isystemsautomation/homemaster-dev/DIO-430-R1/README.md

# DIO-430-R1 — Module for Smart I/O Control

**HOMEMASTER – Modular control. Custom logic.**

MODULE photo

**Document map:** [§1 Overview](#1-overview) · [§3 Specifications](#3-specifications) · [§4 Hardware](#4-hardware--interface) · [§5 Getting Started](#5-getting-started) · [§6 WebConfig](#6-webconfig-reference) · [§7 Modbus map](#7-modbus-register-map) · [§8 ESPHome](#8-esphome--home-assistant-integration) · [§9 Programming](#9-programming--build) · [§11 Downloads](#11-downloads--resources)

---

## 1. Overview

The **DIO-430-R1** is a digital I/O module whose **standalone local logic** — wall switches, override buttons, gesture counters, and DI→relay mapping — keeps working even with no controller or network. It mounts on a **35 mm DIN rail** and connects to **MiniPLC/MicroPLC** (or any Modbus RTU master) over **RS-485**, with Home Assistant integration via ESPHome packages.

**Key capabilities at a glance:**

- **4 IEC 61131-2 compliant 24 V digital inputs (ISO1212 front-end)** — dry-contact (module-wetted); PTC fuse, TVS surge and reverse-polarity protection; per-input Maintained/Momentary logic
- **3 SPDT relays** — 3 A @ 250 VAC (resistive) dry contacts (NO/NC/COM); use interposing contactors for loads above 3 A
- **3 buttons (2 user-configurable).** Button 1 and Button 2 are configurable in WebConfig (short/long-press actions). The third button has no software function — it is used only as part of the on-board key combination for USB firmware-update (BOOTSEL) and reset.
- **3 configurable user LEDs** — Steady/Blink; multiple sources (Link, HA, relay, etc.)
- **Standalone local logic** — wall switches and front buttons work even when the network or controller is offline
- **Driverless WebConfig** — USB-C + any Chromium-based browser (Chrome, Edge, Opera, Brave, Vivaldi; Chrome/Edge 89+, Opera 76+). No app or login required.
- **Persistent settings** — configuration stored in LittleFS flash and restored on boot

### How local and remote control coexist

Relays can be switched from **any** source — wired inputs, front buttons, or Home Assistant — **simultaneously**; the last command wins. There is no "local vs remote" mode to flip: if the network or controller reboots, wall switches **still work**; when online, you also get full remote control.

## Key advantages

- **3 relays + 4 inputs + physical override buttons**, with gesture counters (single/double/triple/long) and interlock; standalone local logic works even with no controller or network.
- Native ESPHome API via the MiniPLC/MicroPLC controller — no MQTT broker, no manual Modbus register mapping for the package entities.
- Local-first / edge-resilient — onboard logic keeps working if the network or Home Assistant is down.
- Open hardware (**CERN-OHL-W v2**) and firmware (**MIT**) — repairable, reproducible, no vendor lock-in.
- Standard **RS-485 Modbus RTU** — works with any Modbus master or industrial HMI/SCADA system, not locked to HomeMaster.
- Driverless **USB-C WebConfig** (Chrome, Edge, Opera); configuration persists in on-device flash (**LittleFS**).

---

## 2. Features

| Area | Detail |
|---|---|
| **Isolation** | Digital-input front-end per IEC 61131-2 (ISO1212); surge/EMI protected; opto-isolated relay drivers |
| **Configurable I/O** | Per-input Enable/Invert/**Type** (Maintained or Momentary). **Maintained** → mode Toggle/Follow + target relay. **Momentary** → Short/Long actions {None, Toggle, On, Off} + target (R1–R3 / All / None). |
| **Buttons** | 3 buttons (2 user-configurable): Button 1 / Button 2 assignable to relay actions (none, toggle, on, off) |
| **LEDs** | Configurable Steady/Blink; 8 firmware sources (Off, HA, Link, Local, Child lock, Safe mode, Identify, Relay) |
| **WebConfig** | USB-C → Chromium-based browser (Chrome, Edge, Opera, Brave, Vivaldi); set comms and I/O mapping live; auto-save to flash |
| **Modbus RTU slave** | Poll-based RS-485; factory defaults in [§3 Specifications](#3-specifications) |
| **ESPHome / HA** | Ready-made YAML package; DI/relay/button/event entities |
| **Extras** | All Off, child-lock per input, auto-off (staircase timer), shutter/interlock mode, Identify |

### Applications

Typical uses for the DIO-430-R1:

- **Lighting** — wall switches or push-buttons drive the relays directly, with optional auto-off (staircase) timers. A controller can override or monitor the same outputs over Modbus.
- **Pumps, fans, motors** — switch circulation pumps, exhaust fans, or irrigation valves from inputs, buttons, or a PLC. Relay interlock prevents two outputs (e.g. motor up/down) from being on at the same time.
- **Standalone or controller-driven** — runs its configured logic with no controller attached, and integrates with Home Assistant / ESPHome or any Modbus RTU master when one is present.

---

## 3. Specifications

<!-- hm:specs:start -->
| Specification | Details |
|---|---|
| Microcontroller | RP2350A dual-core microcontroller |
| Storage | External QSPI Flash (W25Q32JV) |
| Power Input | 24 V DC nominal |
| File system | LittleFS persistent configuration storage |
| Document revision | DS-DIO-430-R1 Rev. B · 2026-09 · Hardware R1 (V1.0) |
| Digital Inputs | 4 × IEC 61131-2 compliant 24 V digital inputs (ISO1212 front-end) (DIx + GNDx), dry-contact (module-wetted); per-channel PTC fuse, TVS surge suppression, reverse-polarity protection, EMI filtering |
| Relay outputs | 3 × SPDT (NO / C / NC); 3 A @ 250 VAC per contact (module limit) |
| User Interface | 3 buttons (2 user-configurable), 13 LEDs (power, 3 user, RX, TX, 3× relay, 4× DI) |
| RS-485 | half-duplex Modbus RTU, not galvanically isolated |
| USB | USB-C (ESD protected, configuration and firmware upload) |
| Modbus defaults | Address 3, 19200 baud, 8N1 |
| Operating temperature | 0 °C to +40 °C |
| Storage temperature | −10 °C to +55 °C |
| Relative humidity | 0–90 % RH, non-condensing |
| Ingress protection | IP20 (inside cabinet only) |
| Installation | Indoor control cabinet only; not for outdoor or exposed installation |
| Maximum altitude | 2000 m |
| Pollution degree | 2 |
| Dimensions | 70 × 90.6 × 67.3 mm (L × W × H) |
| DIN width | 4 modules (≈ 70 mm) |
| Mounting | 35 mm DIN rail |
| Enclosure | PC/ABS industrial enclosure |
| Terminal type | Pluggable screw terminal blocks, 5.08 mm pitch |
| Wire cross-section | 0.2–2.5 mm² (AWG 24–12) |
| Tightening torque | 0.4–0.6 Nm |
| Net weight | 210 g |
| Gross weight | 320 g |
| Pack size | 140 × 125 × 94 mm (L × W × H) |
<!-- hm:specs:end -->

DIO-430-R1 Dimensions

*Mechanical drawing: front and side view, dimensions in mm*

### 3.4 Communication defaults

Factory settings applied to every new module:

| Parameter | Default |
|---|---|
| **Modbus Address** | `3` |
| **Baud Rate** | `19200` |
| **Parity** | `None` |
| **Stop Bits** | `1` |

Address **1–247**; baud 9600 / 19200 / 38400 / 57600 / 115200. **Set via [WebConfig](#6-webconfig-reference) over USB-C — recommended.** Address and baud can also be written over Modbus holding registers (see [§7 Modbus Register Map](#7-modbus-register-map)) for remote re-commissioning of already-installed modules — **note: the change applies immediately, so the current Modbus connection drops and you must reconnect at the new address/baud.**

The module communicates over **RS-485 Modbus RTU** (A/B differential + shared COM/GND). Configuration is stored persistently in **LittleFS** and can be changed live through **USB-C + WebConfig**.

### 3.5 Reliability & protection

- Reverse-path diode + high-side MOSFET on 24 V input.
- Local PTC + TVS protection on field interfaces.
- Relay drivers opto-isolated; RC/MOV suppression recommended.
- Relay contacts: 275 V rms metal-oxide varistor across each contact pair. Not suitable for the elevated open-contact voltage of directly connected capacitor motors — see §5.1.
- RS-485: see [RS-485 / Modbus RTU](#rs-485--modbus-rtu).
- USB-C ESD-protected; CC resistors per spec.
- Non-volatile flash with **auto-save** after configuration changes.

---

### RS-485 / Modbus RTU

<!-- hm:rs485-order:begin -->
> **Terminal order differs across the HomeMaster range.**
> Always read the silkscreen - do not wire by habit from another module.
> On this module the order is **B-A-COM**.
> Swapping A and B damages nothing but the node will not communicate.
> COM is required on every node.
<!-- hm:rs485-order:end -->
All HomeMaster controllers and modules share the same RS-485 front end.

| Item | Value |
|---|---|
| Transceiver | MAX485CSA+T, half-duplex |
| Galvanic isolation | **None** — the transceiver shares the device's logic ground |
| Common-mode range | −7 V … +12 V referred to the device's own ground (MAX485 limit) |
| Terminals | A / B / COM |
| Surge protection | 3 × SMAJ6.8CA TVS (A–COM, B–COM, A–B) |
| Overcurrent | 2 × resettable PTC, 1.5 A hold, in series with A and B |
| EMI filtering | Common-mode choke on the A/B pair; COM referenced through 1 MΩ ∥ 4.7 nF |
| Idle state | Fail-safe biasing on board — do not add external bias resistors |
| Termination | 120 Ω at the two physical ends of the bus only |

**Bus wiring rules — apply to every device on the bus:**

- One twisted pair for A/B, 120 Ω characteristic impedance.
- Run **COM** to every node. Required, not optional: the ports are not isolated, and COM is what bounds the common-mode voltage the transceivers see.
- Prefer one power supply for the whole bus, distributed in star topology. With separate supplies, additionally tie the 0 V references together at a single point.
- Bond the cable shield to cabinet PE at one end only. Never land a shield on A, B or COM.
- Where the bus crosses into a different electrical installation with its own earthing reference — a utility or billing meter, another building, another cabinet's PE system — fit an external galvanic RS-485 isolator at that boundary. The on-board components are transient protection, not isolation, and will not survive a sustained ground-potential difference.

## 4. Hardware & Interface

### 4.1 Diagrams & pinouts

<table>
  <tr>
    <th>Block Diagram</th><th>Control Board</th><th>Relay / Field Board</th><th>RP2350A Pinout</th>
  </tr>
  <tr>
    <td></td>
    <td></td>
    <td></td>
    <td></td>
  </tr>
</table>

> **RP2350A pinout** is dense — zoom the image or open [`DIO_MCU_Pinouts.png`](https://config.home-master.eu/DIO-430-R1/Images/DIO_MCU_Pinouts.png) full size if labels are hard to read at table width.

### 4.2 Connectors & terminal map

<!-- hm:terminal-map:begin -->

**Top row** (24Vdc | RELAY OUTPUT)

| Pos | Label | Group | Function |
|-----|---|---|---|
| 1 | 0V | POWER | 24 V DC return |
| 2 | V+ | POWER | 24 V DC input |
| 3 | NO | RELAY1 | Relay 1 normally open |
| 4 | C | RELAY1 | Relay 1 common |
| 5 | NC | RELAY1 | Relay 1 normally closed |
| 6 | NO | RELAY2 | Relay 2 normally open |
| 7 | C | RELAY2 | Relay 2 common |
| 8 | NC | RELAY2 | Relay 2 normally closed |
| 9 | NO | RELAY3 | Relay 3 normally open |
| 10 | C | RELAY3 | Relay 3 common |
| 11 | NC | RELAY3 | Relay 3 normally closed |

**Bottom row** (RS-485 | DI 24Vdc)

| Pos | Label | Group | Function |
|-----|---|---|---|
| 1 | B | RS485 | RS-485 data - |
| 2 | A | RS485 | RS-485 data + |
| 3 | COM | RS485 | RS-485 signal reference |
| 4 | GND | DI1 | DI1 return |
| 5 | I.1 | DI1 | DI1 input |
| 6 | GND | DI2 | DI2 return |
| 7 | I.2 | DI2 | DI2 input |
| 8 | GND | DI3 | DI3 return |
| 9 | I.3 | DI3 | DI3 input |
| 10 | GND | DI4 | DI4 return |
| 11 | I.4 | DI4 | DI4 input |

**Ports & service interfaces**

| Id | Type | Note |
|----|---|---|
| USB-C | D+, D−, VBUS, GND | Not for field powering |

**Housing notes**

- GND precedes the signal on every DI pair. DIM prints the opposite order - do not wire by habit.
- Power reads 0V then V+. Most other modules read V+ first.
- Relays are SPDT. System limit 3 A @ 250 VAC per contact (module limit).

<!-- hm:terminal-map:end -->

**Input power / wetting.** The digital inputs are built on an ISO1212 IEC 61131-2 digital-input front-end and are wetted from the module's own 24 V supply (internally fused) — no separate input supply is required. For a dry contact, wire it between **INx** and **GNDx**; the module sources the loop (wetting) current and the ISO1212 limits it per channel (IEC 61131-2 input behaviour), so no external series resistor is needed. The module does **not** provide a dedicated sensor-supply rail (no 12 V/5 V out), so power 3-wire sensors from your own source and bring their output to INx.

**Power domain & front-end.** The input field side runs on the module's own 24 V supply (internally fused) — there is no separate isolated input supply. The ISO1212 is a current/threshold-conditioning front-end, **not** a galvanic isolator; inputs are **not** galvanically isolated from the module's own 24 V rail. An external 24 V signal can be applied to INx (this is the normal "24 V signal" mode and does not disturb the internal wetting — SENSE and IN are separate pins, current-limited), and each channel is protected by a series fuse, common-mode choke, ~26 V TVS and an RC filter. **The signal return must share the module's SELV ground:** wire it to the paired **GNDx** (= the module's 24 V return). If the external 24 V comes from a separate supply, make sure both are SELV and share a common 0 V reference to avoid ground loops. Do not bond **GNDx** to logic GND.

### 4.3 Front panel — buttons & LEDs

Button Layout 1‑2‑3

| Control | Function |
|---|---|
| **Button 1 / 2** | Front-panel buttons with configurable short/long-press actions (toggle / on / off a target relay, or All-off); press events are also exposed over Modbus as Home Assistant triggers. See [§6 WebConfig](#6-webconfig-reference). |
| **Button 3** | No software function — part of on-board boot/reset key combo (with Buttons 1+2 → BOOT mode) |
| **Buttons 1+2+3** | Enter **BOOT** mode for UF2 flashing (see [§9 Programming](#9-programming--build)) |
| **Buttons 1+3** | Hardware **RESET** |
| **PWR LED** | Power present |
| **TX/RX LEDs** | Modbus traffic activity |
| **User LEDs 1–3** | Configurable status indicators |

---

## 5. Getting Started

### 5.1 Safety *(read before wiring)*

> ⚠️ **SELV/PELV domains only** — 24 V DC, RS-485, USB 5 V. **Do not** connect mains to any terminal. Use interposing contactors for mains loads. **Never bridge** logic GND with isolated field grounds (GND_ISO / FGND).

| Requirement | Detail |
|---|---|
| Qualified personnel | Installation by personnel familiar with 24 V control and RS-485 |
| Power isolation | Disconnect 24 V DC before wiring; lockout/tagout where applicable |
| Environmental limits | Clean, sealed enclosure; avoid condensation and conductive dust |
| Grounding | Bond panel to PE; share RS-485 COM/GND with controller (same SELV domain) |
| Relay loads | Follow contact ratings; add RC/MOV snubbers for inductive loads |
| RS-485 | Twisted pair, daisy-chain, **120 Ω** at both physical ends, consistent A/B polarity |
| USB-C | Setup/maintenance only; disconnect after commissioning |

> ⚠️ **Capacitor motors (roller shutters, blinds, awnings, gate and garage tubular
> motors) must NOT be connected directly to the relay outputs.** Each relay contact
> carries a 275 V arc-suppression varistor. While one direction runs, the motor's
> phase-shift capacitor raises the voltage across the open contact of the other
> direction above 330 V; the varistor conducts continuously and is destroyed within
> seconds, regardless of motor current. Drive such motors through an interposing
> relay or contactor with ≥ 400 V contacts and **no RC or varistor across the
> contacts**; the DIO-430-R1 relay switches the interposing relay coil only. Follow the
> motor manufacturer's rules: the same phase for UP and DOWN, never UP and DOWN
> simultaneously, direction change through OFF with a pause of at least 0.5 s.

**Pre-power checklist**

- [ ] Wiring torqued, labeled, strain-relieved
- [ ] No bridge between logic GND and isolated GND_ISO/FGND
- [ ] Panel PE bonded; SELV supply and COM/GND properly landed
- [ ] RS-485 A/B polarity and 120 Ω termination at bus ends
- [ ] Relay loads within rating; snubbers on inductive loads
- [ ] Inputs wired to dry contact/SELV only
- [ ] USB-C disconnected for normal operation

#### Installation practices

| Task | Guidance |
|---|---|
| ESD Protection | Handle by the enclosure/edge only. Use an antistatic wrist strap when the board is exposed. |
| DIN Rail Mounting | Mount securely on **35 mm DIN** rail inside an IP-rated cabinet. Leave cable slack for strain relief. |
| Wiring | Use correct wire gauge and torque terminal screws. Separate **power**, **DI**, **relay**, and **RS-485** harnesses. |
| Isolation Domains | Respect isolation: **do not bridge** logic **GND** to isolated field grounds (e.g., **GND_ISO/FGND**). Keep analog/sensor returns on the isolated side. |
| Commissioning | Before power-up, verify polarity, relay NO/NC routing, RS-485 **A/B** orientation and termination. |

#### I/O & interface warnings

**Power**

| Area | Warning |
|---|---|
| 24 V DC Input | Use a clean, fused SELV supply. Reverse-polarity protection exists but may disable the module when triggered. |
| Sensor Rail | Power sensors from a SELV rail. Observe polarity. Fuse external branches as required. |
| Surge/Noise | In noisy panels, add upstream surge/EMI suppression and keep high-current wiring away from control wiring. |

**Inputs (digital)**

| Area | Warning |
|---|---|
| Type | **Dry-contact (module-wetted)** — see [§4.2](#42-connectors--terminal-map). Do not inject mains or undefined levels. |
| Isolation | IEC 61131-2 digital-input front-end (ISO1212); not galvanically isolated. Keep sensor returns on **GNDx** (module 24 V return); do not bond to logic GND. |
| Debounce | Firmware provides debounce; route away from contactors/VFDs; use shielded/twisted pairs for long runs. |
| Polarity | Configure invert/action in WebConfig; verify state transitions after wiring. |

**Relays (outputs)**

| Area | Warning |
|---|---|
| Contact Type | **SPDT (NO/NC/COM)** dry contacts. Follow contact rating on the device label/datasheet. |
| Inductive Loads | Add **RC snubber or MOV** at the load. Consider interposing relays/contactors for higher power. |
| Separation | Keep relay load wiring physically separate from signal wiring. De-energize before servicing. |
| Verification | After wiring, verify NO/NC behavior and load polarity before enabling automation. |

**RS-485:** see [RS-485 / Modbus RTU](#rs-485--modbus-rtu).

### 5.2 What you need

| Category | Item / Notes |
|---|---|
| **Hardware** | DIO-430-R1 — 4× DI, 3× SPDT relays, 3 buttons (2 user-configurable), 3× LEDs, USB-C, RS-485 |
| **Controller** | HomeMaster MiniPLC/MicroPLC or any Modbus RTU master |
| **24 VDC PSU** | Regulated SELV; size for logic + relay coils + sensors; ≥ 30 % headroom |
| **RS-485 cable** | Twisted pair A/B + COM/GND; 120 Ω termination at both trunk ends |
| **USB-C cable** | WebConfig via Chromium-based browser (commissioning) |
| **Software** | Chromium-based browser with Web Serial (Chrome, Edge, Opera, Brave, Vivaldi); [WebConfig tool](https://config.home-master.eu/DIO-430-R1/Firmware/v0.2.0/ConfigToolPage.html) |

### 5.3 Power notes

The module uses **24 VDC** primary. Onboard regulation provides **5 V → 3.3 V** for logic; DI front-end uses ISO1212 IEC 61131-2 conditioning wetted from the module 24 V supply (not galvanically isolated).

- **24 VDC DIN-rail PSU** → **24Vdc(+) / 0V(–)** power terminals (top row: POWER).
- **Sensor side (DI)** — ISO1212 receivers wetted from the module's internal fused 24 V (see [§4.2](#42-connectors--terminal-map)); for 3-wire sensors, power from your own source and return the output to **INx/GNDx**. Do **not** back-power logic from sensor rails.
- Size PSU for base electronics + LEDs + **relay coils** (up to 3 simultaneously) + sensor rails; add **≥ 30 % headroom** (see [§3.2](#32-electrical-ratings)).
- Correct polarity; keep logic **GND** and DI field ground **separate**; upstream **fusing/breaker** required.

### 5.4 Step-by-step

**Phase 1 — Wire (field wiring)**

| 24 V DC Power | Digital Inputs | Relay Output | RS-485 (120 Ω) |
|:---:|:---:|:---:|:---:|
| 24 Vdc wiring | Digital inputs | Relay wiring | RS-485 connection |

- **24 VDC** → **V+ / 0V** (top POWER terminals). Regulated SELV; keep pairs twisted.
- **Digital inputs** → **INx / GNDx** (field side; do not bridge logic GND ↔ **GNDx**). See [§4.2](#42-connectors--terminal-map) for wetting and front-end details.
- **Relay outputs** → **COM / NO / NC**. Interposing contactors for motors/pumps; RC/MOV on inductive loads. Capacitor motors: see §5.1.
- **RS-485** → **A / B / COM (GND)**. Shielded twisted pair; daisy-chain; 120 Ω at both ends.

> **Digital inputs:** internal fused 24 V wets dry contacts; no auxiliary 12 V/5 V sensor rail — see **Input power / wetting** under [§4.2 Connectors](#42-connectors--terminal-map).

**Phase 2 — Configure (WebConfig)**

1. Connect **USB-C**; open [WebConfig](https://config.home-master.eu/DIO-430-R1/Firmware/v0.2.0/ConfigToolPage.html) in a Chromium-based browser → **Connect**.
2. Set **Modbus address** and **baud rate** (factory defaults in [§3.4](#34-communication-defaults)).
3. Map inputs, relays, buttons, LEDs per [§6 WebConfig Reference](#6-webconfig-reference). Changes auto-save to flash.
4. Disconnect USB-C; hand control to the RS-485 master.

**Phase 3 — Integrate (controller / Home Assistant)**

Add the ESPHome package on your MiniPLC/MicroPLC (or poll/write Modbus from your PLC/SCADA). Match **address** and **baud** to WebConfig settings.

```yaml
packages:
  dio1:
    url: https://github.com/isystemsautomation/homemaster-dev
    ref: main
    files:
      - path: DIO-430-R1/Firmware/v0.2.0/default_dio_430_r1_plc/default_dio_430_r1_plc.yaml
        vars:
          dio_prefix: "DIO#1"
          dio_id: dio_1
          dio_address: 4   # must match WebConfig Modbus address
```

Full UART/modbus setup and entity list: [§8 ESPHome Integration](#8-esphome--home-assistant-integration). Modbus register addresses: [§7 Modbus Register Map](#7-modbus-register-map).

### 5.5 Verify

| Area | What to check |
|---|---|
| LEDs | **PWR** = ON; **TX/RX** blink during RS-485 traffic |
| Inputs | Wall switch/sensor changes **INx** state in WebConfig / Modbus IREG 0 |
| Relays | Coil writes toggle **R1–R3**; loads switch correctly |
| Address/Baud | Controller reads module without errors |
| Isolation | No unintended bond between logic GND and DI field GNDx |

---

## 6. WebConfig Reference

Open **https://config.home-master.eu/DIO-430-R1/Firmware/v0.2.0/ConfigToolPage.html** in any Chromium-based browser (Chrome, Edge, Opera, Brave, Vivaldi; Chrome/Edge 89+, Opera 76+), connect via **USB-C**, and click **Connect**. Changes apply immediately and are saved to flash (no Save button).

> Firefox: experimental only (Nightly with the Web Serial flag enabled). Safari and stable Firefox are not supported.

### Status & Tools

DIO-430-R1 WebConfig — Module status (Model, FW, Modbus ID, Baud) and Tools — Identify / Factory reset / Reboot

Status pills (read-only, not settings): **Connection** (USB), **Bus** (RS-485), **Model**, **FW**. A banner warns if model/firmware mismatches this configurator.

| Button | What it does |
|---|---|
| Identify (~5 s) | Blinks user LEDs to locate the module. |
| Factory reset | Restores all settings to defaults. |
| Reboot | Restarts the module. |

### Device Setup

DIO-430-R1 WebConfig — Serial connection & Modbus addressing (address, baud) with serial log

| Field | Values | Meaning |
|---|---|---|
| Modbus Address | 1–247 (default 3) | Modbus RTU slave address; must be unique on the bus. |
| Baud Rate | 9600 / 19200 / 38400 / 57600 / 115200 (default 19200) | RS-485 speed **8N1**; must match the controller. |

### Digital Inputs

DIO-430-R1 WebConfig — Per-input setup: Enabled / Inverted / Child-lock, Type (Maintained/Momentary), Short-Long actions & target

| Field | Values | Meaning |
|---|---|---|
| Enabled | on / off | Whether this input is processed. |
| Inverted | on / off | Invert the read level (NC contacts). |
| Child lock | on / off | Suspend local switching; still reports to Home Assistant. |
| Type | Maintained / Momentary | Wall switch vs push-button. |
| Maintained mode | Toggle / Follow | **Toggle**: flip relay on each change. **Follow**: relay mirrors switch. |
| Target *(Maintained)* | All / R1 / R2 / R3 / None | Controlled relay(s). |
| Short → action *(Momentary)* | None / Toggle / On / Off | Short-press action. |
| Short → target | All / R1 / R2 / R3 / None | Short-press target relay(s). |
| Long → action *(Momentary)* | None / Toggle / On / Off | Long-press action. |
| Long → target | All / R1 / R2 / R3 / None | Long-press target relay(s). |

Defaults: IN1–IN3 = Maintained / Toggle → R1/R2/R3; IN4 = Momentary, Short = Off → All.

### Gesture event counters (Momentary)

In **Momentary** mode each digital input and each user button (Button 1–2) recognizes press gestures and maintains **four monotonic counters**: **single**, **double**, **triple**, and **long**.

| Topic | Detail |
|---|---|
| **Modbus / HA** | Counters are exposed as **Input Registers** (FC04, event block IR 6…29) and imported into Home Assistant via the ESPHome package. |
| **How HA uses them** | Automations should react to a **counter increase** (e.g. a double-click adds 1 to the `double` sensor). The gesture is not lost even if the RS-485 bus is polled slowly. |
| **Purpose** | Run Home Assistant scenes and automations on single, double, triple clicks and long holds without missing short pulses on a shared bus. |
| **Maintained inputs** | Counters apply **only** when **Type = Momentary**. Maintained inputs have no gesture counters. |
| **HA-only input** | To use an input **only** for HA scenes (no local relay action): **Type = Momentary**, **Short = None**, **Long = None**. Gestures are still counted; relays are not switched locally. |
| **Timing** | **Long-press ms** and **Multi-click gap ms** in the [Timing](#timing) section set long-hold threshold and the double/triple click window. |

To turn off all relays from Momentary logic, use action **Off** with target **All** (not a separate “All off” action in WebConfig).

### Relays & Interlock

DIO-430-R1 WebConfig — Relay enable / invert / power-on / auto-off, and relay interlock (Relay A/B, pause)

**Relays (Relay 1–3)**

| Field | Values | Meaning |
|---|---|---|
| Enabled | on / off | Relay output active. |
| Inverted | on / off | Invert drive polarity. |
| Power-on | OFF / ON / Restore last | State after power-up. |
| Auto-off, s | 0–65535 (0 = off) | Staircase timer; 0 disables. |

Defaults: enabled, not inverted, OFF at power-on, auto-off 0.

**Interlock**

| Field | Values | Meaning |
|---|---|---|
| Enabled | on / off | Pair two relays (motor up/down). |
| Relay A / B | R1 / R2 / R3 | Interlocked pair. |
| Pause, ms | integer (default 500) | Dead-time when reversing. |

### Timing

DIO-430-R1 WebConfig — Press timing, debounce and bus watchdog (long-press, multi-click gap, debounce, link timeout)

| Field | Values | Meaning |
|---|---|---|
| Long-press, ms | 50–5000 (default 700) | Long-press threshold. |
| Multi-click gap, ms | 50–2000 (default 300) | Double/triple click window. |
| Debounce, ms | 1–500 (default 30) | Input debounce. |
| Link timeout, ms | 500–60000 (default 5000) | RS-485 link-loss timeout. |

### Buttons & User LEDs

DIO-430-R1 WebConfig — Button short/long actions and user-LED source / mode

**Buttons (Button 1–2; GPIO2 / GPIO3)**

| Field | Values | Meaning |
|---|---|---|
| Short/Long → action | None / Toggle / On / Off | Press action. |
| Short/Long → target | All / R1 / R2 / R3 / None | Target relay(s). |

Defaults: Button 1 → Short = Toggle R1, Long = Off → All; Button 2 → Short = Toggle R2, Long = None. (Third button: no software function — boot/reset combo only.)

**User LEDs (LED 1–3)**

| Field | Values | Meaning |
|---|---|---|
| Source | Off / HA / Link / Local / Child lock / Safe mode / Identify / Relay | LED meaning (8 firmware sources). |
| Mode | Steady / Blink | Display mode. |
| Inverted | on / off | Invert LED level. |
| Arg | integer | Relay # or DI index for Child lock / Relay sources. |

Defaults: LED1 = Link; LED2 = Off; LED3 = HA.

### Action / Target reference

| Action | Meaning |
|---|---|
| None | Report only (no local relay action); gestures still counted in Momentary mode. |
| Toggle / On / Off | Flip, energize, or de-energize the target relay(s). Use **Off** + target **All** to de-energize every relay. |

| Target | Meaning |
|---|---|
| All / R1 / R2 / R3 / None | Relay scope. |

---

## 7. Modbus Register Map

**Role:** RTU **slave** (controller is master). **Defaults:** see [§3.4 Communication defaults](#34-communication-defaults).

> v0.2.0 map uses **zero-based offsets** matching `default_dio_430_r1_plc.yaml`. Poll **Input Registers (FC04)** for live state; use **Coils (FC05)** for commands.

### 7.1 Address map (overview)

| Type | Offsets | Purpose |
|---|---|---|
| **Input Registers** (FC04) | `0…29` | State masks (DI/relay/button/LED), status, event counters |
| **Coils** (FC01/05) | `0…14` | Relays, device commands, LED HA override, DI child-lock |
| **Holding Registers** (FC03) | `0…46` | Identity, comms, DI/relay/button/LED config, timing |

> **No discrete-input bank (FC02):** firmware does not call `addIsts()`. Read DI/relay/button/LED states from **Input Register** masks below.

### 7.2 Input Registers (FC04) — state & counters

| Reg | Name | Encoding | Description |
|----:|---|---|---|
| 0 | **DI_MASK** | bitmask | bit0..3 → IN1..IN4 (after invert) |
| 1 | **RLY_MASK** | bitmask | bit0..2 → R1..R3 |
| 2 | **BTN_MASK** | bitmask | bit0..1 → Button1..2 |
| 3 | **LED_MASK** | bitmask | bit0..2 → LED1..3 |
| 4 | **STATUS_FLAGS** | bitmask | bit1 = link OK, bit3 = config dirty |
| 5 | **LOCK_MASK** | bitmask | bit0..3 → child-lock DI1..4 |
| 6–29 | **Event counters** | u16 | Index = `source×4 + type` (base 6); sources: DI1..4 = 0..3, Btn1..2 = 4..5; types: 0=single, 1=double, 2=triple, 3=long |

### 7.3 Coils (FC01/05) — commands

| Coil | Name | Description |
|-----:|---|---|
| 0 | **R1** | Relay 1 ON/OFF (maintained) |
| 1 | **R2** | Relay 2 ON/OFF (maintained) |
| 2 | **R3** | Relay 3 ON/OFF (maintained) |
| 3 | **ALL_OFF** | Turn all relays off (pulse) |
| 4 | *(reserved)* | Local-logic flag (internal) |
| 5 | **IDENTIFY** | Front-panel identify blink (pulse) |
| 6 | **SAVE_CFG** | Persist settings to flash (pulse) |
| 7 | **REBOOT** | Soft reset (pulse) |
| 8 | **LED1 HA** | Home Assistant LED1 override |
| 9 | **LED2 HA** | Home Assistant LED2 override |
| 10 | **LED3 HA** | Home Assistant LED3 override |
| 11–14 | **DI1–4 lock** | Child-lock per digital input |

### 7.4 Holding Registers (FC03) — configuration

Configuration is normally done via **WebConfig** ([§6](#6-webconfig-reference)). Holding registers mirror persisted settings (offsets 0–46):

| Reg | Name | R/W | Encoding | Notes |
|----:|---|:---:|---|---|
| 0 | **MODEL_ID** | R | u16 | **5** (DIO-430-R1; not 0x0430) |
| 1 | **FW_VERSION** | R | u16 | Packed `(major<<8)\|minor` (not a build date) |
| 2 | **MAP_VERSION** | R | u16 | Modbus map version |
| 3 | **MB_ADDR** | R/W | u16 | Modbus address **1–247** (default 3) |
| 4 | **MB_BAUD** | R/W | enum | 0=9600, 1=19200, 2=38400, 3=57600, 4=115200 |
| 8 | **DI_EN_MASK** | R/W | bitmask | bit0..3 → DI1..DI4 enable |
| 9 | **DI_INV_MASK** | R/W | bitmask | bit0..3 → DI1..DI4 invert |
| 10 | **DI_TYPE_MASK** | R/W | bitmask | bit0..3 → 0=Maintained, 1=Momentary |
| 11 | **DI_LOCK_MASK** | R/W | bitmask | bit0..3 → child-lock per DI |
| 12–15 | **DI1–4 FOLLOW** | R/W | u16 | Follow target (Maintained/Follow mode) |
| 16–19 | **DI1–4 SHORT** | R/W | packed | Short-press action+target (Momentary) |
| 20–23 | **DI1–4 LONG** | R/W | packed | Long-press action+target (Momentary) |
| 24 | **RLY_EN_MASK** | R/W | bitmask | bit0..2 → R1..R3 enable |
| 25 | **RLY_INV_MASK** | R/W | bitmask | bit0..2 → R1..R3 invert |
| 26 | **RLY_POWERON** | R/W | packed | 2 bits per relay: 0=Off, 1=On, 2=Restore |
| 27–29 | **RLY1–3 AUTO-OFF** | R/W | u16 | Auto-off timer (s) per relay; 0=disabled |
| 30 / 31 | **BTN1 SHORT / LONG** | R/W | packed | Button 1 short/long action+target |
| 32 / 33 | **BTN2 SHORT / LONG** | R/W | packed | Button 2 short/long action+target |
| 34–36 | **LED1–3 config** | R/W | packed | source / mode / inverted / arg per LED |
| 40 | **INTERLOCK** | R/W | packed | Interlock enable + relay pair |
| 41 | **INTERLOCK_PAUSE** | R/W | u16 | Interlock dead-time (ms); default 500 |
| 42 | **DI_MAINT_MODE_MASK** | R/W | bitmask | Maintained mode per DI: 0=Toggle, 1=Follow |
| 43 | **LONGPRESS_MS** | R/W | u16 | Default 700 |
| 44 | **MULTICLICK_MS** | R/W | u16 | Default 300 |
| 45 | **DEBOUNCE_MS** | R/W | u16 | Default 30 |
| 46 | **LINKTIMEOUT_MS** | R/W | u16 | Default 5000 |

**Packed action+target byte:** upper 3 bits = action (0=None, 1=Toggle, 2=On, 3=Off, 4=All off); lower 3 bits = target (0=None, 1=R1, 2=R2, 3=R3, 4=All).

### 7.5 Register use examples

**A) Toggle Relay 2 from a PLC** — write `1` to **Coil 1** (ON), then `0` (OFF).

**B) Read DI3 state** — read **Input Register 0** (FC04), test bit 2 of **DI_MASK**.

**C) Map IN3 as Maintained Toggle → Relay 1** — set bit2 in **HREG 8**; clear bit2 in **HREG 10** and **HREG 42**; write follow target `1` to **HREG 14**; pulse **Coil 6 (SAVE_CFG)**.

**D) Map Button 1 short press → Toggle Relay 2** — write packed Toggle+R2 to **HREG 30**; pulse **Coil 6**.

**E) Change Modbus address / baud (remote re-commissioning)** — write **HREG 3 (MB_ADDR)** and **HREG 4 (MB_BAUD)**; settings apply **immediately** (current connection drops — reconnect at the new address/baud). Optional pulse **Coil 6 (SAVE_CFG)** and **Coil 7 (REBOOT)**. Prefer [WebConfig](#6-webconfig-reference) over USB-C for initial setup.

**F) Persist and reboot** — pulse **Coil 6 (SAVE_CFG)** then **Coil 7 (REBOOT)**.

### 7.6 Polling recommendations

- **Input registers 0–5:** 5–10 Hz (100–200 ms) for DI/relay/LED masks
- **Event counters 6–29:** 1–2 s (change slowly)
- **Coils:** write on change only; relays 0–2 are maintained
- **Holding:** configure at commissioning; avoid frequent writes
- **Edge logic:** use **Maintained/Toggle** for latching inputs; **Momentary/On/Off** when the PLC supervises timers

---

## 8. ESPHome / Home Assistant Integration

> **Module role:** Modbus RTU **slave** on RS-485. Comms defaults: [§3.4](#34-communication-defaults).

### 8.1 Minimal YAML (controller side)

Use this on the **MiniPLC/MicroPLC** (ESPHome). It enables the RS-485 bus and imports a ready-made DIO package.

```yaml
uart:
  id: uart_modbus
  tx_pin: 17
  rx_pin: 16
  baud_rate: 19200
  parity: NONE
  stop_bits: 1

modbus:
  id: modbus_bus
  uart_id: uart_modbus
  turnaround_time: 100ms
  send_wait_time: 250ms

packages:
  dio1:
    url: https://github.com/isystemsautomation/homemaster-dev
    ref: main
    files:
      - path: DIO-430-R1/Firmware/v0.2.0/default_dio_430_r1_plc/default_dio_430_r1_plc.yaml
        vars:
          dio_prefix: "DIO#1"
          dio_id: dio_1
          dio_address: 4       # Modbus address set in WebConfig
    refresh: 1d
```

> **ESPHome 2026.7.0 raised the Modbus client defaults** — `turnaround_time` from
> 100 ms to 600 ms and `send_wait_time` from 250 ms to 2000 ms (PR #11969).
>
> At the 600 ms default the bus carries only about 1.5 Modbus transactions per
> second, whatever the UART speed, because the controller stays silent for 600 ms
> after every response. Two modules on one RS-485 bus become slow to respond.
> With three or more, one module can stop being polled altogether — with no
> timeout and no CRC error in the log.
>
> On ESPHome 2026.7.0 and newer, set both values explicitly as shown above.
> On earlier releases these were the defaults and the two lines are not required.

> For **multiple** DIOs, duplicate the `dio1:` block (`dio2:`, `dio3:`…) with unique `dio_id`, `dio_prefix`, and `dio_address`.

### 8.2 Entities exposed (from the package)

- **Binary Sensors** (from **Input Registers**, FC04 bitmasks)
  - **DI1…DI4** (IREG 0)
  - **Btn1…Btn2** (IREG 2)
  - **LED1…LED3** (IREG 3)
  - **Link OK / Config dirty** (IREG 4)
  - **DI child-lock flags** (IREG 5)
- **Switches**
  - **Relay 1–3** (coils 0–2, maintained)
  - **LED1–3 HA override** (coils 8–10)
  - **DI1–4 child lock** (coils 11–14)
- **Sensors**
  - **Event counters** DI1..4 / Btn1..2 × single/double/triple/long (IREG 6–29)
- **Buttons (template)**
  - **All off**, **Identify** (pulse coils 3, 5)

> The package matches `default_dio_430_r1_plc.yaml`: **no discrete-input bank** — DI/relay states are read from **Input Register** masks.

### 8.3 Optional: direct (manual) entity mapping

```yaml
modbus_controller:
  - id: dio430_4
    address: 4
    modbus_id: modbus_bus
    update_interval: 200ms
    command_throttle: 100ms

binary_sensor:
  # DI1..DI4 from Input Register 0 (FC04 bitmasks)
  - platform: modbus_controller
    modbus_controller_id: dio430_4
    name: "DIO#1 DI1"
    register_type: read
    address: 0
    bitmask: 0x0001
  - platform: modbus_controller
    modbus_controller_id: dio430_4
    name: "DIO#1 DI2"
    register_type: read
    address: 0
    bitmask: 0x0002
  - platform: modbus_controller
    modbus_controller_id: dio430_4
    name: "DIO#1 DI3"
    register_type: read
    address: 0
    bitmask: 0x0004
  - platform: modbus_controller
    modbus_controller_id: dio430_4
    name: "DIO#1 DI4"
    register_type: read
    address: 0
    bitmask: 0x0008

switch:
  - platform: modbus_controller
    modbus_controller_id: dio430_4
    name: "DIO#1 Relay 1"
    register_type: coil
    address: 0
  - platform: modbus_controller
    modbus_controller_id: dio430_4
    name: "DIO#1 Relay 2"
    register_type: coil
    address: 1
  - platform: modbus_controller
    modbus_controller_id: dio430_4
    name: "DIO#1 Relay 3"
    register_type: coil
    address: 2

sensor:
  - platform: modbus_controller
    modbus_controller_id: dio430_4
    name: "DIO#1 LED Mask"
    register_type: read
    address: 3
    value_type: U_WORD
    accuracy_decimals: 0
  - platform: modbus_controller
    modbus_controller_id: dio430_4
    name: "DIO#1 Button Mask"
    register_type: read
    address: 2
    value_type: U_WORD
    accuracy_decimals: 0
```

### 8.4 Home Assistant tips

- **Dashboards:** lighting panel with Relay 1–3 + DI tiles; maintenance card with Identify / All off buttons.
- **Automations:** trigger relay switches from DI edges if logic runs in HA instead of module mapping.
- **Naming:** use `dio_prefix` for readable entities (`DIO#1 Relay 1`, `DIO#2 DI3`, etc.).

### 8.5 Troubleshooting (integration)

- **No response / timeouts:** A/B polarity, shared **COM/GND**, **120 Ω** termination at bus ends.
- **Wrong device:** `dio_address` must match WebConfig address.
- **Relays don't switch:** relay **Enabled** in [§6 WebConfig](#6-webconfig-reference).
- **DI not changing:** wiring to **INx/GNDx**; check Enable/Invert/Type and Short/Long actions.

### 8.6 Notes & versions

- Works with recent ESPHome releases (e.g., 2025.x).
- Keep `update_interval` modest (200–500 ms) unless faster DI polling is needed.
- For multiple devices, stagger `update_interval` / `command_throttle` to reduce collisions.

---

## 9. Programming & Build

### 9.1 Supported languages

- **Arduino**
- **C++** (PlatformIO)
- **MicroPython** (community builds for RP23xx-class MCUs)

### 9.2 Flashing (USB-C, hardware buttons)

> All reset/boot actions use the **front buttons**. UF2 image: [§11 Downloads](#11-downloads--resources).

**Combinations** (see [§4.3 Front panel](#43-front-panel--buttons--leds)):

- **Buttons 1 + 2 + 3** → **BOOT** mode (RPI-RP2 USB drive for UF2 drag-and-drop)
- **Buttons 1 + 3** → hardware **RESET**

**Steps**

1. Connect **USB-C** to a PC (disconnect RS-485 during flashing).
2. Enter **BOOT** mode. Board mounts as **RPI-RP2** (UF2) or serial port (IDE).
3. Flash UF2 from [§11](#11-downloads--resources) or upload via PlatformIO / Arduino IDE.
4. If needed, **Buttons 1 + 3** for hardware reset.

> No factory-reset function. Configuration remains intact across normal firmware updates.

### 9.3 Arduino / PlatformIO notes

**Board / toolchain**

- **Board:** Generic **RP2350** (or vendor core for **RP2350A**)
- **USB:** CDC enabled (serial logging)
- **FS:** LittleFS partition recommended (for settings)

**Required libraries (Library Manager names / versions)**

- `Arduino_JSON` (0.2.0)
- `Modbus-Arduino` (1.3.0) + `Modbus-Serial` (2.0.6) — `#include <ModbusSerial.h>` in sketch
- `Simple Web Serial` (1.0.0)
- **From core:** `LittleFS`, `Wire` (no separate install)

**Pin mapping:** see [§4.1 Diagrams & pinouts](#41-diagrams--pinouts) (`DIO_MCU_Pinouts.png`) and firmware `default_DIO_430_R1.ino`.

**Build tips**

- Use factory RS-485 defaults from [§3.4](#34-communication-defaults) during bring-up.
- After flashing, disconnect USB-C and return control to the RS-485 master.

### 9.4 Firmware updates

See [§9.2 Flashing](#92-flashing-usb-c-hardware-buttons) and [§11 Downloads](#11-downloads--resources). Configuration in flash/LittleFS is preserved across normal updates unless explicitly erased.

---

## 10. Maintenance & Troubleshooting

### 10.1 Status LEDs

- **PWR** — ON in normal operation
- **TX/RX** — blink on Modbus traffic
- **User LEDs (1–3)** — follow relay logic (Steady/Blink per [§6 WebConfig](#6-webconfig-reference))

### 10.2 Resets

- **Power cycle:** remove 24 V, wait 5 s, re-apply
- **Buttons 1 + 3** — hardware RESET

### 10.3 Common issues

| Symptom | Checks |
|---|---|
| No Modbus comms | A/B polarity, **COM/GND** reference, 120 Ω termination, address/baud match ([§3.4](#34-communication-defaults)), only two end terminators |
| Relays don't actuate | Relay **Enabled** in WebConfig; verify coil writes to 0–2; check invert setting |
| DI not changing | Wire to **INx/GNDx**; check Enable/Invert/Type and Short/Long actions in [§6](#6-webconfig-reference) |
| USB won't connect | Chromium-based browser with Web Serial (not Safari/stable Firefox); close other serial apps, check cable/port permissions |
| Config not saved | Allow idle for auto-save; verify LittleFS space |

---

## 11. Downloads & Resources

### Version history

| Version | Config path (`path:`) | Date | Status |
|---|---|---|---|
| **v0.2.0** | `DIO-430-R1/Firmware/v0.2.0/default_dio_430_r1_plc/default_dio_430_r1_plc.yaml` | 2026-06 | **Current — shipped on new modules** |
| v0.1.0 | `DIO-430-R1/Firmware/v0.1.0/default_dio_430_r1_plc/default_dio_430_r1_plc.yaml` | 2026-06 | Legacy (superseded by v0.2.0) |

> **Reproducible firmware build (v0.2.0):** [Build environment (reproducible)](../README.md#build-environment-reproducible) · [`sketch.yaml`](Firmware/v0.2.0/default_DIO_430_R1/sketch.yaml)

### Files

- **Firmware v0.2.0 (pre-built UF2 — drag-and-drop upgrade)**
  - [`DIO-430-R1.uf2`](https://config.home-master.eu/DIO-430-R1/Firmware/v0.2.0/DIO-430-R1.uf2)
- **Firmware publishing (maintainers)**
  - [`DIO-430-R1/Firmware/README.md`](https://github.com/isystemsautomation/homemaster-dev/blob/site/DIO-430-R1/Firmware/README.md)
- **Firmware source (Arduino, v0.2.0)**
  - [`DIO-430-R1/Firmware/v0.2.0/default_DIO_430_R1/`](https://github.com/isystemsautomation/homemaster-dev/tree/site/DIO-430-R1/Firmware/v0.2.0/default_DIO_430_R1)
- **YAML configs (ESPHome, v0.2.0)**
  - [`DIO-430-R1/Firmware/v0.2.0/default_dio_430_r1_plc/`](https://github.com/isystemsautomation/homemaster-dev/tree/site/DIO-430-R1/Firmware/v0.2.0/default_dio_430_r1_plc)
- **WebConfig tool (HTML/JS, v0.2.0)**
  - [`DIO-430-R1/Firmware/v0.2.0/ConfigToolPage.html`](https://config.home-master.eu/DIO-430-R1/Firmware/v0.2.0/ConfigToolPage.html)
- **Firmware source (Arduino, v0.1.0 — legacy)**
  - [`DIO-430-R1/Firmware/v0.1.0/default_DIO_430_R1/`](https://github.com/isystemsautomation/homemaster-dev/tree/site/DIO-430-R1/Firmware/v0.1.0/default_DIO_430_R1)
- **YAML configs (ESPHome, v0.1.0 — legacy)**
  - [`DIO-430-R1/Firmware/v0.1.0/default_dio_430_r1_plc/`](https://github.com/isystemsautomation/homemaster-dev/tree/site/DIO-430-R1/Firmware/v0.1.0/default_dio_430_r1_plc)
- **WebConfig tool (HTML/JS, v0.1.0 — legacy)**
  - [`DIO-430-R1/Firmware/v0.1.0/ConfigToolPage.html`](https://config.home-master.eu/DIO-430-R1/Firmware/v0.1.0/ConfigToolPage.html)
- **Schematics (PDF)**
  - Field Board: [`Schematics/DIO-430-R1-FieldBoard.pdf`](https://config.home-master.eu/DIO-430-R1/Schematics/DIO-430-R1-FieldBoard.pdf)
  - MCU Board: [`Schematics/DIO-430-R1-MCUBoard.pdf`](https://config.home-master.eu/DIO-430-R1/Schematics/DIO-430-R1-MCUBoard.pdf)
- **Images & diagrams**
  - [`DIO-430-R1/Images/`](https://github.com/isystemsautomation/homemaster-dev/tree/site/DIO-430-R1/Images)
- **Datasheets**
  - Refer to `Schematics/` BOM notes for part numbers (e.g., ISO1212, MAX485, HF115F).

---

## Open Source & Licensing

This project uses a hybrid licensing model.

**Hardware** — schematics, PCB layouts, BOMs: **CERN-OHL-W v2**

**Firmware & ESPHome integration** — firmware, ESPHome configs, software: **MIT License**

This ensures full compatibility with ESPHome and Home Assistant while protecting hardware designs. See LICENSE files in each directory for full terms.

---

## 12. Compliance & Certifications

The DIO-430-R1 module is CE marked. **ISYSTEMS AUTOMATION S.R.L.** (HomeMaster® brand) maintains the technical documentation and a signed EU Declaration of Conformity (DoC).

### Applicable EU directives

- **EMC Directive 2014/30/EU** — EN 55032:2015 + AC:2016-07 + A11:2020 + A1:2020 (Class B emissions), EN 55035:2017 + A11:2020 (immunity); tested by Idvorsky Laboratories Ltd., Belgrade, Serbia (Job #1648, 20 April 2026)
- **Low Voltage Directive 2014/35/EU** — EN 62368-1:2020 + A11:2020; in-house dielectric and isolation test by ISYSTEMS AUTOMATION S.R.L. internal compliance laboratory
- **RoHS Directive 2011/65/EU** — EN IEC 63000 technical documentation

| Standard / Directive | Description |
|---|---|
| Ingress Rating | IP20 (panel-mount only) |
| Altitude | ≤ 2000 m |
| Environmental | RoHS / REACH compliant components |

### Compliance documents

| Document | File |
|---|---|
| EU Declaration of Conformity (DoC) | [DoC_DIO-430-R1.pdf](https://config.home-master.eu/DIO-430-R1/Manuals/DoC_DIO-430-R1.pdf) |
| Datasheet | [DIO-430-R1_Datasheet.pdf](https://config.home-master.eu/DIO-430-R1/Manuals/DIO-430-R1_Datasheet.pdf) |

### Trademark

**HomeMaster®** is a registered European Union trademark of ISYSTEMS AUTOMATION S.R.L., EUTM No. 019082911, registered with EUIPO on 15 January 2025.

---

## 13. Support

- **Official Support Portal:** https://www.home-master.eu/support
- **WebConfig Tool:** https://config.home-master.eu/DIO-430-R1/Firmware/v0.2.0/ConfigToolPage.html
- **YouTube:** https://youtube.com/@HomeMaster
- **Hackster:** https://hackster.io/homemaster
- **Reddit:** https://reddit.com/r/HomeMaster
- **Instagram:** https://instagram.com/home_master.eu

**Manufacturer:** ISYSTEMS AUTOMATION S.R.L. (HomeMaster® brand)  
**Registered office:** Str. Domnisori, Nr. 81, Bl. 62, Scara A, Etaj 3, Ap. 12, 100284 Ploiesti, Jud. Prahova, Romania  
**Office / Contact:** Diligentei 18, Ploiesti, Romania  
**CUI / VAT:** RO 21537032 · **EUID:** ROONRC.J2007000919293  
**Telephone:** +40 747 757 798  
**Website:** [https://www.home-master.eu](https://www.home-master.eu)
