isystemsautomation/homemaster-dev/MiniPLC/README.md

# HomeMaster MiniPLC

<a href="https://devices.esphome.io/devices/homemaster-miniplc/">Made for ESPHome</a>

Device

**Part No.:** MiniPLC-R1 · **Hardware Version:** V1.0 · **Manufacturer:** ISYSTEMS AUTOMATION S.R.L.

## Description

The HomeMaster MiniPLC is the flagship ESP32 DIN-rail controller: rich onboard I/O (relays, DI, 0–10 V analog in/out, RTD, 1-Wire) plus an RS-485 Modbus RTU master (non-isolated) for HomeMaster expansion modules. ESPHome is pre-installed for local, offline Home Assistant integration — the controller runs the logic; HA provides dashboards and history.

This repository includes the full ESPHome configuration used on shipped devices (including vendor OTA update settings).

## Key advantages

- Flagship ESP32 DIN-rail controller with rich onboard I/O: **6 relays**, **4 DI**, **4× AI 0–10 V (16-bit)**, **1× AO 0–10 V**, **2× RTD (PT100/PT1000)**, **2× 1-Wire**, optional Ethernet, microSD, OLED, and RTC — RTD plus analog in/out on the controller is uncommon in this class.
- **ESPHome pre-installed**; native Home Assistant API — no MQTT broker, no Modbus register mapping for onboard entities.
- **Modbus RTU master** for the HomeMaster I/O module line over a deterministic RS-485 wired bus.
- *The controller does the thinking; the server only visualizes* — critical logic runs on the MiniPLC; Home Assistant is dashboards and history.
- **Improv** Wi-Fi onboarding (BLE/USB); runs local and offline without cloud dependency.
- Open hardware (**CERN-OHL-W v2**) and firmware (**MIT**) — repairable, reproducible, no vendor lock-in.

## Quick Start

1. Mount the device on 35 mm DIN rail inside a closed control cabinet.
2. Connect ONE power input (24 V DC at V+/0V, OR 85–265 V AC at L/N).
3. Wire your field signals: DI, AI, AO, RTD, 1-Wire, RS-485 — as needed.
4. Power on, open <https://improv-wifi.com>, and provision Wi-Fi via Bluetooth (BLE) or USB (Serial).
5. Within **15 minutes** of power-on, open ESPHome Device Builder → click **Take control** to import the configuration and establish the API encryption key. Then add the device in Home Assistant. See [Commissioning (firmware 1.1.0)](#commissioning-firmware-110).

| Resource | Link |
|---|---|
| 🛒 Product page | [home-master.eu](https://www.home-master.eu/shop/esp32-miniplc-55) |
| 📁 Repository | [GitHub](https://github.com/isystemsautomation/homemaster-dev/tree/site/MiniPLC) |
| 📄 Datasheet (PDF) | [MiniPLC_Datasheet.pdf](https://config.home-master.eu/MiniPLC/Manuals/MiniPLC_Datasheet.pdf) |
| 📘 User Manual (PDF) | [User Manual.pdf](https://config.home-master.eu/MiniPLC/Manuals/User%20Manual.pdf) |
| 📄 UK PSTI statement (PDF) | [PSTI_MiniPLC.pdf](https://config.home-master.eu/MiniPLC/Manuals/PSTI_MiniPLC.pdf) |
| ⚙️ Default Firmware (YAML) | [miniplc.yaml](https://github.com/isystemsautomation/homemaster-dev/blob/main/MiniPLC/Firmware/miniplc.yaml) |
| 📝 Changelog | [CHANGELOG.md](Firmware/CHANGELOG.md) |
| 🔧 Schematics | [Schematics/](https://github.com/isystemsautomation/homemaster-dev/tree/site/MiniPLC/Schematics) |
| 🏠 Maker | [home-master.eu](https://www.home-master.eu/) |

## Table of Contents

- [Description](#description)
- [Key advantages](#key-advantages)
- [Quick Start](#quick-start)
- [Features](#features)
- [Compatible Expansion Modules](#compatible-expansion-modules)
- [Electrical and Safety Notes](#electrical-and-safety-notes)
- [Mechanical and Environmental](#mechanical-and-environmental)
- [Installation](#installation)
- [Cable Recommendations & Shield Grounding](#cable-recommendations--shield-grounding)
- [Wiring](#wiring)
- [Pinout](#pinout)
- [Terminal Reference](#terminal-reference)
- [LED and Button Behaviour](#led-and-button-behaviour)
- [GPIO Map](#gpio-map)
- [Temperature Inputs](#temperature-inputs)
- [RTD Jumper Configuration](#rtd-jumper-configuration)
- [Enabling RTD Sensors in YAML](#enabling-rtd-sensors-in-yaml)
- [Enabling 1-Wire Sensors in YAML](#enabling-1-wire-sensors-in-yaml)
- [Real-Time Clock (RTC) Battery](#real-time-clock-rtc-battery)
- [Network Requirements](#network-requirements)
- [Commissioning (firmware 1.1.0)](#commissioning-firmware-110)
- [First Boot & Wi-Fi Setup](#first-boot--wi-fi-setup)
- [USB Serial Driver & Port Access](#usb-serial-driver--port-access)
- [Optional Ethernet (LAN8720)](#optional-ethernet-lan8720)
- [Home Assistant Integration](#home-assistant-integration)
- [Firmware Updates](#firmware-updates)
- [Device Behaviour Reference](#device-behaviour-reference)
- [Troubleshooting](#troubleshooting)
- [Entity Reference](#entity-reference)
- [Default Firmware Configuration](#default-firmware-configuration)
- [Support & Community](#support--community)
- [Compliance & Certifications](#compliance--certifications)
- [License](#license)

## Features

- ESP32-WROOM-32U-N16 (dual-core, 16 MB flash, Wi-Fi + Bluetooth, external antenna)
- 4 × IEC 61131-2 compliant 24 V digital inputs (ISO1212 front-end), dry-contact (module-wetted), with PTC fuse, TVS surge and reverse-polarity protection; per-channel EMI filtering
- 6 × SPDT mechanical relay outputs with NO / NC / COM terminals. System limit **3 A @ 250 VAC** (resistive) per channel — the board/system rating governs.
- Relay contacts: 275 V rms metal-oxide varistor across each contact pair. Not suitable for the elevated open-contact voltage of directly connected capacitor motors — see [Electrical and Safety Notes](#electrical-and-safety-notes).
- 4 × analog inputs 0–10 V (ADS1115, 16-bit) with op-amp buffer and scaling network
- 1 × analog output 0–10 V (MCP4725, 12-bit DAC) with op-amp output stage
- 2 × RTD inputs (PT100 / PT1000 via MAX31865) with on-board jumper configuration (J-RTD/1, J-RTD/2) for sensor type and 2/3/4-wire mode
- 2 × 1-Wire buses (DS18B20 compatible) with auxiliary +5 V supply
- RS-485 / Modbus RTU bus (MAX485; non-isolated — see [RS-485 / Modbus RTU](#rs-485--modbus-rtu))
- 128 × 64 OLED display (SH1106, I²C)
- 4 front-panel buttons + 16 LEDs (PWR ×1, user ×3 U.1–U.3; U.3 is the status LED by default, reassignable; RX/TX ×2, DI ×4, relay ×6) + buzzer
- PCF8563 real-time clock with on-board battery holder (battery sold separately)
- microSD card slot (SPI, power-switched 3.3 V rail)
- Power input options: 24 V DC or 85–265 V AC (single isolated input module)
- USB Type-C for programming and serial console (CP2102N, ESD-protected)
- Wi-Fi 2.4 GHz (pre-certified ESP32 radio module) and Bluetooth
- Optional Ethernet via on-board LAN8720 PHY (RMII, fixed pins)
- ESPHome pre-installed
- OTA updates (ESPHome + HTTP vendor-managed)
- Improv provisioning (BLE + USB Serial)
- DIN-rail mounting (9 DIN modules ≈ 158 mm)
- Modular architecture: MCU Board + Relay Board + USB Board

## Compatible Expansion Modules

The MiniPLC acts as a Modbus RTU master on its RS-485 bus. Add HomeMaster I/O modules using the standard `modbus_controller:` and pre-built `packages:` blocks from each module's repository folder.

| Module | Function | Repository |
|---|---|---|
| DIO-430-R1 | 4 × digital inputs + 3 × relays | [DIO-430-R1/](https://github.com/isystemsautomation/homemaster-dev/tree/site/DIO-430-R1) |
| DIM-420-R1 | 2-channel MOSFET AC dimmer | [DIM-420-R1/](https://github.com/isystemsautomation/homemaster-dev/tree/site/DIM-420-R1) |
| ENM-223-R1 | 3-phase energy & power-quality monitor | [ENM-223-R1/](https://github.com/isystemsautomation/homemaster-dev/tree/site/ENM-223-R1) |
| ALM-173-R1 | 17 digital inputs + 3 relays, alarm logic (not a certified alarm system) | [ALM-173-R1/](https://github.com/isystemsautomation/homemaster-dev/tree/site/ALM-173-R1) |
| AIO-422-R1 | 4 × analog inputs + 2 × analog outputs + 2 × RTD | [AIO-422-R1/](https://github.com/isystemsautomation/homemaster-dev/tree/site/AIO-422-R1) |
| RGB-621-R1 | RGB + CCT LED controller (5 PWM + 1 relay) | [RGB-621-R1/](https://github.com/isystemsautomation/homemaster-dev/tree/site/RGB-621-R1) |
| STR-3221-R1 | 32-channel staircase / architectural LED controller | [STR-3221-R1/](https://github.com/isystemsautomation/homemaster-dev/tree/site/STR-3221-R1) |
| WLD-521-R1 | Multi-zone leak detection, valve control, pulse metering | [WLD-521-R1/](https://github.com/isystemsautomation/homemaster-dev/tree/site/WLD-521-R1) |

Any standard Modbus RTU slave device can also be connected. Refer to each module's own `README.md` for register maps and the recommended YAML package import.

## Electrical and Safety Notes

> ⚠️ **Safety — read before installation:**
> - **L / N terminals carry hazardous mains voltage.** Installation by qualified personnel only.
> - **Use only ONE power input at a time** (24 V DC at V+/0V, OR 85–265 V AC at L/N). Never connect multiple power inputs simultaneously.
> - **Disconnect all power before wiring changes.**
> - Relay outputs are **not internally fused**. Protect every channel with an external fuse or breaker, not more than **3 A per channel**.
> - If several channels share one common breaker, its rating is **not** the sum of the channel currents. The common device must still protect each channel — so not more than **3 A**.
> - Loads above 3 A or inductive/high-inrush loads MUST be switched using an external contactor; the MiniPLC relay acts as a control signal.
>
> ⚠️ **Capacitor motors (roller shutters, blinds, awnings, gate and garage tubular
> motors) must NOT be connected directly to the relay outputs.** Each relay contact
> carries a 275 V arc-suppression varistor. While one direction runs, the motor's
> phase-shift capacitor raises the voltage across the open contact of the other
> direction above 330 V; the varistor conducts continuously and is destroyed within
> seconds, regardless of motor current. Drive such motors through an interposing
> relay or contactor with ≥ 400 V contacts and **no RC or varistor across the
> contacts**; the MiniPLC relay switches the interposing relay coil only. Follow the
> motor manufacturer's rules: the same phase for UP and DOWN, never UP and DOWN
> simultaneously, direction change through OFF with a pause of at least 0.5 s.
>
> - Install inside a closed control cabinet only. Protect all terminals from accidental contact.
> - **24 V DC input** is SELV (Safety Extra-Low Voltage).
> - Follow local electrical code.

## Mechanical and Environmental

<!-- hm:specs:start -->
| Specification | Details |
|---|---|
| Microcontroller | ESP32-WROOM-32U-N16 (dual-core) |
| Storage | MicroSD card (SPI interface, power-switched 3.3 V rail) |
| Power Input | 24 V DC nominal or 85–265 V AC, 47–63 Hz (L / N) |
| RTC | RTC (PCF8563); backup battery holder, battery not fitted |
| Document revision | DS-MiniPLC Rev. B · 2026-09 · Hardware V1.0 |
| Digital Inputs | 4 × isolated 24 V DC discrete inputs (DIx + GNDx), supporting dry-contact closure protected by per-channel PTC fuse, TVS surge suppression, and EMI filtering |
| Relay outputs | 6 × SPDT (NO / C / NC); 3 A @ 250 VAC per contact (module limit) |
| Analog Inputs | 4 × 0–10 V, 16-bit (ADS1115) |
| Analog Outputs | 1 × 0–10 V, 12-bit (MCP4725) |
| Temperature Inputs | 2 × RTD (PT100/PT1000 via MAX31865), 2 × 1-Wire (DS18B20 compatible) |
| Display | 128 × 64 OLED (SH1106) |
| User Interface | 4 buttons, 16 LEDs: PWR ×1, user ×3 (U.1–U.3; U.3 is the status LED by default, reassignable), RX/TX ×2, DI ×4, relay ×6 |
| RS-485 | non-isolated RS-485 (MAX485; transceiver shares logic ground); half-duplex Modbus RTU, not galvanically isolated |
| Wi-Fi | Wi-Fi (ESP32) |
| Ethernet | Optional Ethernet (LAN8720 PHY) |
| USB | USB-C (ESD protected, CC detection, data to ESP32) |
| Operating temperature | 0 °C to +40 °C |
| Storage temperature | −10 °C to +55 °C |
| Relative humidity | 0–90 % RH, non-condensing |
| Ingress protection | IP20 (inside cabinet only) |
| Installation | Indoor control cabinet only; not for outdoor or exposed installation |
| Maximum altitude | 2000 m |
| Pollution degree | 2 |
| Dimensions | 158 × 90.6 × 67.3 mm (L × W × H) |
| DIN width | 9 modules (≈ 158 mm) |
| Mounting | 35 mm DIN rail |
| Enclosure | PC/ABS industrial enclosure |
| Terminal type | Pluggable screw terminal blocks, 5.08 mm pitch |
| Wire cross-section | 0.2–2.5 mm² (AWG 24–12) |
| Tightening torque | 0.4–0.6 Nm |
| Net weight | 300 g |
| Gross weight | 450 g |
| Pack size | 230 × 140 × 87 mm (L × W × H) |
<!-- hm:specs:end -->

Mechanical Drawing

*Mechanical drawing: front and side view, dimensions in mm*

## Installation

### DIN Rail Mounting

- Mount on 35 mm DIN rail. The device occupies 9 DIN modules (≈ 158 mm width).
- Install only inside a ventilated control cabinet.
- The cabinet must include a protective front plate covering all terminals and a closing protective door.
- Not suitable for outdoor or exposed installation.

### Terminal Wiring

- Terminal type: pluggable screw terminal blocks, 5.08 mm pitch.
- Wire cross-section: 0.2–2.5 mm² (AWG 24–12), solid or stranded copper.
- Use ferrules for stranded wire. Tightening torque: 0.4 Nm maximum.
- All wiring terminals must be protected against accidental contact by an insulating front plate, wiring duct, or terminal cover. **Exposed live terminals are not permitted.**

## Cable Recommendations & Shield Grounding

This section applies to **Analog (0–10 V)**, **Temperature (RTD / 1-Wire)**, and **RS-485** wiring. Use shielded, twisted constructions and bond shields correctly to reduce EMI and ground-loop issues.

### General Routing Rules

- Route low-level signal cables (Analog / RTD / 1-Wire / RS-485) separately from mains, relay outputs, contactors, VFD motor cables, and power wiring.
- If crossing power cables is unavoidable, cross at **90°**.
- Keep cable runs as short as practical and avoid parallel runs with high-current conductors.

### Analog (0–10 V) Cable

- Construction: twisted pair (Signal + GND) per channel.
- Shielding: overall shield (standard) or individually shielded pairs (high-EMI).
- Examples: `J-Y(ST)Y` (overall shield) or `LI2YCY PiMF` (shielded twisted pairs).

### RTD (PT100 / PT1000) Cable

- Recommended: shielded multi-core for 2/3-wire; shielded pairs for best accuracy (4-wire).
- Examples: `J-Y(ST)Y` (overall shield) or `LI2YCY PiMF 2×2×0.50` for 4-wire.

### 1-Wire (DS18B20) Cable

- Recommended: shielded 3-core (+5 V / DATA / GND) for typical installations.
- High-EMI / long runs: shielded pairs + overall shield (e.g. `LI2YCY PiMF 2×2×0.50`).
- Topology: **daisy-chain (bus) only** — star wiring is not supported.
- Keep sensor stubs ≤ **0.5 m**.
- Maximum total bus length: **100 m** (DS18B20 with external power).
- Maximum recommended sensors per bus: **10**.

### RS-485 Cable

- Construction: twisted pair for A/B.
- Characteristic impedance: **120 Ω** recommended.
- Shielding: overall shield in cabinets; individually shielded pairs + overall shield in high-EMI.
- Examples: `J-Y(ST)Y 2×2×0.5 mm²` or `LI2YCY PiMF 2×2×0.50`.
- Run COM to every node. Required, not optional: the RS-485 port is not galvanically isolated.

### Shield Grounding

- Default: bond cable shields to cabinet **PE/EMC ground at the PLC end only** (single-end bonding).
- Do not connect shields to signal terminals (AI / AO / RTD / 1-Wire / RS-485 A/B/COM).
- If both ends are in equipotential-bonded cabinets, both-end bonding is permitted using proper 360° clamps.

## Wiring

### Power Input

> ⚠️ **Critical:** Exactly **ONE** power input may be used at a time. V+/0V and L/N must never be connected simultaneously.

| Input | Terminals | Range |
|---|---|---|
| 24 V DC | V+ / 0V | 24 V DC nominal |
| AC Mains | L / N | 85–265 V AC, 47–63 Hz |

| 24 V DC Input | 230 V AC Input |
|:---:|:---:|
| 24V DC wiring<br>*Connect + to V+, − to 0V.* | 230V AC wiring<br>*Connect Live to L, Neutral to N.* |

Typical operating current: 150 mA @ 24 V DC (≈ 3.6 W), measured.
Upstream protection: external T0.5 A fuse or 0.5 A breaker on V+.

- Internal service fuse: **1.0 A** (soldered).
- AC input passes through an isolated AC/DC power module that generates the internal 24 V rail.

### Digital Input Wiring

| Dry contact | Shared common |
|:---:|:---:|
| DI wiring 1<br>*Dry-contact wiring to DI inputs.* | DI wiring 2<br>*Shared common wiring approach.* |

### Relay Output Wiring

> ⚠️ **External protection required:** Every relay output MUST be protected by an external fuse or circuit breaker, not more than **3 A per channel**. Relay output circuits are not internally fused.
>
> ⚠️ **Common protection:** If a single common fuse or breaker protects several channels, do **not** size it by summing the channel currents. The common device must still protect each channel, so its rating is not more than **3 A**.

> ⚠️ **Loads above 3 A or inductive / high-inrush loads** MUST be switched using an external contactor. The MiniPLC relay then drives the contactor coil, not the load directly.
>
> Capacitor motors: see [Electrical and Safety Notes](#electrical-and-safety-notes).

Relay wiring

*Example wiring using NO and NC relay contacts. Each relay exposes COM / NO / NC.*

For inductive or DC loads, use appropriate suppression (RC snubbers, MOVs, or flyback diodes).

### Analog Input Wiring (0–10 V)

AI wiring

*Multiple 0–10 V sensors with shared 0 V/GND reference.*

- Reference: connect sensor 0 V to AI GND.
- Use a twisted pair (Signal + GND) for long runs.
- Keep AI wiring away from relay outputs, mains, and motor cables.

### Analog Output Wiring (0–10 V)

AO wiring

*0–10 V analog output to external device (VFD, valve actuator, controller).*

- Use a twisted pair (AO + AO GND) for long runs.
- Keep AO wiring away from power switching and motor cables.

### RTD Sensor Wiring (PT100 / PT1000)

| 2-wire | 3-wire | 4-wire |
|:---:|:---:|:---:|
| RTD 2-wire | RTD 3-wire | RTD 4-wire |

The sensor type (PT100 vs PT1000) and wiring mode (2/3/4-wire) are selected by on-board jumpers J-RTD/1 and J-RTD/2 — see [RTD Jumper Configuration](#rtd-jumper-configuration) below.

### 1-Wire Sensor Wiring

1-Wire wiring

*Daisy-chain DS18B20 sensors with +5 V / DATA / GND. Stubs ≤ 0.5 m.*

> ⚠️ **One sensor per bus by default.** The shipped configuration does not pin sensor addresses. With multiple sensors on the same 1-Wire bus, ESPHome reads the first sensor it discovers — assignment is non-deterministic across reboots. For multiple sensors per bus, set explicit `address:` values in YAML (visible in ESPHome logs at boot).

### RS-485 / Modbus RTU

<!-- hm:rs485-order:begin -->
> **Terminal order differs across the HomeMaster range.**
> Always read the silkscreen - do not wire by habit from another module.
> On this module the order is **COM-B-A**.
> Swapping A and B damages nothing but the node will not communicate.
> COM is required on every node.
<!-- hm:rs485-order:end -->
All HomeMaster controllers and modules share the same RS-485 front end.

| Item | Value |
|---|---|
| Transceiver | MAX485CSA+T, half-duplex |
| Galvanic isolation | **None** — the transceiver shares the device's logic ground |
| Common-mode range | −7 V … +12 V referred to the device's own ground (MAX485 limit) |
| Terminals | A / B / COM |
| Surge protection | 3 × SMAJ6.8CA TVS (A–COM, B–COM, A–B) |
| Overcurrent | 2 × resettable PTC, 1.5 A hold, in series with A and B |
| EMI filtering | Common-mode choke on the A/B pair; COM referenced through 1 MΩ ∥ 4.7 nF |
| Idle state | Fail-safe biasing on board — do not add external bias resistors |
| Termination | 120 Ω at the two physical ends of the bus only |

**Bus wiring rules — apply to every device on the bus:**

- One twisted pair for A/B, 120 Ω characteristic impedance.
- Run **COM** to every node. Required, not optional: the ports are not isolated, and COM is what bounds the common-mode voltage the transceivers see.
- Prefer one power supply for the whole bus, distributed in star topology. With separate supplies, additionally tie the 0 V references together at a single point.
- Bond the cable shield to cabinet PE at one end only. Never land a shield on A, B or COM.
- Where the bus crosses into a different electrical installation with its own earthing reference — a utility or billing meter, another building, another cabinet's PE system — fit an external galvanic RS-485 isolator at that boundary. The on-board components are transient protection, not isolation, and will not survive a sustained ground-potential difference.

| Two-wire bus | Termination |
|:---:|:---:|
| RS-485 wiring 1<br>*Connect A, B, and COM to the bus.* | RS-485 wiring 2<br>*120 Ω termination only at the two physical ends.* |

## Pinout

Pinout

MiniPLC system block diagram

*MiniPLC system block diagram — MCU, power, I/O and bus interfaces.*

## Terminal Reference

<!-- hm:terminal-map:begin -->

**Top row** (220Vac | 24Vdc | 1-WIRE/1 | 1-WIRE/2 | RELAY1-6)

| Pos | Label | Group | Function |
|-----|---|---|---|
| 1 | L | POWER_AC | AC line (MAINS) |
| 2 | N | POWER_AC | AC neutral (MAINS) |
| 3 | V+ | POWER_DC | 24 V DC input |
| 4 | 0V | POWER_DC | 24 V DC return |
| 5 | +5V | BUS1 | 1-Wire bus 1 supply |
| 6 | D | BUS1 | 1-Wire bus 1 data |
| 7 | Gnd | BUS1 | 1-Wire bus 1 ground |
| 8 | +5V | BUS2 | 1-Wire bus 2 supply |
| 9 | D | BUS2 | 1-Wire bus 2 data |
| 10 | Gnd | BUS2 | 1-Wire bus 2 ground |
| 11 | NO | RELAY1 | Relay 1 normally open |
| 12 | C | RELAY1 | Relay 1 common |
| 13 | NC | RELAY1 | Relay 1 normally closed |
| 14 | NO | RELAY2 | Relay 2 normally open |
| 15 | C | RELAY2 | Relay 2 common |
| 16 | NC | RELAY2 | Relay 2 normally closed |
| 17 | NO | RELAY3 | Relay 3 normally open |
| 18 | C | RELAY3 | Relay 3 common |
| 19 | NC | RELAY3 | Relay 3 normally closed |
| 20 | NO | RELAY4 | Relay 4 normally open |
| 21 | C | RELAY4 | Relay 4 common |
| 22 | NC | RELAY4 | Relay 4 normally closed |
| 23 | NO | RELAY5 | Relay 5 normally open |
| 24 | C | RELAY5 | Relay 5 common |
| 25 | NC | RELAY5 | Relay 5 normally closed |
| 26 | NO | RELAY6 | Relay 6 normally open |
| 27 | C | RELAY6 | Relay 6 common |
| 28 | NC | RELAY6 | Relay 6 normally closed |

**Bottom row** (AI 0-10V | AO 0-10V | RTD/1 | RTD/2 | DI 24Vdc | RS-485)

| Pos | Label | Group | Function |
|-----|---|---|---|
| 1 | GND | ANALOG_INPUT | Common return for AI1-AI4 |
| 2 | AI1 | ANALOG_INPUT | Analog input 1, 0-10 V |
| 3 | AI2 | ANALOG_INPUT | Analog input 2, 0-10 V |
| 4 | AI3 | ANALOG_INPUT | Analog input 3, 0-10 V |
| 5 | AI4 | ANALOG_INPUT | Analog input 4, 0-10 V |
| 6 | AO | ANALOG_OUTPUT | Analog output, 0-10 V |
| 7 | GND | ANALOG_OUTPUT | Analog output return |
| 8 | 1 | RTD1 | RTD 1 terminal 1 |
| 9 | 2 | RTD1 | RTD 1 terminal 2 |
| 10 | 3 | RTD1 | RTD 1 terminal 3 |
| 11 | 4 | RTD1 | RTD 1 terminal 4 |
| 12 | 1 | RTD2 | RTD 2 terminal 1 |
| 13 | 2 | RTD2 | RTD 2 terminal 2 |
| 14 | 3 | RTD2 | RTD 2 terminal 3 |
| 15 | 4 | RTD2 | RTD 2 terminal 4 |
| 16 | GND | DI1 | DI1 return |
| 17 | I.1 | DI1 | DI1 input |
| 18 | GND | DI2 | DI2 return |
| 19 | I.2 | DI2 | DI2 input |
| 20 | GND | DI3 | DI3 return |
| 21 | I.3 | DI3 | DI3 input |
| 22 | GND | DI4 | DI4 return |
| 23 | I.4 | DI4 | DI4 input |
| 24 | COM | RS485 | RS-485 signal reference |
| 25 | B | RS485 | RS-485 data - |
| 26 | A | RS485 | RS-485 data + |

**Ports & service interfaces**

| Id | Type | Note |
|----|---|---|
| ETHERNET | RJ45 |  |
| SD card |  |  |
| USB-C |  |  |
| ANTENNA | SMA |  |
| DISPLAY |  | on-board screen with four navigation buttons |

**Housing notes**

- Analog inputs share one GND, printed first.
- ONE analog output (AO + GND), not two.
- Two 1-Wire buses on separate blocks, 1-WIRE/1 and 1-WIRE/2.
- Dual supply, 230 V AC or 24 V DC.
- Only module in the range with Ethernet.

<!-- hm:terminal-map:end -->

## LED and Button Behaviour

### LEDs

The device has 16 LEDs total on the front panel: **PWR**, **U.1–U.3** (user; U.3 is the status LED by default, reassignable), **RX**, **TX**, **DI×4**, and **R×6**.

| LED | Behaviour | Meaning |
|---|---|---|
| PWR | Solid ON | Device is powered |
| RX / TX | Activity | RS-485 / Modbus traffic |
| DI 1–4 | Solid ON when input is active | Digital input state mirror |
| R 1–6 | Solid ON when relay energised | Relay output state mirror |
| U.1, U.2, U.3 | Firmware-controlled | User-assignable via ESPHome YAML. U.3 is the status LED by default, reassignable |
| U.3 (default) | Off | Normal operation — no warning or error |
| U.3 (default) | Slow blink (~1 Hz) | Warning active. Warnings include Wi-Fi disruption and the native API being present with **no client connected** |
| U.3 (default) | Fast blink | Error found during setup |
| U.3 (default) | Blink pattern | OTA update in progress |

> U.3 is a user LED. The default firmware uses it as the ESPHome `status_led` on
> PCF8574A pin **P7**; it can be reassigned. Default patterns follow the
> ESPHome `status_led` component (off = OK, slow blink = warning, fast blink =
> setup error).

### Buttons (GPIO via PCF8574A)

The 4 front-panel buttons are exposed as binary sensors in ESPHome (`button_1` through `button_4`). Default behaviour: read-only input — pressing each triggers the matching binary sensor.

You can add automations in ESPHome or Home Assistant to assign actions (e.g., toggle a relay, restart device, trigger a scene).

## GPIO Map

All hardware-assigned GPIOs are listed below. Do not reassign reserved GPIOs in custom ESPHome YAML.

| GPIO | Function | User-configurable |
|---|---|---|
| GPIO36 | Digital Input #1 (24 V DC, isolated) | No — reserved |
| GPIO39 | Digital Input #2 (24 V DC, isolated) | No — reserved |
| GPIO34 | Digital Input #3 (24 V DC, isolated) | No — reserved |
| GPIO35 | Digital Input #4 (24 V DC, isolated) | No — reserved |
| GPIO32 | I²C SDA — OLED, RTC, ADC, DAC, PCF8574 | No — reserved |
| GPIO33 | I²C SCL — OLED, RTC, ADC, DAC, PCF8574 | No — reserved |
| GPIO17 | RS-485 UART TX | No — reserved |
| GPIO16 | RS-485 UART RX | No — reserved |
| GPIO5 | 1-Wire Bus 1 (D1 terminal) — strapping pin, must be HIGH at boot | No — reserved |
| GPIO4 | 1-Wire Bus 2 (D2 terminal) | No — reserved |
| GPIO2 | Buzzer (PWM via LEDC) — strapping pin | No — reserved |
| GPIO12 | SPI MISO — microSD + MAX31865 RTD | No — reserved |
| GPIO13 | SPI MOSI — microSD + MAX31865 RTD | No — reserved |
| GPIO14 | SPI SCLK — microSD + MAX31865 RTD | No — reserved |
| GPIO15 | SPI CS — microSD | No — reserved |
| GPIO1 | SPI CS — MAX31865 RTD #2 | No — reserved |
| GPIO3 | SPI CS — MAX31865 RTD #1 | No — reserved |
| GPIO23 | RMII MDC (Ethernet) | No — reserved (Ethernet) |
| GPIO18 | RMII MDIO (Ethernet) | No — reserved (Ethernet) |
| GPIO19 | RMII TXD0 (Ethernet) | No — reserved (Ethernet) |
| GPIO22 | RMII TXD1 (Ethernet) | No — reserved (Ethernet) |
| GPIO21 | RMII TXEN (Ethernet) | No — reserved (Ethernet) |
| GPIO26 | RMII RXD0 (Ethernet) | No — reserved (Ethernet) |
| GPIO25 | RMII RXD1 (Ethernet) | No — reserved (Ethernet) |
| GPIO27 | RMII CRS_DV (Ethernet) | No — reserved (Ethernet) |
| GPIO0 | RMII 50 MHz REF (Ethernet) — strapping pin | No — reserved (Ethernet) |

### PCF8574 Mapping

**PCF8574A (I²C 0x38)** — buttons, user LEDs, and status LED

| Pin | Signal | Function |
|---|---|---|
| P0 | BTN1 | Button #1 |
| P1 | BTN2 | Button #2 |
| P2 | BTN3 | Button #3 |
| P3 | BTN4 | Button #4 |
| P4 | LED1 | User LED #1 (Relay #6 control in default firmware) |
| P5 | LED2 | User LED #2 (Relay #5 control in default firmware) |
| P6 | LED3 | User LED #3 (Relay #4 control in default firmware) |
| P7 | LED_STATUS | User LED U.3 (status by default, reassignable) |

**PCF8574B (I²C 0x39)** — relays #1–#3 and user LEDs

| Pin | Signal | Function |
|---|---|---|
| P0 | Relay #3 | SPDT relay output |
| P1 | Relay #2 | SPDT relay output |
| P2 | Relay #1 | SPDT relay output |
| P3 | LED #2 | User LED |
| P4 | LED #3 | User LED |

> ℹ️ Relays #4, #5, #6 share PCF8574A pins P6, P5, P4 with the user LEDs U.3 / U.2 / U.1 silkscreen labels — they are the same physical signal lines driving both the relay coil and the front-panel relay-status LED.

## Temperature Inputs

| Input | Sensor | Measuring range |
|---|---|---|
| RTD #1, RTD #2 | PT100 / PT1000 (MAX31865) | −200 … +850 °C (sensor range) |
| 1-Wire BUS #1, #2 | DS18B20 or compatible | −55 … +125 °C; ±0.5 °C in −10 … +85 °C (DS18B20 data) |

## RTD Jumper Configuration

> **Correction (2026-09-17).** Earlier README and example YAML had RTD chip-select pins swapped (**RTD1 = GPIO1**, **RTD2 = GPIO3**) and listed RTD2 as PT1000 from the factory. Correct: **RTD1 = GPIO3**, **RTD2 = GPIO1**, and both channels ship as **PT100, 2-wire**. Board and enclosure labels were always correct.

The MiniPLC includes **two MAX31865 RTD interface ICs** for direct connection of **PT100 and PT1000 sensors** in **2-, 3-, or 4-wire** configurations.

RTD configuration jumpers sit on the **field/RTD front-end** for each channel (**J - RTD/1**, **J - RTD/2**). Each block has eight positions **J1–J8**. Factory default is **PT100** and **2-wire** on both channels. Use the table below when changing sensor type or wiring topology.

RTD jumper blocks

*RTD jumper blocks.*

### Factory configuration (as shipped)

Both channels: **PT100, 2-wire**.

| Jumper | 1 | 2 | 3 | 4 | 5 | 6 | 7 | 8 |
|---|---|---|---|---|---|---|---|---|
| State | **ON** | **ON** | **OFF** | **OFF** | **ON** | **ON** | **OFF** | **ON** |

### Jumper logic (per channel, J-RTD/1 and J-RTD/2)

| Mode | J1 | J2 | J3 | J4 | J5 | J6 | J7 | J8 |
|---|---|---|---|---|---|---|---|---|
| **PT100** | — | ON | OFF | — | — | ON | OFF | — |
| **PT1000** | — | OFF | ON | — | — | OFF | ON | — |
| **2-wire** | ON | — | — | OFF | ON | — | — | ON |
| **3-wire** | OFF | — | — | ON | OFF | — | — | ON |
| **4-wire** | OFF | — | — | OFF | ON | — | — | OFF |

Jumpers **J1, J4–J5 and J8** select wiring mode. Jumpers **J2–J3 and J6–J7** select sensor type. The full pattern must be set consistently.

### Terminal mapping (per RTD block)

| Terminal | Signal |
|---|---|
| 1 | FORCE+ |
| 2 | RTDIN+ |
| 3 | RTDIN− |
| 4 | FORCE− |

### How to change sensor type or wiring

1. Power OFF the MiniPLC.
2. Set jumpers J1–J8 per the logic table above.
3. Update ESPHome YAML: change `rtd_nominal_resistance` (100 or 1000) and `wires` (2, 3, or 4).
4. Power ON and verify temperature readings.

**Fixed by hardware:** MAX31865 IC, SPI pins, CS pins (RTD1 = GPIO3, RTD2 = GPIO1), reference resistor network, terminal order.

**Configurable in YAML:** sensor type (`rtd_nominal_resistance: 100` or `1000`), wiring mode (`wires: 2/3/4`), update interval, filters, alarm thresholds.

## Enabling RTD Sensors in YAML

RTD inputs are **disabled in the factory firmware** because the MAX31865 chip-select lines are wired to **GPIO1** and **GPIO3**, which are the ESP32 UART0 TX/RX pins used by the USB serial logger and Improv Serial provisioning.

> ⚠️ **Trade-off:** Enabling RTD sensors disables the USB serial logger and Improv Serial. After this change, the device can be flashed only via OTA (Wi-Fi or Ethernet).
>
> Serial Improv is the **only** provisioning channel that remains open after the
> 15-minute provisioning window expires. With RTD enabled (Serial Improv removed),
> the only way to reopen provisioning is to **power-cycle** and use **BLE Improv**
> within the new 15-minute window.

To enable RTD sensors, after taking control of the device:

1. Disable the serial logger:

```yaml
   logger:
     baud_rate: 0
```

2. Remove the `improv_serial:` block.

3. Add the SPI bus and the MAX31865 sensors:

```yaml
   spi:
     miso_pin: GPIO12
     mosi_pin: GPIO13
     clk_pin: GPIO14

   sensor:
     - platform: max31865
       id: rtd_1
       name: "RTD Temperature 1"
       cs_pin: GPIO3
       reference_resistance: 400 Ω
       rtd_nominal_resistance: 100 Ω
       wires: 2
       update_interval: 60s
     - platform: max31865
       id: rtd_2
       name: "RTD Temperature 2"
       cs_pin: GPIO1
       reference_resistance: 400 Ω
       rtd_nominal_resistance: 100 Ω
       wires: 2
       update_interval: 60s
```

4. Adjust `rtd_nominal_resistance` (`100` for PT100, `1000` for PT1000) and `wires` (`2`, `3`, or `4`) to match the jumper settings — see [RTD Jumper Configuration](#rtd-jumper-configuration).

## Enabling 1-Wire Sensors in YAML

The two 1-Wire buses (GPIO5 and GPIO4) are pre-declared in the factory firmware, but no DS18B20 sensors are read until they are added to the YAML.

```yaml
sensor:
  - platform: dallas_temp
    id: ow_bus_1_temp
    one_wire_id: ow_bus_1
    name: "1-Wire Bus 1 Temperature"
    update_interval: 60s
  - platform: dallas_temp
    id: ow_bus_2_temp
    one_wire_id: ow_bus_2
    name: "1-Wire Bus 2 Temperature"
    update_interval: 60s
```

If you wire more than one sensor to the same bus, set an explicit `address:` for each entry — discovered addresses are printed in the ESPHome boot logs.

## Real-Time Clock (RTC) Battery

The MiniPLC includes a **PCF8563** real-time clock chip on the I²C bus (address `0x51`), with an on-board **coin-cell battery holder** for keeping time during power loss.

> ℹ️ **Battery is NOT installed by default.** The unit ships without a coin cell in the holder. The RTC and timekeeping work normally while the device is powered; install a battery only if you need the clock to keep running after a power outage.

To fit a backup battery (holder is on the board; cell not fitted):

1. Power OFF the MiniPLC and disconnect all inputs.
2. Open the enclosure (refer to the hardware schematics for the battery-holder location on the MCU Board).
3. Insert a fresh coin cell into the holder, observing the polarity marked on the PCB.
4. Re-assemble and power on.

The PCF8563 draws negligible current from the battery in standby — a typical CR-series coin cell will last for years.

In normal operation the MiniPLC synchronises time from Home Assistant on every Wi-Fi connect (see `time: platform: homeassistant` in the default firmware), so timekeeping works fully without a battery as long as the network is reachable. The battery only matters if you want correct timestamps on the OLED display and in local time-based automations during a power outage.

## Network Requirements

- Device and Home Assistant must be on the **same subnet**.
- **mDNS** must be functional on the network for auto-discovery. In VLAN setups, configure an mDNS repeater or use a static IP assigned via ESPHome YAML.
- ESPHome API uses **TCP port 6053**. Ensure this port is not blocked by firewall rules between the device and Home Assistant.
- Vendor-managed OTA updates require outbound **HTTPS (port 443)** access to GitHub Pages from the device.

## Commissioning (firmware 1.1.0)

From firmware **1.1.0** the factory image ships with an encrypted native API and a
timed provisioning window (EN 18031-1 / RED Art. 3(3)(d)). Commissioning has two
stages: put the device on the network, then adopt it so each unit gets its own API
encryption key. No key is baked into the published factory binary — that binary is
identical for every unit and downloadable by anyone, so a baked-in key would be
public.

### 1. Wi-Fi provisioning

Primary setup is **Improv** via [improv-wifi.com](https://improv-wifi.com) in Chrome or Edge, over BLE or USB Serial.

Details: [First Boot & Wi-Fi Setup](#first-boot--wi-fi-setup).

### 2. Provisioning window (15 minutes)

After power-on the device accepts initial configuration for **15 minutes**. When the
window closes:

- new native API clients are refused
- BLE Improv stops accepting credentials

**Power-cycle the device** to reopen the window for another 15 minutes. Serial
provisioning over USB continues to work regardless, because it requires physical
access (unless RTD sensors have claimed GPIO1/GPIO3 — see [Enabling RTD Sensors in YAML](#enabling-rtd-sensors-in-yaml)).

### 3. Take control / adoption

The device appears in ESPHome Device Builder as `homemaster-miniplc-<mac>` running
`homemaster.miniplc 1.1.0`. Press **Take control** to import the full configuration
into your dashboard. That step generates the **API encryption key** and **OTA
password** for this device.

### 4. Encryption key — save it

Each device gets its own key at commissioning. Save it — you need it when moving
the device to another Home Assistant instance or re-adding it after removal. You
can retrieve it later from **Device info → Show encryption key**.

## First Boot & Wi-Fi Setup

The MiniPLC supports **Improv Wi-Fi provisioning** (BLE or USB Serial) via
[improv-wifi.com](https://improv-wifi.com) in Chrome or Edge. If Wi-Fi credentials
change later, power-cycle the device to reopen the 15-minute provisioning window,
then provision again with Improv over BLE or USB.

### Improv Wi-Fi Setup

You can provision Wi-Fi via either **Bluetooth (BLE)** or **USB-C (Serial)** — pick whichever is convenient.

1. Power on the device.
2. Open <https://improv-wifi.com> in Chrome or Edge (desktop or mobile).
3. Click **Connect device** and choose:
   - **Bluetooth LE** — pair with the device wirelessly (recommended for devices already mounted in a cabinet).
   - **USB Serial** — connect a USB-C cable from the MiniPLC to your computer.
4. Enter your Wi-Fi SSID and password, press **Connect**.
5. Wait a few seconds — the device joins your Wi-Fi.

ℹ️ BLE Improv provisioning is open (`authorizer: none`) until the device successfully connects to Wi-Fi for the first time. Provision in a private location and avoid leaving an un-provisioned device powered on within BLE range of untrusted devices.

After Wi-Fi connects, complete adoption as described in
[Commissioning (firmware 1.1.0)](#commissioning-firmware-110) (**Take control**,
encryption key).

### USB Serial Driver & Port Access

The USB Type-C port uses a **Silicon Labs CP2102N** USB-to-UART bridge for serial console, Improv Wi-Fi provisioning over USB Serial, and ESPHome USB flashing.

- **Windows** — The CP210x driver installs automatically via **Windows Update** on first connect. The port appears as `COMx` in Device Manager.
- **macOS** — Install the **Silicon Labs CP210x VCP driver**, then **enable its system extension**: on **macOS 15 / 26**, open **System Settings → General → Login Items & Extensions → Extensions**; on older macOS, use **System Settings → Privacy & Security** and allow the Silicon Labs extension. Log out and back in, or reboot, if prompted.
- **Linux** — Support is **in-kernel** (`cp210x`). Add your user to the **`dialout`** group (`sudo usermod -aG dialout $USER`), then log out and back in. The port appears as `/dev/ttyUSB0` or similar.

**Bluetooth (BLE Improv):** no driver is needed. **Web Bluetooth** works in Chrome/Edge on most platforms; on **desktop Linux** it is **off by default** (use USB Serial or enable the browser flag); **Firefox** and **iOS** do not support Web Bluetooth — use USB Serial or Chrome/Edge on Android for BLE provisioning.

## Optional Ethernet (LAN8720)

The MiniPLC has an on-board LAN8720 PHY (RMII, fixed pins) but Ethernet is **not enabled in the factory firmware** — Wi-Fi is used by default.

ESPHome does not allow `wifi:` and `ethernet:` to be enabled at the same time, so switching to Ethernet means **replacing** the Wi-Fi setup, not adding to it.

To enable Ethernet, after taking control of the device:

1. Add the `ethernet:` block:

```yaml
   ethernet:
     type: LAN8720
     id: eth_phy
     mdc_pin: GPIO23
     mdio_pin: GPIO18
     clk_mode: GPIO0_OUT
     phy_addr: 1
```

2. Remove (or comment out) all Wi-Fi-related blocks:
   - `wifi:`
   - `improv_serial:`
   - `esp32_improv:`
   - `wifi_signal` sensor under `sensor:`
   - `wifi_info` text sensor under `text_sensor:`

The `api:`, `ota:`, `update:`, `dashboard_import:` and all other non-Wi-Fi
components continue to work over Ethernet without changes. (Factory firmware
**1.1.0** no longer includes `web_server:` — see changelog.)

> **Ethernet and provisioning (1.1.0):** a working Ethernet link satisfies the
> network side of provisioning. There is no BLE / Serial Improv step on the
> Ethernet factory variant (`config-eth.yaml`). The device is considered
> provisioned once it has network connectivity and the API encryption key is
> established (Take control / adoption). The **15-minute** window and
> **power-cycle to reopen** behaviour are the same as on Wi-Fi.

> ⚠️ After switching to Ethernet you lose Wi-Fi provisioning via Improv. To go back, restore the Wi-Fi blocks and remove the `ethernet:` block.

## Home Assistant Integration

After Wi-Fi provisioning, the device appears automatically in:

- **ESPHome Dashboard** — for configuration and logs.
- **Home Assistant** — under Settings → Devices & Services → ESPHome.

Click **Take control** in ESPHome Device Builder to import the full configuration,
establish the per-device API encryption key, and manage firmware yourself. See
[Commissioning (firmware 1.1.0)](#commissioning-firmware-110).

### ⚠️ Note on Taking Control

After taking control, vendor-managed OTA updates stop working unless you keep the `http_request`, `ota: platform: http_request`, and `update` blocks from the original configuration in your YAML.

If you remove these blocks, update via ESPHome OTA or USB instead.

⚠️ `import_full_config: true` in the `dashboard_import:` block will overwrite any local edits to your YAML on every dashboard import. After your first successful import, set it to `false` (or remove the `dashboard_import:` block entirely) if you want to keep custom changes.

### ESPHome Compatibility

- Minimum ESPHome version for firmware **1.1.0**: **2026.7.0** (`esphome.min_version`)

## Firmware Updates

The device supports two firmware update methods:

### ESPHome Updates (User-controlled)

After taking control in ESPHome Dashboard, firmware can be updated manually:

- Build new firmware from ESPHome.
- Upload via OTA or USB.
- Full control over configuration.

### Managed Updates (HTTP)

The device also supports vendor-provided firmware updates. A `Firmware Update` entity is exposed in Home Assistant, allowing the device to check for new firmware versions and install updates directly.

This mechanism uses the `update.http_request` component with a hosted firmware manifest, downloading updates over HTTPS directly to the device.

The device polls the firmware manifest every 6 hours (`update_interval: 6h`). To disable vendor-managed OTA, remove the `update:`, `http_request:`, and `ota: platform: http_request` blocks from your YAML. Updates will then only be possible via ESPHome OTA or USB.

> ℹ️ **OTA security:** OTA updates are downloaded over HTTPS from GitHub Pages. Trust depends on the security of the HomeMaster GitHub account; firmware files are not separately signed. If you need a stricter trust model, take control in ESPHome Dashboard and manage updates yourself.

> ⚠️ **OTA safety:** Do not interrupt a firmware update once started. If an OTA update is interrupted mid-flash, the device may fail to boot. If this occurs, reflash via USB-C using ESPHome or the ESP flashing tool. ESPHome safe mode is active for the first 10 boot attempts after a failed OTA — connect via USB and reflash to recover.

## Device Behaviour Reference

| Condition | Relays | DIs / AIs / RTD / 1-Wire | Modbus / RS-485 |
|---|---|---|---|
| Normal operation | Controlled by HA | Reported to HA | Master polls slaves |
| Wi-Fi lost | Hold last state | Continue local reading | Continue polling |
| HA disconnected | Hold last state | Continue local reading | Continue polling |
| ESP reboot | Restore OFF (relays open) | — | Restarts polling |
| Modbus slave offline | Unaffected | Unaffected | Logs timeout |

> ⚠️ After reboot all relays restore to OFF (open). Verify this is safe for your installation before deploying.

## Troubleshooting

| Symptom | Checks | Action |
|---|---|---|
| Device not in HA or ESPHome Dashboard | PWR LED solid ON? U.3 slow-blinking (warning)? Same subnet as HA? Within 15 min of power-on? | Check Wi-Fi / Ethernet. Slow-blink U.3 is a `status_led` warning (includes no API client). Finish [commissioning](#commissioning-firmware-110). Power-cycle to reopen the 15-minute window; use USB Serial Improv if BLE window closed. |
| Digital input not responding | DI LED on front panel ON when input active? Wiring uses potential-free contact to GND (not 0V power return)? | Wire the contact between the DI terminal and its GND return; do not apply external voltage. Verify the input is not inverted in YAML and debounce is not too high. |
| Relay does not switch | `RELAY #n` switch entity present in HA? | Toggle from HA. Check external fuse / breaker on the load circuit. Note: load needs its own power supply — relays are dry contact. |
| Analog input reads 0 V | Sensor 0 V tied to AI GND? Sensor powered? | Tie sensor reference to AI GND. Check that sensor output is actually in 0–10 V range (some sensors output 4–20 mA — those need a separate 250 Ω resistor or a 4–20 mA-capable module). |
| RTD reads `NaN` or constant -242 °C | Jumpers J-RTD/1 and J-RTD/2 set correctly for sensor type and wiring mode? YAML `rtd_nominal_resistance` and `wires` match? | Cross-check the jumper table above against the sensor wiring. PT100 vs PT1000 mismatch is the most common cause. |
| 1-Wire sensor shows unknown / no value | Sensor wired correctly (+5 V / DATA / Gnd)? Stubs ≤ 0.5 m? Daisy-chain topology? | If multiple sensors on one bus, assign explicit addresses in YAML. |
| OLED display blank | I²C bus working? | Look at ESPHome logs for I²C scan output at boot. Verify 0x3C appears. |
| Modbus slave not responding | Address correct on slave WebConfig? Same baud / parity? A/B not swapped? | Check ESPHome logs for `[modbus]` timeouts. Confirm A→A and B→B (not crossed). Confirm COM is tied between all nodes. |
| Firmware update fails | Device has internet access? | Check manifest URL reachable: `https://isystemsautomation.github.io/homemaster-dev/MiniPLC/Firmware/manifest.json`. If `http_request` / `update` blocks removed from YAML, use ESPHome OTA instead. |
| Wi-Fi credentials changed, device unreachable | — | Re-provision Wi-Fi via USB-C Serial Improv at <https://improv-wifi.com>. The serial path always works regardless of Wi-Fi state. |
| Device completely unreachable | Boot loop? OTA interrupted? | Reflash via USB. CP2102N bridge — Linux auto (add user to dialout), Windows auto via Windows Update, macOS needs the CP210x VCP driver with its extension enabled (see the USB Serial Driver & Port Access section). Use <https://web.esphome.io> (Chrome/Edge) or ESPHome Dashboard → Install → Plug into computer. |

## Entity Reference

<details>
<summary>Click to expand full entity reference table</summary>

| Entity | Type | Default | Description |
|---|---|---|---|
| ESP Status | Binary Sensor | Enabled | Wi-Fi / API connection status |
| DI #1 – DI #4 | Binary Sensor | Enabled | 24 V DC digital inputs (GPIO36/39/34/35) |
| Button #1 – Button #4 | Binary Sensor | Enabled | Front-panel buttons (PCF8574A pins 0–3) |
| RELAY #1 – RELAY #6 | Switch | Enabled | SPDT relay outputs (PCF8574 pins) |
| LED #2, LED #3 | Switch | Enabled | User LEDs |
| Buzzer | Switch | Enabled | Front-panel piezo buzzer (PWM, GPIO2) |
| AI 1 – AI 4 | Sensor | Enabled | 0–10 V analog inputs (ADS1115 channels A3 / A2 / A1 / A0) |
| DAC 0-10V | Fan / Output | Enabled | 0–10 V analog output (MCP4725) |
| 1-Wire Bus 1 Temperature | Sensor | Disabled by default | DS18B20 on GPIO5 — uncomment in YAML, set explicit address |
| 1-Wire Bus 2 Temperature | Sensor | Disabled by default | DS18B20 on GPIO4 — uncomment in YAML, set explicit address |
| RTD Temperature 1 | Sensor | Disabled by default | MAX31865 PT100/PT1000 — enable in YAML, set jumpers J-RTD/1 |
| RTD Temperature 2 | Sensor | Disabled by default | MAX31865 PT100/PT1000 — enable in YAML, set jumpers J-RTD/2 |
| Uptime | Sensor | Enabled (diagnostic) | Device uptime in seconds |
| WiFi Signal | Sensor | Enabled (diagnostic) | RSSI in dBm |
| ESP32 Temperature | Sensor | Enabled (diagnostic) | Internal chip temperature |
| Current Time | Text Sensor | Enabled (diagnostic) | Formatted RTC time |
| ESPHome Version | Text Sensor | Enabled (diagnostic) | Running ESPHome version |
| IP Address | Text Sensor | Enabled (diagnostic) | Device IP address |
| Firmware Update | Update | Enabled | Vendor OTA update entity (HTTP) |

</details>

## Default Firmware Configuration

The full shipped configuration is available in the repository:
[miniplc.yaml](https://github.com/isystemsautomation/homemaster-dev/blob/main/MiniPLC/Firmware/miniplc.yaml)

The file includes:

- ESP32 board / framework
- Wi-Fi with Improv (BLE + Serial)
- ESPHome API + vendor HTTP OTA (`update.http_request`) + ESPHome OTA
- `dashboard_import` for one-click Take Control
- `api.encryption` without a baked-in key + `provisioning:` (15 min window)
- I²C bus with all on-board peripherals (PCF8574 ×2, ADS1115, MCP4725, PCF8563, SH1106)
- RS-485 UART (GPIO17 / GPIO16, 19200 baud) ready for Modbus
- All digital inputs, buttons, relays, user LEDs (U.3 is the status LED by default, reassignable), buzzer, analog inputs, analog output (DAC) with explicit `id` on every entity (Made for ESPHome compliant)

Optional features (1-Wire DS18B20 sensors, MAX31865 RTD sensors, microSD, Ethernet) are present in commented-out blocks — uncomment and adjust to enable. See also [Enabling RTD Sensors in YAML](#enabling-rtd-sensors-in-yaml), [Enabling 1-Wire Sensors in YAML](#enabling-1-wire-sensors-in-yaml), and [Optional Ethernet (LAN8720)](#optional-ethernet-lan8720).

## Support & Community

| Channel | Link |
|---|---|
| 🛠️ Official Support | [home-master.eu/support](https://www.home-master.eu/support) |
| 📺 YouTube | [youtube.com/@HomeMaster](https://youtube.com/@HomeMaster) |
| 🛡️ Reddit | [reddit.com/r/HomeMaster](https://reddit.com/r/HomeMaster) |
| 📷 Instagram | [instagram.com/home_master.eu](https://instagram.com/home_master.eu) |
| 🔬 Hackster | [hackster.io/homemaster](https://hackster.io/homemaster) |
| 🐙 GitHub | [isystemsautomation/homemaster-dev](https://github.com/isystemsautomation/homemaster-dev) |

## Compliance & Certifications

The MiniPLC module is CE marked. **ISYSTEMS AUTOMATION S.R.L.** (HomeMaster® brand) maintains the technical documentation, a signed EU Declaration of Conformity (DoC), and a signed UK PSTI statement of compliance for Great Britain.

### Applicable EU directives

- **EMC Directive 2014/30/EU** — EN 55032:2015 + AC:2016-07 + A11:2020 + A1:2020 (Class B emissions), EN 55035:2017 + A11:2020 (immunity); tested by Idvorsky Laboratories Ltd., Belgrade, Serbia.
- **Low Voltage Directive 2014/35/EU** — EN 62368-1:2020 + A11:2020; in-house dielectric and isolation test by ISYSTEMS AUTOMATION S.R.L. internal compliance laboratory.
- **RED Directive 2014/53/EU** — radio module pre-certification (ESP32 module) plus product-level EMC and EN 300 328 verification.
- **RoHS Directive 2011/65/EU** — EN IEC 63000 technical documentation.

### Compliance documents

| Document | File |
|---|---|
| EU Declaration of Conformity (DoC) | [DoC_MiniPLC.pdf](https://config.home-master.eu/MiniPLC/Manuals/DoC_MiniPLC.pdf) |
| UK PSTI Statement of Compliance | [PSTI_MiniPLC.pdf](https://config.home-master.eu/MiniPLC/Manuals/PSTI_MiniPLC.pdf) |
| Datasheet | [MiniPLC_Datasheet.pdf](https://config.home-master.eu/MiniPLC/Manuals/MiniPLC_Datasheet.pdf) |
| User Manual | [User Manual.pdf](https://config.home-master.eu/MiniPLC/Manuals/User%20Manual.pdf) |

### Trademark

**HomeMaster®** is a registered European Union trademark of ISYSTEMS AUTOMATION S.R.L., EUTM No. 019082911, registered with EUIPO on 15 January 2025.

## License

This project uses a hybrid licensing model.

### Hardware

Hardware designs (schematics, PCB layouts, BOMs) are licensed under **CERN-OHL-W v2**.

### Firmware & ESPHome Integration

All firmware, ESPHome configurations, and software components are licensed under the **MIT License**.

This ensures full compatibility with ESPHome and Home Assistant while protecting hardware designs. See LICENSE files in each directory for full terms.

Firmware release history: [Firmware/CHANGELOG.md](Firmware/CHANGELOG.md)

---

**Manufacturer:** ISYSTEMS AUTOMATION S.R.L. (HomeMaster® brand)
**Registered office (registered office):** Str. Domnisori, Nr. 81, Bl. 62, Scara A, Etaj 3, Ap. 12, 100284 Ploiesti, Jud. Prahova, Romania
**Office / Contact address:** Diligentei 18, Ploiesti, Romania
**CUI / VAT:** RO 21537032
**EUID:** ROONRC.J2007000919293
**Telephone:** +40 747 757 798
**Website:** [https://www.home-master.eu](https://www.home-master.eu)
