isystemsautomation/homemaster-dev/RGB-621-R1/README.md

# RGB-621-R1 — Module for RGB+CCT LED Control

**HOMEMASTER – Modular control. Custom logic.**

The **RGB-621-R1** is an **RGB + tunable-white (CCT) LED controller** with **5 PWM channels**, **2 digital inputs**, **1 relay**, **Modbus RTU / Home Assistant** integration, and **USB-C WebConfig** setup.

RGB-621-R1 photo




## Contents

- [Quick Start](#quick-start)
- [Version History](#version-history)
- [Hardware notes (current revision)](#hardware-notes-current-revision)
- [1. Introduction](#1-introduction)
- [2. Technical Specification](#2-rgb-621-r1--technical-specification)
- [3. Use Cases](#3-use-cases)
- [4. Safety Information](#4-safety-information)
- [5. Installation & Quick Start](#5-installation--quick-start)
- [6. Modbus RTU Communication](#6-modbus-rtu-communication)
- [7. ESPHome Integration Guide](#7-esphome-integration-guide)
- [8. Firmware & Programming](#8-firmware--programming)
- [9. Maintenance & Troubleshooting](#9-maintenance--troubleshooting)
- [10. Open Source & Licensing](#10-open-source--licensing)
- [11. Downloads](#11-downloads)
- [12. Support](#12-support)
- [Compliance & Certifications](#compliance--certifications)

> **v0.1.0 and v0.2.0 are deprecated — use v0.3.0.** Both remain available for existing installs but are no longer maintained.

## Quick Start

New modules ship firmware **v0.3.0**. Add the ESPHome package to your **MicroPLC** / **MiniPLC** — see [§7 ESPHome Integration](#7-esphome-integration-guide) for the ready-to-copy YAML. Give each module a **unique Modbus address** (default **3**).

## Version History

| Version | Config path (`path:`) | Date | Changes |
|---|---|---|---|
| **v0.3.0** | `RGB-621-R1/Firmware/v0.3.0/default_rgb_621_r1_plc/default_rgb_621_r1_plc.yaml` | 2026-09 | **Current.** Fixes HA state feedback: STATE@26–28 now reports target levels instead of mid-fade values, adds flags bit4 FADING, corrects light-state reconstruction in the ESPHome package, rounds the 8-bit↔12-bit conversion. |
| **v0.2.0** | `RGB-621-R1/Firmware/v0.2.0/default_rgb_621_r1_plc/default_rgb_621_r1_plc.yaml` | 2026-07 | Legacy. Local input engine (momentary/maintained, multi-click, hold-to-dim), 12-bit PWM + gamma + slew, scenes, relay FOLLOW, HA STATE readback; Modbus engine-config removed (config is USB WebConfig only). |
| **v0.1.0** | `RGB-621-R1/Firmware/v0.1.0/default_rgb_621_r1_plc/default_rgb_621_r1_plc.yaml` | 2026-01 | Deprecated (legacy) — superseded by v0.2.0. Kept for existing installs; no longer maintained. |

> **Reproducible firmware build (v0.3.0):** [Build environment (reproducible)](../README.md#build-environment-reproducible) · [`sketch.yaml`](Firmware/v0.3.0/default_rgb_621_r1/sketch.yaml)

> **Documentation note (current board revision):** earlier documentation quoted
> 5 A total and ≤ 1000 mA per channel. Both figures belong to a superseded
> board revision and no longer apply. The current limit is 10 A, shared.

> **Hardware note (R1):** the LED PS input has no reverse-polarity protection.
> The ideal-diode stage shown in earlier documentation is not fitted. The 24 V
> logic input is unaffected and retains its own reverse-polarity protection.

# Hardware notes (current revision)

1. **I.1/I.2 panel indicators swapped** — silkscreen only (I.1 shows DI2's state, I.2 shows DI1's); logical inputs, Modbus registers, and WebConfig are unaffected.
2. **Only SW2 is a usable logic input** (Button 1 in WebConfig); the second front button is not a user input — it enters BOOT mode only (see [§8.1](#81-updating-firmware-regular-users)).

# 1. Introduction

## 1.1 Overview of the RGB-621-R1

The **RGB-621-R1** is an **RGB + tunable-white (CCT)** LED controller with **5 PWM channels**, **12-bit + gamma-corrected dimming**, a relay, and **2 digital inputs**, plus an on-module scene/gesture engine that keeps working offline. An **RP2350** drives **RS-485 Modbus RTU** and **USB-C WebConfig**; use it with MiniPLC/MicroPLC packages or as a Modbus slave on any master.

---

## Key advantages

- **RGB + tunable white (CCT)** on **5 PWM channels** with **12-bit + gamma-corrected dimming**, plus a relay and **2 inputs**, with an on-module scene/gesture engine.
- Native ESPHome API via the MiniPLC/MicroPLC controller — no MQTT broker, no manual Modbus register mapping for the package entities.
- Local-first / edge-resilient — onboard logic keeps working if the network or Home Assistant is down.
- Open hardware (**CERN-OHL-W v2**) and firmware (**MIT**) — repairable, reproducible, no vendor lock-in.
- Standard **RS-485 Modbus RTU** — works with any Modbus master or industrial HMI/SCADA system, not locked to HomeMaster.
- Driverless **USB-C WebConfig** (Chrome, Edge, Opera); configuration persists in on-device flash (**LittleFS**).

## 1.2 Features & Architecture

| Subsystem | Qty | Description |
|---|-----|---|
| **Digital Inputs** | 2 | IEC 61131-2 compliant 24 V digital inputs (ISO1212 front-end), **dry-contact (module-wetted)**, with PTC fuse, TVS surge and reverse-polarity protection |
| **PWM Outputs** | 5 | N-channel MOSFET drivers (AP9990GH-HF), 12 V / 24 V LED channels for R / G / B / CW / WW |
| **Relay Output** | 1 | SPST-NO relay (HF115F/005-1ZS3), 5 V coil; 3 A @ 250 VAC / 30 VDC (module/PCB limit) |
| **Buttons** | 2 | Local control or configuration triggers (SW1 / SW2) |
| **LED Indicators** | 8 | PWR, TX, RX, I.1, I.2, O.1, and two user LEDs (LED1/LED2) |
| **Modbus RTU** | Yes | RS-485 via MAX485CSA+T (non-isolated; see [RS-485 / Modbus RTU](#rs-485--modbus-rtu)) |
| **USB-C** | Yes | WebConfig & firmware flashing with PRTR5V0U2X ESD protection |
| **Power Input** | 24 V DC ±10 % (SELV/PELV) | Protected by resettable fuses (1206L series), TVS (SMBJ33A), and reverse-blocking (STPS340U) |
| **Logic Supply** | — | AP64501SP-13 buck (5 V) + AMS1117-3.3 LDO chain |
| **MCU** | RP2350A | Dual-core Arm Cortex-M33 @ 133 MHz with 32 Mbit QSPI Flash (W25Q32JVUUIQ) |
| **Protection** | — | Digital-input front-end per IEC 61131-2 (ISO1212); surge/EMI protected; TVS diodes, PTC fuses, transient suppression on field I/O |

**Architecture summary:**  
- **MCU Board:** manages logic, USB, Modbus, and power regulation  
- **Field Board:** contains LED drivers, relay circuit, and digital input section  
This modular, two-board design ensures clean signal separation between logic and 24 V field wiring, improving reliability in mixed-voltage installations.

---

## 1.3 System Role & Communication

The **RGB-621-R1** operates as a **Modbus RTU slave** on an **RS-485 differential bus**, typically polled by a **HomeMaster controller** (MicroPLC / MiniPLC) or other Modbus master.  
Each module on the bus must have a **unique** Modbus address (default **3**); change it in WebConfig to avoid collisions. Up to 32 devices per bus are supported.

**Default communication parameters:**  
- **Address:** 3  
- **Baud rate:** 19200 bps  
- **Format:** 8 data bits, no parity, 1 stop bit (8N1)  
- **Bus termination:** external 120 Ω at both physical bus ends (not on the module)  
- **Fail-safe:** retains last valid PWM and relay state if communication is lost  

The controller periodically polls holding registers to:  
- Write PWM duty values for R, G, B, CW, WW channels  
- Control the relay output  
- Read digital input and status bits  

WebConfig enables users to modify address, baud rate, test I/O, calibrate channels, and perform real-time diagnostics — simplifying setup and commissioning.

---

# 2. RGB-621-R1 — Technical Specification

## 2.1 Diagrams & Pinouts

| System Block | RP2350A Pinout | Field Board | MCU Board |
|:---:|:---:|:---:|:---:|
|  |  |  |  |

---

## 2.2 Overview

See [§1.2 Features & Architecture](#12-features--architecture) for the subsystem overview.

---

## 2.3 I/O Summary

I/O counts only — full descriptions in [§1.2](#12-features--architecture).

| Interface | Qty |
|---|-----|
| **Digital Inputs** | 2 |
| **Relay** | 1 |
| **PWM Outputs** | 5 |
| **RS-485 (Modbus)** | 1 |
| **USB-C** | 1 |
| **MCU** | 1 |
| **Buttons** | 2 |
| **LED Indicators** | 8 |

---

## 2.4 Terminals & Pinout

<!-- hm:terminal-map:begin -->

**Top row** (LED PS | 24Vdc | RELAY | DI 24Vdc)

| Pos | Label | Group | Function |
|-----|---|---|---|
| 1 | + | LED_PS | LED PSU positive (12 or 24 V) |
| 2 | - | LED_PS | LED PSU negative |
| 3 | V+ | POWER | 24 V DC input |
| 4 | 0V | POWER | 24 V DC return |
| 5 | NO | RELAY | Relay normally open |
| 6 | C | RELAY | Relay common |
| 7 | I1 | DI | Input 1 |
| 8 | GND | DI | Input return |
| 9 | I2 | DI | Input 2 |

**Bottom row** (LED | RS-485)

| Pos | Label | Group | Function |
|-----|---|---|---|
| 1 | + | LED_OUT | Common anode for all channels |
| 2 | R | LED_OUT | Red channel |
| 3 | G | LED_OUT | Green channel |
| 4 | B | LED_OUT | Blue channel |
| 5 | CW | LED_OUT | Cool white channel |
| 6 | WW | LED_OUT | Warm white channel |
| 7 | COM | RS485 | RS-485 signal reference |
| 8 | A | RS485 | RS-485 data + |
| 9 | B | RS485 | RS-485 data - |

**Ports & service interfaces**

| Id | Type | Note |
|----|---|---|
| USB-C |  | USB-C is for WebConfig setup and firmware update. It may be connected at any time, including while the module is powered from its 24 V supply. Not a field power or data bus. |

**Housing notes**

- Relay is SPST-NO. There is no NC terminal - this is not an SPDT equivalent.
- LED channels are labelled R G B CW WW, not CH1..CH5.
- Common anode: one + terminal shared by all five channels.
- The LED strip needs its own PSU on LED PS. The module supply cannot power it.

<!-- hm:terminal-map:end -->
Front Terminals

**Top:** V+/0 V (24 V DC input), Relay C / NO, Inputs I1/I2 (+ GND)  
**Bottom:** PWM R/G/B/CW/WW, **COM (LED+)**, RS-485 A/B/COM

---

## 2.5 Electrical & Environmental

<!-- hm:specs:start -->
| Specification | Details |
|---|---|
| Microcontroller | RP2350A dual-core microcontroller |
| Storage | External QSPI Flash (32 Mbit) |
| Power Input | 24 V DC nominal |
| Input Protection (24 V logic) | 1 A fuse, reverse polarity diode (STPS340U), TVS surge suppression, EMI filtering |
| LED PS input protection | 10 A fuse; TVS surge suppression. **No reverse-polarity protection on this input** — see the warning in §5. |
| Main Logic Supply | Buck regulator 24 V → 5 V, 3.3 V LDO regulator |
| Document revision | DS-RGB-621-R1 Rev. B · 2026-09 · Hardware R1 (V1.0) |
| LED Outputs | 5 × low-side MOSFET outputs (AP9990GH-HF: R, G, B, CW, WW) |
| LED Output Voltage | External 12–24 V DC supply |
| Maximum Total LED Current | 10 A, shared across all channels in use (10 A fuse on LED PS input) |
| Any single PWM channel | 10 A — same shared budget as the module; no per-channel ceiling below 10 A |
| Relay outputs | 1 × relay, NO and C only (SPST-NO); 3 A @ 250 VAC (module limit) |
| Digital Inputs | 2 × IEC 61131-2 compliant 24 V digital inputs (ISO1212 input receiver, module-wetted; not isolated); per-channel PTC fuse, TVS, reverse-polarity protection |
| User Interface | 2 buttons, 8 LEDs (power, 2 user, RX, TX, 1× relay, 2× DI) |
| RS-485 | half-duplex Modbus RTU, not galvanically isolated |
| USB | USB-C, 5 V logic, ESD protected |
| Typical Power Consumption | 1.85 W typical / 3.0 W maximum (no LED load) |
| Modbus defaults | Address 3, 19200 baud, 8N1 |
| Operating temperature | 0 °C to +40 °C |
| Storage temperature | −10 °C to +55 °C |
| Relative humidity | 0–90 % RH, non-condensing |
| Ingress protection | IP20 (inside cabinet only) |
| Installation | Indoor control cabinet only; not for outdoor or exposed installation |
| Maximum altitude | 2000 m |
| Pollution degree | 2 |
| Dimensions | 52.5 × 90.6 × 67.3 mm (L × W × H) |
| DIN width | 3 modules (≈ 52.5 mm) |
| Mounting | 35 mm DIN rail |
| Enclosure | PC/ABS industrial enclosure |
| Terminal type | Pluggable screw terminal blocks DB129V-5.08 / DB129R-5.08, 5.08 mm pitch |
| Wire cross-section | 0.2–2.5 mm² (AWG 24–12) |
| Tightening torque | 0.4–0.6 Nm |
| Net weight | 150 g |
| Gross weight | 240 g |
| Pack size | 140 × 125 × 94 mm (L × W × H) |
<!-- hm:specs:end -->

## 2.6 MCU, Protections & Build

- **MCU:** Raspberry Pi RP2350A dual-core M33  
- **Storage:** W25Q32 32 Mbit Flash  
- **Protections:** PTC fuses, TVS diodes, reverse polarity & ESD networks  
- **Relay contacts:** 275 V rms metal-oxide varistor across each contact pair. Not suitable for the elevated open-contact voltage of directly connected capacitor motors — see §4.3.  
- **Mounting:** DIN-rail EN 50022 (35 mm), IP20 enclosure  
- **Dimensions:** 52.5 × 90.6 × 67.3 mm · Net weight 150 g
- **DIN width:** 3 modules (≈ 52.5 mm)

Dimensions

*Mechanical drawing: front and side view, dimensions in mm*

---

## 2.7 Absolute Ratings

| Parameter | Min | Typ | Max | Notes |
|---|-----|-----|-----|---|
| Supply Voltage | 21.6 V | 24 V | 26.4 V | 24 V DC ±10 % (SELV/PELV); input protected |
| Power Use | — | 1.85 W | 3.0 W | No LED load |
| Relay Contacts | — | — | 3 A @ 250 VAC / 30 VDC | Module/PCB limit (resistive) |
| LED PS input (module total) | — | — | 10 A | Separate 12/24 V LED supply, fused at 10 A. Strip load depends on length and W/m (not fixed by the module). |
| Any single PWM channel | — | — | 10 A | Same limit as the module: no channel-specific ceiling below the shared 10 A budget. |
| RS-485 Rate | — | — | 115.2 kbps | Half-duplex |
| USB Voltage | 4.75 V | 5 V | 5.25 V | Logic only |
| Operating Temp | 0 °C | — | 40 °C | 0–90 % RH |

> **Installer Tip:** Use upstream fusing and snubbers for inductive loads.

---

## 2.8 Firmware & Operation

Modbus RTU slave; configured via USB-C WebConfig. Registers/coils control PWM and relay and read inputs — see [§6 Modbus](#6-modbus-rtu-communication). Front-panel LEDs — see [§9.1](#91-status-leds-front-panel).

---

# 3. Use Cases

The RGB-621-R1 is a 5-channel RGB + tunable-white (CCT) LED controller with two wall-switch inputs,
one relay, and an on-module control engine — it runs standalone or as a Modbus RTU / Home Assistant
node. I/O: 5 PWM channels (R, G, B, WW, CW), 2 digital inputs, 1 SPST-NO relay.

### Use Case 1 — Standalone wall-switch dimming, color and scenes (no controller)
Drive an RGB or RGB+CCT strip directly from one or two momentary wall buttons, all logic on the
module: short-press toggles a group, press-and-hold ramps brightness smoothly (hold-to-dim over a
configurable time), double-press jumps to full or recalls one of four on-module scenes. DI1 handles
the RGB group, DI2 the warm/cool (CCT) group by default — fully configurable in WebConfig. Works
with the bus and Home Assistant offline.

### Use Case 2 — Relay as automatic LED-PSU power-cut (energy saving)
Set the onboard relay to **FOLLOW** mode and wire **Relay C / NO** **externally in series** with the LED driver supply (+): the relay closes while any watched channel is on and opens after an off-delay once everything is dark — no standby draw or driver heating. The module does **not** switch the **COM (LED+)** rail internally; FOLLOW only drives the separate dry-contact output. Or use the relay in **Manual** mode as a free switched output driven by a gesture, Modbus, or Home Assistant.
Module output is 3 A @ 250 VAC (PCB limit); use an interposing contactor for larger loads.

### Use Case 3 — Full Home Assistant integration with live state
Add the ESPHome package (see [§7](#7-esphome-integration-guide)) to a MicroPLC/MiniPLC and the strip appears in Home
Assistant as an RGB+CCT light with the relay as a switch. Control color, brightness and CCT from HA
with 12-bit gamma-corrected, step-free dimming, while wall switches keep working locally; the module
reports its actual state back so HA stays in sync — and everything keeps working if the controller
or network goes down.

---

# 4. Safety Information

## 4.1 General Requirements

| Requirement | Detail |
|---|---|
| **Qualified Personnel** | Installation, wiring, and servicing must be performed by trained technicians familiar with 24 V DC SELV/PELV control systems and, where applicable, mains switching on relay contacts per local regulations. |
| **Power Isolation** | Always disconnect the **24 V DC module supply**, **LED PSU**, and RS-485 network before wiring or servicing. |
| **Rated Voltages** | **Mains (230 VAC)** may be switched **only** on **Relay C / NO** (≤ **3 A**), by qualified personnel per local regulations — enclosure, SELV/mains separation, load fuse/breaker, strain relief. **All other terminals** (V+/0V, I1/I2, RS-485 A/B/**RS-485 COM**, **LED PS**, USB-C) are SELV/PELV — **never** apply mains to them. Module and LED supply: see [⚠️ IMPORTANT — POWER](#important-power) in [§5](#5-installation--quick-start). |
| **Power** | See [⚠️ IMPORTANT — POWER](#important-power) in [§5](#5-installation--quick-start). |
| **Grounding** | Ensure proper protective-earth (PE) connection of the control cabinet and shielded bus cable. |
| **Enclosure** | Mount the device on a DIN rail inside a dry, clean enclosure. Avoid condensation, dust, or corrosive atmosphere. |

---

## 4.2 Installation Practices

Safety practices for qualified installers. Field wiring map: [§5.4](#54-installation--wiring). Power layout: [⚠️ IMPORTANT — POWER](#important-power) in [§5](#5-installation--quick-start).

- Mount on a **35 mm DIN rail (EN 60715)** inside a dry, clean enclosure ([§4.1](#41-general-requirements)).
- Provide at least **10 mm** clearance above/below for airflow and terminal access.
- **Disconnect** the **24 V DC module supply**, **LED PSU**, and RS-485 network before wiring or servicing.
- Route **LED-power wiring separately** from RS-485 and signal lines.
- **Do not** externally bridge `GND_FUSED` (field) and `GND` (logic/USB) — domains are separated on the PCB.
- Relay coil drive is isolated from contacts via **SFH6156 optocoupler** (**basic insulation**); the **ISO1212** digital-input receiver is module-wetted from the 24 V rail and is **not galvanically isolated**.
- For inductive relay loads, add an **external flyback diode or RC snubber**; keep relay conductors away from signal wiring.
- Follow local electrical codes for fusing, grounding, and enclosure class.

---

## 4.3 Interface Warnings

### Power Supply (24 V DC)

| Parameter | Specification |
|---|---|
| Nominal Voltage | 24 V DC ±10 % (SELV/PELV) |
| Input Protection | PTC fuses (F1–F4), reverse-polarity diode (STPS340U), surge TVS (SMBJ33A) |
| Ground Reference | Field return `GND_FUSED` |
| Front-end | IEC 61131-2 digital-input front-end (ISO1212); surge/EMI protected |
| Notes | Use a regulated SELV 24 V DC supply rated ≥ 1 A per module. |

---

### Digital Inputs

| Parameter | Specification |
|---|---|
| Type | IEC 61131-2 compliant, **dry-contact (module-wetted)** 24 V DC input |
| Circuit | ISO1212 receiver with TVS (SMBJ26CA) + PTC protection |
| Input voltage | 24 V DC ±10 % (SELV/PELV) — supplied by module wetting; do not apply external voltage to I1/I2 |
| Protection | PTC fuse, TVS surge and reverse-polarity protection |
| Notes | Connect **potential-free (dry) contacts** — wall switches, push buttons, or relay / open-collector / transistor outputs that simply close I1/I2 to **GND**. The module supplies the input current (wetting) from its own 24 V rail; do **not** feed external voltage into I1/I2. Three-wire sensors must be powered from your own supply, with their switching output wired to the input (the module provides no sensor-supply rail). Debounce handled in firmware. |

---

### Relay Output

| Parameter | Specification |
|---|---|
| Type | SPST-NO mechanical relay (HF115F/005-1ZS3) |
| Coil Voltage | 5 V DC (via SFH6156 optocoupler + S8050 driver) |
| Contact Rating | 3 A @ 250 VAC / 30 VDC (module/PCB limit, resistive) |
| Insulation | Basic insulation between SELV coil drive and contacts; external contactor for reinforced isolation or heavy/inductive loads |
| Contact limit | **3 A @ 250 VAC** module limit. Use an external contactor for higher or inductive loads |
| Protection | External RC snubber / flyback diode recommended |
| Notes | Independent SPST-NO dry contact (**Relay C** / **NO**); not in the LED anode rail. For FOLLOW-mode LED-PSU cut, wire **Relay C / NO** externally in series with the LED driver supply. Keep field wiring separate from logic. |

> ⚠️ **Capacitor motors (roller shutters, blinds, awnings, gate and garage tubular
> motors) must NOT be connected directly to the relay outputs.** Each relay contact
> carries a 275 V arc-suppression varistor. While one direction runs, the motor's
> phase-shift capacitor raises the voltage across the open contact of the other
> direction above 330 V; the varistor conducts continuously and is destroyed within
> seconds, regardless of motor current. Drive such motors through an interposing
> relay or contactor with ≥ 400 V contacts and **no RC or varistor across the
> contacts**; the RGB-621-R1 relay switches the interposing relay coil only. Follow the
> motor manufacturer's rules: the same phase for UP and DOWN, never UP and DOWN
> simultaneously, direction change through OFF with a pause of at least 0.5 s.

---

### RS-485 / Modbus RTU

<!-- hm:rs485-order:begin -->
> **Terminal order differs across the HomeMaster range.**
> Always read the silkscreen - do not wire by habit from another module.
> On this module the order is **COM-A-B**.
> Swapping A and B damages nothing but the node will not communicate.
> COM is required on every node.
<!-- hm:rs485-order:end -->
All HomeMaster controllers and modules share the same RS-485 front end.

| Item | Value |
|---|---|
| Transceiver | MAX485CSA+T, half-duplex |
| Galvanic isolation | **None** — the transceiver shares the device's logic ground |
| Common-mode range | −7 V … +12 V referred to the device's own ground (MAX485 limit) |
| Terminals | A / B / COM |
| Surge protection | 3 × SMAJ6.8CA TVS (A–COM, B–COM, A–B) |
| Overcurrent | 2 × resettable PTC, 1.5 A hold, in series with A and B |
| EMI filtering | Common-mode choke on the A/B pair; COM referenced through 1 MΩ ∥ 4.7 nF |
| Idle state | Fail-safe biasing on board — do not add external bias resistors |
| Termination | 120 Ω at the two physical ends of the bus only |

**Bus wiring rules — apply to every device on the bus:**

- One twisted pair for A/B, 120 Ω characteristic impedance.
- Run **COM** to every node. Required, not optional: the ports are not isolated, and COM is what bounds the common-mode voltage the transceivers see.
- Prefer one power supply for the whole bus, distributed in star topology. With separate supplies, additionally tie the 0 V references together at a single point.
- Bond the cable shield to cabinet PE at one end only. Never land a shield on A, B or COM.
- Where the bus crosses into a different electrical installation with its own earthing reference — a utility or billing meter, another building, another cabinet's PE system — fit an external galvanic RS-485 isolator at that boundary. The on-board components are transient protection, not isolation, and will not survive a sustained ground-potential difference.

---

### USB-C Interface

| Parameter | Specification |
|---|---|
| Function | WebConfig setup & firmware update only |
| Protection | PRTR5V0U2X ESD + CG0603MLC-05E current limiters |
| Supply | 5 V DC from host computer (logic domain) |
| Isolation | Shares logic ground (`GND`); not isolated from RS-485 logic |
| Notes | USB-C is for WebConfig setup and firmware update. It may be connected at any time, including while the module is powered from its 24 V supply. Not a field power or data bus. |

---

> Power layout and two-supply rules: see [⚠️ IMPORTANT — POWER](#important-power) in [§5](#5-installation--quick-start). Mains switching rules: [§4.1](#41-general-requirements). Follow local electrical codes for fusing and grounding.

---

# 5. Installation & Quick Start

> ⚠️ **IMPORTANT — POWER**  
> Module logic/RS-485/inputs: regulated **24 V DC ±10 % SELV/PELV** on V+/0V (or shared 24 V bus, fused per branch). LED strip: a **separate 12 V or 24 V DC LED PSU** on **LED PS** (+/−), **10 A** per module. Size for strip length and W/m — the module does not imply a fixed strip wattage. **LED PS** = module terminal; **LED PSU** = external supply. Keep GND_FUSED (field) and GND (logic/USB) unbridged.
> **LED PS polarity is not protected.** Unlike the 24 V logic input, the LED PS input has no reverse-polarity protection. Reversing **+** and **−** on LED PS can destroy the channel outputs. Verify polarity before applying power.

## 5.1 What You Need

| Item | Description |
|---|---|
| **Module** | RGB-621-R1 LED control module |
| **Controller** | HomeMaster **MicroPLC** / **MiniPLC** or any **Modbus RTU master** |
| **Module PSU** | Regulated **24 V DC SELV/PELV** — see [⚠️ IMPORTANT — POWER](#important-power) |
| **LED PSU (separate)** | Regulated **12 V or 24 V DC** — see [⚠️ IMPORTANT — POWER](#important-power) |
| **Cables** | 1× **USB-C** cable (for setup), 1× **twisted-pair RS-485** cable |
| **Software** | Any browser that supports the **Web Serial API** (for WebConfig) |
| **Optional** | Shielded wiring for long RS-485 runs, DIN-rail enclosure, terminal labels |

---

## 5.2 Power

Power: see the [⚠️ IMPORTANT — POWER](#important-power) block in [§5](#5-installation--quick-start).

- **LED path (LED PS → COM (LED+)):** the positive rail from the external LED PSU enters through:
  - **10 A fuse** on the LED PS path — this is the module's design limit  
  - **No reverse-polarity protection.** The LED PS input is unprotected against reversed polarity; connecting the LED PSU backwards can destroy the channel outputs. Check polarity before powering up.  
  - **TVS surge suppression**  
  - Then feeds **COM (LED+)** directly — **not** through the onboard relay.

- **PWM outputs (R / G / B / CW / WW):** **low-side PWM sinks** (AP9990GH-HF, rated 75 A by package); strip must be **12/24 V common-anode**. No channel has a current ceiling of its own — the limits are the terminal blocks (DB129V-5.08 / DB129R-5.08, 5.08 mm pitch) and board heat dissipation, and the **10 A** LED PS fuse sits below both. Size strips by length and W/m.

- **Relay (Relay C / NO):** independent **SPST-NO dry-contact** rated **3 A @ 250 VAC / 30 VDC** (module/PCB limit); suitable for **230 VAC** loads when installed per [§4.1](#41-general-requirements). **Basic insulation** between SELV coil and contacts; external contactor for reinforced isolation or heavy/inductive loads. For **FOLLOW-mode** LED-PSU cut, wire **Relay C / NO** **externally in series** with the LED PSU (+) feed ([Use Case 2](#-use-case-2--relay-as-automatic-led-psu-power-cut-energy-saving)).

- **Current consumption (typical):**
  - Logic + RS-485: ≈ 100 mA  
  - Relay coil: ≈ 30 mA (active)  
  - LED load: dependent on connected strips (size LED PSU for strip length and W/m; LED PS ceiling **10 A**/module, shared across all channels in use)

- **Module input protection (V+ / 0V):** PTC fuses (F1–F4), reverse-polarity diode (STPS340U), surge TVS (SMBJ33A).

---

## 5.3 Communication

Bus hardware and wiring rules: [RS-485 / Modbus RTU](#rs-485--modbus-rtu).

**RS-485 Pinout (bottom connector):**

| Terminal | Signal | Description |
|---|---|---|
| **A** | RS-485 A (+) | Non-inverting line |
| **B** | RS-485 B (–) | Inverting line |
| **RS-485 COM** | Common reference | Required on every node (logic/field reference) |

**Default Modbus settings:**

- **Address:** 3 (each module on the bus must be unique — change in WebConfig to avoid collisions)
- **Baud rate:** 19200 bps
- **Data format:** 8 data bits, no parity, 1 stop bit (**8N1**)

**Configuration:** Connect via **USB-C** and open **WebConfig** in any browser that supports the **Web Serial API**. Set module address, baud rate, and optional relay/input parameters — changes apply immediately and are saved to flash automatically.

---

> ⚙️ **Quick Summary**
> 1. Mount the module on a DIN rail.  
> 2. Wire power per [⚠️ IMPORTANT — POWER](#important-power).  
> 3. Connect LED strips (common-anode to **COM (LED+)**, cathodes to R/G/B/CW/WW).  
> 4. Wire RS-485 A/B to the controller.  
> 5. Plug in USB-C, open WebConfig, assign address, set baudrate, test outputs.  
> 6. Verify Modbus communication over RS-485.

---

## 5.4 Installation & Wiring

Diagram-first wiring map. Power details: [§5.2](#52-power). RS-485: [§5.3](#53-communication). Power layout: [⚠️ IMPORTANT — POWER](#important-power).

### Power

Power supply wiring — module V+/0V and LED PS
*Wire **V+** / **0V** and **LED PS** (+/−) per [⚠️ IMPORTANT — POWER](#important-power); protection detail in [§5.2](#52-power).*

### LED outputs (5× PWM)

| RGB (3 colour) | RGB + CW |
|:---:|:---:|
| RGB LED strip wiring | RGB + Cool White wiring |
| *Strip **+** on **COM (LED+)**; cathodes on **R** / **G** / **B**.* | *Adds **CW** for RGB + cool-white mixes.* |

| Tunable white (CWWW) | Full RGBCCT (RGB + CCT) |
|:---:|:---:|
| CCT / tunable white wiring | Full RGBCCT wiring |
| ***CW** and **WW** only.* | *All five channels — native operating mode.* |

### Digital inputs

Digital inputs — dry-contact wiring to I1 and I2
*Potential-free (dry) contacts between **I1** / **I2** and **GND** — module supplies wetting current from its 24 V rail; do **not** apply external voltage to I1/I2. Three-wire sensors: power from your own supply, switching output to the input only. Shielded cable for runs > 10 m ([§5.2](#52-power) protection: PTC F5/F6, TVS, reverse diodes).*

### Relay

Relay output — NO and C to external load
*External load on **Relay C** / **NO** — independent of **COM (LED+)**; FOLLOW PSU cut: external series wiring ([Use Case 2](#-use-case-2--relay-as-automatic-led-psu-power-cut-energy-saving), [§5.2](#52-power)). Capacitor motors: see §4.3.*

### RS-485 (Modbus RTU)

RS-485 A/B/COM Modbus RTU wiring
***A** / **B** / **RS-485 COM** — daisy-chain to controller; COM required on every node — see [RS-485 / Modbus RTU](#rs-485--modbus-rtu).*

### USB-C

*WebConfig and firmware only — may be connected at any time; not a field power or data bus.*

## 5.5 Software & UI Configuration

Configure over USB-C in a browser with **Web Serial API** support: open [https://config.home-master.eu/RGB-621-R1/Firmware/v0.3.0/ConfigToolPage.html](https://config.home-master.eu/RGB-621-R1/Firmware/v0.3.0/ConfigToolPage.html), click **Connect**, pick the module's port. Changes apply live and save to flash.

### 1) Connection, light levels & presets



| Setting | What it does | Set to |
|---|---|---|
| Modbus Address | RS-485 bus ID; unique per module | 1–247 (default 3); values outside 1–247 are silently clamped |
| Baud Rate | Must match controller/bus | 9600/19200/38400/57600/115200 (default 19200) |
| Serial Log | USB diagnostics stream | — |
| Light Levels (R/G/B/WW/CW) | Live 0–255 sliders; test strip without a controller | any level for commissioning |
| Quick presets | OFF / WHITE / RGB / FULL test patterns | verify wiring |

### 2) Wall-switch inputs & onboard button



| Setting | What it does | Set to |
|---|---|---|
| Enabled (per DI) | turns the input on/off | on to use |
| Inverted (per DI) | flips contact sense | as wired |
| Child lock (per DI) | blocks local control (auto-unlocks when Modbus link is offline) | off normally |
| Mode | Momentary (gestures) or Maintained (closed=ON/open=OFF) | per switch |
| Output target | what the input drives | Group RGB / Group CCT / RGB+CCT / Relay1 / All |
| Single / Double / Hold actions | action per gesture | None, Toggle, On, Off, Dim up, Dim down, Dim toggle dir, Relay pulse, Scene 1–4, Identify |
| Onboard button SW2 (Enabled + Single/Double) | usable front button actions | e.g. Double = Identify |
| Engine timings | press detection | Debounce 25 · Double-click 350 · Hold start 650 · Hold repeat 60 ms |
| Allow wall switches when offline | keep local control if the bus drops | on (recommended) |

### 3) PWM channels — Red/Green/Blue/Warm White/Cool White



| Setting | What it does | Set to |
|---|---|---|
| Min trim | per-channel floor (fix low-end flicker) | 0–255 (default 1) |
| Max trim | per-channel ceiling (cap brightness) | 0–255 (default 255) |
| Transition, ms | fade smoothing on level change | default 400 |
| Power-on | channel state at power-up | OFF at power-on / ON at power-on / Restore last |

### 4) Dimming & scenes



| Setting | What it does | Set to |
|---|---|---|
| Dimming time (ms, full range) | hold ramp 0→100 % | default 3000 |
| Scenes 1–4 (per-channel R/G/B/WW/CW) | stored presets | set levels; **Capture current** saves live values |

### 5) Relay, user LEDs & output quality



| Setting | What it does | Set to |
|---|---|---|
| Relay Power-on state | relay position at power-up | OFF at power-on / ON at power-on / Restore last |
| Relay mode | Manual (free output) or Follow (LED-PSU cut) | per use |
| Follow channels | groups watched in Follow mode | RGB only / CCT only / both |
| Off delay (seconds) | delay before cutting after all dark | default 45 |
| User LED1 / LED2 — Mode | how each LED behaves | per preference |
| User LED1 / LED2 — Source | what each LED reflects | per preference |
| Gamma correction (enable) | perceptual dimming curve on/off | on (recommended) |
| Gamma (×10) | curve value | 22 (= 2.2) |

## 5.6 Getting Started

Follow these steps for a first-time install (field wiring detail: [§5.4](#54-installation--wiring); Home Assistant integration: [§7](#7-esphome-integration-guide)).

1. Mount on a **35 mm DIN rail**; wire power per [⚠️ IMPORTANT — POWER](#important-power); connect a **common-anode** strip (strip **+** to **COM (LED+)**, cathodes to **R** / **G** / **B** / **CW** / **WW**).
2. Connect **RS-485** **A** / **B** / **RS-485 COM** to the controller (**MicroPLC** / **MiniPLC**).
3. Plug **USB-C** into a PC; open the **WebConfig** tool in a browser with **Web Serial API** support and click **Connect**.
4. In WebConfig, give the module a **unique Modbus address** — every module on the same RS-485 bus must have a different one (factory default is **3**). Check the **baud rate** matches your controller (default **19200**). Changes apply immediately and are saved to flash automatically.
5. Optionally assign **DI1** / **DI2** wall-switch actions; test the light from WebConfig.
6. Add the [§7 ESPHome](#7-esphome-integration-guide) package to the controller with the matching `rgb_address`.
7. The light and relay appear in **Home Assistant**.

---

# 6. Modbus RTU Communication

The RGB‑621‑R1 communicates as a **Modbus RTU slave** over **RS‑485**. Register map matches `default_rgb_621_r1_plc.yaml` (v0.3.0) and firmware v0.3.0.

**Defaults:** Address **3**, **19200 8N1** (change in WebConfig).

---

## 6.0 Register Map (complete)

> **Addressing convention:** all addresses in this document are zero-based Modbus PDU offsets. Do not add 1, and do not use 0xxxx/1xxxx/3xxxx/4xxxx notation.
>
> Example: PWM Red = holding register offset **400** → FC06 request address `0x0190`. In tools that use one-based register numbering, enter **401**.

Master reference for firmware **v0.3.0** (`MAP_VERSION` **3**). Per-function-code detail in [§6.1](#61-input-registers-fc04--map_version-3)–[§6.3](#63-holding-registers-fc0306). Gesture/scene/trim/relay-mode/gamma configuration is **USB WebConfig only** — not on Modbus.

> **PWM dual bank:** HR **400–404** (8-bit) and HR **410–414** (12-bit) address the same PWM targets. The last successful write wins. HR 400–404 scales as `hi = (value × 4095 + 127) / 255` (rounded); the 8-bit read-back is `api = (hi × 255 + 2047) / 4095`. HR 410–414 sets the 12-bit target directly. Values above the register maximum are clamped (writing 300 to HR 400 yields 255; writing 5000 to HR 410 yields 4095). The module does not return exception code 03.

| Register / Address | Name | FC / Access | Type | Units / Range | Default | Effect | Firmware |
|---|---|---|---|---|---|---|---|
| **1** | **DI1** | FC02 R | discrete input | 0 / 1 | 0 | Wall-switch logical state (after enable + invert) | v0.3.0 |
| **2** | **DI2** | FC02 R | discrete input | 0 / 1 | 0 | Wall-switch logical state (after enable + invert) | v0.3.0 |
| **60** | **Relay1** | FC02 R | discrete input | 0 / 1 | 0 | Relay logical state | v0.3.0 |
| **90** | **LED1** | FC02 R | discrete input | 0 / 1 | 0 | User LED1 logical state | v0.3.0 |
| **91** | **LED2** | FC02 R | discrete input | 0 / 1 | 0 | User LED2 logical state | v0.3.0 |
| **0** | **DI_STATE_MASK** | FC04 R | input register | bit0..1 | — | DI1..DI2 bitmask | v0.3.0 |
| **1** | **RLY_STATE_MASK** | FC04 R | input register | bit0 | — | Relay1 logical state | v0.3.0 |
| **2** | **BTN_STATE_MASK** | FC04 R | input register | bit0 | — | SW2 onboard button | v0.3.0 |
| **3** | **LED_STATE_MASK** | FC04 R | input register | bit0..1 | — | LED1..LED2 bitmask | v0.3.0 |
| **4** | **STATUS_FLAGS** | FC04 R | input register | bitfield | — | Link / config status — see [STATUS_FLAGS](#status_flags-ireg-4) | v0.3.0 |
| **6–20** | **EVT_COUNTERS** | FC04 R | input register | uint16 | 0 | Press counters — see [event counters](#event-counters-ireg-620) | v0.3.0 |
| **21** | **PWM_RAW R** | FC04 R | input register | 0–4095 | 0 | Applied 12-bit PWM duty after trim, gamma and slew (not measured LED current) | v0.3.0 |
| **22** | **PWM_RAW G** | FC04 R | input register | 0–4095 | 0 | Applied 12-bit PWM duty after trim, gamma and slew (not measured LED current) | v0.3.0 |
| **23** | **PWM_RAW B** | FC04 R | input register | 0–4095 | 0 | Applied 12-bit PWM duty after trim, gamma and slew (not measured LED current) | v0.3.0 |
| **24** | **PWM_RAW WW** | FC04 R | input register | 0–4095 | 0 | Applied 12-bit PWM duty after trim, gamma and slew (not measured LED current) | v0.3.0 |
| **25** | **PWM_RAW CW** | FC04 R | input register | 0–4095 | 0 | Applied 12-bit PWM duty after trim, gamma and slew (not measured LED current) | v0.3.0 |
| **26** | **STATE RG** | FC04 R | input register | packed | — | Target R (high byte) + G (low byte), API 0–255 | v0.3.0 |
| **27** | **STATE BWW** | FC04 R | input register | packed | — | Target B (high byte) + WW (low byte), API 0–255 | v0.3.0 |
| **28** | **STATE CW+flags** | FC04 R | input register | packed | — | Target CW (high byte); flags: anyOn, rgbGroupOn, cctGroupOn, relay1, fading | v0.3.0 |
| **0** | **Relay1** | FC01 R / FC05 W | coil | 0 / 1 | 0 | Relay1 — level-controlled coil: write `1` = energize, write `0` = de-energize | v0.3.0 |
| **5** | **IDENTIFY** | FC05 W | coil (pulse) | write 1 | 0 | LED identify blink | v0.3.0 |
| **6** | **SAVE_CFG** | FC05 W | coil (pulse) | write 1 | 0 | Save config to flash | v0.3.0 |
| **7** | **REBOOT** | FC05 W | coil (pulse) | write 1 | 0 | Reboot module | v0.3.0 |
| **200** | **Relay1 ON** | FC05 W | coil (pulse) | write 1 | 0 | Legacy pulse — energize relay | v0.3.0 |
| **210** | **Relay1 OFF** | FC05 W | coil (pulse) | write 1 | 0 | Legacy pulse — de-energize relay | v0.3.0 |
| **300** | **DI1 Enable** | FC05 W | coil (pulse) | write 1 | 0 | Enable DI1 | v0.3.0 |
| **301** | **DI2 Enable** | FC05 W | coil (pulse) | write 1 | 0 | Enable DI2 | v0.3.0 |
| **320** | **DI1 Disable** | FC05 W | coil (pulse) | write 1 | 0 | Disable DI1 | v0.3.0 |
| **321** | **DI2 Disable** | FC05 W | coil (pulse) | write 1 | 0 | Disable DI2 | v0.3.0 |
| **400** | **R** | FC03 R / FC06 W | holding | 0–255 | 0 | Red PWM setpoint (8-bit API; slew-smoothed) | v0.3.0 |
| **401** | **G** | FC03 R / FC06 W | holding | 0–255 | 0 | Green PWM setpoint | v0.3.0 |
| **402** | **B** | FC03 R / FC06 W | holding | 0–255 | 0 | Blue PWM setpoint | v0.3.0 |
| **403** | **WW** | FC03 R / FC06 W | holding | 0–255 | 0 | Warm-white PWM setpoint | v0.3.0 |
| **404** | **CW** | FC03 R / FC06 W | holding | 0–255 | 0 | Cool-white PWM setpoint | v0.3.0 |
| **410** | **R (12-bit)** | FC03 R / FC06 W | holding | 0–4095 | 0 | Red fine PWM setpoint | v0.3.0 |
| **411** | **G (12-bit)** | FC03 R / FC06 W | holding | 0–4095 | 0 | Green fine PWM setpoint | v0.3.0 |
| **412** | **B (12-bit)** | FC03 R / FC06 W | holding | 0–4095 | 0 | Blue fine PWM setpoint | v0.3.0 |
| **413** | **WW (12-bit)** | FC03 R / FC06 W | holding | 0–4095 | 0 | Warm-white fine PWM setpoint | v0.3.0 |
| **414** | **CW (12-bit)** | FC03 R / FC06 W | holding | 0–4095 | 0 | Cool-white fine PWM setpoint | v0.3.0 |
| **480** | **MB_ADDR** | FC03 R / FC06 W | holding | 1–247 | **3** | Modbus slave address | v0.3.0 |
| **481** | **MB_BAUD** | FC03 R / FC06 W | holding | 9600 / 19200 / 38400 / 57600 / 115200 | **19200** | Modbus baud rate (bps) | v0.3.0 |

---

## 6.1 Input Registers (FC04) — MAP_VERSION 3

> Summary: see [§6.0](#60-register-map-complete). Detail below.

| Address | Name | Bits | Description |
|---|---|---|---|
| **0** | **DI_STATE_MASK** | bit0..1 | DI1..DI2 |
| **1** | **RLY_STATE_MASK** | bit0 | Relay1 logical state |
| **2** | **BTN_STATE_MASK** | bit0 | SW2 onboard button (GPIO1) |
| **3** | **LED_STATE_MASK** | bit0..1 | LED1..LED2 |
| **4** | **STATUS_FLAGS** | bitfield | Link / config status — see below |
| **6–20** | **EVT_COUNTERS** | uint16 | Press counters — see below |
| **21–25** | **PWM_RAW** | 0–4095 | Applied 12-bit PWM duty after trim, gamma and slew. This is not a measured LED current. |
| **26–28** | **STATE** | packed | Target PWM levels (API 0–255, not mid-fade) + status flags |

#### STATUS_FLAGS (IREG 4) {#status_flags-ireg-4}

| Bit | Name | Meaning |
|-----|---|---|
| 0 | Reserved | Always 0 |
| 1 | linkOk | Modbus link considered alive (see below) |
| 2 | Reserved | Always 0 |
| 3 | cfgDirty | Unsaved configuration changes in RAM |
| 4–15 | Reserved | Always 0; masters must ignore |

**linkOk** is set while less than **5000 ms** have elapsed since the last observed RS-485 activity. Activity means either bytes received on the RS-485 port, or a change to any of the watched coils (0, 5, 6, 7, 200, 210, 300, 301, 320, 321). It is not a carrier detect and does not require a valid, correctly addressed request.

#### Event counters (IREG 6–20) {#event-counters-ireg-620}

| Address | Counter |
|---|---|
| **6** | DI1 Single |
| **7** | DI1 Double |
| **8** | DI1 Triple |
| **9** | DI1 Long |
| **10** | DI1 Hold |
| **11** | DI2 Single |
| **12** | DI2 Double |
| **13** | DI2 Triple |
| **14** | DI2 Long |
| **15** | DI2 Hold |
| **16** | SW2 Single |
| **17** | SW2 Double |
| **18** | SW2 Triple |
| **19** | SW2 Long |
| **20** | SW2 Hold |

Counters saturate at **65535** and do not wrap (`if (count < 0xFFFF) count++`). They are held in RAM, start at **0** after every power-up or reboot, and cannot be cleared over Modbus. Long-press was removed in v0.2.0, so the **Long** counters (**9**, **14**, **19**) always read **0**.

**STATE block (IREG 26–28)** — one FC04 read for HA feedback:

| Address | Format | Description |
|---|---|---|
| **26** | `(R<<8)\|G` | Target red (high byte) and green (low byte), API 0–255 |
| **27** | `(B<<8)\|WW` | Target blue and warm white |
| **28** | `(CW<<8)\|flags` | Target cold white (high byte); flags low byte: bit0 **anyOn**, bit1 **rgbGroupOn**, bit2 **cctGroupOn**, bit3 **relay1**, bit4 **fading** (any channel still slewing) |

Sources: **0** = DI1, **1** = DI2, **2** = SW2. Layout: `EVT_BASE + source×5 + gesture` (`EVT_BASE` = **6**).

> ESPHome package reads **FC04 @0 count=5** (DI/LED/status) and **FC04 @26 count=3** (target light + relay/fading flags) every 5 s. Event counters **6–20** are optional for masters that need register-based press accounting. IREG **21–25** remain the mid-fade 12-bit diagnostic.

---

## 6.2 Coils (FC01/05)

> Summary: see [§6.0](#60-register-map-complete). Detail below.

| Address | Name | Description |
|---|---|---|
| **0** | **Relay1** | Level-controlled coil: write `1` = energize, write `0` = de-energize. If the relay is disabled in WebConfig, the module forces it off and resets this coil to **0**; writes are ignored. |
| **5** | **IDENTIFY** | Pulse — LED identify blink |
| **6** | **SAVE_CFG** | Pulse — save config to flash |
| **7** | **REBOOT** | Pulse — reboot module |
| **200** | **Relay1 ON** | Legacy pulse coil — write `1` to energize |
| **210** | **Relay1 OFF** | Legacy pulse coil — write `1` to de-energize |
| **300–301** | **DI1–DI2 Enable** | Pulse per input |
| **320–321** | **DI1–DI2 Disable** | Pulse per input |

Pulse coils are write-one commands. Writing `1` executes the command once; writing `0` has no effect. They are not latched and always read back as `0`.

> Relay coil **0** is the primary control path (ESPHome template switch). Pulse coils **200/210** remain for legacy tools. Service coils: write-only from ESPHome (`assumed_state`).

---

## 6.2.1 Discrete Inputs (FC02)

> Summary: see [§6.0](#60-register-map-complete). Detail below.

| Address | Name | Description |
|---|---|---|
| **1–2** | **DI1–DI2** | Wall-switch logical state (after enable + invert) |
| **60** | **Relay1** | Relay logical state |
| **90–91** | **LED1–LED2** | User LED logical state |

---

## 6.3 Holding Registers (FC03/06)

> Summary: see [§6.0](#60-register-map-complete). Detail below.

| Address | Name | Range | Description |
|---|---|---|---|
| 400–404 | **R, G, B, WW, CW** | 0–255 | PWM setpoints (8-bit API; scaled to 12-bit internally; slew-smoothed) |
| 410–414 | **R, G, B, WW, CW (12-bit)** | 0–4095 | Fine-grained PWM setpoints (same targets as HR 400–404) |
| 480 | **MB_ADDR** | 1–247 | Modbus address; values outside 1–247 are silently clamped |
| 481 | **MB_BAUD** | bps | 9600 / 19200 / 38400 / 57600 / 115200 |

HR **400–404** (8-bit) and HR **410–414** (12-bit) address the same PWM targets. The last successful write wins. HR 400–404 scales as `hi = value × 4095 / 255` (integer division); HR 410–414 sets the 12-bit target directly. Values above the register maximum are clamped (writing 300 to HR 400 yields 255; writing 5000 to HR 410 yields 4095). The module does not return exception code 03.

> Module configuration (inputs, gestures, dimming, scenes, trim, relay mode, gamma, etc.) is performed via **USB WebConfig only**; it is **not exposed on Modbus**.

---

## 6.4 Output quality (12-bit + gamma + slew)

- **PWM frequency:** **≈1 kHz** (1000 Hz nominal) on all five channels — fixed, not runtime-configurable. Inherited from the arduino-pico core default; at 150 MHz `clk_sys` with a 12-bit range the core sets clkdiv ≈ 36.625 and wrap 4094, giving 1000.1 Hz.
- **Internal resolution:** 12-bit (0–4095) on all five PWM channels (`analogWriteResolution(12)`).
- **API:** Modbus HR **400–404** and WebConfig accept **0–255**; HR **410–414** accept **0–4095** for finer control. Both banks address the same targets; the last successful write wins. HR 400–404 scales as `hi = value × 4095 / 255` (integer division).
- **Gamma:** configurable (default γ 2.2) via WebConfig; 4096-entry LUT applied at the final `analogWrite` stage only.
- **Trim:** per-channel min/max applied in perceived space before gamma (WebConfig).
- **Slew:** each channel has `current` and `target`; Modbus, gestures, and scenes update **target** and ramp over per-channel `fadeMs` (default **400 ms**, WebConfig). **Hold-to-dim** uses a separate `dimFullRangeMs` traverse (default **3000 ms**) — continuous, not stepped. `fadeMs = 0` = instant.
- **Diagnostics:** FC04 IREG **21–25** expose applied 12-bit PWM duty after trim, gamma and slew. This is not a measured LED current.

---

## 6.5 Local input logic (v0.2.0)

Wall switches (DI1/DI2) run the full gesture engine (momentary/maintained, hold-to-dim). Onboard **SW2** is a fixed tactile button: momentary **single** and **double** only.

| Input | Default single | Default double | Default hold |
|---|---|---|---|
| **DI1** | Toggle Group RGB | — | Dim up → Group RGB |
| **DI2** | Toggle Group CCT | — | Dim down → Group CCT |
| **SW2** | Toggle All | Identify | *(not used)* |

**Maintained mode:** contact closed = ON, open = OFF on **`maintTarget`** (independent of momentary gesture targets). Defaults: DI1 → Group RGB, DI2 → Group CCT.

**Hold-to-dim:** after `holdDelayMs` (default **650 ms**), brightness ramps **continuously** toward min (0) or max trim over `dimFullRangeMs` (default **3000 ms**). Direction and target come from each input's **Hold** gesture (Dim up / Dim down / Dim toggle dir + target). Release freezes at the current level (saved for RESTORE_LAST). Group dimming preserves channel ratios within RGB / CCT / RGB+CCT.

**Gesture targets** (WebConfig / `action<<8|target`): **7** = Group RGB (R,G,B), **8** = Group CCT (WW,CW), **10** = RGB+CCT (both groups in lockstep), **1** = Relay1, **9** = All. Per-channel PWM targets remain internal-only.

**Gesture actions:** None, Toggle, On, Off, Dim up, Dim down, **Dim toggle dir** (action **7**), Relay pulse, **Scene 1–4** (actions **10, 12, 13, 14** — target hidden/unused), Identify (**11**, onboard SW2 only). Legacy **Set 100%** (action **8**) maps to None. Legacy action **4** (All off) maps to Off+All. **Relay pulse** is offered only when target is Relay1.

**Scenes:** four presets configured in WebConfig; recalled by the Scene 1–4 gesture actions.

**Relay1 FOLLOW:** when mode=FOLLOW, **Relay C / NO** energizes while any watched group is on; after all outputs reach zero, the contact opens after `offDelayMs` (default 45 s). Wire **Relay C / NO** **externally in series** with the LED PSU (+) for power-cut — the module does not switch **COM (LED+)** internally.

**Child lock:** ignores local gestures; Modbus/HA control still works.

**Press counters:** IREG **6–20** — see [event-counter table](#event-counters-ireg-620).

---

## 6.6 Register Use Examples

| Operation | Write / Read |
|---|---|
| Set red to 128 | Holding **400** ← 128 |
| Set relay on/off | Coil **0** ← `1`/`0` (level-controlled; or ESPHome switch) |
| Read DI2 | FC04 IR **0**, bitmask `0x0002` |
| Read button state | FC04 IR **2**, bitmask `0x0001` |
| Read relay state | FC04 STATE **28**, flags bit3 *(or legacy IR **1**)* |
| Read target light levels | FC04 STATE **26–28** (one contiguous read; skip while flags bit4 **fading**) |
| Enable DI1 | Coil **300** ← 1 (pulse) |

| Read press counters (DI1 singles) | FC04 IR **6** |

---

## 6.7 Polling Recommendations

- **DI / LED / status:** one FC04 read **0..4** every 5 s (ESPHome package default)  
- **Target PWM + relay/fading flags:** one FC04 read **26..28** every 5 s (STATE block; drives HA light/relay feedback)  
- **PWM holding 400–404:** write via Light only; do not poll HR from ESPHome  
- **Relay/service coils:** write only on demand  
- **HA light transitions:** ESPHome package sets `default_transition_length: 0s` so HA sends one final value per channel; smooth crossfade is done on-module via per-channel **fadeMs** (WebConfig, default 400 ms). HA’s transition slider does not apply to this entity.  
- **HA light readback:** STATE@26–28 reports **target** levels. While flags bit4 **fading** is set, the package skips entity updates. An echo of HA’s own command is not reconstructed (five bytes cannot be decomposed back into brightness × colour unambiguously). A local button or scene that differs from the last HA command does update the light via `remote_values` — never re-writes HR 400–404.

---

# 7. ESPHome Integration Guide

Add this package to your **MicroPLC** or **MiniPLC** ESPHome configuration. Set `rgb_address` to the Modbus ID configured in WebConfig (default **3**; each module on the bus must be unique).

```yaml
packages:
  rgb1:
    url: https://github.com/isystemsautomation/homemaster-dev
    ref: main
    files:
      - path: RGB-621-R1/Firmware/v0.3.0/default_rgb_621_r1_plc/default_rgb_621_r1_plc.yaml
        vars:
          rgb_prefix: "RGB#1"
          rgb_id: rgb_1
          rgb_address: 3
```

The package exposes an **RGB+CCT light**, **relay switch**, **digital inputs**, and **button** entities in Home Assistant. UART and Modbus are configured on the controller; poll intervals and STATE readback match firmware v0.3.0 (see [§6](#6-modbus-rtu-communication)).

---

# 8. Firmware & Programming

## 8.1 Updating firmware (regular users)

No IDE or build tools required — RP2350 uses **UF2 drag-and-drop**.

1. Download the latest RGB-621-R1 firmware `.uf2` — module card on [config.home-master.eu](https://config.home-master.eu) (Firmware → UF2) or the repository.
2. **Enter BOOT mode:** hold **both** front buttons (Button 1 + Button 2) and, keeping them held, power-cycle the module (or use **Reset** in WebConfig). Release after power returns. The module mounts as a USB drive named **RPI-RP2**.
3. Drag-and-drop the `.uf2` onto the **RPI-RP2** drive. The module flashes and reboots automatically.
4. Settings (Modbus address/baud, trims, scenes, input mappings, relay mode, gamma) are stored in flash and preserved across updates.
5. **Recovery:** if it doesn't enumerate, power-cycle and retry BOOT.

Button 1 and Button 2 positions

## 8.2 Building & flashing from source (advanced / developers)

For modifying or rebuilding the firmware.

- **Languages:** Arduino (RP2350 core), C/C++ (Pico SDK / PlatformIO), MicroPython.
- **Toolchain:** PlatformIO or Arduino IDE.
  - Board/MCU: Raspberry Pi RP2350 / Generic RP235x
  - USB upload: Serial (CDC)
  - Flash layout (Arduino): e.g. 2 MB (Sketch 1 MB / FS 1 MB)
  - Libraries (Arduino examples): ModbusSerial, Arduino_JSON, LittleFS, SimpleWebSerial.
- Build the sketch (see the [reproducible build environment](../README.md#build-environment-reproducible) and [`sketch.yaml`](Firmware/v0.3.0/default_rgb_621_r1/sketch.yaml)), enter BOOT mode ([§8.1](#81-updating-firmware-regular-users) step 2), then upload the new build over USB, **or** export a `.uf2` and drag-drop it onto **RPI-RP2**.
- **Reset:** power-cycle the module (remove and re-apply **24 V DC**) or use **Reset** in WebConfig — there is no reset button combo.

---

# 9. Maintenance & Troubleshooting

## 9.1 Status LEDs (front panel)

| Indicator | Driven by | Meaning | Modbus |
|---|---|---|---|
| PWR | supply rail | Module 24 V DC supply present | — |
| TX | MAX485 | RS-485 transmit activity | — |
| RX | MAX485 | RS-485 receive activity | — |
| I.1 | input circuit | Digital input 1 state | discrete **1** / IREG DI mask bit 0 |
| I.2 | input circuit | Digital input 2 state | discrete **2** / IREG DI mask bit 1 |
| O.1 | relay circuit | Relay output 1 state | discrete **60** |
| LED1 | MCU (GPIO2) | User/status LED; Mode + Source set in WebConfig | discrete **90** / IREG LED mask bit 0 |
| LED2 | MCU (GPIO3) | User/status LED; Mode + Source set in WebConfig | discrete **91** / IREG LED mask bit 1 |

> ⚠️ On this hardware revision the **I.1** and **I.2** indicators are swapped (**I.1** shows DI2's state and vice versa). Logical inputs, Modbus registers and WebConfig are unaffected — see [Hardware notes](#hardware-notes-current-revision).

> There is no **RUN** or **ERR** indicator on this module.

## 9.2 Resets & Modes

- **BOOT mode** and **reset:** see [§8.1](#81-updating-firmware-regular-users).

## 9.3 Common Issues

- **No communication (TX/RX dark):**  
  Check A/B polarity, external 120 Ω termination at both bus ends (not on module), baud/ID match, and shared **RS-485 COM** reference if separate PSUs.
- **Relay won’t trigger:**  
  Confirm Modbus control vs. local override mode, verify coil/state in WebConfig, and ensure external wiring is on **Relay C / NO** (dry contact). Add snubber for inductive loads.
- **LED channels do not light:**  
  Verify **COM (LED+)** to strip, channel cathodes on **R/G/B/CW/WW**, correct polarity, and adequate **12/24 V** LED PSU sizing (**10 A** at LED PS, shared across channels; strip length and W/m decide the load).
- **LED strip dark, dim, or flickering while the module reports correct levels.**
  Check LED PS polarity and voltage **at the module's LED PS terminals under load**, not at the PSU.
  WebConfig shows the commanded level per channel; if those are correct and the strip does not follow, the fault is in the LED supply or wiring, not in the module logic.
- **Inputs not detected:**  
  Wire the contact between **I1/I2** and the **GND** terminal of the **DI 24Vdc** block (not **0V** of the power input, not the LED **COM**, not the **RS-485 COM**). Use a potential-free contact — do not apply external voltage. In WebConfig check the input is **Enabled**, **Inverted** is off, and **Debounce** (default 25 ms) is not set too high.
- **USB not detected:**  
  Use a data-capable USB-C cable; close any app holding the port; re-enter [BOOT mode](#81-updating-firmware-regular-users).

---

# 10. Open Source & Licensing

Licensing

This project uses a hybrid licensing model.

Hardware

Hardware designs (schematics, PCB layouts, BOMs) are licensed under:
CERN-OHL-W v2

Firmware & ESPHome Integration

All firmware, ESPHome configurations, and software components are licensed under:
MIT License

This ensures full compatibility with ESPHome and Home Assistant while protecting hardware designs.

See LICENSE files in each directory for full terms.

---

# 11. Downloads

- **Repository (module path):**  
  [`RGB-621-R1` on GitHub](https://github.com/isystemsautomation/homemaster-dev/tree/site/RGB-621-R1)
- **Firmware & examples:** `RGB-621-R1/Firmware/`
- **WebConfig (HTML page):** `RGB-621-R1/Firmware/v0.3.0/ConfigToolPage.html`
- **Schematics (PDF):** `RGB-621-R1/Schematics/`
- **Datasheet & docs:** `RGB-621-R1/Manuals/`
- **Images & diagrams:** `RGB-621-R1/Images/`

---

# 12. Support

- **Official Support:** https://www.home-master.eu/support  
- **WebConfig Tool (RGB-621-R1):** https://config.home-master.eu/RGB-621-R1/Firmware/v0.3.0/ConfigToolPage.html  
- **YouTube:** https://youtube.com/@HomeMaster  
- **Hackster:** https://hackster.io/homemaster  
- **Reddit:** https://reddit.com/r/HomeMaster  
- **Instagram:** https://instagram.com/home_master.eu

## Compliance & Certifications

The RGB-621-R1 module is CE marked. **ISYSTEMS AUTOMATION S.R.L.** (HomeMaster® brand)
maintains the technical documentation and a signed EU Declaration of Conformity (DoC).

### Applicable EU directives

- **EMC Directive 2014/30/EU** — EN 55032:2015 + AC:2016-07 + A11:2020 + A1:2020 (Class B emissions),
  EN 55035:2017 + A11:2020 (immunity); tested by Idvorsky Laboratories Ltd., Belgrade, Serbia
  (Job #1648, 20 April 2026)
- **Low Voltage Directive 2014/35/EU** — EN 62368-1:2020 + A11:2020; in-house dielectric and isolation
  test by ISYSTEMS AUTOMATION S.R.L. internal compliance laboratory
- **RoHS Directive 2011/65/EU** — EN IEC 63000 technical documentation

### Compliance documents

| Document | File |
|---|---|
| EU Declaration of Conformity (DoC) | [DoC_RGB-621-R1.pdf](https://config.home-master.eu/RGB-621-R1/Manuals/DoC_RGB-621-R1.pdf) |
| Datasheet | [RGB-621-R1_Datasheet.pdf](https://config.home-master.eu/RGB-621-R1/Manuals/RGB-621-R1_Datasheet.pdf) |

### Trademark

**HomeMaster®** is a registered European Union trademark of ISYSTEMS AUTOMATION S.R.L.,
EUTM No. 019082911, registered with EUIPO on 15 January 2025.

---

**Manufacturer:** ISYSTEMS AUTOMATION S.R.L. (HomeMaster® brand)
**Registered office (registered office):** Str. Domnisori, Nr. 81, Bl. 62, Scara A, Etaj 3, Ap. 12, 100284 Ploiesti, Jud. Prahova, Romania
**Office / Contact address:** Diligentei 18, Ploiesti, Romania
**CUI / VAT:** RO 21537032
**EUID:** ROONRC.J2007000919293
**Telephone:** +40 747 757 798
**Website:** [https://www.home-master.eu](https://www.home-master.eu)
