isystemsautomation/homemaster-dev/WLD-521-R1/README.md

## Quick Start (current version)

**Firmware shipped on new modules: `v0.1.0`**

```yaml
packages:
  wld1:
    url: https://github.com/isystemsautomation/homemaster-dev
    ref: main
    files:
      - path: WLD-521-R1/Firmware/v0.1.0/default_wld_521_r1_plc/default_wld_521_r1_plc.yaml
        vars:
          wld_prefix: "WLD#1"
          wld_id: wld_1
          wld_address: 4
```

## Version History

| Version | Config path (`path:`) | Date | Changes |
|---|---|---|---|
| **v0.1.0** | `WLD-521-R1/Firmware/v0.1.0/default_wld_521_r1_plc/default_wld_521_r1_plc.yaml` | 2026-06 | First versioned release |

> **Reproducible firmware build (v0.2.0):** [Build environment (reproducible)](../README.md#build-environment-reproducible) · [`sketch.yaml`](Firmware/v0.2.0/default_wld-521-r1/sketch.yaml)

# WLD-521-R1 — Water Meter & Leak Detection Module

**HOMEMASTER – Modular control. Custom logic.**

WLD-521-R1 module photo

### Module Description

The **WLD-521-R1** is a configurable smart I/O module designed for **leak detection**, **water flow metering**, **heat energy monitoring**, and **local irrigation control**.  
It includes **5 opto-isolated digital inputs**, **2 SPDT relays**, and optional **4 buttons and 4 LEDs** for manual control and local status indication. Configuration is performed via the **WebConfig interface** over **USB-C (Web Serial)**.  
The module connects over **RS-485 (Modbus RTU)** to a **MicroPLC or MiniPLC**, enabling deployment in **water management**, **hydronic heating**, **garden irrigation**, and **safety automation systems**.

## Table of Contents

* [1. Introduction](#1-introduction)
* [2. Use Cases](#2-use-cases)
* [3. Safety Information](#3-safety-information)
* [4. Installation & Quick Start](#4-installation-quick-start)
* [5. MODULE-CODE — Technical Specification](#5-module-code--technical-specification)
* [6. Modbus RTU Communication](#6-modbus-rtu-communication)
* [7. ESPHome Integration Guide (if applicable)](#7-esphome-integration-guide)
* [8. Programming & Customization](#8-programming--customization)
* [9. Maintenance & Troubleshooting](#9-maintenance--troubleshooting)
* [10. Open Source & Licensing](#10-open-source--licensing)
* [11. Downloads](#11-downloads)
* [12. Support](#12-support)

<br clear="left"/>

---

# 1. Introduction

## 1.1 Overview of the WLD-521-R1

The **WLD-521-R1** is autonomous water-safety I/O: **multi-zone leak detection**, **local auto valve shut-off**, **pulse water metering**, and **indicative loop heat-energy metering** (flow × ΔT from supply/return 1-Wire → power in W and accumulated energy in kWh) — safety logic runs on the module even if the network is down. **5 opto-isolated DIs**, **2 SPDT relays**, buttons/LEDs, USB-C WebConfig, and RS-485 Modbus to MiniPLC/MicroPLC or any Modbus master.

## Key advantages

- Multi-zone leak detection (**5 inputs**) + **2 relays** with local auto valve shut-off + pulse water metering; safety logic runs autonomously on the module.
- **Indicative loop heat-energy metering** — instantaneous power (W) and accumulated energy (kWh) from flow × ΔT (supply/return 1-Wire) — for heating/underfloor energy monitoring and optimization.
- Native ESPHome API via the MiniPLC/MicroPLC controller — no MQTT broker, no manual Modbus register mapping for the package entities.
- Local-first / edge-resilient — onboard logic keeps working if the network or Home Assistant is down.
- Open hardware (**CERN-OHL-W v2**) and firmware (**MIT**) — repairable, reproducible, no vendor lock-in.
- Standard **RS-485 Modbus RTU** — works with any Modbus master or industrial HMI/SCADA system, not locked to HomeMaster.
- Driverless **USB-C WebConfig** (Chrome, Edge, Opera); configuration persists in on-device flash (**LittleFS**).

> **Note:** Heat metering is **indicative** (for monitoring/optimization), **not a MID-certified heat meter for billing**; accuracy depends on the flow and temperature sensors used.

---

## 1.2 Features & Architecture

| Subsystem | Qty | Description |
|---|---|---|
| **Digital Inputs** | 5 | Opto‑isolated inputs with MOSFET front‑ends, debouncing, and isolated return (**GND_ISO**); suitable for dry contacts or pulse flowmeters. |
| **Analog Outputs** | 0 | — |
| **Relays** | 2 | SPDT dry contacts (~3 A @ 250 VAC); driven via opto‑isolated stages and RC/snubber-protected. Terminals NO/COM/NC exposed. |
| **1‑Wire Bus** | 1 | Protected 3‑pin header (+5 V / DATA / GND) with level shifting and ESD protection; supports DS18B20 sensors. |
| **LEDs** | 4 user + status | 4 user LEDs controlled via transistor drivers; additional LEDs for power and RS‑485 TX/RX activity. |
| **Buttons** | 4 | Front-panel tactile buttons connected to MCU GPIOs for relay override, irrigation control, and test functions. |
| **Modbus RTU** | Yes | RS‑485 transceiver with surge/bias/ESD protection and DE/RE control. Typical config: 19200 baud, 8N1. |
| **USB‑C** | Yes | Type-C port with ESD protection and Web Serial interface; used for configuration via WebConfig. |
| **Power** | 24 VDC | Fused, reverse-protected input. Internal buck regulator provides +5 V and +3.3 V. Isolated +5 V and +12 V rails available for sensor power. |
| **MCU** | RP2350A | Dual-core MCU with QSPI flash and 12 MHz crystal; SWD debug header available. |
| **Protection** | TVS, PTC, ESD | Multi-stage protection on RS‑485 and USB lines; isolated sensor rails; opto-isolated inputs; snubbers on relays. |

> Optional: **1‑Wire bus** for DS18B20 sensors (e.g. supply/return temperatures for heat energy monitoring).

---

## 1.3 System Role & Communication

The **WLD-521-R1** is a smart Modbus RTU slave. It can operate autonomously for leak/flow/irrigation safety logic, while exposing its I/O and sensors to a PLC, ESPHome controller, or SCADA system.

| Role | Description |
|---|---|
| **System Position** | Expansion module on RS-485 trunk |
| **Master Controller** | MiniPLC / MicroPLC or any third-party Modbus RTU master |
| **Address / Baud**  | Configurable via WebConfig (1–247, 9600–115200 baud) |
| **Bus Type** | RS‑485 multi-drop (A/B/COM terminals) |
| **USB‑C Port** | For configuration/diagnostics using Web Serial (Chromium-based: Chrome, Edge, Opera, Brave, Vivaldi; Chrome/Edge 89+, Opera 76+) |
| **Default Modbus ID** | `3` (user-changeable per module) |
| **Daisy-Chaining**  | Multiple modules supported; assign unique IDs to each device |

> ⚠️ **Note:** If multiple WLD modules are connected to the same RS‑485 segment, make sure to assign **unique Modbus addresses** using WebConfig.

---

# 2. Use Cases

The **WLD-521-R1** supports a range of real-world applications in leak detection, flow metering, hydronic energy monitoring, and irrigation control. Below are practical scenarios with step-by-step configuration.

---

### 1) Basement Leak Alarm + Auto Shut-off

**Goal:** Detect water leaks and immediately shut off the water supply using a relay-controlled valve.

**Steps:**
- Set **DI1** as **Water sensor**
- Enable DI1 and set **Action = Toggle**
- Set **Control target = Relay 1**
- Wire a **motorized shut-off valve** (normally open) to **R1**
- (Optional) Assign **LED1** to blink on **DI1** or **R1**

---

### 2) Garden Irrigation with Flow Supervision

**Goal:** Automate watering safely with flow monitoring and environmental interlocks.

**Steps:**
- Go to **Irrigation → Zone 1**
- Set **Valve relay = Relay 2**, **Flow DI = DI2**
- Enable **Use flow supervision**
- Configure:
  - **Min rate = 0.2 L/min**
  - **Grace = 8 s**
  - **Timeout = 1200 s**
  - **Target liters = 50**
- Add interlocks:
  - **DI_moist = DI3** (dry = run)
  - **DI_rain = DI4** (rain = block)
  - **R_pump = Relay 1** (pump ON when watering)
- Enable **Window: 06:00–08:00** with **Auto-start**

---

### 3) Water Consumption Metering (Billing)

**Goal:** Track water usage in liters using pulse flow meters.

**Steps:**
- Set **DI2** to **Water counter**
- Enter **Pulses per liter = 450** (typical)
- Adjust **Rate × / Total ×** as needed for calibration
- Use **Reset total** to baseline reading
- Use **Calc from external** after external validation
- View **Live rate (L/min)** and **Total (L)** in WebConfig

---

### 4) Heat Energy Monitoring (Hydronic ΔT Loops)

**Goal:** Measure heat power and energy from flow and temperature sensors.

**Steps:**
- Set **DI3 = Water counter**
- Enable **Heat** on DI3
- Assign **Sensor A = #1 (supply)**, **Sensor B = #2 (return)**
- Set thermal constants:
  - **cp = 4186 J/kg·°C**
  - **ρ = 1.0 kg/L**
- Adjust **Calibration ×** if needed
- View **TA**, **TB**, **ΔT**, **Power (W)**, **Energy (J/kWh)**
- Use **Reset energy** to zero counters

---

# 3. Safety Information

These safety instructions apply to the **WLD‑521‑R1** module. Improper handling or wiring can cause **equipment damage**, **system failure**, or **personal injury**.

⚠️ **SELV only** — This device operates on **Safety Extra Low Voltage (24 VDC only)**. Never apply AC mains or high-voltage sources.

---

## 3.1 General Requirements

| Requirement | Detail |
|---|---|
| **Qualified Personnel** | Only trained installers or technicians may handle wiring and system integration. |
| **Power Isolation** | Disconnect **24 VDC** power before modifying terminals or servicing the device. |
| **Environmental Limits**| Install inside a **dry, clean DIN enclosure**. Avoid condensation, dust, or vibration. |
| **Grounding** | Connect **0 V**, **RS-485 COM**, and **GND_ISO** appropriately. Maintain logic and sensor isolation. |
| **Voltage Compliance**  | Observe electrical ratings: **24 VDC supply**, **5/12 V sensor outputs**, **max 3 A relay load**. |

---

## 3.2 Installation Practices

| Task | Guidance |
|---|---|
| **DIN Mounting** | Secure module on **35 mm DIN rail**. Apply strain relief to all wiring. |
| **ESD Precaution** | Use anti-static strap and handle boards by casing only. |
| **Power Wiring** | Connect regulated **24 VDC** to `V+ / 0V` terminals. Fuse upstream. |
| **Relay Wiring** | Use `NO / COM / NC` terminals for each relay. Relays are **dry contact SPDT** only. External loads must have their own power. |
| **Digital Inputs** | Connect each dry-contact or open-collector sensor between the corresponding **Ix** terminal (**I1**–**I5**, positions 3–7) and **GND_ISO** (position 8, top-row **GND**). **Do not** return inputs to logic **0V**. Power isolated field sensors from **+5V_ISO** (position 21) or **+12V_ISO** (position 22), not from terminal 9. |
| **Sensor Power** | Use **+5 V** or **+12 V** outputs (right-side terminals) for low-power field sensors only. |
| **GND Domains** | Keep **GND_ISO** (inputs) and **0 V / GND (logic)** isolated unless explicitly bridged. |
| **RS-485 Wiring** | Wire `A/B/COM` to RS‑485 master. Maintain A↔A, B↔B polarity. COM = signal reference. Terminate both ends with ~120 Ω. |
| **Commissioning** | Before applying power: verify polarity, relay contact wiring, RS‑485 line, and ensure sensor loads are within spec. |

---

## 3.3 I/O & Interface Warnings

### Power

| Interface | Warning |
|---|---|
| **V+ / 0V (Top-left)** | Connect only regulated **24 VDC**. Reverse protected. Never exceed 30 V. |
| **+5 V / +12 V (Bottom-right)** | Isolated sensor supply. Use for dry-contact sensors only. Protected by DC-DC and fuses. Not for powering relays or actuators. |

---

### Inputs & Relays

| Interface | Warning |
|---|---|
| **Inputs I1–I5 (Top row)** | Opto-isolated channels (**SFH6156**, 100 kΩ pulldown). Wire the **switching contact** between **Ix** (pos. 3–7) and **GND_ISO** (pos. 8). **Do not** bridge **GND_ISO** to logic **0V**. |
| **+5V (Top row, pos. 9)** | **Non-isolated 1-Wire logic supply** only — **not** for powering input-side field sensors. Using terminal 9 for leak/moisture probes **defeats input isolation**; use **+5V_ISO** (pos. 21) instead. |
| **Relays (Bottom row)** | `NC / COM / NO` per relay. Dry contact only. Max: **3 A @ 250 VAC / 30 VDC**. Use snubbers for inductive loads (e.g. pumps, valves). |
| **Relay Power** | Relay contacts are **not powered**. External load must have its own power source. |

> ⚠️ **Capacitor motors (roller shutters, blinds, awnings, gate and garage tubular
> motors) must NOT be connected directly to the relay outputs.** Each relay contact
> carries a 275 V arc-suppression varistor. While one direction runs, the motor's
> phase-shift capacitor raises the voltage across the open contact of the other
> direction above 330 V; the varistor conducts continuously and is destroyed within
> seconds, regardless of motor current. Drive such motors through an interposing
> relay or contactor with ≥ 400 V contacts and **no RC or varistor across the
> contacts**; the WLD-521-R1 relay switches the interposing relay coil only. Follow the
> motor manufacturer's rules: the same phase for UP and DOWN, never UP and DOWN
> simultaneously, direction change through OFF with a pause of at least 0.5 s.

---

### Communication & USB

| Interface | Warning |
|---|---|
| **RS‑485 A/B/COM (Bottom left)** | Use twisted pair for A/B. COM is signal ground. Protect against surges. Not suitable for long unshielded runs or outdoor wiring. |
| **USB‑C (Front panel)** | For **setup only** using Web Serial in a Chromium-based browser (Chrome, Edge, Opera, Brave, Vivaldi; Chrome/Edge 89+, Opera 76+). ESD protected. Not for field use or runtime connection. Disconnect after configuration. |

---

### User Interface

| Element | Notes |
|---|---|
| **Buttons (U1–U4)** | Configurable: relay override, irrigation start/stop. Button press may override Modbus or automation logic. |
| **LEDs (U1–U4)** | Configurable for DI, Relay, or Irrigation indication. Driven from MCU via transistors. |

---

### Shielding & EMC

| Area | Recommendation |
|---|---|
| **Cable Shielding**| Use shielded cable for RS‑485 and sensor lines. Terminate shield at controller end only. Avoid routing near motors/VFDs. |
| **Inductive Loads**| Use RC snubbers or TVS across relay contacts for solenoids, pumps, or coils. |

---

# 4. Installation & Quick Start

## 4.1 What You Need

| Category | Item | Details |
|---|---|---|
| **Hardware** | **WLD‑521‑R1** | DIN‑rail module with **5 opto DIs**, **2 SPDT relays**, **4 buttons**, **4 LEDs**, **RS‑485**, **USB‑C**, **1‑Wire**, and **isolated +5 V / +12 V sensor rails**. |
| | Controller (master) | HomeMaster MiniPLC/MicroPLC or any Modbus RTU master device. |
| | 24 VDC PSU (SELV) | Regulated **24 VDC** supply to **V+ / 0V**; size to include module + sensors. |
| | RS‑485 cable | Shielded twisted pair for **A/B + COM (GND)**; use **120 Ω termination** at both bus ends. |
| | USB‑C cable | Used for setup/config via **WebConfig** in Chromium browser. |
| | DIN enclosure | Dry, clean cabinet with **DIN rail**; provide strain relief and shield grounding. |
| **Software** | WebConfig (browser) | Configure **Address / Baud**, assign **Inputs / Relays / Buttons / LEDs**, irrigation zones, sensors, etc. |
| | ESPHome (optional) | On controller: polls Modbus, exposes WLD sensors and relays to Home Assistant. |
| **Field I/O**| Dry contacts | Inputs DI1…DI5 return to **GND_ISO**; supports leak probes, flow meters, or buttons. |
| | Relay loads | RLY1/RLY2: **COM/NO/NC** dry contacts; up to **3 A @ 250 VAC**. Use RC/TVS snubbers for inductive loads. |
| | Sensor power (isolated) | Bottom-right **+12 V / +5 V ISO** terminals for **low-power sensors only**. Not for actuators. |
| **Tools** | Screwdrivers, ferrules, meter | Verify terminal torque, polarity, and RS‑485 A/B wiring. Use **120 Ω resistors** and surge protectors if needed. |

> **Status LEDs:**  
> • **PWR** – steady ON when powered  
> • **TX/RX** – blink on RS‑485 activity  
> • **USB** – active when connected for WebConfig

---

## 4.2 Power

The WLD‑521‑R1 operates from a **regulated 24 VDC supply** connected to the top terminals labeled `V+` and `0V`. The power supply should be SELV-rated and appropriately sized.

### Power Supply Notes

- Input: **24 VDC**, reverse-protected and fused onboard
- Internal regulation:  
  - **5 V logic** (buck regulated via AP64501)  
  - **3.3 V logic** (via AMS1117-3.3)
  - **+12 V ISO** (for field sensors via B2412S‑2WR3)  
  - **+5 V ISO** (via B2405S‑2WR3)

### Power Budget (Estimates)

| Load | Typical Current |
|---|---|
| Base logic + LEDs | ~50 mA |
| Each relay (coil) | ~40–60 mA |
| Sensor rails (total) | ≤150 mA (shared between +5 V ISO / +12 V ISO) |

**Recommended PSU:** ≥300 mA per module (with 30% headroom).

> ⚠️ Only use the **sensor rails** for **low-power sensors** like leak probes and flow meters.  
> Never power relays, valves, or actuators from the module’s +5 V / +12 V outputs.

---

## 4.3 Communication

The WLD‑521‑R1 uses **Modbus RTU** over RS‑485 for all runtime communication, and **USB‑C** for setup via browser.

### RS-485 / Modbus RTU

<!-- hm:rs485-order:begin -->
> **Terminal order differs across the HomeMaster range.**
> Always read the silkscreen - do not wire by habit from another module.
> On this module the order is **B-A-COM**.
> Swapping A and B damages nothing but the node will not communicate.
> COM is required on every node.
<!-- hm:rs485-order:end -->
All HomeMaster controllers and modules share the same RS-485 front end.

| Item | Value |
|---|---|
| Transceiver | MAX485CSA+T, half-duplex |
| Galvanic isolation | **None** — the transceiver shares the device's logic ground |
| Common-mode range | −7 V … +12 V referred to the device's own ground (MAX485 limit) |
| Terminals | A / B / COM |
| Surge protection | 3 × SMAJ6.8CA TVS (A–COM, B–COM, A–B) |
| Overcurrent | 2 × resettable PTC, 1.5 A hold, in series with A and B |
| EMI filtering | Common-mode choke on the A/B pair; COM referenced through 1 MΩ ∥ 4.7 nF |
| Idle state | Fail-safe biasing on board — do not add external bias resistors |
| Termination | 120 Ω at the two physical ends of the bus only |

**Bus wiring rules — apply to every device on the bus:**

- One twisted pair for A/B, 120 Ω characteristic impedance.
- Run **COM** to every node. Required, not optional: the ports are not isolated, and COM is what bounds the common-mode voltage the transceivers see.
- Prefer one power supply for the whole bus, distributed in star topology. With separate supplies, additionally tie the 0 V references together at a single point.
- Bond the cable shield to cabinet PE at one end only. Never land a shield on A, B or COM.
- Where the bus crosses into a different electrical installation with its own earthing reference — a utility or billing meter, another building, another cabinet's PE system — fit an external galvanic RS-485 isolator at that boundary. The on-board components are transient protection, not isolation, and will not survive a sustained ground-potential difference.

### RS‑485 Pinout (Bottom Left Terminals)

| Terminal | Function |
|---|---|
| **A** | RS‑485 A (Data +) |
| **B** | RS‑485 B (Data –) |
| **COM**  | RS‑485 reference ground (required on every node) |

### Modbus Settings

| Parameter | Default | Range |
|---|---|---|
| **Address** | 3 | 1–247 (set via WebConfig) |
| **Baudrate**  | 19200 | 9600–115200 (WebConfig) |
| **Format** | 8N1 | 8 data bits, no parity, 1 stop bit |

> WebConfig allows you to set the **Modbus address** and **baudrate** via USB‑C before connecting to a PLC or ESPHome controller.
# WLD-521-R1 Modbus Register Table

#### Function Codes
- **FC02** - Read Input Status (Discrete Inputs)
- **FC03** - Read Holding Registers
- **FC05** - Write Single Coil
- **FC01** - Read Coils

---

#### Input Status (FC02) - Read Only

| Address | Name | Type | Description |
|---|---|---|---|
| 1-5 | DI1-DI5 | Boolean | Digital Input states (0=OFF, 1=ON) |
| 60-61 | RLY1-RLY2 | Boolean | Relay output states (0=OFF, 1=ON) |
| 90-93 | LED1-LED4 | Boolean | User LED states (0=OFF, 1=ON) |
| 100-103 | BTN1-BTN4 | Boolean | Button pressed states (0=Released, 1=Pressed) |

---

#### Coils (FC01/FC05) - Read/Write

##### Maintained Coils (Switched - ESPHome can set ON/OFF directly)

| Address | Name | Type | Description |
|---|---|---|---|
| 200 | Relay 1 State | Boolean | Relay 1 ON/OFF state (maintained) |
| 201 | Relay 2 State | Boolean | Relay 2 ON/OFF state (maintained) |
| 220-224 | DI1-DI5 Enable | Boolean | Digital Input enable state (maintained) |

##### Pulse Coils (Cleared after use)

| Address | Name | Type | Description |
|---|---|---|---|
| 340-344 | DI1-DI5 Counter Reset | Boolean | Reset counter for DI (pulse, auto-cleared) |

---

#### Holding Registers (FC03) - Read Only

All data accessible via FC03 Read Holding Registers.

##### Status Registers (UINT16: 0 or 1)

| Address | Name | Type | Description |
|---|---|---|---|
| 1-5 | DI1-DI5 State | UINT16 | Digital Input states (mirror of ISTS) |
| 60-61 | RLY1-RLY2 State | UINT16 | Relay output states (mirror of ISTS) |
| 90-93 | LED1-LED4 State | UINT16 | User LED states (mirror of ISTS) |
| 100-103 | BTN1-BTN4 State | UINT16 | Button pressed states (mirror of ISTS) |

##### Flow Meter Data (UINT32 - 2 registers each, Little Endian)

| Address | Name | Type | Unit | Description |
|---|---|---|---|---|
| 104-105 | DI1 Flow Rate | UINT32 | L/min × 1000 | Flow rate for DI1 |
| 106-107 | DI2 Flow Rate | UINT32 | L/min × 1000 | Flow rate for DI2 |
| 108-109 | DI3 Flow Rate | UINT32 | L/min × 1000 | Flow rate for DI3 |
| 110-111 | DI4 Flow Rate | UINT32 | L/min × 1000 | Flow rate for DI4 |
| 112-113 | DI5 Flow Rate | UINT32 | L/min × 1000 | Flow rate for DI5 |
| 114-115 | DI1 Flow Accumulated | UINT32 | L × 1000 | Total flow for DI1 |
| 116-117 | DI2 Flow Accumulated | UINT32 | L × 1000 | Total flow for DI2 |
| 118-119 | DI3 Flow Accumulated | UINT32 | L × 1000 | Total flow for DI3 |
| 120-121 | DI4 Flow Accumulated | UINT32 | L × 1000 | Total flow for DI4 |
| 122-123 | DI5 Flow Accumulated | UINT32 | L × 1000 | Total flow for DI5 |

##### Heat Energy Data (S32/U32 - 2 registers each, Little Endian)

| Address | Name | Type | Unit | Description |
|---|---|---|---|---|
| 124-125 | DI1 Heat Power | SINT32 | W | Heat power for DI1 |
| 126-127 | DI2 Heat Power | SINT32 | W | Heat power for DI2 |
| 128-129 | DI3 Heat Power | SINT32 | W | Heat power for DI3 |
| 130-131 | DI4 Heat Power | SINT32 | W | Heat power for DI4 |
| 132-133 | DI5 Heat Power | SINT32 | W | Heat power for DI5 |
| 134-135 | DI1 Heat Energy | UINT32 | Wh × 1000 | Total heat energy for DI1 |
| 136-137 | DI2 Heat Energy | UINT32 | Wh × 1000 | Total heat energy for DI2 |
| 138-139 | DI3 Heat Energy | UINT32 | Wh × 1000 | Total heat energy for DI3 |
| 140-141 | DI4 Heat Energy | UINT32 | Wh × 1000 | Total heat energy for DI4 |
| 142-143 | DI5 Heat Energy | UINT32 | Wh × 1000 | Total heat energy for DI5 |
| 144-145 | DI1 Heat ΔT | SINT32 | °C × 1000 | Temperature difference for DI1 |
| 146-147 | DI2 Heat ΔT | SINT32 | °C × 1000 | Temperature difference for DI2 |
| 148-149 | DI3 Heat ΔT | SINT32 | °C × 1000 | Temperature difference for DI3 |
| 150-151 | DI4 Heat ΔT | SINT32 | °C × 1000 | Temperature difference for DI4 |
| 152-153 | DI5 Heat ΔT | SINT32 | °C × 1000 | Temperature difference for DI5 |

##### 1-Wire Temperature Data (SINT32 - 2 registers each, Little Endian)

| Address | Name | Type | Unit | Description |
|---|---|---|---|---|
| 154-155 | OW Sensor 1 Temp | SINT32 | °C × 1000 | 1-Wire sensor #1 temperature |
| 156-157 | OW Sensor 2 Temp | SINT32 | °C × 1000 | 1-Wire sensor #2 temperature |
| 158-159 | OW Sensor 3 Temp | SINT32 | °C × 1000 | 1-Wire sensor #3 temperature |
| 160-161 | OW Sensor 4 Temp | SINT32 | °C × 1000 | 1-Wire sensor #4 temperature |
| 162-163 | OW Sensor 5 Temp | SINT32 | °C × 1000 | 1-Wire sensor #5 temperature |
| 164-165 | OW Sensor 6 Temp | SINT32 | °C × 1000 | 1-Wire sensor #6 temperature |
| 166-167 | OW Sensor 7 Temp | SINT32 | °C × 1000 | 1-Wire sensor #7 temperature |
| 168-169 | OW Sensor 8 Temp | SINT32 | °C × 1000 | 1-Wire sensor #8 temperature |
| 170-171 | OW Sensor 9 Temp | SINT32 | °C × 1000 | 1-Wire sensor #9 temperature |
| 172-173 | OW Sensor 10 Temp | SINT32 | °C × 1000 | 1-Wire sensor #10 temperature |

---

#### Notes

1. **Maintained Coils (200-224)**: These coils maintain their state. ESPHome can read/write them directly as switches.
2. **Pulse Coils (340-344)**: These coils are automatically cleared after being read. Write `1` to reset the corresponding counter.
3. **Holding Registers**: All 32-bit values (UINT32/SINT32) are stored as two consecutive 16-bit registers in Little Endian format (low word first).
4. **Scaling**: 
   - Flow Rate: Multiply by 0.001 to get L/min
   - Flow Accumulated: Multiply by 0.001 to get L
   - Heat Energy: Multiply by 0.001 to get Wh
   - Temperatures: Multiply by 0.001 to get °C
5. **Total Register Range**: 1-173 (continuous address space for FC03)

---

## Example Usage

### Read Digital Input 1 State
- **FC03**, Address: **1** → Returns: `0` (OFF) or `1` (ON)

### Control Relay 1 ON
- **FC05**, Address: **200**, Value: `1` (ON) or `0` (OFF)

### Read Flow Rate for DI1
- **FC03**, Addresses: **104-105** → Read as UINT32, divide by 1000 → Result in L/min

### Reset Counter for DI1
- **FC05**, Address: **340**, Value: `1` (will be auto-cleared by firmware)

---

## 4.4 Installation & Wiring

Mount the module on a **35 mm DIN rail** inside a dry enclosure; disconnect **24 V DC** and RS-485 before wiring. Opto-isolated inputs return to **GND_ISO** — do not tie **GND_ISO** to logic **0V** unless your system design explicitly requires it.

### Power (24 V DC)

Connect a regulated **24 V DC SELV** supply to **V+** and **0V** for MCU, RS-485, relay coils, and isolated sensor rails (reverse-polarity protected; size for ≥300 mA with headroom).

24 V DC power wiring to V+ and 0V

*Regulated **24 V DC** to **V+** / **0V** — fuse the feed per local rules.*

### Leak / flood sensors

Five opto-isolated digital inputs (**DI1…DI5**, terminals **I1**–**I5**, positions 3–7) accept leak probes, soil-moisture sensors, or dry contacts. Wire each sensor so the **active contact** is between the **Ix** terminal and **GND_ISO** (position 8, top-row **GND**). When the contact is open, the input is held low by an internal **100 kΩ** pulldown; closing the contact energises the opto front-end (**SFH6156** on FieldBoard schematic).

**Example (leak probe on DI1):** probe wire **A** → **I1** (terminal 3); probe wire **B** → **GND** (terminal 8, **GND_ISO**). Power any three-wire sensor from **+5V_ISO** (terminal 21) and **GND_ISO** (terminal 8) — **not** from **+5V** at terminal 9 (1-Wire logic domain).

> **Hazard:** Terminal **9** (+5V, top row) is the **non-isolated 1-Wire supply** shared with the MCU logic ground. **Do not** power input-side field sensors from terminal 9 if galvanic isolation is required; use **+5V_ISO** (terminal **21**) and **GND_ISO** (terminal **8**).

Configure each channel as water sensor, soil moisture, or counter in WebConfig.

Leak and flood sensor wiring to digital inputs

*Field leak/moisture sensors and contacts on **DI** terminals with **GND_ISO** return.*

### Flow meter (pulse counter)

Configure a DI as **water counter** to count pulses from a flow meter — set **pulses per litre** in WebConfig to match the meter datasheet.

Pulse flow meter connection to digital input

*Pulse output flow meter wired to a counter-mode **DI** channel.*

### 1-Wire temperature sensors

The protected **1-Wire** header at terminals **+5V** (9), **DATA** (10), **GND** (11) supports **DS18B20** sensors for supply/return temperature and ΔT heat-energy monitoring. This **+5V** rail is in the **logic domain** (not isolated) — do **not** use it to power devices on the isolated DI sensor side.

1-Wire DS18B20 temperature sensor wiring

*DS18B20 sensors on the **+5 V** / **DATA** / **GND** 1-Wire bus — keep leads short.*

### Relays (2× SPDT)

Two **SPDT** dry-contact relays (**NO** / **COM** / **NC**) switch valves, pumps, or alarms at up to **3 A @ 250 VAC** (module limit); external fuse/breaker and RC snubber are mandatory per load. Capacitor motors: see §3.3.

Relay NO/COM/NC wiring for two relays

*Dry contacts only — external load supply and overcurrent protection are mandatory.*

### RS-485 (Modbus RTU)

Bus hardware and wiring rules: [RS-485 / Modbus RTU](#rs-485--modbus-rtu).

### USB-C

The **USB-C** port is for **WebConfig** setup and firmware update only; it is **not** a field power or runtime data bus — disconnect USB before energising the installation and before handing control to RS-485.

## 4.5 Software & UI Configuration

The WLD‑521‑R1 is configured using **WebConfig** — a driverless USB‑C interface that runs in any Chromium-based browser (Chrome, Edge, Opera, Brave, Vivaldi; Chrome/Edge 89+, Opera 76+) via Web Serial. All settings apply immediately and are saved to the module's flash.

> Firefox: experimental only (Nightly with the Web Serial flag enabled). Safari and stable Firefox are not supported.

---

### WebConfig Setup

1. Connect the module to your PC using a **USB-C** cable.
2. Open **[ConfigToolPage.html](https://config.home-master.eu/WLD-521-R1/Firmware/v0.1.0/ConfigToolPage.html)** in a Chromium-based browser.
3. Click **“Connect”** and select the serial device.
4. The header will show the **Active Modbus Configuration** (Address, Baudrate).

> You can safely reset or update Modbus settings at any time.

---

### Modbus Address & Baudrate

In the **Modbus** panel:

- **Set Address (1–247)**: each module must have a unique address.
- **Set Baudrate**: choose between **9600–115200** (default: 19200).
- Confirm the updated settings in the banner and **Serial Log**.

WebConfig – Modbus

---

### Input Configuration (DI1–DI5)

Each DI has:

- **Enable / Invert**
- **Type**:
  - `Water sensor`
  - `Soil moisture`
  - `Water counter` (flow meter input)

#### For `Water sensor` / `Soil moisture`:

- **Action**:
  - `None`, `Toggle`, or `Pulse`
- **Control Target**:
  - `All`, `Relay 1`, `Relay 2`, `None`

#### For `Water counter`:

- **Pulses per Liter (PPL)**: e.g., 450
- **Rate × / Total ×**: calibration scalars
- **Live Flow**:
  - **Rate (L/min)**
  - **Total (L)**
- **Reset Total / Reset Pulses**
- **Calc from External**: align module total with external meter

WebConfig – Inputs

---

### Heat Energy Calculation (Optional on Counter DIs)

Enable **Heat** on a DI to calculate:

- **ΔT** from 1-Wire `Sensor A` – `Sensor B`
- **Power (W)** and **Energy (J / kWh)** using:
  - **cp** (J/kg·°C), **ρ** (kg/L), **Calibration ×**

→ Formula:  
`Power = cp × ρ × ΔT × FlowRate`  
`Energy = ∑ Power × Δt`

You can:
- View **TA**, **TB**, **ΔT**
- Reset energy counters

WebConfig – Heat Panel

---

### Relay Logic Configuration (Relay 1 & 2)

- **Enable / Invert**
- **Control Source**:
  - `Modbus`, `Local Logic`, or `None`
- **Manual Override**
  - ON/OFF switch
  - **Latch** override to persist across Modbus commands

> Relays are dry contact. Wire loads to `NO / NC / COM`.

WebConfig – Relays

---

### LED Mapping (LED1–LED4)

Each LED can be:

- **Mode**: `Solid` or `Blink`
- **Source**:
  - `DI1–DI5`, `Relay 1/2`, `Irrig 1/2`, `Override R1/R2`

> The **State Dot** shows live ON/OFF.

WebConfig – LEDs

---

### Button Configuration (BTN1–BTN4)

Each button triggers an **Action**:

- **Relays**:
  - `Toggle R1/R2`, `Pulse R1/R2`
- **Irrigation**:
  - `Start/Stop Zone 1/2`
- **Manual Override**:
  - `R1/R2 Override Toggle`

#### Button Press Behavior

- **Short press** = toggle state  
- **Long press (3s)** = enter/exit override mode  
- **In override**, relay ignores Modbus/logic control

WebConfig – Buttons

---

### Testing & Diagnostics

Use:

- **Serial Log** to watch changes live
- **Status pills** on every component card to view DI/relay/button states
- **Reset Device** to safely reboot the module

---

✅ WebConfig saves all changes immediately to flash. You can disconnect USB-C after setup — the device runs autonomously and responds to Modbus polling.

## 4.6 Getting Started

Summarize steps in 3 phases:
1. Wiring
2. Configuration
3. Integration

---

# 5. WLD‑521‑R1 — Technical Specification

> This section consolidates diagrams, I/O, electrical limits, firmware behavior, connector map, mechanics, and compliance for quick reference.

---

## 5.1 Diagrams & Pinouts

<div align="center">
  <table>
    <tr>
      <td align="center">
        <strong>System Block Diagram</strong><br>
        System Diagram
      </td>
      <td align="center">
        <strong>Terminal Map</strong><br>
        Module Photo and Terminal Map
      </td>
    </tr>
    <tr>
      <td align="center">
        <strong>Field Board Layout</strong><br>
        Field Board
      </td>
      <td align="center">
        <strong>MCU Board Layout</strong><br>
        MCU Board
      </td>
    </tr>
  </table>
</div>

---

---

## 5.2 I/O Summary

| Interface | Qty | Description |
|---|-----|---|
| **Digital Inputs**  | 5 | Opto‑isolated DI (dry contact / open‑collector / pulse for flow meters); isolated return (GND_ISO). |
| **Relay Outputs** | 2 | SPDT dry contact (NO/C/NC); snubbered; local/Modbus/logic control. |
| **User LEDs** | 4 | Configurable (Solid/Blink) for DI/Relay/Irrigation/Override feedback. |
| **User Buttons** | 4 | Assignable actions (Relay toggle/pulse, Override, Irrigation start/stop). |
| **RS‑485 (Modbus)** | 1 | Half‑duplex multi‑drop; A/B/COM terminals; fail‑safe & surge‑protected. |
| **USB‑C** | 1 | Service/setup via WebConfig (Web Serial). |
| **1‑Wire Bus** | 1 | +5 V / DATA / GND (logic domain) for DS18B20 sensors. |
| **Sensor Power** | 2 | Isolated +12 V / +5 V rails for **low‑power sensors only** (fused, filtered). |

---

## 5.3 Electrical Specifications

<!-- hm:specs:start -->
| Specification | Details |
|---|---|
| Microcontroller | RP2350A dual-core microcontroller |
| Storage | External QSPI Flash (W25Q32JV, 32 Mbit) |
| Power Input | 24 V DC nominal |
| Input Protection | 1 A fuse, reverse polarity diode, TVS surge suppression, EMI filtering |
| Main Logic Supply | Buck regulator 24 V → 5 V, 3.3 V LDO regulator |
| File system | LittleFS persistent configuration storage |
| Document revision | DS-WLD-521-R1 Rev. B · 2026-09 · Hardware R1 (V1.0) |
| Digital Inputs | 5 × isolated 5 V DC discrete inputs |
| Max Input Voltage | 5 V DC continuous |
| Relay outputs | 2 × SPDT (NO / C / NC); 3 A @ 250 VAC per contact (module limit) |
| Isolated +12 V Output | 12 V isolated rail, 2 W; max 167 mA theoretical (≤150 mA recommended) |
| Isolated +5 V Output | 5 V isolated rail, 1 W; max 200 mA theoretical (≤150 mA recommended) |
| 1-Wire | 1 × protected 1-Wire interface (+5 V, DATA, GND) |
| User Interface | 4 buttons; 9 LEDs (Power, 4 user, RX, TX, Relay1, Relay2) |
| RS-485 | half-duplex Modbus RTU, not galvanically isolated |
| USB | USB-C, 5 V logic, ESD protected |
| Typical Power Consumption | 3 W typical / 5 W maximum (both relays energised, isolated sensor supplies fully loaded) |
| Modbus defaults | Address 3, 19200 baud, 8N1 |
| Operating temperature | 0 °C to +40 °C |
| Storage temperature | −10 °C to +55 °C |
| Relative humidity | 0–90 % RH, non-condensing |
| Ingress protection | IP20 (inside cabinet only) |
| Installation | Indoor control cabinet only; not for outdoor or exposed installation |
| Maximum altitude | 2000 m |
| Pollution degree | 2 |
| Dimensions | 70 × 90.6 × 67.3 mm (L × W × H) |
| DIN width | 4 modules (≈ 70 mm) |
| Mounting | 35 mm DIN rail |
| Enclosure | PC/ABS industrial enclosure |
| Terminal type | Pluggable screw terminal blocks, 5.08 mm pitch |
| Wire cross-section | 0.2–2.5 mm² (AWG 24–12) |
| Tightening torque | 0.4–0.6 Nm |
| Net weight | 200 g |
| Gross weight | 320 g |
| Pack size | 140 × 125 × 94 mm (L × W × H) |
<!-- hm:specs:end -->

## 5.4 Firmware Behavior

### Input → Action & Alarm Logic
- **DI Types:** *Water sensor*, *Soil moisture*, *Water counter* (flow).  
- **Enable / Invert** per channel; debounce configurable.  
- **Non‑counter actions:** `None`, `Toggle`, `Pulse` with **Control Target** (`Relay 1`, `Relay 2`, `All`, `None`).  
- **Counter channels:** set **Pulses per Liter (PPL)**, **Rate× / Total×** calibration; expose **Rate (L/min)** & **Total (L)**.  
- **Heat energy (optional):** enable on a counter; assign 1‑Wire **Sensor A/B**; set **cp** (J/kg·°C), **ρ** (kg/L), and **Calibration×**.  
  - `Power (W) = cp × ρ × ΔT × FlowRate`  
  - `Energy = ∑ Power × Δt`  
  - Live values: **TA**, **TB**, **ΔT**, **Power**, **Energy**; **Reset** available.

### Relay Ownership & Overrides
- **Control Source** per relay: `Modbus` (default), `Local Logic` (e.g., irrigation), or `None`.  
- **Override:** immediate ON/OFF with **Latch** option; **override state supersedes** Modbus and local logic until cleared.  
- **Safety:** relays are dry contact; external loads must be powered from a separate supply.

### LEDs & Buttons
- **LEDs (4):** map to DI, Relays, Irrigation Zones, or Override; **Solid** or **Blink** modes.  
- **Buttons (4):** assign `Toggle/Pulse R1/R2`, `Override Toggle R1/R2`, `Irrigation Zone 1/2 Start/Stop`.  
  - **Short press:** action (toggle/pulse).  
  - **Long press (~3 s):** enter/exit override mode for the mapped relay.

### Modbus Defaults & Persistence
- **Defaults:** Address `3`, Baud `19200`, **8N1**.  
- **WebConfig:** all changes apply live and are **persisted to flash**.  
- **Daily sync:** optional midnight sync (**coil 360**) for counters/windows when used with Home Assistant.

---

## 5.5 Absolute Electrical Specifications

| Parameter | Min | Typ | Max | Notes |
|---|-----|-----|-----|---|
| **Supply voltage (V+)** | 20 V | 24 V | 30 V | SELV; reverse/surge protected input. |
| **Power consumption** | — | **3 W** | **5 W** | 24 V DC nominal; per product label (logic + RS‑485 + USB‑C typ.; max with both relays on, ISO rails loaded, all DIs active, RS‑485 traffic). |
| **Logic rails** | — | 5 V / 3.3 V | — | Buck + LDO derived. |
| **Isolated sensor rails** | — | +12 V ISO / +5 V ISO | — | Fused & LC‑filtered; specify budget per install. |
| **Digital inputs** | — | — | — | Opto‑isolated; per‑channel surge protection. |
| **Relay contacts (R1–R2)** | — | — | **3 A @ 250 VAC** (resistive) / **3 A @ 30 VDC** | Module limit. Relay component rated higher — does **not** apply to the module. Use external snubbers; derate for inductive loads. |
| **RS‑485 interface** | — | 115200 bps | — | Half‑duplex; fail‑safe; short‑circuit limited; surge‑protected. |
| **USB‑C** | 5 V | — | — | USB 2.0 device; ESD‑protected; setup only. |
| **Operating temperature** | 0 °C | — | 40 °C | ≤95 % RH, non‑condensing. |

> **Installer note:** Fuse the 24 VDC feed upstream and add **RC/TVS snubbers** for inductive loads (pumps, valves).

---

## 5.6 Connector / Terminal Map (Field Side)

External terminals are 5.08 mm pitch pluggable blocks (300 V / 20 A, 26–12 AWG, torque 0.5–0.6 Nm).

<!-- hm:terminal-map:begin -->

**Top row** (24Vdc | INPUTS | 1-WIRE)

| Pos | Label | Group | Function |
|-----|---|---|---|
| 1 | V+ | POWER | 24 V DC input |
| 2 | 0V | POWER | 24 V DC return |
| 3 | I.1 | INPUTS | Input 1 |
| 4 | I.2 | INPUTS | Input 2 |
| 5 | I.3 | INPUTS | Input 3 |
| 6 | I.4 | INPUTS | Input 4 |
| 7 | I.5 | INPUTS | Input 5 |
| 8 | Gnd | INPUTS | Isolated input return (GND_ISO) |
| 9 | +5V | BUS | 1-Wire supply (logic domain, not isolated) |
| 10 | D | BUS | 1-Wire data |
| 11 | Gnd | BUS | 1-Wire ground (logic) |

**Bottom row** (RS-485 | RELAY OUTPUT | PS 5/12 Vdc)

| Pos | Label | Group | Function |
|-----|---|---|---|
| 1 | B | RS485 | RS-485 data - |
| 2 | A | RS485 | RS-485 data + |
| 3 | COM | RS485 | RS-485 signal reference |
| 4 | NO | RELAY1 | Relay 1 normally open |
| 5 | C | RELAY1 | Relay 1 common |
| 6 | NC | RELAY1 | Relay 1 normally closed |
| 7 | NO | RELAY2 | Relay 2 normally open |
| 8 | C | RELAY2 | Relay 2 common |
| 9 | NC | RELAY2 | Relay 2 normally closed |
| 10 | 5Vdc | PS | Isolated sensor rail +5 V |
| 11 | 12Vdc | PS | Isolated sensor rail +12 V |

**Ports & service interfaces**

| Id | Type | Note |
|----|---|---|
| USB-C | Web-Serial config | ESD-protected; not a field power source. |

**Housing notes**

- One shared Gnd (GND_ISO) for all five inputs, not one per channel.
- The Gnd on the top-row BUS block is the logic domain. Do not power field sensors from it - use the isolated PS rails.
- Isolated sensor rails 5 Vdc and 12 Vdc, 150 mA total.

<!-- hm:terminal-map:end -->

---

## 5.7 Mechanical Details

- **DIN width:** 4 modules (≈ 70 mm)
- **Dimensions:** 70 × 90.6 × 67.3 mm (L × W × H)
- **Mounting:** DIN rail EN 50022, 35 mm  
- **Enclosure:** PC/ABS, V‑0, light gray/black, matte  
- **Terminals:** 5.08 mm pitch; 26–12 AWG (to 2.5 mm²); **0.5–0.6 Nm** torque

WLD-521-R1 mechanical drawing

*Mechanical drawing: front and side view, dimensions in mm*

---

## 5.8 Environmental & Compliance

- **Operating temperature:** 0…40 °C; **Humidity:** ≤95 % RH (non‑condensing)  
- **Ingress / Safety class:** **IP20**; **Operation Type 1**  
- **Impulse / Altitude / Pollution:** 2.5 kV rated impulse (digital output), max altitude 2000 m, Pollution degree 2  
- **Installation:** SELV only; by qualified personnel per local codes

---

# 6. Modbus RTU Communication

The WLD‑521‑R1 communicates as a **Modbus RTU slave** over **RS‑485**, exposing its digital inputs, counters, flow data, heat metrics, relays, LEDs, irrigation state, and 1‑Wire temperatures.

---

## 6.1 Modbus Basics

| Parameter | Value |
|---|---|
| **Interface** | RS‑485 (half-duplex) |
| **Baudrate**  | 9600–115200 (default: **19200**) |
| **Address** | 1–247 (default: **3**) |
| **Parity** | 8N1 |
| **Role** | Slave (responds to master requests) |
| **Supported FCs** | `0x01` Read Coils, `0x02` Read Discrete Inputs, `0x03` Read Holding, `0x04` Read Input, `0x05/0x0F` Write Coils, `0x06/0x10` Write Holding |

> 🧩 Address and baudrate are configured via USB-C using WebConfig.

---

## 6.2 Address Map Overview

| Function | Range | Description |
|---|---|---|
| **Discrete Inputs** (FC02) | 1–5, 60–61, 90–93, 100–103 | DI, relay, LED, button state mirrors |
| **Coils** (FC01/05) | 200–201, 220–224, 340–344 | Relay control, DI enable, counter reset |
| **Holding Registers** (FC03) | 1–173 | Status mirrors, flow/heat/1-Wire telemetry |

> The detailed register table in [§4.3 — WLD-521-R1 Modbus Register Table](#wld-521-r1-modbus-register-table) matches `default_wld_521_r1_plc_full.yaml` (v0.2.0).

---

## 6.3 Coils (FC01/05)

### Maintained coils (read/write as switches)

| Address | Description |
|---|---|
| 200–201 | Relay 1–2 ON/OFF state (maintained) |
| 220–224 | DI1–DI5 enable state (maintained) |

### Pulse coils (auto-cleared)

| Address | Description |
|---|---|
| 340–344 | Reset pulse counter for DI1–DI5 (write `1`) |

---

## 6.4 Discrete Inputs (FC02)

| Address | Description |
|---|---|
| 1–5 | DI1–DI5 debounced state |
| 60–61 | Relay 1–2 state |
| 90–93 | LED1–LED4 state |
| 100–103 | BTN1–BTN4 pressed |

---

## 6.5 Holding Registers (FC03)

All telemetry below is read via **FC03** (also mirrored as UINT16 status at addresses 1–103).

### Status mirrors (UINT16: 0 or 1)

| Address | Description |
|---|---|
| 1–5 | DI1–DI5 state |
| 60–61 | Relay 1–2 state |
| 90–93 | LED1–LED4 state |
| 100–103 | BTN1–BTN4 state |

### Flow meter data (UINT32, 2 registers, little-endian)

| Address | Description | Unit |
|---|---|---|
| 104–105 | DI1 flow rate | L/min ×1000 |
| 106–107 | DI2 flow rate | L/min ×1000 |
| 108–109 | DI3 flow rate | L/min ×1000 |
| 110–111 | DI4 flow rate | L/min ×1000 |
| 112–113 | DI5 flow rate | L/min ×1000 |
| 114–115 | DI1 flow accumulated | L ×1000 |
| 116–117 | DI2 flow accumulated | L ×1000 |
| 118–119 | DI3 flow accumulated | L ×1000 |
| 120–121 | DI4 flow accumulated | L ×1000 |
| 122–123 | DI5 flow accumulated | L ×1000 |

### Heat energy (S32/U32, 2 registers each)

| Address | Description | Unit |
|---|---|---|
| 124–125 | DI1 heat power | W |
| 126–127 | DI2 heat power | W |
| 128–129 | DI3 heat power | W |
| 130–131 | DI4 heat power | W |
| 132–133 | DI5 heat power | W |
| 134–135 | DI1 heat energy | Wh ×1000 |
| 136–137 | DI2 heat energy | Wh ×1000 |
| 138–139 | DI3 heat energy | Wh ×1000 |
| 140–141 | DI4 heat energy | Wh ×1000 |
| 142–143 | DI5 heat energy | Wh ×1000 |
| 144–145 | DI1 heat ΔT | °C ×1000 |
| 146–147 | DI2 heat ΔT | °C ×1000 |
| 148–149 | DI3 heat ΔT | °C ×1000 |
| 150–151 | DI4 heat ΔT | °C ×1000 |
| 152–153 | DI5 heat ΔT | °C ×1000 |

### 1-Wire temperatures (SINT32, 2 registers each)

| Address | Description | Unit |
|---|---|---|
| 154–155 | OW sensor 1 temp | °C ×1000 |
| 156–157 | OW sensor 2 temp | °C ×1000 |
| 158–159 | OW sensor 3 temp | °C ×1000 |
| 160–161 | OW sensor 4 temp | °C ×1000 |
| 162–163 | OW sensor 5 temp | °C ×1000 |
| 164–165 | OW sensor 6 temp | °C ×1000 |
| 166–167 | OW sensor 7 temp | °C ×1000 |
| 168–169 | OW sensor 8 temp | °C ×1000 |
| 170–171 | OW sensor 9 temp | °C ×1000 |
| 172–173 | OW sensor 10 temp | °C ×1000 |

---

## 6.6 Register Use Examples

### Read DI1 flow total
- **FC03**, addresses **114–115** → UINT32, divide by **1000** → liters

### Control Relay 1 ON
- **FC05**, coil **200**, value `1` (ON) or `0` (OFF)

### Reset counter for DI1
- **FC05**, coil **340**, value `1` (auto-cleared by firmware)

---

## 6.7 Polling Recommendations

| Data Type | Suggested Rate | Notes |
|---|---|---|
| DI / Relay / LED / Button | 1 s | FC02 or holding mirrors 1–103 |
| Flow / counters | 2–5 s | Holding 104–123 |
| 1-Wire temps | 10–20 s | Holding 154–173 |
| Heat power/energy | 5–10 s | Holding 124–153 |

---

## 6.8 Full Register Summary

See the [WLD-521-R1 Modbus Register Table](#wld-521-r1-modbus-register-table) above (§4.3) for the complete FC02/FC03/FC05 map used by ESPHome YAML v0.2.0.

# 7. ESPHome Integration Guide

The WLD‑521‑R1 works seamlessly with **ESPHome** through the HomeMaster MiniPLC/MicroPLC, acting as a Modbus master. The module exposes all I/O and telemetry via **Modbus RTU**, which ESPHome maps into **entities** for Home Assistant.

---

## 7.1 ESPHome YAML Setup

Here is a typical ESPHome configuration that connects the controller to the WLD‑521‑R1 via RS‑485:

```yaml
uart:
  id: uart_modbus
  tx_pin: 17
  rx_pin: 16
  baud_rate: 19200
  parity: NONE
  stop_bits: 1

modbus:
  id: modbus_bus
  uart_id: uart_modbus
  turnaround_time: 100ms
  send_wait_time: 250ms

packages:
  wld1:
    url: https://github.com/isystemsautomation/homemaster-dev
    ref: main
    files:
      - path: WLD-521-R1/Firmware/v0.1.0/default_wld_521_r1_plc/default_wld_521_r1_plc.yaml
        vars:
          wld_prefix: "WLD#1"
          wld_id: wld_1
          wld_address: 4     # Match this with WebConfig address
    refresh: 1d
```

> **ESPHome 2026.7.0 raised the Modbus client defaults** — `turnaround_time` from
> 100 ms to 600 ms and `send_wait_time` from 250 ms to 2000 ms (PR #11969).
>
> At the 600 ms default the bus carries only about 1.5 Modbus transactions per
> second, whatever the UART speed, because the controller stays silent for 600 ms
> after every response. Two modules on one RS-485 bus become slow to respond.
> With three or more, one module can stop being polled altogether — with no
> timeout and no CRC error in the log.
>
> On ESPHome 2026.7.0 and newer, set both values explicitly as shown above.
> On earlier releases these were the defaults and the two lines are not required.

> Replace `wld_address` with your module's actual Modbus ID (default is `3`).  
> You can add more modules by duplicating the package block with unique `wld_id`, `wld_address`, and `wld_prefix`.

---

## 7.2 Exposed Entities (via ESPHome)

### Binary Sensors
- `DI1` to `DI5` — leak detection, float switch, or pulse edges
- Relay mirror (read-only)
- Buttons (`BTN1`–`BTN4`) — short press detection
- Irrigation: Zone state, sensor OK flags, window status

### Sensors
- Flow rate (L/min) and total (liters) per DI
- 1-Wire temperature probes (°C)
- ΔT, Power (W), Energy (Wh/kWh) for heat metering
- Irrigation: elapsed time, total liters, real-time flow

### Switches
- Relay 1 and Relay 2
- Optional: expose override toggles as separate switches
- Irrigation zone start/stop (via internal helpers or scripts)

---

## 7.3 Home Assistant Tips

- Use **ESPHome + Home Assistant integration** to auto-discover the controller and all WLD entities.
- In **ESPHome > Services**, call `esphome.device_name_switch.turn_on` for internal switches (like `Midnight pulse`).
- Create **automations**:
  - At `00:00`, pulse **coil 360** to reset daily irrigation state.
  - On leak detection (`DI1`=ON), turn on relay/siren and notify.
  - If `FlowX Rate` drops to 0 during irrigation, stop zone and alert.

### Suggested Cards
- **Entities card**: DI inputs, relays, override status
- **Gauge/Stat card**: Flow totals, ΔT, or Energy
- **History graph**: Flow rate, Irrigation status
- **Button card**: Zone Start/Stop via internal switch helpers

---

## 7.4 Troubleshooting

| Problem | Fix |
|---|-----|
| No entities show | Check RS‑485 wiring, A/B polarity, and COM ground |
| Coil writes fail | Make sure relay isn’t in override or owned by irrigation logic |
| Midnight reset missing | Add automation to pulse coil `360` nightly |
| Wrong DI naming | Use `wld_prefix` in `packages:` to namespace entities uniquely |
| Flow stuck at 0 | Confirm flow DI is in `Water counter` mode and receiving pulses |

---

## 7.5 Compatibility

| Platform | Status |
|---|---|
| **ESPHome 2025.8+** | ✅ Supported |
| **Home Assistant** | ✅ via ESPHome integration |
| **Multiple WLDs** | ✅ supported via multiple `packages:` |

> Always ensure the controller’s YAML uses the correct `uart`, `modbus`, and `wld_address`. One misalignment can break polling.

# 8. Programming & Customization

## 8.1 Supported Languages

- Arduino / C++
- MicroPython

## 8.2 Flashing via USB‑C

1. **Connect USB‑C** from PC to the module.
2. Enter **boot/flash mode** if required (see combinations below).
3. Upload the firmware (WebConfig uploader, PlatformIO, or Arduino IDE).

**Boot/Reset combinations (hardware):**
- **Buttons 1 + 2** → **BOOT** mode.
- **Buttons 3 + 4** → hardware **RESET**.

**Button numbering reference:**  
Front panel with button numbering U1..U4

## 8.3 Arduino / PlatformIO Notes

- **Board profile:** `Generic RP2350` (RP2 family, dual‑core)
- **Flash layout:** 2 MB total (**Sketch: 1 MB**, **FS: 1 MB**) — LittleFS for persistent config
- **Toolchains:** Arduino IDE 2.x or PlatformIO

**Required libraries (typical project):**
- `Arduino.h`
- `ModbusSerial.h`
- `SimpleWebSerial.h`
- `Arduino_JSON.h`
- `LittleFS.h`
- `OneWire.h`
- `hardware/watchdog.h`

Pin mapping follows the RP2350 schematic / GPIO layout.

## 8.4 Firmware Updates

1. Connect **USB‑C**.
2. Hold **Buttons 1 + 2** for **BOOT** mode if needed; **Buttons 3 + 4** for a hard reset.
3. Upload the binary from the module firmware folder (`Firmware/vX.Y.Z/`).
4. Configuration in LittleFS is retained across firmware upgrades when the layout is compatible. If a flash fails, enter BOOT mode and retry. WebConfig can restore defaults if settings are corrupted.

---

# 9. Maintenance & Troubleshooting

## 9.1 Status LED Meanings

| LED | Meaning |
|---|---|
| **PWR**  | Steady ON = power OK |
| **TX/RX**| Blink on RS‑485 activity |
| **USB**  | Lit when WebConfig is connected |
| **LED1–4** | Mapped per UI config (DI/Relay/Irrigation/Override) |

## 9.2 Reset Methods

- **Soft reset:** WebConfig → *Reset Device*
- **Hard reset:** hold **Buttons 3 + 4** for ~3 s
- **Bootloader:** hold **Buttons 1 + 2** while powering the device

## 9.3 Common Issues

| Symptom | Likely Cause → Fix |
|---|---|
| No Modbus comms | A/B swapped, missing **COM** reference, wrong baud/address |
| Relay won’t trigger | Relay in **override**, or **Owner** set to *None/Logic* |
| Flow stays 0 | DI not set to *Water counter*, wrong PPL, no pulses |
| 1‑Wire not found | Wiring to +5V/D/GND, long bus, or pull‑up issue |
| WebConfig not connecting | Use a Chromium-based browser (not Safari/stable Firefox); close other serial apps; try new cable/port |

---

# 10. Open Source & Licensing

Licensing

This project uses a hybrid licensing model.

Hardware

Hardware designs (schematics, PCB layouts, BOMs) are licensed under:
CERN-OHL-W v2

Firmware & ESPHome Integration

All firmware, ESPHome configurations, and software components are licensed under:
MIT License

This ensures full compatibility with ESPHome and Home Assistant while protecting hardware designs.

See LICENSE files in each directory for full terms.

---

# 11. Downloads

- **Firmware binaries** — `Firmware/v0.1.0/default_wld-521-r1/`
- **ESPHome YAML configs** — `Firmware/v0.1.0/default_wld_521_r1_plc/`
- **WebConfig Tool** — `Firmware/v0.1.0/ConfigToolPage.html`
- **Schematics** — `Schematics/WLD-521-R1-FieldBoard.pdf`, `Schematics/WLD-521-R1-MCUBoard.pdf`
- **Images & diagrams** — `Images/`
- **Datasheet** — `Manuals/WLD-521-R1 Datasheet.pdf`

---

# 12. Support

- **Support Portal:** https://www.home-master.eu/support
- **WebConfig:** https://config.home-master.eu/WLD-521-R1/Firmware/v0.1.0/ConfigToolPage.html
- **YouTube:** https://youtube.com/@HomeMaster
- **Hackster:** https://hackster.io/homemaster
- **Reddit:** https://reddit.com/r/HomeMaster
- **Instagram:** https://instagram.com/home_master.eu

## Compliance & Certifications

The WLD-521-R1 module is CE marked. **ISYSTEMS AUTOMATION S.R.L.** (HomeMaster® brand)
maintains the technical documentation and a signed EU Declaration of Conformity (DoC).

### Applicable EU directives

- **EMC Directive 2014/30/EU** — EN 55032:2015 + AC:2016-07 + A11:2020 + A1:2020 (Class B emissions),
  EN 55035:2017 + A11:2020 (immunity); tested by Idvorsky Laboratories Ltd., Belgrade, Serbia
  (Job #1648, 20 April 2026)
- **Low Voltage Directive 2014/35/EU** — EN 62368-1:2020 + A11:2020; in-house dielectric and isolation
  test by ISYSTEMS AUTOMATION S.R.L. internal compliance laboratory
- **RoHS Directive 2011/65/EU** — EN IEC 63000 technical documentation

### Compliance documents

| Document | File |
|---|---|
| EU Declaration of Conformity (DoC) | [DoC_WLD-521-R1.pdf](https://config.home-master.eu/WLD-521-R1/Manuals/DoC_WLD-521-R1.pdf) |
| Datasheet | [WLD-521-R1_Datasheet.pdf](https://config.home-master.eu/WLD-521-R1/Manuals/WLD-521-R1_Datasheet.pdf) |

### Trademark

**HomeMaster®** is a registered European Union trademark of ISYSTEMS AUTOMATION S.R.L.,
EUTM No. 019082911, registered with EUIPO on 15 January 2025.

---

**Manufacturer:** ISYSTEMS AUTOMATION S.R.L. (HomeMaster® brand)
**Registered office (registered office):** Str. Domnisori, Nr. 81, Bl. 62, Scara A, Etaj 3, Ap. 12, 100284 Ploiesti, Jud. Prahova, Romania
**Office / Contact address:** Diligentei 18, Ploiesti, Romania
**CUI / VAT:** RO 21537032
**EUID:** ROONRC.J2007000919293
**Telephone:** +40 747 757 798
**Website:** [https://www.home-master.eu](https://www.home-master.eu)
