isystemsautomation/homemaster-dev/OpenthermThermostat/Schematics/README.md

# Schematics

Filenames referenced elsewhere in the repository. Use exactly these names.

| File | Referenced by |
|---|---|
| `MCUBoard.pdf` | `site/thermostat_card.html` |
| `LCDBoard.pdf` | `site/thermostat_card.html` |

Export from KiCad as PDF, one file per board.

The product README and the ESPHome device page link to this folder rather than
to individual files, so adding or renaming a board export does not break them.
