isystemsautomation/homemaster-dev/OpenthermThermostat/Images/README.md

# Images

Filenames referenced elsewhere in the repository. Use exactly these names.

| File | What it shows |
|---|---|
| `thermostat-front.jpg` | Front, screen on. Hero image in the README, the device page and the site card |
| `thermostat-front-off.jpg` | Front, screen off |
| `thermostat-angle.jpg` | Three-quarter view, screen on |
| `thermostat-angle-2.jpg` | Three-quarter view, screen off |
| `thermostat-angle-3.jpg` | Three-quarter view from below, screen off |
| `thermostat-side.jpg` | Side profile |
| `thermostat-back.jpg` | Wall plate |

Full-size photographs. Do not recompress them.
