isystemsautomation/homemaster-dev/AIO-422-R1/Firmware/v0.2.0/default_aio_422_r1/README.md

# Firmware `default_aio_422_r1`

Arduino sketch for the **AIO-422-R1** module (RP2350).

**Full guide** (Arduino IDE, RP2350 board package, libraries, build, upload, WebConfig):

→ **[../../README.md](../../README.md)**
