isystemsautomation/homemaster-dev/partner-kit/README.md

# HomeMaster partner kit

Public marketing and compliance assets for authorised resellers of HomeMaster® DIN-rail modules. No prices or stock status are included.

Version **2026.09** — see [CHANGELOG.md](./CHANGELOG.md). Full download: [homemaster-partner-kit-2026.09.zip](./homemaster-partner-kit-2026.09.zip).

## Audience

Shop operators and integrators who resell genuine HomeMaster hardware and need ready-made listing text, images and compliance PDFs.

## Contents

- `index.csv` — product codes, GTIN, MPN and canonical shop URLs
- `<MODULE>/description-short.md` — card listing text (40–60 words)
- `<MODULE>/description-long.md` — extended product description (250–350 words)
- `<MODULE>/specs.csv` — flat specification table for shop import
- `<MODULE>/images/` — WebP product photography and diagrams
- `<MODULE>/doc/` — EU Declaration of Conformity, datasheet and user manual (where available)
- `claims-notice.md` — binding limits on public statements

### Listing images

Slots `02-listing-1`, `03-listing-2` and `04-listing-3` for modules that use `mplisting*.png` are **shared line marketing images**, not photographs of the specific module in that folder. RGB-621-R1 and DIM-420-R1 use alternate sources for slots 02 and 03; slot 04 is omitted where no suitable file exists.

## Usage rules

- Materials may be used to market and resell genuine HomeMaster® modules.
- **HomeMaster®** is a registered EU trade mark (EUTM 019082911). Use it only to identify the product — not in your store name, domain or logo.
- Do not recolour product images, alter branding or imply UL, CSA or FCC certification.
- Do not use the phrase “Works with Home Assistant”. Integration may be described as “works with Home Assistant via ESPHome” where applicable.
- **Made for ESPHome** may be stated only for MiniPLC and OpenTherm Gateway.
- Rewriting descriptions in your own words is recommended so your listing does not compete directly with home-master.eu in search results.
- CE marking statements refer to the EU Declaration of Conformity supplied in `doc/`.

## Image map

### MiniPLC
- `Images/miniplc_1600x1600.png` → `images/01-main.webp`
- `Images/mplisting1.png` → `images/02-listing-1.webp`
- `Images/mplisting2.png` → `images/03-listing-2.webp`
- `Images/mplisting3.png` → `images/04-listing-3.webp`
- `Images/dimension.png` → `images/06-dimensions.webp`
- `system_block_diagram.png` → `images/07-block-diagram.webp`

### MicroPLC
- `Images/microplc_1600x1600.png` → `images/01-main.webp`
- `Images/mplisting1_1.png` → `images/02-listing-1.webp`
- `Images/mplisting2_1.png` → `images/03-listing-2.webp`
- `Images/mplisting3_1.png` → `images/04-listing-3.webp`
- `Images/dimensions.png` → `images/06-dimensions.webp`
- `Images/diagram.png` → `images/07-block-diagram.webp`

### OpenthermGateway
- `Images/opentherm_render.png` → `images/01-main.webp`
- `Images/mplisting1.png` → `images/02-listing-1.webp`
- `Images/mplisting2.png` → `images/03-listing-2.webp`
- `Images/mplisting3.png` → `images/04-listing-3.webp`
- `Images/OTGWDimensions.png` → `images/06-dimensions.webp`
- `Images/OpenTherm_SystemBlock.png` → `images/07-block-diagram.webp`
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
