isystemsautomation/homemaster-dev/_shared/brand/homemaster-mark.png

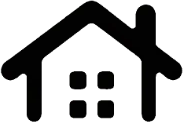
_shared/brand/homemaster-mark.png
