isystemsautomation/homemaster-dev/AIO-422-R1/Images/AIO_1600x1600.png

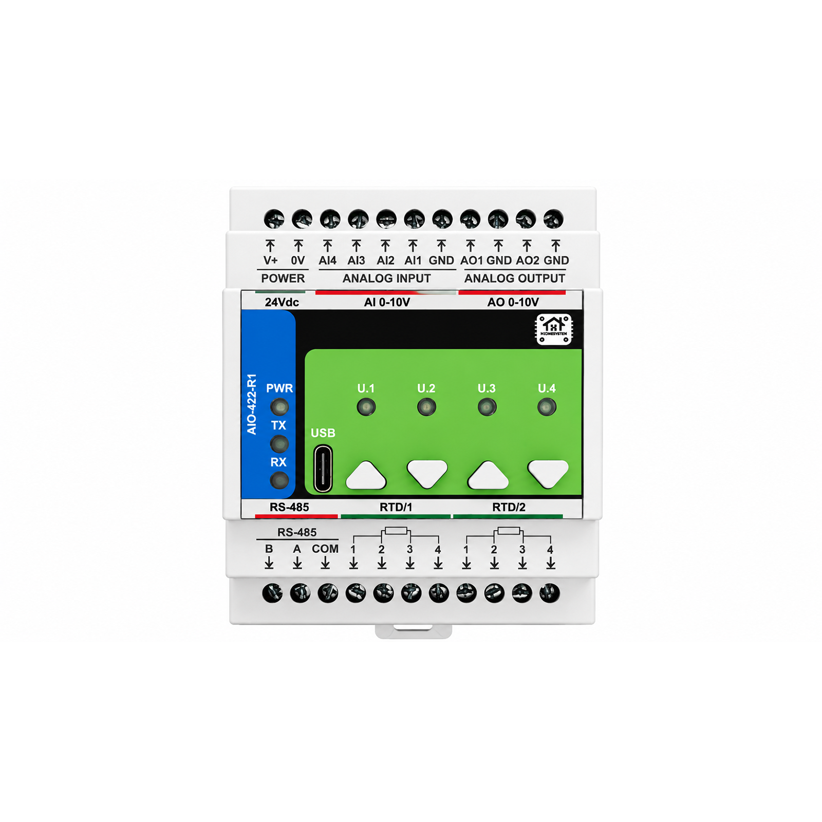
AIO-422-R1/Images/AIO_1600x1600.png
