isystemsautomation/homemaster-dev/AIO-422-R1/Images/AIO_site.png

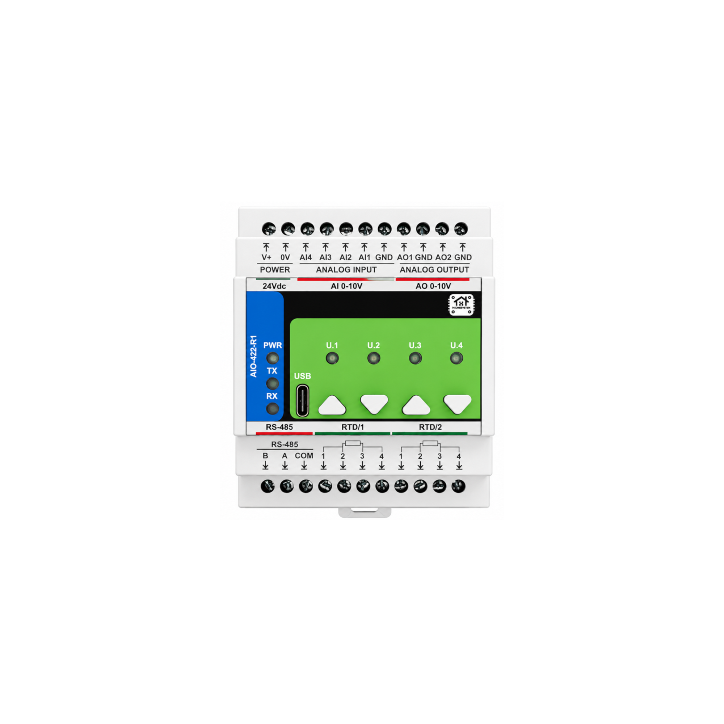
AIO-422-R1/Images/AIO_site.png
