isystemsautomation/homemaster-dev/AIO-422-R1/Images/Dimensions.png

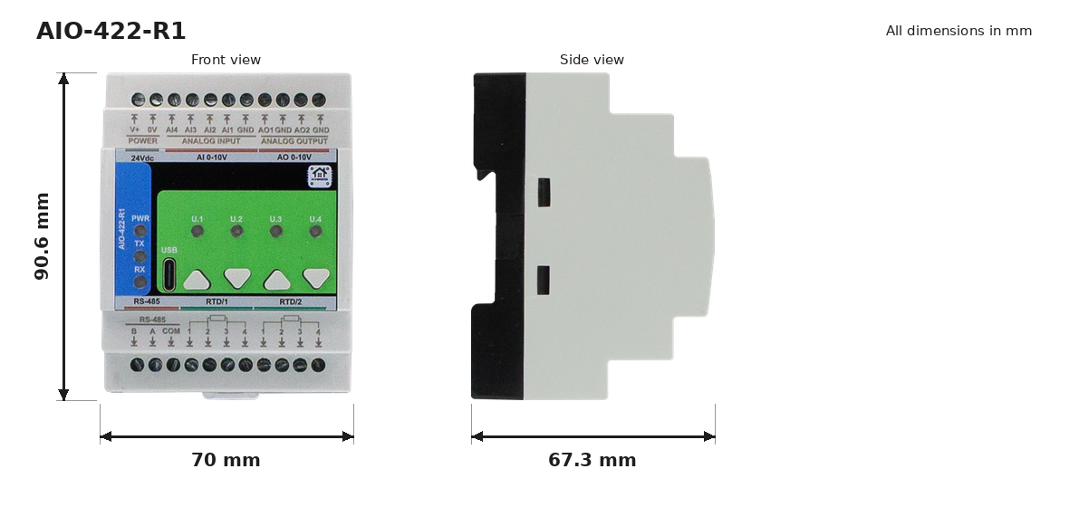
AIO-422-R1/Images/Dimensions.png
