isystemsautomation/homemaster-dev/AIO-422-R1/Images/mplisting1.png

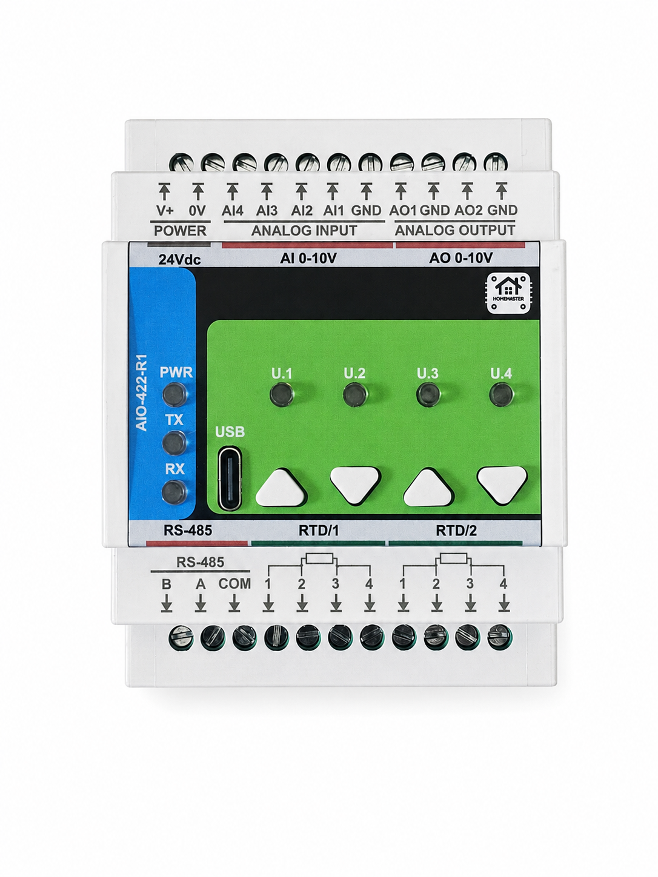
AIO-422-R1/Images/mplisting1.png
