isystemsautomation/homemaster-dev/AIO-422-R1/Images/mplisting2.png

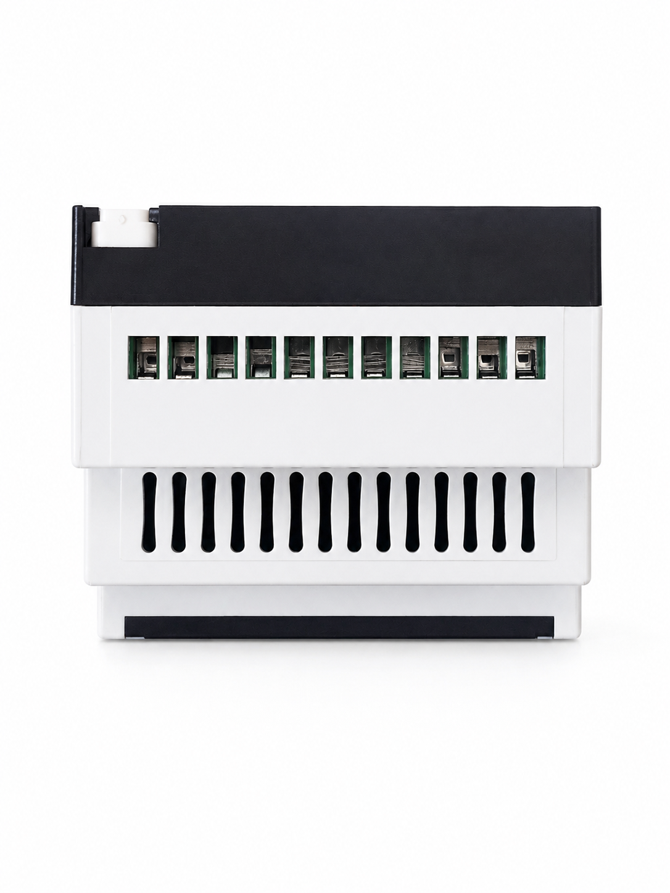
AIO-422-R1/Images/mplisting2.png
