isystemsautomation/homemaster-dev/AIO-422-R1/Images/package1.png

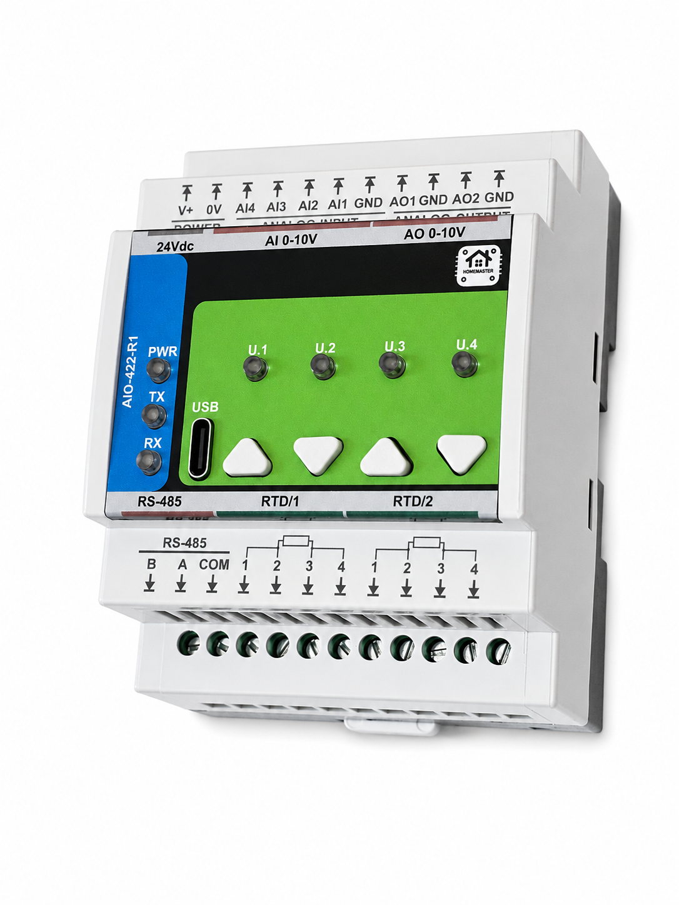
AIO-422-R1/Images/package1.png
