isystemsautomation/homemaster-dev/AIO-422-R1/Images/photo1_512kb.png

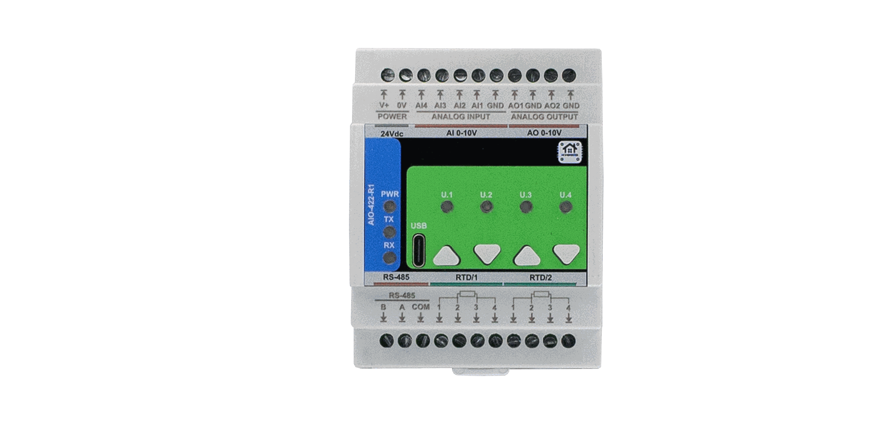
AIO-422-R1/Images/photo1_512kb.png
