isystemsautomation/homemaster-dev/AIO-422-R1/Images/webconfig1.png

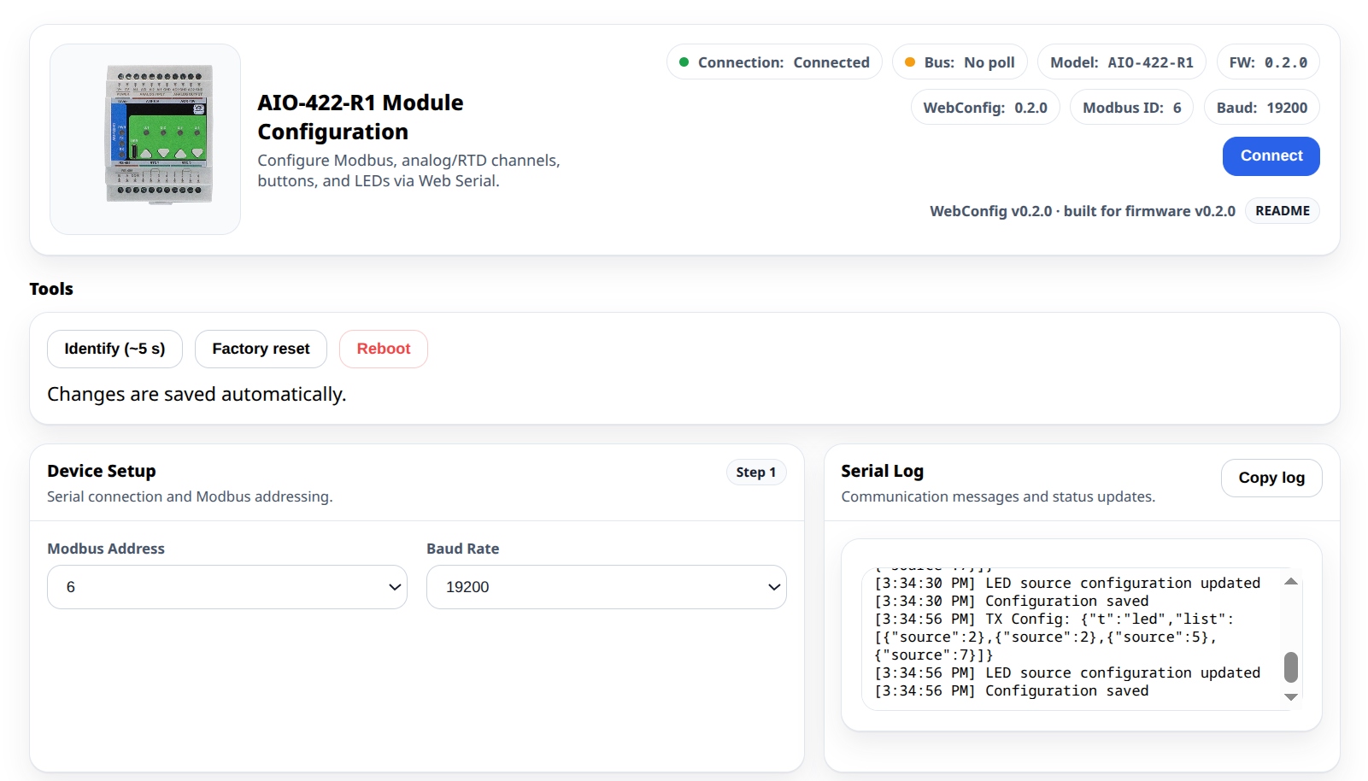
AIO-422-R1/Images/webconfig1.png
