isystemsautomation/homemaster-dev/AIO-422-R1/Images/webconfig2.png

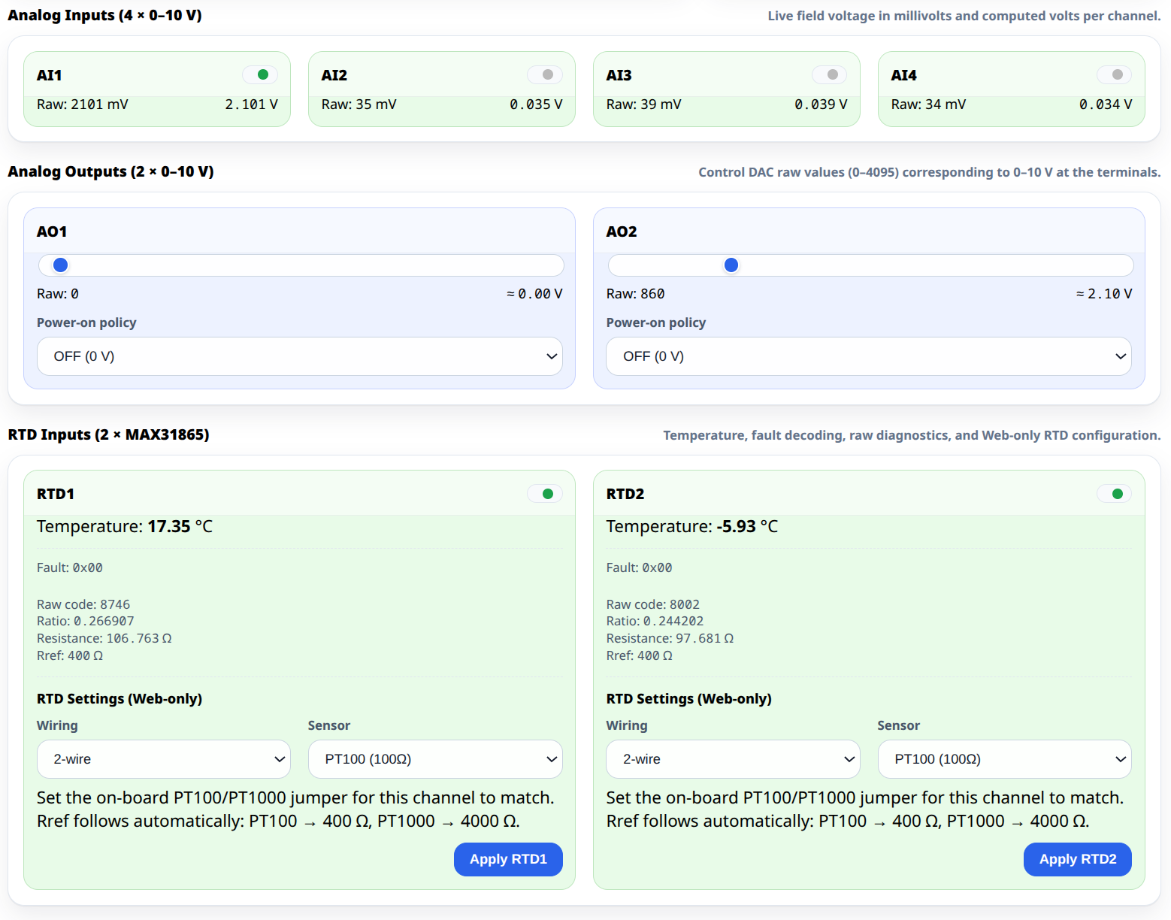
AIO-422-R1/Images/webconfig2.png
