isystemsautomation/homemaster-dev/AIO-422-R1/Images/webconfig3.png

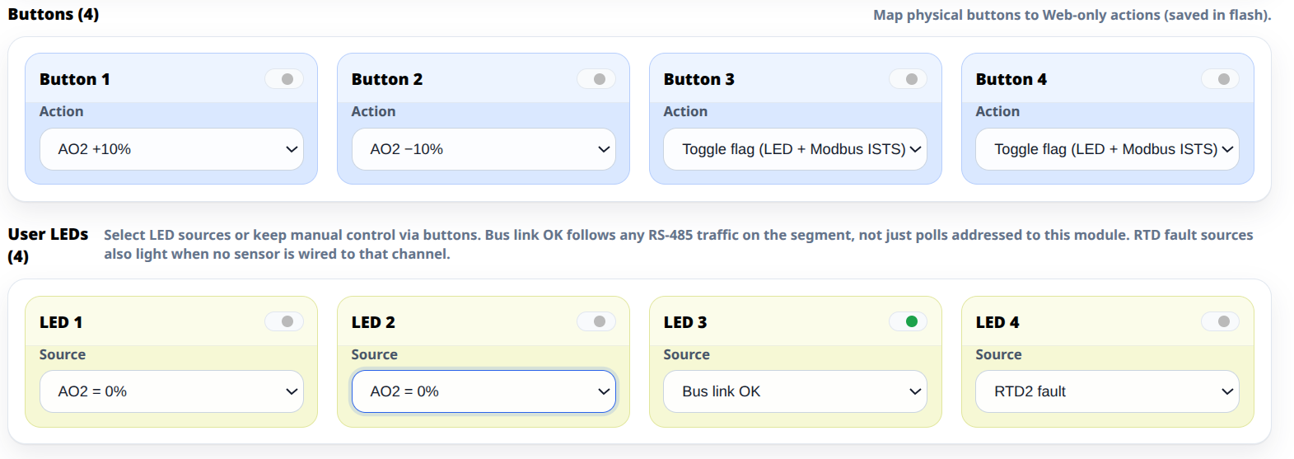
AIO-422-R1/Images/webconfig3.png
