isystemsautomation/homemaster-dev/ALM-173-R1/Images/ALM_2000x2000.png

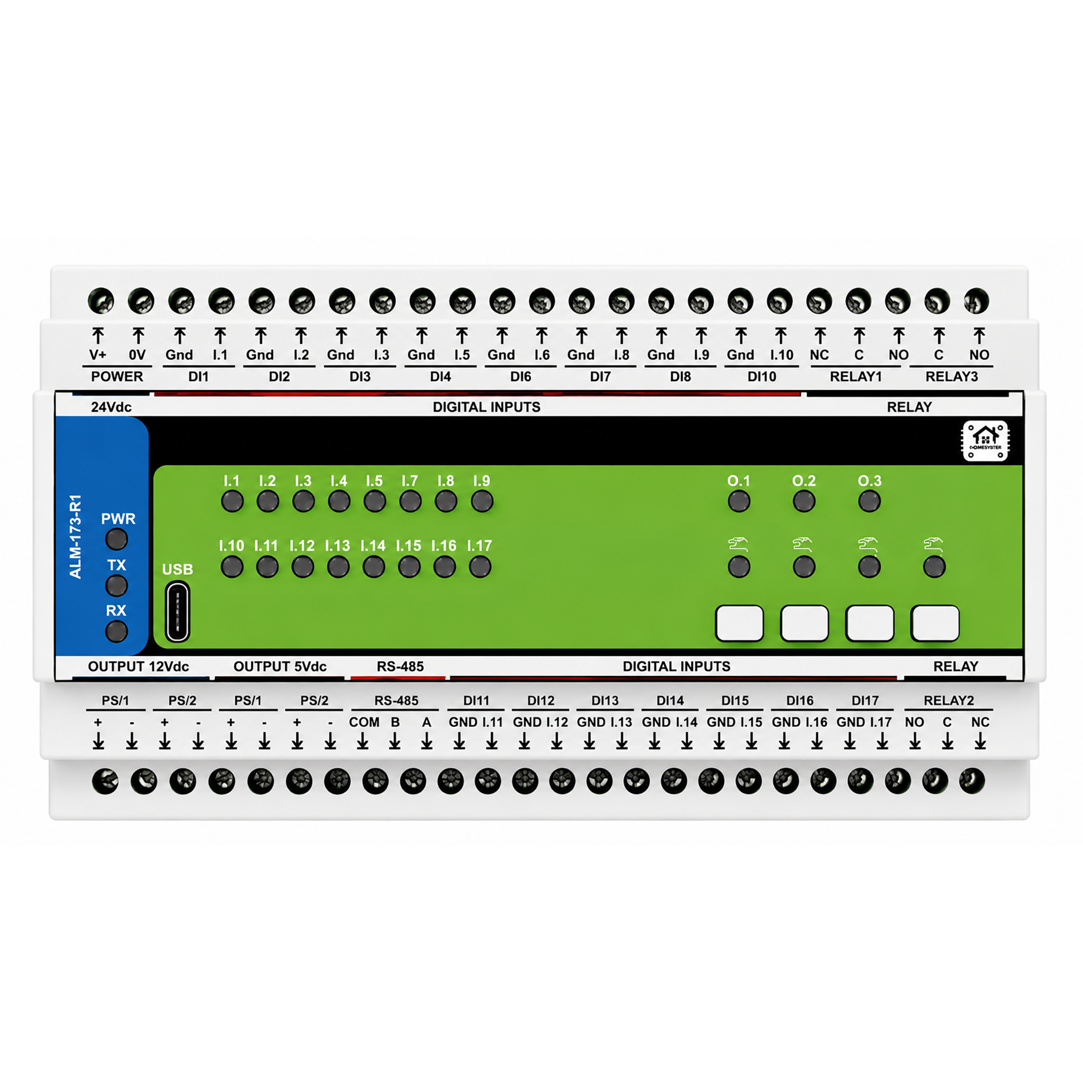
ALM-173-R1/Images/ALM_2000x2000.png
