isystemsautomation/homemaster-dev/ALM-173-R1/Images/ALM_site.png

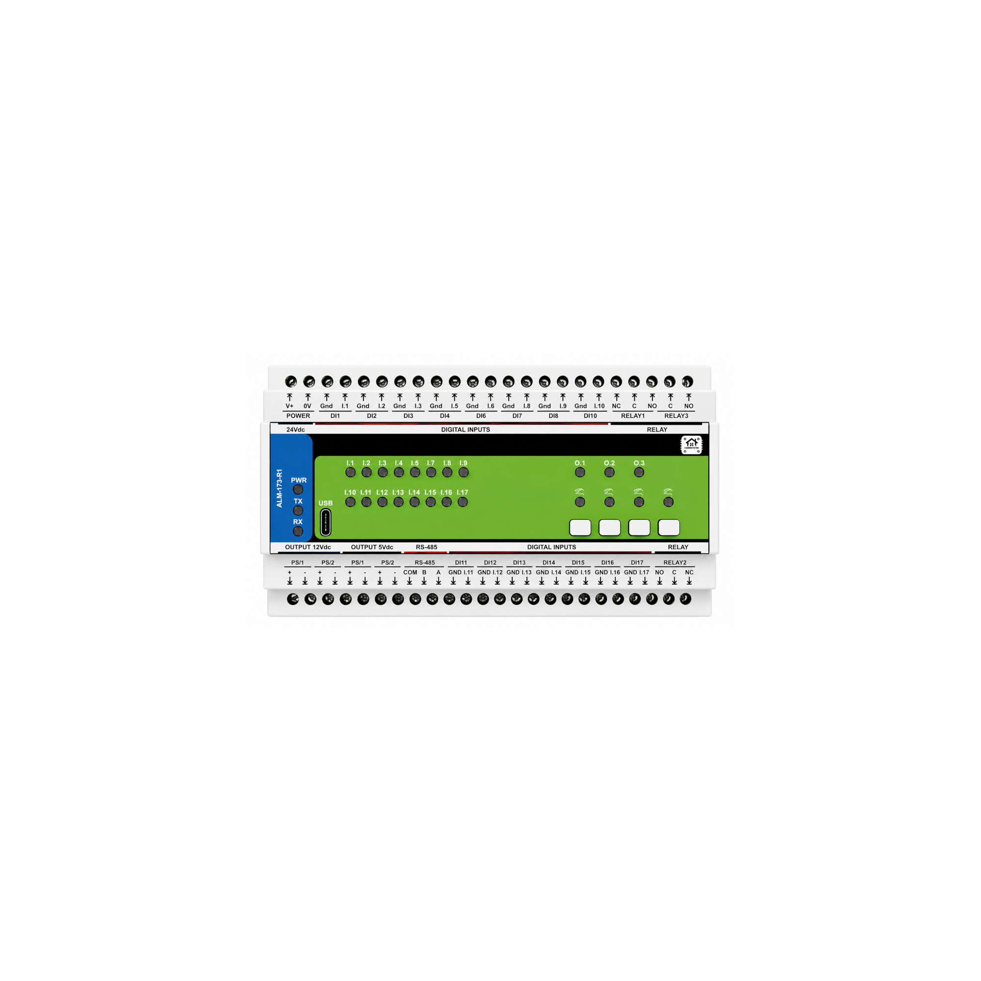
ALM-173-R1/Images/ALM_site.png
