isystemsautomation/homemaster-dev/ALM-173-R1/Images/ALMMDimensions.png

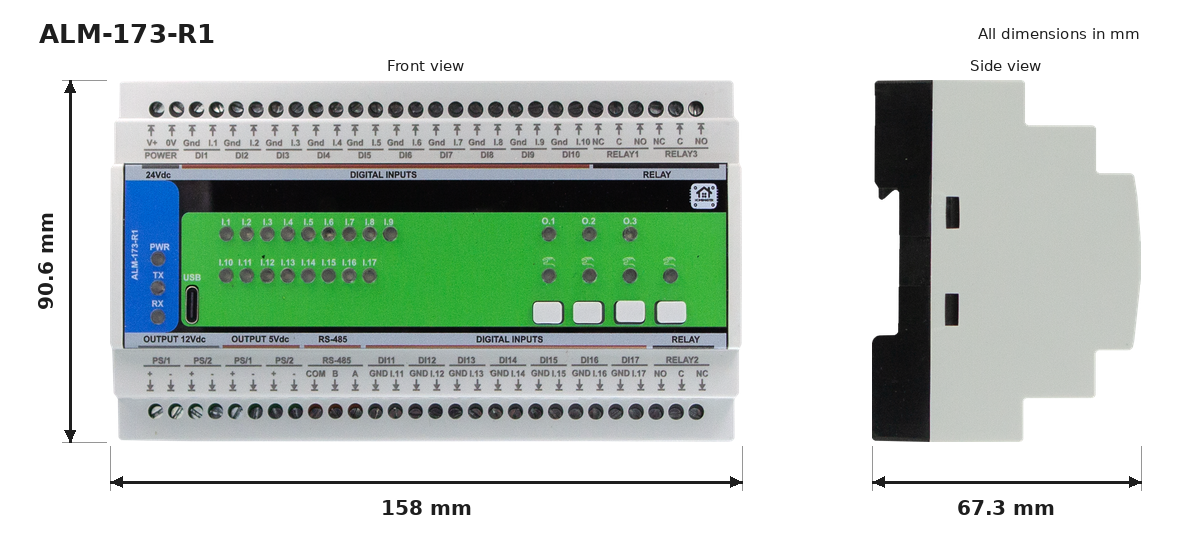
ALM-173-R1/Images/ALMMDimensions.png
