isystemsautomation/homemaster-dev/ALM-173-R1/Images/mplisting1.png

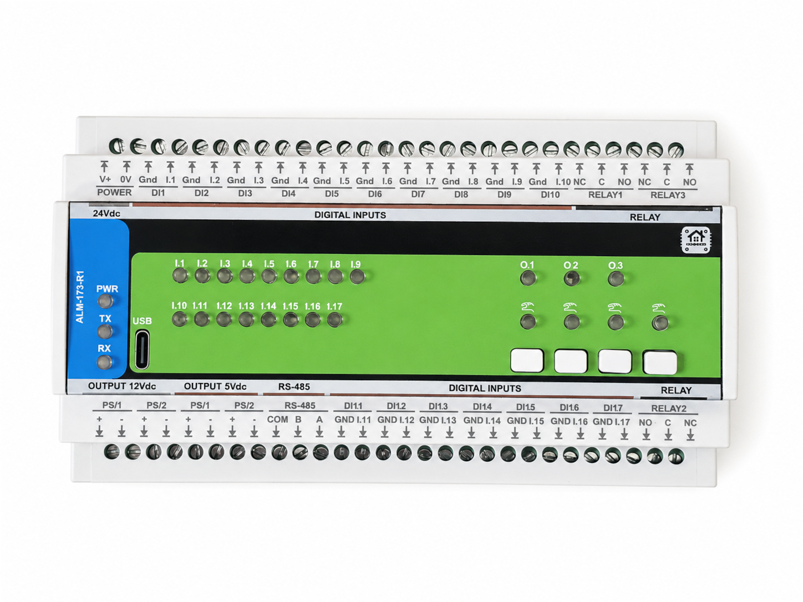
ALM-173-R1/Images/mplisting1.png
