isystemsautomation/homemaster-dev/ALM-173-R1/Images/mplisting2.png

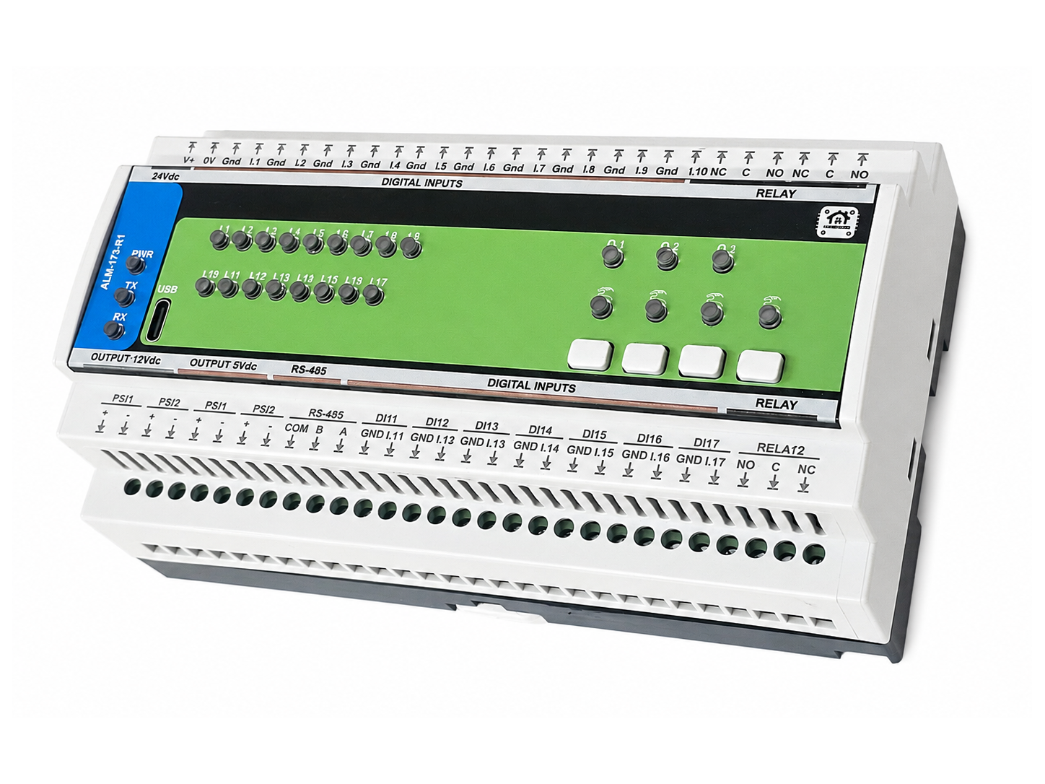
ALM-173-R1/Images/mplisting2.png
