isystemsautomation/homemaster-dev/ALM-173-R1/Images/mplisting3.png

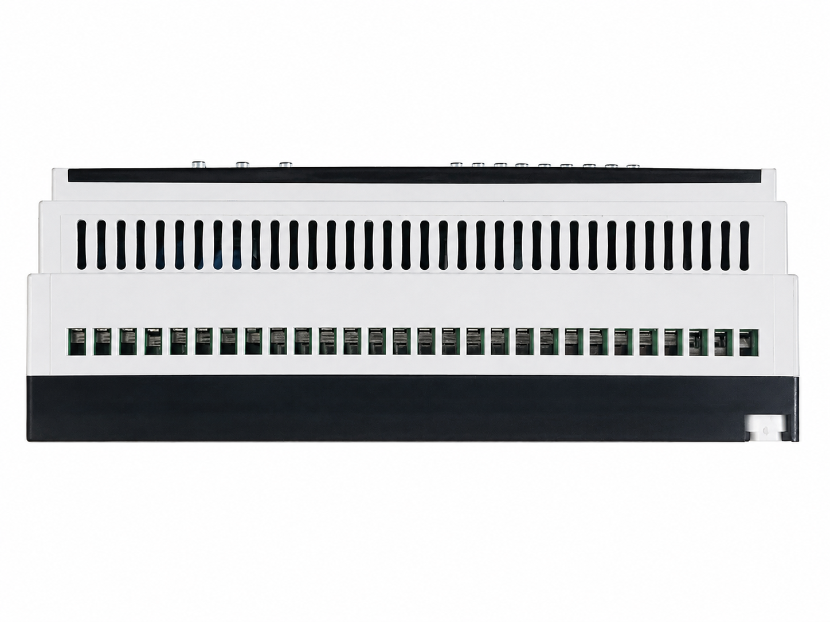
ALM-173-R1/Images/mplisting3.png
