isystemsautomation/homemaster-dev/ALM-173-R1/Images/photo1_512kb.png

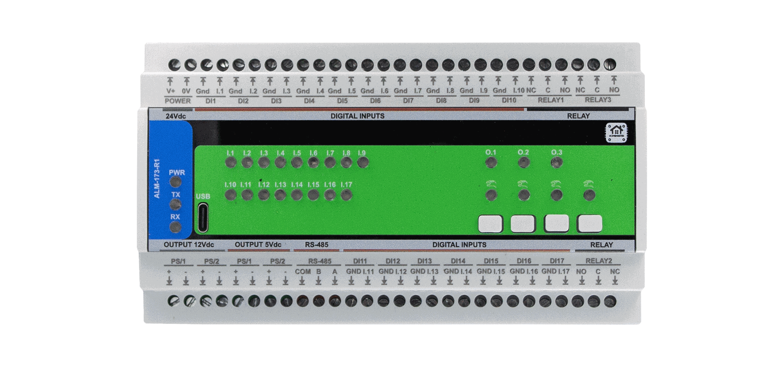
ALM-173-R1/Images/photo1_512kb.png
