isystemsautomation/homemaster-dev/ALM-173-R1/Images/webconfig1.png

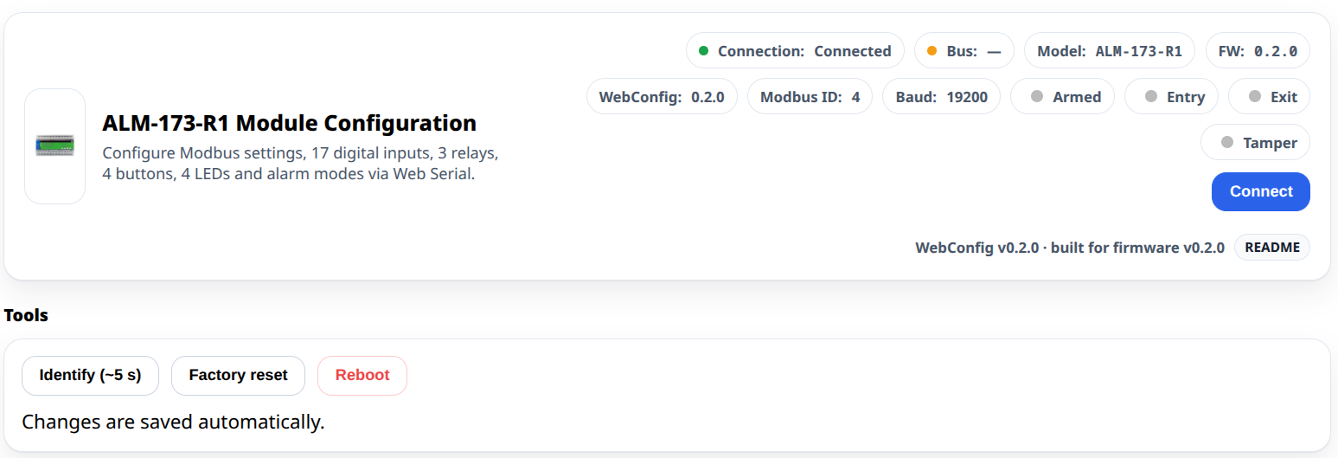
ALM-173-R1/Images/webconfig1.png
