isystemsautomation/homemaster-dev/ALM-173-R1/Images/webconfig2.png

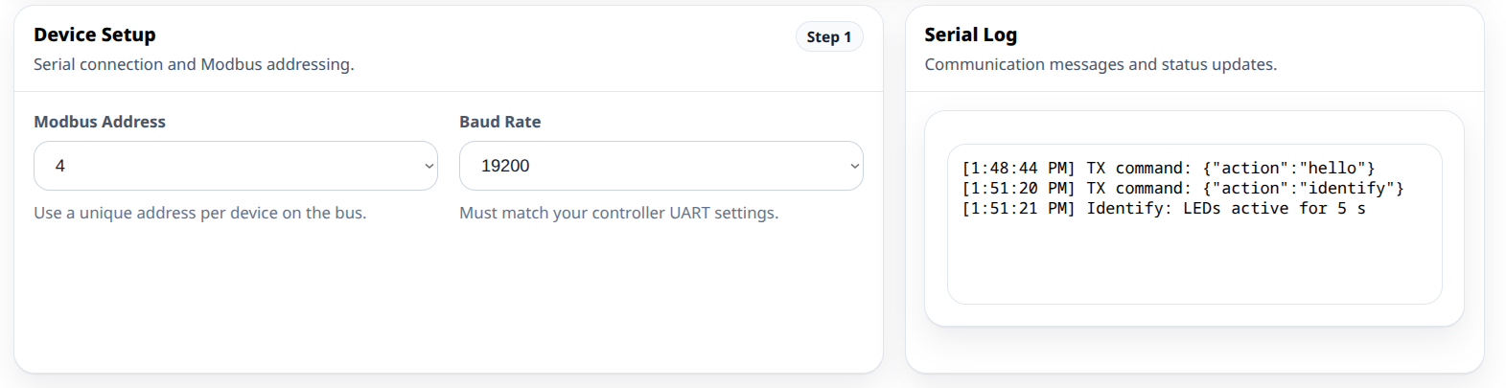
ALM-173-R1/Images/webconfig2.png
