isystemsautomation/homemaster-dev/ALM-173-R1/Images/webconfig3.png

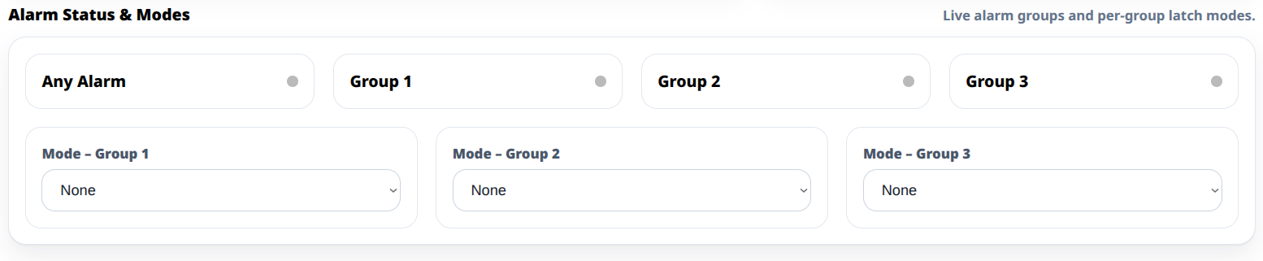
ALM-173-R1/Images/webconfig3.png
