isystemsautomation/homemaster-dev/ALM-173-R1/Images/webconfig4.png

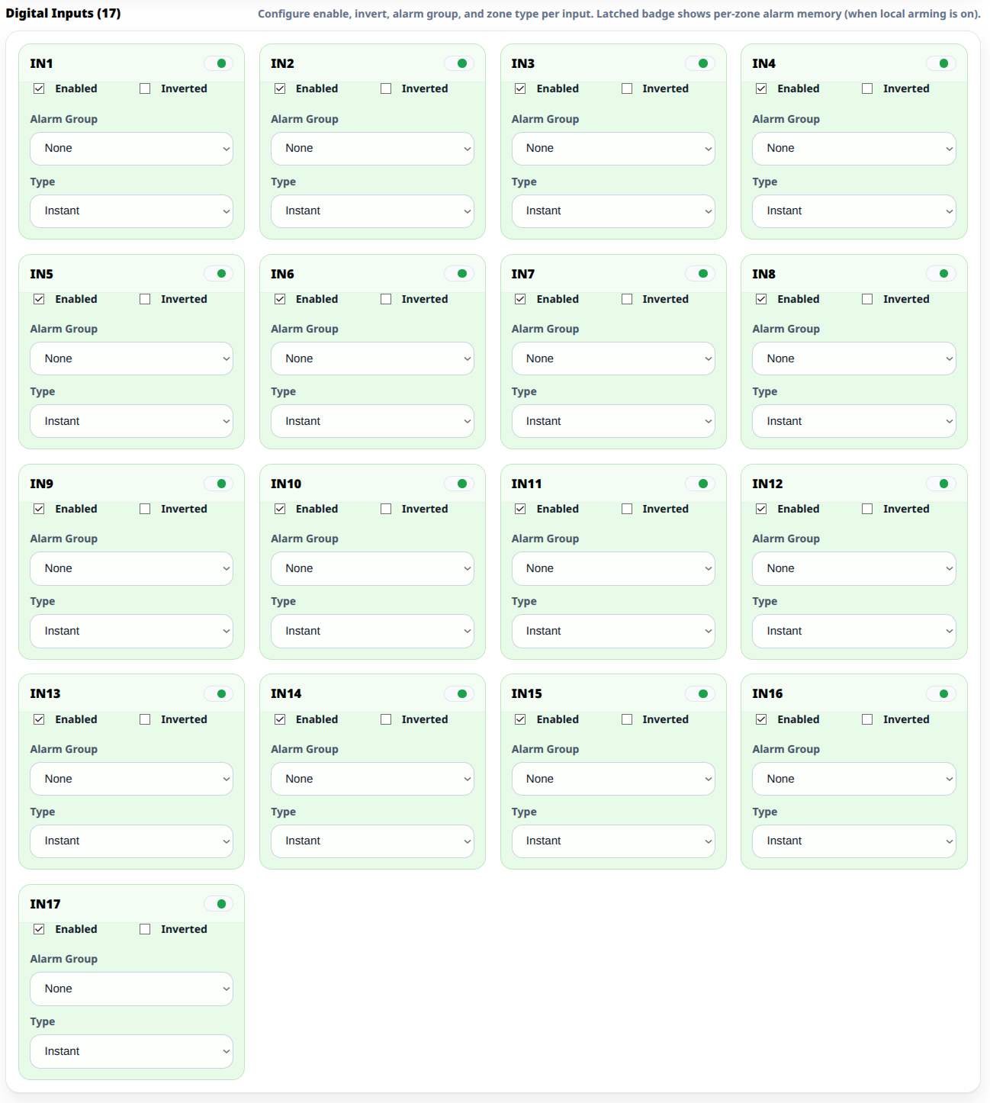
ALM-173-R1/Images/webconfig4.png
