isystemsautomation/homemaster-dev/ALM-173-R1/Images/webconfig5.png

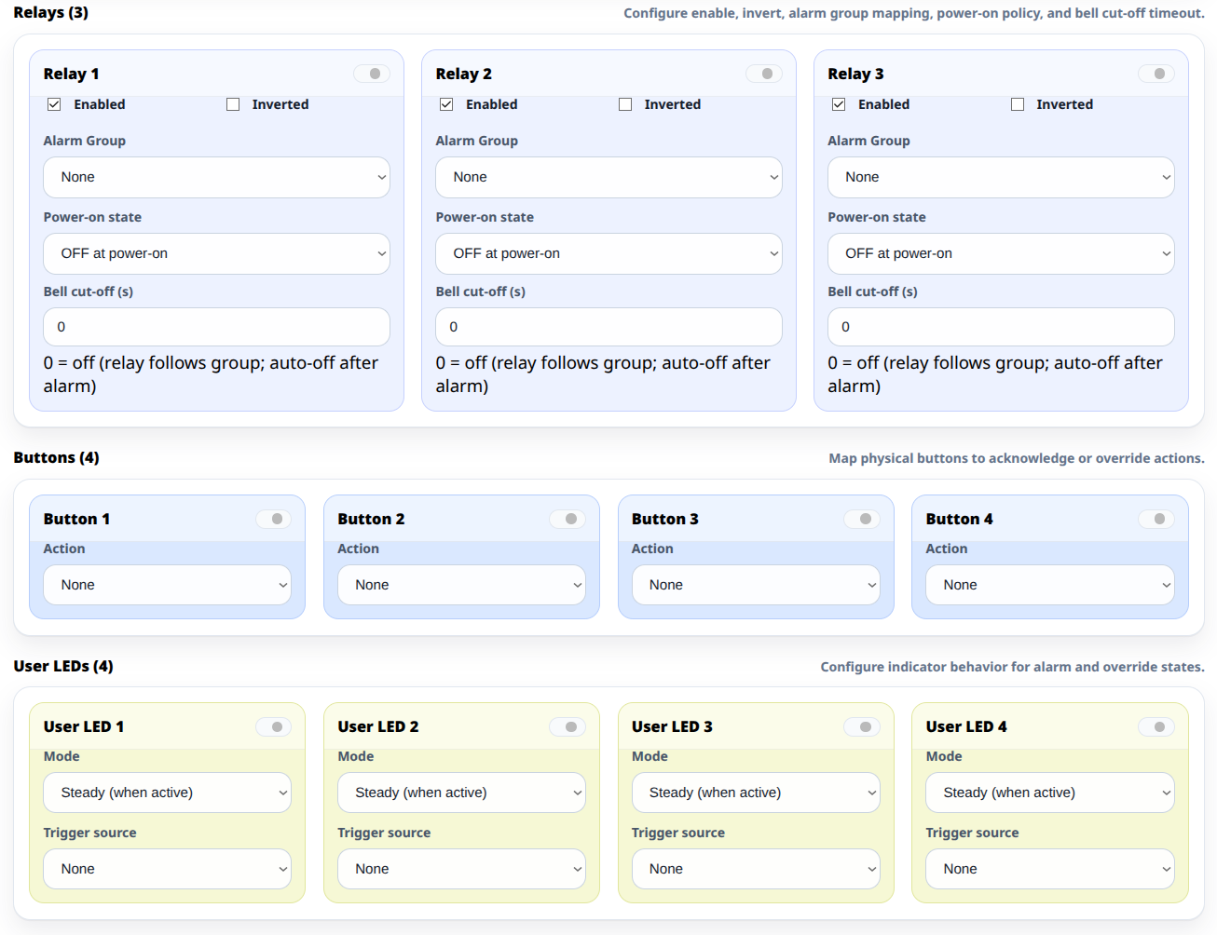
ALM-173-R1/Images/webconfig5.png
