isystemsautomation/homemaster-dev/articles/emc_lvd_red_compliance/photo1.png

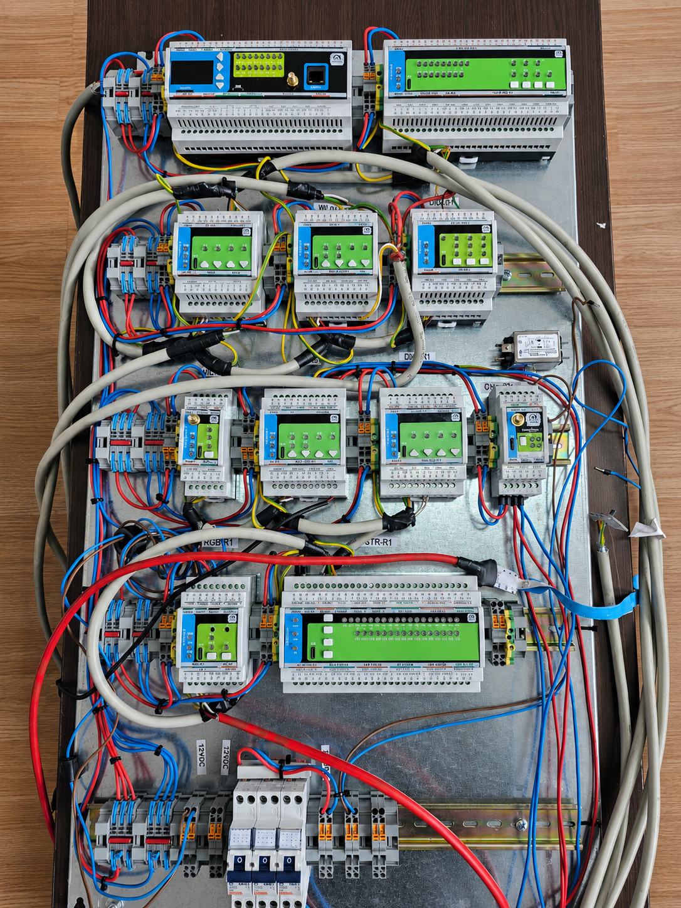
articles/emc_lvd_red_compliance/photo1.png
