isystemsautomation/homemaster-dev/articles/emc_lvd_red_compliance/photo2.png

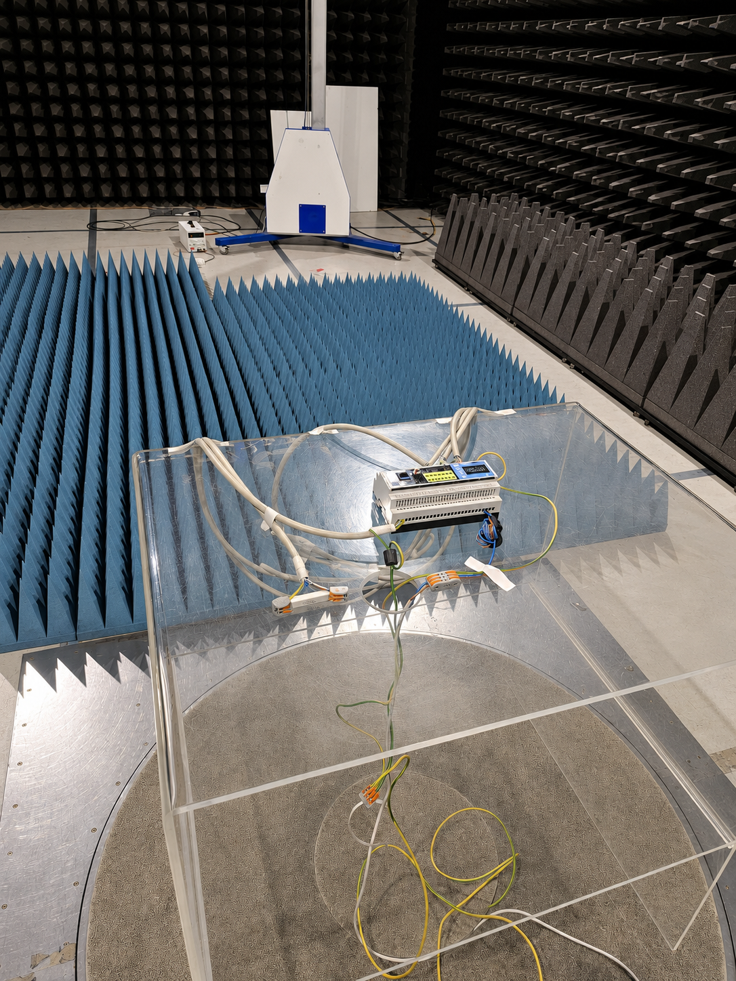
articles/emc_lvd_red_compliance/photo2.png
