isystemsautomation/homemaster-dev/articles/emc_lvd_red_compliance/photo3.png

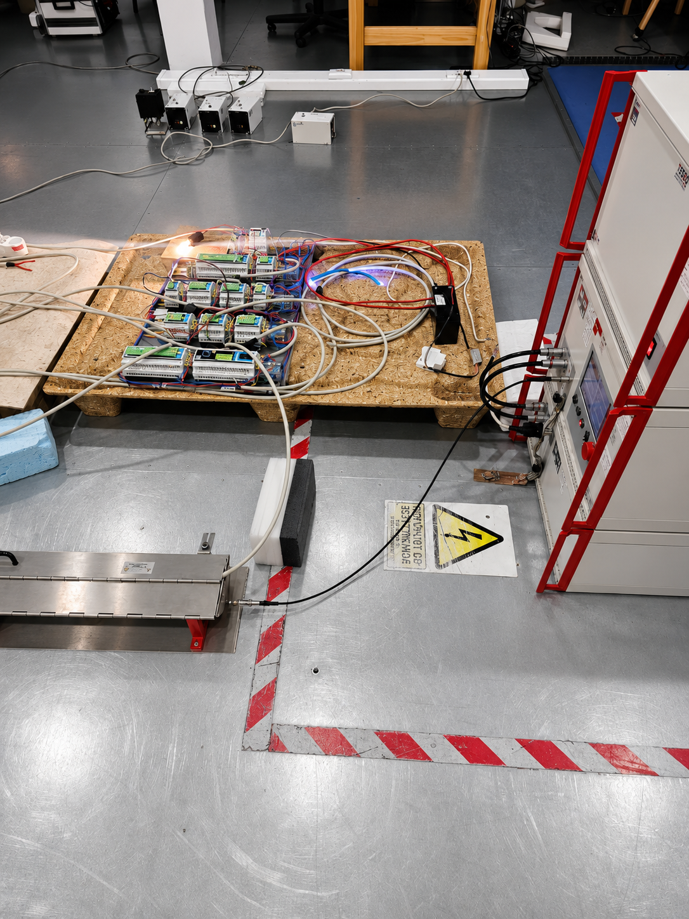
articles/emc_lvd_red_compliance/photo3.png
