isystemsautomation/homemaster-dev/articles/esphome-opentherm-home-assistant/fig-1.png

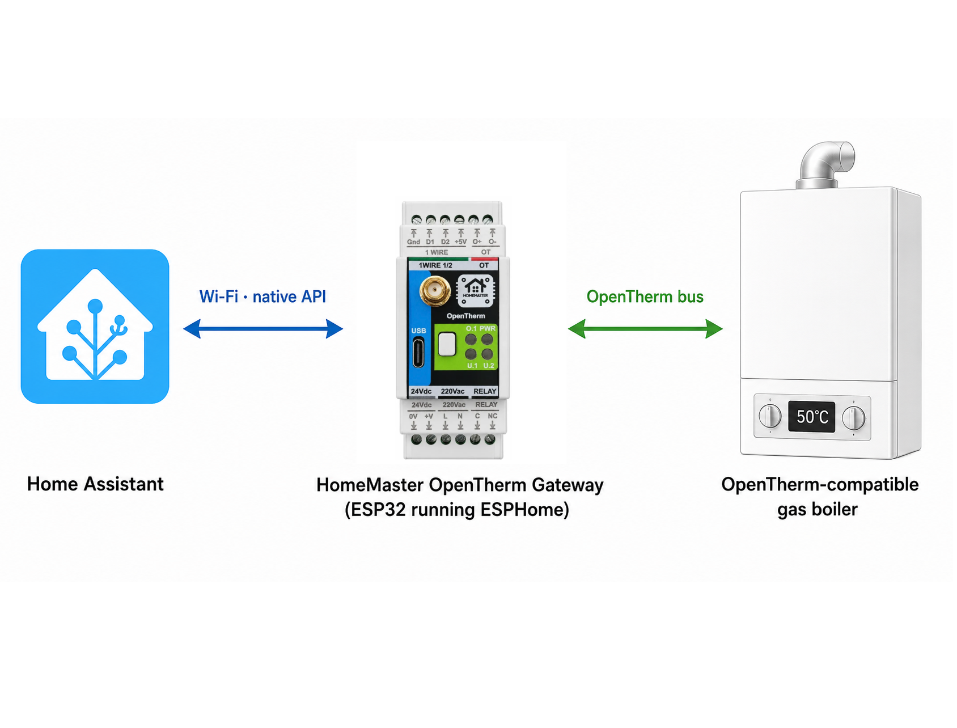
articles/esphome-opentherm-home-assistant/fig-1.png
