isystemsautomation/homemaster-dev/articles/multi-circuit-din-rail-energy-meter-home-assistant/fig-1.png

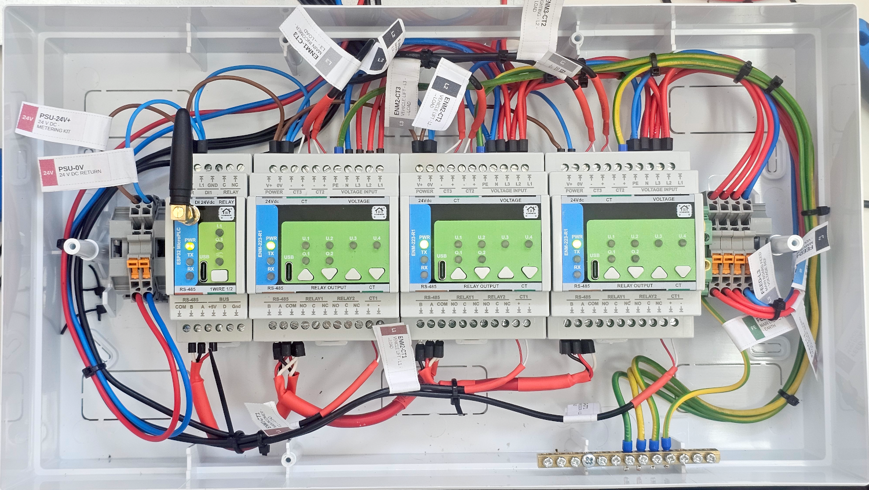
articles/multi-circuit-din-rail-energy-meter-home-assistant/fig-1.png
