isystemsautomation/homemaster-dev/articles/opentherm-short-cycling-boiler-minimum-output/fig-1.png

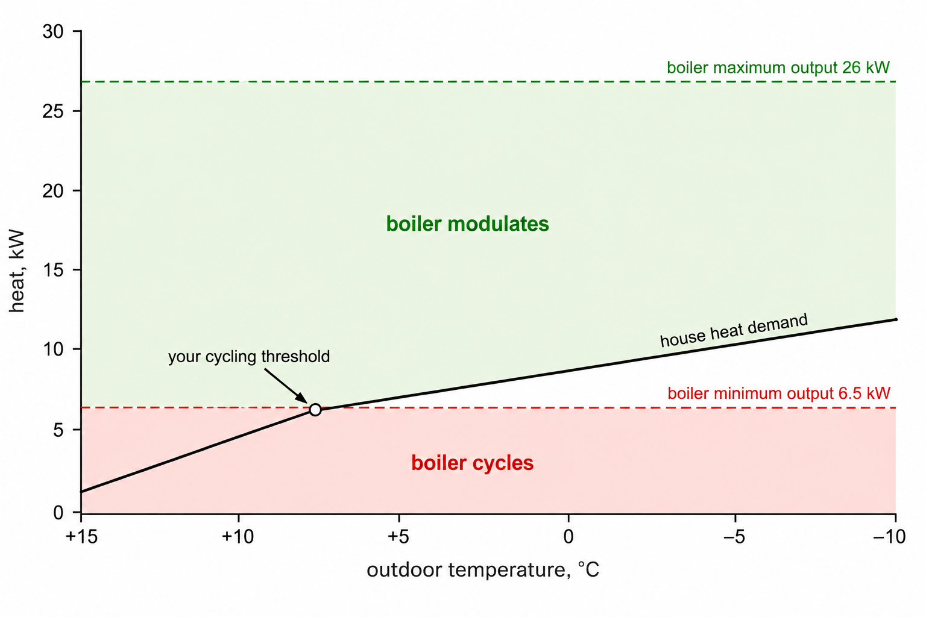
articles/opentherm-short-cycling-boiler-minimum-output/fig-1.png
