isystemsautomation/homemaster-dev/articles/opentherm_weather/ha_opentherm1.png

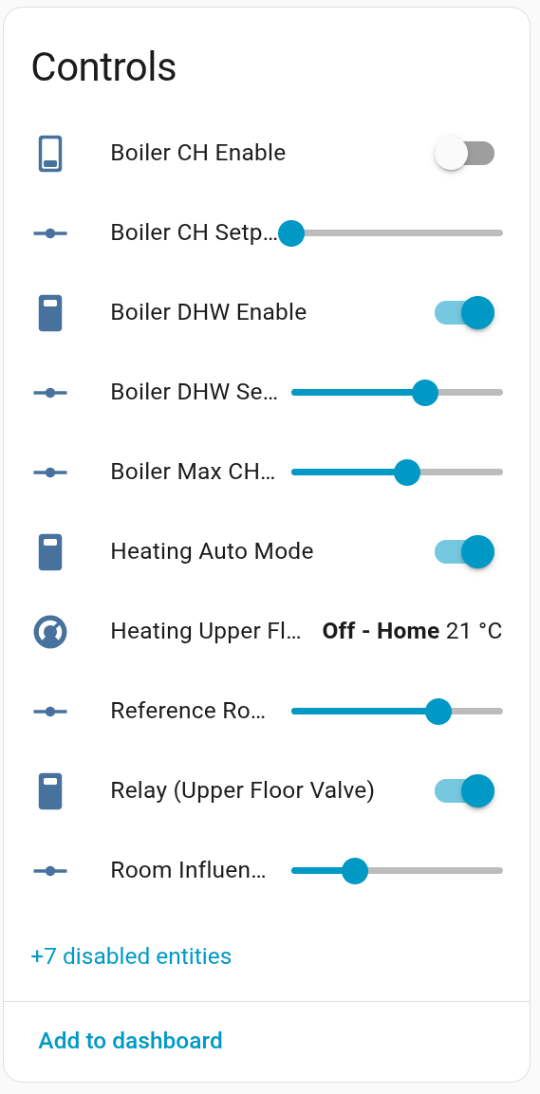
articles/opentherm_weather/ha_opentherm1.png
