isystemsautomation/homemaster-dev/articles/opentherm_weather/ha_opentherm2.png

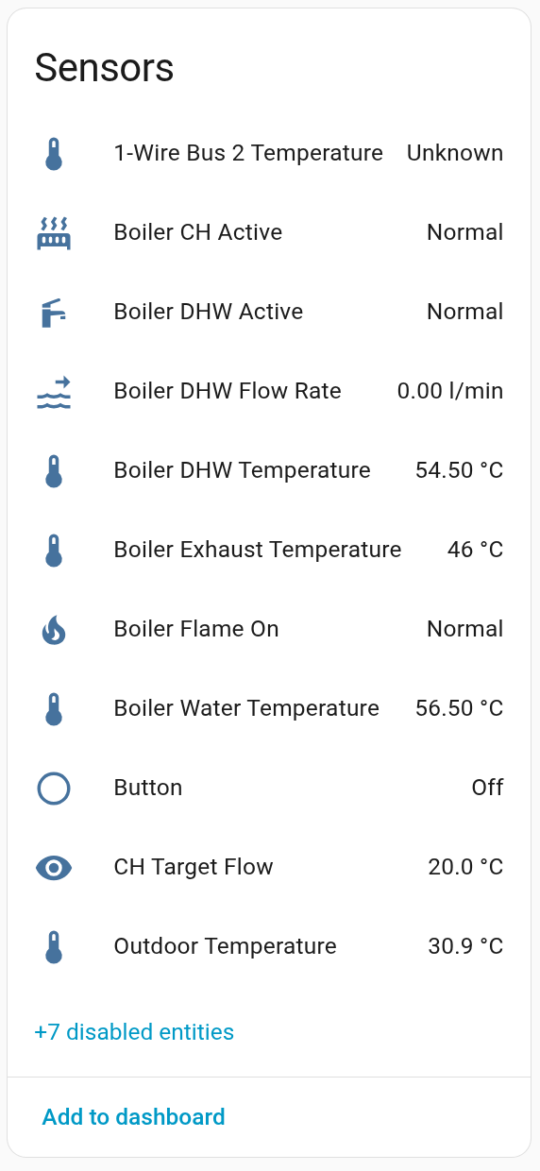
articles/opentherm_weather/ha_opentherm2.png
