isystemsautomation/homemaster-dev/articles/opentherm_weather/ha_opentherm3.png

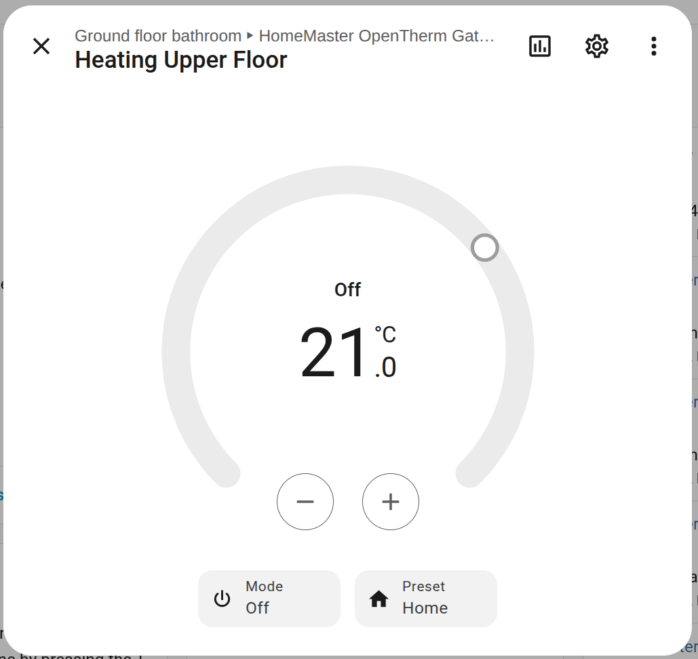
articles/opentherm_weather/ha_opentherm3.png
