isystemsautomation/homemaster-dev/articles/reading-4-20-ma-and-pt100-sensors.png

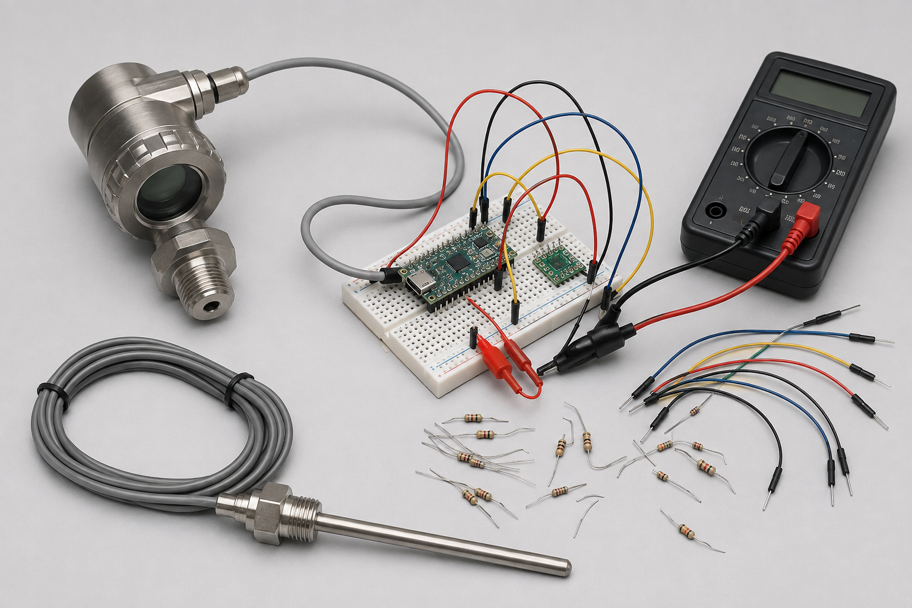
articles/reading-4-20-ma-and-pt100-sensors.png
