isystemsautomation/homemaster-dev/articles/smart-chimney-microplc/main.png

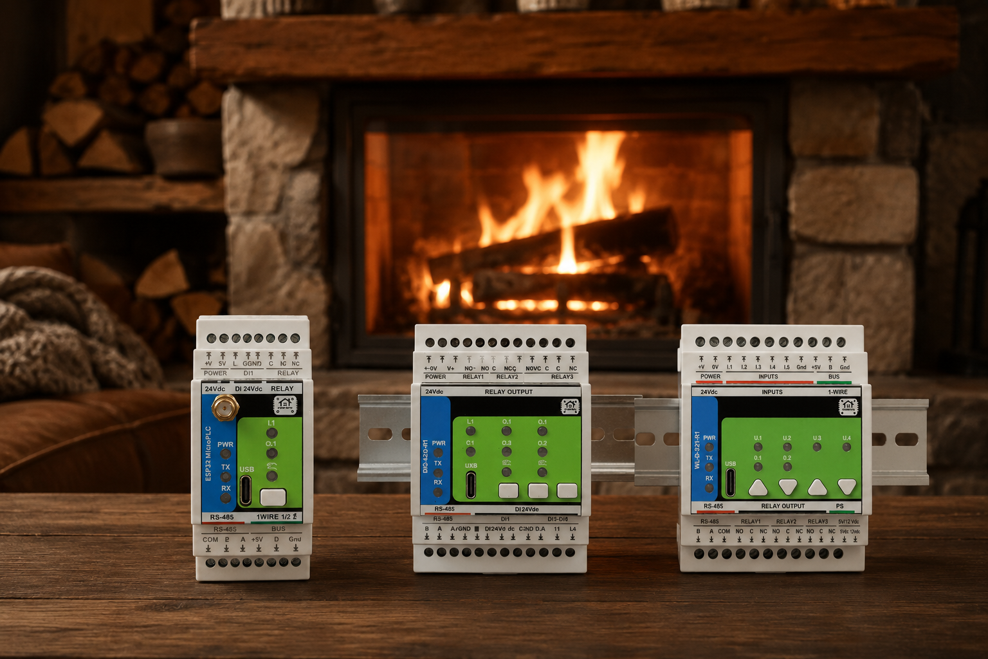
articles/smart-chimney-microplc/main.png
