isystemsautomation/homemaster-dev/articles/smart-chimney-microplc/schema.png

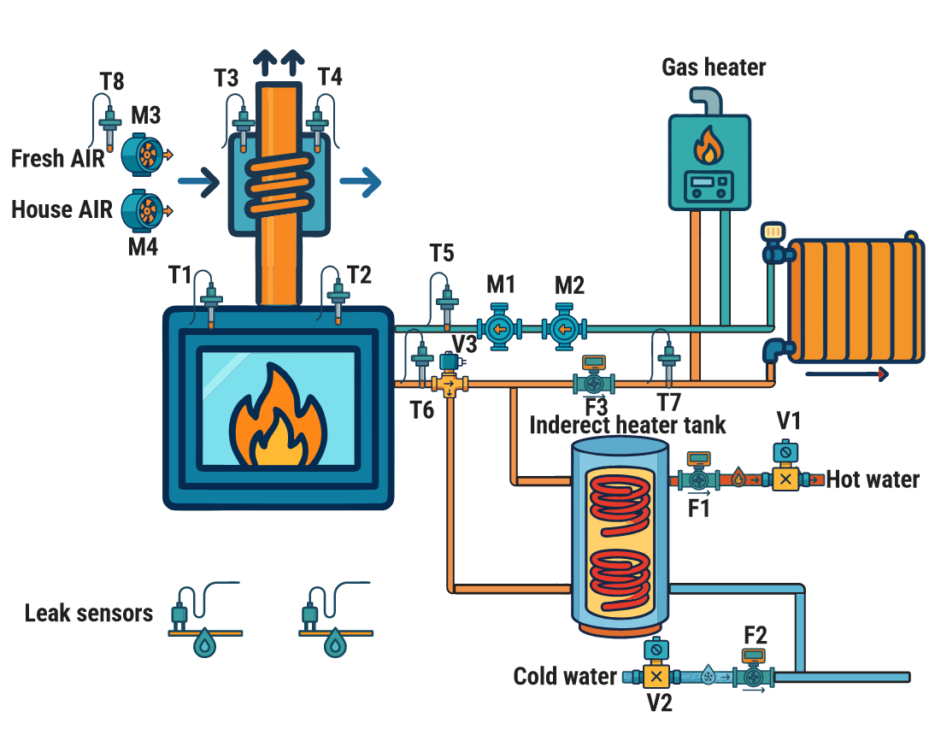
articles/smart-chimney-microplc/schema.png
