isystemsautomation/homemaster-dev/articles/smart-chimney-microplc/smartheating1.png

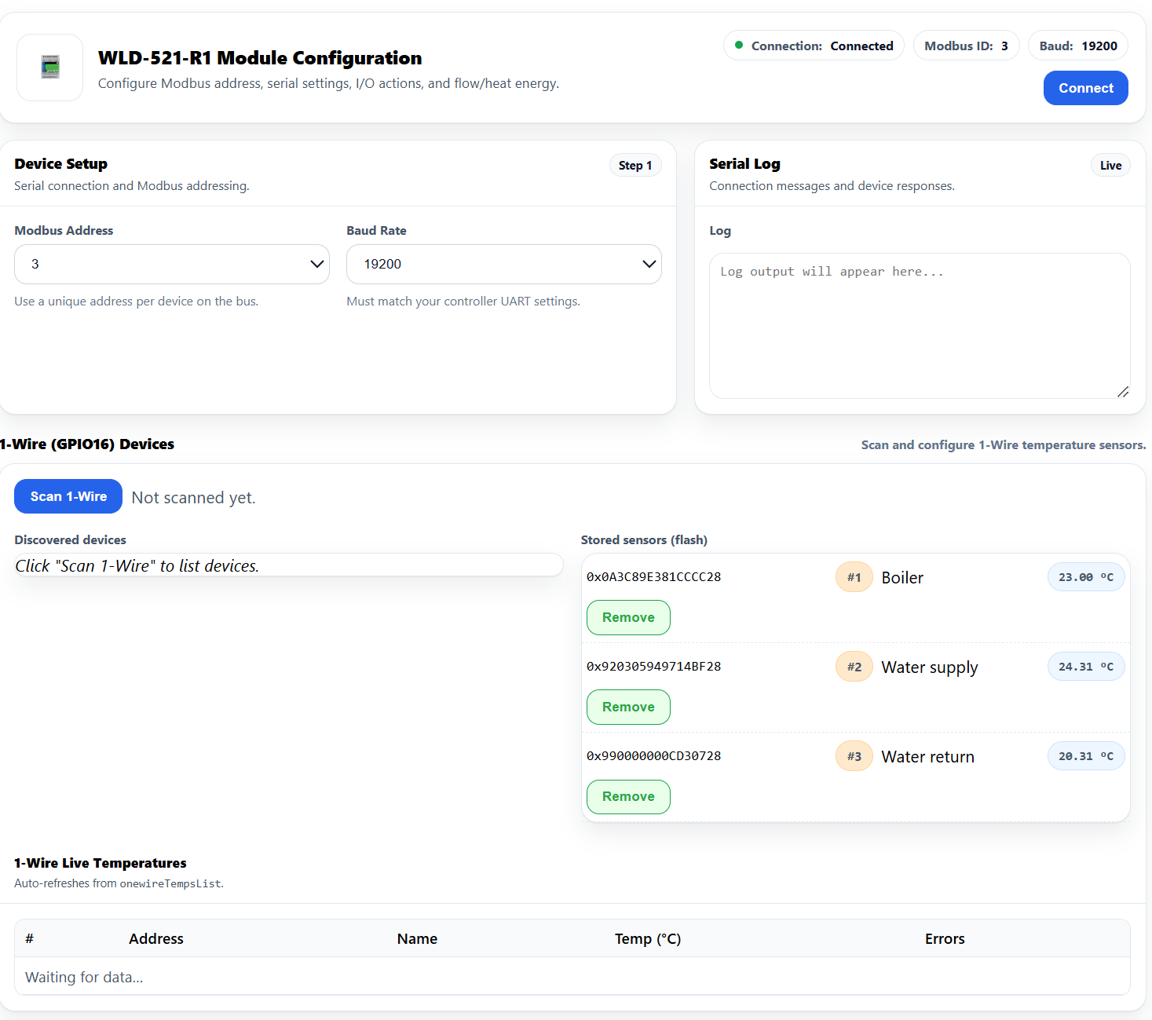
articles/smart-chimney-microplc/smartheating1.png
