isystemsautomation/homemaster-dev/articles/smart-chimney-microplc/smartheating2.png

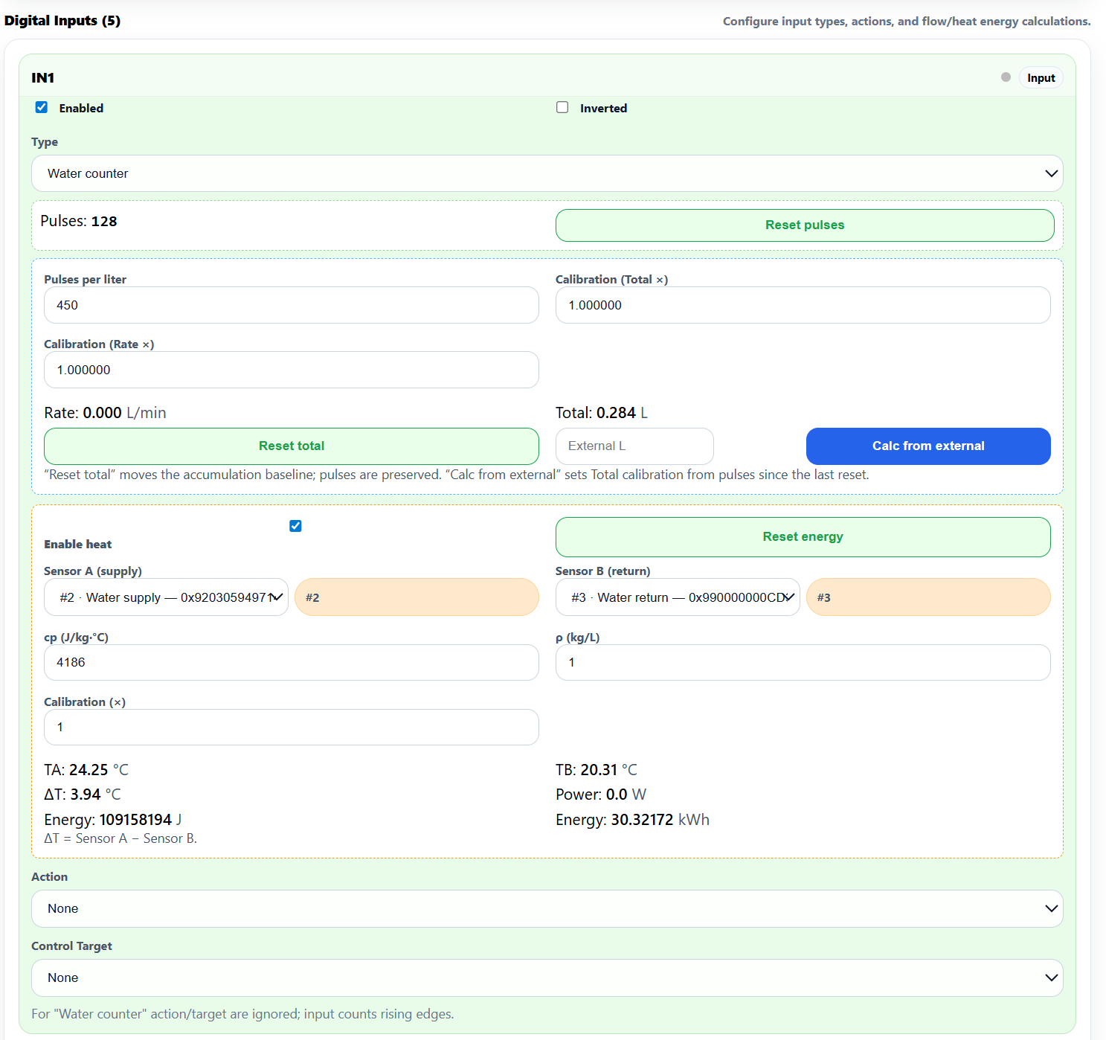
articles/smart-chimney-microplc/smartheating2.png
