isystemsautomation/homemaster-dev/articles/smart-chimney-microplc/smartheating3.png

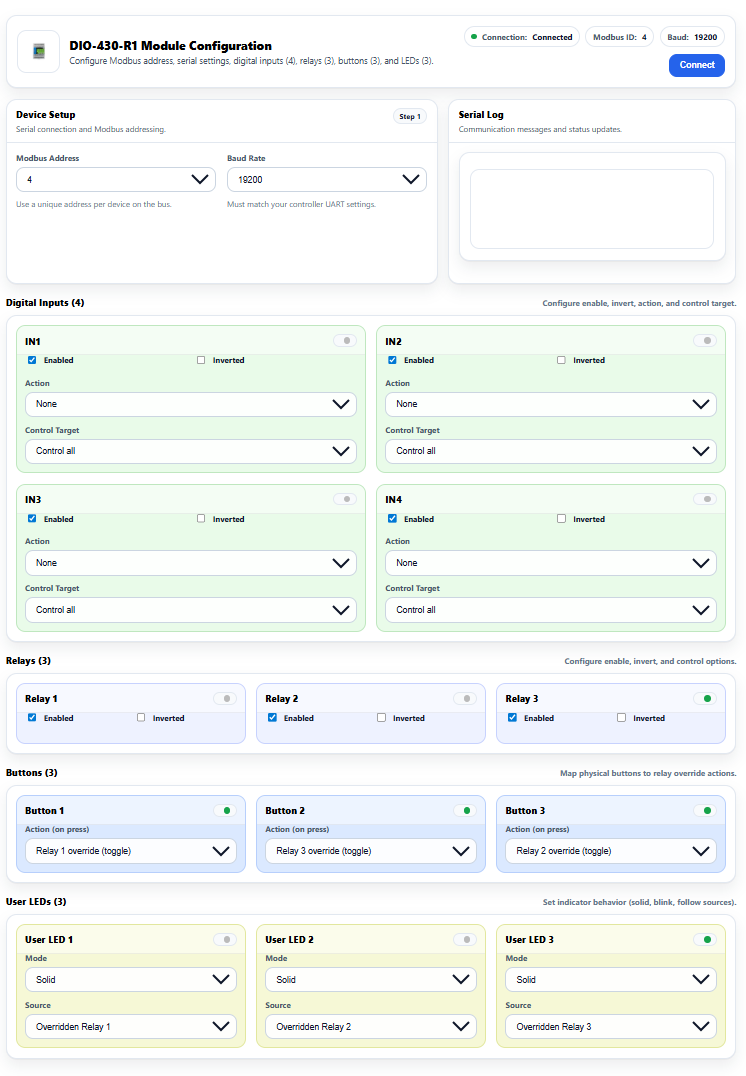
articles/smart-chimney-microplc/smartheating3.png
