isystemsautomation/homemaster-dev/articles/what-still-works-when-home-assistant-is-down.jpeg

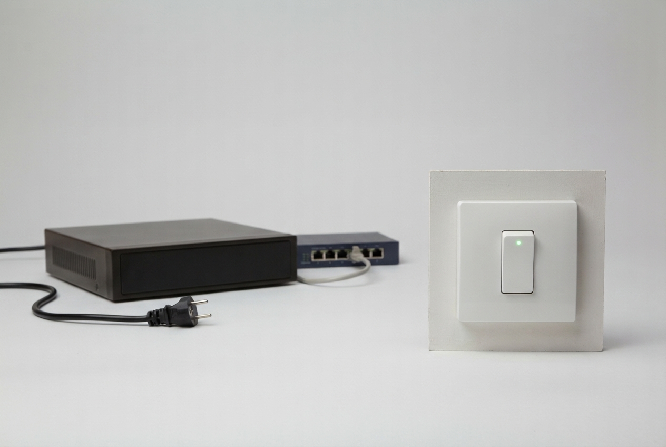
articles/what-still-works-when-home-assistant-is-down.jpeg
