isystemsautomation/homemaster-dev/articles/wind-speed-direction-4-20ma-esphome/main.webp

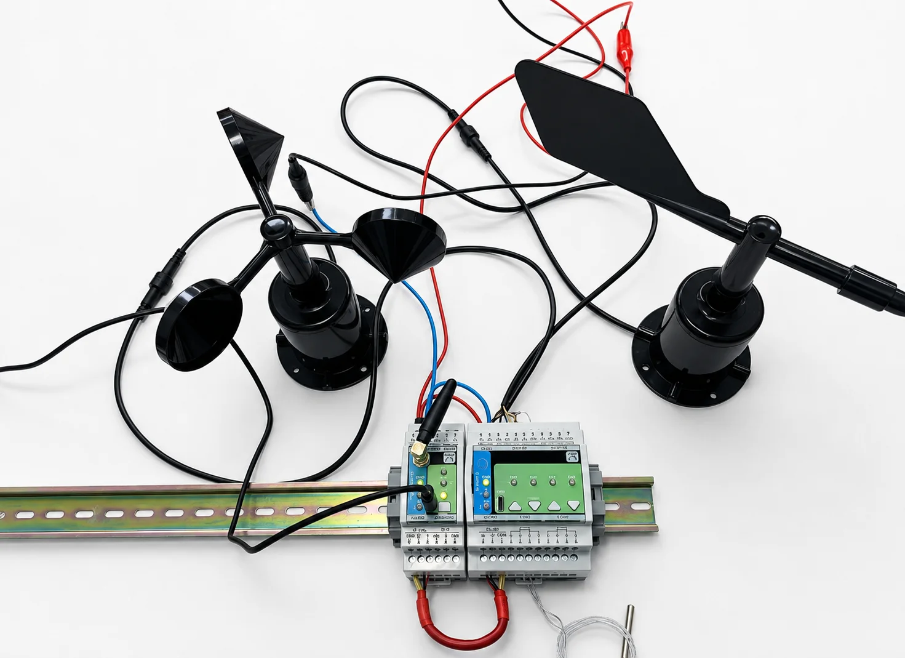
articles/wind-speed-direction-4-20ma-esphome/main.webp
