isystemsautomation/homemaster-dev/articles/wired-sensors-boards-vs-din-rail.jpeg

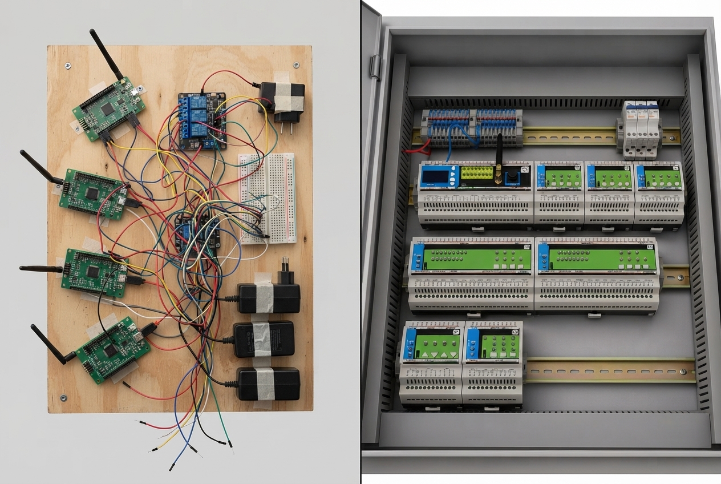
articles/wired-sensors-boards-vs-din-rail.jpeg
