isystemsautomation/homemaster-dev/DIM-420-R1/Images/DIM_2000x2000.png

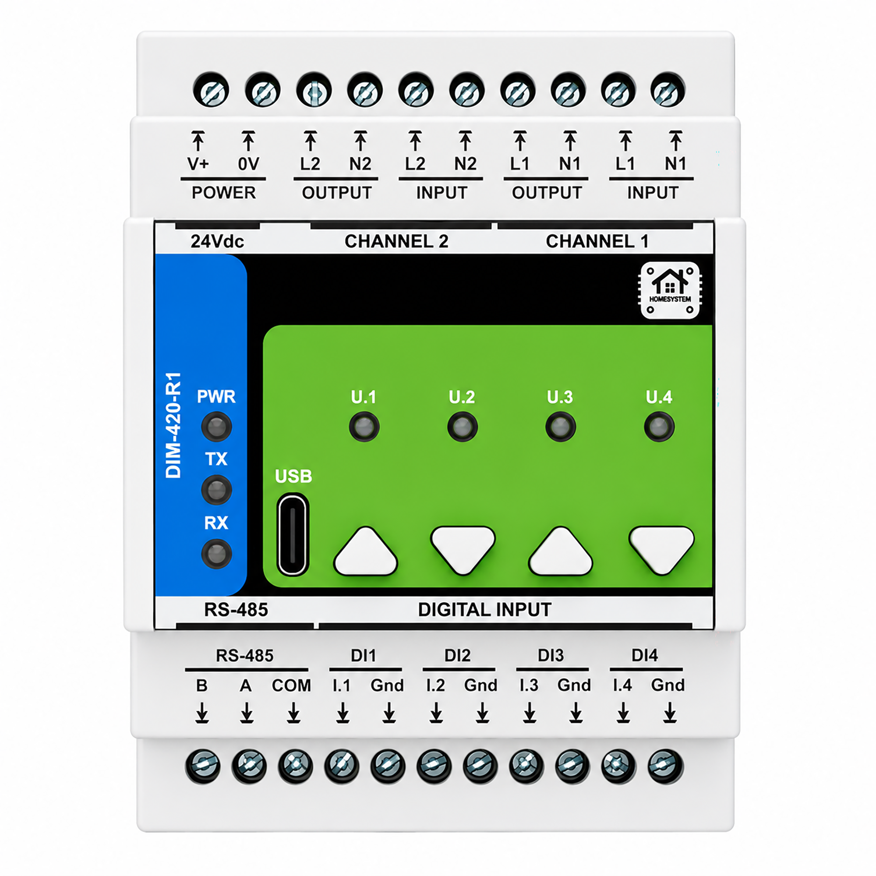
DIM-420-R1/Images/DIM_2000x2000.png
