isystemsautomation/homemaster-dev/DIM-420-R1/Images/DIM_site.png

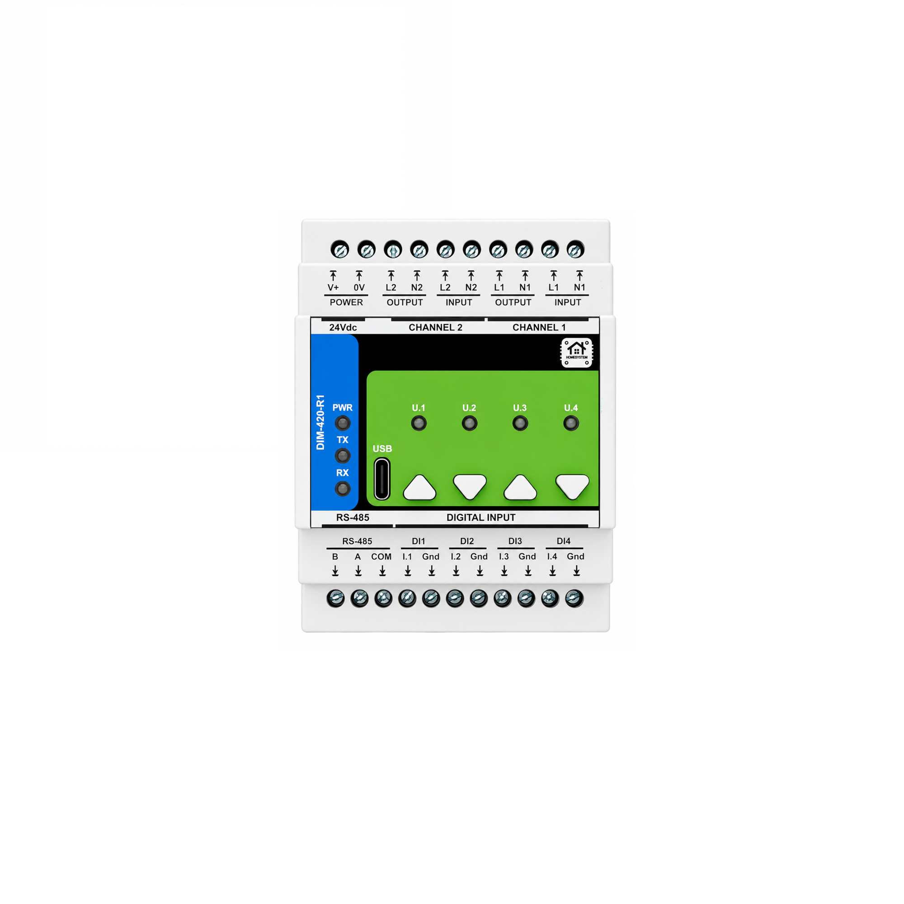
DIM-420-R1/Images/DIM_site.png
