isystemsautomation/homemaster-dev/DIM-420-R1/Images/photo1_512kb.png

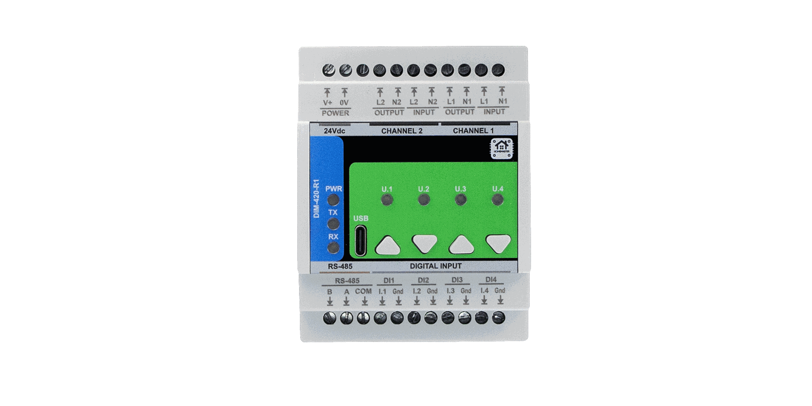
DIM-420-R1/Images/photo1_512kb.png
