isystemsautomation/homemaster-dev/DIO-430-R1/Images/DIO_2000x2000.png

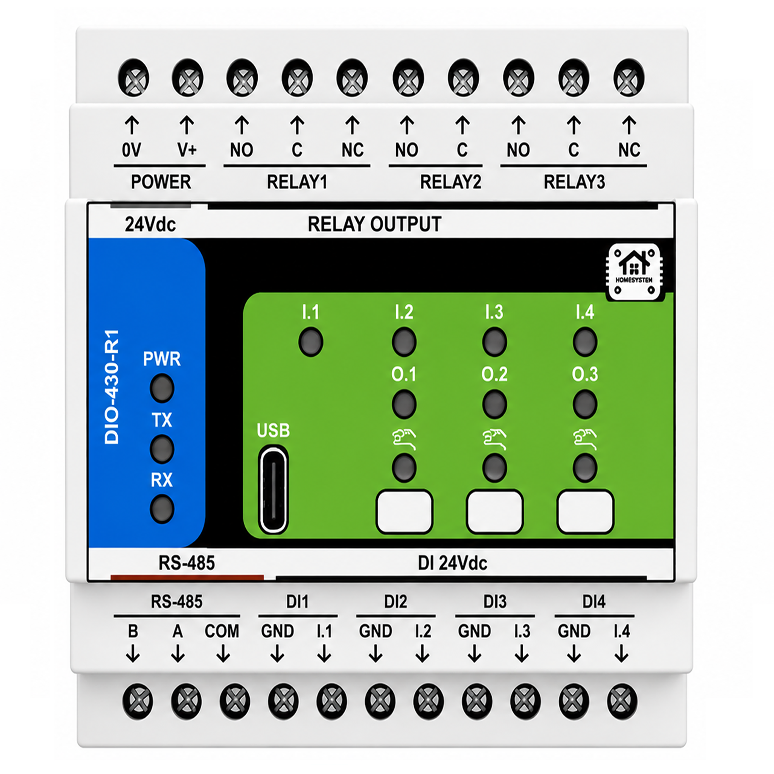
DIO-430-R1/Images/DIO_2000x2000.png
