isystemsautomation/homemaster-dev/DIO-430-R1/Images/DIO_SystemBlockDiagram.png

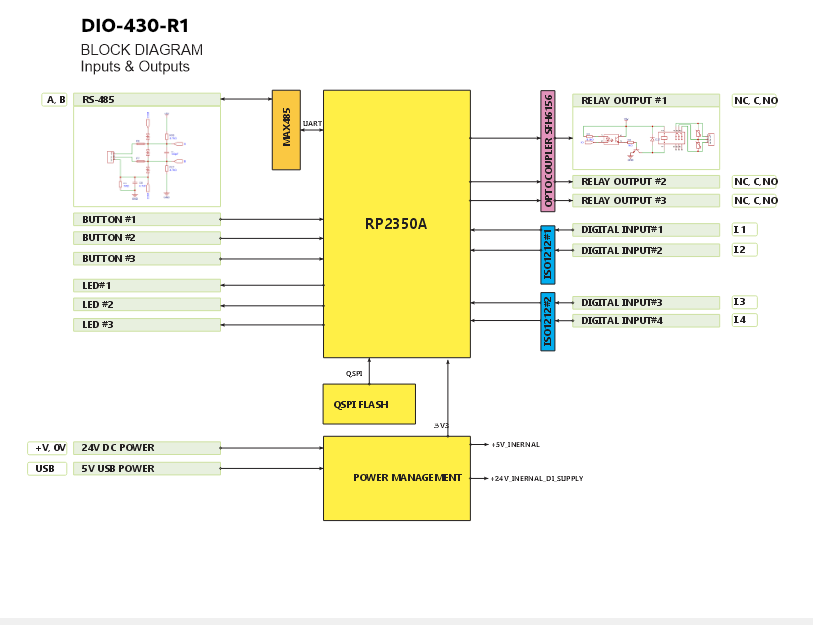
DIO-430-R1/Images/DIO_SystemBlockDiagram.png
