isystemsautomation/homemaster-dev/DIO-430-R1/Images/mplisting1.png

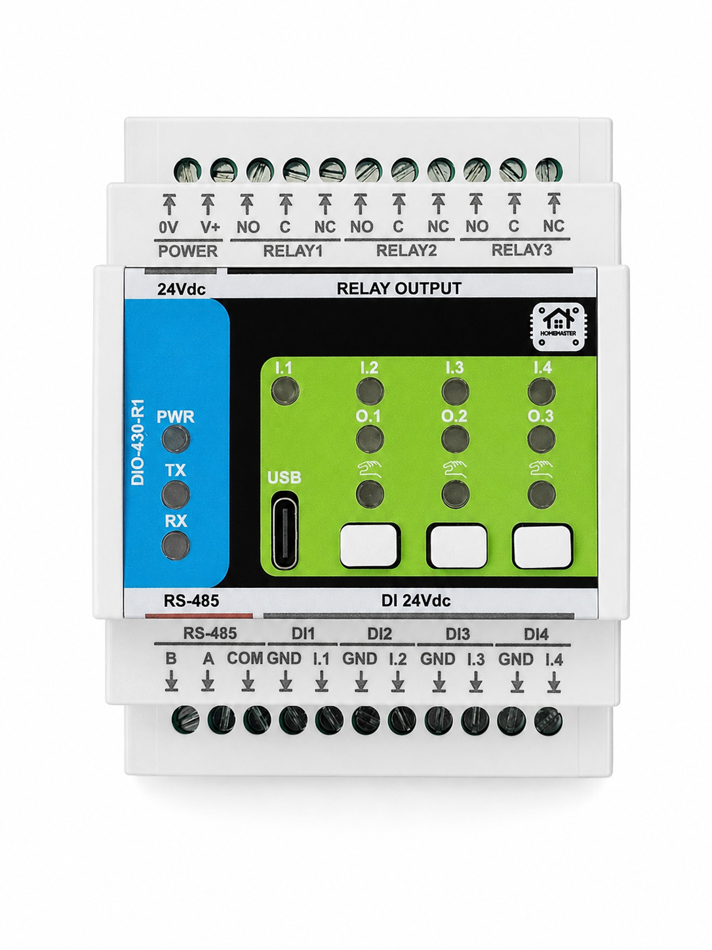
DIO-430-R1/Images/mplisting1.png
