isystemsautomation/homemaster-dev/DIO-430-R1/Images/package1.png

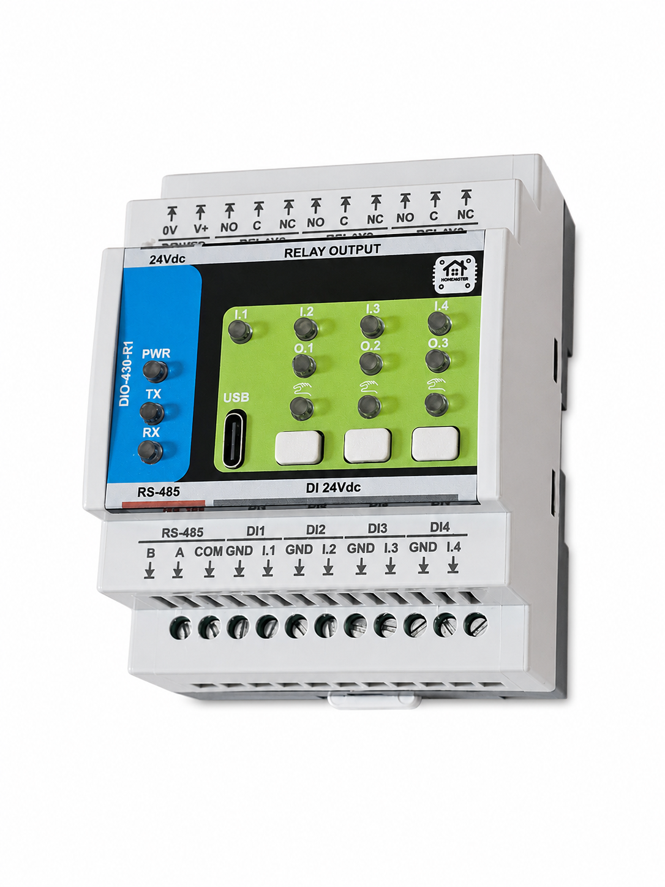
DIO-430-R1/Images/package1.png
