isystemsautomation/homemaster-dev/DIO-430-R1/Images/webconfig1.png

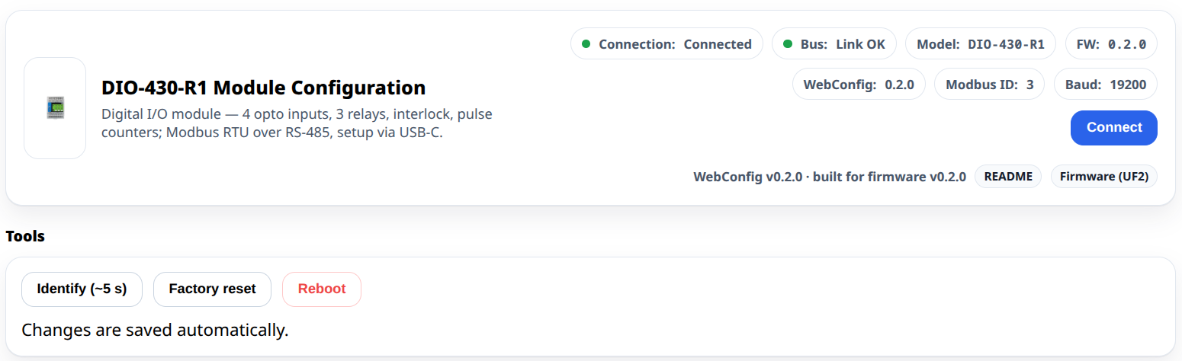
DIO-430-R1/Images/webconfig1.png
