isystemsautomation/homemaster-dev/DIO-430-R1/Images/webconfig2.png

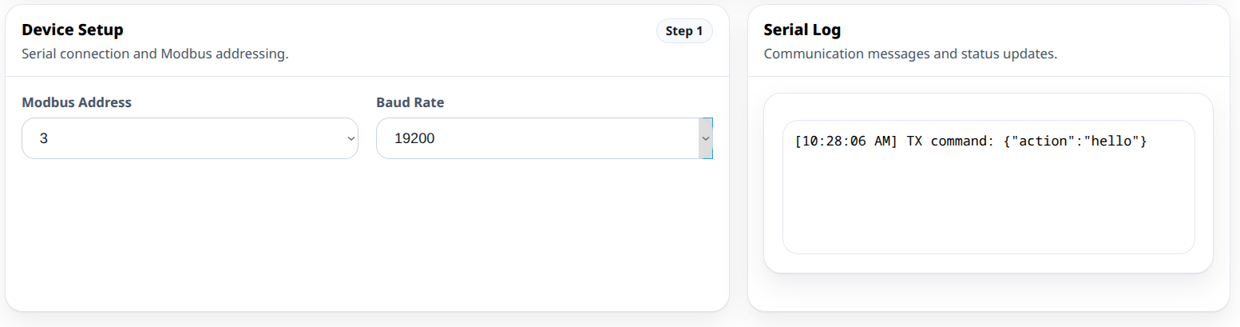
DIO-430-R1/Images/webconfig2.png
