isystemsautomation/homemaster-dev/DIO-430-R1/Images/webconfig3.png

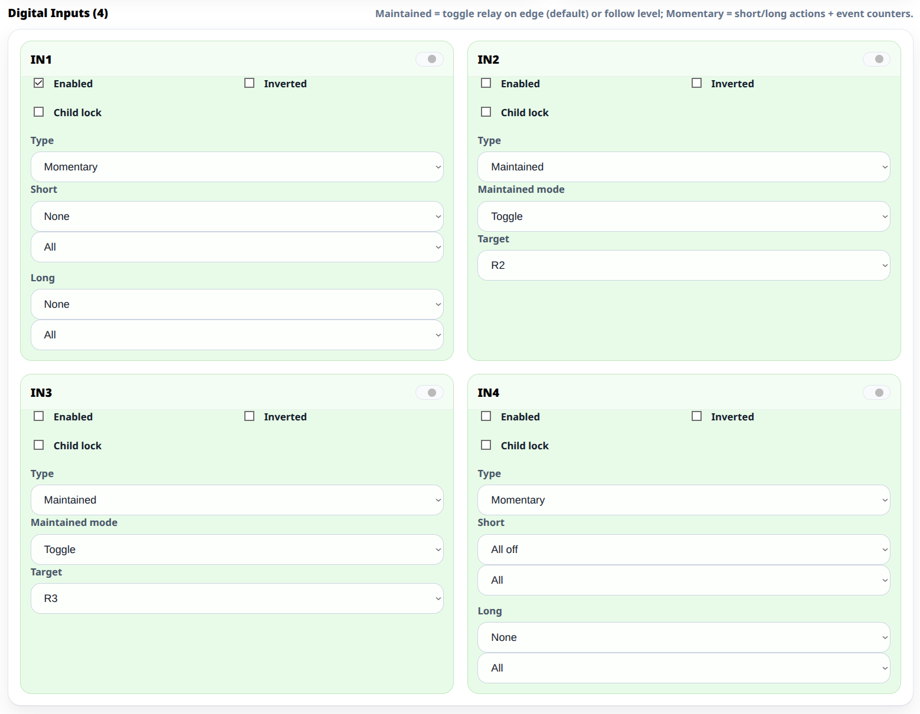
DIO-430-R1/Images/webconfig3.png
