isystemsautomation/homemaster-dev/DIO-430-R1/Images/webconfig4.png

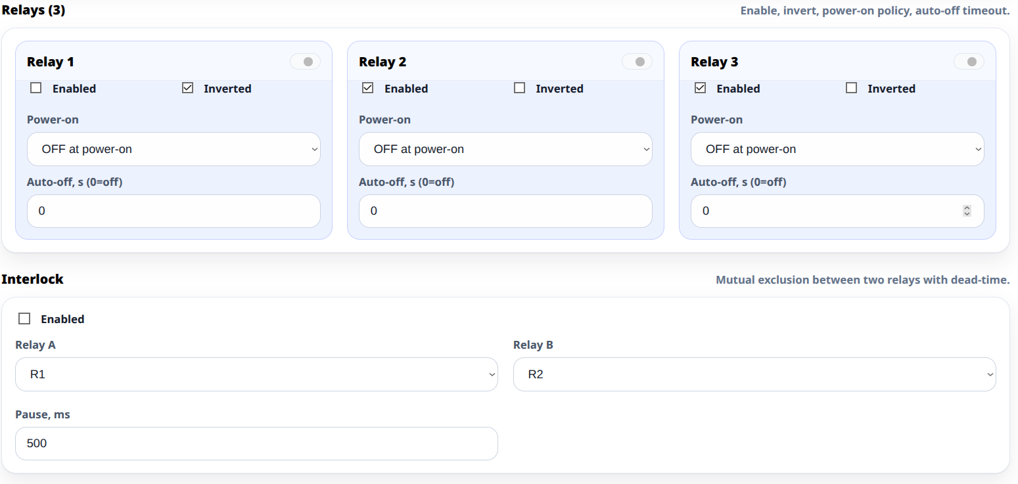
DIO-430-R1/Images/webconfig4.png
