isystemsautomation/homemaster-dev/DIO-430-R1/Images/webconfig5.png

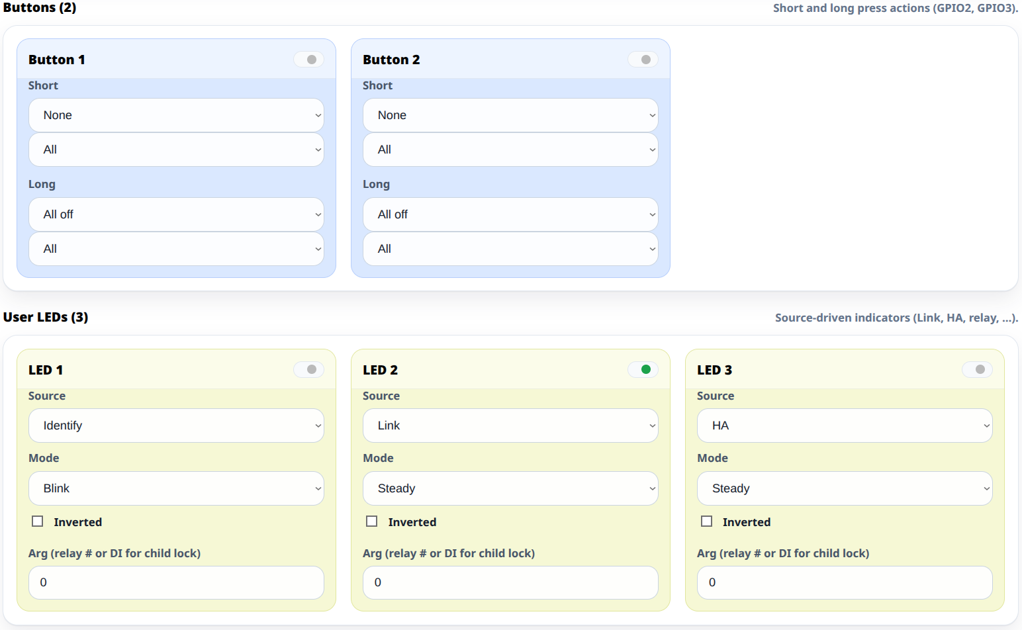
DIO-430-R1/Images/webconfig5.png
