isystemsautomation/homemaster-dev/DIO-430-R1/Images/webconfig6.png

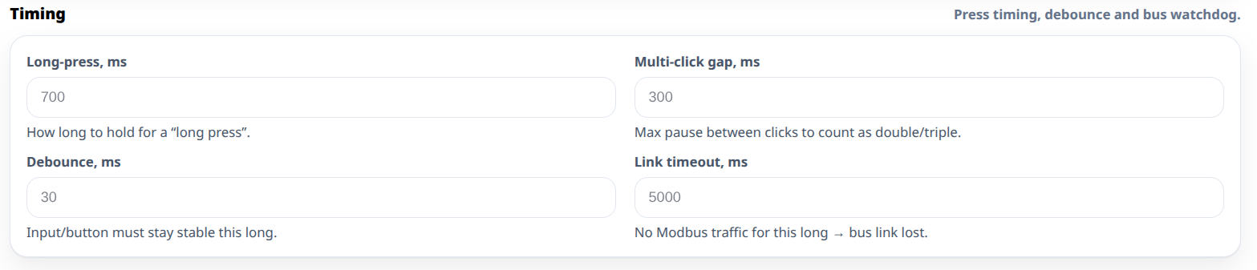
DIO-430-R1/Images/webconfig6.png
