isystemsautomation/homemaster-dev/ENM-223-R1/Images/ENM_2000x2000.png

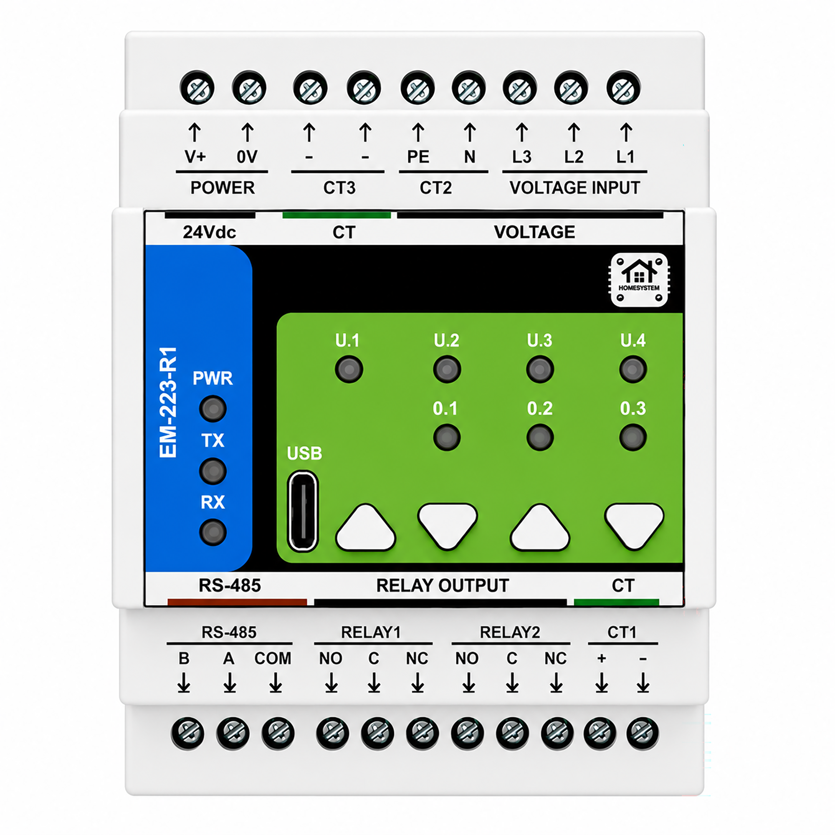
ENM-223-R1/Images/ENM_2000x2000.png
