isystemsautomation/homemaster-dev/ENM-223-R1/Images/mplisting1.png

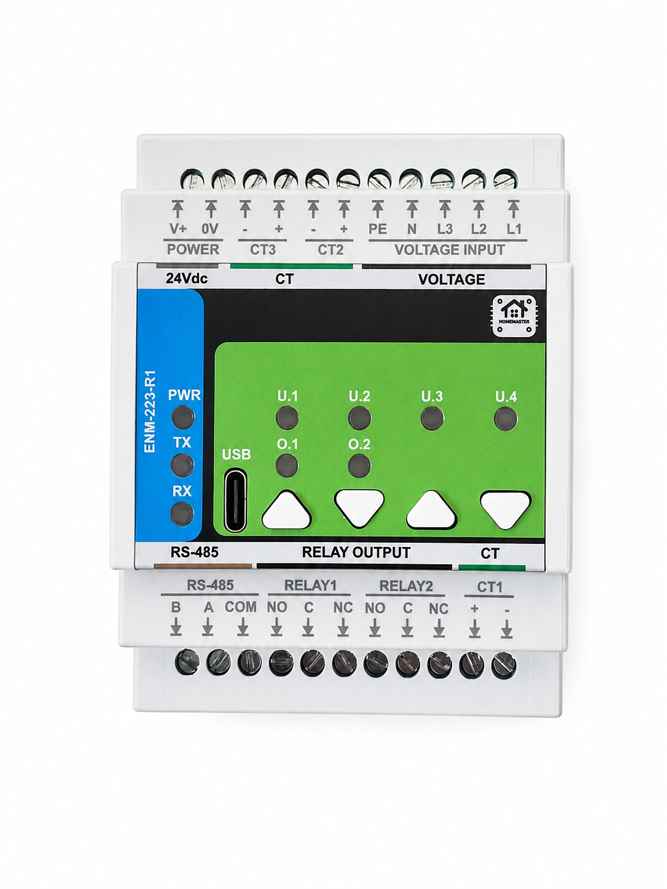
ENM-223-R1/Images/mplisting1.png
