isystemsautomation/homemaster-dev/ENM-223-R1/Images/package1.png

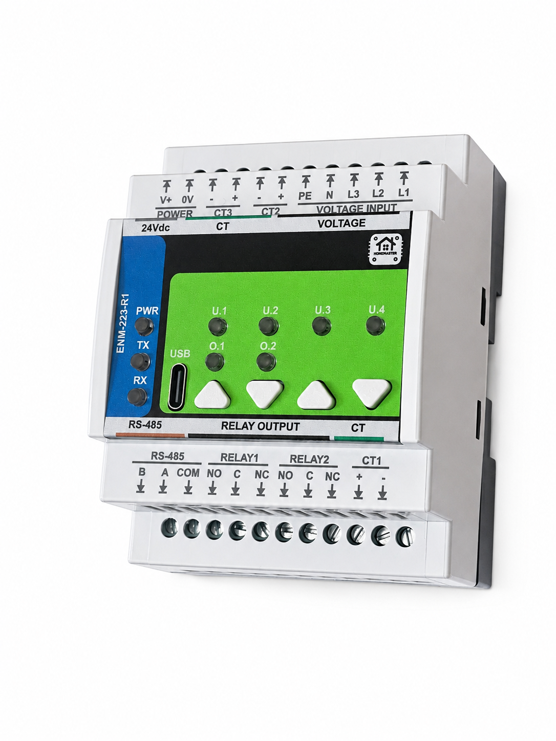
ENM-223-R1/Images/package1.png
