isystemsautomation/homemaster-dev/ENM-223-R1/Images/webconfig1.png

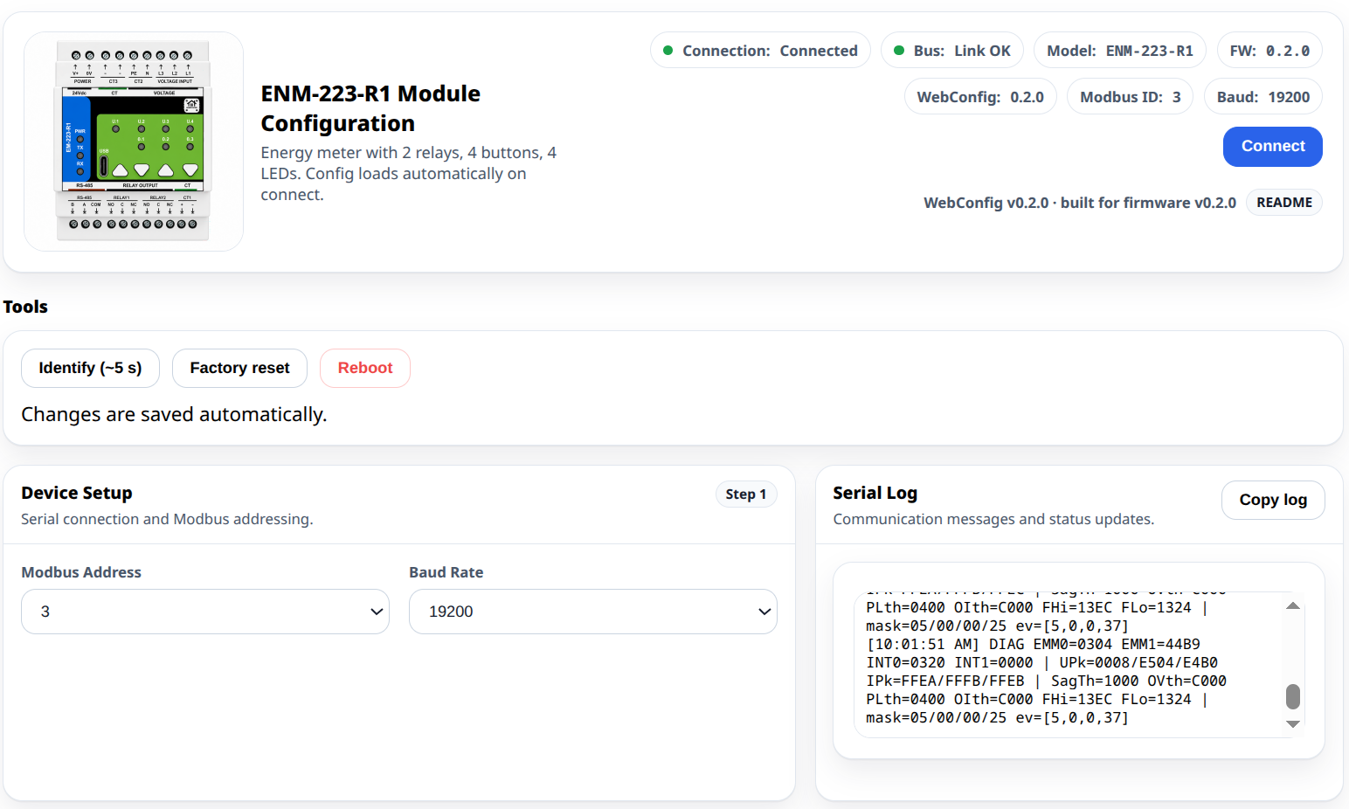
ENM-223-R1/Images/webconfig1.png
