isystemsautomation/homemaster-dev/ENM-223-R1/Images/webconfig2.png

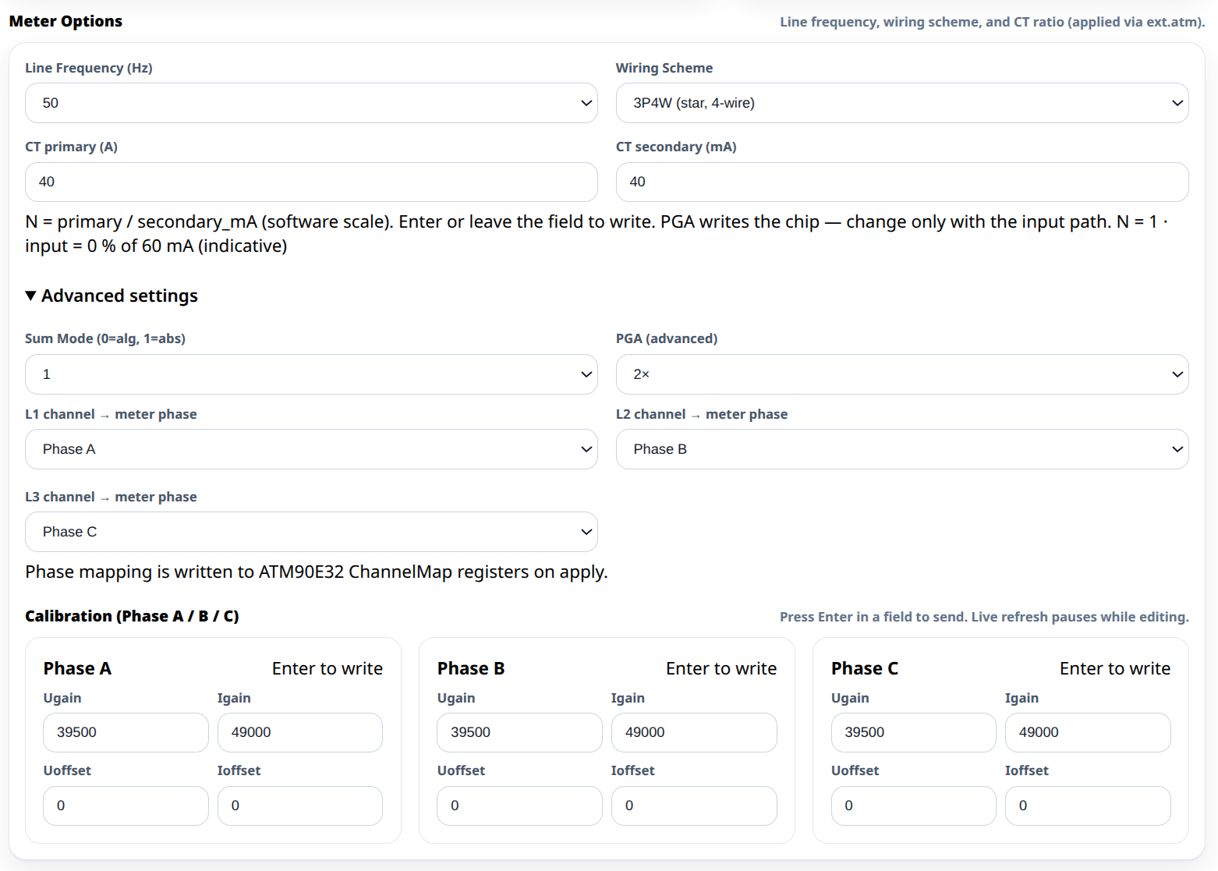
ENM-223-R1/Images/webconfig2.png
