isystemsautomation/homemaster-dev/ENM-223-R1/Images/webconfig3.png

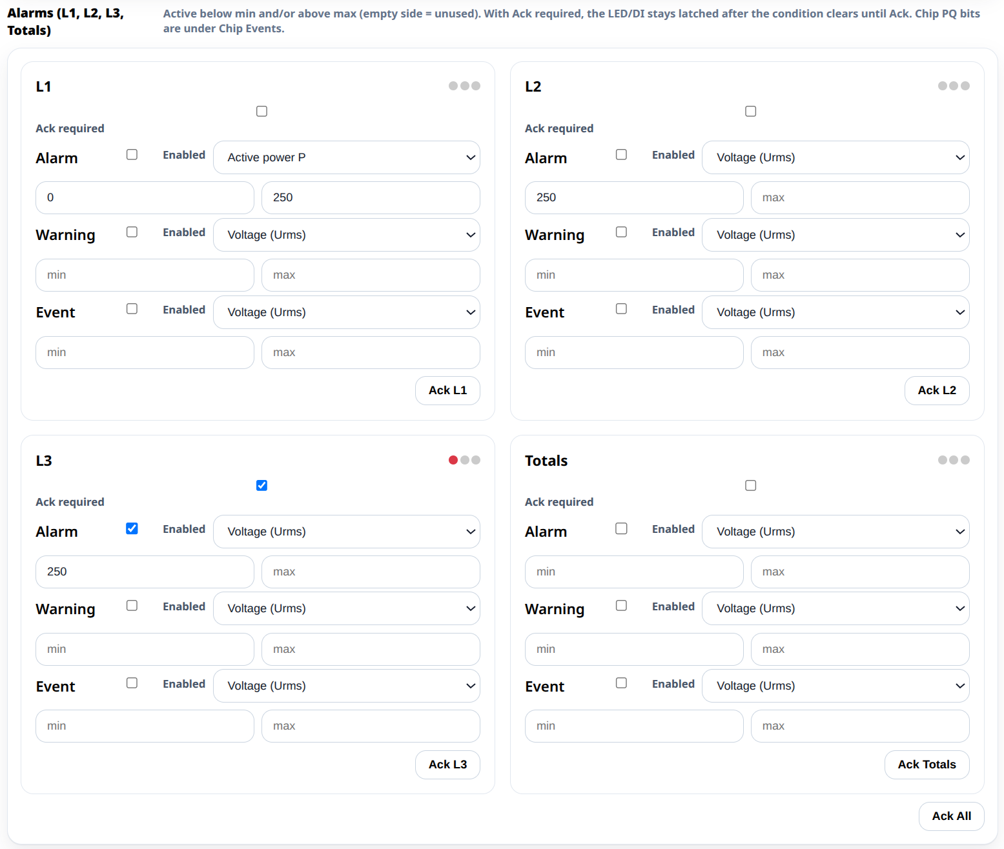
ENM-223-R1/Images/webconfig3.png
