isystemsautomation/homemaster-dev/ENM-223-R1/Images/webconfig4.png

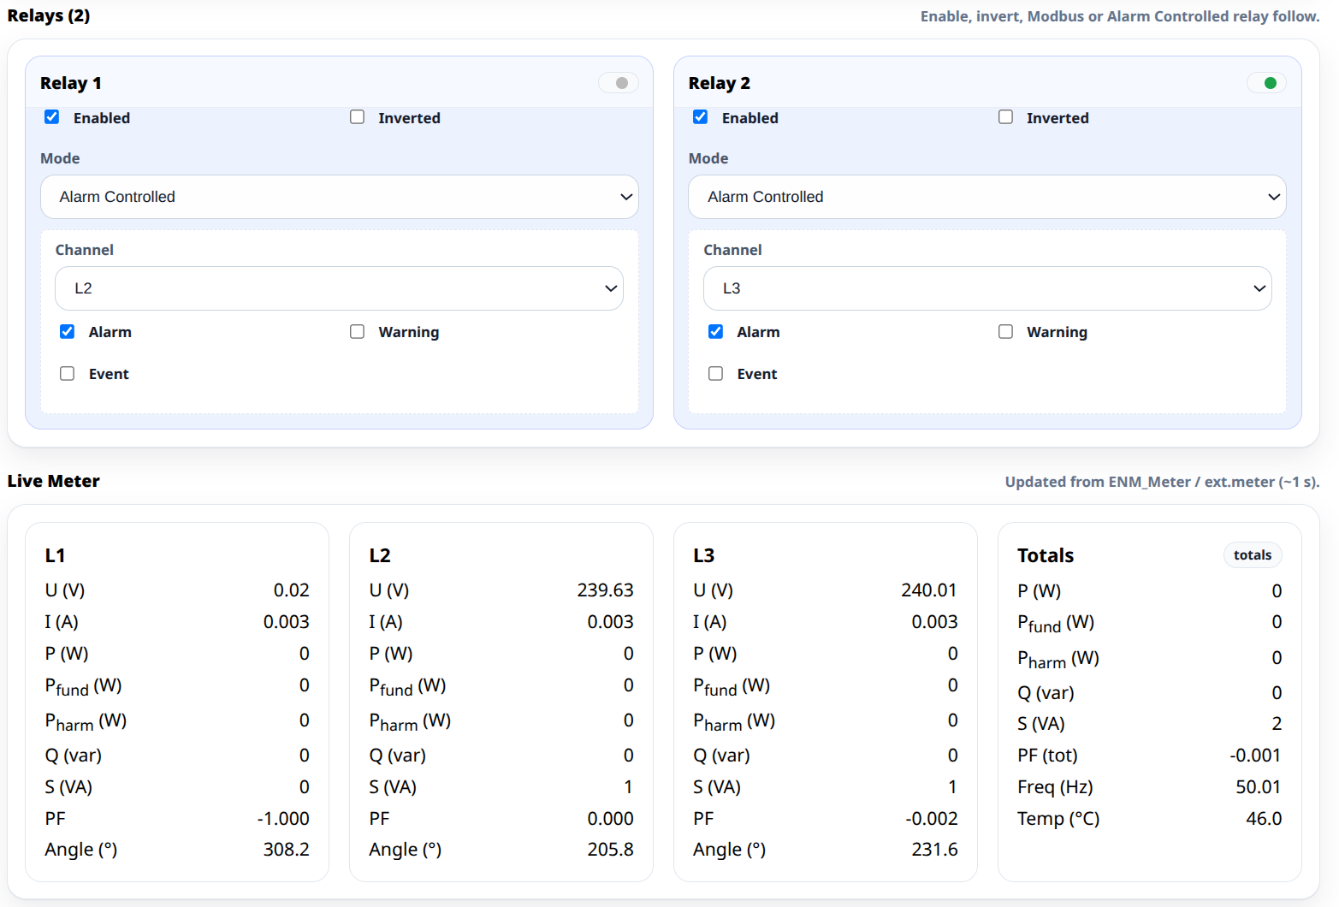
ENM-223-R1/Images/webconfig4.png
