isystemsautomation/homemaster-dev/ENM-223-R1/Images/webconfig5.png

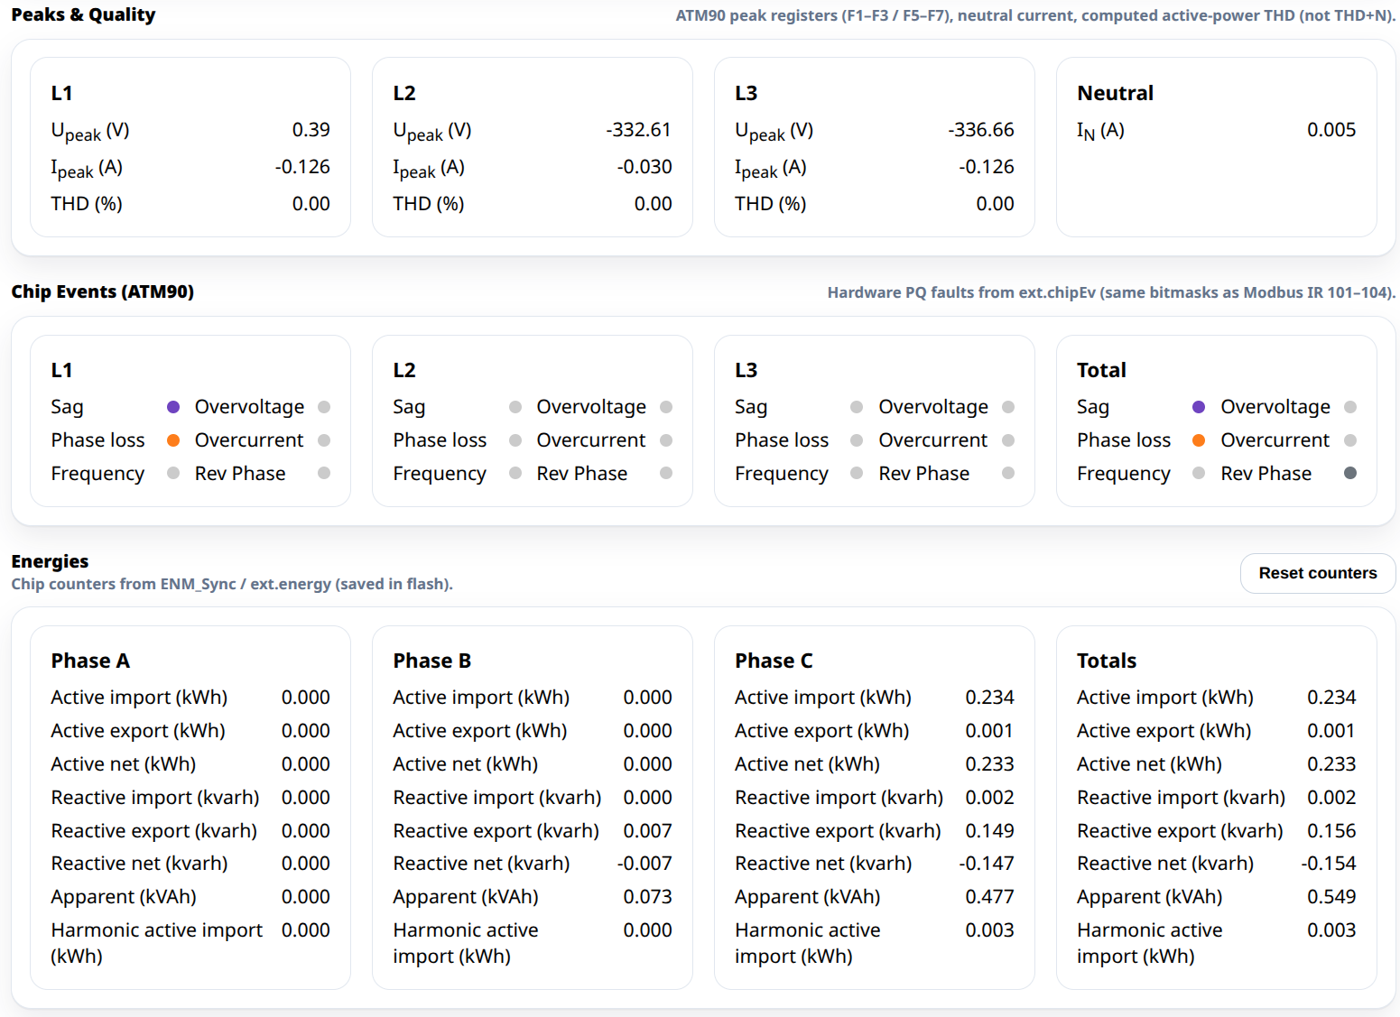
ENM-223-R1/Images/webconfig5.png
