isystemsautomation/homemaster-dev/ENM-223-R1/Images/webconfig6.png

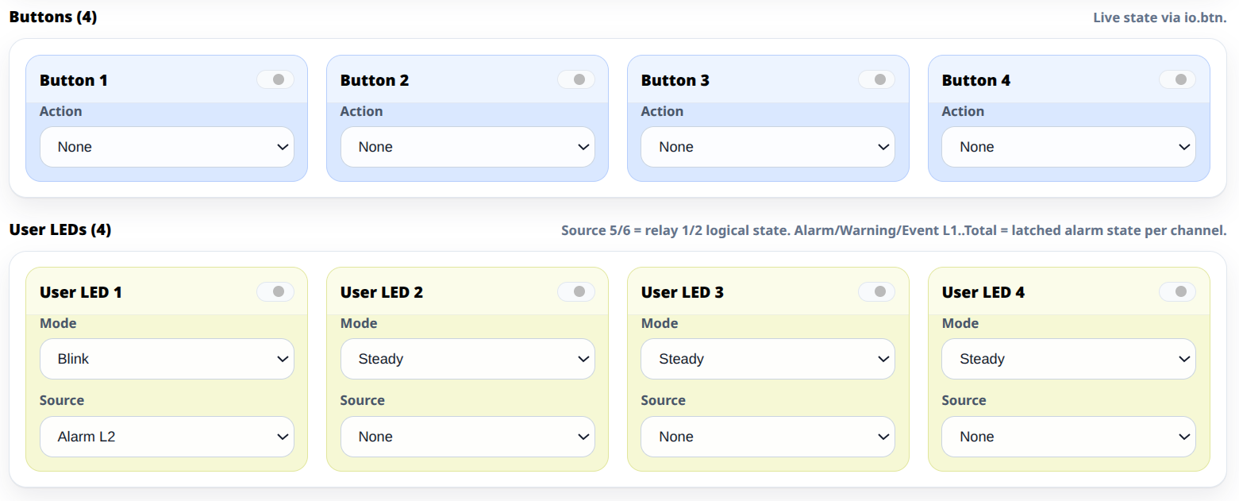
ENM-223-R1/Images/webconfig6.png
