isystemsautomation/homemaster-dev/estimator/assets/examples/apartment.jpg

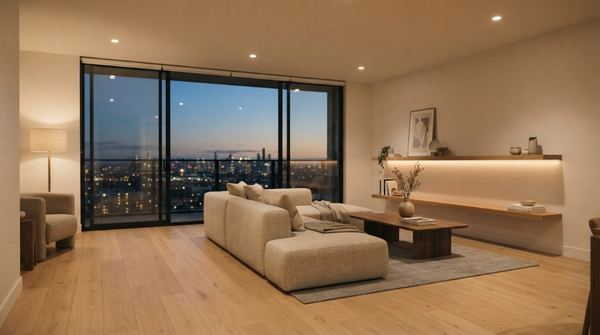
estimator/assets/examples/apartment.jpg
