isystemsautomation/homemaster-dev/estimator/assets/examples/house.jpg

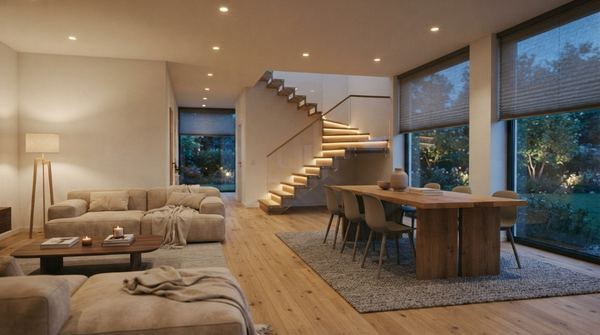
estimator/assets/examples/house.jpg
