isystemsautomation/homemaster-dev/estimator/assets/examples/villa.jpg

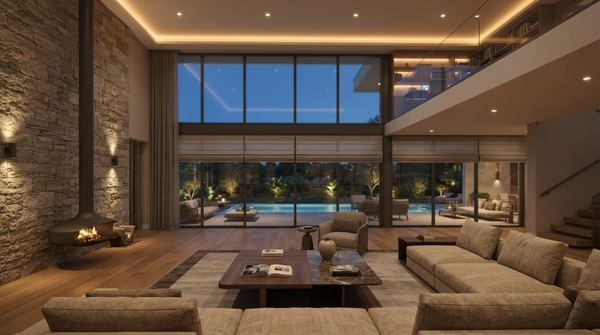
estimator/assets/examples/villa.jpg
