isystemsautomation/homemaster-dev/estimator/assets/panel/companions/contactor_modular.png

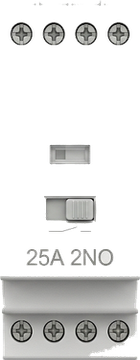
estimator/assets/panel/companions/contactor_modular.png
