isystemsautomation/homemaster-dev/estimator/assets/panel/companions/eth_switch_din.png

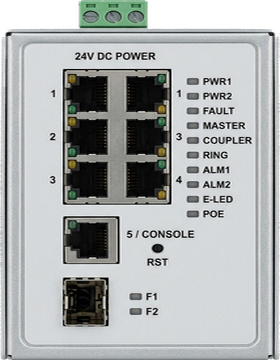
estimator/assets/panel/companions/eth_switch_din.png
