isystemsautomation/homemaster-dev/estimator/assets/panel/companions/ha_server_din.png

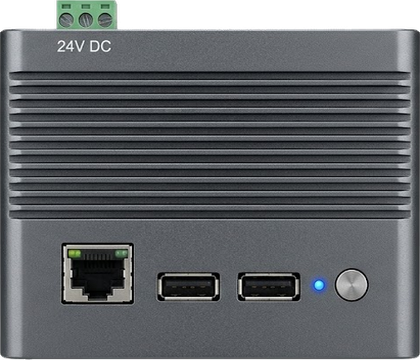
estimator/assets/panel/companions/ha_server_din.png
