isystemsautomation/homemaster-dev/estimator/assets/panel/companions/mcb_1p_n.png

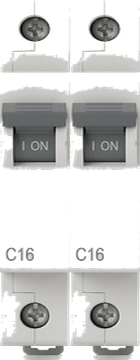
estimator/assets/panel/companions/mcb_1p_n.png
