isystemsautomation/homemaster-dev/estimator/assets/panel/companions/mcb_3p.png

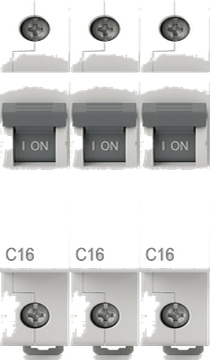
estimator/assets/panel/companions/mcb_3p.png
