isystemsautomation/homemaster-dev/estimator/assets/panel/companions/psu_din_60w.png

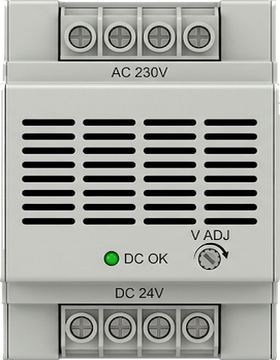
estimator/assets/panel/companions/psu_din_60w.png
