isystemsautomation/homemaster-dev/estimator/assets/panel/companions/rcbo_1p_n.png

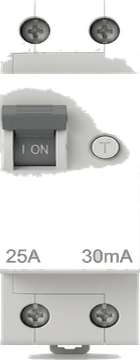
estimator/assets/panel/companions/rcbo_1p_n.png
