isystemsautomation/homemaster-dev/estimator/assets/panel/companions/rcd_4p.png

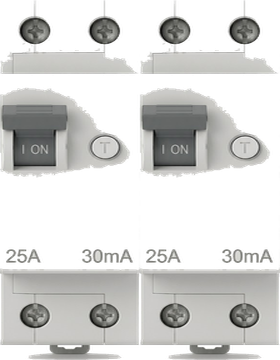
estimator/assets/panel/companions/rcd_4p.png
