isystemsautomation/homemaster-dev/estimator/assets/panel/modules/HM-AIO-422-R1.png

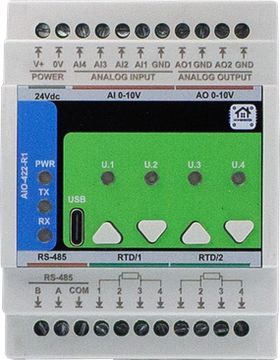
estimator/assets/panel/modules/HM-AIO-422-R1.png
