isystemsautomation/homemaster-dev/estimator/assets/panel/modules/HM-ALM-173-R1.png

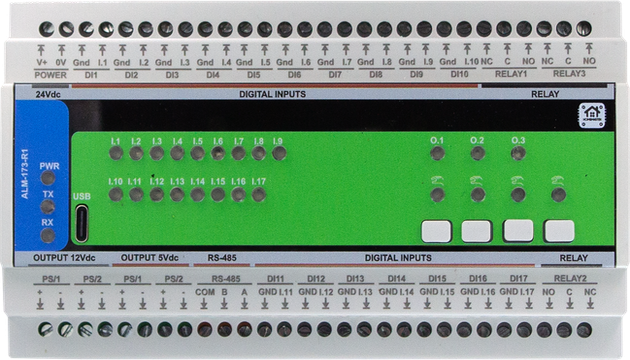
estimator/assets/panel/modules/HM-ALM-173-R1.png
