isystemsautomation/homemaster-dev/estimator/assets/panel/modules/HM-DIM-420-R1.png

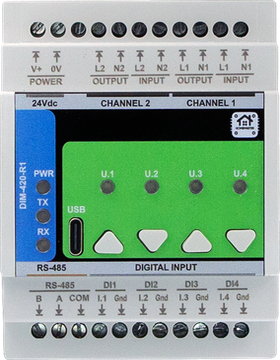
estimator/assets/panel/modules/HM-DIM-420-R1.png
