isystemsautomation/homemaster-dev/estimator/assets/panel/modules/HM-DIO-430-R1.png

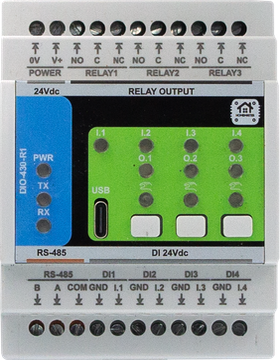
estimator/assets/panel/modules/HM-DIO-430-R1.png
