isystemsautomation/homemaster-dev/estimator/assets/panel/modules/HM-ENM-223-R1.png

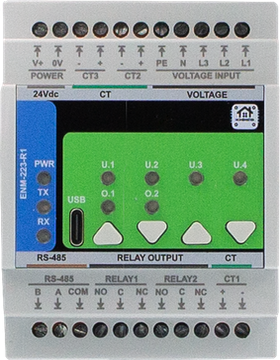
estimator/assets/panel/modules/HM-ENM-223-R1.png
