isystemsautomation/homemaster-dev/estimator/assets/panel/modules/HM-MICROPLC.png

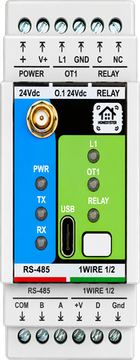
estimator/assets/panel/modules/HM-MICROPLC.png
