isystemsautomation/homemaster-dev/estimator/assets/panel/modules/HM-MINIPLC.png

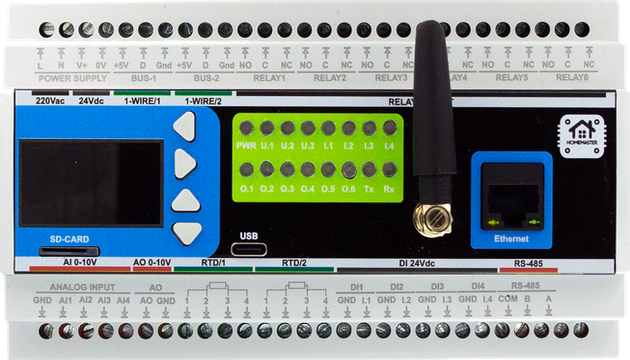
estimator/assets/panel/modules/HM-MINIPLC.png
