isystemsautomation/homemaster-dev/estimator/assets/panel/modules/HM-OTG-001.png

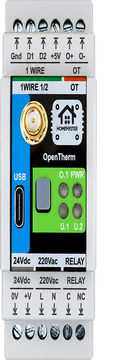
estimator/assets/panel/modules/HM-OTG-001.png
