isystemsautomation/homemaster-dev/estimator/assets/panel/modules/HM-RGB-621-R1.png

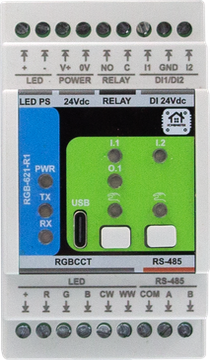
estimator/assets/panel/modules/HM-RGB-621-R1.png
