isystemsautomation/homemaster-dev/estimator/assets/panel/modules/HM-STR-3221-R1.png

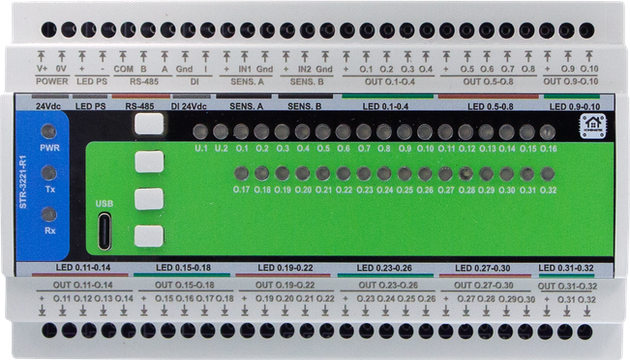
estimator/assets/panel/modules/HM-STR-3221-R1.png
