isystemsautomation/homemaster-dev/estimator/assets/panel/modules/HM-WLD-521-R1.png

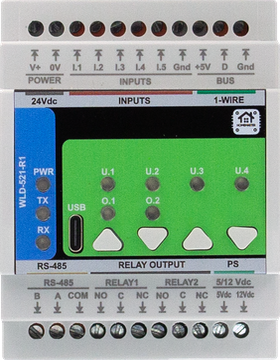
estimator/assets/panel/modules/HM-WLD-521-R1.png
