isystemsautomation/homemaster-dev/MicroPLC/Images/description_512kb.png

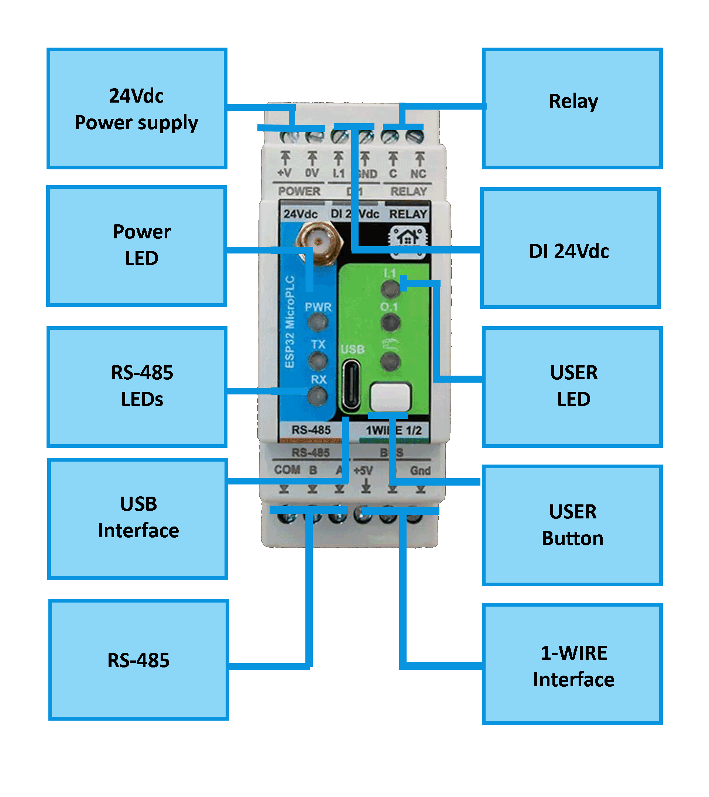
MicroPLC/Images/description_512kb.png
