isystemsautomation/homemaster-dev/MicroPLC/Images/dimensions.png

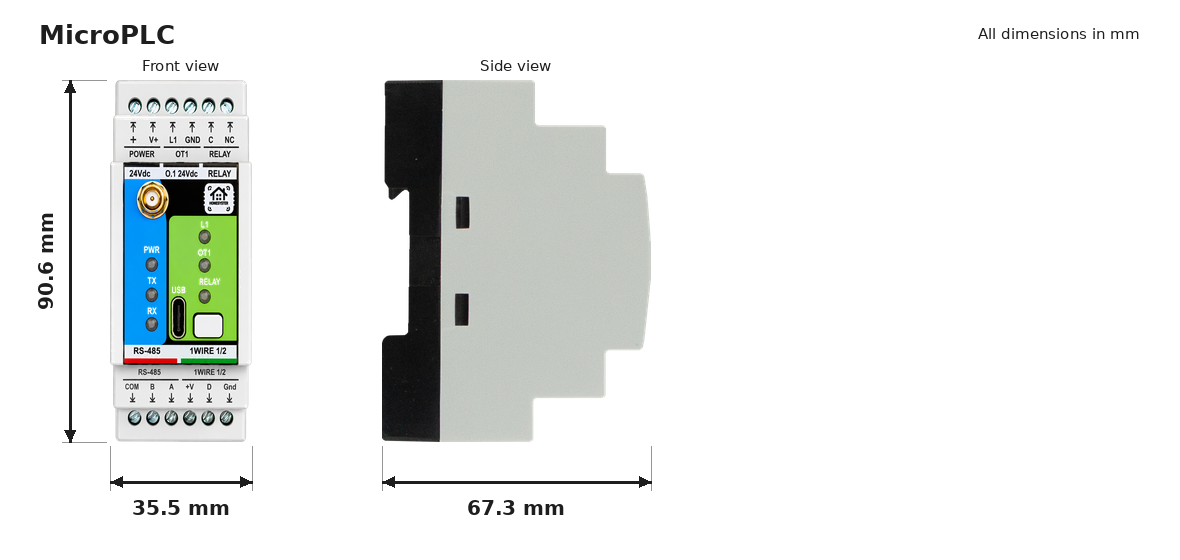
MicroPLC/Images/dimensions.png
