isystemsautomation/homemaster-dev/MicroPLC/Images/microplc_1600x1600.png

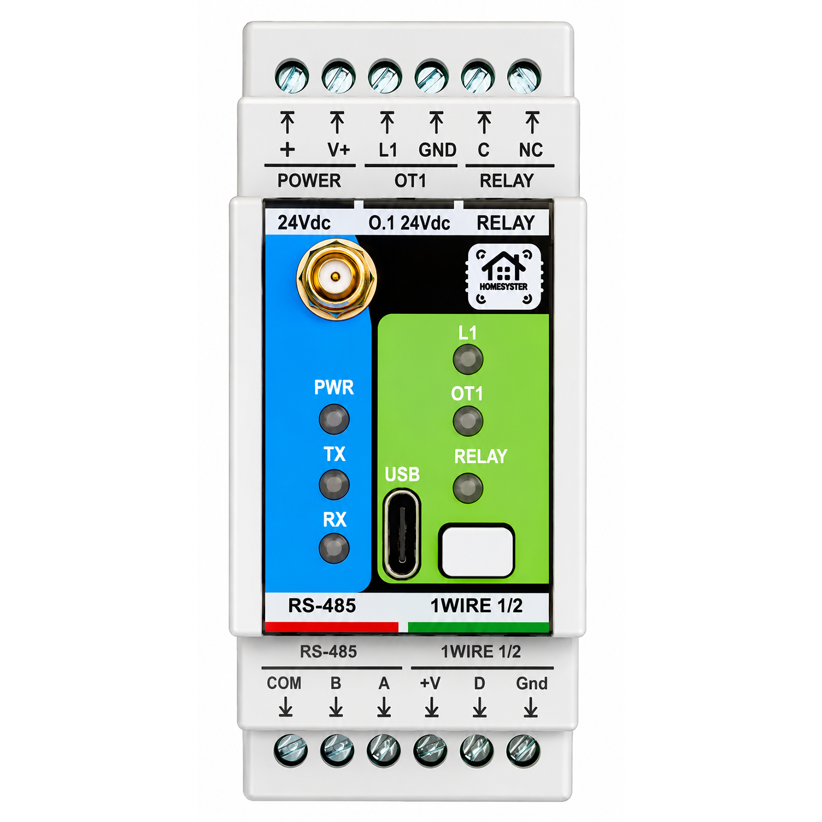
MicroPLC/Images/microplc_1600x1600.png
