isystemsautomation/homemaster-dev/MicroPLC/Images/microplc_site.png

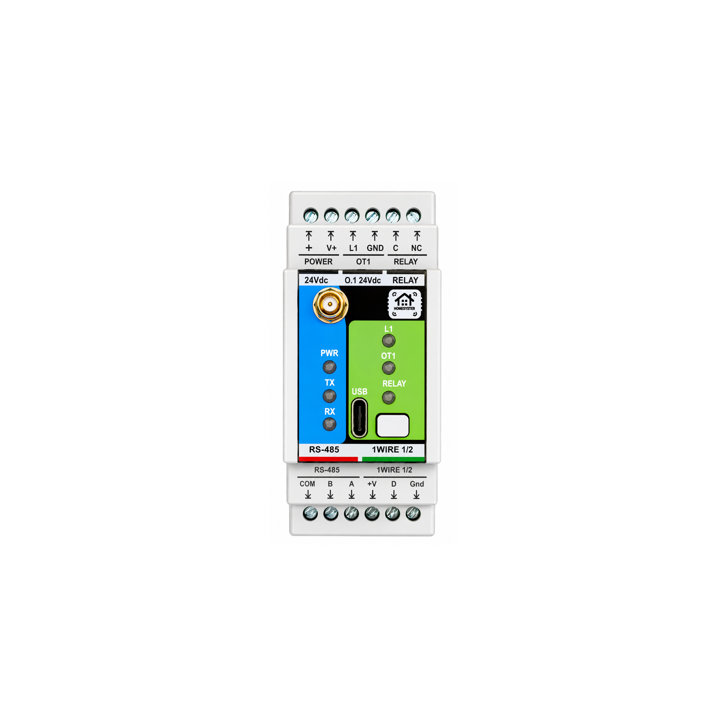
MicroPLC/Images/microplc_site.png
