isystemsautomation/homemaster-dev/MicroPLC/Images/mplisting1_1.png

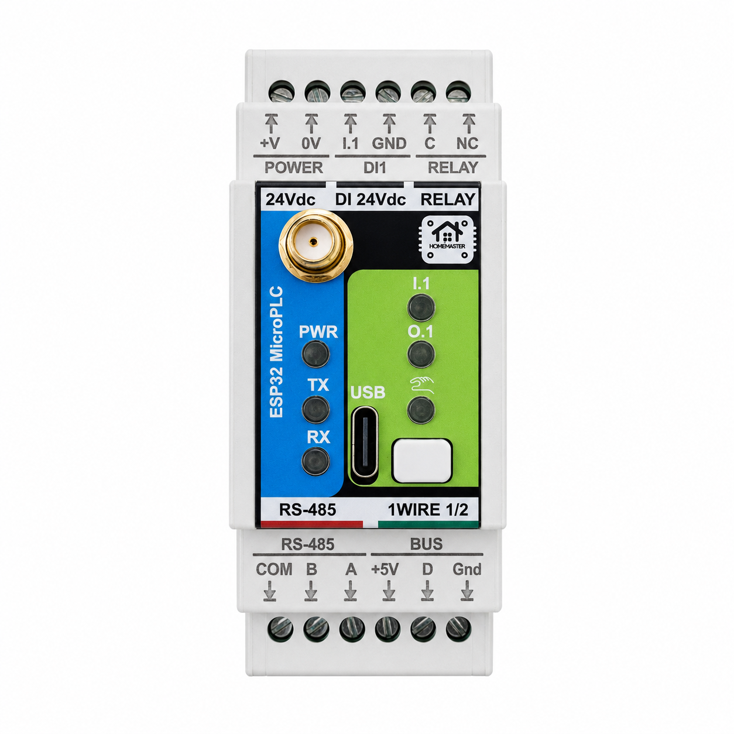
MicroPLC/Images/mplisting1_1.png
