isystemsautomation/homemaster-dev/MicroPLC/Images/mplisting2.png

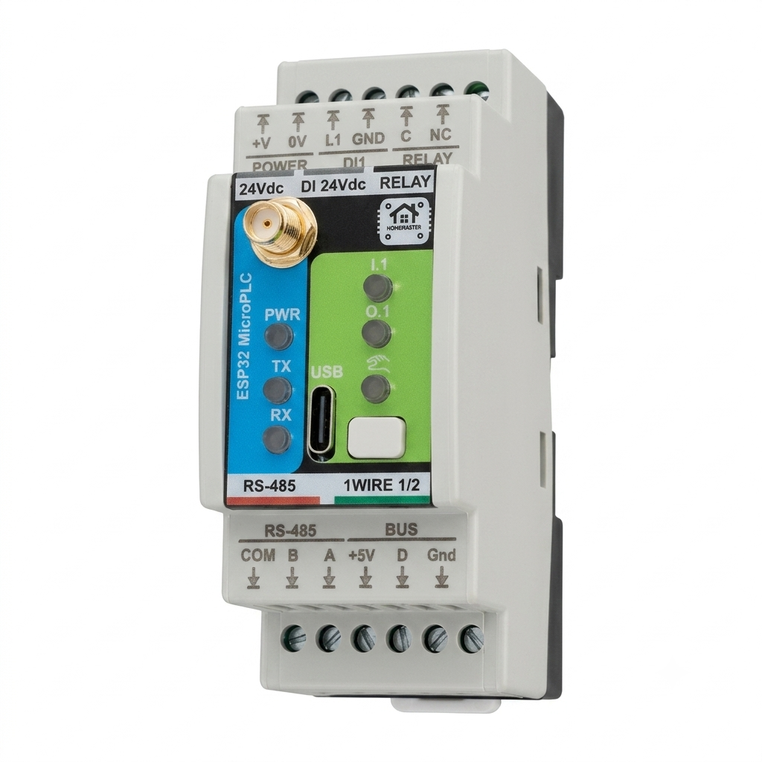
MicroPLC/Images/mplisting2.png
