isystemsautomation/homemaster-dev/MicroPLC/Images/mplisting3.png

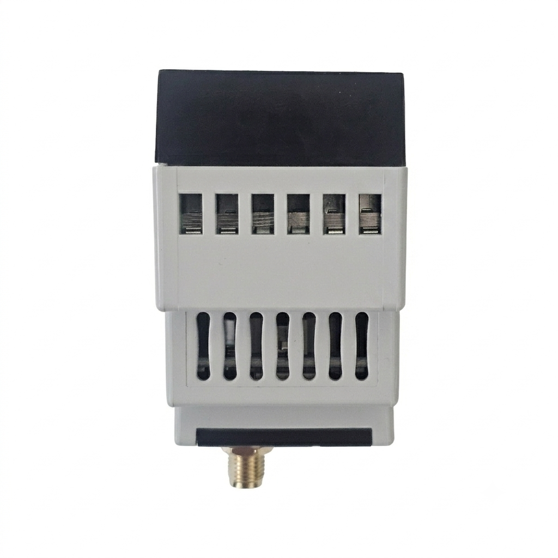
MicroPLC/Images/mplisting3.png
