isystemsautomation/homemaster-dev/MicroPLC/Images/mplisting3_1.png

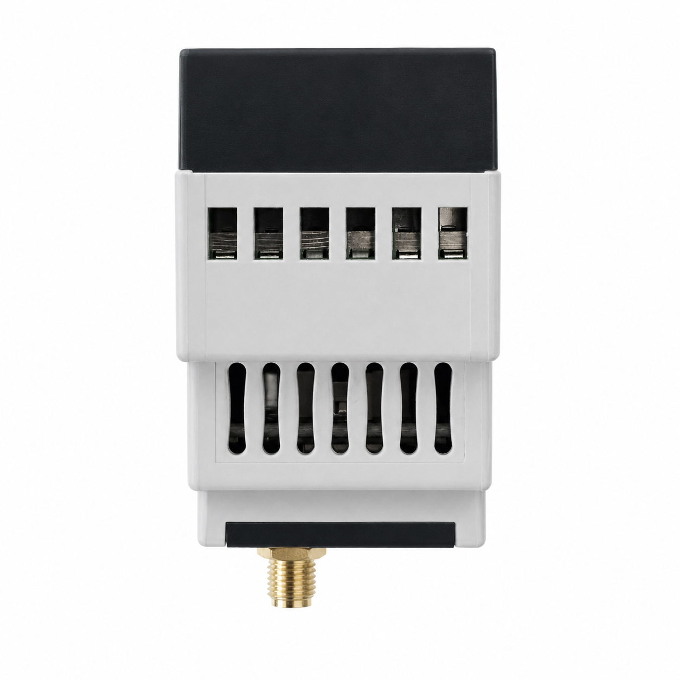
MicroPLC/Images/mplisting3_1.png
