isystemsautomation/homemaster-dev/MicroPLC/Images/mplisting4_1.png

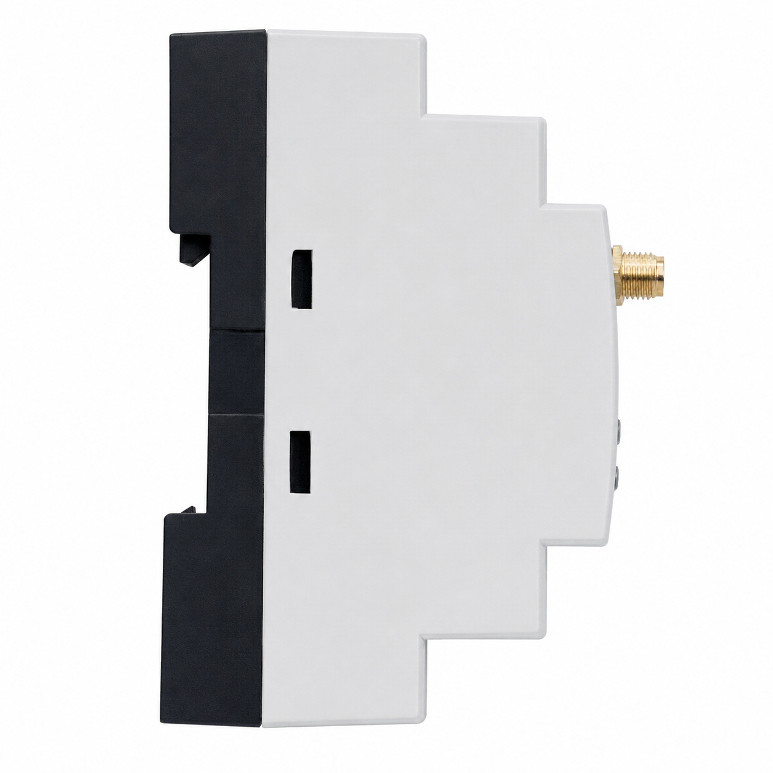
MicroPLC/Images/mplisting4_1.png
