isystemsautomation/homemaster-dev/MicroPLC/Images/scene-hydronic-heating.webp

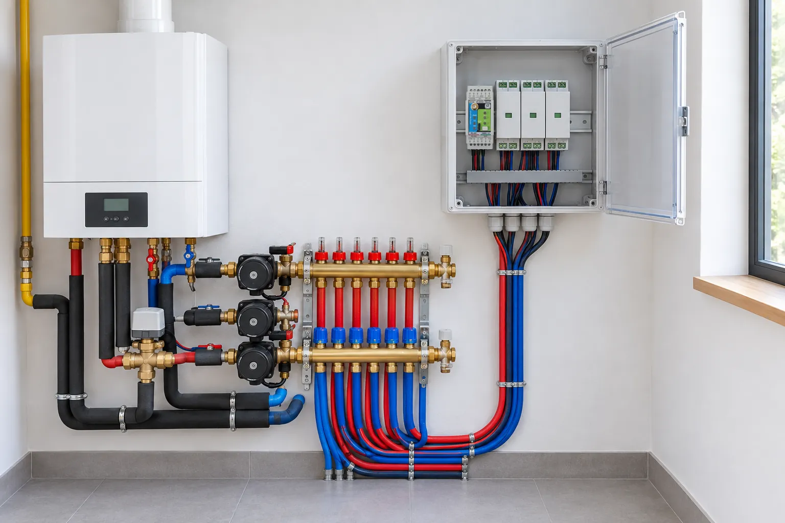
MicroPLC/Images/scene-hydronic-heating.webp
