isystemsautomation/homemaster-dev/MicroPLC/Images/scene-water-jacket.webp

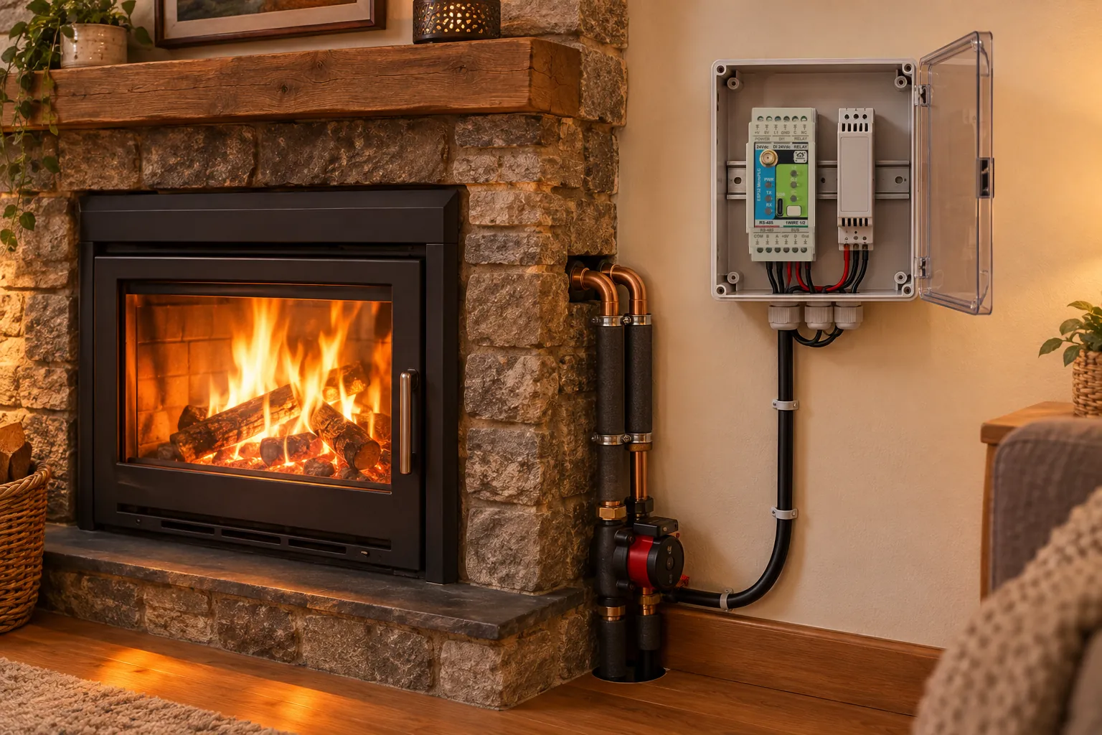
MicroPLC/Images/scene-water-jacket.webp
