isystemsautomation/homemaster-dev/MiniPLC/Images/dimension.png

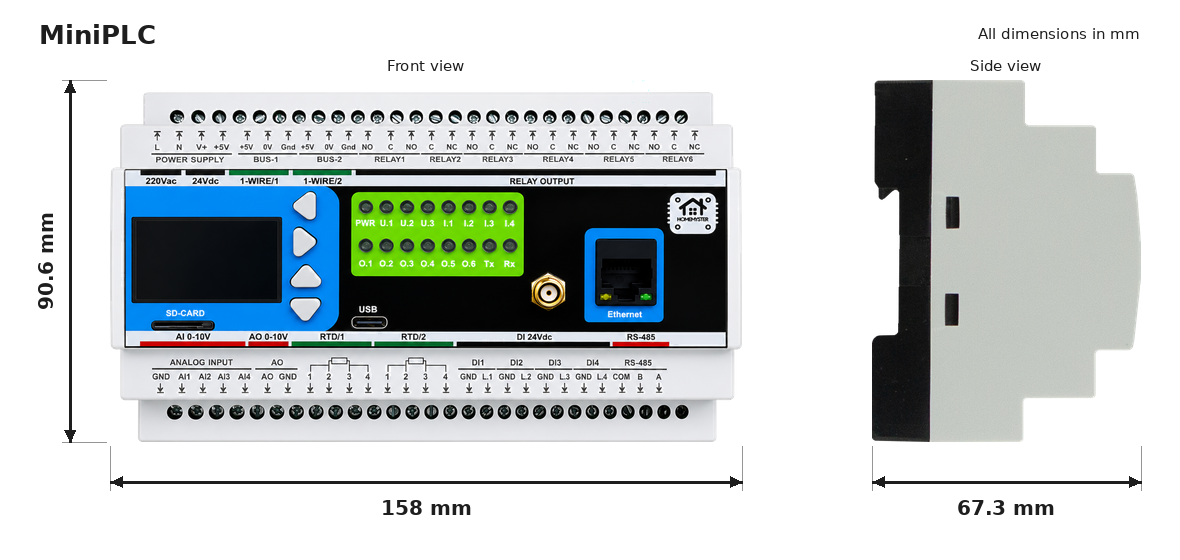
MiniPLC/Images/dimension.png
