isystemsautomation/homemaster-dev/MiniPLC/Images/miniplc_1600x1600.png

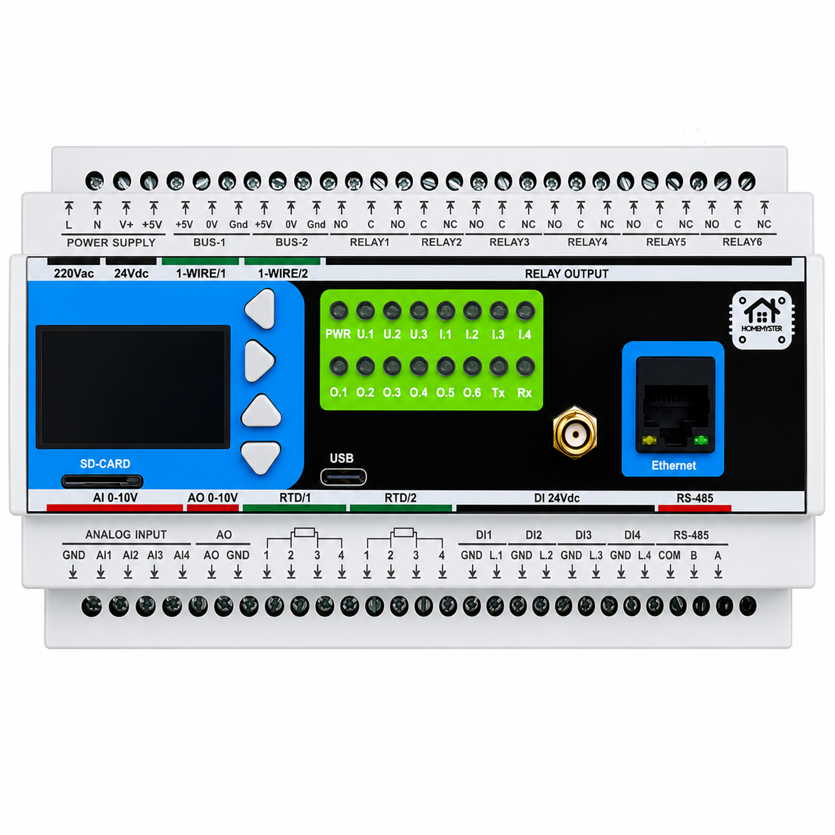
MiniPLC/Images/miniplc_1600x1600.png
