isystemsautomation/homemaster-dev/MiniPLC/Images/miniplc_site.png

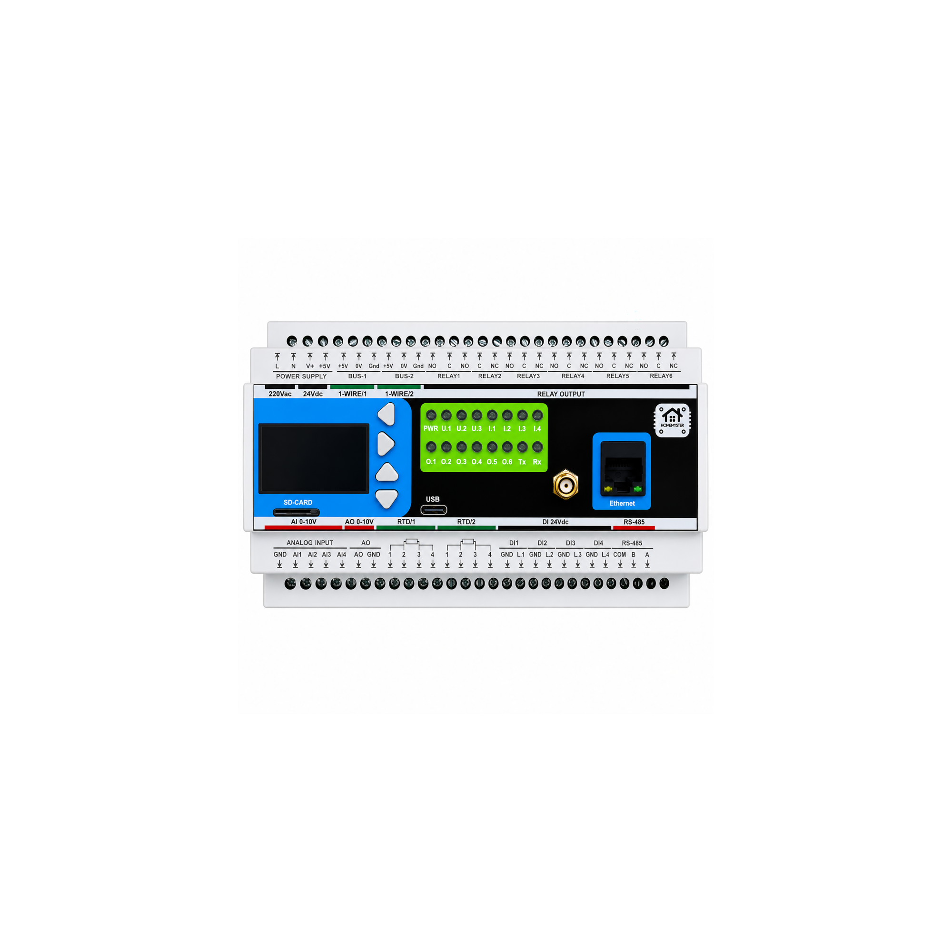
MiniPLC/Images/miniplc_site.png
