isystemsautomation/homemaster-dev/MiniPLC/Images/mplisting1.png

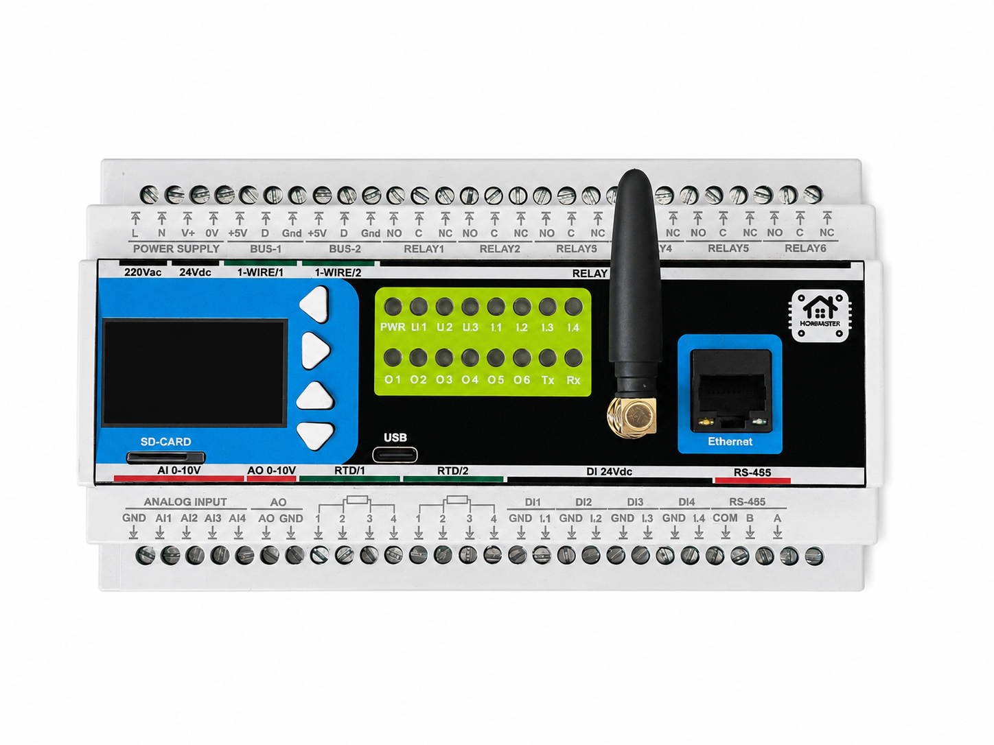
MiniPLC/Images/mplisting1.png
