isystemsautomation/homemaster-dev/MiniPLC/Images/mplisting2.png

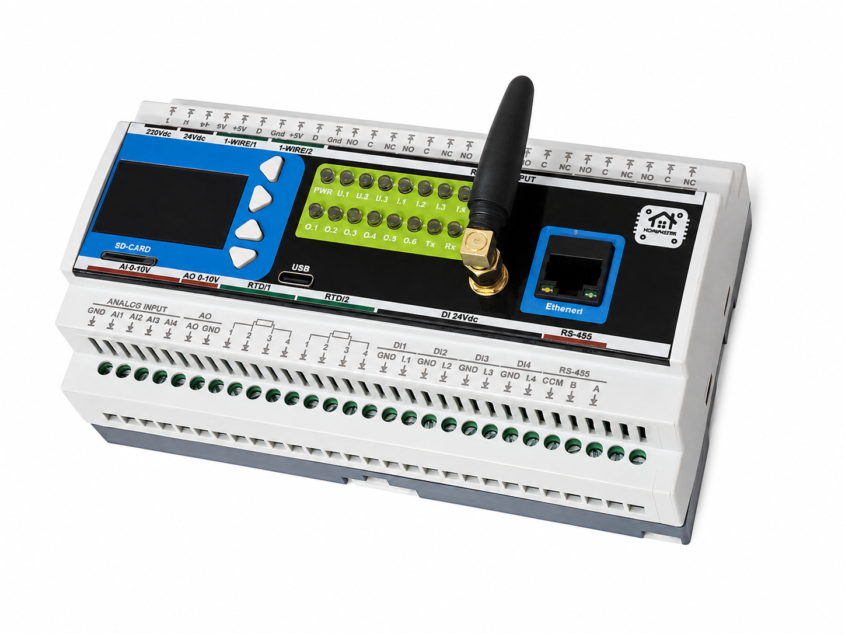
MiniPLC/Images/mplisting2.png
