isystemsautomation/homemaster-dev/MiniPLC/Images/mplisting3.png

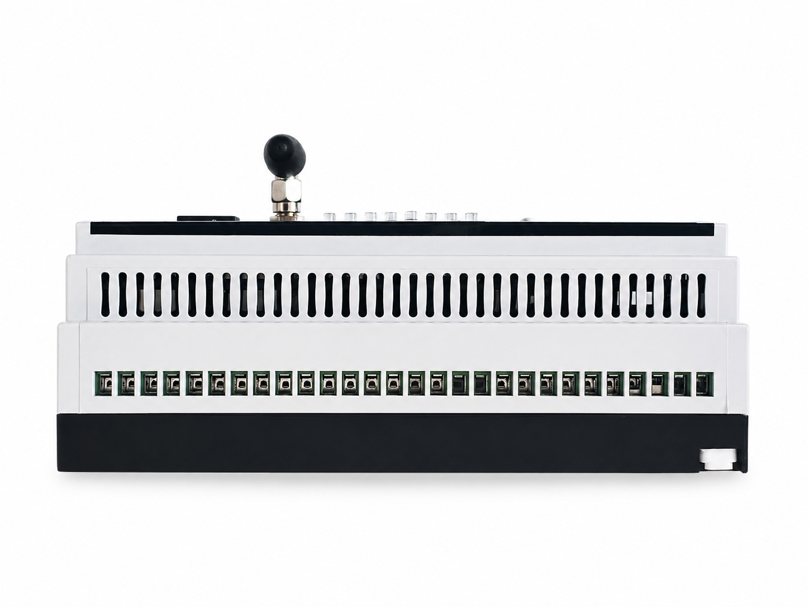
MiniPLC/Images/mplisting3.png
