isystemsautomation/homemaster-dev/MiniPLC/Images/Photo1_512kb.png

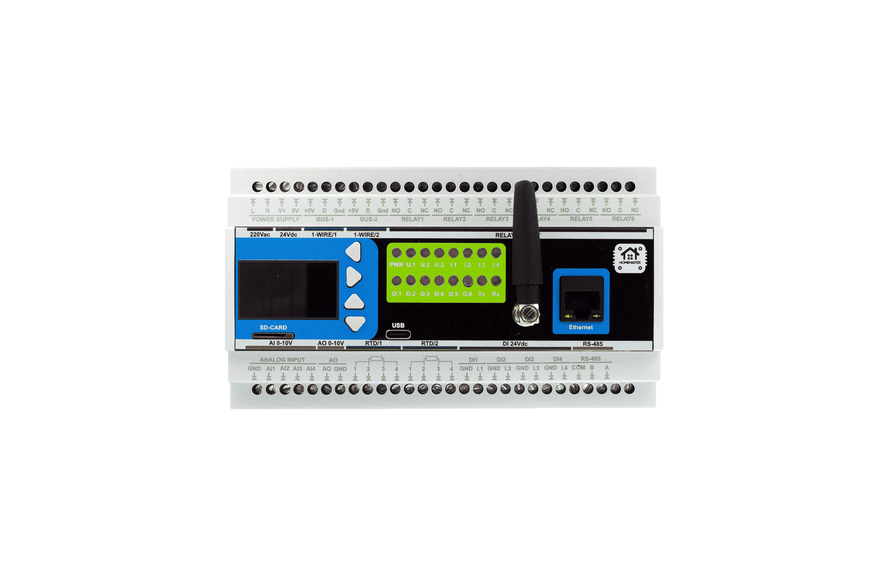
MiniPLC/Images/Photo1_512kb.png
