isystemsautomation/homemaster-dev/MiniPLC/Images/scene-boiler-room.webp

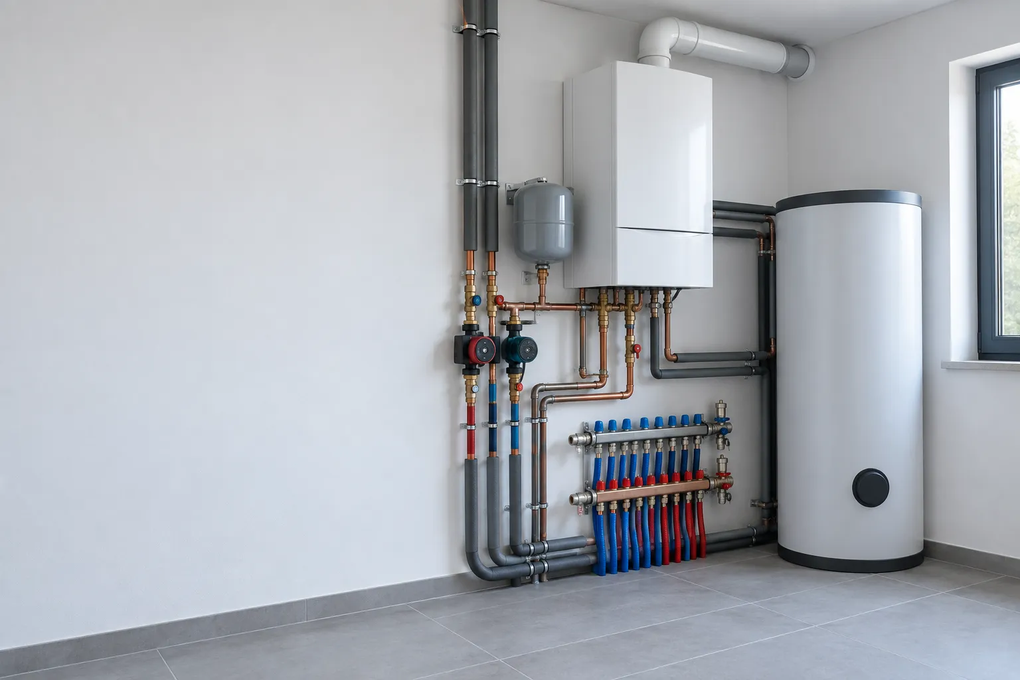
MiniPLC/Images/scene-boiler-room.webp
