isystemsautomation/homemaster-dev/MiniPLC/Images/scene-greenhouse.webp

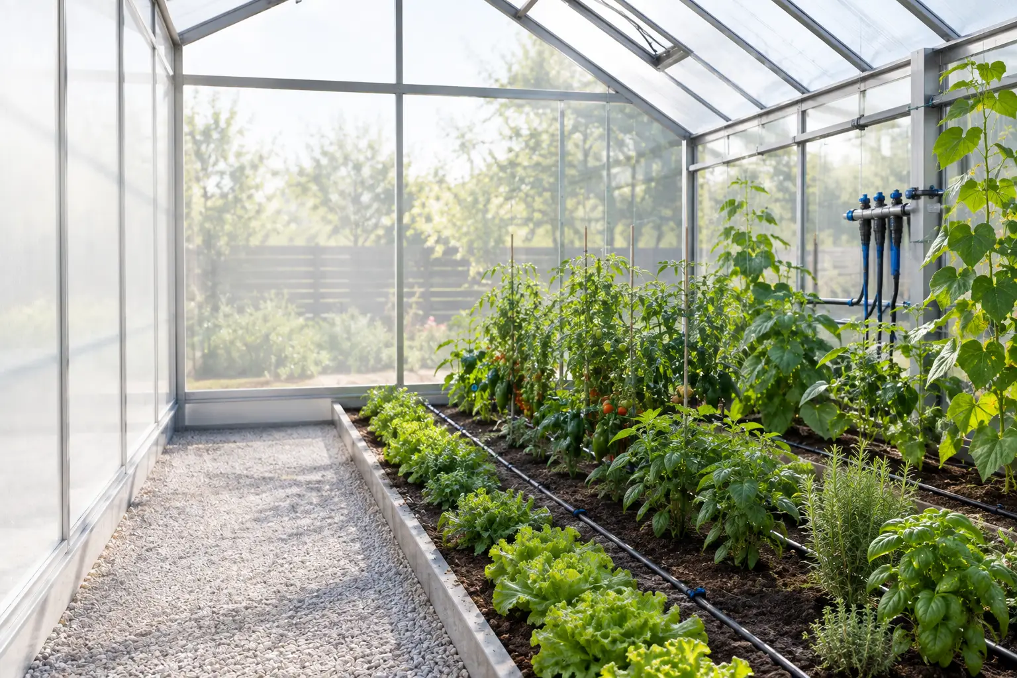
MiniPLC/Images/scene-greenhouse.webp
