isystemsautomation/homemaster-dev/MiniPLC/Images/scene-living-room-evening.webp

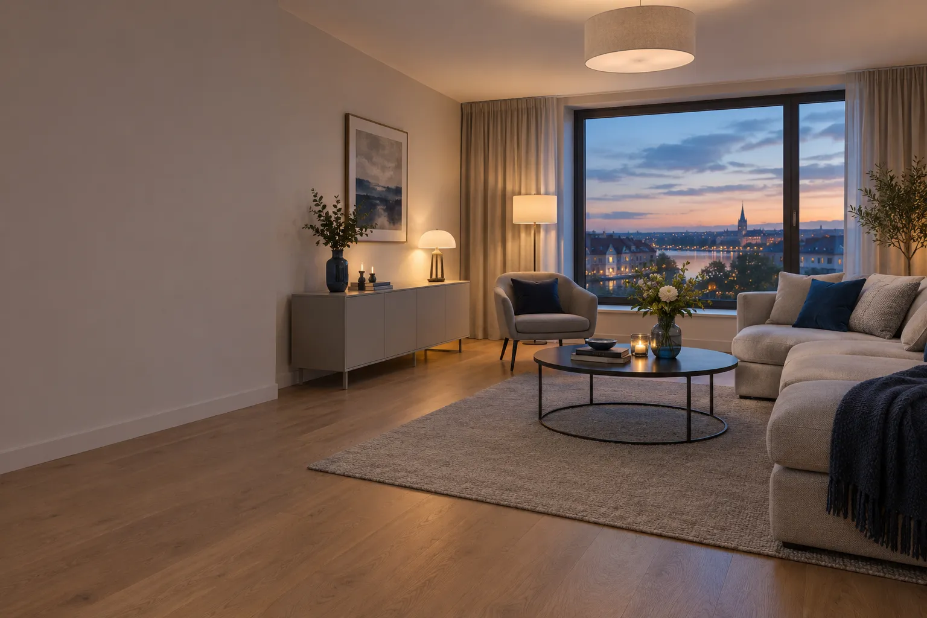
MiniPLC/Images/scene-living-room-evening.webp
