isystemsautomation/homemaster-dev/MiniPLC/Images/scene-ventilation-attic.webp

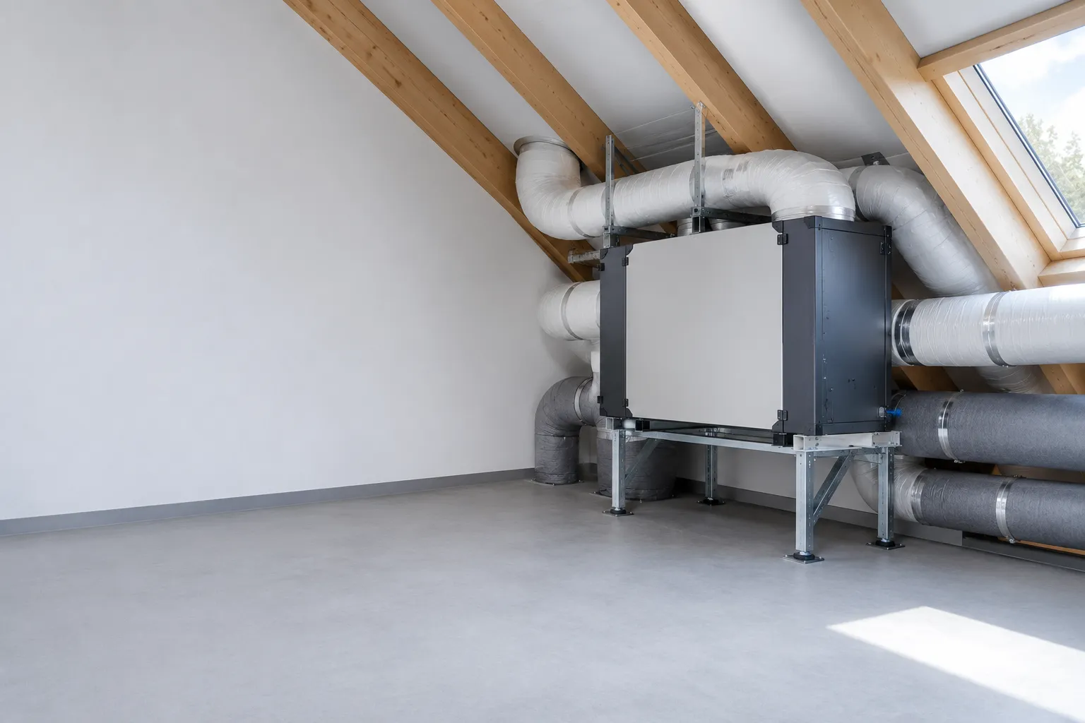
MiniPLC/Images/scene-ventilation-attic.webp
