isystemsautomation/homemaster-dev/news/firmware-update-en-18031-provisioning/miniplc-microplc-opentherm-din-rail.png

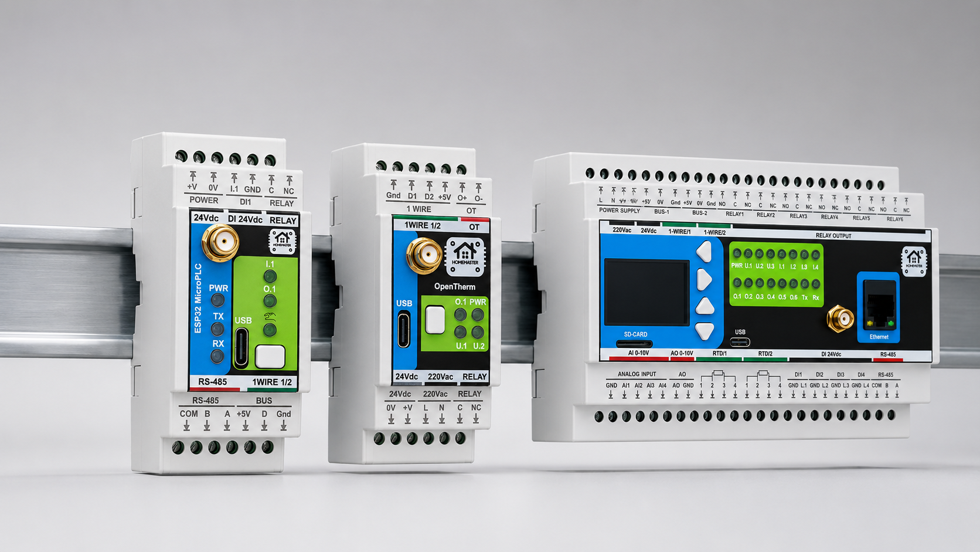
news/firmware-update-en-18031-provisioning/miniplc-microplc-opentherm-din-rail.png
