isystemsautomation/homemaster-dev/OpenthermGateway/Images/device-info-firmware-1.1.0.png

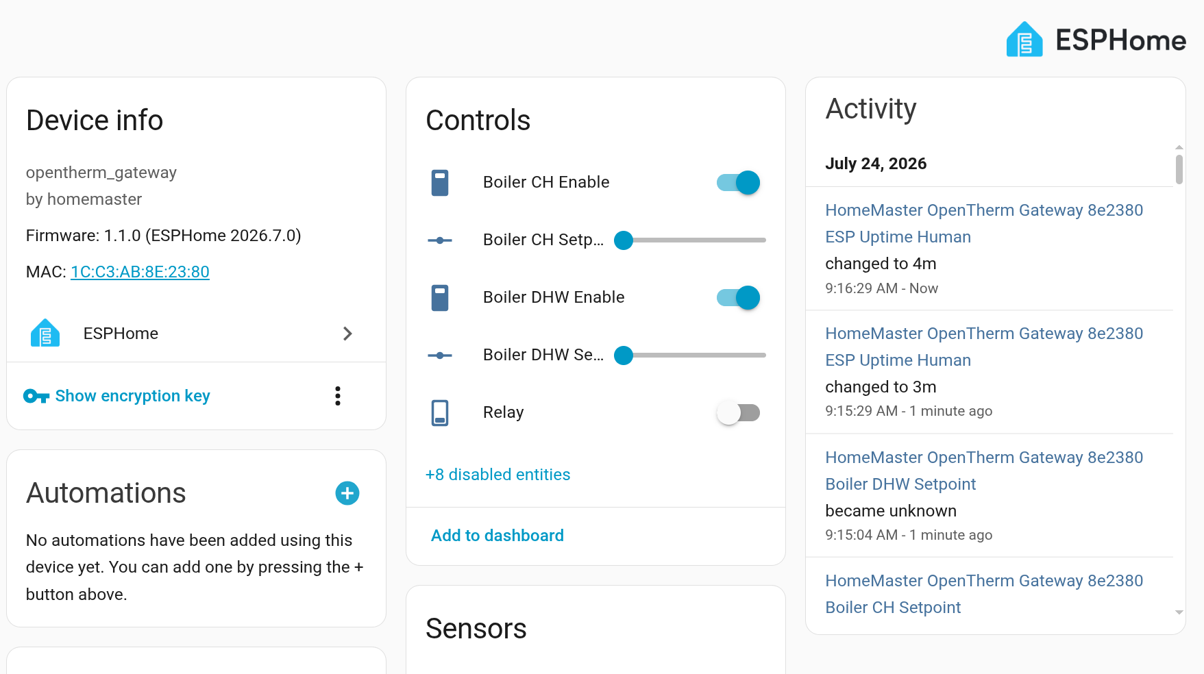
OpenthermGateway/Images/device-info-firmware-1.1.0.png
