isystemsautomation/homemaster-dev/OpenthermGateway/Images/encryption-key-dialog.png

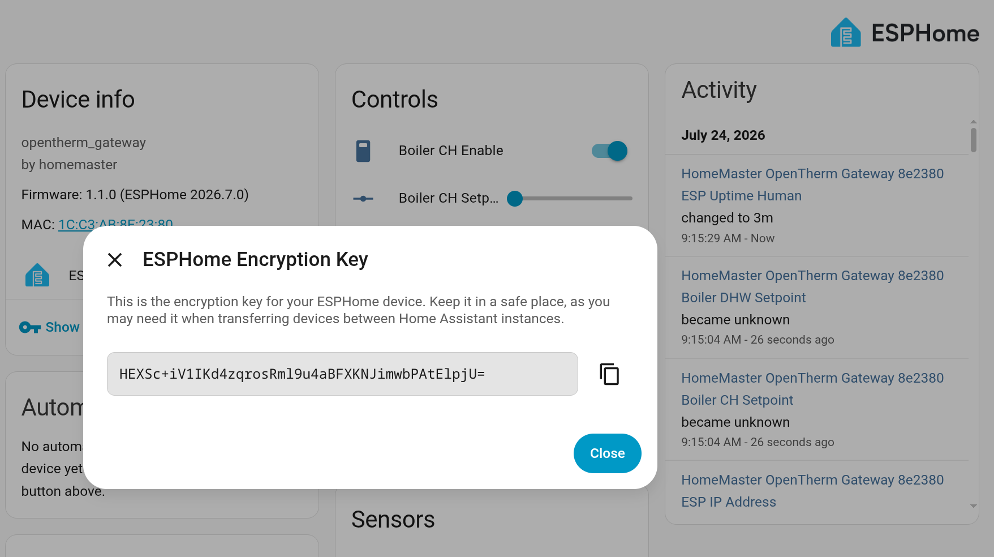
OpenthermGateway/Images/encryption-key-dialog.png
