isystemsautomation/homemaster-dev/OpenthermGateway/Images/firmware_update.png

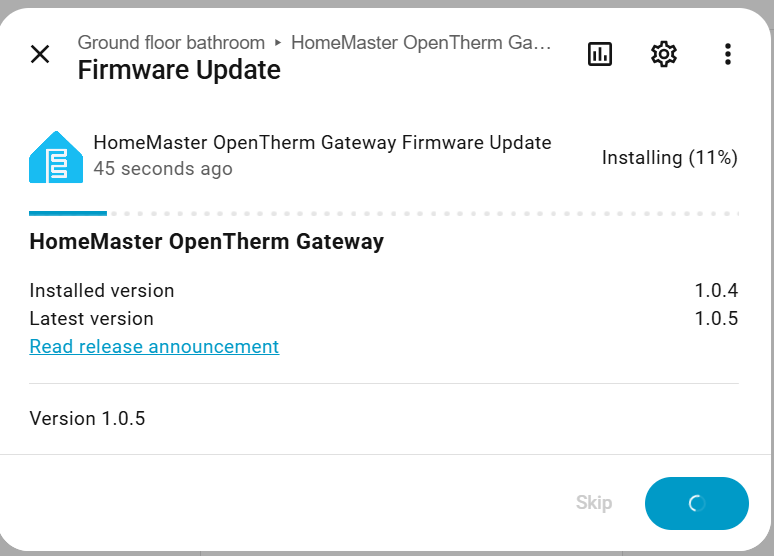
OpenthermGateway/Images/firmware_update.png
