isystemsautomation/homemaster-dev/OpenthermGateway/Images/mplisting2.png

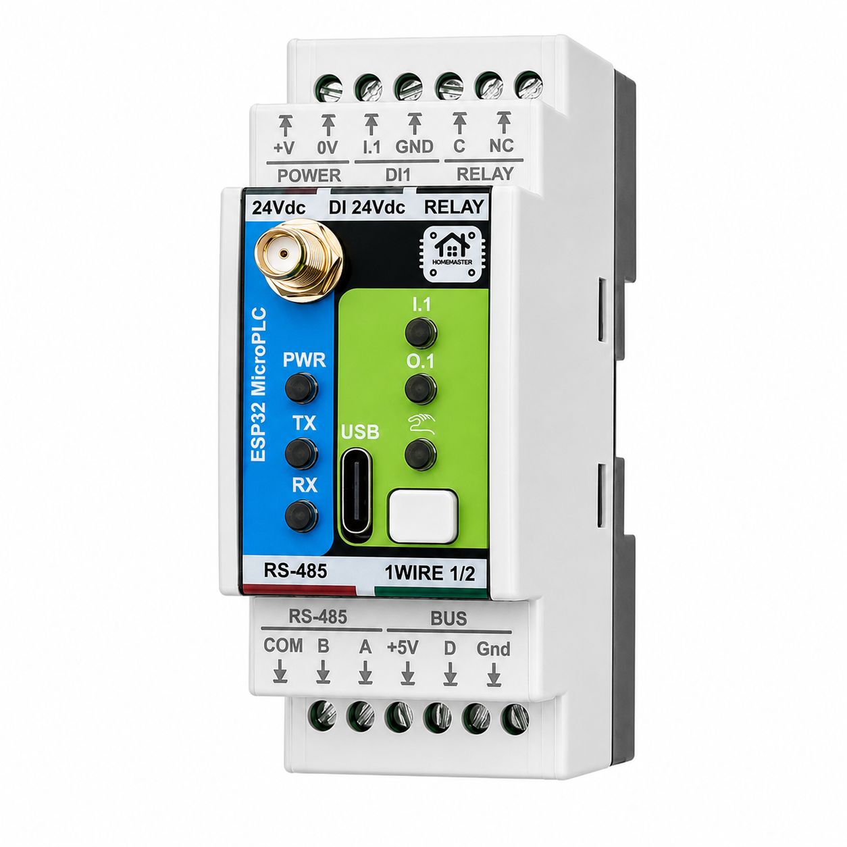
OpenthermGateway/Images/mplisting2.png
