isystemsautomation/homemaster-dev/OpenthermGateway/Images/mplisting3.png

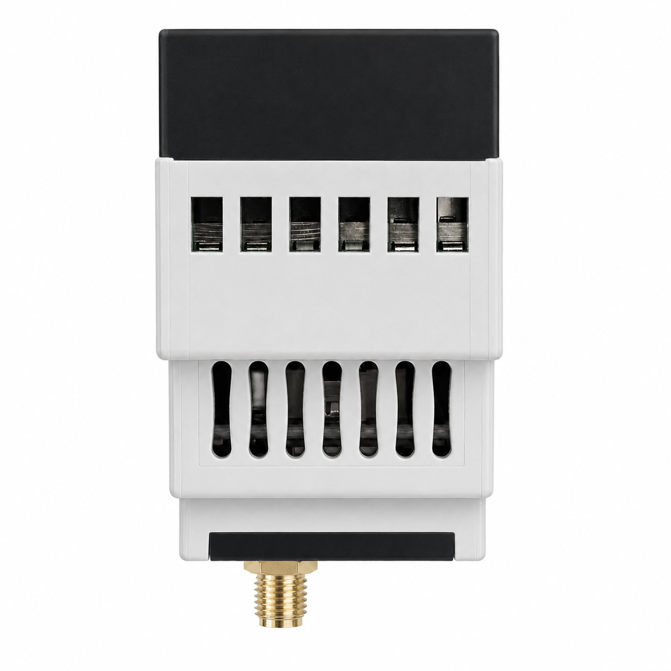
OpenthermGateway/Images/mplisting3.png
