isystemsautomation/homemaster-dev/OpenthermGateway/Images/mplisting4.png

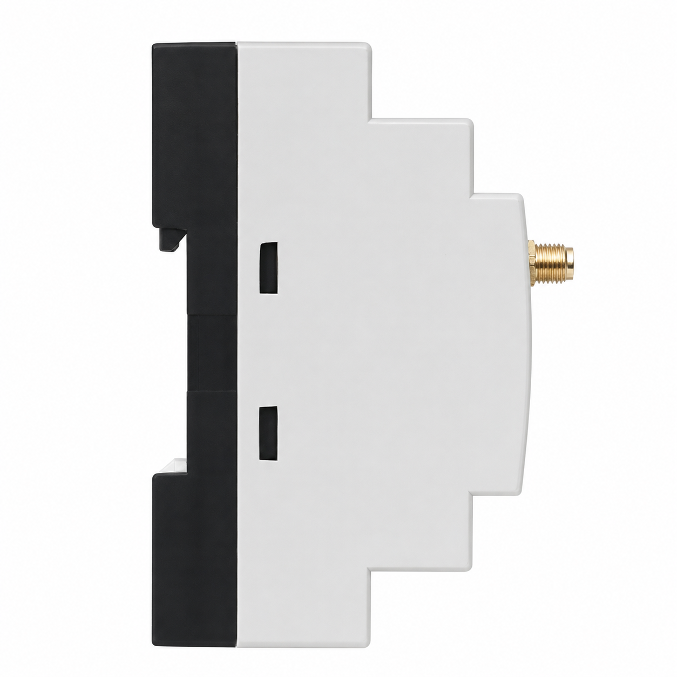
OpenthermGateway/Images/mplisting4.png
