isystemsautomation/homemaster-dev/OpenthermGateway/Images/OpenTherm_RelayConnection.png

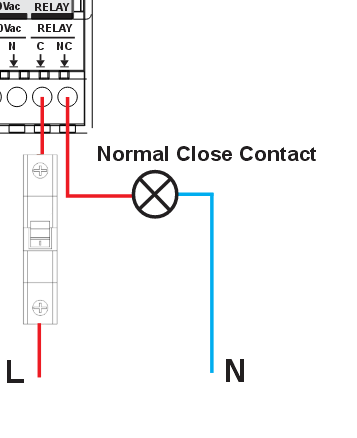
OpenthermGateway/Images/OpenTherm_RelayConnection.png
