isystemsautomation/homemaster-dev/OpenthermGateway/Images/opentherm_render.png

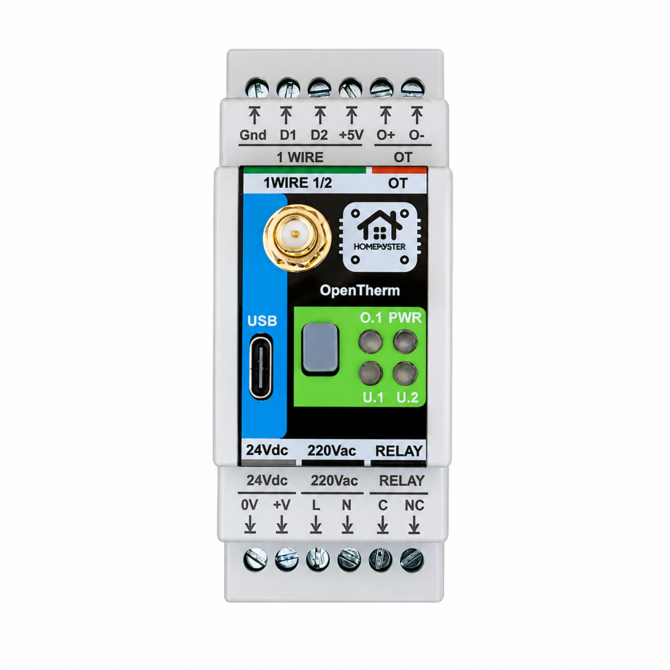
OpenthermGateway/Images/opentherm_render.png
