isystemsautomation/homemaster-dev/OpenthermGateway/Images/take-control-discovery.png

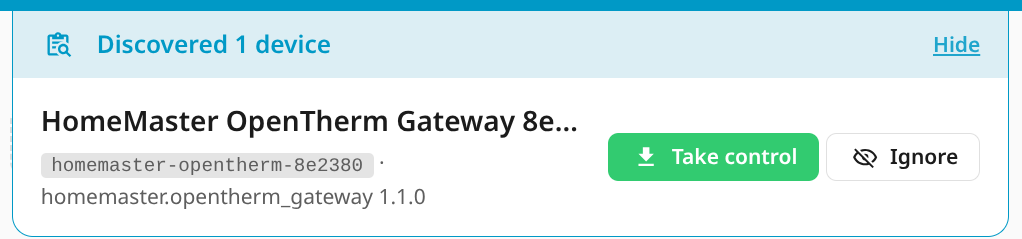
OpenthermGateway/Images/take-control-discovery.png
