isystemsautomation/homemaster-dev/OpenthermThermostat/Images/20261108_193600.jpg

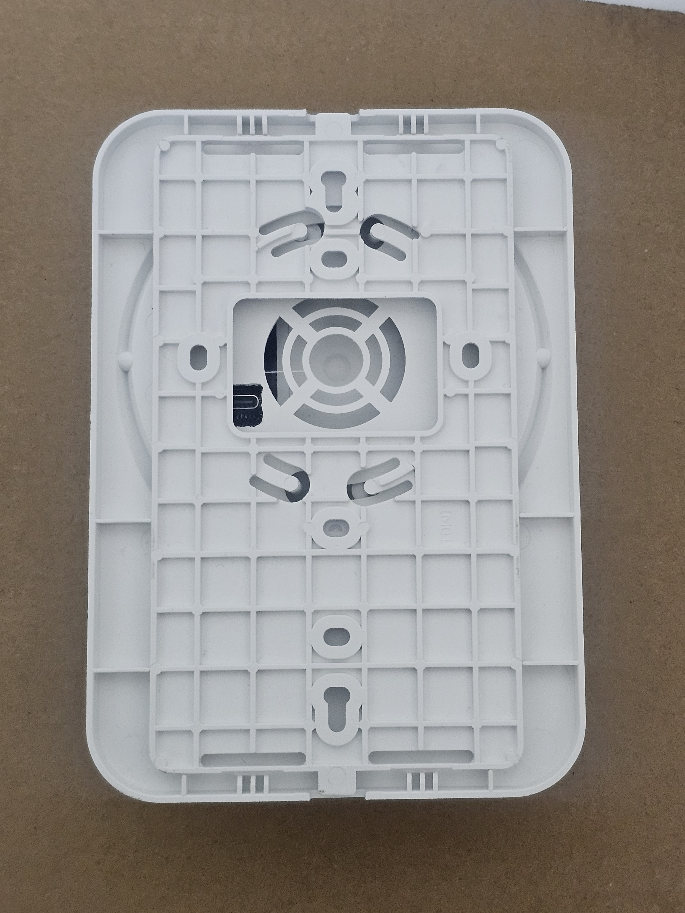
OpenthermThermostat/Images/20261108_193600.jpg
