isystemsautomation/homemaster-dev/OpenthermThermostat/Images/20261108_193616.jpg

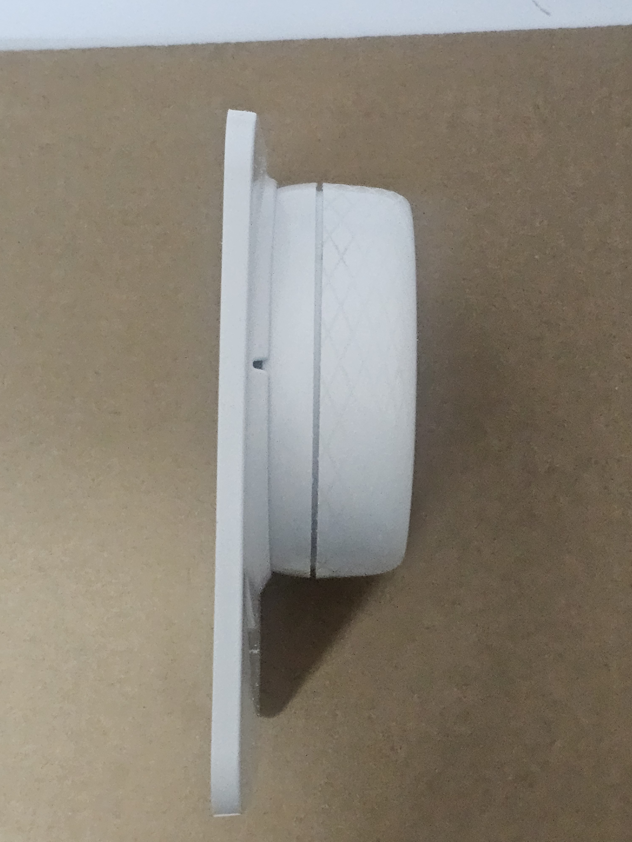
OpenthermThermostat/Images/20261108_193616.jpg
