isystemsautomation/homemaster-dev/OpenthermThermostat/Images/20261108_193641.jpg

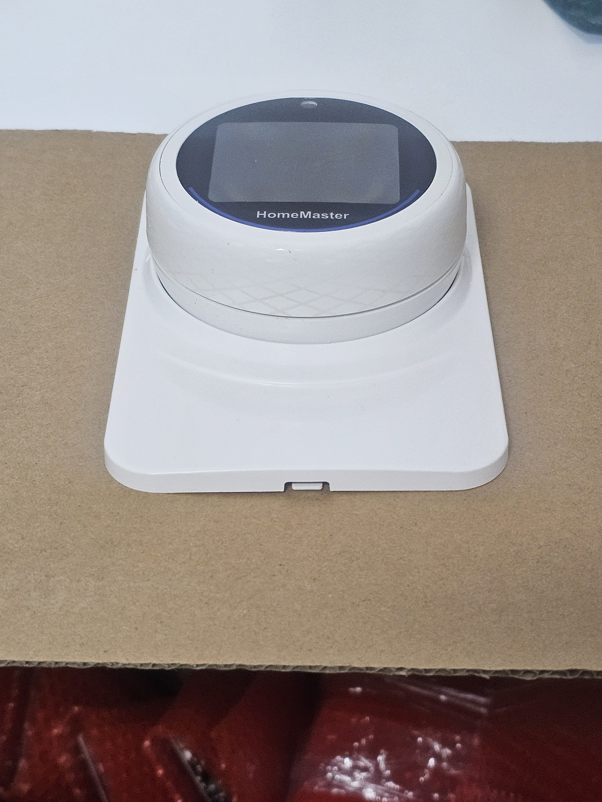
OpenthermThermostat/Images/20261108_193641.jpg
