isystemsautomation/homemaster-dev/OpenthermThermostat/Images/20261108_194113.jpg

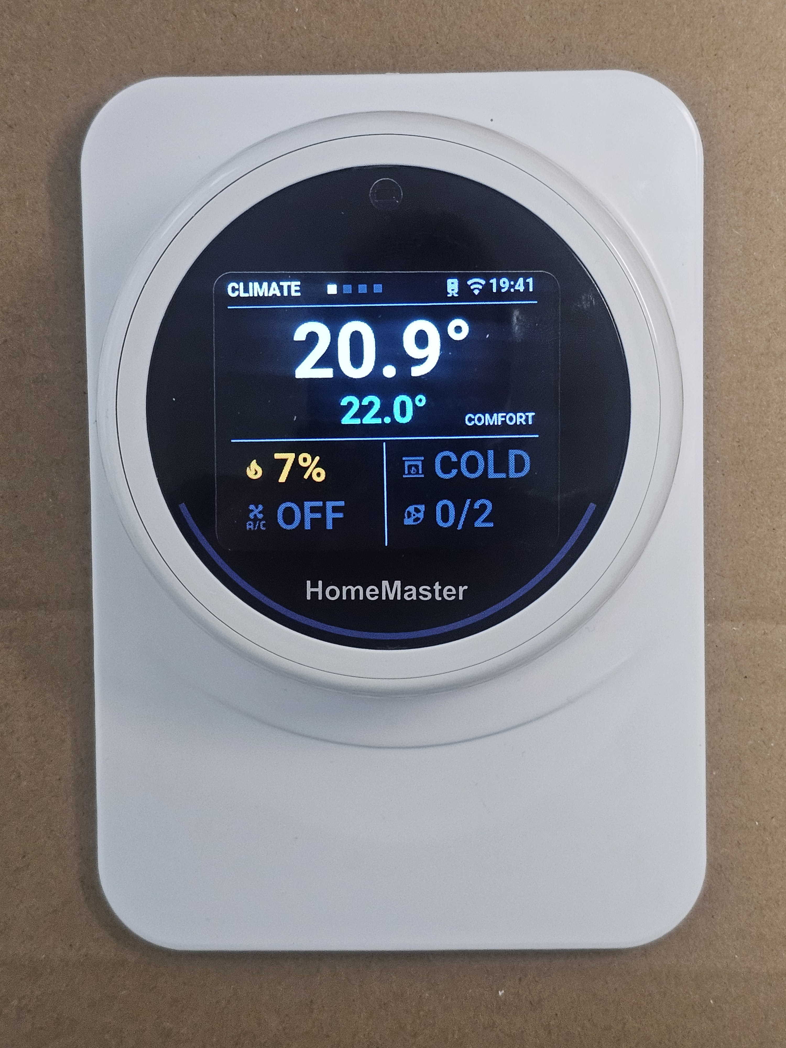
OpenthermThermostat/Images/20261108_194113.jpg
