isystemsautomation/homemaster-dev/OpenthermThermostat/Images/20261108_194122.jpg

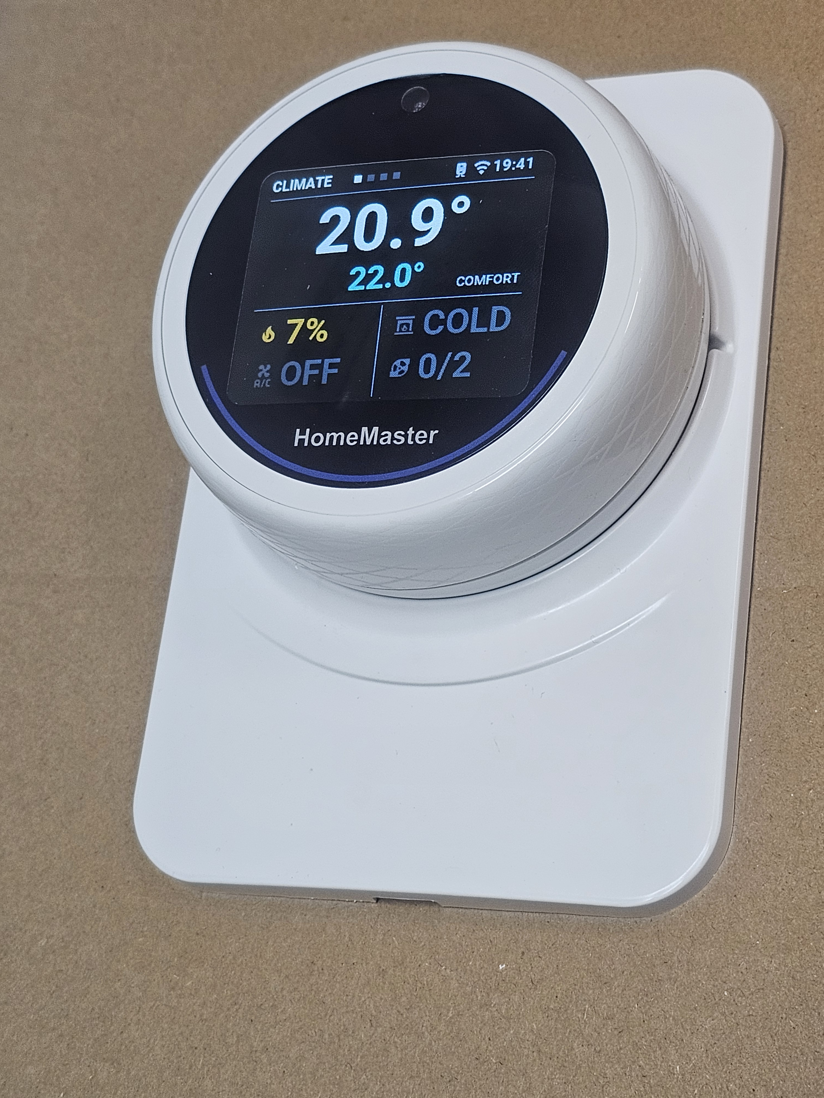
OpenthermThermostat/Images/20261108_194122.jpg
