isystemsautomation/homemaster-dev/OpenthermThermostat/Images/ha/ha-configuration.png

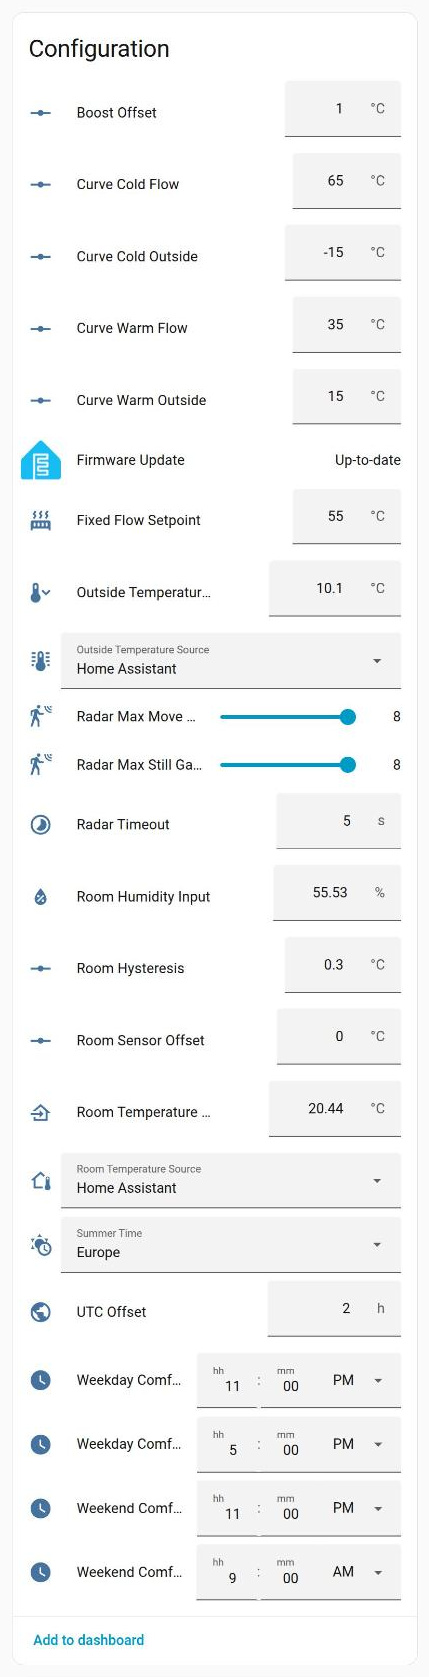
OpenthermThermostat/Images/ha/ha-configuration.png
