isystemsautomation/homemaster-dev/OpenthermThermostat/Images/ha/ha-controls.png

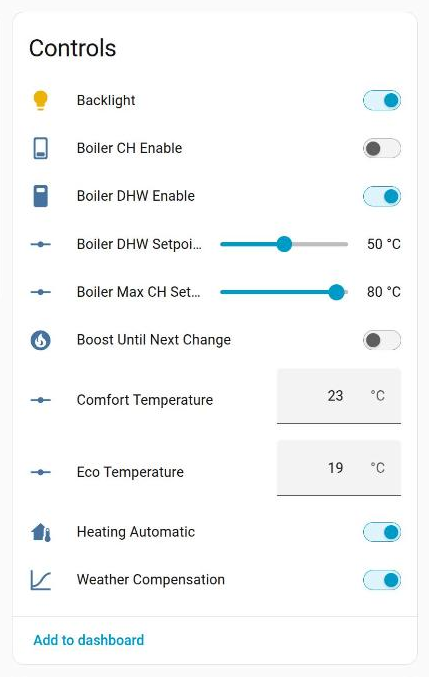
OpenthermThermostat/Images/ha/ha-controls.png
