isystemsautomation/homemaster-dev/OpenthermThermostat/Images/ha/ha-device-page.png

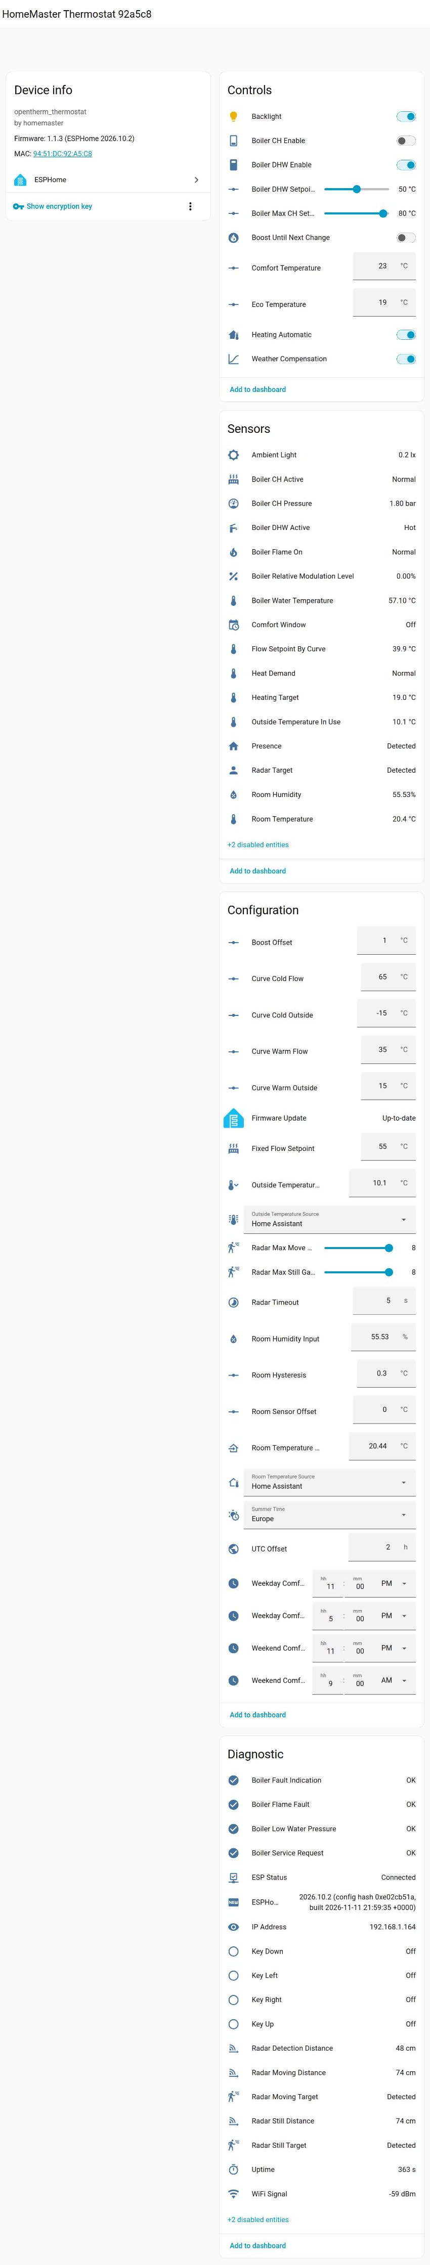
OpenthermThermostat/Images/ha/ha-device-page.png
