isystemsautomation/homemaster-dev/OpenthermThermostat/Images/ha/ha-diagnostic.png

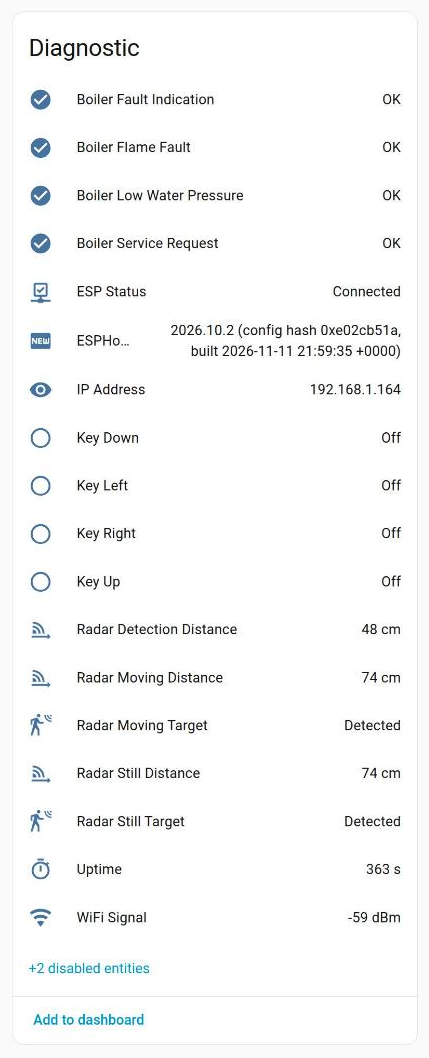
OpenthermThermostat/Images/ha/ha-diagnostic.png
