isystemsautomation/homemaster-dev/OpenthermThermostat/Images/ha/ha-inputs.png

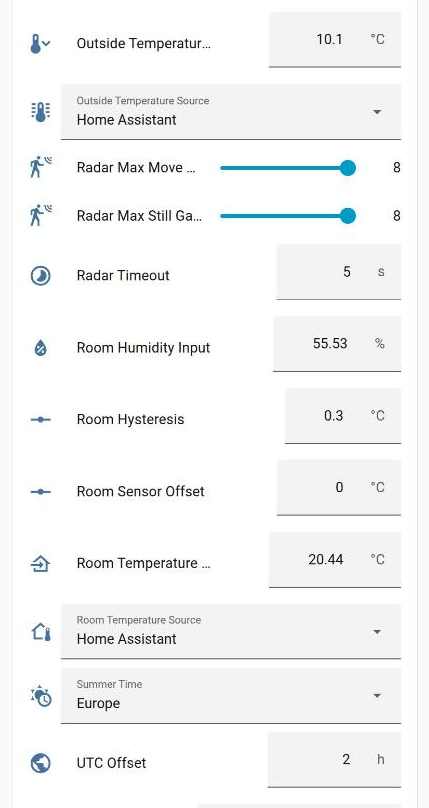
OpenthermThermostat/Images/ha/ha-inputs.png
