isystemsautomation/homemaster-dev/OpenthermThermostat/Images/ha/ha-sensors.png

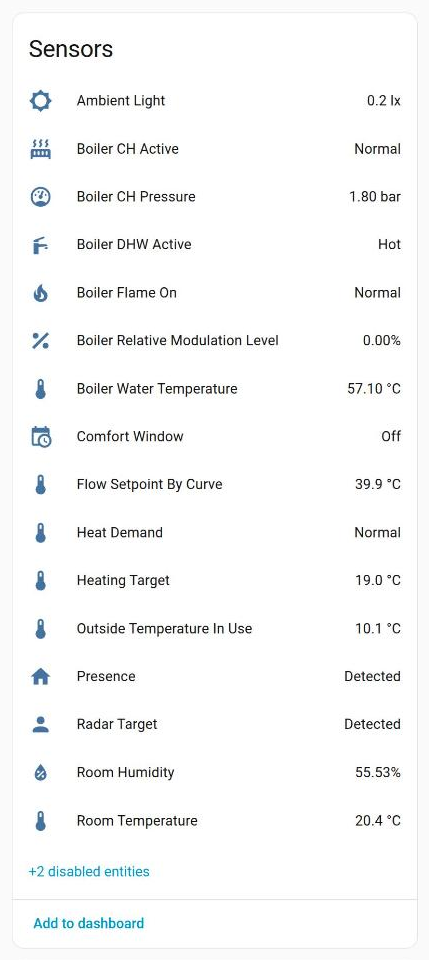
OpenthermThermostat/Images/ha/ha-sensors.png
