isystemsautomation/homemaster-dev/OpenthermThermostat/Images/page/ott-boiler.webp

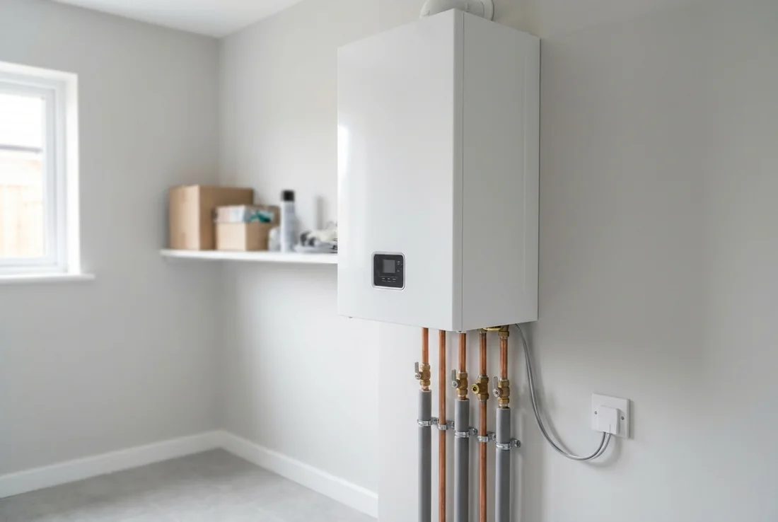
OpenthermThermostat/Images/page/ott-boiler.webp
