isystemsautomation/homemaster-dev/OpenthermThermostat/Images/page/ott-door.webp

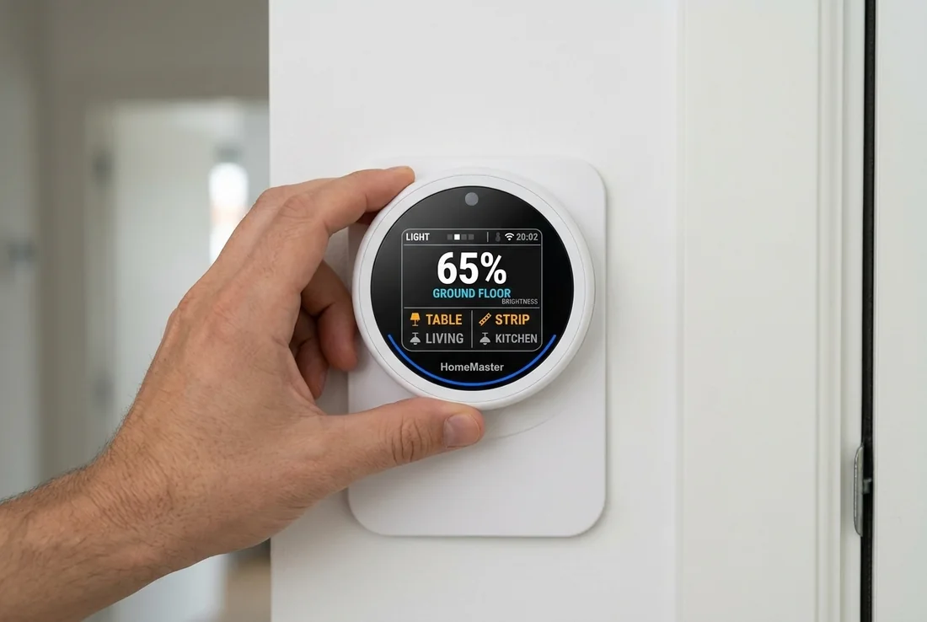
OpenthermThermostat/Images/page/ott-door.webp
