isystemsautomation/homemaster-dev/OpenthermThermostat/Images/page/ott-hero.webp

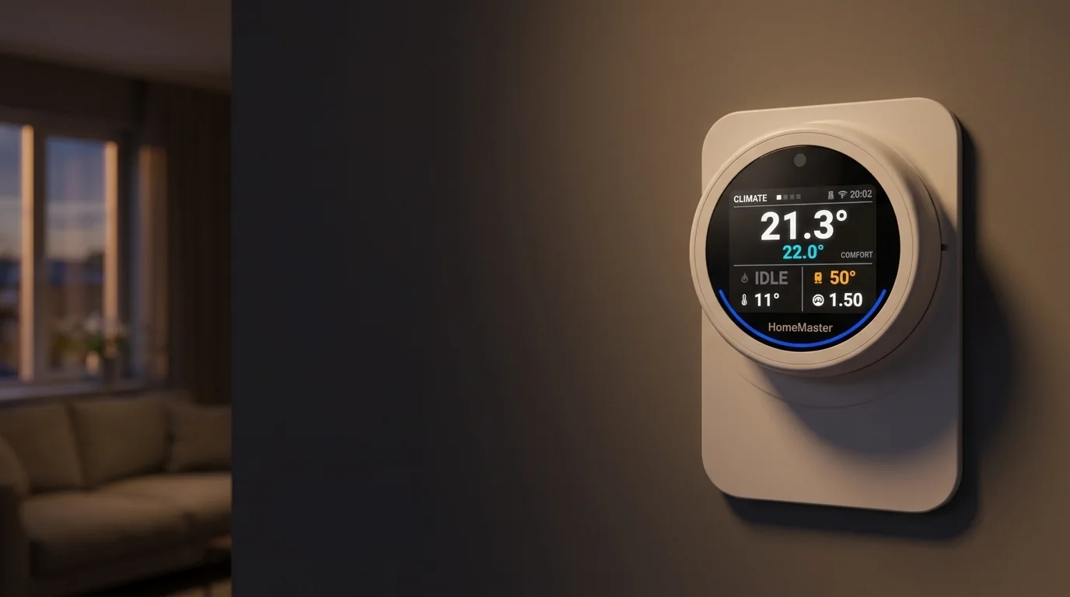
OpenthermThermostat/Images/page/ott-hero.webp
