isystemsautomation/homemaster-dev/OpenthermThermostat/Images/page/ott-presence.webp

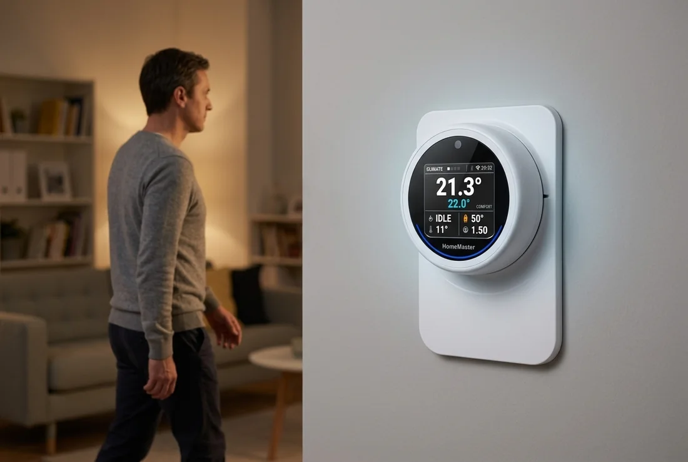
OpenthermThermostat/Images/page/ott-presence.webp
