isystemsautomation/homemaster-dev/OpenthermThermostat/Images/page/screen-light.webp

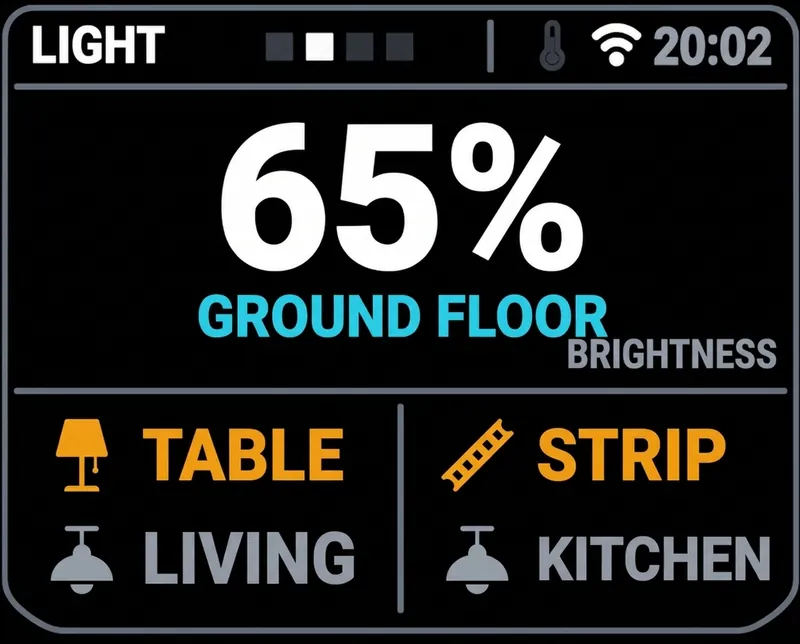
OpenthermThermostat/Images/page/screen-light.webp
