isystemsautomation/homemaster-dev/OpenthermThermostat/Images/page/screen-solar.webp

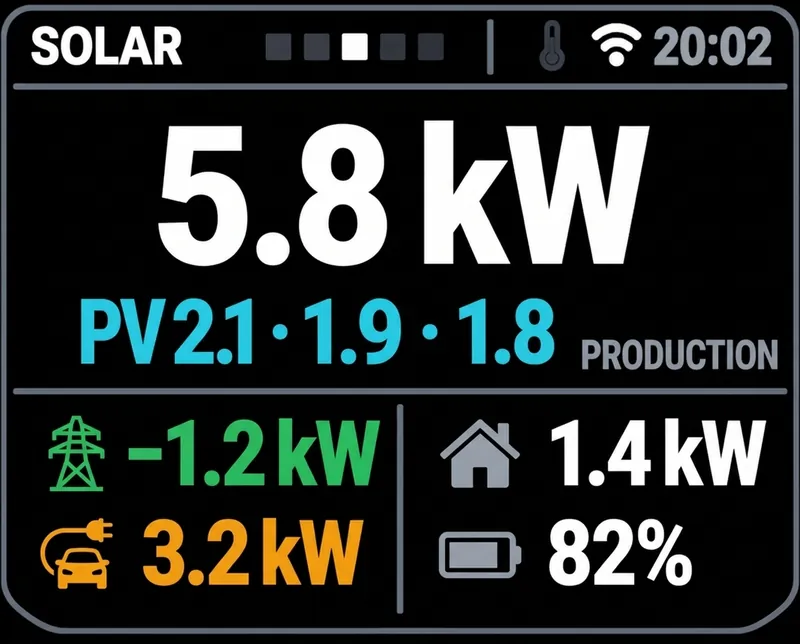
OpenthermThermostat/Images/page/screen-solar.webp
