isystemsautomation/homemaster-dev/OpenthermThermostat/Images/screen-boiler.png

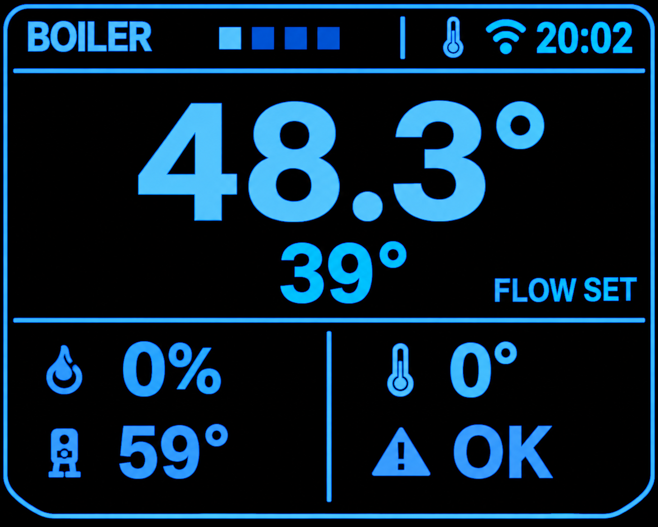
OpenthermThermostat/Images/screen-boiler.png
