isystemsautomation/homemaster-dev/OpenthermThermostat/Images/screen-schedule.png

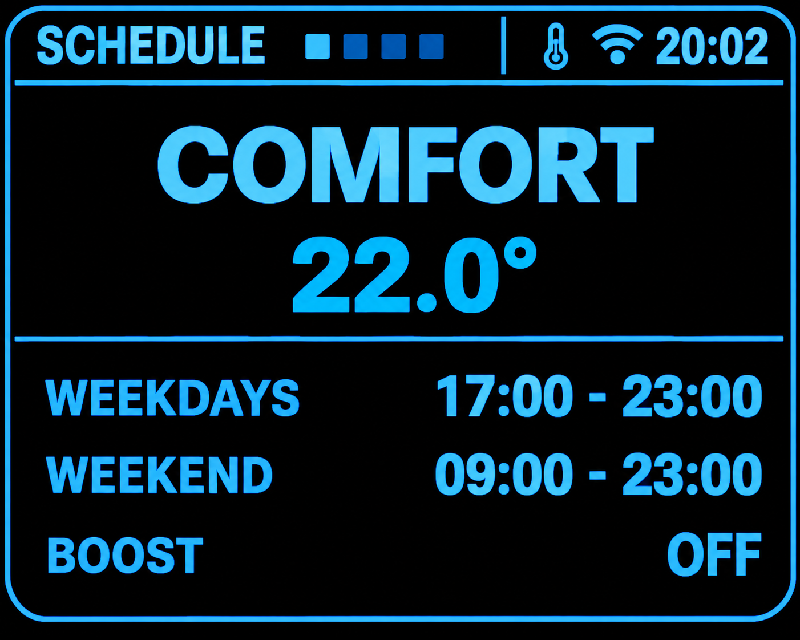
OpenthermThermostat/Images/screen-schedule.png
