isystemsautomation/homemaster-dev/OpenthermThermostat/Images/screen-system.png

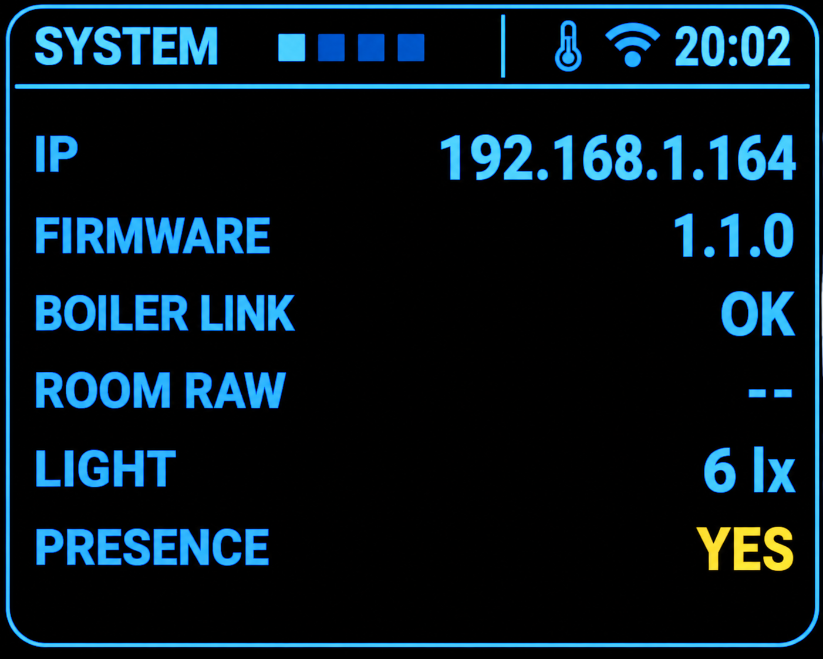
OpenthermThermostat/Images/screen-system.png
