isystemsautomation/homemaster-dev/OpenthermThermostat/Images/screens/screen-boiler.png

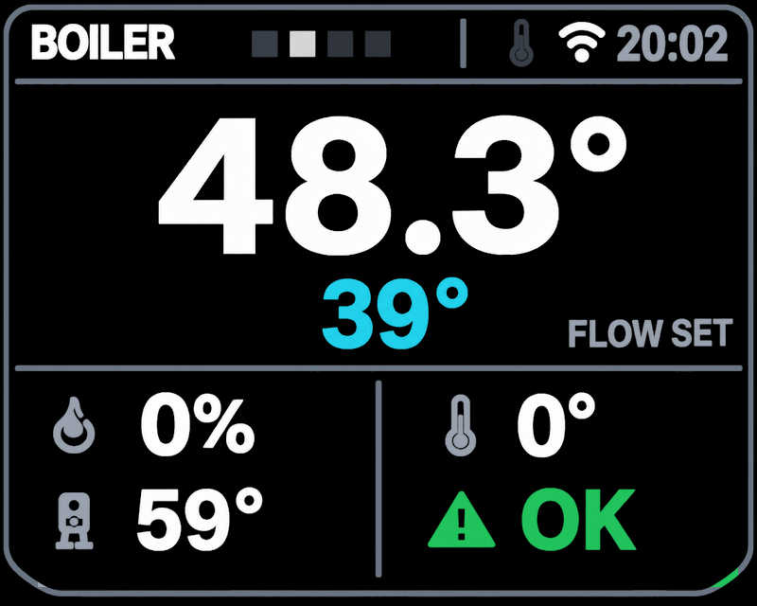
OpenthermThermostat/Images/screens/screen-boiler.png
