isystemsautomation/homemaster-dev/OpenthermThermostat/Images/screens/screen-schedule.png

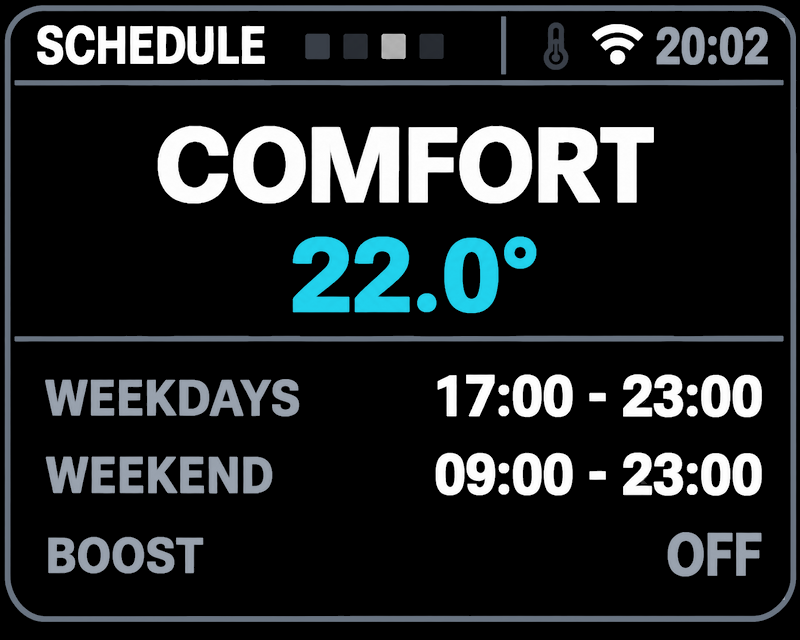
OpenthermThermostat/Images/screens/screen-schedule.png
