isystemsautomation/homemaster-dev/OpenthermThermostat/Images/screens/screen-system.png

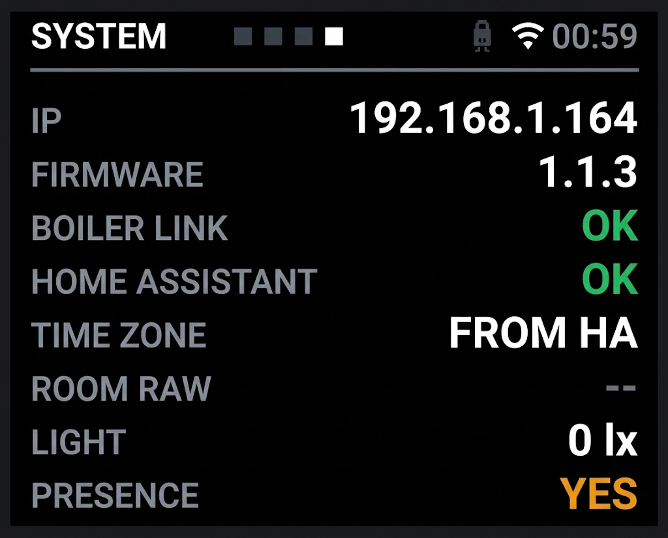
OpenthermThermostat/Images/screens/screen-system.png
