isystemsautomation/homemaster-dev/OpenthermThermostat/Images/thermostat-angle-2.jpg

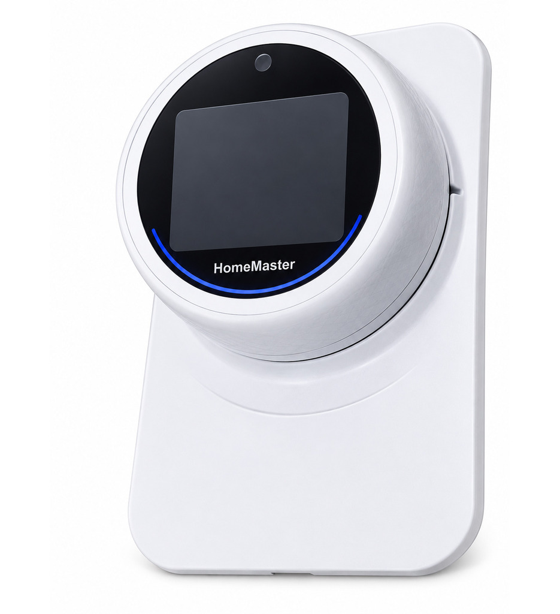
OpenthermThermostat/Images/thermostat-angle-2.jpg
