isystemsautomation/homemaster-dev/OpenthermThermostat/Images/thermostat-angle-3.jpg

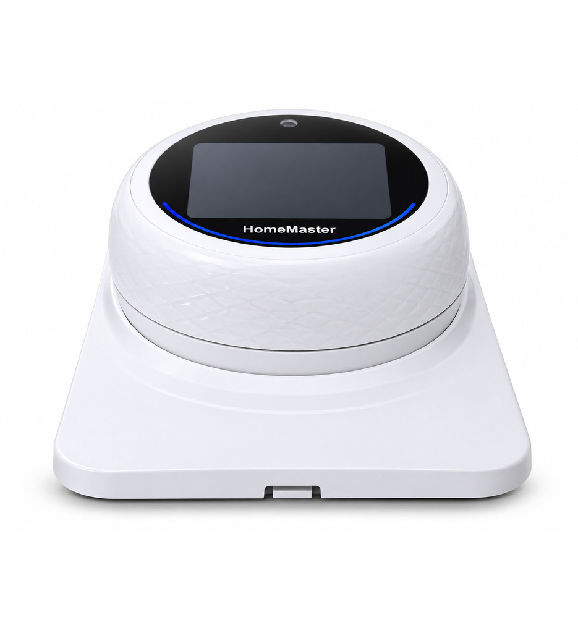
OpenthermThermostat/Images/thermostat-angle-3.jpg
