isystemsautomation/homemaster-dev/OpenthermThermostat/Images/thermostat-back.jpg

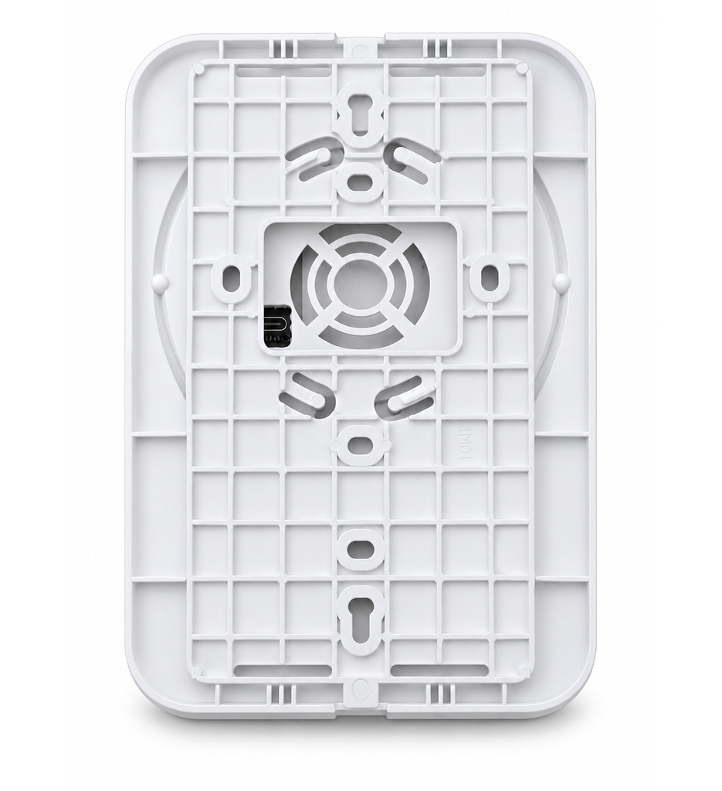
OpenthermThermostat/Images/thermostat-back.jpg
