isystemsautomation/homemaster-dev/OpenthermThermostat/Images/thermostat-front-off.jpg

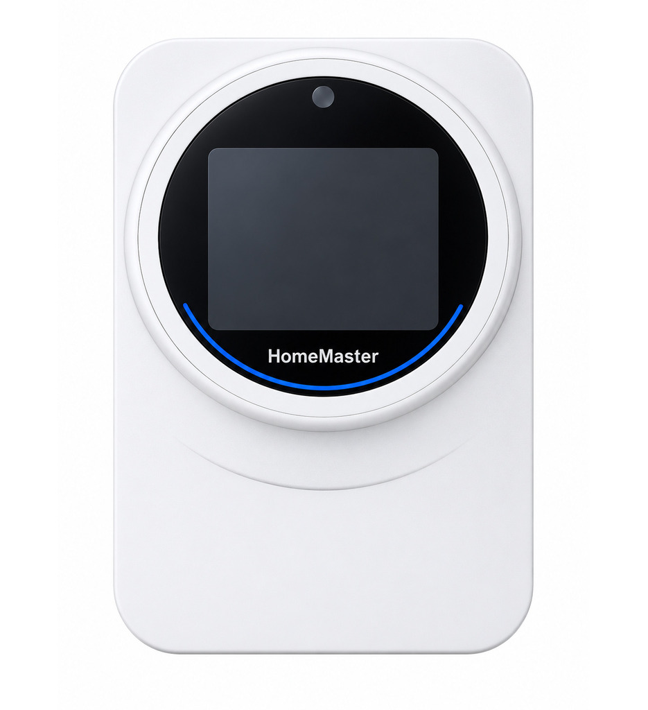
OpenthermThermostat/Images/thermostat-front-off.jpg
