isystemsautomation/homemaster-dev/RGB-621-R1/Images/mplisting1.png

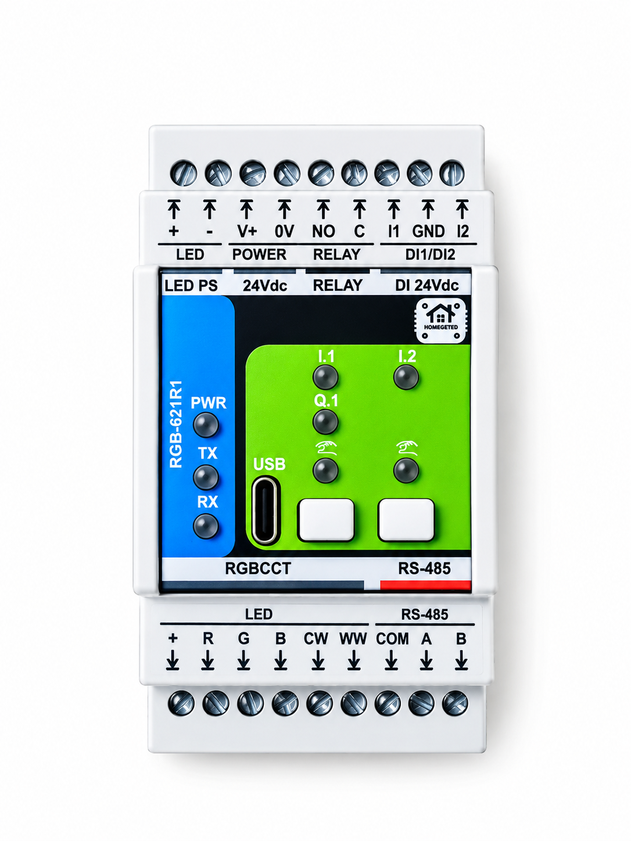
RGB-621-R1/Images/mplisting1.png
