isystemsautomation/homemaster-dev/RGB-621-R1/Images/mplisting2.png

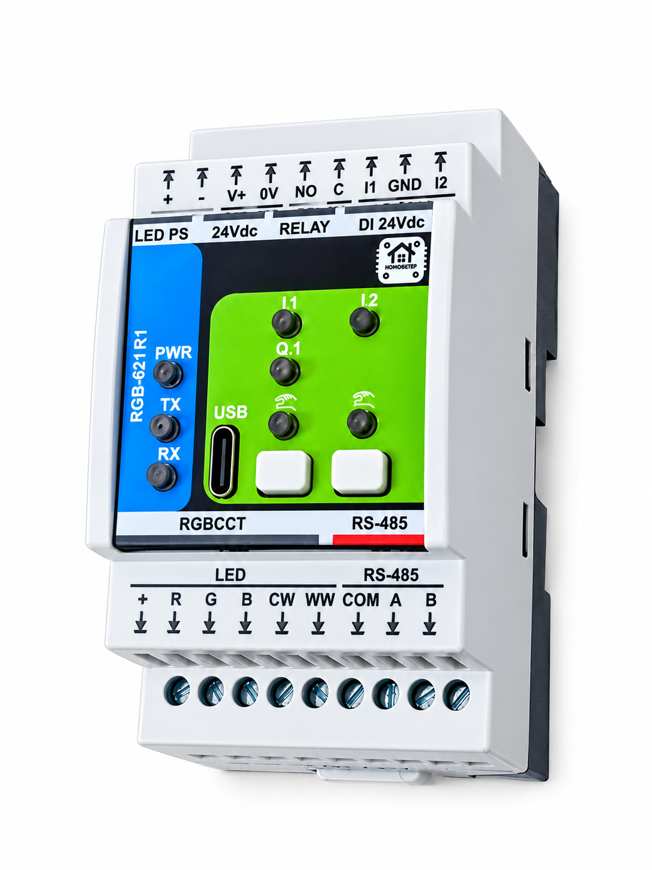
RGB-621-R1/Images/mplisting2.png
