isystemsautomation/homemaster-dev/RGB-621-R1/Images/mplisting4.png

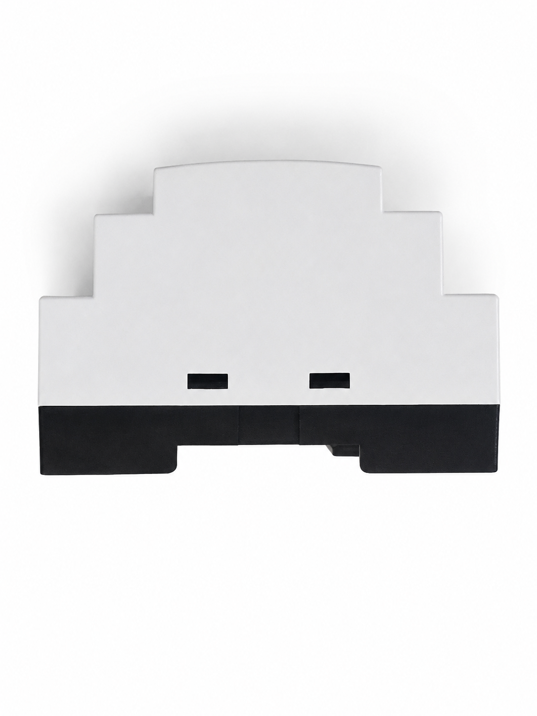
RGB-621-R1/Images/mplisting4.png
