isystemsautomation/homemaster-dev/RGB-621-R1/Images/rgb_2000x2000.png

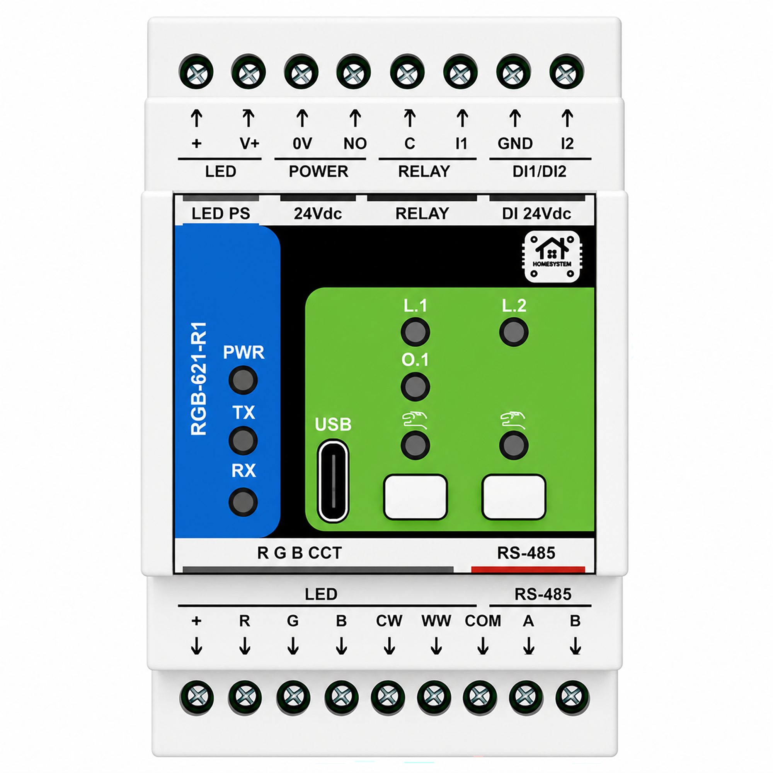
RGB-621-R1/Images/rgb_2000x2000.png
