isystemsautomation/homemaster-dev/RGB-621-R1/Images/webconfig1.png

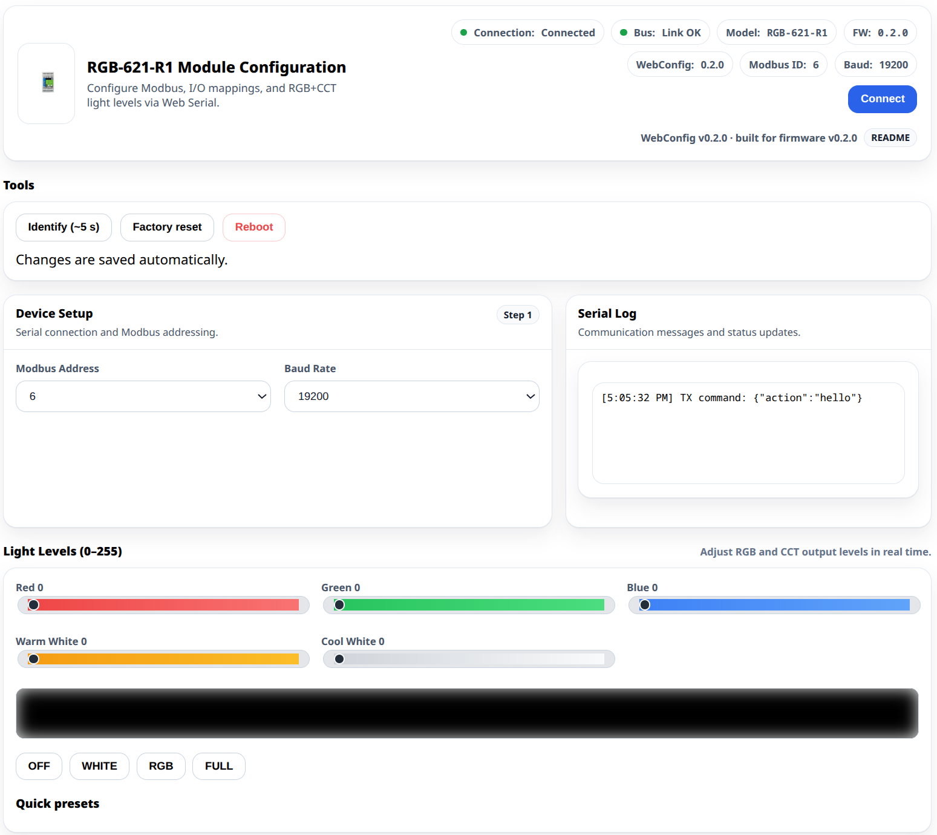
RGB-621-R1/Images/webconfig1.png
