isystemsautomation/homemaster-dev/RGB-621-R1/Images/webconfig2.png

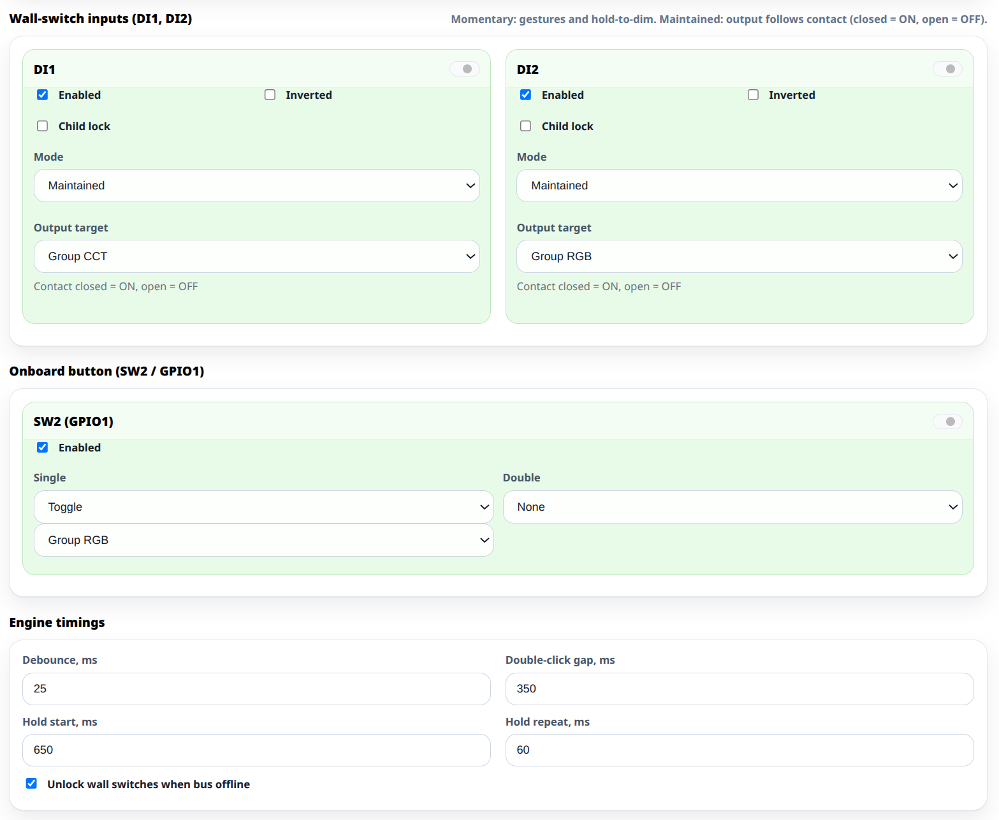
RGB-621-R1/Images/webconfig2.png
