isystemsautomation/homemaster-dev/RGB-621-R1/Images/webconfig3.png

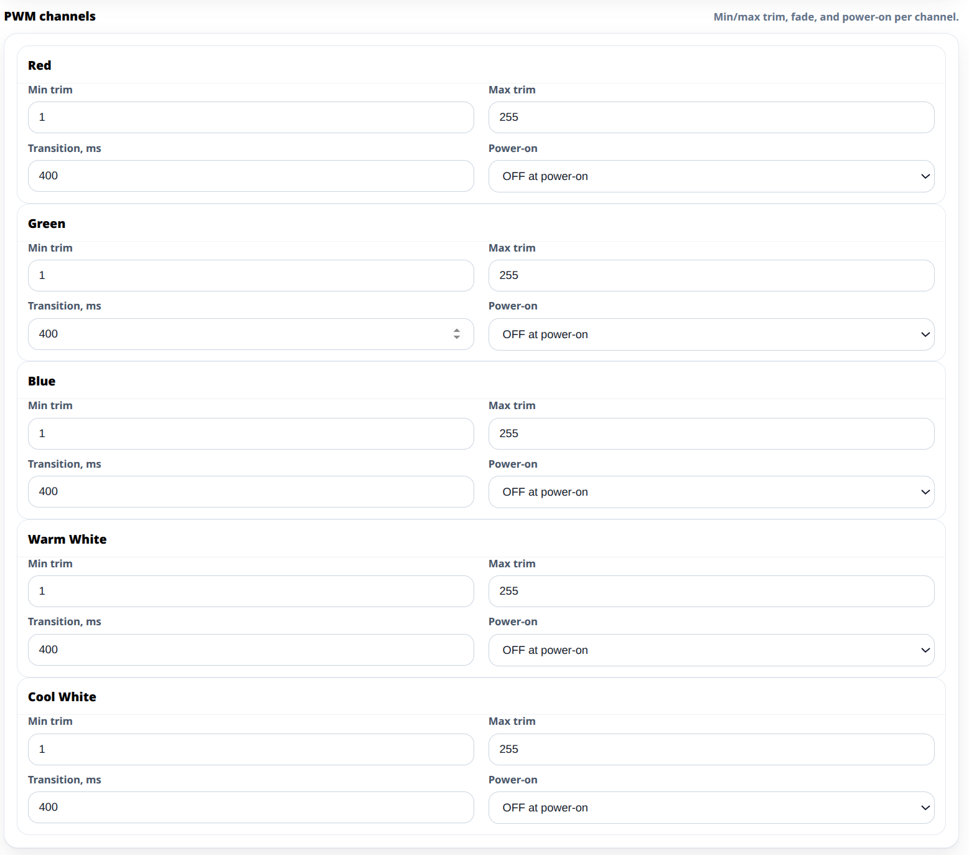
RGB-621-R1/Images/webconfig3.png
