isystemsautomation/homemaster-dev/RGB-621-R1/Images/webconfig4.png

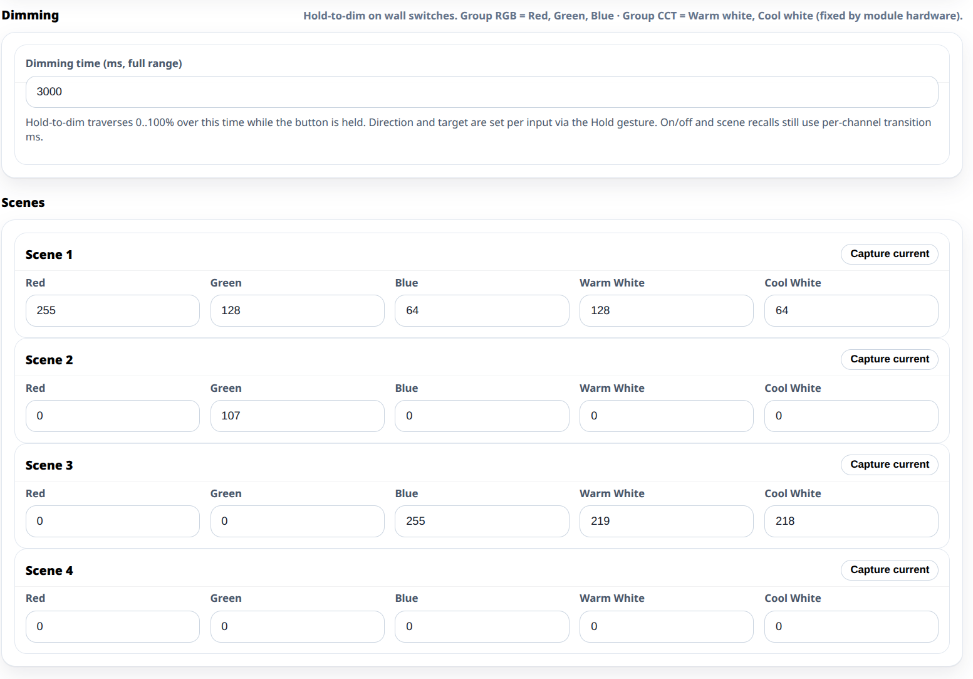
RGB-621-R1/Images/webconfig4.png
