isystemsautomation/homemaster-dev/RGB-621-R1/Images/webconfig5.png

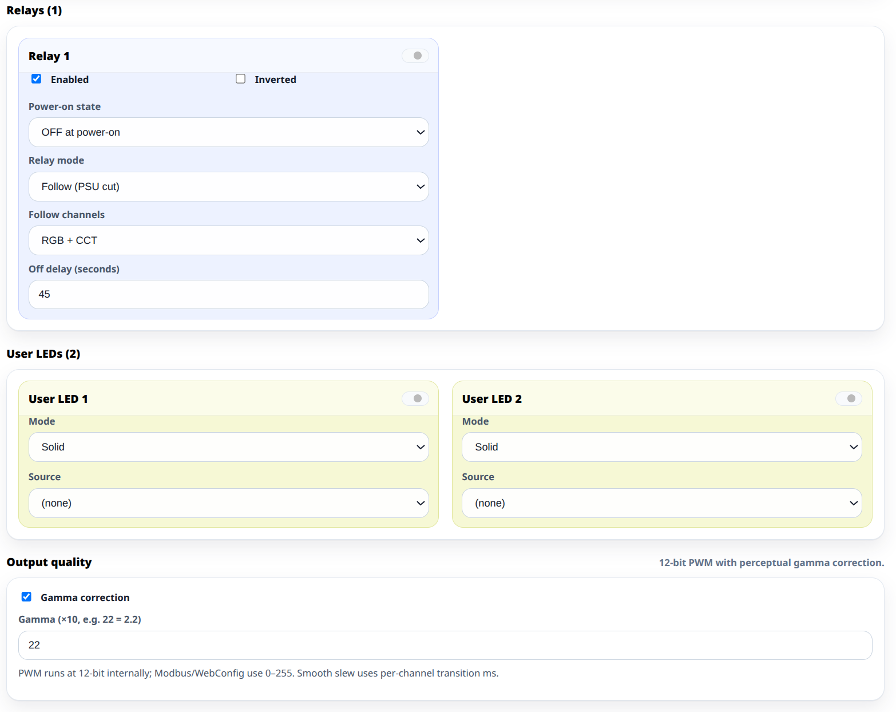
RGB-621-R1/Images/webconfig5.png
