isystemsautomation/homemaster-dev/shared/home/cards/p55.webp

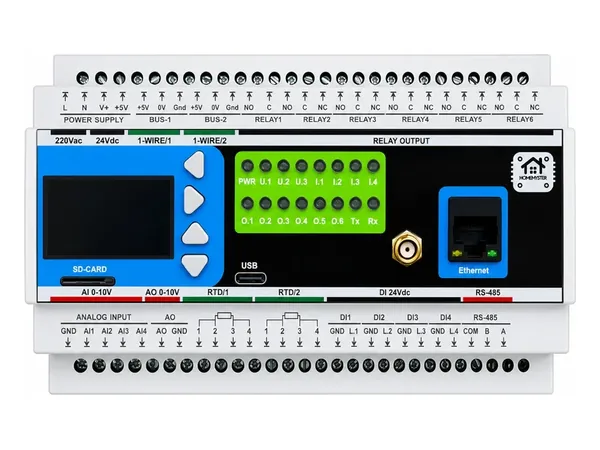
shared/home/cards/p55.webp
