isystemsautomation/homemaster-dev/shared/home/cards/p57.webp

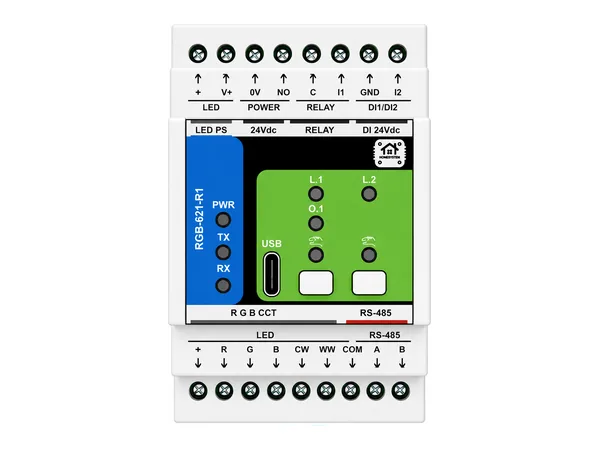
shared/home/cards/p57.webp
