isystemsautomation/homemaster-dev/shared/home/cards/p58.webp

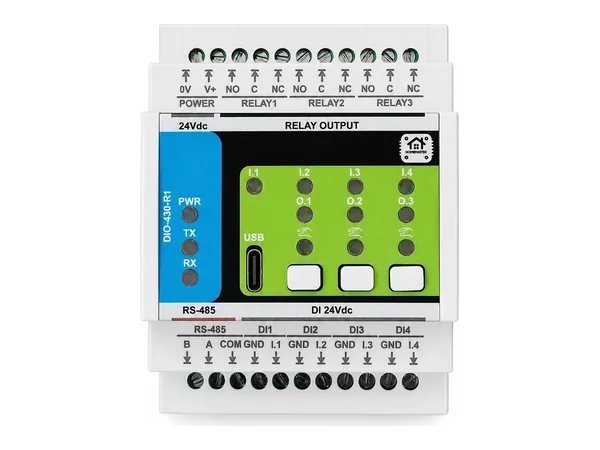
shared/home/cards/p58.webp
