isystemsautomation/homemaster-dev/shared/home/cards/p59.webp

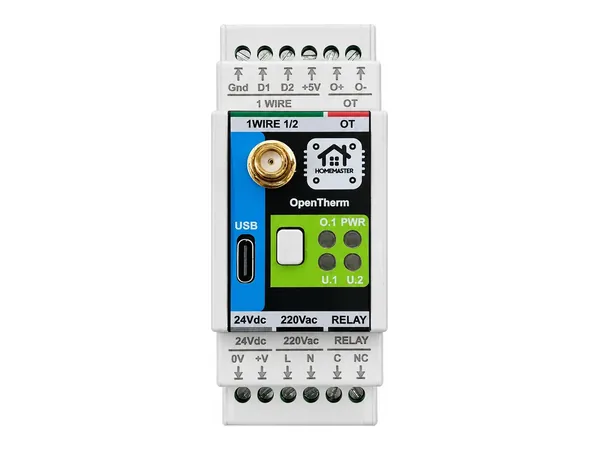
shared/home/cards/p59.webp
