isystemsautomation/homemaster-dev/shared/home/cards/p66.webp

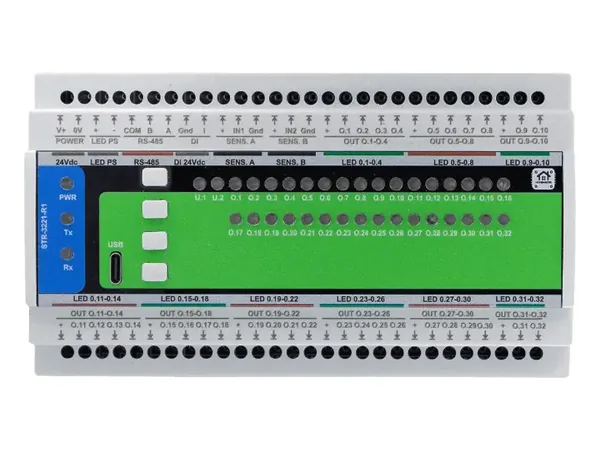
shared/home/cards/p66.webp
