isystemsautomation/homemaster-dev/shared/home/cards/p733.webp

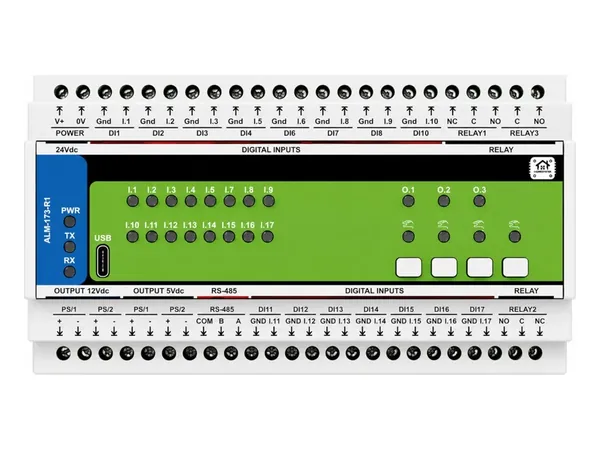
shared/home/cards/p733.webp
