isystemsautomation/homemaster-dev/shared/home/cards/p735.webp

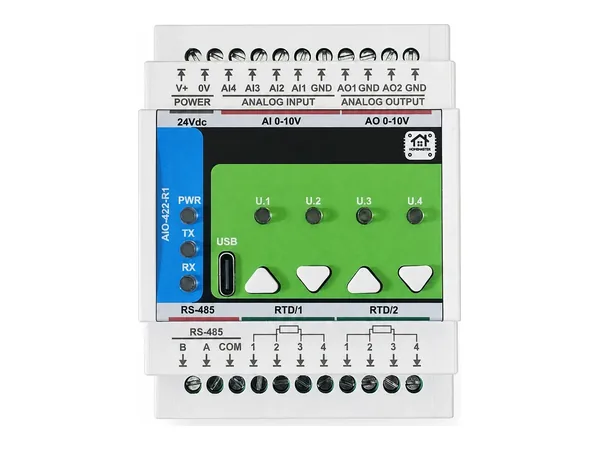
shared/home/cards/p735.webp
