isystemsautomation/homemaster-dev/shared/home/cards/p736.webp

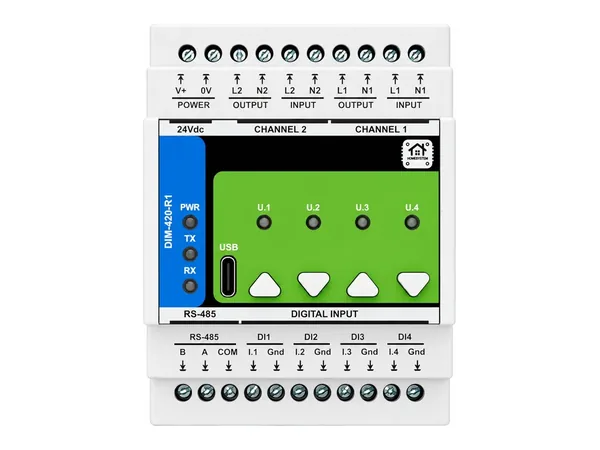
shared/home/cards/p736.webp
