isystemsautomation/homemaster-dev/shared/home/cards/p737.webp

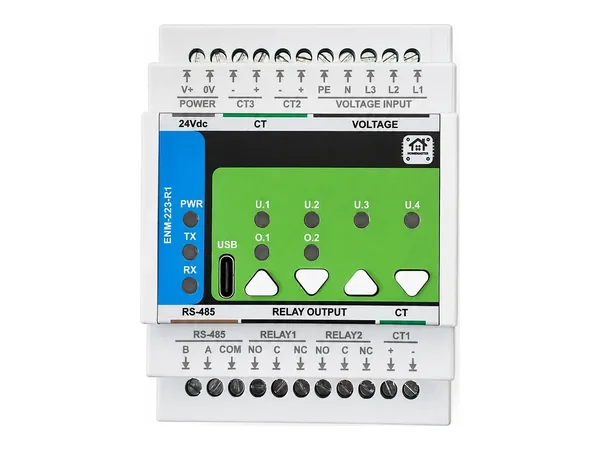
shared/home/cards/p737.webp
