isystemsautomation/homemaster-dev/shared/home/cards/p1514.webp

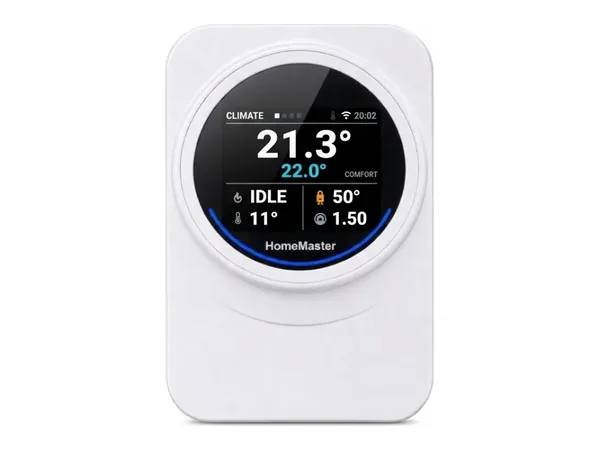
shared/home/cards/p1514.webp
