isystemsautomation/homemaster-dev/shared/home/company-control-room.webp

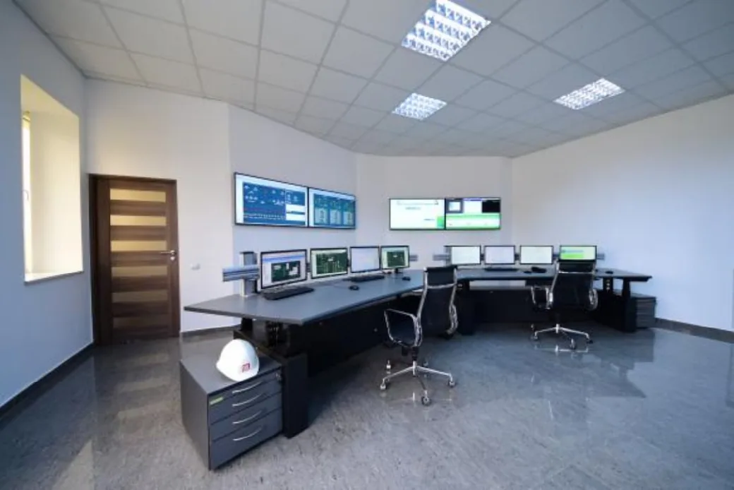
shared/home/company-control-room.webp
