isystemsautomation/homemaster-dev/shared/home/hero-miniplc.webp

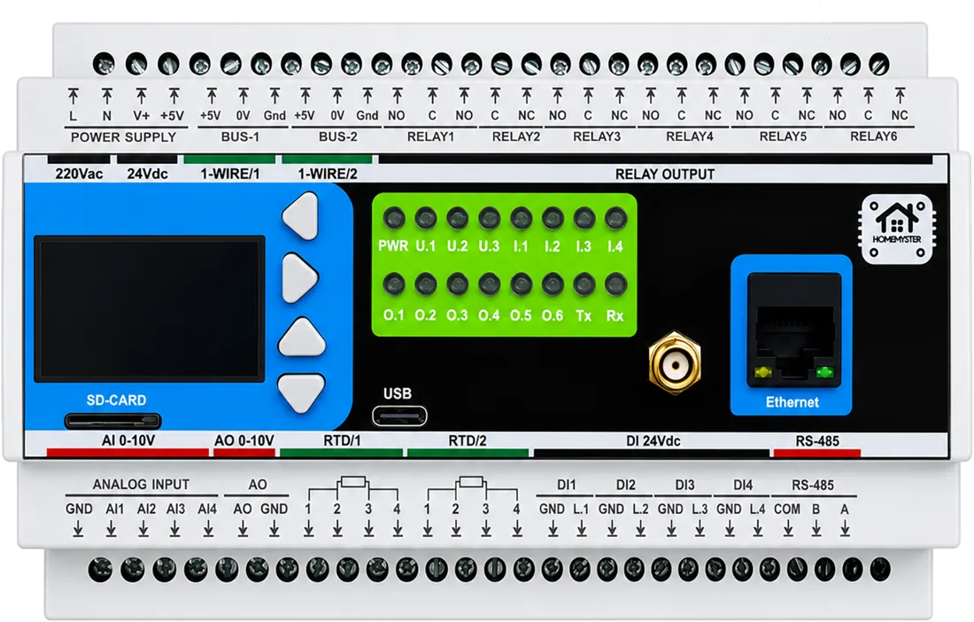
shared/home/hero-miniplc.webp
