isystemsautomation/homemaster-dev/shared/home/hero-studio2-d.webp

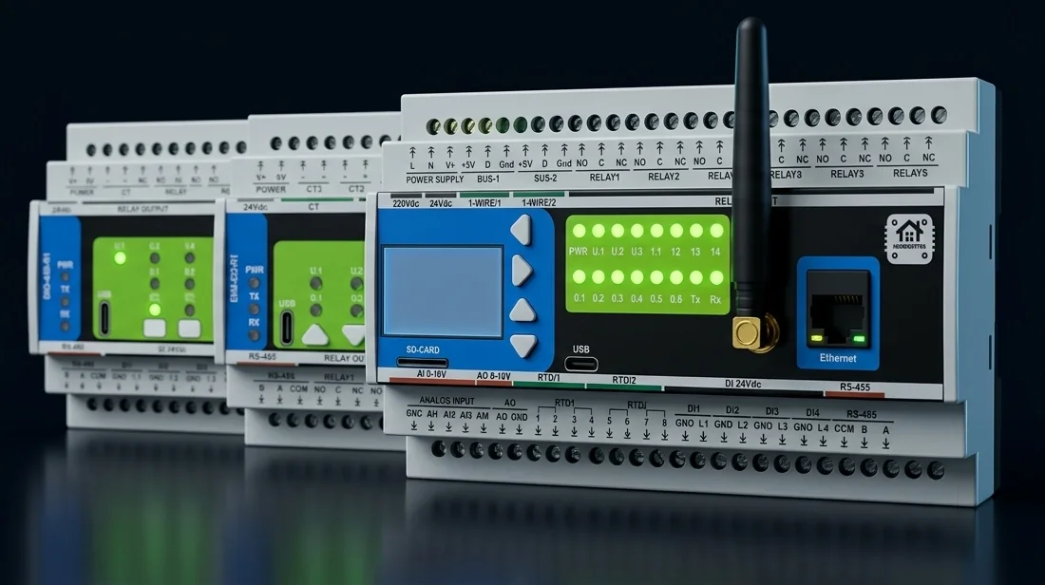
shared/home/hero-studio2-d.webp
