isystemsautomation/homemaster-dev/shared/home/hero-studio2-m.webp

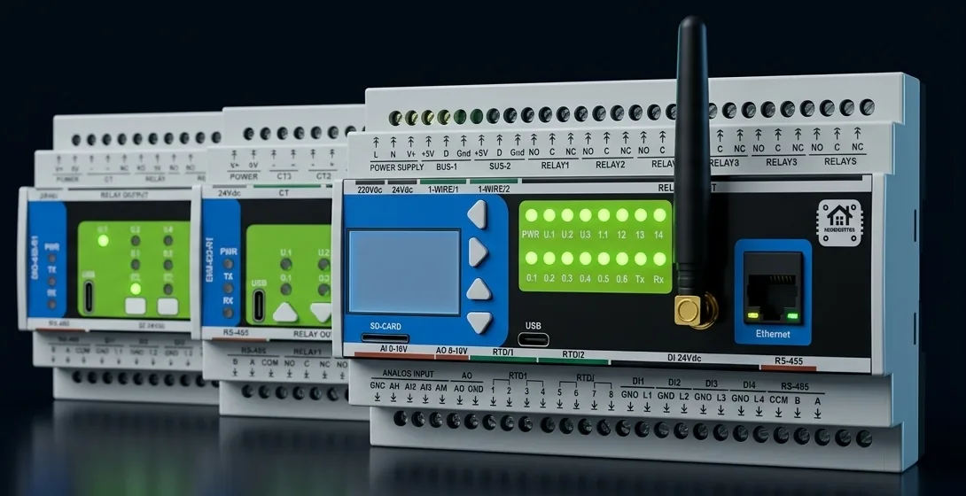
shared/home/hero-studio2-m.webp
