isystemsautomation/homemaster-dev/shared/home/hero-studio-d.webp

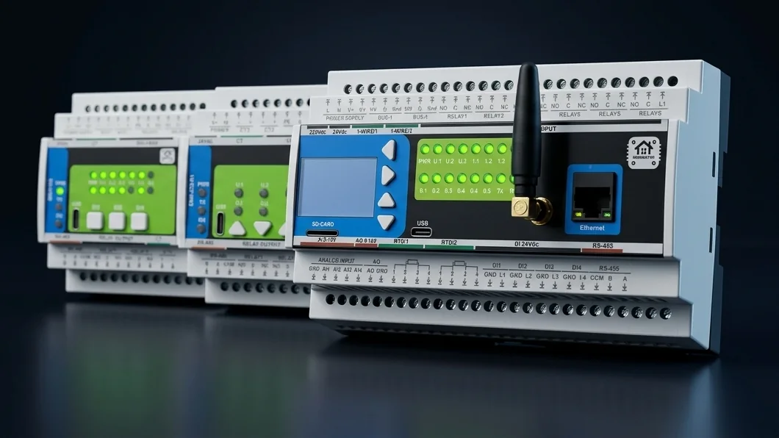
shared/home/hero-studio-d.webp
