isystemsautomation/homemaster-dev/shared/home/hero-studio-m.webp

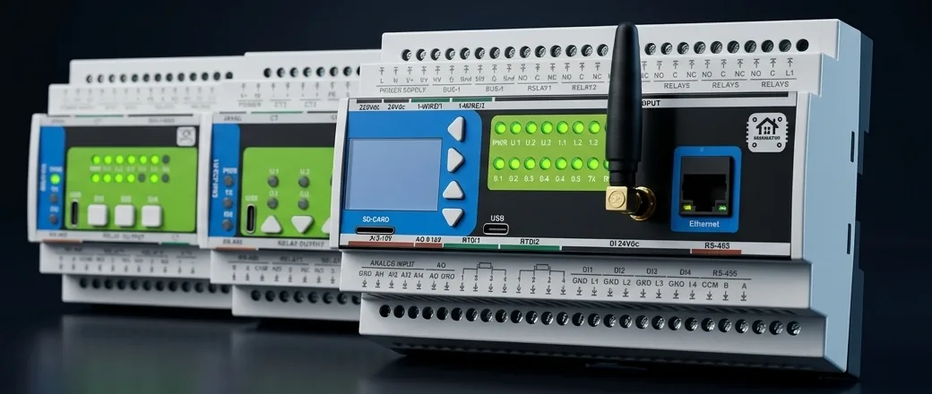
shared/home/hero-studio-m.webp
