isystemsautomation/homemaster-dev/shared/home/hero-studio.webp

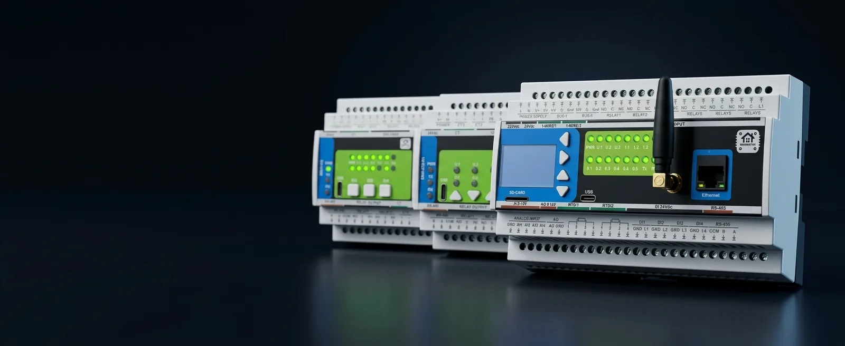
shared/home/hero-studio.webp
