isystemsautomation/homemaster-dev/STR-3221-R1/Images/mplisting1.png

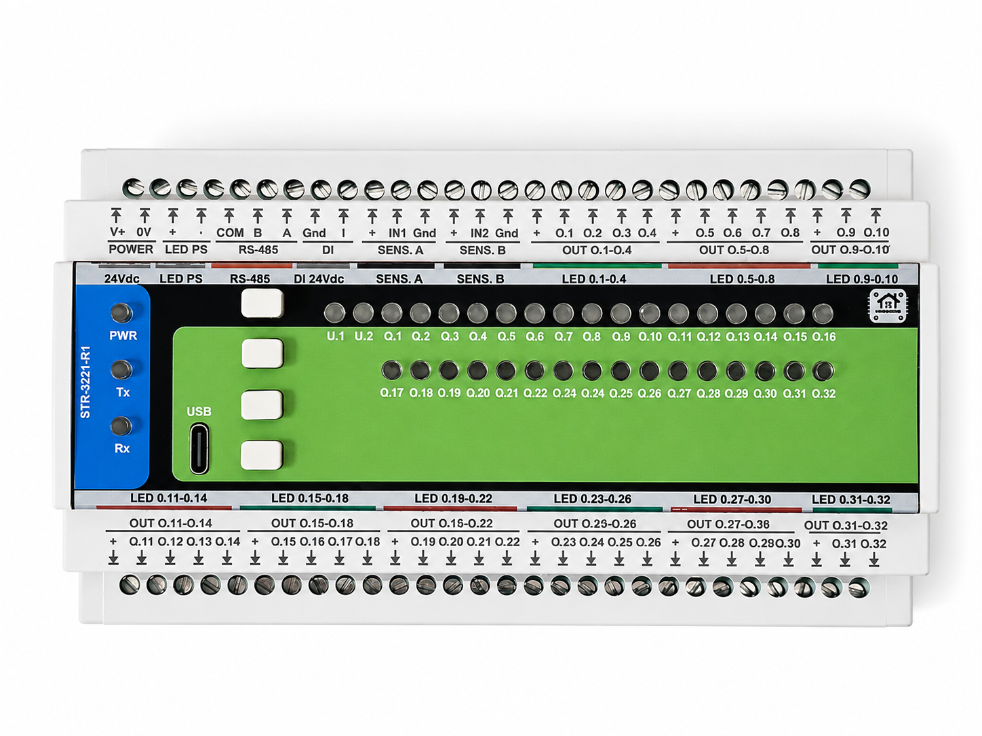
STR-3221-R1/Images/mplisting1.png
