isystemsautomation/homemaster-dev/STR-3221-R1/Images/mplisting2.png

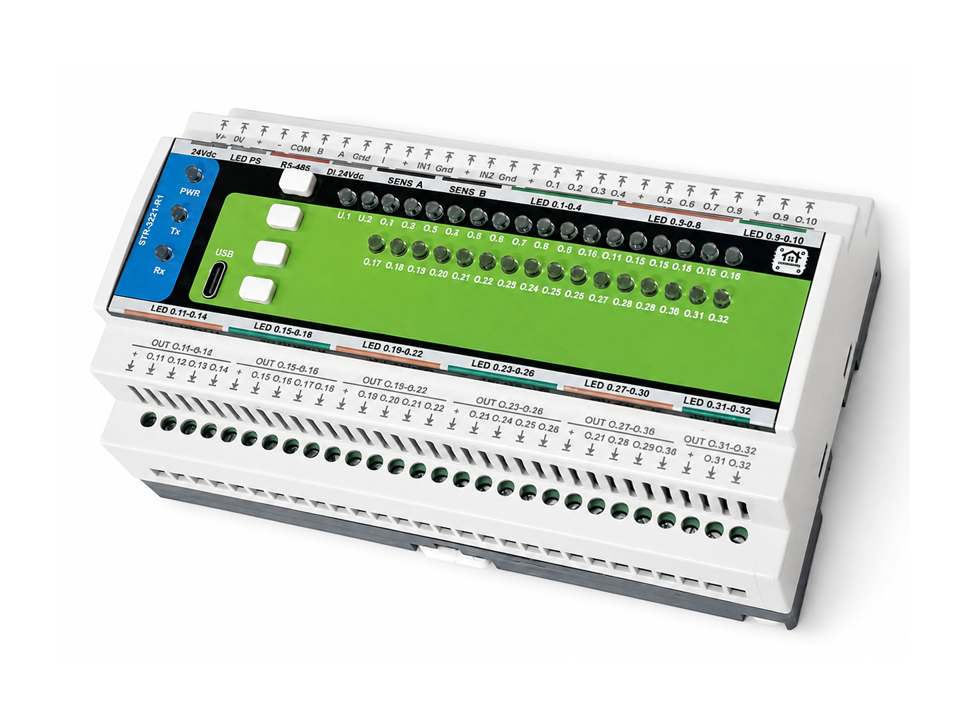
STR-3221-R1/Images/mplisting2.png
