isystemsautomation/homemaster-dev/STR-3221-R1/Images/photo1_512kb.png

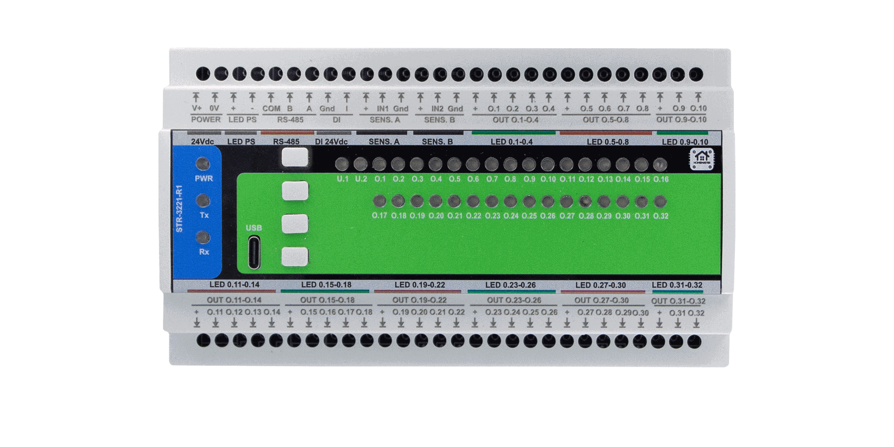
STR-3221-R1/Images/photo1_512kb.png
