isystemsautomation/homemaster-dev/WLD-521-R1/Images/mplisting1.png

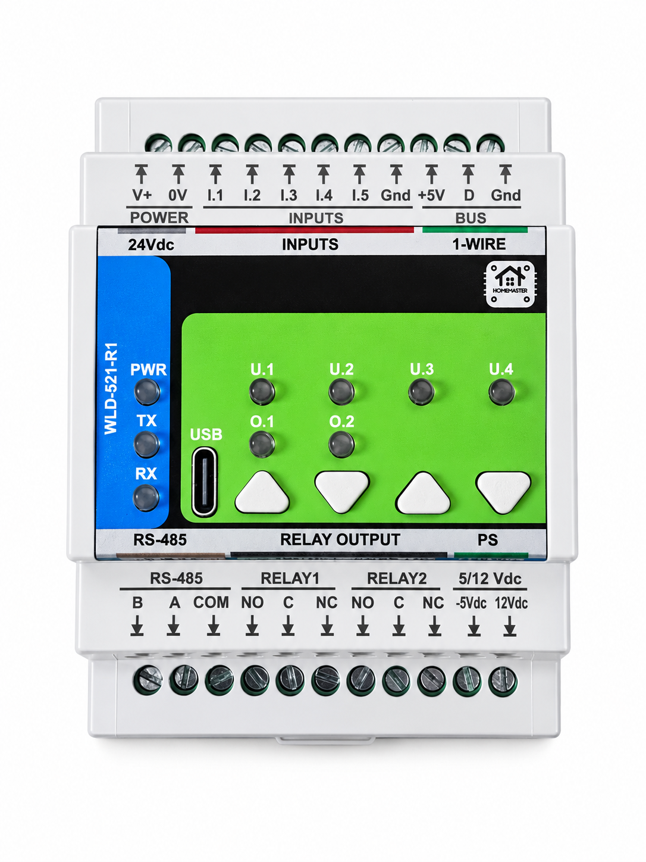
WLD-521-R1/Images/mplisting1.png
