isystemsautomation/homemaster-dev/WLD-521-R1/Images/package1.png

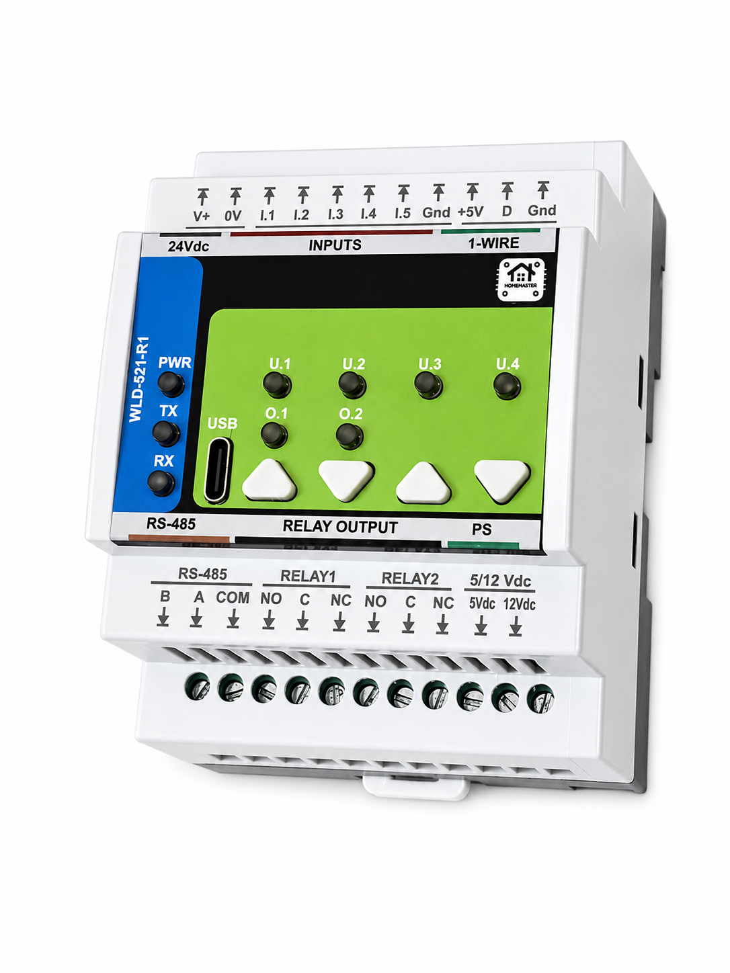
WLD-521-R1/Images/package1.png
