isystemsautomation/homemaster-dev/WLD-521-R1/Images/WLDDimensions.png

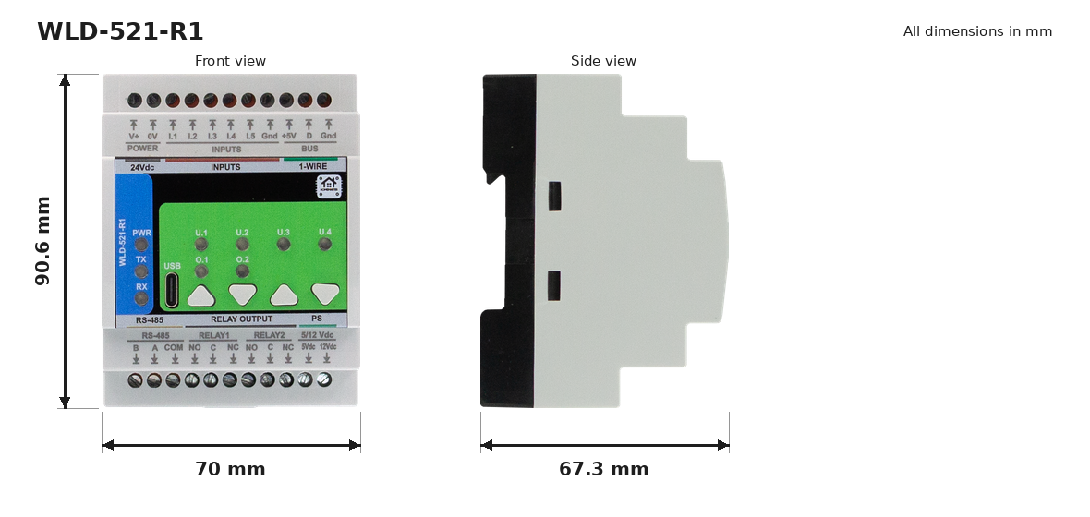
WLD-521-R1/Images/WLDDimensions.png
