isystemsautomation/homemaster-dev/OpenthermThermostat/Manuals/README.md

# Manuals

Filenames referenced elsewhere in the repository. Use exactly these names.

| File | Referenced by |
|---|---|
| `OpenThermThermostat_Datasheet.pdf` | `site/thermostat_card.html` |
| `OpenThermThermostat_UserManual.pdf` | `site/thermostat_card.html` |
| `DoC_OTT-R1.pdf` | `site/thermostat_card.html` |
