isystemsautomation/homemaster-dev/MiniPLC/Schematics/MCU_Board.pdf

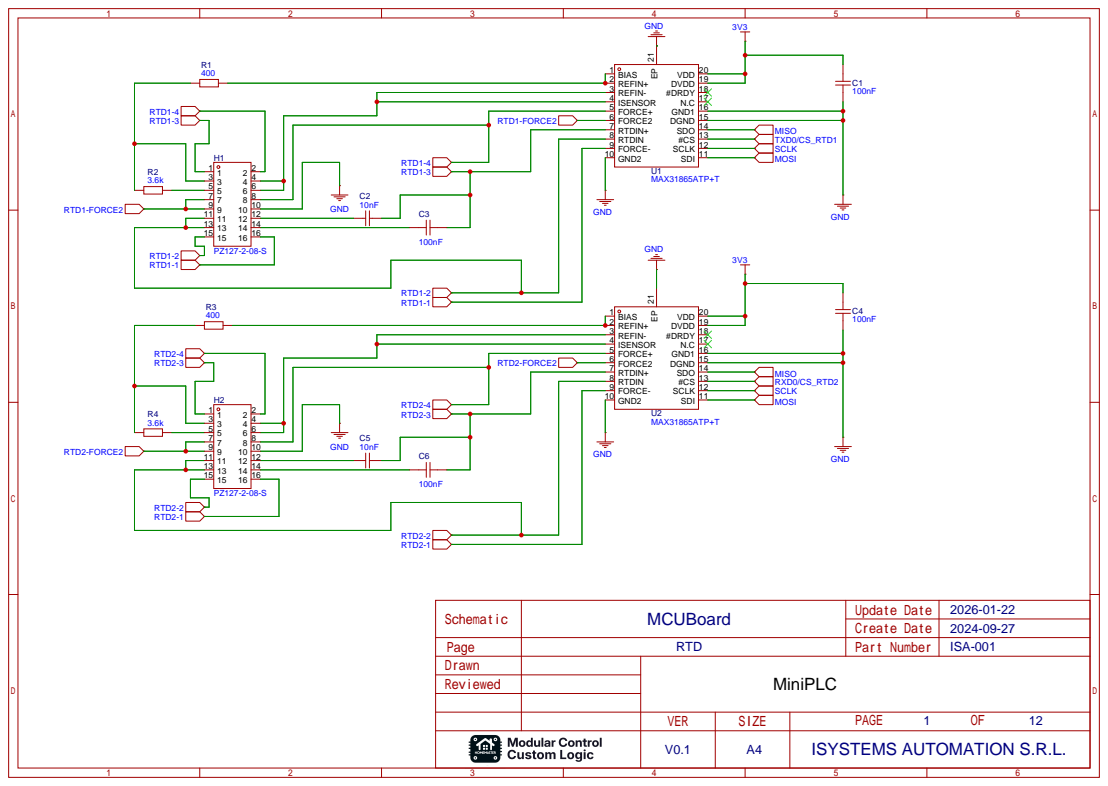
[picture p228: page 1]

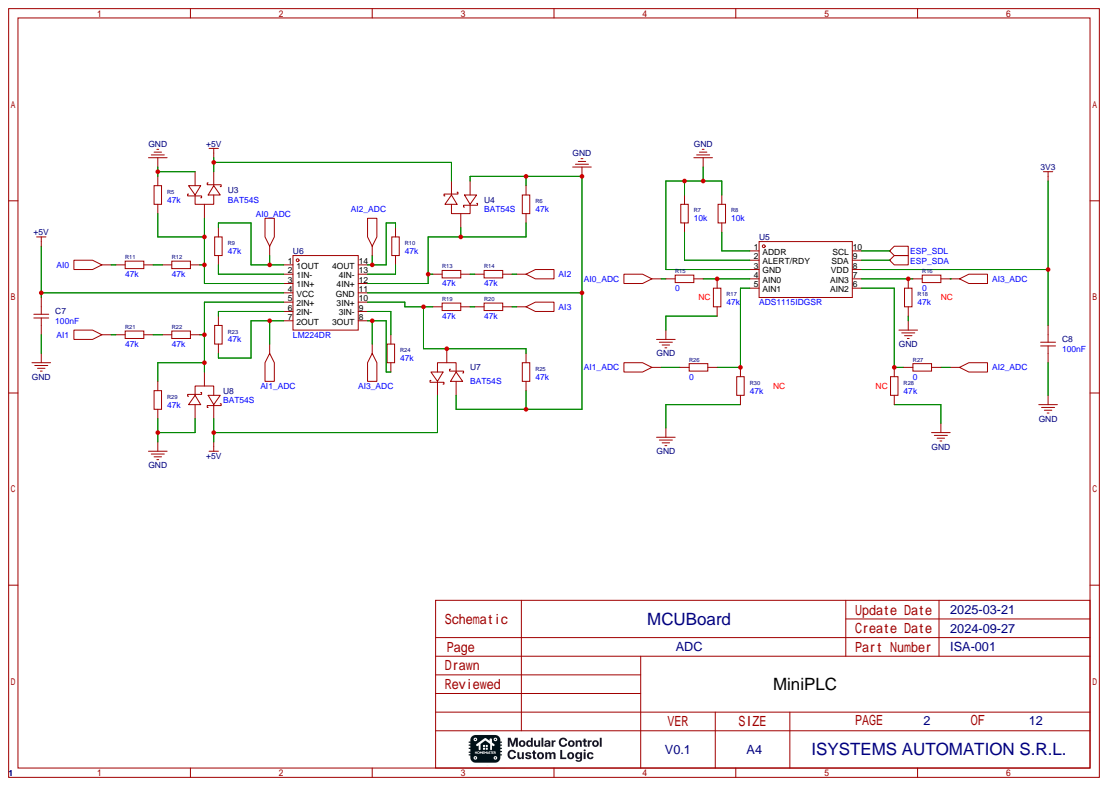
[picture p229: page 2]

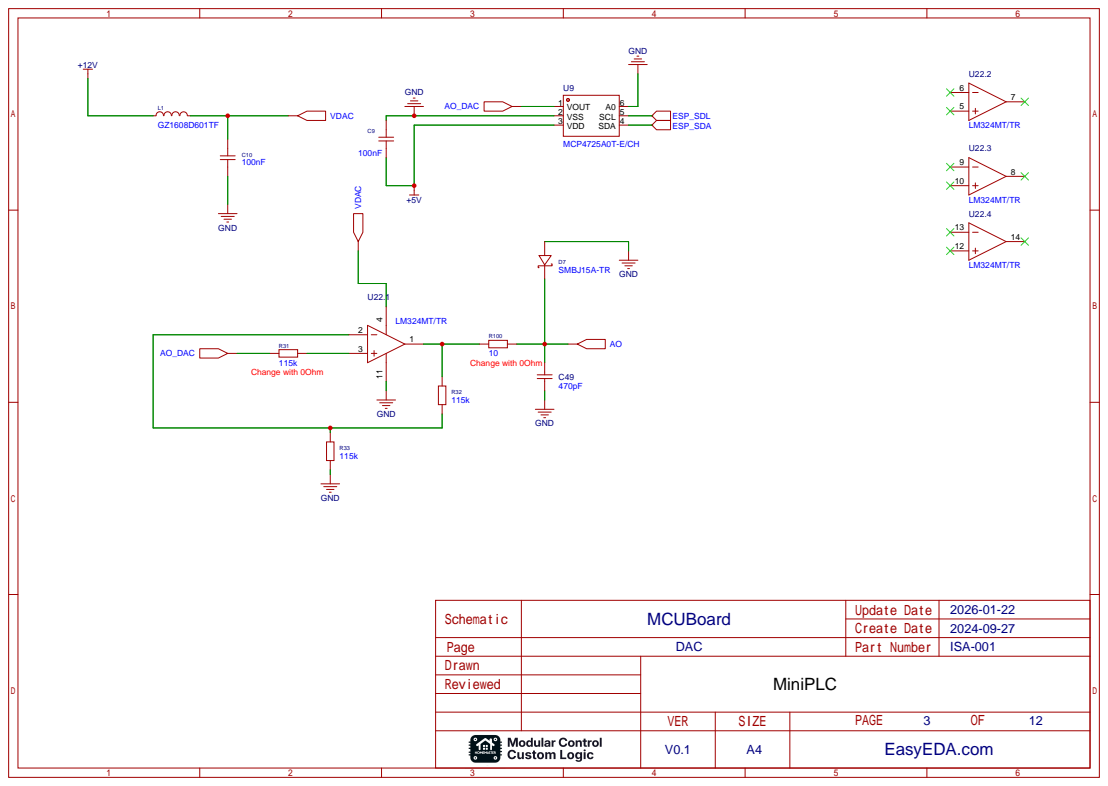
[picture p230: page 3]

3V3
3V3

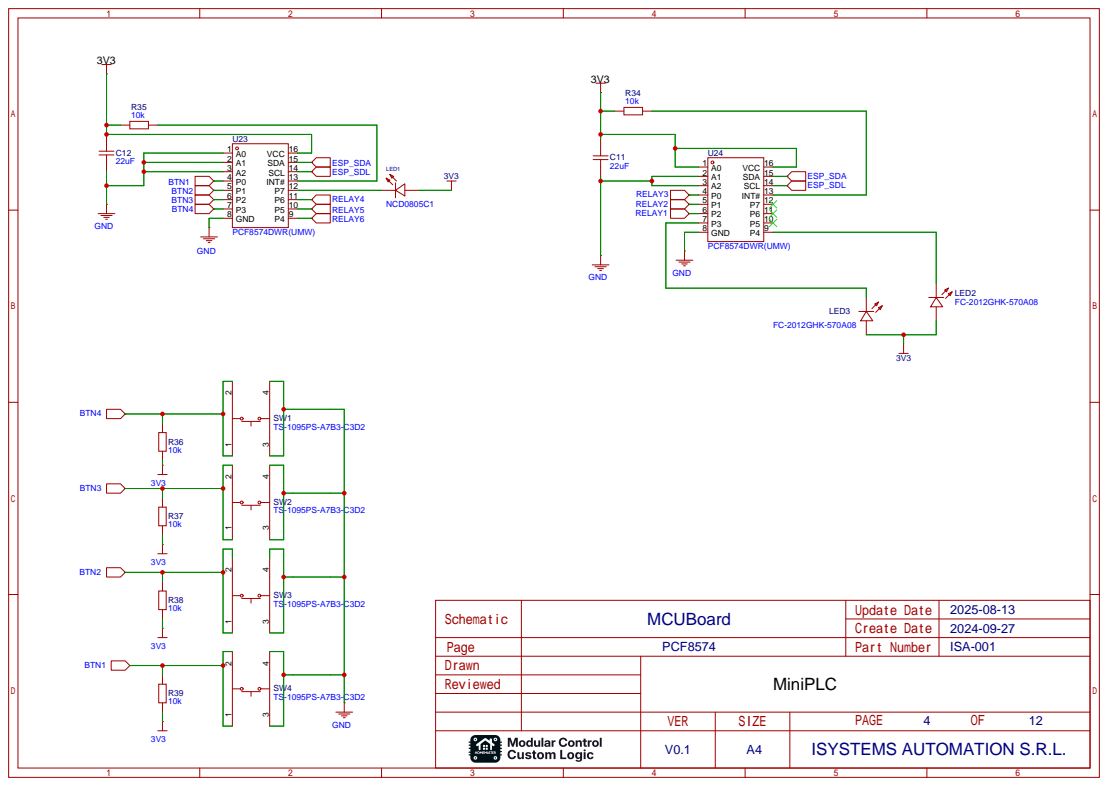
[picture p231: page 4]

P5 10 P6 11 P7 12 INT# 13 SCL 14 SDA 15 VCC 16

# EN/IO0 ESP32

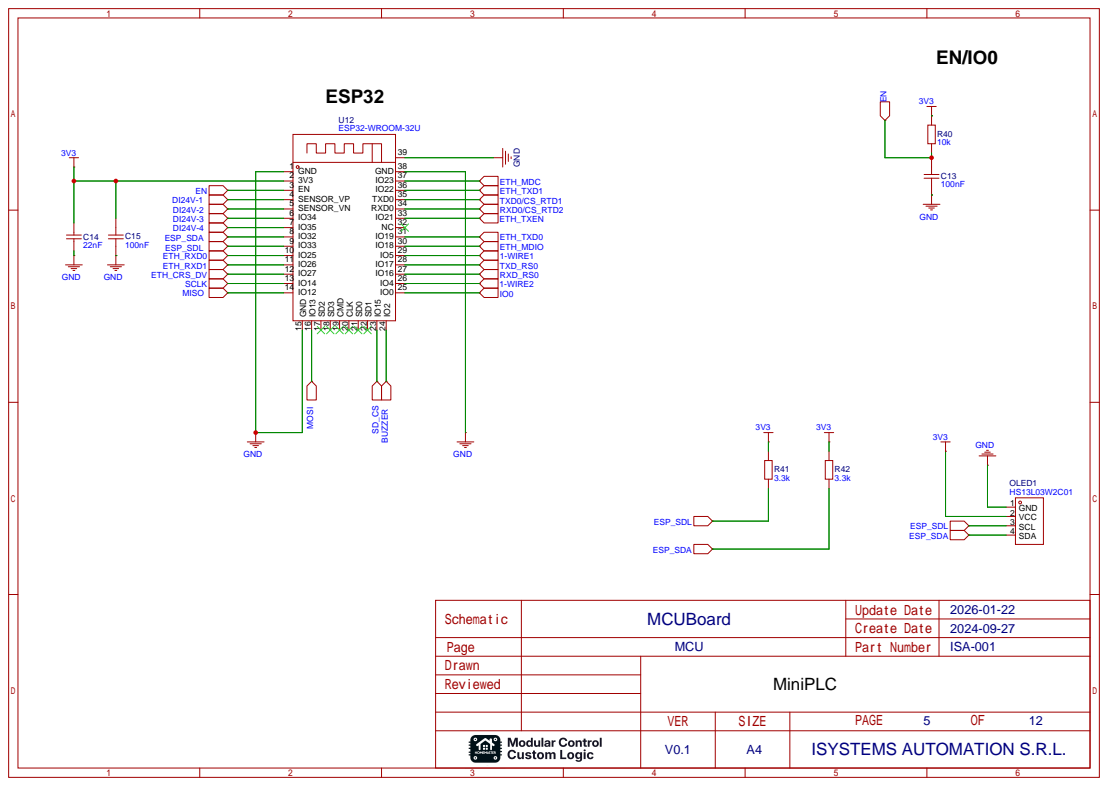
[picture p232: page 5]

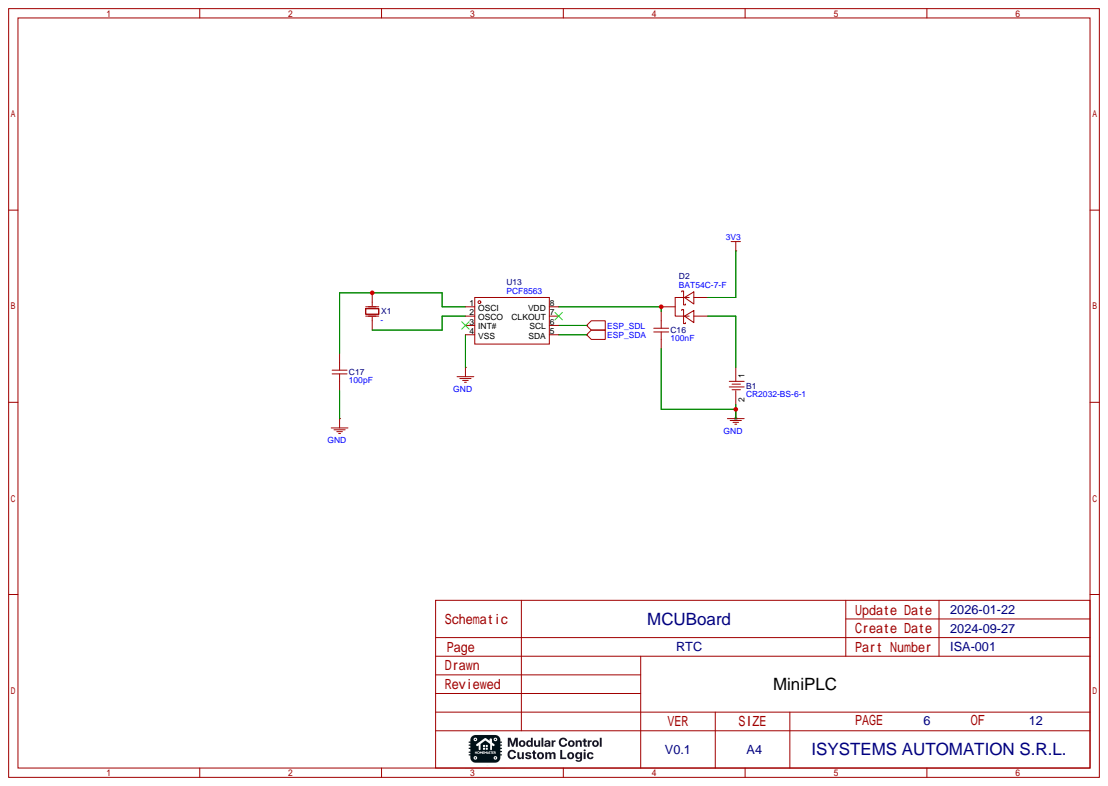
[picture p233: page 6]

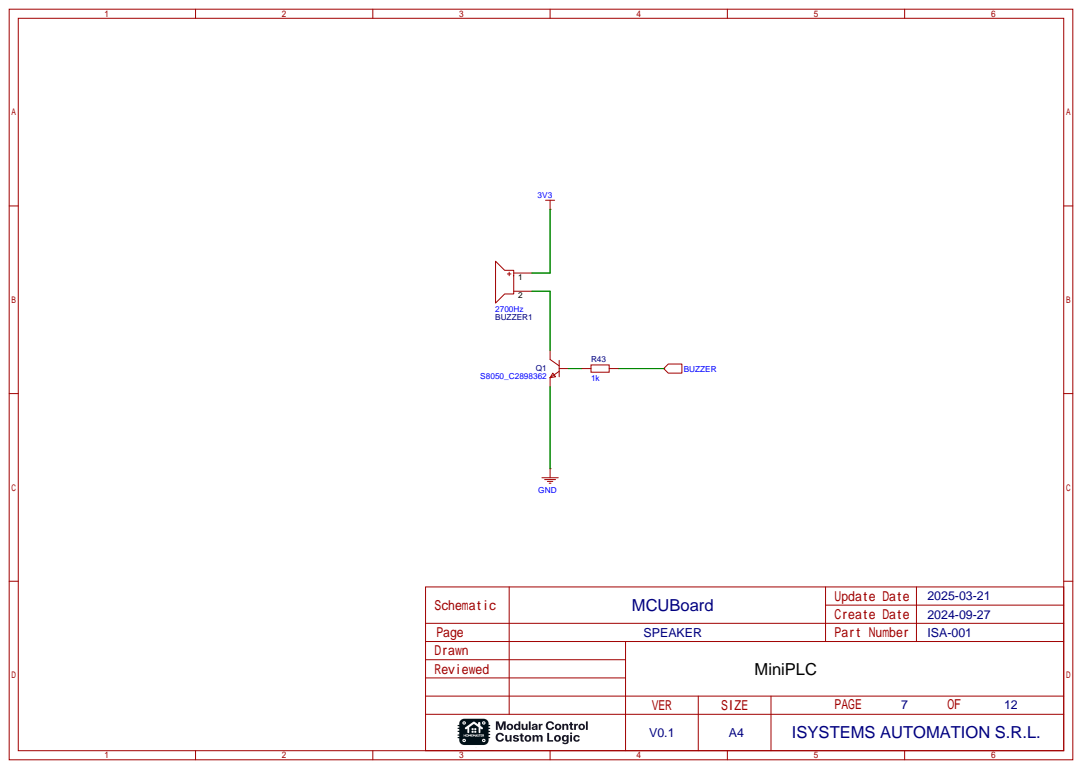
[picture p234: page 7]

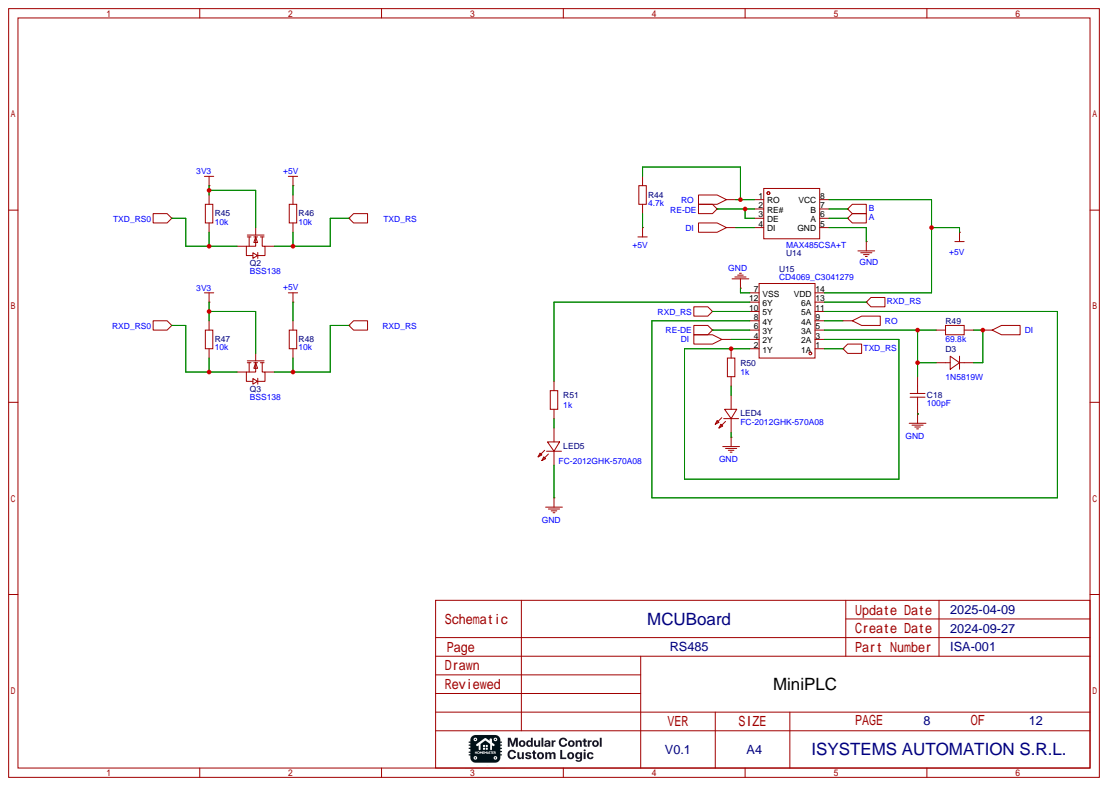
[picture p235: page 8]

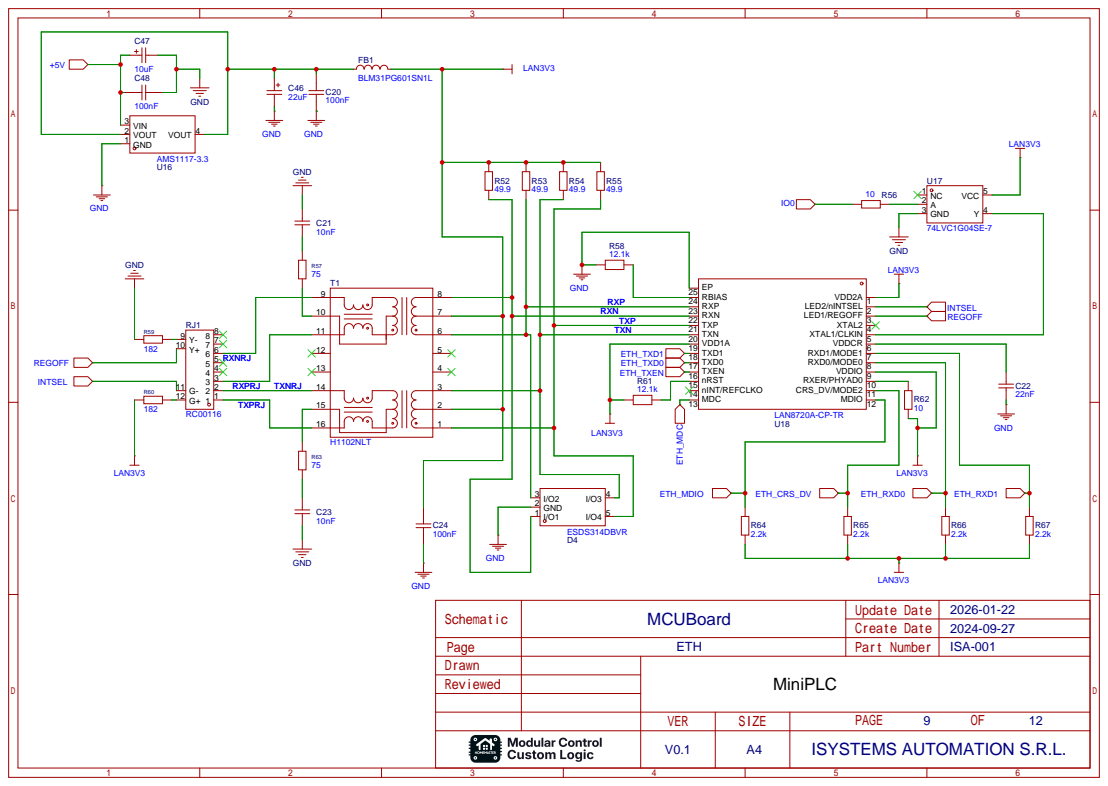
[picture p236: page 9]

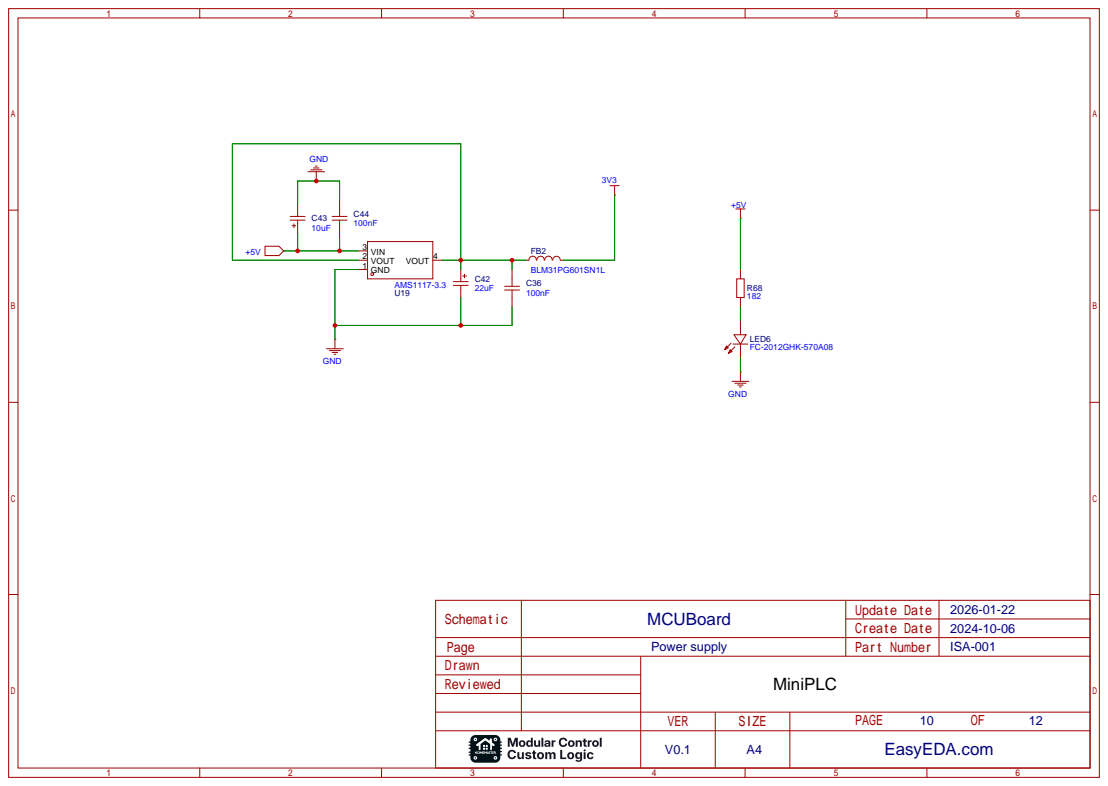
[picture p237: page 10]

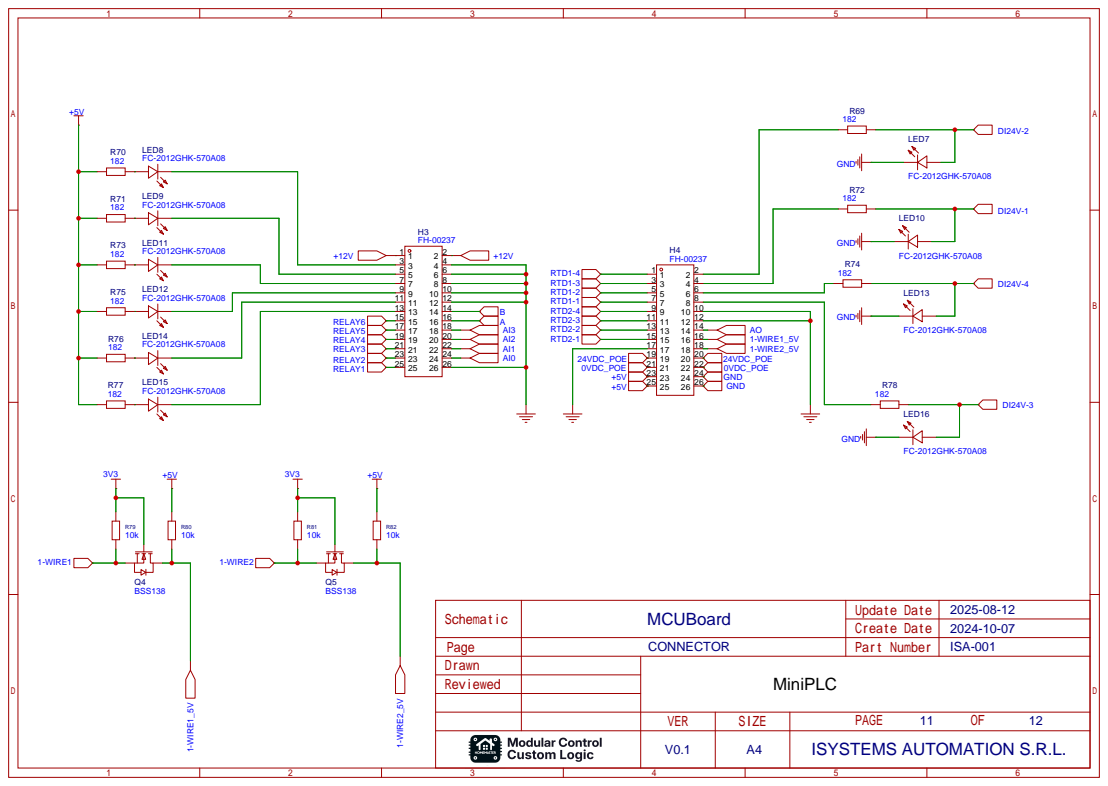
[picture p238: page 11]

# PRTR5V0U2X,215 VBUS

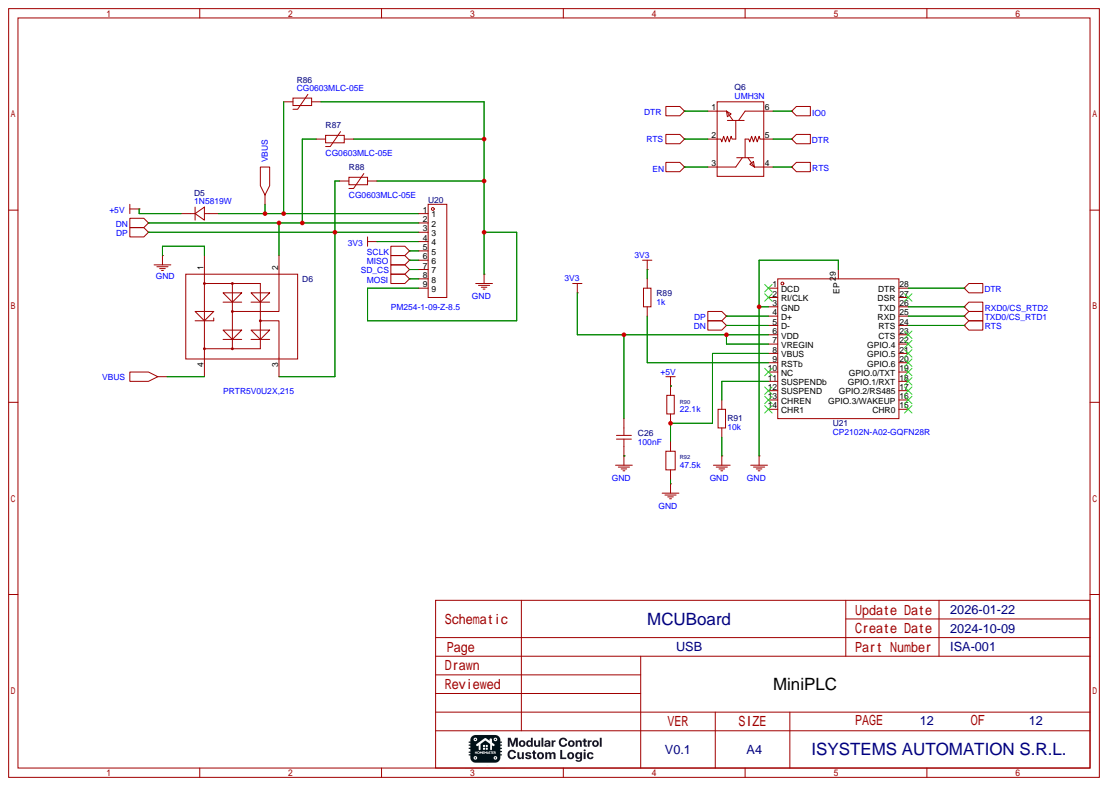
[picture p239: page 12]
