isystemsautomation/homemaster-dev/STR-3221-R1/Schematics/STR-3221-R1-FieldBoard.pdf

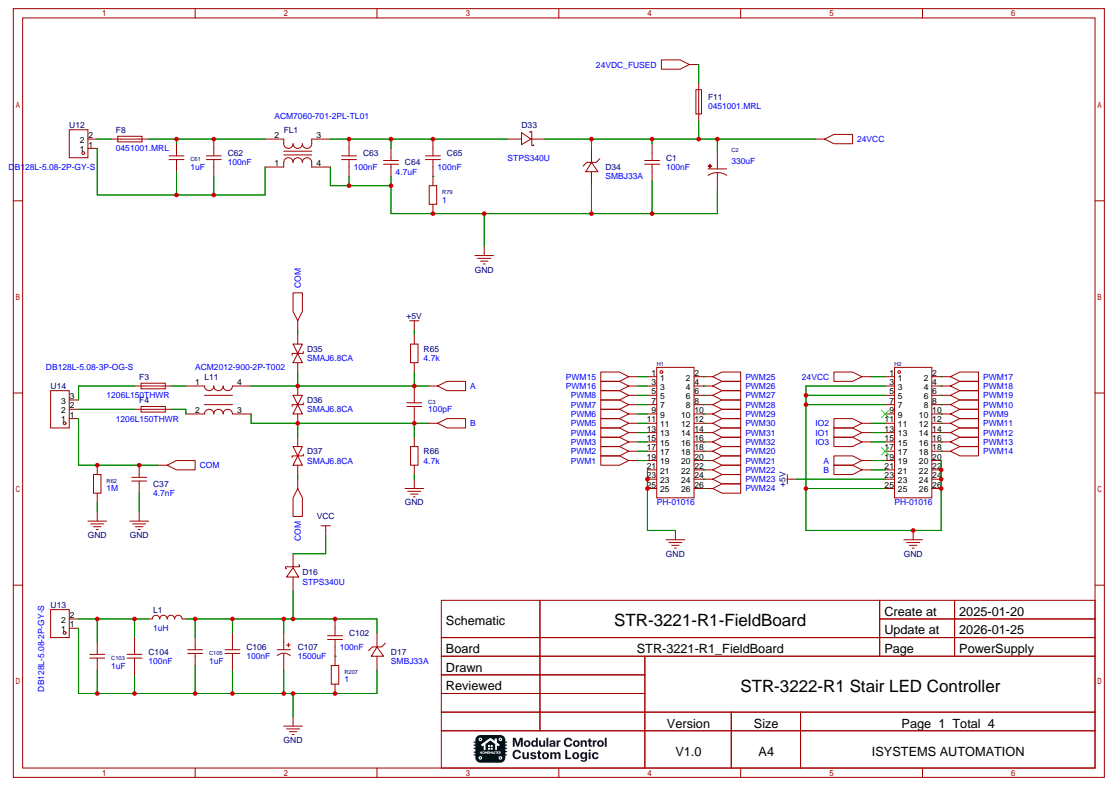
[picture p244: page 1]

Schematic | STR-3221-R1-FieldBoard | Create at | 2025-01-20

Update at | 2026-01-25

Board | STR-3221-R1_FieldBoard | Page | PowerSupply
Drawn | | STR-3222-R1 Stair LED Controller
Reviewed

Version | Size | Page 1 Total 4
V1.0 | A4 | ISYSTEMS AUTOMATION

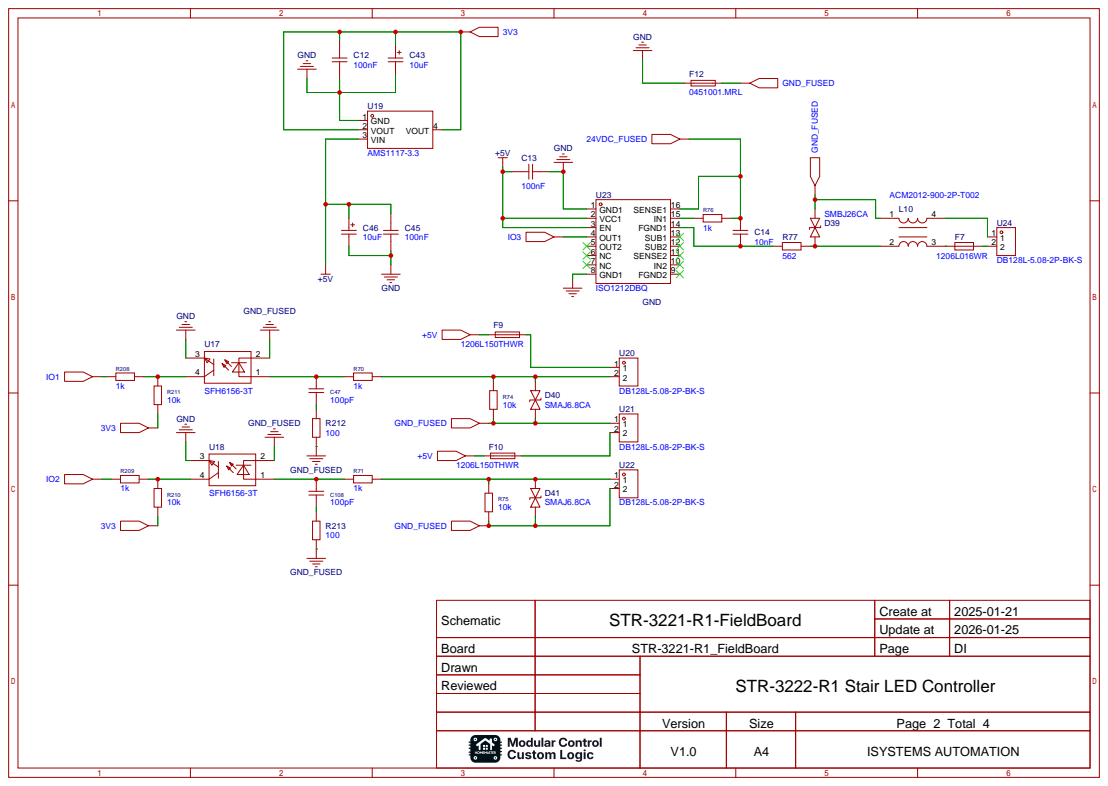
[picture p245: page 2]

Schematic | STR-3221-R1-FieldBoard | Create at | 2025-01-21

Update at | 2026-01-25

Board | STR-3221-R1_FieldBoard | Page | DI
Drawn | | STR-3222-R1 Stair LED Controller
Reviewed

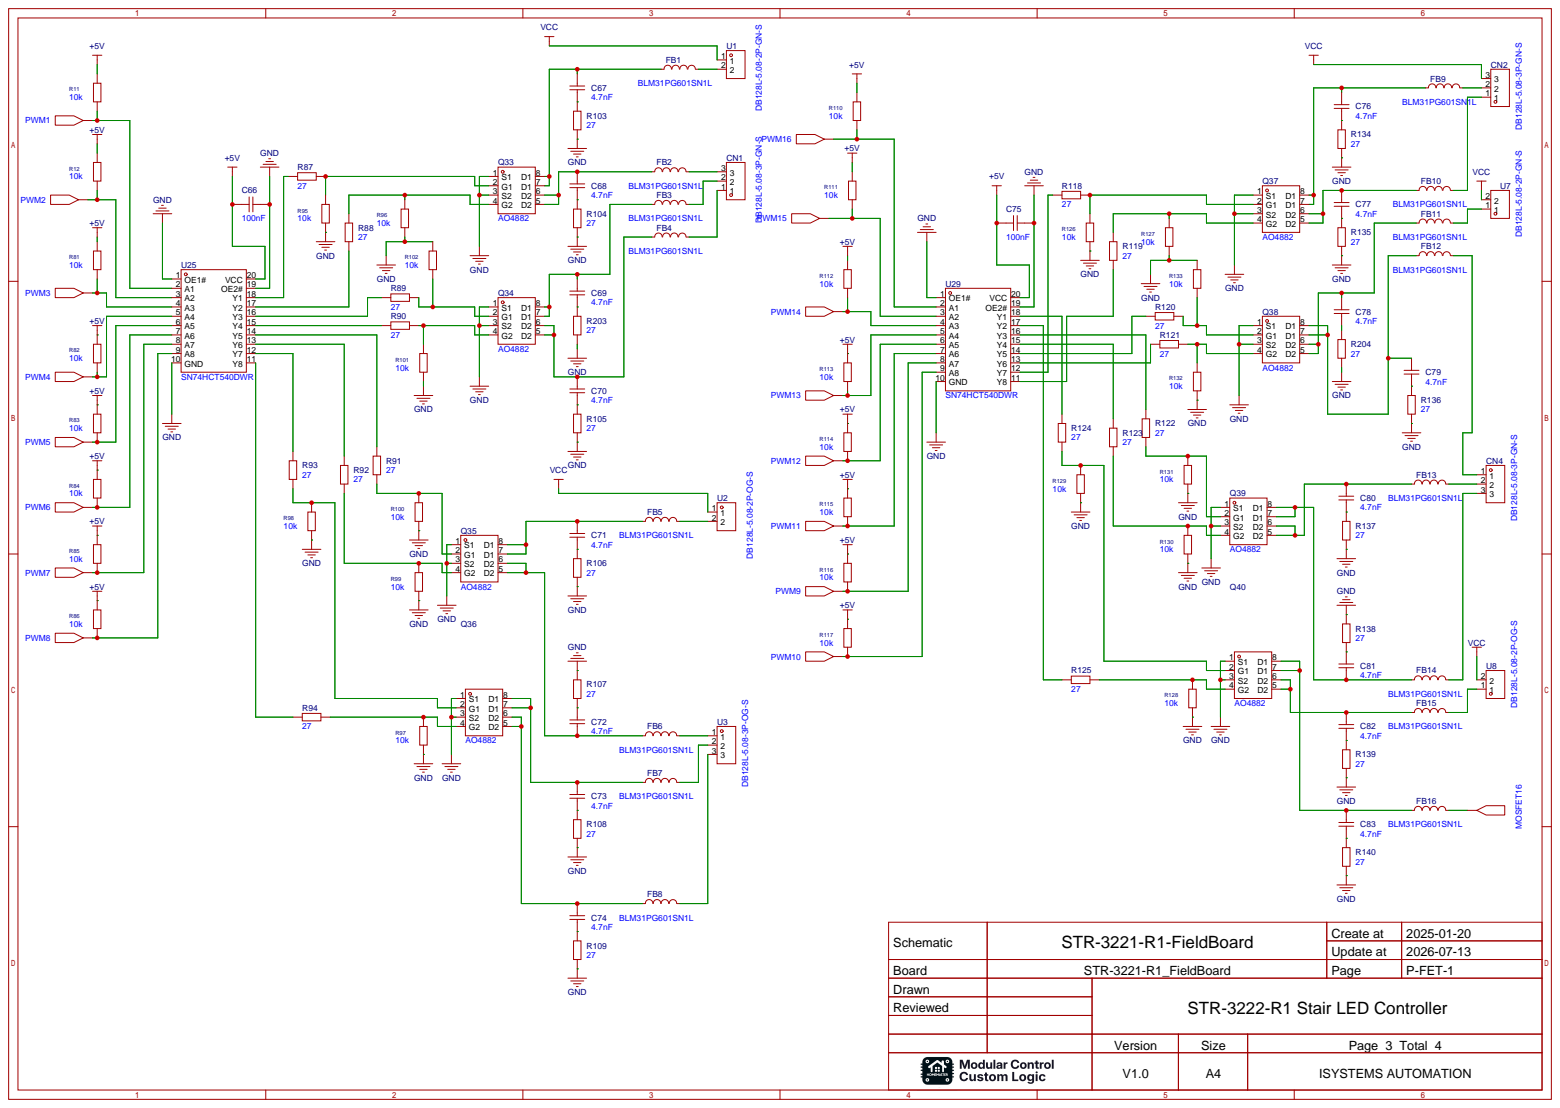
[picture p246: page 3]

Schematic | STR-3221-R1-FieldBoard | Create at | 2025-01-20

Update at | 2026-07-13

Board | STR-3221-R1_FieldBoard | Page | P-FET-1
Drawn | | STR-3222-R1 Stair LED Controller
Reviewed

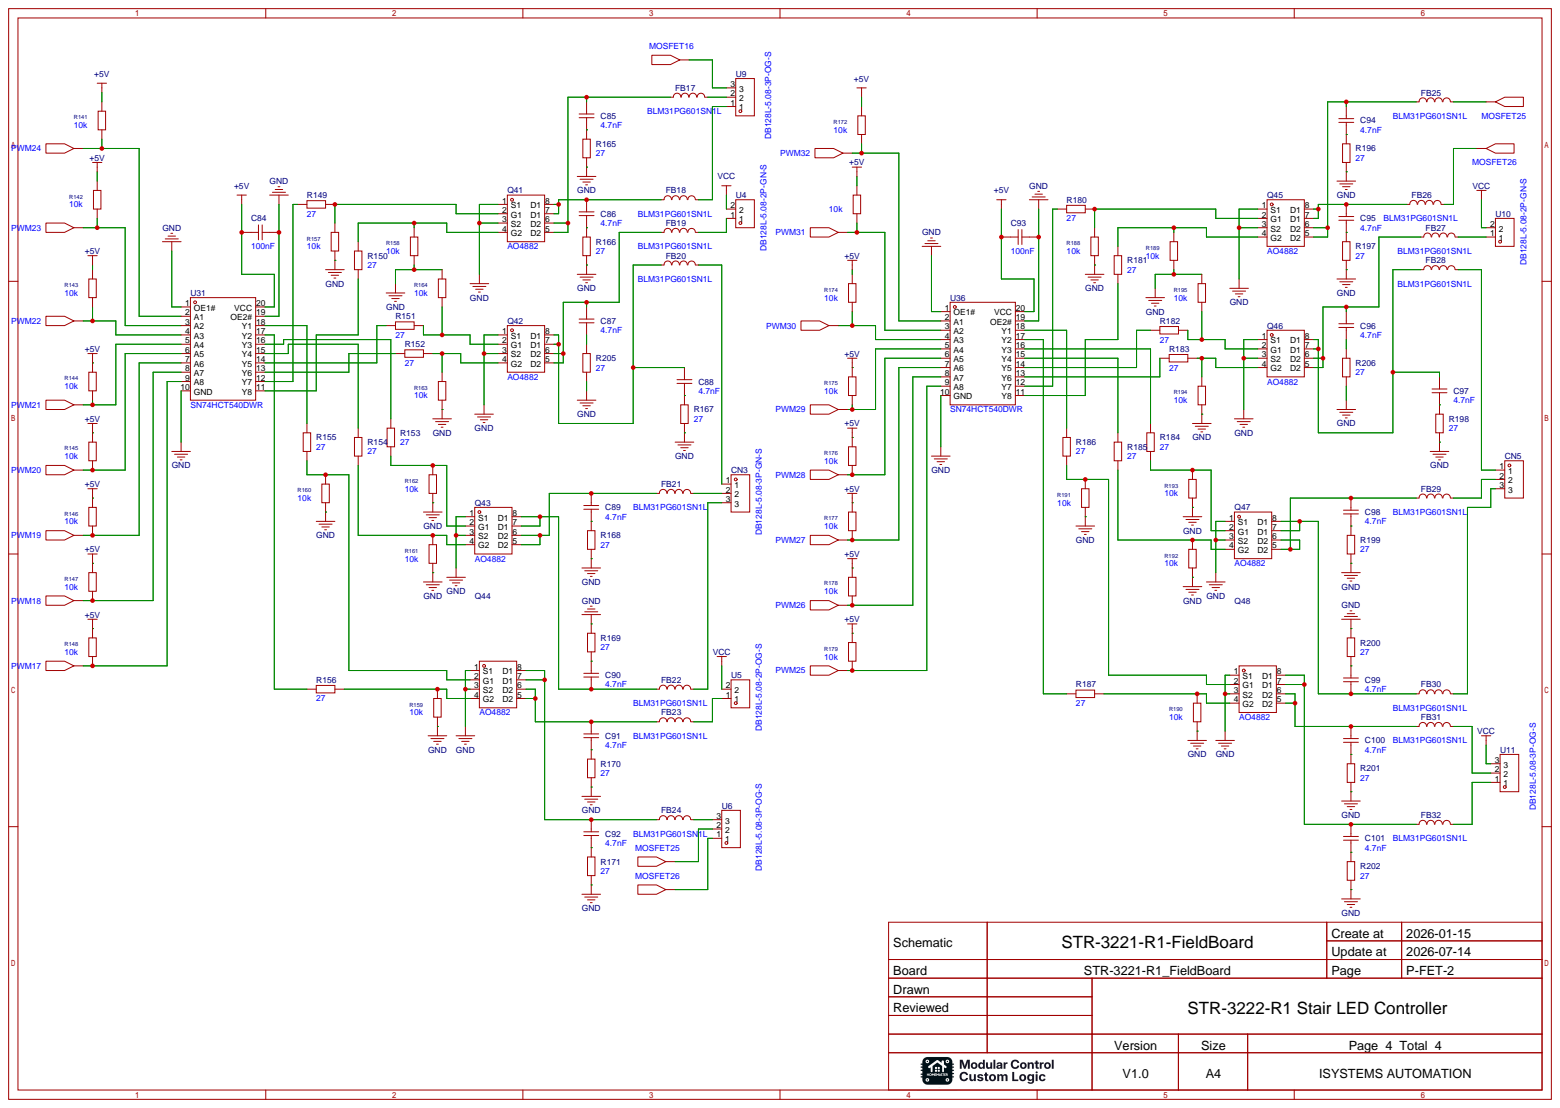
[picture p247: page 4]

Schematic | STR-3221-R1-FieldBoard | Create at | 2026-01-15

Update at | 2026-07-14

Board | STR-3221-R1_FieldBoard | Page | P-FET-2
Drawn | | STR-3222-R1 Stair LED Controller
Reviewed
