isystemsautomation/homemaster-dev/OpenthermThermostat/Schematics/LCDBoard.pdf

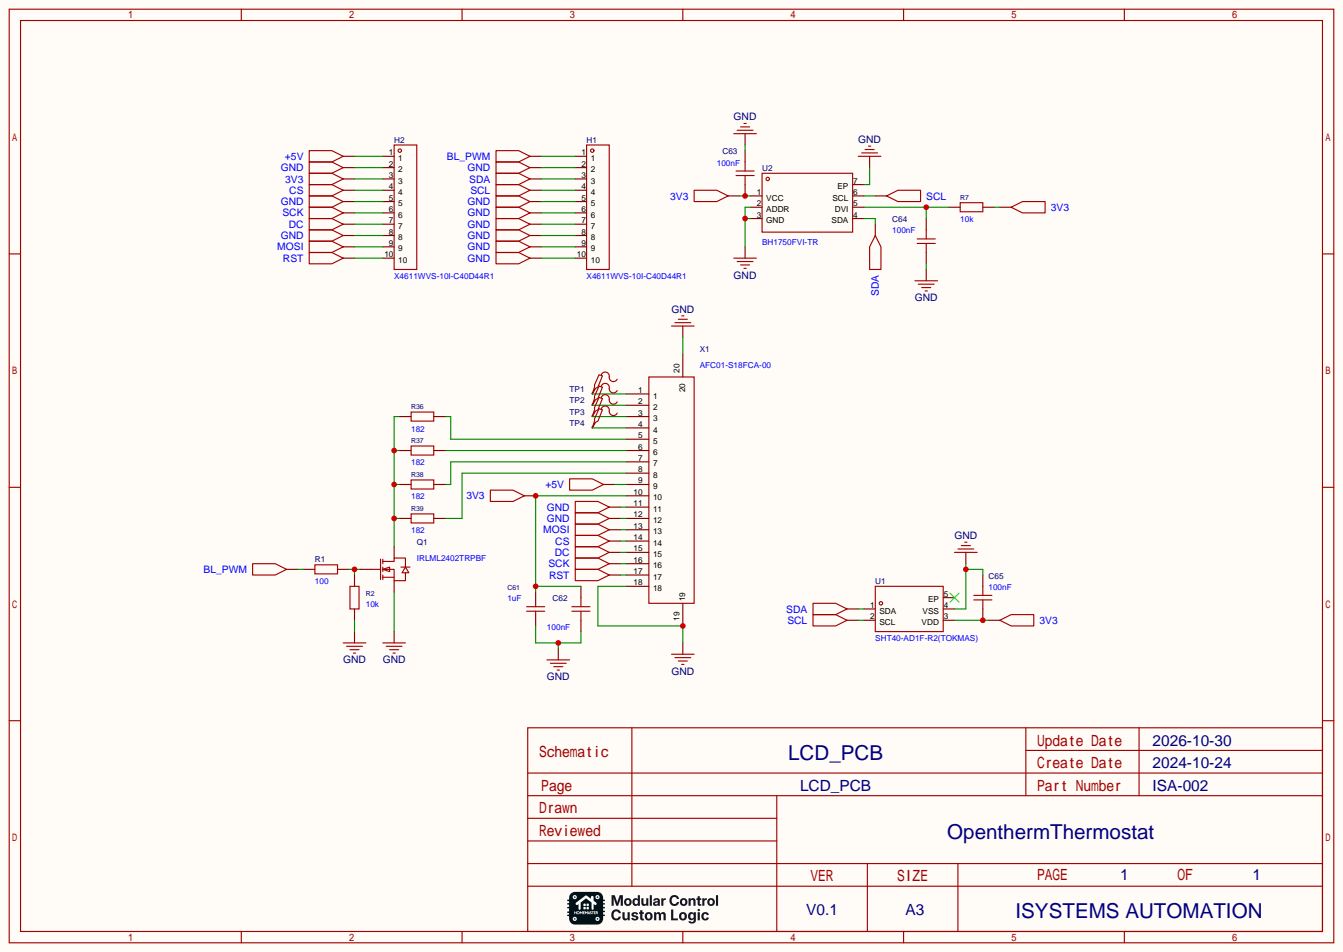
[picture p248: page 1]
