isystemsautomation/homemaster-dev/MicroPLC/Schematics/MCUBoard.pdf

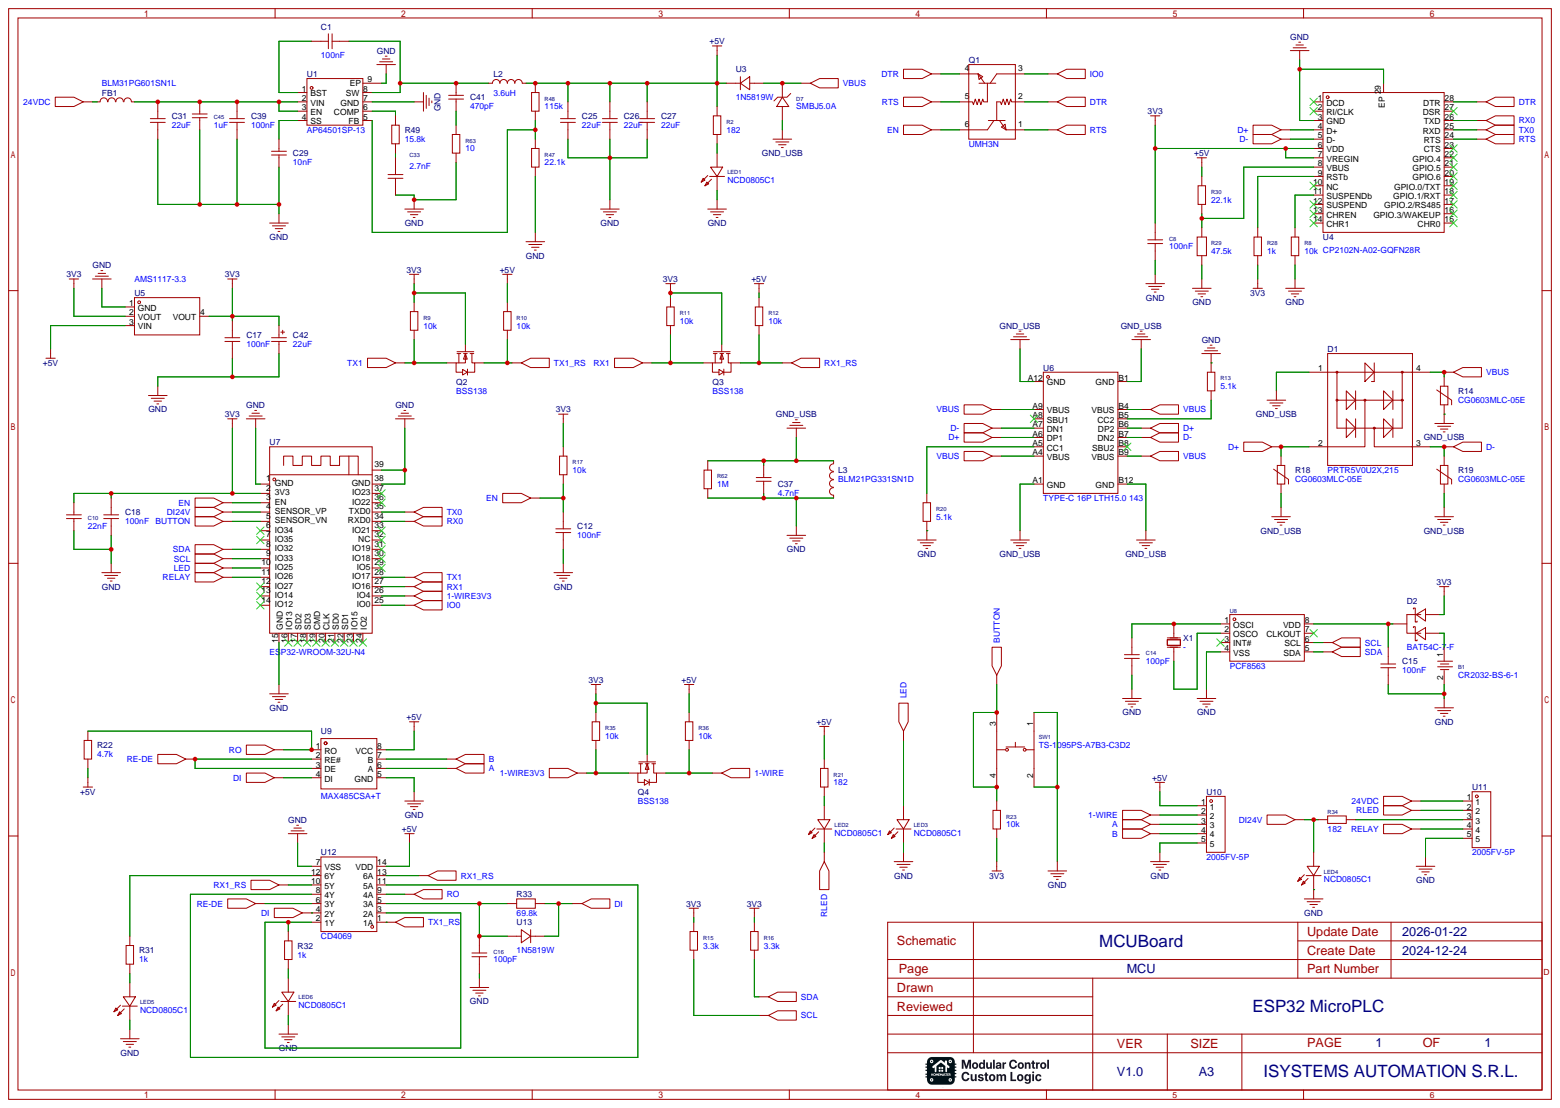
[picture p249: page 1]
