isystemsautomation/homemaster-dev/MicroPLC/Schematics/RelayBoard.pdf

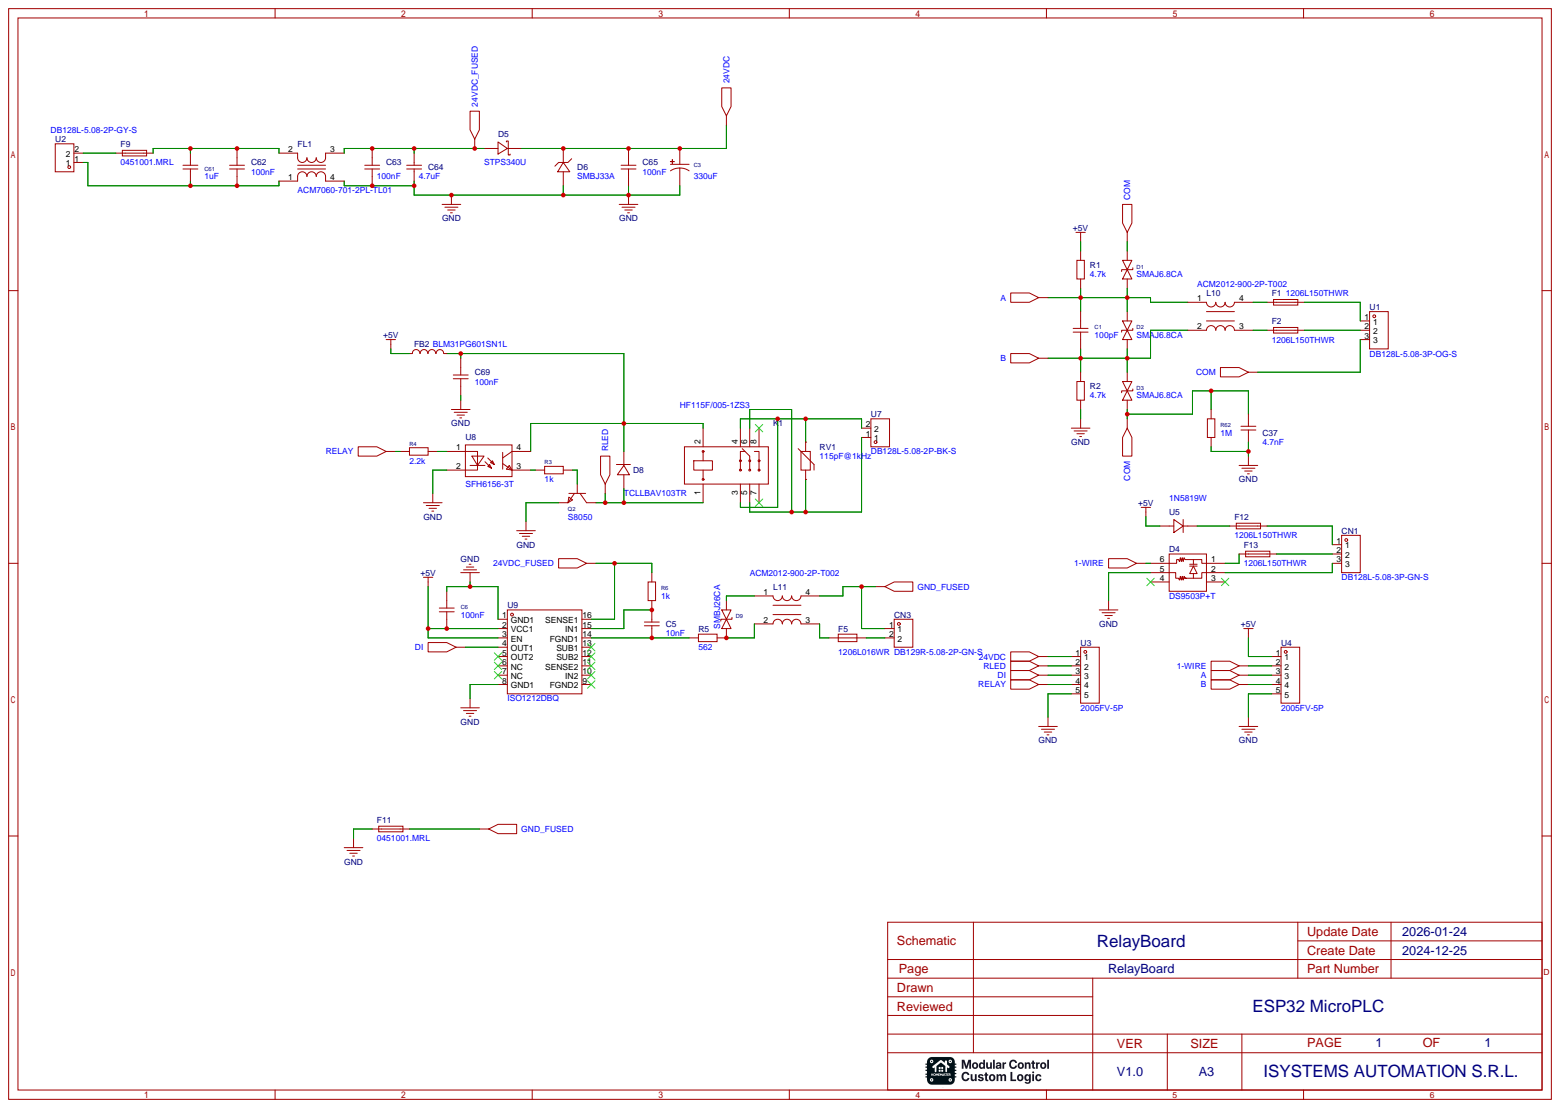
[picture p250: page 1]
