isystemsautomation/homemaster-dev/MiniPLC/Schematics/Relay_Board.pdf

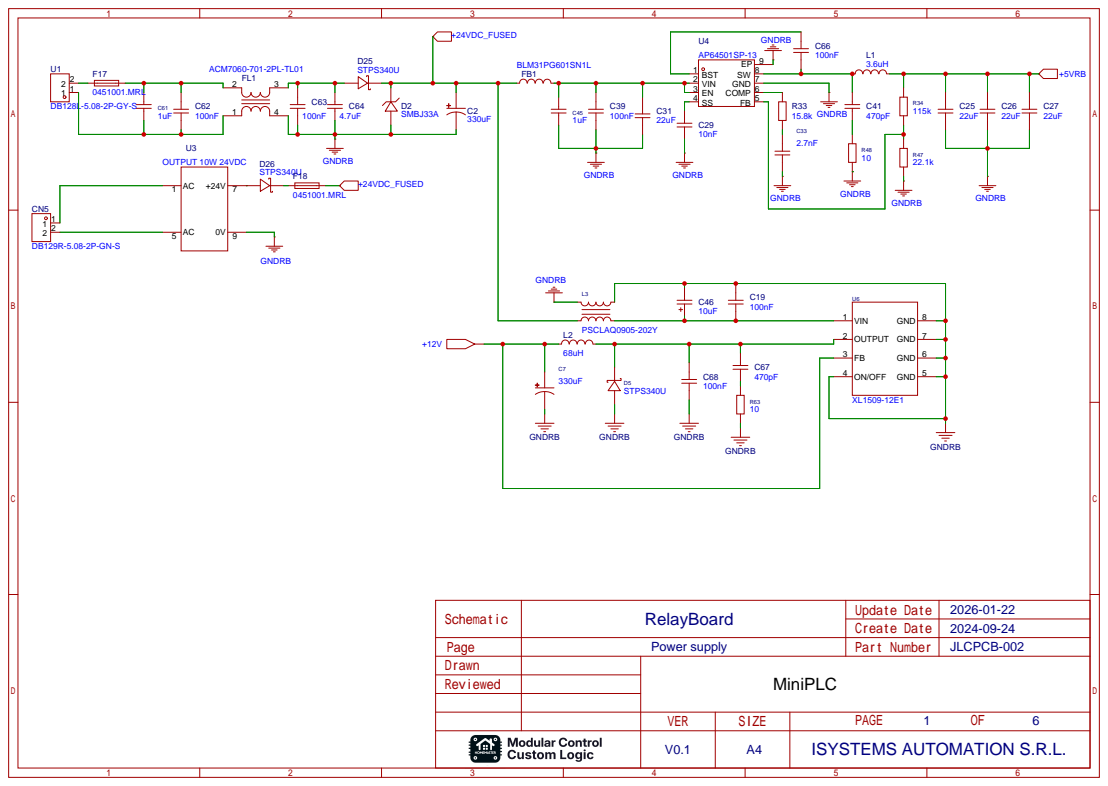
[picture p251: page 1]

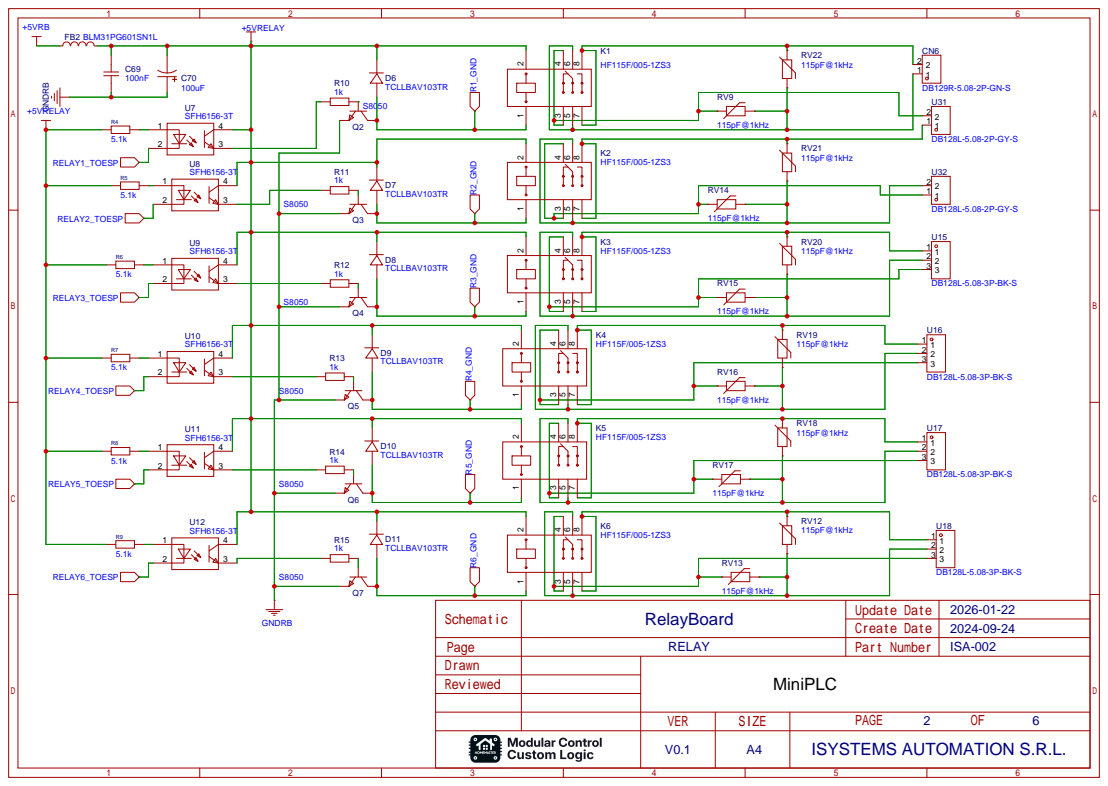
[picture p252: page 2]

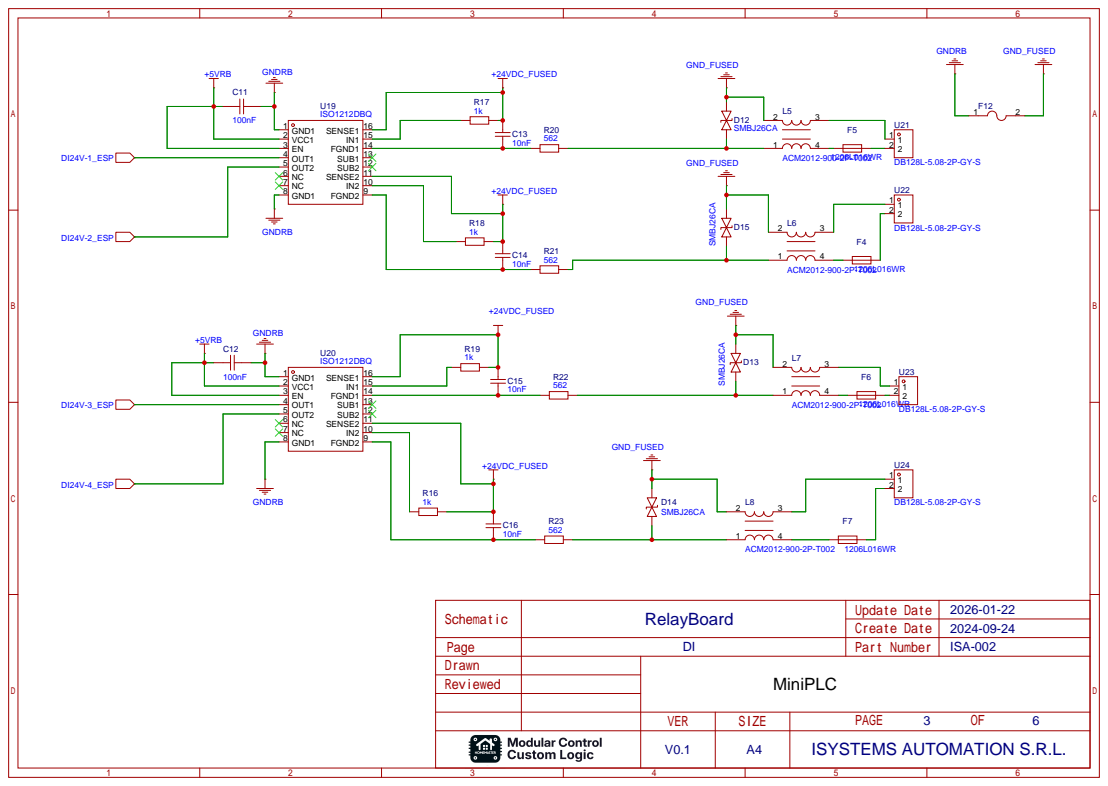
[picture p253: page 3]

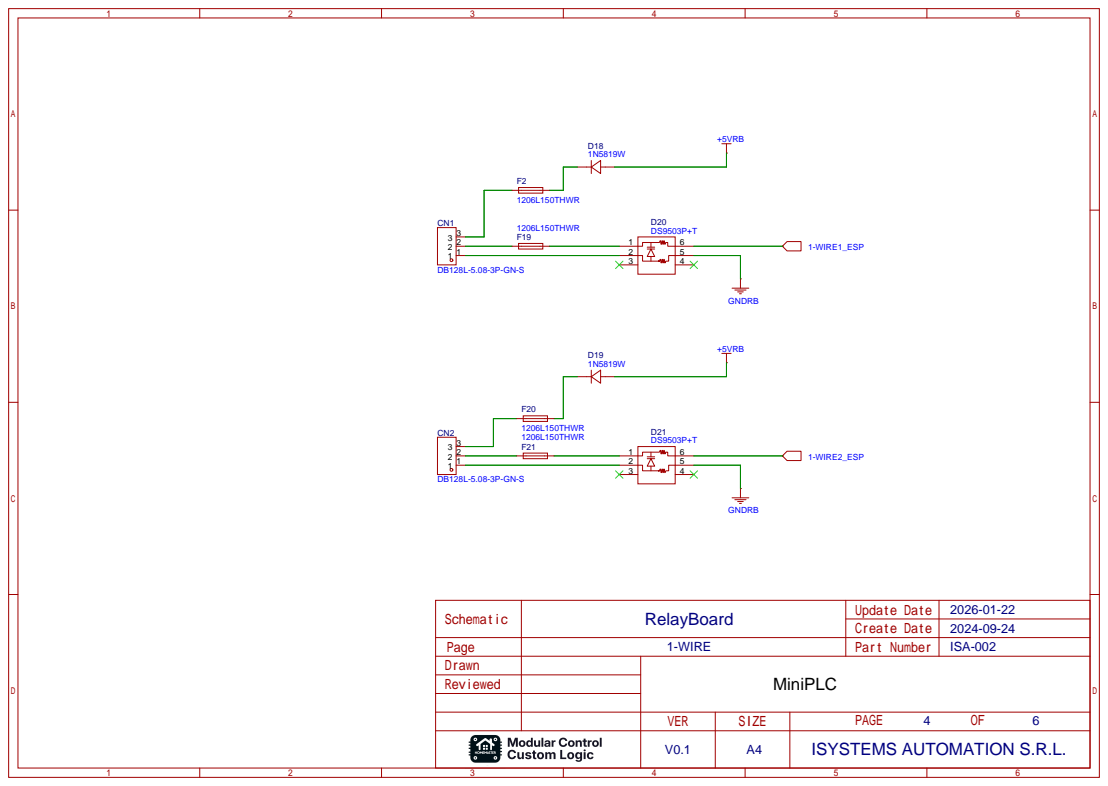
[picture p254: page 4]

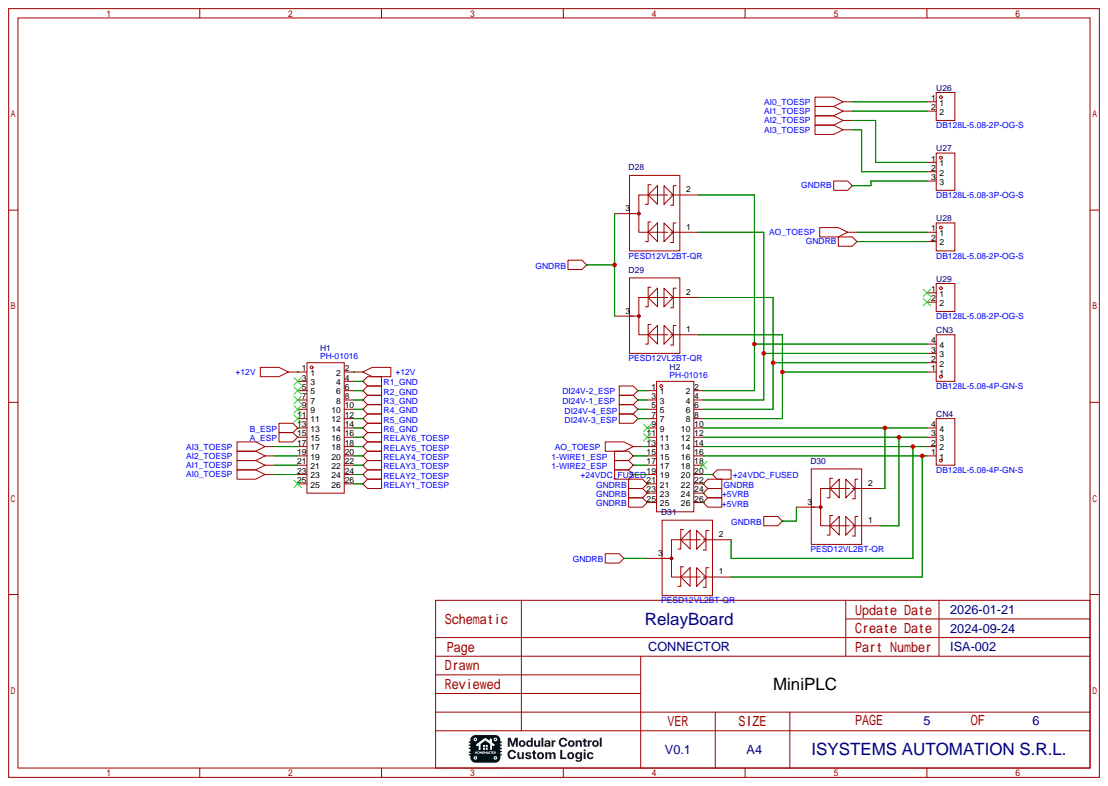
[picture p255: page 5]

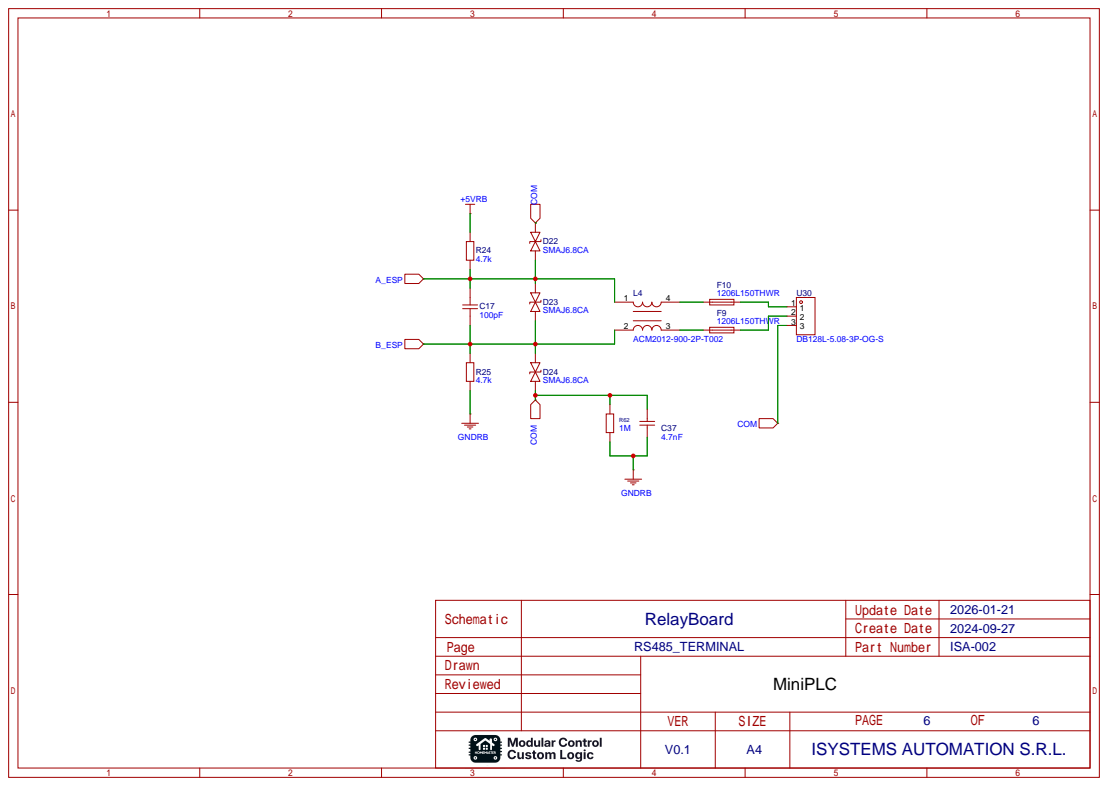
[picture p256: page 6]
