isystemsautomation/homemaster-dev/MiniPLC/Schematics/USB_Board.pdf

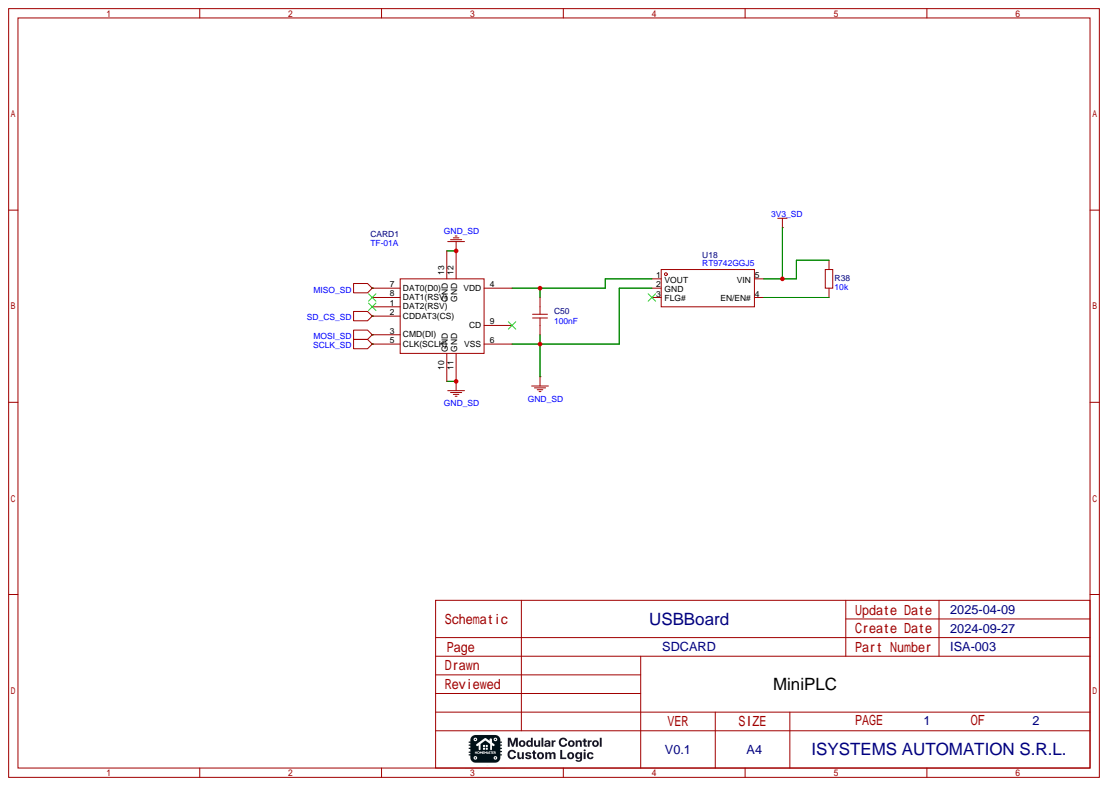
[picture p257: page 1]

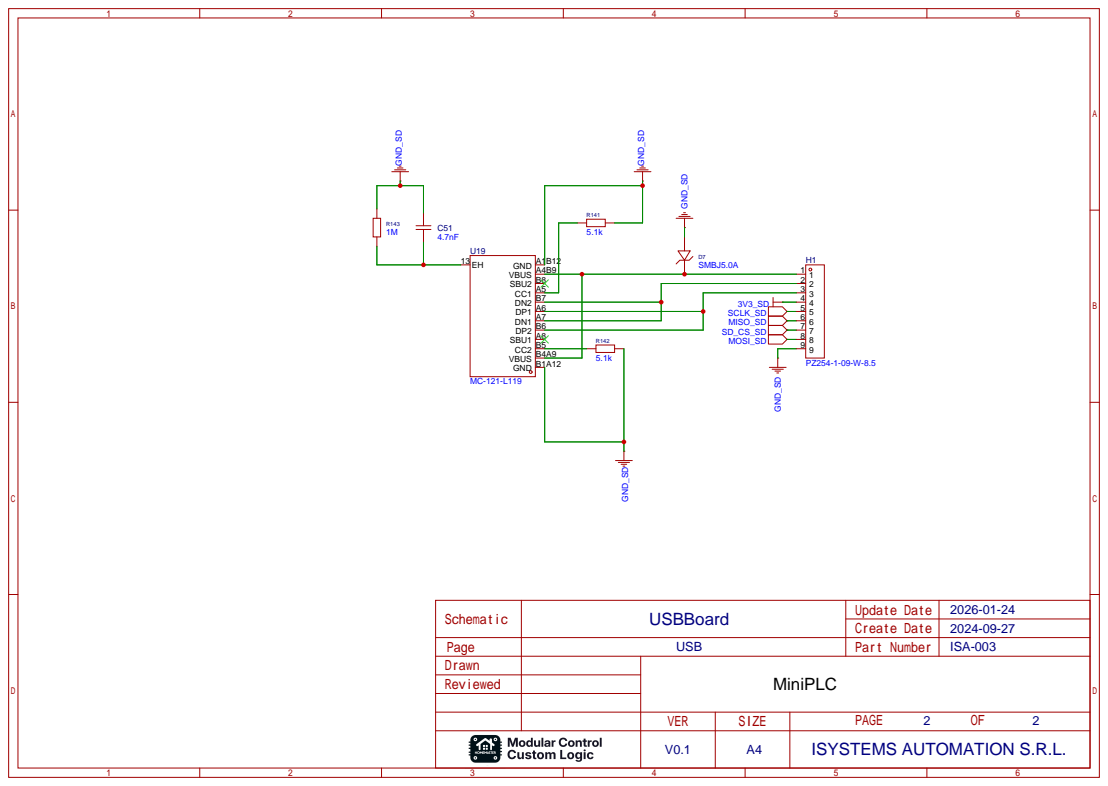
[picture p258: page 2]
