isystemsautomation/homemaster-dev/OpenthermGateway/Schematics/RelayBorard.pdf

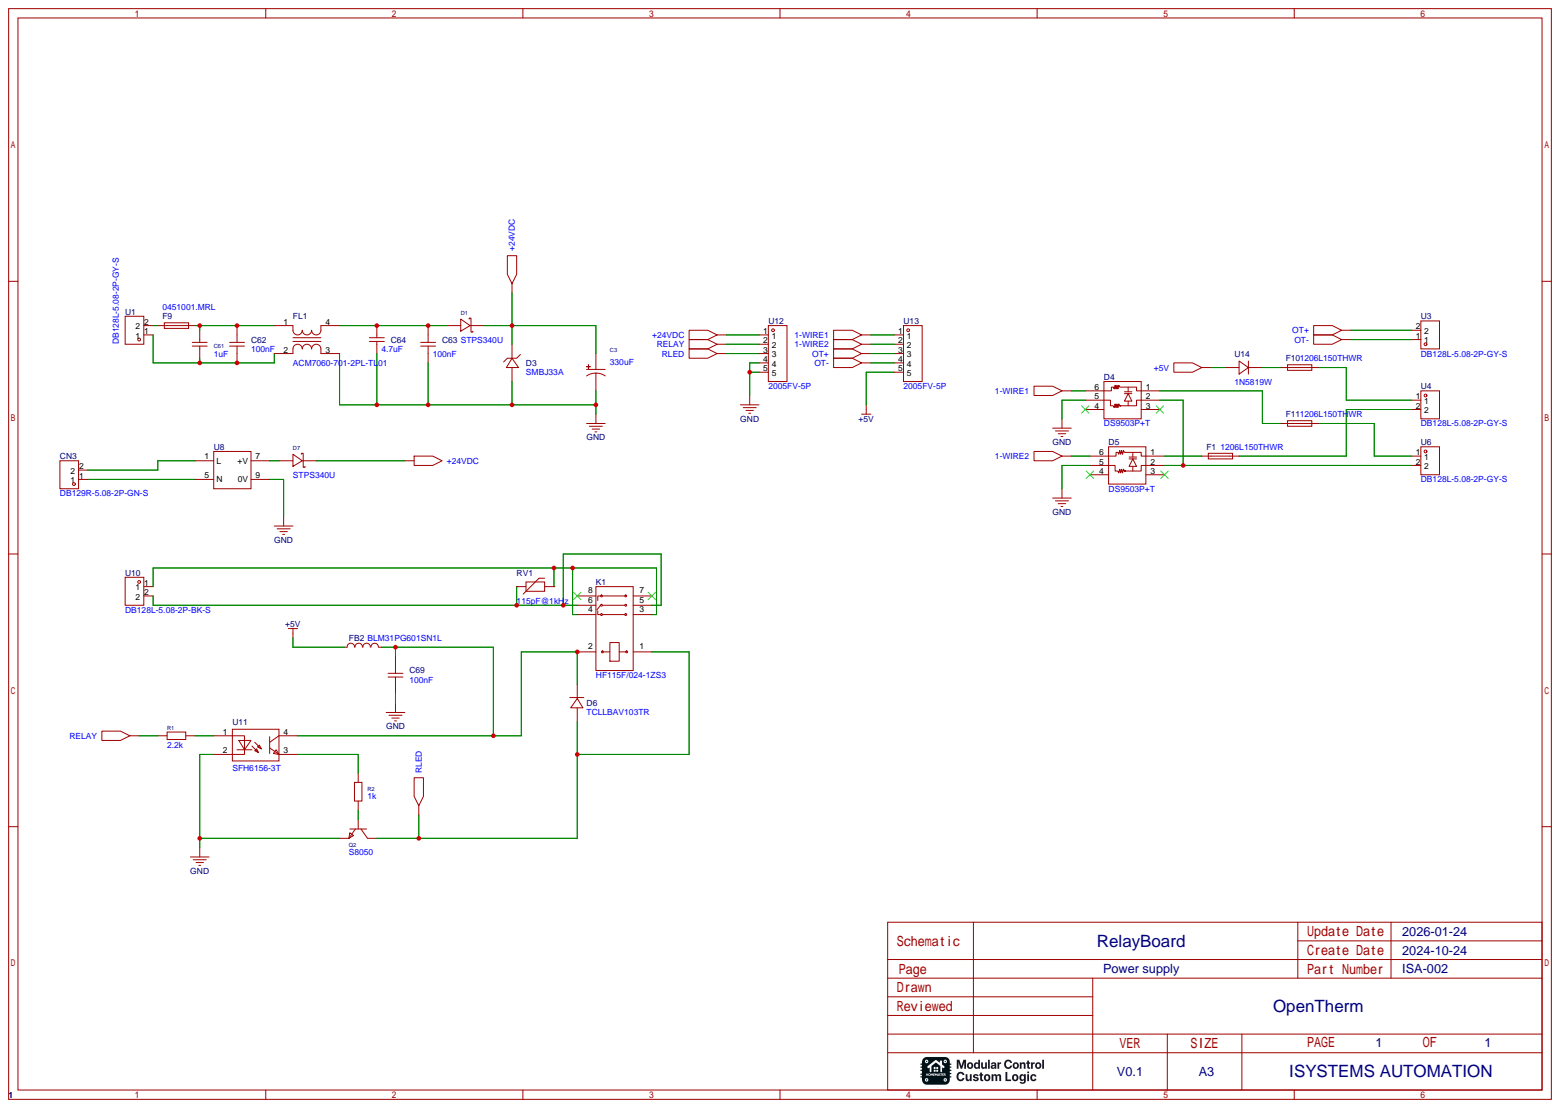
[picture p259: page 1]
