isystemsautomation/homemaster-dev/ENM-223-R1/Firmware/v0.2.0/default_enm_223_r1_plc/default_enm_223_r1_plc.yaml

##
## ENM-223-R1 — ESPHome Modbus package (v0.2.0 beta)
##
## Contiguous Input Registers FC04 @0..85 (no Discrete Inputs / FC02):
##   A  0 IO_MASK (LED0-3, BTN4-7, RLY8-9)
##      1 STATUS_FLAGS (b1 linkOk, b3 cfgDirty)
##      2 ALARM_FLAGS (bit=3*ch+kind)
##      3..6 CHIP_EV L1/L2/L3/Total (sag1/ov2/loss4/oci8/freq16/rev32)
##   B  7..9 Urms · 10 Freq · 11 Temp · 12..15 PF · 16..18 Angle · 19..21 THD
##   C  22..29 Currents S32 ×0.001 A (Irms L1-3, IrmsN)
##   D  30..53 Powers S32 (P/Q/S × L1-3-T)
##   E  54..85 Energy U32 (AP/AN/RP/RN × L1-3-T)
## Peaks / Pfund / Pharm / VAh / harmonic energy: WebSerial only (not on Modbus).
##
## Poll split (force_new_range @54 + skip_updates: 29 on every energy sensor):
##   FC04 @0  count=54  every cycle (1 s)     — A..D live measurements
##   FC04 @54 count=32  every 30th cycle      — E energy counters
## Split pays when the slow block is polled ≥ (100 + w) / w times less often than
## the fast one (w = wire time of the slow response). For 32 regs at 19200,
## w ≈ 40 ms → threshold 3.5×. skip_updates: 2 was only 3× (net loss vs merge);
## skip_updates: 29 is 30× — well above threshold, so the split beats an 86-reg
## every-cycle read (~4.7 ms/s energy cost vs ~40 ms/s if merged).
##
## Coils (DIO-style): write-only — no FC01 read-back.
##   Relay cmds 0-1 · Identify 5 · ACK 16-19. Save/Reboot/Reset-energy NOT on Modbus.
##   Public relays = template (state from IO_MASK FC04).
## Parent must supply enm_id / enm_address / enm_prefix (and global modbus_bus).
##

substitutions:
  enm_update_interval: 1s      # HomeMaster default — STD-009
  enm_command_throttle: 0ms    # HomeMaster default — STD-009

modbus_controller:
  - id: ${enm_id}
    address: ${enm_address}
    modbus_id: modbus_bus
    update_interval: ${enm_update_interval}
    command_throttle: ${enm_command_throttle}
    allow_duplicate_commands: false

binary_sensor:
  - platform: modbus_controller
    modbus_controller_id: ${enm_id}
    name: "${enm_prefix} Link OK"
    register_type: read
    address: 1
    bitmask: 0x0002
  - platform: modbus_controller
    modbus_controller_id: ${enm_id}
    name: "${enm_prefix} Config dirty"
    register_type: read
    address: 1
    bitmask: 0x0008
  - platform: modbus_controller
    modbus_controller_id: ${enm_id}
    name: "${enm_prefix} LED1"
    register_type: read
    address: 0
    bitmask: 0x0001
  - platform: modbus_controller
    modbus_controller_id: ${enm_id}
    name: "${enm_prefix} LED2"
    register_type: read
    address: 0
    bitmask: 0x0002
  - platform: modbus_controller
    modbus_controller_id: ${enm_id}
    name: "${enm_prefix} LED3"
    register_type: read
    address: 0
    bitmask: 0x0004
  - platform: modbus_controller
    modbus_controller_id: ${enm_id}
    name: "${enm_prefix} LED4"
    register_type: read
    address: 0
    bitmask: 0x0008
  - platform: modbus_controller
    modbus_controller_id: ${enm_id}
    name: "${enm_prefix} BTN1"
    register_type: read
    address: 0
    bitmask: 0x0010
  - platform: modbus_controller
    modbus_controller_id: ${enm_id}
    name: "${enm_prefix} BTN2"
    register_type: read
    address: 0
    bitmask: 0x0020
  - platform: modbus_controller
    modbus_controller_id: ${enm_id}
    name: "${enm_prefix} BTN3"
    register_type: read
    address: 0
    bitmask: 0x0040
  - platform: modbus_controller
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
    id: ${enm_id}_ack_l3_coil
    register_type: coil
    address: 18
    internal: true
    assumed_state: true
  - platform: modbus_controller
    modbus_controller_id: ${enm_id}
    id: ${enm_id}_ack_total_coil
    register_type: coil
    address: 19
    internal: true
    assumed_state: true

  # Public relays: state from IO_MASK (FC04), command via write-only coils
  - platform: template
    name: "${enm_prefix} Relay 1"
    id: ${enm_id}_relay1
    lambda: |-
      return id(${enm_id}_relay1_state).state;
    turn_on_action:
      - switch.turn_on: ${enm_id}_relay1_coil
    turn_off_action:
      - switch.turn_off: ${enm_id}_relay1_coil
  - platform: template
    name: "${enm_prefix} Relay 2"
    id: ${enm_id}_relay2
    lambda: |-
      return id(${enm_id}_relay2_state).state;
    turn_on_action:
      - switch.turn_on: ${enm_id}_relay2_coil
    turn_off_action:
      - switch.turn_off: ${enm_id}_relay2_coil

button:
  - platform: template
    name: "${enm_prefix} Identify"
    on_press:
      - switch.turn_on: ${enm_id}_cmd_identify
  - platform: template
    name: "${enm_prefix} ACK L1"
    on_press:
      - switch.turn_on: ${enm_id}_ack_l1_coil
  - platform: template
    name: "${enm_prefix} ACK L2"
    on_press:
      - switch.turn_on: ${enm_id}_ack_l2_coil
  - platform: template
    name: "${enm_prefix} ACK L3"
    on_press:
      - switch.turn_on: ${enm_id}_ack_l3_coil
  - platform: template
    name: "${enm_prefix} ACK Total"
    on_press:
      - switch.turn_on: ${enm_id}_ack_total_coil

sensor:
  - platform: modbus_controller
    modbus_controller_id: ${enm_id}
    name: "${enm_prefix} Urms L1"
    address: 7
    register_type: read
    value_type: U_WORD
    unit_of_measurement: "V"
    accuracy_decimals: 2
    filters:
      - multiply: 0.01
      - lambda: "return round(x * 100.0f) / 100.0f;"
  - platform: modbus_controller
    modbus_controller_id: ${enm_id}
    name: "${enm_prefix} Urms L2"
    address: 8
    register_type: read
    value_type: U_WORD
    unit_of_measurement: "V"
    accuracy_decimals: 2
    filters:
      - multiply: 0.01
      - lambda: "return round(x * 100.0f) / 100.0f;"
  - platform: modbus_controller
    modbus_controller_id: ${enm_id}
    name: "${enm_prefix} Urms L3"
    address: 9
    register_type: read
    value_type: U_WORD
    unit_of_measurement: "V"
    accuracy_decimals: 2
    filters:
      - multiply: 0.01
      - lambda: "return round(x * 100.0f) / 100.0f;"
  - platform: modbus_controller
    modbus_controller_id: ${enm_id}
    name: "${enm_prefix} Line Frequency"
    address: 10
    register_type: read
    value_type: U_WORD
    unit_of_measurement: "Hz"
    accuracy_decimals: 2
    filters:
      - multiply: 0.01
      - lambda: "return round(x * 100.0f) / 100.0f;"
  - platform: modbus_controller
    modbus_controller_id: ${enm_id}
    name: "${enm_prefix} Temperature"
    address: 11
    register_type: read
    value_type: S_WORD
    unit_of_measurement: "°C"
    accuracy_decimals: 0
  - platform: modbus_controller
    modbus_controller_id: ${enm_id}
    name: "${enm_prefix} PF L1"
    address: 12
    register_type: read
    value_type: S_WORD
    accuracy_decimals: 3
    filters:
      - multiply: 0.001
      - lambda: "return round(x * 1000.0f) / 1000.0f;"
  - platform: modbus_controller
    modbus_controller_id: ${enm_id}
    name: "${enm_prefix} PF L2"
    address: 13
    register_type: read
    value_type: S_WORD
    accuracy_decimals: 3
    filters:
      - multiply: 0.001
      - lambda: "return round(x * 1000.0f) / 1000.0f;"
  - platform: modbus_controller
    modbus_controller_id: ${enm_id}
    name: "${enm_prefix} PF L3"
    address: 14
    register_type: read
    value_type: S_WORD
    accuracy_decimals: 3
    filters:
      - multiply: 0.001
      - lambda: "return round(x * 1000.0f) / 1000.0f;"
  - platform: modbus_controller
    modbus_controller_id: ${enm_id}
    name: "${enm_prefix} PF Total"
    address: 15
    register_type: read
    value_type: S_WORD
    accuracy_decimals: 3
    filters:
      - multiply: 0.001
      - lambda: "return round(x * 1000.0f) / 1000.0f;"
  - platform: modbus_controller
    modbus_controller_id: ${enm_id}
    name: "${enm_prefix} Angle L1"
    address: 16
    register_type: read
    value_type: S_WORD
    unit_of_measurement: "°"
    accuracy_decimals: 1
    filters:
      - multiply: 0.1
      - lambda: "return round(x * 10.0f) / 10.0f;"
  - platform: modbus_controller
    modbus_controller_id: ${enm_id}
    name: "${enm_prefix} Angle L2"
    address: 17
    register_type: read
    value_type: S_WORD
    unit_of_measurement: "°"
    accuracy_decimals: 1
    filters:
      - multiply: 0.1
      - lambda: "return round(x * 10.0f) / 10.0f;"
  - platform: modbus_controller
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
    unit_of_measurement: "varh"
    state_class: total_increasing
    accuracy_decimals: 0
    skip_updates: 29
  - platform: modbus_controller
    modbus_controller_id: ${enm_id}
    name: "${enm_prefix} Reactive Energy Export L3"
    address: 82
    register_type: read
    value_type: U_DWORD
    unit_of_measurement: "varh"
    state_class: total_increasing
    accuracy_decimals: 0
    skip_updates: 29
  - platform: modbus_controller
    modbus_controller_id: ${enm_id}
    id: ${enm_id}_e_rn_total
    name: "${enm_prefix} Reactive Energy Export Total"
    address: 84
    register_type: read
    value_type: U_DWORD
    unit_of_measurement: "varh"
    state_class: total_increasing
    accuracy_decimals: 0
    skip_updates: 29
  - platform: template
    name: "${enm_prefix} Active Energy Net Total"
    unit_of_measurement: "Wh"
    device_class: energy
    state_class: total_increasing
    accuracy_decimals: 0
    lambda: |-
      if (!id(${enm_id}_e_ap_total).has_state() || !id(${enm_id}_e_an_total).has_state()) return {};
      return id(${enm_id}_e_ap_total).state - id(${enm_id}_e_an_total).state;
  - platform: template
    name: "${enm_prefix} Reactive Energy Net Total"
    unit_of_measurement: "varh"
    state_class: total_increasing
    accuracy_decimals: 0
    lambda: |-
      if (!id(${enm_id}_e_rp_total).has_state() || !id(${enm_id}_e_rn_total).has_state()) return {};
      return id(${enm_id}_e_rp_total).state - id(${enm_id}_e_rn_total).state;
