isystemsautomation/homemaster-dev/ENM-223-R1/Firmware/v0.2.0/default_enm_223_r1/default_enm_223_r1.ino

#include <Arduino.h>
#include <ModbusSerial.h>
#include "hm_common.h"
#define HM_MODEL_ID   2
#define HM_FW_MAJOR   0
#define HM_FW_MINOR   2
#define HM_FW_PATCH   0
#define HM_FW         "0.2.0"
// Rule 13: the module has ONE version; the Modbus map is not versioned separately.
// MAP_VERSION echoes the firmware version so there is a single consistent number.
#define HM_MAP_VERSION ((HM_FW_MAJOR << 8) | (HM_FW_MINOR << 4) | HM_FW_PATCH)  // 0x0020 = v0.2.0
// Ack/config frames are small; raise before include so large cfg/ext JSON is safer.
#ifndef BufferSize
#define BufferSize 1024
#endif
#include <SimpleWebSerial.h>
#include <Arduino_JSON.h>
#include <LittleFS.h>
#include <cstring>
#include <math.h>

#include "atm90e32.h"

// LittleFS blobs — must be before any function using them (Arduino inserts prototypes at top).
struct EnmSettingsCfgV20 {
  uint32_t magic;
  uint16_t version;
  uint16_t size;
  uint8_t  mb_address;
  uint32_t mb_baud;
  uint16_t lineHz;
  uint8_t  sumAbs;
  struct { bool enabled; bool inverted; } rlyCfg[2];
  struct { uint8_t mode; uint8_t source; } ledCfg[4];
  struct { uint8_t action; } btnCfg[4];
  uint32_t crc32;
} __attribute__((packed));

struct AlarmRuleCfg {
  uint8_t enabled;
  uint8_t metric;
  int32_t minVal;
  int32_t maxVal;
} __attribute__((packed));

struct AlarmChCfg {
  uint8_t ackRequired;
  uint8_t pad;
  AlarmRuleCfg rules[3];
} __attribute__((packed));

struct EnmSettingsCfgV21 {
  uint32_t magic;
  uint16_t version;
  uint16_t size;
  uint8_t  mb_address;
  uint32_t mb_baud;
  uint16_t lineHz;
  uint8_t  sumAbs;
  struct {
    bool    enabled;
    bool    inverted;
    uint8_t mode;
    uint8_t alarmCh;
    uint8_t alarmMask;
    uint8_t pad;
  } rlyCfg[2];
  struct { uint8_t mode; uint8_t source; } ledCfg[4];
  struct { uint8_t action; } btnCfg[4];
  AlarmChCfg alarm[4];
  uint32_t crc32;
} __attribute__((packed));

// Frozen 0x0024 layout (alarm sentinels). Migrated to EnmSettingsCfg on load.
struct EnmSettingsCfgV24 {
  uint32_t magic;
  uint16_t version;
  uint16_t size;
  uint8_t  mb_address;
  uint32_t mb_baud;
  uint16_t lineHz;
  uint8_t  sumAbs;
  uint8_t  wireMode;     // 0=3P4W, 1=3P3W
  uint8_t  phaseMap[3];  // logical L1..L3 -> physical phase 0..2 (A/B/C)
  struct {
    bool    enabled;
    bool    inverted;
    uint8_t mode;
    uint8_t alarmCh;
    uint8_t alarmMask;
    uint8_t pad;
  } rlyCfg[2];
  struct { uint8_t mode; uint8_t source; } ledCfg[4];
  struct { uint8_t action; } btnCfg[4];
  AlarmChCfg alarm[4];
  uint32_t crc32;
} __attribute__((packed));

struct EnmSettingsCfg {
  uint32_t magic;
  uint16_t version;
  uint16_t size;
  uint8_t  mb_address;
  uint32_t mb_baud;
  uint16_t lineHz;
  uint8_t  sumAbs;
  uint8_t  wireMode;     // 0=3P4W, 1=3P3W
  uint8_t  phaseMap[3];  // logical L1..L3 -> physical phase 0..2 (A/B/C)
  struct {
    bool    enabled;
    bool    inverted;
    uint8_t mode;
    uint8_t alarmCh;
    uint8_t alarmMask;
    uint8_t pad;
  } rlyCfg[2];
  struct { uint8_t mode; uint8_t source; } ledCfg[4];
  struct { uint8_t action; } btnCfg[4];
  AlarmChCfg alarm[4];
  uint16_t ctPrimaryA;       // CT primary rating (A), 1..10000
  uint16_t ctSecondary_mA;   // CT secondary rating (mA), 1..60
  uint8_t  pgaGain;          // ATM current PGA: 1, 2, or 4
  uint8_t  pad_ct;
  uint32_t crc32;
} __attribute__((packed));

// v3: energy stored as primary-domain Wh (double). CT/N must not rescale history.
struct EnmMeterCfg {
  uint32_t magic;
  uint16_t version;
  uint16_t size;
  uint16_t ucal;
  uint16_t Ugain[3];
  uint16_t Igain[3];
  int16_t  Uoffset[3];
  int16_t  Ioffset[3];
  uint8_t  _align[6];  // doubles at offset 40 (8-byte aligned)
  double   ap_Wh[4];
  double   an_Wh[4];
  double   rp_varh[4];
  double   rn_varh[4];
  double   s_VAh[4];
  double   aph_Wh[4];
  uint32_t crc32;
} __attribute__((packed));

// v2: secondary-domain 0.01CF tick counters (migrated once → primary Wh).
struct EnmMeterCfgV2 {
  uint32_t magic;
  uint16_t version;
  uint16_t size;
  uint16_t ucal;
  uint16_t Ugain[3];
  uint16_t Igain[3];
  int16_t  Uoffset[3];
  int16_t  Ioffset[3];
  uint64_t ap_cnt[4];
  uint64_t an_cnt[4];
  uint64_t rp_cnt[4];
  uint64_t rn_cnt[4];
  uint64_t s_cnt[4];
  uint64_t aph_cnt[4];
  uint32_t crc32;
} __attribute__((packed));

struct EnmMeterCfgV1 {
  uint32_t magic;
  uint16_t version;
  uint16_t size;
  uint16_t ucal;
  uint16_t Ugain[3];
  uint16_t Igain[3];
  int16_t  Uoffset[3];
  int16_t  Ioffset[3];
  uint64_t ap_cnt[4];
  uint64_t an_cnt[4];
  uint64_t rp_cnt[4];
  uint64_t rn_cnt[4];
  uint64_t s_cnt[4];
  uint32_t crc32;
} __attribute__((packed));

// Legacy monolithic blob (v0.2.0 beta / v0.1.0) — migrated on first boot.
struct EnmPersistCfgLegacy {
  uint32_t magic;
  uint16_t version;
  uint16_t size;
  uint8_t  mb_address;
  uint32_t mb_baud;
  uint16_t lineHz;
  uint8_t  sumAbs;
  uint16_t ucal;
  uint16_t Ugain[3];
  uint16_t Igain[3];
  int16_t  Uoffset[3];
  int16_t  Ioffset[3];
  uint64_t ap_cnt[4];
  uint64_t an_cnt[4];
  uint64_t rp_cnt[4];
  uint64_t rn_cnt[4];
  uint64_t s_cnt[4];
  uint32_t crc32;
} __attribute__((packed));

static const uint32_t CFG_MAGIC       = 0x334D4E45UL;  // 'ENM3'
static const uint16_t CFG_VERSION_V20 = 0x0020;
static const uint16_t CFG_VERSION_V21 = 0x0021;
static const uint16_t CFG_VERSION_V22 = 0x0022;
static const uint16_t CFG_VERSION_V23 = 0x0023;
static const uint16_t CFG_VERSION_V24 = 0x0024;  // alarm min/max: 0 is a real limit; unset = sentinels
static const uint16_t CFG_VERSION     = 0x0025;  // CT ratio + configurable PGA
static const char*    CFG_PATH        = "/enm_cfg.bin";
static const uint32_t METER_MAGIC     = 0x4D4D4E45UL;  // 'ENMM'
static const uint16_t METER_VERSION   = 0x0003;        // primary-Wh double accumulators
static const char*    METER_PATH      = "/enm_meter.bin";
static const uint16_t LEGACY_CFG_VER  = 0x0001;
static volatile bool  cfgDirty        = false;
static volatile bool  meterDirty      = false;
static unsigned long  lastCfgTouchMs  = 0;
static unsigned long  lastMeterTouchMs = 0;
static const uint32_t CFG_AUTOSAVE_MS = 1500;
// Persist energy/cal to LittleFS at most every 5 min (poll stays at energySampleMs).
static const uint32_t METER_SAVE_INTERVAL_MS = 300000;
static uint32_t       meterSavedEnergyCrc = 0;
static uint32_t       meterEnergyCrc();  // defined with sampleEnergyCounters

// Types/globals used in function signatures — must be before any function (Arduino auto-prototypes).
struct DebounceState {
  bool     raw = false;
  bool     stable = false;
  bool     prevStable = false;
  uint32_t lastChangeMs = 0;
};

enum : uint8_t {
  ALARM_KIND_ALARM   = 0,
  ALARM_KIND_WARNING = 1,
  ALARM_KIND_EVENT   = 2,
  ALARM_MET_URMS     = 0,
  ALARM_MET_IRMS     = 1,
  ALARM_MET_P        = 2,
  ALARM_MET_Q        = 3,
  ALARM_MET_S        = 4,
  ALARM_MET_FREQ     = 5,
  RLY_MODE_NONE      = 0,
  RLY_MODE_MODBUS    = 1,
  RLY_MODE_ALARM     = 2,
  CHIP_EV_SAG        = 1,
  CHIP_EV_OV         = 2,
  CHIP_EV_PHASE_LOSS = 4,
  CHIP_EV_OVER_I     = 8,
  CHIP_EV_FREQ       = 16,
  CHIP_EV_REV_PHASE  = 32
};

struct AlarmRuleRun {
  bool active;
  bool prevActive;  // rising-edge detect for latch
  bool hiSide;
  bool latched;     // stays set after trip until Ack (when ackRequired)
  bool heldOff;     // Ack while still active — stay off until condition clears
};

struct AlarmChRun {
  AlarmRuleRun rules[3];
  bool chipActive;
};

static bool meter_job = false;

// SimpleWebSerial: MaximumNumberOfEvents = 8 (library default). Never register more than 8 handlers.
static SimpleWebSerial WebSerial;
static inline void wsLog(const char* msg) { WebSerial.send("log", msg); }
static inline void wsLog(const String& msg) { WebSerial.send("log", msg); }

// ================== Modbus linkOk detector (DIO-compatible) ==================
static uint32_t g_lastLinkSeenMs = 0;
static const uint16_t g_linkTimeoutMs = 5000;
// Arduino_JSON: (int)obj["key"] returns ASCII of first key char, not the numeric value.
static inline String jsonBlob(const JSONVar& v) {
  return JSON.stringify((JSONVar&)v);
}
static int parseKeyFromBlob(const String& blob, const char* key, int fallback) {
  if (blob.length() == 0 || blob == "null" || blob == "undefined") return fallback;
  String pat = String("\"") + key + "\":";
  int pos = blob.indexOf(pat);
  if (pos < 0) {
    pat = String(key) + ":";
    pos = blob.indexOf(pat);
    if (pos < 0) return fallback;
    pos += pat.length();
  } else {
    pos += pat.length();
  }
  while (pos < (int)blob.length() && (blob[pos] == ' ' || blob[pos] == '\t')) pos++;
  if (pos >= (int)blob.length()) return fallback;
  // JSON booleans: String.toInt("true") is 0 — treat explicitly.
  if (blob[pos] == 't' || blob[pos] == 'T') return 1;
  if (blob[pos] == 'f' || blob[pos] == 'F') return 0;
  int end = pos;
  if (blob[end] == '"') {
    end++;
    while (end < (int)blob.length() && blob[end] != '"') end++;
  } else {
    while (end < (int)blob.length() && blob[end] != ',' && blob[end] != '}' && blob[end] != ']') end++;
  }
  return blob.substring(pos, end).toInt();
}

// hasOwnProperty is unreliable on some JSONVar copies from WebSerial — also
// probe the stringified blob (same path jvGetInt already uses for values).
static bool jvHasKey(const JSONVar& obj, const char* key) {
  if (obj.hasOwnProperty(key)) return true;
  if (JSON.typeof(obj[key]) != "undefined") return true;
  const String blob = jsonBlob(obj);
  if (blob.length() == 0 || blob == "null" || blob == "undefined") return false;
  return blob.indexOf(String("\"") + key + "\":") >= 0;
}

static int jvGetInt(const JSONVar& obj, const char* key, int fallback) {
  if (!jvHasKey(obj, key)) return fallback;
  return parseKeyFromBlob(jsonBlob(obj), key, fallback);
}

static double parseKeyDoubleFromBlob(const String& blob, const char* key, double fallback) {
  if (blob.length() == 0 || blob == "null" || blob == "undefined") return fallback;
  String pat = String("\"") + key + "\":";
  int pos = blob.indexOf(pat);
  if (pos < 0) return fallback;
  pos += pat.length();
  while (pos < (int)blob.length() && (blob[pos] == ' ' || blob[pos] == '\t')) pos++;
  if (pos >= (int)blob.length()) return fallback;
  if (blob[pos] == 'n' || blob[pos] == 'N') return fallback;  // null
  int end = pos;
  if (blob[end] == '"') {
    end++;
    pos++;
    while (end < (int)blob.length() && blob[end] != '"') end++;
    return blob.substring(pos, end).toDouble();
  }
  while (end < (int)blob.length() && blob[end] != ',' && blob[end] != '}' && blob[end] != ']') end++;
  const String s = blob.substring(pos, end);
  if (s.length() == 0 || s == "null" || s == "undefined") return fallback;
  return s.toDouble();
}

static double jvGetDouble(const JSONVar& obj, const char* key, double fallback) {
  if (!jvHasKey(obj, key)) return fallback;
  // Prefer blob parse — nested JSONVar doubles often stringify as null (Arduino_JSON).
  const String blob = jsonBlob(obj);
  const String pat = String("\"") + key + "\":";
  const int pos = blob.indexOf(pat);
  if (pos >= 0) {
    int p = pos + pat.length();
    while (p < (int)blob.length() && (blob[p] == ' ' || blob[p] == '\t')) p++;
    if (p < (int)blob.length() && blob[p] != 'n' && blob[p] != 'N')
      return parseKeyDoubleFromBlob(blob, key, fallback);
  }
  const String s = JSON.stringify(obj[key]);
  if (s.length() == 0 || s == "null" || s == "undefined" || s == "\"\"") return fallback;
  if (s.charAt(0) == '"') return s.substring(1, (int)s.length() - 1).toDouble();
  return s.toDouble();
}

// JSON.stringify(value) for scalars only; avoids (int)obj["key"] bug
static int jsonVarToInt(const JSONVar& v, int fallback) {
  if (JSON.typeof(v) == "undefined") return fallback;
  const String s = JSON.stringify(v);
  if (s.length() == 0 || s == "null" || s == "undefined") return fallback;
  return s.toInt();
}

#define TX2 4
#define RX2 5
static const int TxenPin = -1;
static int SlaveId = 3;
static ModbusSerial mb(Serial2, SlaveId, TxenPin);

static inline void setSlaveIdIfAvailable(ModbusSerial& m, uint8_t id) {
  m.setSlaveId(id);
}

static const uint8_t RELAY_PINS[2] = {0, 1};
static const uint8_t LED_PINS[4]   = {18, 19, 20, 21};
static const uint8_t BTN_PINS[4]   = {22, 23, 24, 25};

static const uint8_t NUM_RLY = 2;
static const uint8_t NUM_LED = 4;
static const uint8_t NUM_BTN = 4;

struct RlyCfg {
  bool    enabled;
  bool    inverted;
  uint8_t mode;
  uint8_t alarmCh;
  uint8_t alarmMask;
};
struct LedCfg { uint8_t mode; uint8_t source; };
struct BtnCfg { uint8_t action; };

// LED source: 0=None, 5/6=Override R1/R2, 10..21=Alarm/Warning/Event × L1..Total
static inline uint8_t sanitizeLedSource(int s) {
  if (s == 0 || s == 5 || s == 6) return (uint8_t)s;
  if (s >= 10 && s <= 21) return (uint8_t)s;
  return 0;
}

// Button action: 0=None, 5/6=Toggle R1/R2, 7=Ack All, 8..11=Ack L1..Total
static inline uint8_t sanitizeBtnAction(int v) {
  if (v == 0 || v == 5 || v == 6) return (uint8_t)v;
  if (v >= 7 && v <= 11) return (uint8_t)v;
  return 0;
}

static RlyCfg rlyCfg[NUM_RLY];
static LedCfg ledCfg[NUM_LED];
static BtnCfg btnCfg[NUM_BTN];

static bool buttonState[NUM_BTN]  = {false,false,false,false};

static DebounceState btnDeb[NUM_BTN];
static const uint32_t g_debounceMs = 25;

static bool desiredRelay[NUM_RLY] = {false,false};

static unsigned long lastWebFrameMs = 0;
static const unsigned long webFrameIntervalMs = 200;
static uint8_t webFramePhase = 0;
static unsigned long lastMeterWebMs = 0;
static const unsigned long meterWebIntervalMs = 1000;
static unsigned long lastBootstrap = 0;
static const unsigned long bootstrapInterval = 10000;
static bool webHostConnected = false;

static void sendWebCfgCore();
static void sendWebExt();
static void resetEnergyCounters();
static void sendWebIo(const bool* relayLogical, const bool* buttonState, const bool* ledPhysState);
static void serviceWebTelemetry(unsigned long now, const bool* relayLogical, const bool* buttonState, const bool* ledPhysState);
static void serviceMeterWeb(unsigned long now);

// Web Serial does not assert USB-CDC DTR. Do not gate sends on (bool)Serial or
// availableForWrite thresholds — v0.1.0 sends unconditionally; blocking here
// prevented all telemetry with passive WebConfig hosts.
void sendWebBootstrap();
static void markWebHostRx() {
  const bool fresh = !webHostConnected;
  webHostConnected = true;
  if (fresh) sendWebBootstrap();
}

static unsigned long lastBlinkToggle = 0;
static const unsigned long blinkPeriodMs = 400;
static bool blinkPhase = false;
static uint32_t g_identifyUntilMs = 0;
static const uint32_t IDENTIFY_MS = 5000;

static uint8_t  g_mb_address = 3;
static uint32_t g_mb_baud    = 19200;
static bool     g_mbSerialReady = false;

// CT ratio: primary = (chip secondary reading in mA-units) × N.
// N = ctPrimaryA / ctSecondary_mA. Factory Igain/PGA calibrate 0…60 mA secondary;
// they are NOT derived from the CT. Defaults: 100 A : 50 mA → N = 2.
static uint16_t g_ctPrimaryA     = 100;
static uint16_t g_ctSecondary_mA = 50;
static uint8_t  g_pgaGain        = 2;
static double   g_ctRatioN       = 2.0;

static void clampCtPgaSettings() {
  // 0 means "unset" (fresh/migrated flash), not 1 mA — clamping 0→1 made N=100
  // and turned one 0xFFFF SPI frame into 20.480 kWh on every channel.
  if (g_ctPrimaryA < 1) g_ctPrimaryA = 100;
  if (g_ctPrimaryA > 10000) g_ctPrimaryA = 10000;
  if (g_ctSecondary_mA < 1) g_ctSecondary_mA = 50;
  if (g_ctSecondary_mA > 60) g_ctSecondary_mA = 60;
  if (g_pgaGain != 1 && g_pgaGain != 2 && g_pgaGain != 4) g_pgaGain = 2;
}

static void recomputeCtRatio();
static void setCtDefaults() {
  g_ctPrimaryA = 100;
  g_ctSecondary_mA = 50;
  g_pgaGain = 2;
  recomputeCtRatio();
}

static bool isAllowedBaud(uint32_t b) {
  return b == 9600 || b == 19200 || b == 38400 || b == 57600 || b == 115200;
}

static const uint8_t ATM_SCK  = 10;
static const uint8_t ATM_MOSI = 11;
static const uint8_t ATM_MISO = 12;
static const uint8_t ATM_CS   = 13;
static const uint8_t ATM_PM1  = 2;
static const uint8_t ATM_PM0  = 3;

static ATM90E32 g_atm(SPI1, ATM_CS, ATM_PM0, ATM_PM1, 200000, SPI_MODE0, false);

struct AtmCfg {
  uint16_t lineHz;
  uint8_t  sumAbs;
  uint8_t  wireMode;
  uint8_t  phaseMap[3];
  uint16_t ucal;
  M90PhaseCal cal[3];
};
static AtmCfg g_atm_cfg;

static bool validatePhaseMap(const uint8_t map[3]) {
  bool used[3] = {false, false, false};
  for (int i = 0; i < 3; i++) {
    if (map[i] > 2) return false;
    if (used[map[i]]) return false;
    used[map[i]] = true;
  }
  return true;
}

static void normalizePhaseMap(uint8_t map[3]) {
  if (!validatePhaseMap(map)) {
    map[0] = 0;
    map[1] = 1;
    map[2] = 2;
  }
}

static volatile bool atmApplyPending = false;
static volatile bool atmCalOnlyPending = false;
static unsigned long atmLastApplyMs = 0;
static const unsigned long atmApplyMinIntervalMs = 300;
static bool atmBusy = false;


// Contiguous Input Register map (FC04) — beta; no Discrete Inputs.
// Order: status → scalars → currents S32 → powers S32 → energy U32 (0..85).
// Trimmed: peaks / Pfund / Pharm / VAh / harmonic energy stay on WebSerial only.
// Matches default_enm_223_r1_plc.yaml. Coils/Holding unchanged.
enum : uint16_t {
  COIL_RELAY1 = 0,
  COIL_RELAY2 = 1,
  // Service coils (DIO-style)
  COIL_IDENTIFY     = 5,
  COIL_SAVE_CFG     = 6,
  COIL_REBOOT       = 7,
  COIL_RESET_ENERGY = 8,
  COIL_ACK_BASE = 16,

  // --- A. Status / flags (U16 bitmaps) ---
  IR_IO_MASK      = 0,
  IR_STATUS_FLAGS = 1,
  IR_ALARM_FLAGS  = 2,
  IR_CHIP_EV_L1   = 3,
  IR_CHIP_EV_L2   = 4,
  IR_CHIP_EV_L3   = 5,
  IR_CHIP_EV_TOT  = 6,
  // --- B. Instantaneous scalars (U16/S16) ---
  IR_URMS_BASE  = 7,     // U16 ×0.01 V, L1..L3
  IR_FREQ       = 10,    // U16 ×0.01 Hz
  IR_TEMP       = 11,    // S16 °C
  IR_PF_BASE    = 12,    // S16 ×0.001, L1..L3..Total
  IR_ANG_BASE   = 16,    // S16 ×0.1°, L1..L3
  IR_THD_BASE   = 19,    // U16 ×0.01 %, L1..L3
  // --- C. Currents S32 ×0.001 A primary (hi-word first) ---
  IR_IRMS_BASE  = 22,    // L1,L2,L3 — 2 regs each (22,24,26)
  IR_IRMSN      = 28,    // Neutral (28,29)
  // --- D. Powers S32 (hi-word first) ---
  IR_P_BASE     = 30,    // W,   L1..L3..Total (30,32,34,36)
  IR_Q_BASE     = 38,    // var  (38,40,42,44)
  IR_S_BASE     = 46,    // VA   (46,48,50,52)
  // --- E. Energy U32 (slow; hi-word first) ---
  IR_E_AP_BASE  = 54,    // AP import  Wh,   L1..Total (54,56,58,60)
  IR_E_AN_BASE  = 62,    // AP export  Wh    (62,64,66,68)
  IR_E_RP_BASE  = 70,    // RP import  varh  (70,72,74,76)
  IR_E_RN_BASE  = 78,    // RN export  varh  (78,80,82,84)
  IR_COUNT      = 86,    // contiguous 0..85

  HR_MB_ADDR    = 0,
  HR_MB_BAUD_L  = 1,
  HR_LINE_HZ    = 4,
  HR_SUM_ABS    = 5,
  HR_RLY_EN_BASE = 7,
  // HR 2,3,6 reserved — read-only, not applied from Modbus
};

// Published integers (Modbus / WebSerial) — rounded from primary accumulators.
static uint32_t g_e_ap_Wh[4] = {0}, g_e_an_Wh[4] = {0}, g_e_rp_varh[4] = {0};
static uint32_t g_e_rn_varh[4] = {0}, g_e_s_VAh[4] = {0};
static uint32_t g_e_aph_Wh[4] = {0};
// Primary-domain energy (Wh / varh / VAh). N scales only future deltas.
static double g_acc_ap_Wh[4] = {0}, g_acc_an_Wh[4] = {0}, g_acc_rp_varh[4] = {0};
static double g_acc_rn_varh[4] = {0}, g_acc_s_VAh[4] = {0}, g_acc_aph_Wh[4] = {0};
static uint32_t g_MC_imp_per_kWh = 3200;

static bool mbMapBuilt = false;

static void mbBuildRegisterMap() {
  if (mbMapBuilt) return;
  mbMapBuilt = true;
  // Coils actually used: relays 0-1, identify 5, ACK 16-19. (save/reboot/reset dropped — A1)
  static const uint16_t kCoils[] = {0, 1, 5, 16, 17, 18, 19};
  for (uint16_t i = 0; i < (uint16_t)(sizeof(kCoils) / sizeof(kCoils[0])); ++i) {
    mb.addCoil(kCoils[i]);
    mb.Coil(kCoils[i], false);
  }
  // No Discrete Inputs — digital state is bit-packed into IR_IO_MASK / IR_ALARM_FLAGS.
  for (uint16_t r = 0; r < IR_COUNT; ++r) mb.addIreg(r);
  // Holding regs used by applyHoldingFromModbus/mbSyncHolding:
  //   addr(0), baud(1-2), lineHz(4), sumAbs(5), relay-en(7-8). Register 0..8.
  for (uint16_t r = 0; r <= 8; ++r) mb.addHreg(r);
}

static inline void mbPutU32Ir(uint16_t reg, uint32_t v) {
  mb.Ireg(reg + 0, (uint16_t)((v >> 16) & 0xFFFF));
  mb.Ireg(reg + 1, (uint16_t)(v & 0xFFFF));
}
static inline void mbPutS32Ir(uint16_t reg, int32_t v) {
  mbPutU32Ir(reg, (uint32_t)v);
}
static inline void mbPutU32Hr(uint16_t reg, uint32_t v) {
  mb.Hreg(reg + 0, (uint16_t)((v >> 16) & 0xFFFF));
  mb.Hreg(reg + 1, (uint16_t)(v & 0xFFFF));
}

static void mbSyncHolding() {
  mb.Hreg(HR_MB_ADDR, g_mb_address);
  mbPutU32Hr(HR_MB_BAUD_L, g_mb_baud);
  mb.Hreg(HR_LINE_HZ, g_atm_cfg.lineHz);
  mb.Hreg(HR_SUM_ABS, g_atm_cfg.sumAbs);
  mb.Hreg(HR_RLY_EN_BASE + 0, rlyCfg[0].enabled ? 1 : 0);
  mb.Hreg(HR_RLY_EN_BASE + 1, rlyCfg[1].enabled ? 1 : 0);
}

static void serviceDebounce(DebounceState& st, bool raw, uint32_t now) {
  if (raw != st.raw) {
    st.raw = raw;
    st.lastChangeMs = now;
  }
  if ((uint32_t)(now - st.lastChangeMs) >= g_debounceMs) {
    st.prevStable = st.stable;
    st.stable = st.raw;
  }
}

static void serviceModbusRelays() {
  // Command intake only: a master-written coil sets desired, and only in Modbus mode
  // (Alarm/None relays are owned by internal logic). The coil image itself is refreshed
  // to the real relay state by the honest-mirror write in the IO service loop.
  for (int i = 0; i < NUM_RLY; i++) {
    if (rlyCfg[i].mode != RLY_MODE_MODBUS) continue;
    const bool c = mb.Coil((uint16_t)i);
    if (c != desiredRelay[i]) desiredRelay[i] = c;
  }
}

static void serviceModbusServiceCoils(uint32_t now) {
  if (mb.Coil(COIL_IDENTIFY)) {
    mb.Coil(COIL_IDENTIFY, false);
    g_identifyUntilMs = now + IDENTIFY_MS;
    wsLog("Identify: LEDs active for 5 s");
  }
  // Save/Reboot/Reset-energy are NOT exposed over Modbus (shared-bus safety).
  // Config autosaves; reboot / energy-reset / factory remain via WebConfig commands.
}

static void updateLinkOkDetector(uint32_t now) {
  // Peek BEFORE mb.task() drains RX. Only frames addressed to us (or broadcast)
  // count as link — shared RS-485 traffic to other slaves must not set linkOk.
  if (Serial2.available() < 1) return;
  const int addr = Serial2.peek();
  if (addr < 0) return;
  if (addr == 0 || addr == (int)g_mb_address) g_lastLinkSeenMs = now;
}

static inline bool linkOkNow(uint32_t now) {
  return ((uint32_t)(now - g_lastLinkSeenMs) < (uint32_t)g_linkTimeoutMs);
}

static void mbUpdateStatusFlags(uint32_t now) {
  uint16_t status = 0;
  if (linkOkNow(now)) status |= (1 << 1);
  if (cfgDirty)       status |= (1 << 3);
  mb.Ireg(IR_STATUS_FLAGS, status);
}

static inline uint16_t clamp_u16(int v) {
  if (v < 0) v = 0;
  if (v > 65535) v = 65535;
  return (uint16_t)v;
}
static inline int16_t clamp_i16(int v) {
  if (v < -32768) v = -32768;
  if (v >  32767) v =  32767;
  return (int16_t)v;
}

static void setAtmDefaults() {
  g_atm_cfg.lineHz = 50;
  g_atm_cfg.sumAbs = 1;
  g_atm_cfg.wireMode = 0;
  g_atm_cfg.phaseMap[0] = 0;
  g_atm_cfg.phaseMap[1] = 1;
  g_atm_cfg.phaseMap[2] = 2;
  g_atm_cfg.ucal   = 36000;  // ucal: reserved calibration reference; sag/OV thresholds currently scale off Ugain
  for (int i = 0; i < 3; i++) {
    g_atm_cfg.cal[i].Ugain   = 39500;  // divider 6×220k+1k, calibrated @ 230V
    g_atm_cfg.cal[i].Igain   = 49000;  // factory: ~1 mA secondary → 1.000 on Irms (PGA=2×, 0…60 mA FS)
    g_atm_cfg.cal[i].Uoffset = 0;
    g_atm_cfg.cal[i].Ioffset = 0;
  }
}

static void publishEnergyFromAcc();

static void clearEnergyCounters() {
  for (int i = 0; i < 4; i++) {
    g_acc_ap_Wh[i] = g_acc_an_Wh[i] = g_acc_rp_varh[i] = 0.0;
    g_acc_rn_varh[i] = g_acc_s_VAh[i] = g_acc_aph_Wh[i] = 0.0;
    g_e_ap_Wh[i] = g_e_an_Wh[i] = g_e_rp_varh[i] = g_e_rn_varh[i] = g_e_s_VAh[i] = 0;
    g_e_aph_Wh[i] = 0;
  }
}

static void drainChipEnergyRegs() {
  (void)g_atm.rdAP_A(); (void)g_atm.rdAP_B(); (void)g_atm.rdAP_C(); (void)g_atm.rdAP_T();
  (void)g_atm.rdAN_A(); (void)g_atm.rdAN_B(); (void)g_atm.rdAN_C(); (void)g_atm.rdAN_T();
  (void)g_atm.rdRP_A(); (void)g_atm.rdRP_B(); (void)g_atm.rdRP_C(); (void)g_atm.rdRP_T();
  (void)g_atm.rdRN_A(); (void)g_atm.rdRN_B(); (void)g_atm.rdRN_C(); (void)g_atm.rdRN_T();
  (void)g_atm.rdSA_A(); (void)g_atm.rdSA_B(); (void)g_atm.rdSA_C(); (void)g_atm.rdSA_T();
  (void)g_atm.rdAPH_A(); (void)g_atm.rdAPH_B(); (void)g_atm.rdAPH_C(); (void)g_atm.rdAPH_T();
}

static void setMeterDefaults() {
  g_atm_cfg.ucal = 36000;
  for (int i = 0; i < 3; i++) {
    g_atm_cfg.cal[i].Ugain   = 39500;
    g_atm_cfg.cal[i].Igain   = 49000;
    g_atm_cfg.cal[i].Uoffset = 0;
    g_atm_cfg.cal[i].Ioffset = 0;
  }
  clearEnergyCounters();
}

// ---- Meter cache + chunked SPI sampling (one step per loop) ----
static double   g_urms[3] = {0, 0, 0};
static double   g_irms[3] = {0, 0, 0};
static int32_t  g_p_W[4]  = {0, 0, 0, 0};
static int32_t  g_pfund_W[4] = {0, 0, 0, 0};
static int32_t  g_pharm_W[4] = {0, 0, 0, 0};
static int32_t  g_q_var[4]= {0, 0, 0, 0};
static int32_t  g_s_VA[4] = {0, 0, 0, 0};
static int16_t  g_pf_raw[4] = {0, 0, 0, 0};
static int16_t  g_ang_raw[3]= {0, 0, 0};
static uint16_t g_f_x100 = 0;
static int16_t  g_tempC = 0;
static double   g_upeak[3] = {0, 0, 0};
static double   g_ipeak[3] = {0, 0, 0};
static double   g_irmsN = 0.0;
static uint16_t g_thd_x100[3] = {0, 0, 0};
static bool     g_haveMeter = false;

static AlarmChCfg  alarmCfg[4];
static AlarmChRun  alarmRun[4];
static M90ChipEv   g_chipEv = {};
static uint8_t     g_chipEvMask[4] = {0, 0, 0, 0};
static uint8_t     g_chipEvMaskLatched[4] = {0, 0, 0, 0};
static uint32_t    g_chipEvLastMs[4] = {0, 0, 0, 0};
static unsigned long lastDiagSample = 0;
static const unsigned long diagSampleMs = 500;
static unsigned long lastWsDiagPrint = 0;
static const unsigned long wsDiagPrintMs = 2000;
static unsigned long lastPeakResetMs = 0;
static const unsigned long peakResetMs = 10000;
static unsigned long lastAlarmEval = 0;
static const unsigned long alarmEvalMs = 200;

static inline double ticksToPrimaryWh(uint64_t ticks);


static uint32_t crc32_update(uint32_t crc, const uint8_t* data, size_t len) {
  crc = ~crc;
  while (len--) {
    crc ^= *data++;
    for (uint8_t k = 0; k < 8; k++)
      crc = (crc >> 1) ^ (0xEDB88320UL & (-(int32_t)(crc & 1)));
  }
  return ~crc;
}

static void markCfgDirty() {
  cfgDirty = true;
  lastCfgTouchMs = millis();
}

static unsigned long lastMeterSaveMs = 0;
static const uint32_t METER_SAVE_MIN_MS = 2000;  // floor between cal/explicit saves

static void markMeterDirty() {
  meterDirty = true;
  // Do not bump lastMeterSaveMs — that was delaying the next flash write by a full
  // METER_SAVE_INTERVAL_MS window after every cal touch.
}

// Unset limits (legacy used raw 0). Real engineering 0 must be storable.
static const int32_t ALARM_LIM_NONE_MIN = (int32_t)0x80000000L;  // INT32_MIN
static const int32_t ALARM_LIM_NONE_MAX = (int32_t)0x7FFFFFFFL;  // INT32_MAX
static inline bool alarmHasMin(const AlarmRuleCfg& cfg) { return cfg.minVal != ALARM_LIM_NONE_MIN; }
static inline bool alarmHasMax(const AlarmRuleCfg& cfg) { return cfg.maxVal != ALARM_LIM_NONE_MAX; }

static void alarmMigrateUnsetLimits(AlarmRuleCfg& cfg) {
  if (cfg.minVal == 0) cfg.minVal = ALARM_LIM_NONE_MIN;
  if (cfg.maxVal == 0) cfg.maxVal = ALARM_LIM_NONE_MAX;
}

static void alarmMigrateAllUnsetLimits() {
  for (uint8_t ch = 0; ch < 4; ch++)
    for (uint8_t k = 0; k < 3; k++)
      alarmMigrateUnsetLimits(alarmCfg[ch].rules[k]);
}

static void setAlarmDefaults() {
  memset(alarmCfg, 0, sizeof(alarmCfg));
  memset(alarmRun, 0, sizeof(alarmRun));
  memset(g_chipEvMask, 0, sizeof(g_chipEvMask));
  memset(&g_chipEv, 0, sizeof(g_chipEv));
  for (uint8_t ch = 0; ch < 4; ch++) {
    for (uint8_t k = 0; k < 3; k++) {
      alarmCfg[ch].rules[k].minVal = ALARM_LIM_NONE_MIN;
      alarmCfg[ch].rules[k].maxVal = ALARM_LIM_NONE_MAX;
    }
  }
}

static double alarmMetricScale(uint8_t metric) {
  switch (metric) {
    case ALARM_MET_URMS: return 100.0;
    case ALARM_MET_IRMS: return 1000.0;
    case ALARM_MET_FREQ: return 100.0;
    default: return 1.0;
  }
}

static double alarmRuleToDouble(int32_t raw, uint8_t metric) {
  return (double)raw / alarmMetricScale(metric);
}

static int32_t alarmDoubleToRule(double v, uint8_t metric) {
  const double scaled = v * alarmMetricScale(metric);
  if (scaled > 2147483647.0) return 2147483647;
  if (scaled < -2147483648.0) return -2147483648;
  return (int32_t)lround(scaled);
}

static double alarmMetricValue(uint8_t ch, uint8_t metric) {
  if (ch < 3) {
    switch (metric) {
      case ALARM_MET_URMS: return g_urms[ch];
      case ALARM_MET_IRMS: return g_irms[ch];
      case ALARM_MET_P:    return (double)g_p_W[ch];
      case ALARM_MET_Q:    return (double)g_q_var[ch];
      case ALARM_MET_S:    return (double)g_s_VA[ch];
      case ALARM_MET_FREQ: return ((double)g_f_x100) / 100.0;
      default: return 0.0;
    }
  }
  switch (metric) {
    case ALARM_MET_URMS:
      return fmax(fmax(g_urms[0], g_urms[1]), g_urms[2]);
    case ALARM_MET_IRMS:
      return g_irms[0] + g_irms[1] + g_irms[2];
    case ALARM_MET_P:    return (double)g_p_W[3];
    case ALARM_MET_Q:    return (double)g_q_var[3];
    case ALARM_MET_S:    return (double)g_s_VA[3];
    case ALARM_MET_FREQ: return ((double)g_f_x100) / 100.0;
    default: return 0.0;
  }
}

static double alarmHystBand(const AlarmRuleCfg& rule) {
  const bool hasMin = alarmHasMin(rule);
  const bool hasMax = alarmHasMax(rule);
  const double mn = hasMin ? alarmRuleToDouble(rule.minVal, rule.metric) : 0.0;
  const double mx = hasMax ? alarmRuleToDouble(rule.maxVal, rule.metric) : 0.0;
  double span = 0.0;
  if (hasMin && hasMax) span = mx - mn;
  else if (hasMin) span = fabs(mn);
  else if (hasMax) span = fabs(mx);
  if (span <= 0.0) span = 1.0;
  double h = span * 0.02;
  if (rule.metric == ALARM_MET_FREQ) h = fmax(h, 0.10);
  if (rule.metric == ALARM_MET_URMS) h = fmax(h, 2.0);
  if (rule.metric == ALARM_MET_IRMS) h = fmax(h, 0.05);
  return h;
}

static void alarmEvalRule(const AlarmRuleCfg& cfg, AlarmRuleRun& run, double value) {
  if (!cfg.enabled) {
    run.active = false;
    run.hiSide = false;
    // Keep latched until Ack when channel uses ackRequired (handled in publish).
    run.prevActive = false;
    return;
  }
  const bool hasMin = alarmHasMin(cfg);
  const bool hasMax = alarmHasMax(cfg);
  const double mn = hasMin ? alarmRuleToDouble(cfg.minVal, cfg.metric) : 0.0;
  const double mx = hasMax ? alarmRuleToDouble(cfg.maxVal, cfg.metric) : 0.0;
  const double h = alarmHystBand(cfg);

  if (!run.active) {
    if (hasMin && value < mn) {
      run.active = true;
      run.hiSide = false;
    } else if (hasMax && value > mx) {
      run.active = true;
      run.hiSide = true;
    }
  } else {
    bool clear = false;
    if (!run.hiSide) {
      clear = !hasMin || value >= (mn + h);
    } else {
      clear = !hasMax || value <= (mx - h);
    }
    if (clear) {
      run.active = false;
      run.hiSide = false;
    }
  }
}

static void alarmUpdateChipMasks() {
  for (int i = 0; i < 4; i++) g_chipEvMask[i] = 0;
  for (int ph = 0; ph < 3; ph++) {
    uint8_t m = 0;
    if (g_chipEv.sag[ph])        m |= CHIP_EV_SAG;
    if (g_chipEv.ov[ph])         m |= CHIP_EV_OV;
    if (g_chipEv.phaseLoss[ph])  m |= CHIP_EV_PHASE_LOSS;
    if (g_chipEv.overI[ph])      m |= CHIP_EV_OVER_I;
    g_chipEvMask[ph] = m;
    g_chipEvMask[3] |= m;
  }
  if (g_chipEv.freqHi || g_chipEv.freqLo) g_chipEvMask[3] |= CHIP_EV_FREQ;
  if (g_chipEv.revPhase) g_chipEvMask[3] |= CHIP_EV_REV_PHASE;
}

static void chipEvPublishModbus() {
  mb.Ireg(IR_CHIP_EV_L1,  g_chipEvMask[0]);
  mb.Ireg(IR_CHIP_EV_L2,  g_chipEvMask[1]);
  mb.Ireg(IR_CHIP_EV_L3,  g_chipEvMask[2]);
  mb.Ireg(IR_CHIP_EV_TOT, g_chipEvMask[3]);
}

static void chipEvLatchFromMask(uint32_t now) {
  for (int ch = 0; ch < 4; ch++) {
    if (g_chipEvMask[ch]) {
      g_chipEvMaskLatched[ch] |= g_chipEvMask[ch];
      g_chipEvLastMs[ch] = now;
    }
    // Keep events visible for a short window even if chip clears state quickly.
    if (g_chipEvMaskLatched[ch] && (uint32_t)(now - g_chipEvLastMs[ch]) > 5000u) {
      g_chipEvMaskLatched[ch] = 0;
    }
  }
  // Use latched masks for publication.
  for (int ch = 0; ch < 4; ch++) g_chipEvMask[ch] = g_chipEvMaskLatched[ch];
}

static JSONVar chipEvMasksToJson() {
  JSONVar a;
  for (int i = 0; i < 4; i++) a[i] = (int)g_chipEvMask[i];
  return a;
}

static void alarmSampleChipDiag(uint32_t now) {
  if (atmBusy || meter_job) return;
  const M90DiagRegs d = g_atm.readDiag();
  decodeM90ChipEv(d, g_chipEv);
  alarmUpdateChipMasks();
  chipEvLatchFromMask(now);
  g_atm.clearDiagInterrupts();
  chipEvPublishModbus();
  for (int ch = 0; ch < 4; ch++)
    alarmRun[ch].chipActive = g_chipEvMask[ch] != 0;
}

static bool alarmRulePublished(uint8_t ch, uint8_t kind) {
  if (ch > 3 || kind > 2) return false;
  // Threshold rules only — chip power-quality bits stay on Chip Events / Modbus IR.
  if (!alarmCfg[ch].ackRequired)
    return alarmRun[ch].rules[kind].active;  // live follow
  const AlarmRuleRun& run = alarmRun[ch].rules[kind];
  if (run.heldOff) return false;
  return run.latched;
}

static bool alarmChannelActive(uint8_t ch, uint8_t mask) {
  if (ch > 3) return false;
  for (uint8_t k = 0; k < 3; k++) {
    if ((mask & (1u << k)) && alarmRulePublished(ch, k)) return true;
  }
  return false;
}

static bool relayAlarmDemand(uint8_t rly) {
  if (rly >= NUM_RLY || rlyCfg[rly].mode != RLY_MODE_ALARM) return false;
  const uint8_t ch = (uint8_t)constrain((int)rlyCfg[rly].alarmCh, 0, 3);
  const uint8_t mask = rlyCfg[rly].alarmMask ? rlyCfg[rly].alarmMask : 1;
  return alarmChannelActive(ch, mask);
}

static void alarmEvalThresholds() {
  if (!g_haveMeter) return;
  for (uint8_t ch = 0; ch < 4; ch++) {
    for (uint8_t kind = 0; kind < 3; kind++) {
      AlarmRuleRun& run = alarmRun[ch].rules[kind];
      const AlarmRuleCfg& cfg = alarmCfg[ch].rules[kind];
      if (!cfg.enabled) {
        run.active = false;
        run.hiSide = false;
        run.prevActive = false;
        run.latched = false;   // disabling the rule always drops latch/DI
        run.heldOff = false;
        continue;
      }
      const double v = alarmMetricValue(ch, cfg.metric);
      alarmEvalRule(cfg, run, v);
      if (alarmCfg[ch].ackRequired) {
        // Rising edge → latch. Ack can clear; re-trip needs a new rising edge.
        if (run.active && !run.prevActive) {
          run.latched = true;
          run.heldOff = false;
        }
        if (!run.active) run.heldOff = false;  // re-arm after condition clears
      } else {
        run.latched = false;
        run.heldOff = false;
      }
      run.prevActive = run.active;
    }
  }
}

static void alarmPublishModbus() {
  uint16_t m = 0;
  for (uint8_t ch = 0; ch < 4; ch++) {
    for (uint8_t kind = 0; kind < 3; kind++) {
      if (alarmRulePublished(ch, kind))
        m |= (uint16_t)(1u << (3u * ch + kind));
    }
  }
  mb.Ireg(IR_ALARM_FLAGS, m);
}

static void mbPublishIoMask(const bool* ledPhys, const bool* btn, const bool* relayLogical) {
  uint16_t m = 0;
  for (int i = 0; i < NUM_LED; i++) {
    if (ledPhys[i]) m |= (uint16_t)(1u << i);
  }
  for (int i = 0; i < NUM_BTN; i++) {
    if (btn[i]) m |= (uint16_t)(1u << (4 + i));
  }
  for (int i = 0; i < NUM_RLY; i++) {
    if (relayLogical[i]) m |= (uint16_t)(1u << (8 + i));
  }
  mb.Ireg(IR_IO_MASK, m);
}

static void alarmAckChannel(uint8_t ch) {
  if (ch > 3) return;
  for (uint8_t kind = 0; kind < 3; kind++) {
    AlarmRuleRun& run = alarmRun[ch].rules[kind];
    run.latched = false;
    run.prevActive = run.active;
    // If still in alarm, keep LED/DI off until value returns to normal, then allow re-trip.
    run.heldOff = run.active;
  }
}

static void alarmAckFromJson(const JSONVar& obj) {
  // Prefer flat { ch: N }. "list" of 0/1 also accepted (Ack All).
  if (jvHasKey(obj, "ch")) {
    const int ch = jvGetInt(obj, "ch", -1);
    if (ch >= 0 && ch < 4) alarmAckChannel((uint8_t)ch);
    else alarmAckAll();
  } else if (jvHasKey(obj, "list")) {
    int32_t flags[4];
    const int n = parseJsonIntArray(jsonBlob(obj), "list", flags, 4);
    if (n >= 4) {
      for (uint8_t ch = 0; ch < 4; ch++)
        if (flags[ch]) alarmAckChannel(ch);
    } else {
      alarmAckAll();
    }
  } else {
    alarmAckAll();
  }
}

static void alarmAckAll() {
  for (uint8_t ch = 0; ch < 4; ch++) alarmAckChannel(ch);
}

static void alarmServiceTick(unsigned long now) {
  if (!atmBusy && !meter_job && (now - lastDiagSample >= diagSampleMs)) {
    lastDiagSample = now;
    alarmSampleChipDiag((uint32_t)now);
  }
  if (now - lastAlarmEval >= alarmEvalMs) {
    lastAlarmEval = now;
    alarmEvalThresholds();
    alarmPublishModbus();
  }
}

static void serviceModbusAck() {
  for (uint8_t ch = 0; ch < 4; ch++) {
    if (mb.Coil(COIL_ACK_BASE + ch)) {
      alarmAckChannel(ch);
      mb.Coil(COIL_ACK_BASE + ch, false);
    }
  }
}

static JSONVar alarmsStateToJson() {
  JSONVar st;
  for (uint8_t ch = 0; ch < 4; ch++) {
    JSONVar kinds;
    for (uint8_t kind = 0; kind < 3; kind++) {
      JSONVar e;
      e["active"] = alarmRulePublished(ch, kind) ? 1 : 0;
      kinds[kind] = e;
    }
    st[ch] = kinds;
  }
  return st;
}

// Flat int arrays — same proven shape as energy counters. Nested alarm objects
// (and packets with numeric keys "0"/"1"/"2") break on Arduino_JSON / WebSerial:
// list becomes an array of rules, apply no-ops, cfg.alarm echoes as null.
static void alarmCfgEmitFlat(JSONVar& cfg) {
  JSONVar ack, en, met, lo, hi;
  for (uint8_t ch = 0; ch < 4; ch++) {
    ack[ch] = alarmCfg[ch].ackRequired ? 1 : 0;
    for (uint8_t kind = 0; kind < 3; kind++) {
      const int i = (int)ch * 3 + (int)kind;
      const AlarmRuleCfg& r = alarmCfg[ch].rules[kind];
      en[i]  = r.enabled ? 1 : 0;
      met[i] = (int)r.metric;
      lo[i]  = (long)r.minVal;
      hi[i]  = (long)r.maxVal;
    }
  }
  cfg["alarmAck"] = ack;
  cfg["alarmEn"]  = en;
  cfg["alarmMet"] = met;
  cfg["alarmLo"]  = lo;
  cfg["alarmHi"]  = hi;
}

// Flat per-channel Config list: { ch, ack, e0,m0,lo0,hi0, e1,... } — no nesting.
static void alarmApplyFlatChannel(uint8_t ch, const JSONVar& list) {
  if (ch > 3) return;
  if (jvHasKey(list, "ack")) {
    const uint8_t newAck = jvGetInt(list, "ack", 0) ? 1 : 0;
    if (!newAck && alarmCfg[ch].ackRequired) {
      for (uint8_t kind = 0; kind < 3; kind++) {
        alarmRun[ch].rules[kind].latched = false;
        alarmRun[ch].rules[kind].prevActive = false;
      }
    }
    alarmCfg[ch].ackRequired = newAck;
  }
  for (uint8_t kind = 0; kind < 3; kind++) {
    char ek[4], mk[4], lk[5], hk[5];
    snprintf(ek, sizeof(ek), "e%u", (unsigned)kind);
    snprintf(mk, sizeof(mk), "m%u", (unsigned)kind);
    snprintf(lk, sizeof(lk), "lo%u", (unsigned)kind);
    snprintf(hk, sizeof(hk), "hi%u", (unsigned)kind);
    AlarmRuleCfg& cfg = alarmCfg[ch].rules[kind];
    if (jvHasKey(list, ek)) cfg.enabled = jvGetInt(list, ek, 0) ? 1 : 0;
    if (jvHasKey(list, mk))
      cfg.metric = (uint8_t)constrain(jvGetInt(list, mk, (int)cfg.metric), 0, 5);
    if (jvHasKey(list, lk)) cfg.minVal = (int32_t)jvGetInt(list, lk, (int)cfg.minVal);
    if (jvHasKey(list, hk)) cfg.maxVal = (int32_t)jvGetInt(list, hk, (int)cfg.maxVal);
  }
}

// Parse JSON array of ints from blob: "[1,0,0,1,...]" → out[i]
static int parseJsonIntArray(const String& blob, const char* key, int32_t* out, int maxn) {
  String pat = String("\"") + key + "\":";
  int pos = blob.indexOf(pat);
  if (pos < 0) return 0;
  pos += pat.length();
  while (pos < (int)blob.length() && (blob[pos] == ' ' || blob[pos] == '\t')) pos++;
  if (pos >= (int)blob.length() || blob[pos] != '[') return 0;
  pos++;
  int n = 0;
  while (n < maxn && pos < (int)blob.length()) {
    while (pos < (int)blob.length() && (blob[pos] == ' ' || blob[pos] == '\t' || blob[pos] == ',')) pos++;
    if (pos >= (int)blob.length() || blob[pos] == ']') break;
    int end = pos;
    if (blob[end] == '-' || blob[end] == '+') end++;
    while (end < (int)blob.length() && blob[end] >= '0' && blob[end] <= '9') end++;
    if (end == pos || (end == pos + 1 && (blob[pos] == '-' || blob[pos] == '+'))) break;
    out[n++] = (int32_t)blob.substring(pos, end).toInt();
    pos = end;
  }
  return n;
}

static void alarmApplyFlatSnapshotFromBlob(const JSONVar& list) {
  const String blob = jsonBlob(list);
  int32_t ack[4], en[12], met[12], lo[12], hi[12];
  const int na = parseJsonIntArray(blob, "alarmAck", ack, 4);
  const int ne = parseJsonIntArray(blob, "alarmEn", en, 12);
  const int nm = parseJsonIntArray(blob, "alarmMet", met, 12);
  const int nl = parseJsonIntArray(blob, "alarmLo", lo, 12);
  const int nh = parseJsonIntArray(blob, "alarmHi", hi, 12);
  if (ne < 12 && nl < 12) return;
  for (uint8_t ch = 0; ch < 4; ch++) {
    if (na == 4) {
      const uint8_t newAck = ack[ch] ? 1 : 0;
      if (!newAck && alarmCfg[ch].ackRequired) {
        for (uint8_t kind = 0; kind < 3; kind++) {
          alarmRun[ch].rules[kind].latched = false;
          alarmRun[ch].rules[kind].prevActive = false;
          alarmRun[ch].rules[kind].heldOff = false;
        }
      }
      alarmCfg[ch].ackRequired = newAck;
    }
    for (uint8_t kind = 0; kind < 3; kind++) {
      const int i = (int)ch * 3 + (int)kind;
      AlarmRuleCfg& cfg = alarmCfg[ch].rules[kind];
      if (ne == 12) {
        const uint8_t newEn = en[i] ? 1 : 0;
        if (!newEn && cfg.enabled) {
          alarmRun[ch].rules[kind].latched = false;
          alarmRun[ch].rules[kind].prevActive = false;
          alarmRun[ch].rules[kind].heldOff = false;
        }
        cfg.enabled = newEn;
      }
      if (nm == 12) cfg.metric = (uint8_t)constrain((int)met[i], 0, 5);
      if (nl == 12) cfg.minVal = lo[i];
      if (nh == 12) cfg.maxVal = hi[i];
    }
  }
}

static void alarmApplyFromJson(const JSONVar& list) {
  // 1) Preferred flat per-channel write from WebConfig.
  if (jvHasKey(list, "e0") || jvHasKey(list, "lo0")) {
    const int ch = jvGetInt(list, "ch", -1);
    if (ch >= 0 && ch < 4) {
      alarmApplyFlatChannel((uint8_t)ch, list);
      return;
    }
  }
  // 2) Full flat snapshot (cfg echo / bootstrap).
  if (jvHasKey(list, "alarmEn") || jvHasKey(list, "alarmLo")) {
    alarmApplyFlatSnapshotFromBlob(list);
    return;
  }
  // Legacy nested paths intentionally omitted: numeric keys "0"/"1"/"2" made
  // Arduino_JSON treat the packet as an array of rules and silently no-op.
  (void)list;
}

static void handleAlarmsCfg(JSONVar obj) {
  markWebHostRx();
  alarmApplyFromJson(obj);
  markCfgDirty();
  sendWebCfg();
  sendWebExt();
  const int ch = jvGetInt(obj, "ch", 0);
  const uint8_t c = (uint8_t)constrain(ch, 0, 3);
  char buf[112];
  snprintf(buf, sizeof(buf), "OK: alarm ch%u e0=%u lo0=%ld hi0=%ld",
           (unsigned)c,
           (unsigned)alarmCfg[c].rules[0].enabled,
           (long)alarmCfg[c].rules[0].minVal,
           (long)alarmCfg[c].rules[0].maxVal);
  wsLog(buf);
}

static void handleAlarmsAck(JSONVar obj) {
  markWebHostRx();
  alarmAckFromJson(obj);
  alarmPublishModbus();
  sendWebExt();
  {
    const int ch = jvGetInt(obj, "ch", -1);
    char buf[64];
    if (ch >= 0 && ch < 4)
      snprintf(buf, sizeof(buf), "OK: ack ch%u (latched cleared)", (unsigned)ch);
    else
      snprintf(buf, sizeof(buf), "OK: ack all (latched cleared)");
    wsLog(buf);
  }
}

static void captureSettings(EnmSettingsCfg& pc) {
  memset(&pc, 0, sizeof(pc));
  pc.magic      = CFG_MAGIC;
  pc.version    = CFG_VERSION;
  pc.size       = sizeof(EnmSettingsCfg);
  pc.mb_address = g_mb_address;
  pc.mb_baud    = g_mb_baud;
  pc.lineHz     = g_atm_cfg.lineHz;
  pc.sumAbs     = g_atm_cfg.sumAbs;
  pc.wireMode   = g_atm_cfg.wireMode;
  for (int i = 0; i < 3; i++) pc.phaseMap[i] = g_atm_cfg.phaseMap[i];
  for (int i = 0; i < NUM_RLY; i++) {
    pc.rlyCfg[i].enabled   = rlyCfg[i].enabled;
    pc.rlyCfg[i].inverted  = rlyCfg[i].inverted;
    pc.rlyCfg[i].mode      = rlyCfg[i].mode;
    pc.rlyCfg[i].alarmCh   = rlyCfg[i].alarmCh;
    pc.rlyCfg[i].alarmMask = rlyCfg[i].alarmMask;
    pc.rlyCfg[i].pad       = 0;
  }
  for (int i = 0; i < NUM_LED; i++) {
    pc.ledCfg[i].mode   = ledCfg[i].mode;
    pc.ledCfg[i].source = ledCfg[i].source;
  }
  for (int i = 0; i < NUM_BTN; i++) {
    pc.btnCfg[i].action = btnCfg[i].action;
  }
  for (int i = 0; i < 4; i++) {
    pc.alarm[i] = alarmCfg[i];
  }
  clampCtPgaSettings();
  pc.ctPrimaryA     = g_ctPrimaryA;
  pc.ctSecondary_mA = g_ctSecondary_mA;
  pc.pgaGain        = g_pgaGain;
  pc.pad_ct         = 0;
  pc.crc32 = 0;
  pc.crc32 = crc32_update(0, reinterpret_cast<const uint8_t*>(&pc), sizeof(EnmSettingsCfg));
}

static bool applySettings(const EnmSettingsCfg& pc) {
  if (pc.magic != CFG_MAGIC || pc.size != sizeof(EnmSettingsCfg))
    return false;
  if (pc.version != CFG_VERSION)
    return false;
  EnmSettingsCfg tmp = pc;
  const uint32_t crc = tmp.crc32;
  tmp.crc32 = 0;
  if (crc32_update(0, reinterpret_cast<const uint8_t*>(&tmp), sizeof(EnmSettingsCfg)) != crc)
    return false;

  g_mb_address = pc.mb_address;
  if (g_mb_address < 1 || g_mb_address > 247) g_mb_address = 3;
  g_mb_baud = pc.mb_baud;
  if (!isAllowedBaud(g_mb_baud)) g_mb_baud = 19200;
  SlaveId = (int)g_mb_address;

  g_atm_cfg.lineHz = (pc.lineHz == 60) ? 60 : 50;
  g_atm_cfg.sumAbs = pc.sumAbs ? 1 : 0;
  g_atm_cfg.wireMode = pc.wireMode ? 1 : 0;
  for (int i = 0; i < 3; i++) g_atm_cfg.phaseMap[i] = pc.phaseMap[i];
  normalizePhaseMap(g_atm_cfg.phaseMap);

  for (int i = 0; i < NUM_RLY; i++) {
    rlyCfg[i].enabled   = pc.rlyCfg[i].enabled;
    rlyCfg[i].inverted  = pc.rlyCfg[i].inverted;
    rlyCfg[i].mode      = pc.rlyCfg[i].mode;
    rlyCfg[i].alarmCh   = (uint8_t)constrain((int)pc.rlyCfg[i].alarmCh, 0, 3);
    rlyCfg[i].alarmMask = pc.rlyCfg[i].alarmMask ? pc.rlyCfg[i].alarmMask : 1;
  }
  for (int i = 0; i < NUM_LED; i++) {
    ledCfg[i].mode   = pc.ledCfg[i].mode;
    ledCfg[i].source = pc.ledCfg[i].source;
  }
  for (int i = 0; i < NUM_BTN; i++) {
    btnCfg[i].action = pc.btnCfg[i].action;
  }
  for (int i = 0; i < 4; i++) {
    alarmCfg[i] = pc.alarm[i];
  }
  g_ctPrimaryA     = pc.ctPrimaryA;
  g_ctSecondary_mA = pc.ctSecondary_mA;
  g_pgaGain        = pc.pgaGain;
  // Uninitialized 0x0025 flash left secondary=0 → clamp to 1 → N=100 and a single
  // 0xFFFF SPI frame became exactly 20.480 kWh on every energy channel.
  if (g_ctPrimaryA < 1 || g_ctSecondary_mA < 1) setCtDefaults();
  else clampCtPgaSettings();
  recomputeCtRatio();
  return true;
}

static bool applySettingsV24(const EnmSettingsCfgV24& pc) {
  if (pc.magic != CFG_MAGIC || pc.size != sizeof(EnmSettingsCfgV24))
    return false;
  if (pc.version != CFG_VERSION_V24 && pc.version != CFG_VERSION_V23 && pc.version != CFG_VERSION_V22)
    return false;
  EnmSettingsCfgV24 tmp = pc;
  const uint32_t crc = tmp.crc32;
  tmp.crc32 = 0;
  if (crc32_update(0, reinterpret_cast<const uint8_t*>(&tmp), sizeof(EnmSettingsCfgV24)) != crc)
    return false;

  g_mb_address = pc.mb_address;
  if (g_mb_address < 1 || g_mb_address > 247) g_mb_address = 3;
  g_mb_baud = pc.mb_baud;
  if (!isAllowedBaud(g_mb_baud)) g_mb_baud = 19200;
  SlaveId = (int)g_mb_address;

  g_atm_cfg.lineHz = (pc.lineHz == 60) ? 60 : 50;
  g_atm_cfg.sumAbs = pc.sumAbs ? 1 : 0;
  g_atm_cfg.wireMode = pc.wireMode ? 1 : 0;
  for (int i = 0; i < 3; i++) g_atm_cfg.phaseMap[i] = pc.phaseMap[i];
  normalizePhaseMap(g_atm_cfg.phaseMap);

  for (int i = 0; i < NUM_RLY; i++) {
    rlyCfg[i].enabled   = pc.rlyCfg[i].enabled;
    rlyCfg[i].inverted  = pc.rlyCfg[i].inverted;
    rlyCfg[i].mode      = pc.rlyCfg[i].mode;
    rlyCfg[i].alarmCh   = (uint8_t)constrain((int)pc.rlyCfg[i].alarmCh, 0, 3);
    rlyCfg[i].alarmMask = pc.rlyCfg[i].alarmMask ? pc.rlyCfg[i].alarmMask : 1;
  }
  for (int i = 0; i < NUM_LED; i++) {
    ledCfg[i].mode   = pc.ledCfg[i].mode;
    ledCfg[i].source = pc.ledCfg[i].source;
  }
  for (int i = 0; i < NUM_BTN; i++) {
    btnCfg[i].action = pc.btnCfg[i].action;
  }
  for (int i = 0; i < 4; i++) {
    alarmCfg[i] = pc.alarm[i];
  }
  setCtDefaults();
  return true;
}

static bool applySettingsV21(const EnmSettingsCfgV21& pc) {
  if (pc.magic != CFG_MAGIC || pc.version != CFG_VERSION_V21 || pc.size != sizeof(EnmSettingsCfgV21))
    return false;
  EnmSettingsCfgV21 tmp = pc;
  const uint32_t crc = tmp.crc32;
  tmp.crc32 = 0;
  if (crc32_update(0, reinterpret_cast<const uint8_t*>(&tmp), sizeof(EnmSettingsCfgV21)) != crc)
    return false;

  g_mb_address = pc.mb_address;
  if (g_mb_address < 1 || g_mb_address > 247) g_mb_address = 3;
  g_mb_baud = pc.mb_baud;
  if (!isAllowedBaud(g_mb_baud)) g_mb_baud = 19200;
  SlaveId = (int)g_mb_address;

  g_atm_cfg.lineHz = (pc.lineHz == 60) ? 60 : 50;
  g_atm_cfg.sumAbs = pc.sumAbs ? 1 : 0;
  g_atm_cfg.wireMode = 0;
  g_atm_cfg.phaseMap[0] = 0;
  g_atm_cfg.phaseMap[1] = 1;
  g_atm_cfg.phaseMap[2] = 2;

  for (int i = 0; i < NUM_RLY; i++) {
    rlyCfg[i].enabled   = pc.rlyCfg[i].enabled;
    rlyCfg[i].inverted  = pc.rlyCfg[i].inverted;
    rlyCfg[i].mode      = pc.rlyCfg[i].mode;
    rlyCfg[i].alarmCh   = (uint8_t)constrain((int)pc.rlyCfg[i].alarmCh, 0, 3);
    rlyCfg[i].alarmMask = pc.rlyCfg[i].alarmMask ? pc.rlyCfg[i].alarmMask : 1;
  }
  for (int i = 0; i < NUM_LED; i++) {
    ledCfg[i].mode   = pc.ledCfg[i].mode;
    ledCfg[i].source = pc.ledCfg[i].source;
  }
  for (int i = 0; i < NUM_BTN; i++) {
    btnCfg[i].action = pc.btnCfg[i].action;
  }
  for (int i = 0; i < 4; i++) {
    alarmCfg[i] = pc.alarm[i];
  }
  setCtDefaults();
  return true;
}

static bool applySettingsV20(const EnmSettingsCfgV20& pc) {
  if (pc.magic != CFG_MAGIC || pc.version != CFG_VERSION_V20 || pc.size != sizeof(EnmSettingsCfgV20))
    return false;
  EnmSettingsCfgV20 tmp = pc;
  const uint32_t crc = tmp.crc32;
  tmp.crc32 = 0;
  if (crc32_update(0, reinterpret_cast<const uint8_t*>(&tmp), sizeof(EnmSettingsCfgV20)) != crc)
    return false;

  g_mb_address = pc.mb_address;
  if (g_mb_address < 1 || g_mb_address > 247) g_mb_address = 3;
  g_mb_baud = pc.mb_baud;
  if (!isAllowedBaud(g_mb_baud)) g_mb_baud = 19200;
  SlaveId = (int)g_mb_address;

  g_atm_cfg.lineHz = (pc.lineHz == 60) ? 60 : 50;
  g_atm_cfg.sumAbs = pc.sumAbs ? 1 : 0;
  g_atm_cfg.wireMode = 0;
  g_atm_cfg.phaseMap[0] = 0;
  g_atm_cfg.phaseMap[1] = 1;
  g_atm_cfg.phaseMap[2] = 2;

  for (int i = 0; i < NUM_RLY; i++) {
    rlyCfg[i].enabled   = pc.rlyCfg[i].enabled;
    rlyCfg[i].inverted  = pc.rlyCfg[i].inverted;
    rlyCfg[i].mode      = RLY_MODE_MODBUS;
    rlyCfg[i].alarmCh   = 3;
    rlyCfg[i].alarmMask = 1;
  }
  for (int i = 0; i < NUM_LED; i++) {
    ledCfg[i].mode   = pc.ledCfg[i].mode;
    ledCfg[i].source = pc.ledCfg[i].source;
  }
  for (int i = 0; i < NUM_BTN; i++) {
    btnCfg[i].action = pc.btnCfg[i].action;
  }
  setAlarmDefaults();
  setCtDefaults();
  return true;
}

static void captureMeter(EnmMeterCfg& pc) {
  memset(&pc, 0, sizeof(pc));
  pc.magic   = METER_MAGIC;
  pc.version = METER_VERSION;
  pc.size    = sizeof(EnmMeterCfg);
  pc.ucal    = g_atm_cfg.ucal;
  for (int i = 0; i < 3; i++) {
    pc.Ugain[i]   = g_atm_cfg.cal[i].Ugain;
    pc.Igain[i]   = g_atm_cfg.cal[i].Igain;
    pc.Uoffset[i] = g_atm_cfg.cal[i].Uoffset;
    pc.Ioffset[i] = g_atm_cfg.cal[i].Ioffset;
  }
  for (int i = 0; i < 4; i++) {
    pc.ap_Wh[i]    = g_acc_ap_Wh[i];
    pc.an_Wh[i]    = g_acc_an_Wh[i];
    pc.rp_varh[i]  = g_acc_rp_varh[i];
    pc.rn_varh[i]  = g_acc_rn_varh[i];
    pc.s_VAh[i]    = g_acc_s_VAh[i];
    pc.aph_Wh[i]   = g_acc_aph_Wh[i];
  }
  pc.crc32 = 0;
  pc.crc32 = crc32_update(0, reinterpret_cast<const uint8_t*>(&pc), sizeof(EnmMeterCfg));
}

static bool applyMeter(const EnmMeterCfg& pc) {
  if (pc.magic != METER_MAGIC || pc.version != METER_VERSION || pc.size != sizeof(EnmMeterCfg))
    return false;
  EnmMeterCfg tmp = pc;
  const uint32_t crc = tmp.crc32;
  tmp.crc32 = 0;
  if (crc32_update(0, reinterpret_cast<const uint8_t*>(&tmp), sizeof(EnmMeterCfg)) != crc)
    return false;

  g_atm_cfg.ucal = pc.ucal ? pc.ucal : 36000;
  for (int i = 0; i < 3; i++) {
    g_atm_cfg.cal[i].Ugain   = pc.Ugain[i];
    g_atm_cfg.cal[i].Igain   = pc.Igain[i];
    g_atm_cfg.cal[i].Uoffset = pc.Uoffset[i];
    g_atm_cfg.cal[i].Ioffset = pc.Ioffset[i];
  }
  for (int i = 0; i < 4; i++) {
    g_acc_ap_Wh[i]   = pc.ap_Wh[i];
    g_acc_an_Wh[i]   = pc.an_Wh[i];
    g_acc_rp_varh[i] = pc.rp_varh[i];
    g_acc_rn_varh[i] = pc.rn_varh[i];
    g_acc_s_VAh[i]   = pc.s_VAh[i];
    g_acc_aph_Wh[i]  = pc.aph_Wh[i];
  }
  publishEnergyFromAcc();
  return true;
}

// Migrate v2 tick blob → primary Wh using current N (settings already applied).
static bool applyMeterV2(const EnmMeterCfgV2& pc) {
  if (pc.magic != METER_MAGIC || pc.version != 0x0002 || pc.size != sizeof(EnmMeterCfgV2))
    return false;
  EnmMeterCfgV2 tmp = pc;
  const uint32_t crc = tmp.crc32;
  tmp.crc32 = 0;
  if (crc32_update(0, reinterpret_cast<const uint8_t*>(&tmp), sizeof(EnmMeterCfgV2)) != crc)
    return false;

  g_atm_cfg.ucal = pc.ucal ? pc.ucal : 36000;
  for (int i = 0; i < 3; i++) {
    g_atm_cfg.cal[i].Ugain   = pc.Ugain[i];
    g_atm_cfg.cal[i].Igain   = pc.Igain[i];
    g_atm_cfg.cal[i].Uoffset = pc.Uoffset[i];
    g_atm_cfg.cal[i].Ioffset = pc.Ioffset[i];
  }
  for (int i = 0; i < 4; i++) {
    g_acc_ap_Wh[i]   = ticksToPrimaryWh(pc.ap_cnt[i]);
    g_acc_an_Wh[i]   = ticksToPrimaryWh(pc.an_cnt[i]);
    g_acc_rp_varh[i] = ticksToPrimaryWh(pc.rp_cnt[i]);
    g_acc_rn_varh[i] = ticksToPrimaryWh(pc.rn_cnt[i]);
    g_acc_s_VAh[i]   = ticksToPrimaryWh(pc.s_cnt[i]);
    g_acc_aph_Wh[i]  = ticksToPrimaryWh(pc.aph_cnt[i]);
  }
  publishEnergyFromAcc();
  return true;
}

static bool applyMeterV1(const EnmMeterCfgV1& pc) {
  if (pc.magic != METER_MAGIC || pc.version != 0x0001 || pc.size != sizeof(EnmMeterCfgV1))
    return false;
  EnmMeterCfgV1 tmp = pc;
  const uint32_t crc = tmp.crc32;
  tmp.crc32 = 0;
  if (crc32_update(0, reinterpret_cast<const uint8_t*>(&tmp), sizeof(EnmMeterCfgV1)) != crc)
    return false;

  g_atm_cfg.ucal = pc.ucal ? pc.ucal : 36000;
  for (int i = 0; i < 3; i++) {
    g_atm_cfg.cal[i].Ugain   = pc.Ugain[i];
    g_atm_cfg.cal[i].Igain   = pc.Igain[i];
    g_atm_cfg.cal[i].Uoffset = pc.Uoffset[i];
    g_atm_cfg.cal[i].Ioffset = pc.Ioffset[i];
  }
  for (int i = 0; i < 4; i++) {
    g_acc_ap_Wh[i]   = ticksToPrimaryWh(pc.ap_cnt[i]);
    g_acc_an_Wh[i]   = ticksToPrimaryWh(pc.an_cnt[i]);
    g_acc_rp_varh[i] = ticksToPrimaryWh(pc.rp_cnt[i]);
    g_acc_rn_varh[i] = ticksToPrimaryWh(pc.rn_cnt[i]);
    g_acc_s_VAh[i]   = ticksToPrimaryWh(pc.s_cnt[i]);
    g_acc_aph_Wh[i]  = 0.0;
  }
  publishEnergyFromAcc();
  return true;
}

static bool applyLegacyPersist(const EnmPersistCfgLegacy& pc) {
  if (pc.magic != CFG_MAGIC || pc.version != LEGACY_CFG_VER || pc.size != sizeof(EnmPersistCfgLegacy))
    return false;
  EnmPersistCfgLegacy tmp = pc;
  const uint32_t crc = tmp.crc32;
  tmp.crc32 = 0;
  if (crc32_update(0, reinterpret_cast<const uint8_t*>(&tmp), sizeof(EnmPersistCfgLegacy)) != crc)
    return false;

  g_mb_address = pc.mb_address;
  if (g_mb_address < 1 || g_mb_address > 247) g_mb_address = 3;
  g_mb_baud = pc.mb_baud;
  if (!isAllowedBaud(g_mb_baud)) g_mb_baud = 19200;
  SlaveId = (int)g_mb_address;
  g_atm_cfg.lineHz = (pc.lineHz == 60) ? 60 : 50;
  g_atm_cfg.sumAbs = pc.sumAbs ? 1 : 0;
  g_atm_cfg.wireMode = 0;
  g_atm_cfg.phaseMap[0] = 0;
  g_atm_cfg.phaseMap[1] = 1;
  g_atm_cfg.phaseMap[2] = 2;
  g_atm_cfg.ucal   = pc.ucal ? pc.ucal : 36000;
  for (int i = 0; i < 3; i++) {
    g_atm_cfg.cal[i].Ugain   = pc.Ugain[i];
    g_atm_cfg.cal[i].Igain   = pc.Igain[i];
    g_atm_cfg.cal[i].Uoffset = pc.Uoffset[i];
    g_atm_cfg.cal[i].Ioffset = pc.Ioffset[i];
  }
  setCtDefaults();  // N before tick→Wh migration
  for (int i = 0; i < 4; i++) {
    g_acc_ap_Wh[i]   = ticksToPrimaryWh(pc.ap_cnt[i]);
    g_acc_an_Wh[i]   = ticksToPrimaryWh(pc.an_cnt[i]);
    g_acc_rp_varh[i] = ticksToPrimaryWh(pc.rp_cnt[i]);
    g_acc_rn_varh[i] = ticksToPrimaryWh(pc.rn_cnt[i]);
    g_acc_s_VAh[i]   = ticksToPrimaryWh(pc.s_cnt[i]);
    g_acc_aph_Wh[i]  = 0.0;
  }
  publishEnergyFromAcc();
  for (int i = 0; i < NUM_RLY; i++) {
    rlyCfg[i].enabled   = true;
    rlyCfg[i].inverted  = false;
    rlyCfg[i].mode      = RLY_MODE_MODBUS;
    rlyCfg[i].alarmCh   = 3;
    rlyCfg[i].alarmMask = 1;
  }
  setAlarmDefaults();
  return true;
}

static bool saveSettingsFS() {
  EnmSettingsCfg pc;
  captureSettings(pc);
  File f = LittleFS.open(CFG_PATH, "w");
  if (!f) return false;
  const size_t n = f.write(reinterpret_cast<const uint8_t*>(&pc), sizeof(pc));
  f.close();
  return n == sizeof(pc);
}

static bool saveMeterFS() {
  EnmMeterCfg pc;
  captureMeter(pc);
  File f = LittleFS.open(METER_PATH, "w");
  if (!f) return false;
  const size_t n = f.write(reinterpret_cast<const uint8_t*>(&pc), sizeof(pc));
  f.close();
  return n == sizeof(pc);
}

static bool saveConfigFS() {
  return saveSettingsFS() && saveMeterFS();
}

static bool loadSettingsFS() {
  File f = LittleFS.open(CFG_PATH, "r");
  if (!f) return false;
  const size_t sz = f.size();
  if (sz == sizeof(EnmSettingsCfg)) {
    EnmSettingsCfg pc;
    const size_t n = f.read(reinterpret_cast<uint8_t*>(&pc), sizeof(pc));
    f.close();
    if (n != sizeof(pc)) return false;
    return applySettings(pc);
  }
  if (sz == sizeof(EnmSettingsCfgV24)) {
    EnmSettingsCfgV24 pc;
    const size_t n = f.read(reinterpret_cast<uint8_t*>(&pc), sizeof(pc));
    f.close();
    if (n != sizeof(pc)) return false;
    if (!applySettingsV24(pc)) return false;
    if (pc.version == CFG_VERSION_V22 || pc.version == CFG_VERSION_V23)
      alarmMigrateAllUnsetLimits();
    markCfgDirty();  // rewrite as 0x0025 with CT/PGA defaults
    return true;
  }
  if (sz == sizeof(EnmSettingsCfgV21)) {
    EnmSettingsCfgV21 pc;
    const size_t n = f.read(reinterpret_cast<uint8_t*>(&pc), sizeof(pc));
    f.close();
    if (n != sizeof(pc)) return false;
    if (!applySettingsV21(pc)) return false;
    alarmMigrateAllUnsetLimits();
    markCfgDirty();
    return true;
  }
  if (sz == sizeof(EnmSettingsCfgV20)) {
    EnmSettingsCfgV20 pc;
    const size_t n = f.read(reinterpret_cast<uint8_t*>(&pc), sizeof(pc));
    f.close();
    if (n != sizeof(pc)) return false;
    if (!applySettingsV20(pc)) return false;
    markCfgDirty();
    return true;
  }
  f.close();
  return false;
}

static bool loadMeterFS() {
  File f = LittleFS.open(METER_PATH, "r");
  if (!f) return false;
  const size_t sz = f.size();
  if (sz == sizeof(EnmMeterCfg)) {
    EnmMeterCfg pc;
    const size_t n = f.read(reinterpret_cast<uint8_t*>(&pc), sizeof(pc));
    f.close();
    if (n != sizeof(pc)) return false;
    return applyMeter(pc);
  }
  if (sz == sizeof(EnmMeterCfgV2)) {
    EnmMeterCfgV2 pc;
    const size_t n = f.read(reinterpret_cast<uint8_t*>(&pc), sizeof(pc));
    f.close();
    if (n != sizeof(pc)) return false;
    if (!applyMeterV2(pc)) return false;
    markMeterDirty();  // rewrite as v3 primary-Wh blob
    return true;
  }
  if (sz == sizeof(EnmMeterCfgV1)) {
    EnmMeterCfgV1 pc;
    const size_t n = f.read(reinterpret_cast<uint8_t*>(&pc), sizeof(pc));
    f.close();
    if (n != sizeof(pc)) return false;
    if (!applyMeterV1(pc)) return false;
    markMeterDirty();
    return true;
  }
  f.close();
  return false;
}

static bool tryMigrateLegacyCfg() {
  File f = LittleFS.open(CFG_PATH, "r");
  if (!f) return false;
  if (f.size() != sizeof(EnmPersistCfgLegacy)) {
    f.close();
    return false;
  }
  EnmPersistCfgLegacy pc;
  const size_t n = f.read(reinterpret_cast<uint8_t*>(&pc), sizeof(pc));
  f.close();
  if (n != sizeof(pc) || !applyLegacyPersist(pc)) return false;
  saveSettingsFS();
  saveMeterFS();
  return true;
}

static bool loadConfigFS() {
  const bool settingsOk = loadSettingsFS();
  const bool meterOk = loadMeterFS();
  if (settingsOk && meterOk) return true;
  if (!settingsOk && !meterOk && tryMigrateLegacyCfg()) return true;

  // Recover independently: a bad enm_cfg.bin must not wipe a good enm_meter.bin.
  if (!settingsOk) {
    setSettingsDefaults();
    markCfgDirty();
  }
  if (!meterOk) {
    setMeterDefaults();
    markMeterDirty();
  }
  return true;
}

static uint8_t  meter_step = 0;
static double   urms_tmp[3], irms_tmp[3];

static unsigned long lastMeterSample = 0;
static const unsigned long meterSampleMs = 1000;
static unsigned long lastEnergySample = 0;
// ATM90E32 energy regs are 16-bit read-to-clear; Total overflows ~204.8 Wh
// (~21 s at full scale). Keep poll ≤10 s so ticks are not lost under load.
static const unsigned long energySampleMs = 5000;

// One-shot migration helper: secondary 0.01CF ticks → primary Wh at current N.
static inline double ticksToPrimaryWh(uint64_t ticks) {
  if (g_MC_imp_per_kWh == 0) return 0.0;
  return (double)ticks * (10.0 / (double)g_MC_imp_per_kWh) * g_ctRatioN;
}

static inline uint32_t accToPubWh(double wh) {
  if (wh < 0.0) wh = 0.0;
  if (wh > 4294967295.0) wh = 4294967295.0;
  return (uint32_t)llround(wh);
}

static void publishEnergyFromAcc() {
  for (int i = 0; i < 4; i++) {
    g_e_ap_Wh[i]   = accToPubWh(g_acc_ap_Wh[i]);
    g_e_an_Wh[i]   = accToPubWh(g_acc_an_Wh[i]);
    g_e_rp_varh[i] = accToPubWh(g_acc_rp_varh[i]);
    g_e_rn_varh[i] = accToPubWh(g_acc_rn_varh[i]);
    g_e_s_VAh[i]   = accToPubWh(g_acc_s_VAh[i]);
    g_e_aph_Wh[i]  = accToPubWh(g_acc_aph_Wh[i]);
  }
}

static void recomputeCtRatio() {
  clampCtPgaSettings();
  g_ctRatioN = (double)g_ctPrimaryA / (double)g_ctSecondary_mA;
}

static inline int32_t scalePowerByCt(int32_t v) {
  return (int32_t)lround((double)v * g_ctRatioN);
}

static inline int32_t mbCurrent_mA(double a) {
  // Primary amperes → S32 ×0.001 A (no U16 saturation).
  return (int32_t)lround(a * 1000.0);
}

static void mbPublishMeter() {
  if (!g_haveMeter) return;

  auto clampU = [](double v) -> uint16_t {
    long x = lround(v * 100.0);
    return (uint16_t)constrain(x, 0L, 65535L);
  };

  mb.Ireg(IR_URMS_BASE + 0, clampU(g_urms[0]));
  mb.Ireg(IR_URMS_BASE + 1, clampU(g_urms[1]));
  mb.Ireg(IR_URMS_BASE + 2, clampU(g_urms[2]));
  mb.Ireg(IR_FREQ, g_f_x100);
  mb.Ireg(IR_TEMP, (uint16_t)g_tempC);

  for (int i = 0; i < 4; i++) {
    mb.Ireg(IR_PF_BASE + i, (uint16_t)g_pf_raw[i]);
    mbPutS32Ir(IR_P_BASE + i * 2, g_p_W[i]);
    mbPutS32Ir(IR_Q_BASE + i * 2, g_q_var[i]);
    mbPutS32Ir(IR_S_BASE + i * 2, g_s_VA[i]);
  }
  for (int i = 0; i < 3; i++) {
    mb.Ireg(IR_ANG_BASE + i, (uint16_t)g_ang_raw[i]);
    mb.Ireg(IR_THD_BASE + i, g_thd_x100[i]);
    mbPutS32Ir(IR_IRMS_BASE + i * 2, mbCurrent_mA(g_irms[i]));
  }
  mbPutS32Ir(IR_IRMSN, mbCurrent_mA(g_irmsN));

  for (int i = 0; i < 4; i++) mbPutU32Ir(IR_E_AP_BASE + i * 2, g_e_ap_Wh[i]);
  for (int i = 0; i < 4; i++) mbPutU32Ir(IR_E_AN_BASE + i * 2, g_e_an_Wh[i]);
  for (int i = 0; i < 4; i++) mbPutU32Ir(IR_E_RP_BASE + i * 2, g_e_rp_varh[i]);
  for (int i = 0; i < 4; i++) mbPutU32Ir(IR_E_RN_BASE + i * 2, g_e_rn_varh[i]);
}

static void meter_job_begin() {
  meter_job = true;
  meter_step = 0;
}

static void meter_job_step() {
  if (!meter_job || atmBusy) return;

  switch (meter_step) {
    case 0:
      urms_tmp[0] = g_atm.readUrmsA_V();
      urms_tmp[1] = g_atm.readUrmsB_V();
      meter_step++;
      break;
    case 1:
      urms_tmp[2] = g_atm.readUrmsC_V();
      irms_tmp[0] = g_atm.readIrmsA_A();
      meter_step++;
      break;
    case 2:
      irms_tmp[1] = g_atm.readIrmsB_A();
      irms_tmp[2] = g_atm.readIrmsC_A();
      for (int i = 0; i < 3; i++) {
        g_urms[i] = urms_tmp[i];
        // Chip Irms reads secondary mA as "A"; ×N → primary amperes.
        g_irms[i] = irms_tmp[i] * g_ctRatioN;
      }
      g_haveMeter = true;
      meter_step++;
      break;
    case 3:
      g_pf_raw[0] = g_atm.readPFmeanA();
      g_pf_raw[1] = g_atm.readPFmeanB();
      meter_step++;
      break;
    case 4:
      g_pf_raw[2] = g_atm.readPFmeanC();
      g_pf_raw[3] = g_atm.readPFmeanT();
      g_ang_raw[0] = g_atm.readPAngleA();
      g_ang_raw[1] = g_atm.readPAngleB();
      meter_step++;
      break;
    case 5: {
      g_ang_raw[2] = g_atm.readPAngleC();
      g_f_x100 = g_atm.readFreq_x100();
      g_tempC  = g_atm.readTempC();

      for (int i = 0; i < 4; i++) {
        g_p_W[i]     = scalePowerByCt(g_atm.readPmeanW((uint8_t)i));
        g_q_var[i]   = scalePowerByCt(g_atm.readQmean_var((uint8_t)i));
        g_s_VA[i]    = scalePowerByCt(g_atm.readSmean_VA((uint8_t)i));
        g_pfund_W[i] = scalePowerByCt(g_atm.readPmeanFundW((uint8_t)i));
        g_pharm_W[i] = scalePowerByCt(g_atm.readPmeanHarmW((uint8_t)i));
      }
      meter_step++;
      break;
    }
    case 6:
      for (int i = 0; i < 3; i++) {
        g_upeak[i] = g_atm.readUPeak_V(i);
        g_ipeak[i] = g_atm.readIPeak_A(i) * g_ctRatioN;
      }
      g_irmsN = g_atm.readIrmsN_A() * g_ctRatioN;
      meter_step++;
      break;
    case 7:
      for (int i = 0; i < 3; i++)
        g_thd_x100[i] = g_atm.readThdPct_x100((uint8_t)i);
      meter_job = false;
      g_haveMeter = true;
      mbPublishMeter();
      break;
    default:
      meter_job = false;
      break;
  }
}

static uint32_t meterEnergyCrc() {
  uint32_t c = 0;
  c = crc32_update(c, reinterpret_cast<const uint8_t*>(g_acc_ap_Wh),   sizeof(g_acc_ap_Wh));
  c = crc32_update(c, reinterpret_cast<const uint8_t*>(g_acc_an_Wh),   sizeof(g_acc_an_Wh));
  c = crc32_update(c, reinterpret_cast<const uint8_t*>(g_acc_rp_varh), sizeof(g_acc_rp_varh));
  c = crc32_update(c, reinterpret_cast<const uint8_t*>(g_acc_rn_varh), sizeof(g_acc_rn_varh));
  c = crc32_update(c, reinterpret_cast<const uint8_t*>(g_acc_s_VAh),   sizeof(g_acc_s_VAh));
  c = crc32_update(c, reinterpret_cast<const uint8_t*>(g_acc_aph_Wh),  sizeof(g_acc_aph_Wh));
  return c;
}

static void sampleEnergyCounters() {
  // Poll only — do not mark LittleFS dirty here (flash wear + Modbus FIFO overruns).
  uint16_t ap[4], an[4], rp[4], rn[4], sa[4], aph[4];
  ap[0] = g_atm.rdAP_A(); ap[1] = g_atm.rdAP_B();
  ap[2] = g_atm.rdAP_C(); ap[3] = g_atm.rdAP_T();
  an[0] = g_atm.rdAN_A(); an[1] = g_atm.rdAN_B();
  an[2] = g_atm.rdAN_C(); an[3] = g_atm.rdAN_T();
  rp[0] = g_atm.rdRP_A(); rp[1] = g_atm.rdRP_B();
  rp[2] = g_atm.rdRP_C(); rp[3] = g_atm.rdRP_T();
  rn[0] = g_atm.rdRN_A(); rn[1] = g_atm.rdRN_B();
  rn[2] = g_atm.rdRN_C(); rn[3] = g_atm.rdRN_T();
  sa[0] = g_atm.rdSA_A(); sa[1] = g_atm.rdSA_B();
  sa[2] = g_atm.rdSA_C(); sa[3] = g_atm.rdSA_T();
  aph[0] = g_atm.rdAPH_A(); aph[1] = g_atm.rdAPH_B();
  aph[2] = g_atm.rdAPH_C(); aph[3] = g_atm.rdAPH_T();

  // SPI-fail signature: every energy reg reads 0xFFFF — discard (do not poison Wh).
  bool allFFFF = true;
  for (int i = 0; i < 4; i++) {
    if (ap[i] != 0xFFFF || an[i] != 0xFFFF || rp[i] != 0xFFFF
        || rn[i] != 0xFFFF || sa[i] != 0xFFFF || aph[i] != 0xFFFF) {
      allFFFF = false;
      break;
    }
  }
  if (allFFFF) {
    static uint32_t lastWarnMs = 0;
    const uint32_t nowMs = millis();
    if (nowMs - lastWarnMs > 10000) {
      lastWarnMs = nowMs;
      wsLog("WARN: energy SPI all 0xFFFF — sample discarded");
    }
    return;
  }

  if (g_MC_imp_per_kWh == 0) return;
  const double k = 10.0 / (double)g_MC_imp_per_kWh;  // Wh per 0.01CF tick (secondary)
  const double kN = k * g_ctRatioN;                   // → primary Wh per tick

  // Frame-level all-0xFFFF already discarded above. Accept every per-reg delta
  // (including 0xFFFF) so a saturated counter is not silently dropped.
  auto addDelta = [kN](double& acc, uint16_t v) {
    acc += (double)v * kN;
  };
  for (int i = 0; i < 4; i++) {
    addDelta(g_acc_ap_Wh[i], ap[i]);
    addDelta(g_acc_an_Wh[i], an[i]);
    addDelta(g_acc_rp_varh[i], rp[i]);
    addDelta(g_acc_rn_varh[i], rn[i]);
    addDelta(g_acc_s_VAh[i], sa[i]);
    addDelta(g_acc_aph_Wh[i], aph[i]);
  }
  publishEnergyFromAcc();
}

// Periodic LittleFS meter flush.
// - Explicit meterDirty (cal / CT blob rewrite): after METER_SAVE_MIN_MS from last save.
// - Energy CRC change alone: after METER_SAVE_INTERVAL_MS from last save (wear limit).
static void serviceMeterAutosave(unsigned long now) {
  const uint32_t crc = meterEnergyCrc();
  const bool energyChanged = (crc != meterSavedEnergyCrc);
  if (!meterDirty && !energyChanged) return;
  const uint32_t gap = meterDirty ? METER_SAVE_MIN_MS : METER_SAVE_INTERVAL_MS;
  if (now - lastMeterSaveMs < gap) return;
  if (saveMeterFS()) {
    lastMeterSaveMs = now;
    lastMeterTouchMs = now;
    meterDirty = false;
    meterSavedEnergyCrc = meterEnergyCrc();
  }
}

// Flat numeric arrays — same shape as P_W (proven over WebSerial). Nested E_phase
// objects with doubles (and even ints) serialize as null with Arduino_JSON.
// Use double (not int) so uint32 Wh above INT_MAX stays positive in the browser.
static void energiesToFlatJson(JSONVar& o) {
  JSONVar ap, an, rp, rn, s, aph;
  for (int i = 0; i < 4; i++) {
    ap[i] = (double)g_e_ap_Wh[i];
    an[i] = (double)g_e_an_Wh[i];
    rp[i] = (double)g_e_rp_varh[i];
    rn[i] = (double)g_e_rn_varh[i];
    s[i]  = (double)g_e_s_VAh[i];
    aph[i] = (double)g_e_aph_Wh[i];
  }
  o["E_ap_Wh"] = ap;
  o["E_an_Wh"] = an;
  o["E_rp_varh"] = rp;
  o["E_rn_varh"] = rn;
  o["E_s_VAh"] = s;
  o["E_aph_Wh"] = aph;
}

static void setDefaults() {
  for (int i = 0; i < NUM_RLY; i++) {
    rlyCfg[i].enabled   = true;
    rlyCfg[i].inverted  = false;
    rlyCfg[i].mode      = RLY_MODE_MODBUS;
    rlyCfg[i].alarmCh   = 3;
    rlyCfg[i].alarmMask = 1;
  }
  for (int i = 0; i < NUM_LED; i++) ledCfg[i] = { 0, 0 };
  for (int i = 0; i < NUM_BTN; i++) btnCfg[i] = { 0 };
  for (int i = 0; i < NUM_RLY; i++) desiredRelay[i] = false;
  setAlarmDefaults();
  g_mb_address = 3;
  g_mb_baud    = 19200;
  SlaveId      = (int)g_mb_address;
  setAtmDefaults();
  setMeterDefaults();
  setCtDefaults();
}

// Settings-only defaults: never clear energy/cal (those live in enm_meter.bin).
static void setSettingsDefaults() {
  for (int i = 0; i < NUM_RLY; i++) {
    rlyCfg[i].enabled   = true;
    rlyCfg[i].inverted  = false;
    rlyCfg[i].mode      = RLY_MODE_MODBUS;
    rlyCfg[i].alarmCh   = 3;
    rlyCfg[i].alarmMask = 1;
  }
  for (int i = 0; i < NUM_LED; i++) ledCfg[i] = { 0, 0 };
  for (int i = 0; i < NUM_BTN; i++) btnCfg[i] = { 0 };
  for (int i = 0; i < NUM_RLY; i++) desiredRelay[i] = false;
  setAlarmDefaults();
  g_mb_address = 3;
  g_mb_baud    = 19200;
  SlaveId      = (int)g_mb_address;
  g_atm_cfg.lineHz = 50;
  g_atm_cfg.sumAbs = 1;
  g_atm_cfg.wireMode = 0;
  g_atm_cfg.phaseMap[0] = 0;
  g_atm_cfg.phaseMap[1] = 1;
  g_atm_cfg.phaseMap[2] = 2;
  setCtDefaults();
}

static void atmApplyFromCfg_NOW() {
  // Preserve good unread ticks (sampleEnergyCounters discards all-0xFFFF poison),
  // then SoftReset; throw away post-reset residue without adding it.
  sampleEnergyCounters();
  M90PhaseCal tmp[3];
  for (int i = 0; i < 3; i++) tmp[i] = g_atm_cfg.cal[i];
  clampCtPgaSettings();
  g_atm.begin(g_atm_cfg.lineHz, g_atm_cfg.sumAbs, g_atm_cfg.wireMode, g_atm_cfg.phaseMap,
              g_atm_cfg.ucal, g_pgaGain, tmp);
  drainChipEnergyRegs();
}

static void atmApplyCalOnly_NOW() {
  M90PhaseCal tmp[3];
  for (int i = 0; i < 3; i++) tmp[i] = g_atm_cfg.cal[i];
  g_atm.applyCalibration(tmp);
}

static void queueAtmFullApply() {
  atmApplyPending = true;
  atmCalOnlyPending = false;
}

static void queueAtmCalOnlyApply() {
  if (atmApplyPending) return;  // full apply supersedes
  atmCalOnlyPending = true;
}

static void queueAtmApply() {
  queueAtmFullApply();
}

static void applyHoldingFromModbus() {
  bool changed = false;

  const uint16_t addr = mb.Hreg(HR_MB_ADDR);
  if (addr >= 1 && addr <= 247 && addr != g_mb_address) {
    g_mb_address = (uint8_t)addr;
    changed = true;
  }

  const uint32_t baud = ((uint32_t)mb.Hreg(HR_MB_BAUD_L) << 16) | (uint32_t)mb.Hreg(HR_MB_BAUD_L + 1);
  const uint32_t vBaud = hmValidBaud(baud);
  // Do not assign g_mb_baud here — applyModbusSettings compares baud against the
  // live g_mb_baud to decide whether to re-open Serial2. Premature mutation made
  // the re-init guard false and left UART on the old speed.
  if (vBaud != g_mb_baud) changed = true;

  static uint8_t  lastAddr = 0;
  static uint32_t lastBaud = 0;
  if (g_mb_address != lastAddr || vBaud != lastBaud) {
    applyModbusSettings(g_mb_address, vBaud);
    lastAddr = g_mb_address;
    lastBaud = g_mb_baud;
  }

  const uint16_t hz = mb.Hreg(HR_LINE_HZ);
  if (hz == 50 || hz == 60) {
    const uint16_t newHz = (uint16_t)hz;
    if (g_atm_cfg.lineHz != newHz) {
      g_atm_cfg.lineHz = newHz;
      changed = true;
      queueAtmApply();
    }
  }

  const uint8_t sumAbs = mb.Hreg(HR_SUM_ABS) ? 1 : 0;
  if (g_atm_cfg.sumAbs != sumAbs) {
    g_atm_cfg.sumAbs = sumAbs;
    changed = true;
    queueAtmApply();
  }

  for (int i = 0; i < NUM_RLY; i++) {
    const bool en = mb.Hreg(HR_RLY_EN_BASE + i) != 0;
    if (rlyCfg[i].enabled != en) {
      rlyCfg[i].enabled = en;
      changed = true;
    }
  }

  if (changed) {
    markCfgDirty();
    mbSyncHolding();
  }
}

static JSONVar calPhasesArrayFromCfg() {
  JSONVar cal;
  static const char* phName[] = { "A", "B", "C" };
  for (int i = 0; i < 3; i++) {
    JSONVar p;
    p["Ugain"]   = (int)g_atm_cfg.cal[i].Ugain;
    p["Igain"]   = (int)g_atm_cfg.cal[i].Igain;
    p["Uoffset"] = (int)g_atm_cfg.cal[i].Uoffset;
    p["Ioffset"] = (int)g_atm_cfg.cal[i].Ioffset;
    cal[(int)i] = p;
    cal[phName[i]] = p;
  }
  return cal;
}

// Web-only: numeric indices 0..2 (no duplicate A/B/C keys) for smaller JSON frames.
static JSONVar calPhasesArraySlim() {
  JSONVar cal;
  for (int i = 0; i < 3; i++) {
    JSONVar p;
    p["Ugain"]   = (int)g_atm_cfg.cal[i].Ugain;
    p["Igain"]   = (int)g_atm_cfg.cal[i].Igain;
    p["Uoffset"] = (int)g_atm_cfg.cal[i].Uoffset;
    p["Ioffset"] = (int)g_atm_cfg.cal[i].Ioffset;
    cal[(int)i] = p;
  }
  return cal;
}

static void sendWebCalib() {
  const JSONVar slim = calPhasesArraySlim();
  JSONVar root;
  root["cal"] = slim;
  WebSerial.send("CalibCfg", root);
  yield();
  WebSerial.send("cal", slim);
  yield();
}

static JSONVar energyToJsonObj() {
  JSONVar o;
  energiesToFlatJson(o);
  o["MC_imp_per_kWh"] = (int)g_MC_imp_per_kWh;
  return o;
}

// v0.1.0 ENM_Sync carried modbus identity, atm options, cal and energies together.
static JSONVar enmSyncToJson() {
  JSONVar o = energyToJsonObj();
  o["address"] = (int)g_mb_address;
  o["baud"]    = (int)g_mb_baud;
  o["fw"]      = HM_FW;
  o["lineHz"]  = (int)g_atm_cfg.lineHz;
  o["sumAbs"]  = (int)g_atm_cfg.sumAbs;
  o["ucal"]    = (int)g_atm_cfg.ucal;
  o["ctPrimary"] = (int)g_ctPrimaryA;
  o["ctSecondary"] = (int)g_ctSecondary_mA;
  o["pga"] = (int)g_pgaGain;
  o["ctRatioN"] = g_ctRatioN;
  o["cal"]     = calPhasesArraySlim();
  return o;
}

static JSONVar meterLiveToJson() {
  JSONVar m;
  for (int i = 0; i < 3; i++) {
    m["Urms"][i] = g_urms[i];
    m["Irms"][i] = g_irms[i];
  }

  JSONVar pW, qVar, sVA, pfR, ang;
  for (int i = 0; i < 4; i++) {
    pW[i] = g_p_W[i];
    qVar[i] = g_q_var[i];
    sVA[i] = g_s_VA[i];
    pfR[i] = ((double)g_pf_raw[i]) / 1000.0;
  }
  for (int i = 0; i < 3; i++) ang[i] = ((double)g_ang_raw[i]) / 10.0;

  m["P_W"] = pW;
  m["Q_var"] = qVar;
  m["S_VA"] = sVA;
  m["PF"] = pfR;
  m["Angle_deg"] = ang;
  m["FreqHz"] = ((double)g_f_x100) / 100.0;
  m["TempC"] = (int)g_tempC;
  m["MC_imp_per_kWh"] = (int)g_MC_imp_per_kWh;

  JSONVar uPk, iPk, thd;
  for (int i = 0; i < 3; i++) {
    uPk[i] = g_upeak[i];
    iPk[i] = g_ipeak[i];
    thd[i] = ((double)g_thd_x100[i]) / 100.0;
  }
  m["Upeak_V"] = uPk;
  m["Ipeak"] = iPk;
  m["Ipeak_A"] = iPk;
  m["THD_pct"] = thd;
  m["IrmsN_A"] = g_irmsN;

  JSONVar pfund, pharm;
  for (int i = 0; i < 4; i++) {
    pfund[i] = g_pfund_W[i];
    pharm[i] = g_pharm_W[i];
  }
  m["Pfund"] = pfund;
  m["Pharm"] = pharm;
  m["PfundT"] = g_pfund_W[3];
  m["PharmT"] = g_pharm_W[3];

  // Flat E_*_Wh numeric arrays (Arduino_JSON-safe doubles). See energiesToFlatJson.
  energiesToFlatJson(m);
  return m;
}

// ================== WebConfig (unified) ==================
static void atmUpdateBaseFromJson(const JSONVar& obj);
static void atmUpdatePhaseFromJson(int phase, const JSONVar& obj);
static void atmApplyFromJson(const JSONVar& obj);
static void queueAtmFullApply();
static void queueAtmCalOnlyApply();
static bool atmJsonNeedsFullApply(const JSONVar& obj);

void applyModbusSettings(uint8_t addr, uint32_t baud) {
  addr = hmValidAddress(addr);
  baud = hmValidBaud(baud);

  const bool wasReady = g_mbSerialReady;
  const uint8_t prevAddr = g_mb_address;
  const uint32_t prevBaud = g_mb_baud;

  // Must run on first boot too — v18 called Serial2.begin() in setup(); only
  // re-initing when baud changed left UART off when loaded baud == 19200.
  if (!g_mbSerialReady || g_mb_baud != baud) {
    Serial2.end();
    Serial2.setTX(TX2);
    Serial2.setRX(RX2);
    Serial2.begin(baud);
    while (Serial2.available()) (void)Serial2.read();
    mb.config(baud);
    g_mb_baud = baud;
    g_mbSerialReady = true;
  }
  setSlaveIdIfAvailable(mb, addr);
  g_mb_address = addr;
  SlaveId = (int)addr;
  mbSyncHolding();
  // Skip dirty on setup() first init; only when addr/baud actually change later.
  if (wasReady && (addr != prevAddr || baud != prevBaud)) markCfgDirty();
}

void handleValues(JSONVar values) {
  markWebHostRx();
  const int addr = jvGetInt(values, "mb_address", (int)g_mb_address);
  const int baud = jvGetInt(values, "mb_baud",    (int)g_mb_baud);
  applyModbusSettings((uint8_t)addr, (uint32_t)baud);
  wsLog("Modbus configuration updated");
  sendWebStatus();
}

void handleCommand(JSONVar obj) {
  markWebHostRx();
  const char* actC = (const char*)obj["action"];
  if (!actC) { wsLog("command: missing 'action'"); return; }
  String act = String(actC); act.toLowerCase();
  if (act == "reboot" || act == "reset") {
    wsLog("Rebooting…");
    if (cfgDirty) saveSettingsFS();
    (void)saveMeterFS();
    delay(50);
    rp2040.reboot();
  } else if (act == "factory") {
    setDefaults();
    if (saveConfigFS()) {
      wsLog("Factory defaults restored & saved");
      queueAtmFullApply();  // push factory cal/options into the chip now
      sendWebBootstrap();
      applyModbusSettings(g_mb_address, g_mb_baud);
    } else {
      wsLog("ERROR: Save after factory reset failed");
    }
  } else if (act == "hello" || act == "getconfig") {
    sendWebBootstrap();
  } else if (act == "identify") {
    g_identifyUntilMs = millis() + IDENTIFY_MS;
    wsLog("Identify: LEDs active for 5 s");
  } else if (act == "reset_energy") {
    resetEnergyCounters();
  } else {
    wsLog(String("Unknown command: ") + actC);
  }
}

// Contract t: relay, btn, led, ext.atm (+ legacy relayCfg/btnCfg/ledCfg/atm)
void handleUnifiedConfig(JSONVar obj) {
  markWebHostRx();
  const char* t = (const char*)obj["t"];
  JSONVar list = obj["list"];
  if (!t) { wsLog("Config: missing 't'"); return; }

  String type = String(t);
  bool changed = false;

  if (type == "relay" || type == "relays" || type == "relayCfg") {
    if (type == "relayCfg") {
      JSONVar en  = list["enabled"];
      JSONVar inv = list["inverted"];
      for (int i = 0; i < NUM_RLY; i++) {
        if (JSON.typeof(en[i])  != "undefined") rlyCfg[i].enabled  = (bool)en[i];
        if (JSON.typeof(inv[i]) != "undefined") rlyCfg[i].inverted = (bool)inv[i];
      }
    } else {
      for (int i = 0; i < NUM_RLY && i < list.length(); i++) {
        JSONVar item = list[i];
        if (item.hasOwnProperty("enabled")) rlyCfg[i].enabled = (bool)item["enabled"];
        if (item.hasOwnProperty("inverted"))
          rlyCfg[i].inverted = (bool)item["inverted"];
        else if (item.hasOwnProperty("invert"))
          rlyCfg[i].inverted = (bool)item["invert"];
        if (JSON.typeof(item["mode"]) != "undefined") rlyCfg[i].mode = (uint8_t)constrain(jvGetInt(item, "mode", rlyCfg[i].mode), 0, 2);
        if (JSON.typeof(item["alarmCh"]) != "undefined") rlyCfg[i].alarmCh = (uint8_t)constrain(jvGetInt(item, "alarmCh", rlyCfg[i].alarmCh), 0, 3);
        if (JSON.typeof(item["alarmMask"]) != "undefined") rlyCfg[i].alarmMask = (uint8_t)jvGetInt(item, "alarmMask", rlyCfg[i].alarmMask);
      }
    }
    wsLog("Relay Configuration updated");
    changed = true;

  } else if (type == "alarm" || type == "alarms" || type == "AlarmsCfg") {
    alarmApplyFromJson(list);
    {
      const int ch = jvGetInt(list, "ch", 0);
      const uint8_t c = (uint8_t)constrain(ch, 0, 3);
      char buf[112];
      snprintf(buf, sizeof(buf), "OK: alarm ch%u e0=%u lo0=%ld hi0=%ld",
               (unsigned)c,
               (unsigned)alarmCfg[c].rules[0].enabled,
               (long)alarmCfg[c].rules[0].minVal,
               (long)alarmCfg[c].rules[0].maxVal);
      wsLog(buf);
    }
    changed = true;

  } else if (type == "alarmAck" || type == "ack") {
    // Same path as Config writes — AlarmsAck named event is easy to miss in the UI log.
    alarmAckFromJson(list);
    alarmPublishModbus();
    {
      const int ch = jvGetInt(list, "ch", -1);
      char buf[64];
      if (ch >= 0 && ch < 4)
        snprintf(buf, sizeof(buf), "OK: ack ch%u (latched cleared)", (unsigned)ch);
      else
        snprintf(buf, sizeof(buf), "OK: ack all (latched cleared)");
      wsLog(buf);
    }
    sendWebExt();
    return;  // already published; skip generic changed path

  } else if (type == "btn" || type == "buttons" || type == "btnCfg") {
    JSONVar a = (type == "btnCfg") ? list["action"] : list;
    for (int i = 0; i < NUM_BTN; i++) {
      if (JSON.typeof(a[i]) == "undefined") continue;
      int v = a[i].hasOwnProperty("action")
                ? jvGetInt(a[i], "action", 0)
                : jsonVarToInt(a[i], 0);
      btnCfg[i].action = sanitizeBtnAction(v);
    }
    wsLog("Buttons Configuration updated");
    changed = true;

  } else if (type == "led" || type == "leds" || type == "ledCfg") {
    JSONVar m = (type == "ledCfg") ? list["mode"] : JSONVar();
    JSONVar s = (type == "ledCfg") ? list["source"] : JSONVar();
    for (int i = 0; i < NUM_LED; i++) {
      if (type == "ledCfg") {
        if (JSON.typeof(m[i]) != "undefined")
          ledCfg[i].mode = (uint8_t)constrain(jsonVarToInt(m[i], (int)ledCfg[i].mode), 0, 1);
        if (JSON.typeof(s[i]) != "undefined") {
          int sv = jsonVarToInt(s[i], 0);
          ledCfg[i].source = sanitizeLedSource(sv);
        }
      } else if (i < list.length()) {
        ledCfg[i].mode   = (uint8_t)constrain(jvGetInt(list[i], "mode", (int)ledCfg[i].mode), 0, 1);
        int src          = jvGetInt(list[i], "source", 0);
        ledCfg[i].source = sanitizeLedSource(src);
      }
    }
    wsLog("LEDs Configuration updated");
    changed = true;

  } else if (type == "ext.atm" || type == "atm") {
    JSONVar atmObj = list;
    if (JSON.typeof(list) == "array" && list.length() > 0) atmObj = list[0];
    const bool full = atmJsonNeedsFullApply(atmObj);
    const bool cal = jvHasKey(atmObj, "cal") || jvHasKey(atmObj, "ph")
                  || jvHasKey(atmObj, "Ugain") || jvHasKey(atmObj, "Igain")
                  || jvHasKey(atmObj, "Uoffset") || jvHasKey(atmObj, "Ioffset");
    const bool ct = jvHasKey(atmObj, "ctPrimary") || jvHasKey(atmObj, "ctSecondary");
    const bool pga = jvHasKey(atmObj, "pga");
    atmApplyFromJson(atmObj);
    if (full) {
      queueAtmFullApply();
      if (pga) {
        char buf[64];
        snprintf(buf, sizeof(buf), "OK: PGA=%ux — chip apply queued", (unsigned)g_pgaGain);
        wsLog(buf);
      } else {
        wsLog("OK: ATM full apply queued");
      }
    } else if (cal) {
      queueAtmCalOnlyApply();
      wsLog("OK: ATM calibration queued");
      markMeterDirty();
    } else if (ct) {
      char buf[96];
      snprintf(buf, sizeof(buf), "OK: CT %uA:%umA N=%.4g (no chip write)",
               (unsigned)g_ctPrimaryA, (unsigned)g_ctSecondary_mA, g_ctRatioN);
      wsLog(buf);
    } else {
      wsLog("OK: ATM options updated");
    }
    changed = true;

  } else {
    wsLog(String("Unknown Config type: ") + t);
  }

  if (changed) {
    markCfgDirty();
    mbSyncHolding();  // keep HR shadow in step so applyHoldingFromModbus does not revert web edits
    sendWebCfg();
    // CT/PGA live in ext.atm — push ENM_Sync so the UI sees the applied values
    // (cfg nested atm assignment alone is fragile with Arduino_JSON).
    if (type == "alarm" || type == "alarms" || type == "AlarmsCfg"
        || type == "alarmAck" || type == "ack"
        || type == "ext.atm" || type == "atm")
      sendWebExt();
  }
}

void sendWebStatus() {
  const bool linkOk = linkOkNow((uint32_t)millis());
  JSONVar st;
  st["model"] = HM_MODEL_ID;
  st["fw"]    = HM_FW;
  st["map"]   = HM_FW;   // "0.2.0" — one version, matches st["fw"]
  st["addr"]  = g_mb_address;
  st["baud"]  = g_mb_baud;
  st["linkOk"] = linkOk ? 1 : 0;
  WebSerial.send("status", st);
  yield();
}

void sendWebCfg() {
  sendWebCfgCore();
  sendWebCalib();
}

static void sendWebCfgCore() {
  JSONVar cfg;
  for (int i = 0; i < NUM_RLY; i++) {
    cfg["relay"][i]["enabled"]   = rlyCfg[i].enabled ? 1 : 0;
    cfg["relay"][i]["invert"]    = rlyCfg[i].inverted ? 1 : 0;
    cfg["relay"][i]["inverted"]  = rlyCfg[i].inverted ? 1 : 0;
    cfg["relay"][i]["mode"]      = (int)rlyCfg[i].mode;
    cfg["relay"][i]["alarmCh"]   = (int)rlyCfg[i].alarmCh;
    cfg["relay"][i]["alarmMask"] = (int)rlyCfg[i].alarmMask;
  }
  for (int i = 0; i < NUM_BTN; i++) {
    cfg["btn"][i]["action"] = btnCfg[i].action;
  }
  for (int i = 0; i < NUM_LED; i++) {
    cfg["led"][i]["mode"]   = ledCfg[i].mode;
    cfg["led"][i]["source"] = ledCfg[i].source;
  }
  // Build atm locally — nested cfg["ext"]["atm"]["k"]=v often serializes as null
  // with Arduino_JSON (same pitfall as sendWebExt).
  JSONVar atm;
  atm["lineHz"] = (int)g_atm_cfg.lineHz;
  atm["sumAbs"] = (int)g_atm_cfg.sumAbs;
  atm["wireMode"] = (int)g_atm_cfg.wireMode;
  JSONVar pmap;
  for (int i = 0; i < 3; i++) pmap[i] = (int)g_atm_cfg.phaseMap[i];
  atm["phaseMap"] = pmap;
  atm["ucal"] = (int)g_atm_cfg.ucal;
  atm["ctPrimary"] = (int)g_ctPrimaryA;
  atm["ctSecondary"] = (int)g_ctSecondary_mA;
  atm["pga"] = (int)g_pgaGain;
  atm["ctRatioN"] = g_ctRatioN;
  JSONVar ext;
  ext["atm"] = atm;
  cfg["ext"] = ext;
  // Flat int arrays only — nested cfg.alarm serialized as null on Arduino_JSON.
  alarmCfgEmitFlat(cfg);
  WebSerial.send("cfg", cfg);
  yield();
}

static void sendWebExt() {
  // Separate frames: one fat "ext" JSON often fails over USB WebSerial; ENM_Meter/ENM_Sync are proven.
  WebSerial.send("ENM_Sync", enmSyncToJson());
  yield();
  if (g_haveMeter) {
    WebSerial.send("ENM_Meter", meterLiveToJson());
    yield();
  }
  JSONVar ext;
  // NOTE: Arduino_JSON JSONVar temporaries can serialize as null when assigned
  // directly into nested objects; keep locals to ensure stable values.
  JSONVar atm;
  JSONVar cal = calPhasesArraySlim();
  atm["cal"] = cal;
  atm["ctPrimary"] = (int)g_ctPrimaryA;
  atm["ctSecondary"] = (int)g_ctSecondary_mA;
  atm["pga"] = (int)g_pgaGain;
  atm["ctRatioN"] = g_ctRatioN;
  ext["atm"] = atm;

  // Flat LED bits (12) — nested alarms[ch][kind].active often serializes null.
  JSONVar alarmLed;
  for (uint8_t ch = 0; ch < 4; ch++) {
    for (uint8_t kind = 0; kind < 3; kind++)
      alarmLed[(int)ch * 3 + (int)kind] = alarmRulePublished(ch, kind) ? 1 : 0;
  }
  ext["alarmLed"] = alarmLed;
  JSONVar alarms = alarmsStateToJson();
  ext["alarms"] = alarms;

  JSONVar chipEv;
  for (int i = 0; i < 4; i++) chipEv[i] = (int)g_chipEvMask[i];
  ext["chipEv"] = chipEv;
  WebSerial.send("ext", ext);
  yield();
}

static void resetEnergyCounters() {
  if (!atmBusy) drainChipEnergyRegs();
  clearEnergyCounters();
  markMeterDirty();
  if (saveMeterFS()) {
    meterDirty = false;
    meterSavedEnergyCrc = meterEnergyCrc();
    wsLog("Energy counters reset");
  } else {
    wsLog("ERROR: Energy reset save failed");
  }
  mbPublishMeter();
  sendWebExt();
}

static void sendWebIo(const bool* relayLogical, const bool* buttonState, const bool* ledPhysState) {
  JSONVar io;
  for (int i = 0; i < NUM_RLY; i++) io["relay"][i] = relayLogical[i] ? 1 : 0;
  for (int i = 0; i < NUM_BTN; i++) io["btn"][i] = buttonState[i] ? 1 : 0;
  for (int i = 0; i < NUM_LED; i++) io["led"][i] = ledPhysState[i] ? 1 : 0;
  WebSerial.send("io", io);
  yield();
}

// Small frames: status / io rotate; meter+energy via ENM_* on 1 Hz tick; alarms via ext.
static void serviceWebTelemetry(unsigned long now, const bool* relayLogical, const bool* buttonState, const bool* ledPhysState) {
  if (now - lastWebFrameMs < webFrameIntervalMs) return;
  lastWebFrameMs = now;

  if (webFramePhase == 0) sendWebStatus();
  else sendWebIo(relayLogical, buttonState, ledPhysState);
  webFramePhase = (uint8_t)(!webFramePhase);
}

static void serviceMeterWeb(unsigned long now) {
  if (now - lastMeterWebMs < meterWebIntervalMs) return;
  lastMeterWebMs = now;
  sendWebExt();
}

// v0.1.0 pushWebConfigPeriodic: status + cfg in small steps with yield between frames.
static void pushWebConfigPeriodic() {
  sendWebStatus();
  yield();
  sendWebCfg();
}

void sendWebBootstrap() {
  sendWebStatus();
  yield();
  sendWebExt();
  yield();
  sendWebCfg();
}

static void atmUpdateBaseFromJson(const JSONVar& obj) {
  if (jvHasKey(obj, "lineHz")) {
    int hz = jvGetInt(obj, "lineHz", (int)g_atm_cfg.lineHz);
    g_atm_cfg.lineHz = (hz == 60) ? 60 : 50;
  }
  if (jvHasKey(obj, "sumAbs")) {
    g_atm_cfg.sumAbs = jvGetInt(obj, "sumAbs", (int)g_atm_cfg.sumAbs) ? 1 : 0;
  }
  if (jvHasKey(obj, "wireMode")) {
    g_atm_cfg.wireMode = jvGetInt(obj, "wireMode", (int)g_atm_cfg.wireMode) ? 1 : 0;
  }
  if (jvHasKey(obj, "phaseMap")) {
    JSONVar pmap = obj["phaseMap"];
    uint8_t tmp[3];
    for (int i = 0; i < 3; i++) {
      JSONVar v = pmap[i];
      if (JSON.typeof(v) == "undefined") v = pmap[(int)i];
      tmp[i] = (uint8_t)constrain(jsonVarToInt(v, (int)g_atm_cfg.phaseMap[i]), 0, 2);
    }
    if (validatePhaseMap(tmp)) {
      for (int i = 0; i < 3; i++) g_atm_cfg.phaseMap[i] = tmp[i];
    }
  }
  if (jvHasKey(obj, "ucal")) {
    int u = jvGetInt(obj, "ucal", (int)g_atm_cfg.ucal);
    if (u < 1) u = 1;
    if (u > 65535) u = 65535;
    g_atm_cfg.ucal = (uint16_t)u;
  }
  bool ctChanged = false;
  if (jvHasKey(obj, "ctPrimary")) {
    g_ctPrimaryA = (uint16_t)constrain(jvGetInt(obj, "ctPrimary", (int)g_ctPrimaryA), 1, 10000);
    ctChanged = true;
  }
  if (jvHasKey(obj, "ctSecondary")) {
    g_ctSecondary_mA = (uint16_t)constrain(jvGetInt(obj, "ctSecondary", (int)g_ctSecondary_mA), 1, 60);
    ctChanged = true;
  }
  if (jvHasKey(obj, "pga")) {
    int g = jvGetInt(obj, "pga", (int)g_pgaGain);
    if (g != 1 && g != 2 && g != 4) g = 2;
    g_pgaGain = (uint8_t)g;
  }
  if (ctChanged) {
    sampleEnergyCounters();  // drain ticks accrued at the OLD ratio before N changes
    recomputeCtRatio();      // N affects future deltas only — accumulated Wh unchanged
    wsLog("CT ratio changed");
  } else {
    clampCtPgaSettings();
  }
}
static void atmUpdatePhaseFromJson(int phase, const JSONVar& obj) {
  if (phase < 0 || phase > 2) return;
  if (obj.hasOwnProperty("Ugain"))   g_atm_cfg.cal[phase].Ugain   = clamp_u16(jvGetInt(obj, "Ugain",   (int)g_atm_cfg.cal[phase].Ugain));
  if (obj.hasOwnProperty("Igain"))   g_atm_cfg.cal[phase].Igain   = clamp_u16(jvGetInt(obj, "Igain",   (int)g_atm_cfg.cal[phase].Igain));
  if (obj.hasOwnProperty("Uoffset")) g_atm_cfg.cal[phase].Uoffset = clamp_i16(jvGetInt(obj, "Uoffset", (int)g_atm_cfg.cal[phase].Uoffset));
  if (obj.hasOwnProperty("Ioffset")) g_atm_cfg.cal[phase].Ioffset = clamp_i16(jvGetInt(obj, "Ioffset", (int)g_atm_cfg.cal[phase].Ioffset));
}

static bool atmJsonNeedsFullApply(const JSONVar& obj) {
  // Structural options require SoftReset via begin(). Calibration/offset alone do not.
  // ucal feeds sag/OV thresholds computed inside begin() — treat as structural.
  // pga writes MMode1 gain bits inside begin(). CT ratio is software-only.
  return jvHasKey(obj, "lineHz") || jvHasKey(obj, "sumAbs")
      || jvHasKey(obj, "wireMode") || jvHasKey(obj, "phaseMap")
      || jvHasKey(obj, "ucal") || jvHasKey(obj, "pga");
}

static void atmApplyFromJson(const JSONVar& obj) {
  // Always apply any base fields present (incl. CT) — full-apply is a separate decision.
  atmUpdateBaseFromJson(obj);
  if (obj.hasOwnProperty("ph")) {
    const int ph = jvGetInt(obj, "ph", 0);
    if (ph >= 0 && ph <= 2) atmUpdatePhaseFromJson(ph, obj);
  }
  if (obj.hasOwnProperty("cal")) {
    JSONVar cal = obj["cal"];
    for (int i = 0; i < 3; i++) {
      JSONVar p = cal[i];
      if (JSON.typeof(p) == "undefined") continue;
      atmUpdatePhaseFromJson(i, p);
    }
  }
}

static void wsDiagPrintRawAtm(uint32_t now) {
  if (!webHostConnected) return;  // quiet USB when no WebConfig host
  if (now - lastWsDiagPrint < wsDiagPrintMs) return;
  lastWsDiagPrint = now;
  if (atmBusy || meter_job) return;

  // Raw diagnostics: read directly from chip registers to confirm detector state.
  const uint16_t emm0 = g_atm.debugRead16(0x71);
  const uint16_t emm1 = g_atm.debugRead16(0x72);
  const uint16_t int0 = g_atm.debugRead16(0x73);
  const uint16_t int1 = g_atm.debugRead16(0x74);

  const uint16_t uPkA = g_atm.debugRead16(0xF1);
  const uint16_t uPkB = g_atm.debugRead16(0xF2);
  const uint16_t uPkC = g_atm.debugRead16(0xF3);
  const uint16_t iPkA = g_atm.debugRead16(0xF5);
  const uint16_t iPkB = g_atm.debugRead16(0xF6);
  const uint16_t iPkC = g_atm.debugRead16(0xF7);

  const uint16_t sagTh = g_atm.debugRead16(0x08);
  const uint16_t ovTh  = g_atm.debugRead16(0x06);
  const uint16_t plTh  = g_atm.debugRead16(0x09);
  const uint16_t oiTh  = g_atm.debugRead16(0x0B);
  const uint16_t fHiTh = g_atm.debugRead16(0x0D);
  const uint16_t fLoTh = g_atm.debugRead16(0x0C);

  const uint8_t m0 = g_chipEvMask[0];
  const uint8_t m1 = g_chipEvMask[1];
  const uint8_t m2 = g_chipEvMask[2];
  const uint8_t m3 = g_chipEvMask[3];
  JSONVar ev = chipEvMasksToJson();
  String evSer = JSON.stringify(ev);

  char buf[320];
  snprintf(buf, sizeof(buf),
           "DIAG EMM0=%04X EMM1=%04X INT0=%04X INT1=%04X | "
           "UPk=%04X/%04X/%04X IPk=%04X/%04X/%04X | "
           "SagTh=%04X OVth=%04X PLth=%04X OIth=%04X FHi=%04X FLo=%04X | "
           "mask=%02X/%02X/%02X/%02X ev=%s",
           emm0, emm1, int0, int1,
           uPkA, uPkB, uPkC, iPkA, iPkB, iPkC,
           sagTh, ovTh, plTh, oiTh, fHiTh, fLoTh,
           m0, m1, m2, m3,
           evSer.c_str());
  wsLog(buf);
}

void setup() {
  Serial.begin(57600);

  if (!LittleFS.begin()) {
    LittleFS.format();
    LittleFS.begin();
  }
  if (!loadConfigFS()) setDefaults();

  for (uint8_t i=0;i<NUM_RLY;i++) { pinMode(RELAY_PINS[i], OUTPUT); digitalWrite(RELAY_PINS[i], LOW); }
  for (uint8_t i=0;i<NUM_LED;i++) { pinMode(LED_PINS[i],   OUTPUT); digitalWrite(LED_PINS[i],   LOW); }
  for (uint8_t i=0;i<NUM_BTN;i++) pinMode(BTN_PINS[i], INPUT); // HIGH=pressed (field board)

  Serial2.setTX(TX2);
  Serial2.setRX(RX2);
  applyModbusSettings(g_mb_address, g_mb_baud);
  mb.setAdditionalServerData("ENM223-ENM");
  mbBuildRegisterMap();
  hmRegisterIdentity(mb, HM_MODEL_ID, HM_FW_MAJOR, HM_FW_MINOR, HM_FW_PATCH, HM_MAP_VERSION);
  mbSyncHolding();
  g_lastLinkSeenMs = millis();

  // SimpleWebSerial allows max 8 events — do not add more without changing the library.
  WebSerial.on("values",  handleValues);
  WebSerial.on("Config",  handleUnifiedConfig);
  WebSerial.on("command", handleCommand);
  WebSerial.on("AlarmsCfg", handleAlarmsCfg);
  WebSerial.on("AlarmsAck", handleAlarmsAck);

  SPI1.setSCK(ATM_SCK);
  SPI1.setTX(ATM_MOSI);
  SPI1.setRX(ATM_MISO);
  SPI1.begin();

  atmBusy = true;
  atmApplyFromCfg_NOW();
  atmBusy = false;
  // Counters come from LittleFS (loadMeterFS); do not SPI-sample into them at boot.
  meterSavedEnergyCrc = meterEnergyCrc();
  lastMeterTouchMs = millis();
  mbPublishMeter();

  wsLog("Boot OK " HM_FW " (config saved to flash)");
  sendWebBootstrap();
  lastMeterSample = millis();
  lastEnergySample = millis();
  hmWatchdogArm(4000);
}

void loop() {
  hmWatchdogFeed();
  const unsigned long now = millis();

  // Link detector must run before mb.task() — task drains the RX buffer.
  updateLinkOkDetector((uint32_t)now);
  mb.task();
  WebSerial.check();
  yield();

  if (!atmBusy && !meter_job && (now - lastPeakResetMs >= peakResetMs)) {
    lastPeakResetMs = now;
    g_atm.resetPeakRegisters();
  }

  mbUpdateStatusFlags((uint32_t)now);

  serviceModbusAck();
  serviceModbusRelays();
  serviceModbusServiceCoils((uint32_t)now);
  alarmServiceTick(now);
  wsDiagPrintRawAtm((uint32_t)now);
  applyHoldingFromModbus();

  if (atmApplyPending && !atmBusy && (now - atmLastApplyMs >= atmApplyMinIntervalMs)) {
    atmApplyPending = false;
    atmCalOnlyPending = false;
    atmBusy = true;
    atmApplyFromCfg_NOW();
    atmBusy = false;
    atmLastApplyMs = now;
    markCfgDirty();
    markMeterDirty();
    wsLog("OK: ATM applied (full begin)");
    sendWebCfg();
  } else if (atmCalOnlyPending && !atmBusy && (now - atmLastApplyMs >= atmApplyMinIntervalMs)) {
    atmCalOnlyPending = false;
    atmBusy = true;
    atmApplyCalOnly_NOW();
    atmBusy = false;
    atmLastApplyMs = now;
    markCfgDirty();
    markMeterDirty();
    wsLog("OK: ATM calibration applied");
    sendWebCfg();
  }

  if (cfgDirty && (now - lastCfgTouchMs >= CFG_AUTOSAVE_MS)) {
    if (saveSettingsFS()) cfgDirty = false;
    else                  lastCfgTouchMs = now;  // save failed — retry after another interval
  }

  serviceMeterAutosave(now);

  if (now - lastBlinkToggle >= blinkPeriodMs) {
    lastBlinkToggle = now;
    blinkPhase = !blinkPhase;
  }

  bool relayLogical[NUM_RLY];
  for (int i = 0; i < NUM_BTN; i++) {
    const bool rawPressed = (digitalRead(BTN_PINS[i]) == HIGH);
    serviceDebounce(btnDeb[i], rawPressed, now);
    const bool pressed = btnDeb[i].stable;
    buttonState[i] = pressed;
    const bool rising = (!btnDeb[i].prevStable && btnDeb[i].stable);
    if (rising) {
      uint8_t act = btnCfg[i].action;
      if (act == 5 || act == 6) {
        int r = act - 5;
        if (r >= 0 && r < NUM_RLY) desiredRelay[r] = !desiredRelay[r];
      } else if (act == 7) {
        for (uint8_t ch = 0; ch < 4; ch++) alarmAckChannel(ch);  // Ack All
        wsLog("Button: ack all");
      } else if (act >= 8 && act <= 11) {
        alarmAckChannel((uint8_t)(act - 8));  // Ack L1/L2/L3/Total
        wsLog("Button: ack channel");
      }
    }
  }

  for (int i = 0; i < NUM_RLY; i++) {
    bool logical = false;
    if (!rlyCfg[i].enabled) {
      logical = false;
    } else if (rlyCfg[i].mode == RLY_MODE_NONE) {
      logical = false;
    } else if (rlyCfg[i].mode == RLY_MODE_ALARM) {
      logical = relayAlarmDemand((uint8_t)i);
    } else {
      logical = desiredRelay[i];
    }
    bool phys = logical;
    if (rlyCfg[i].inverted) phys = !phys;
    digitalWrite(RELAY_PINS[i], phys ? HIGH : LOW);
    relayLogical[i] = logical;
  }
  // Coil image is an honest mirror of the ACTUAL relay state (all modes), like DIO's
  // syncCoilsFromState. In Modbus mode coil==desired==logical; in Alarm/None mode the
  // coil follows relayLogical so HA shows the real relay and a manual toggle bounces back.
  for (int i = 0; i < NUM_RLY; i++)
    if (mb.Coil((uint16_t)i) != relayLogical[i]) mb.Coil((uint16_t)i, relayLogical[i]);

  bool ledPhysState[NUM_LED];
  for (int i = 0; i < NUM_LED; i++) {
    bool physLed;
    const bool identifying = g_identifyUntilMs && ((int32_t)(now - g_identifyUntilMs) < 0);
    if (identifying) {
      physLed = blinkPhase;
    } else {
      bool srcActive = false;
      uint8_t src = ledCfg[i].source;
      if (src == 5 || src == 6) {
        int r = src - 5;
        srcActive = (r >= 0 && r < NUM_RLY) ? relayLogical[r] : false;
      } else if (src >= 10 && src <= 21) {
        const uint8_t kind = (uint8_t)((src - 10) / 4);  // 0=Alarm,1=Warning,2=Event
        const uint8_t ch   = (uint8_t)((src - 10) % 4);  // 0..3 = L1,L2,L3,Total
        srcActive = alarmRulePublished(ch, kind);        // latched if ackRequired, else live
      }
      physLed = (ledCfg[i].mode == 0) ? srcActive : (srcActive && blinkPhase);
    }
    ledPhysState[i] = physLed;
    digitalWrite(LED_PINS[i], physLed ? HIGH : LOW);
  }
  mbPublishIoMask(ledPhysState, buttonState, relayLogical);

  if (!meter_job && !atmBusy && (now - lastMeterSample >= meterSampleMs)) {
    lastMeterSample = now;
    meter_job_begin();
  }
  meter_job_step();

  if (!atmBusy && !meter_job && (now - lastEnergySample >= energySampleMs)) {
    lastEnergySample = now;
    sampleEnergyCounters();
    mbPublishMeter();
  }

  serviceWebTelemetry(now, relayLogical, buttonState, ledPhysState);
  serviceMeterWeb(now);

  if (now - lastBootstrap >= bootstrapInterval) {
    lastBootstrap = now;
    pushWebConfigPeriodic();
  }
}
