isystemsautomation/homemaster-dev/(commit log)

2026-05-11 Fix image paths in smart-chimney article (CDN + remove broken schematic figure)
2026-05-14 Add SPI configuration to miniplc.yaml
2026-05-14 Enhance README with sensor and Ethernet configuration
    Added YAML configuration sections for enabling RTD and 1-Wire sensors, as well as Ethernet support. Updated README structure and documentation for clarity.
2026-05-15 Add initial config for Homemaster MiniPLC
    Add initial configuration for Homemaster MiniPLC with various components including ESP32 setup, logger, API, web server, and multiple sensors.
2026-05-19 Remove PID controllers from AIO-422-R1 firmware and configs.
    Drop PID Modbus registers, WebSerial UI, and ESPHome entities; keep AI/AO/RTD, buttons, and LEDs. Bump persisted config to v0008.
2026-05-19 Add AIO-422-R1 firmware developer manual for Arduino IDE and RP2350.
    Document IDE setup, board package, libraries, build, upload, and WebConfig; link from module README and sketch folder.
2026-05-21 Tune ENM-223-R1 ATM90E32 defaults for board CTs and voltage divider.
    Set PGA 2× for ZEMCTK05 current inputs and update Ugain/Igain/ucal so 230 V and 50 A scale without uint16 overflow.
2026-05-21 Revert ENM-223-R1 ATM90 tuning that caused connect hangs.
    Restore PGA 1× and placeholder Ugain/Igain/ucal defaults from the last working firmware.
    [atm90e32.cpp, default_enm_223_r1.ino]
2026-05-21 Align ENM-223 ConfigTool with default firmware WebSerial protocol.
    Chunk ATM live SPI reads so the loop stays responsive, and teach ConfigTool to use atm/atmLive handlers instead of legacy Config/CalibCfg events.
2026-05-21 Apply ENM-223 Modbus settings immediately in the values handler.
    Remove the deferred queue so address and baud changes match DIO/ALM behavior and avoid hangs during WebConfig updates.
    [default_enm_223_r1.ino]
2026-05-21 Fix ENM-223 hangs by deferring Modbus apply and sending full ENM_Meter data.
    Stop WebSerial reentrancy during ATM SPI sampling, apply Modbus in loop only, and publish P/Q/S plus energy for ConfigTool.
    [default_enm_223_r1.ino]
2026-05-21 Fix ENM-223 WebConfig hang on Modbus apply and empty calibration fields.
    Use explicit Apply Modbus, pause ATM polling after address/baud changes, force-fill cal UI from atmCfg, and restore Ugain defaults for the board divider.
    [default_enm_223_r1.ino]
2026-05-21 Fix ENM-223 WebConfig JSON parsing and Modbus hang on Linux builds.
    Parse config from full JSON blobs to work around broken Arduino_JSON casts, pause RS485 after address changes, and apply phase calibration without chip reset.
    [default_enm_223_r1.ino]
2026-05-21 Apply ENM-223 Modbus settings immediately like AIO-422.
    Remove deferred apply queue, pause ATM SPI after address change, and reply with status from the values handler so USB is not blocked.
2026-05-21 Fix ENM-223 Modbus address change hang via jvGetInt and queued apply.
    Parse WebConfig values correctly on device, ack Modbus changes over USB before RS485 apply, and show firmware tag in status.
    [default_enm_223_r1.ino]
2026-05-21 Fix ENM WebConfig sync and round Modbus sensor values in ESPHome.
    Send status and calibration in one getAll burst (v18), auto-apply Modbus in WebConfig, and add lambda rounding for PF/P/Q/S in the PLC yaml.
    [default_enm_223_r1.ino, default_enm_223_r1_plc.yaml]
2026-05-21 Set ENM-223 defaults for ZEMCTK05 CT and calibrated voltage divider.
    Use PGA 2× on all current channels and factory Ugain/Igain/ucal values for 50A CT and 230V divider.
2026-05-21 ENM-v20: persist config in flash and auto-push WebConfig on USB connect.
    Save Modbus, calibration, and energy counters to LittleFS; push status/ENM_Sync/meter data when the host opens the serial port without getAll or chip readback.
2026-06-07 Document ESP32-WROOM-32U-N16 in controller README specs.
    Align MiniPLC and MicroPLC documentation with product pages and OpenTherm Gateway by naming the 16 MB flash module variant explicitly.
2026-06-08 Fix ENM-223-R1 Modbus UART init on first boot at default baud.
    Ensure Serial2 is started when settings load at 19200 instead of only re-initializing on baud change.
    [default_enm_223_r1.ino]
2026-06-12 Version module firmware into v0.1.0 and v0.2.0 folder layout.
    Freeze current sketches and ESPHome packages as v0.1.0, add identical v0.2.0 worktrees, and point all documentation at v0.1.0 paths.
2026-06-12 v0.2.0 Phase B: decouple output state from config (flash wear).
    Move runtime output levels to /cfg_out.bin with power-on policy (OFF/ON/RESTORE_LAST) and debounced snapshot saves; settings-only autosave remains in /cfg.bin.
2026-06-12 v0.2.0 DIO pilot: unified webconfig (shared css/js + protocol).
    Extract shared HMWebConfig framework and migrate DIO firmware/WebSerial to status/io/cfg/log contract.
2026-06-12 v0.2.0: fix relay inverted feedback chatter (DIO + audit DIM/RGB/WLD).
    Write logical commanded state to Modbus coil/status; apply invert only on physical pin drive.
    [default_DIO_430_R1.ino, default_wld-521-r1.ino]
2026-06-12 v0.2.0 AIO-422-R1: unified webconfig.
    Migrate firmware and ConfigToolPage to shared status/io/cfg/ext/log protocol; preserve AI, DAC, RTD, buttons, and LEDs.
2026-06-12 v0.2.0 DIM-420-R1: unified webconfig.
    Replace monolithic config snapshot with status/io/cfg/ext protocol; preserve dimmer channels, DI press matrix, buttons, and LEDs.
    [default_DIM_420_R1.ino]
2026-06-12 v0.2.0 ENM-223-R1: unified webconfig.
    Consolidate ENM_Sync scatter keys into status/io/cfg/ext; preserve meter, calibration, relays, buttons, and LEDs.
2026-06-12 v0.2.0 RGB-621-R1: unified webconfig.
    Migrate to shared protocol with ext.pwm live levels; preserve light sliders, presets, and I/O config cards.
2026-06-12 v0.2.0 WLD-521-R1: unified webconfig.
    Unified status/io/cfg/ext with flow, heat, and 1-Wire live data; preserve per-DI panels and relay control mode.
2026-06-12 v0.2.0 DIO: remove 3rd button (dead GPIO1 HW).
    NUM_BTN=2, BTN_PINS={2,3}; bump CFG_VERSION to invalidate old btnCfg blob; WebConfig shows 2 buttons.
2026-06-15 webconfig: pin manifest html_path to Firmware v0.1.0.
    All seven module ConfigToolPage.html paths updated for Odoo/n8n sync.
2026-06-15 Add GitHub Pages WebConfig landing page (index.html).
    Module grid with v0.1.0 current and v0.2.0 beta links to ConfigToolPage and firmware paths.
2026-06-16 Update GitHub Pages landing with docs links and version panels.
2026-06-16 Expand landing hub with controllers, STR-3221 and shop links.
2026-06-16 Update GitHub Pages landing (index.html).
2026-06-16 Fix duplicate grid wrappers in SEO landing index.html.
2026-06-17 Add Arduino build output for DIO-430-R1 v0.2.0 firmware.
2026-06-17 DIO-430-R1: fix ESPHome package — replace unsupported modbus_controller button with template buttons; drop duplicate relay/local-logic binary_sensors
    [default_dio_430_r1_plc.yaml]
2026-06-17 DIO-430-R1 WebConfig: remove redundant Save/Load buttons (config auto-saves to flash)
2026-06-17 WebConfig: standardize Tools panel (Identify/Factory/Reboot) at top across v0.2.0 module pages; drop manual Save/Load (autosave)
    - Add HMWebConfig.mountTools() in _shared/hm-webconfig.js (shared panel + handlers)
    - Mount hm-tools after header on all seven v0.2.0 ConfigToolPage.html files (HMWebConfig)
    - DIO: move Tools to top, remove inline duplicate markup
    - Firmware: add missing factory/reboot/identify command handlers where needed (ENM factory; DIM/WLD reboot; identify blink on all modules with user LEDs)
    - All v0.2.0 modules already on HMWebConfig — none skipped
    [default_DIM_420_R1.ino, default_aio_422_r1.ino, default_alm_173_r1.ino, default_enm_223_r1.ino, default_rgb_621_r1.ino, default_wld-521-r1.ino]
2026-06-17 ALM WebConfig: remove duplicate Reset Device button (use Tools panel Reboot)
2026-06-17 WebConfig: unify all v0.2.0 module pages on shared HMWebConfig — standard header, model/version guard, top Tools panel, disconnect reset; map-version hygiene
    - HMWebConfig: reset module header fields on disconnect/timeout; linkOk/localLogic in applyStatus; localLogic toggle wiring via register({ localLogic: true })
    - All v0.2.0 pages: unified status pills (Connection, Bus, Model, FW, Map, Modbus ID, Baud); map guard expects 2
    - Firmware v0.2.0: HM_MAP=2 (block map), drop duplicate HM_MAP_VERSION define
    - DIO: remove page-local version check and local-logic handler (moved to shared lib)
    All seven v0.2.0 modules were already on HMWebConfig; no v0.1.0 ports required.
    [default_DIM_420_R1.ino, default_DIO_430_R1.ino, default_aio_422_r1.ino, default_alm_173_r1.ino, default_enm_223_r1.ino, default_rgb_621_r1.ino, default_wld-521-r1.ino]
2026-06-17 DIO-430-R1: remove global local-logic flag; relay controllable from all sources; maintained switch defaults to toggle-on-edge (follow optional)
2026-06-17 DIO-430-R1: move InCfgV10 before Arduino auto-prototypes (fix compile)
    [default_DIO_430_R1.ino]
2026-06-17 DIO-430-R1 docs: correct UF2 BOOT button sequence (1+2+3, release 1, then 2+3)
2026-06-17 DIO-430-R1: publish UF2 from Arduino build/ path only; drop sketch-folder copy
2026-06-17 DIO-430-R1: fix front button polarity to active-high (INPUT + read HIGH) per MCUBoard schematic
    [default_DIO_430_R1.ino]
2026-06-18 DIO-430-R1 docs: correct button count (3 physical / 2 logic), add UF2 firmware-update procedure, embed WebConfig screenshots
2026-06-18 DIO-430-R1 docs: add updated WebConfig screenshots (webconfig1–5)
2026-06-18 DIO-430-R1 docs: update datasheet (correct front-panel button count)
2026-06-18 Fix UF2 links to actual Arduino export path (build/<fqbn>/<sketch>.ino.uf2)
2026-06-18 DIO-430-R1: promote firmware v0.2.0 to current, mark v0.1.0 legacy (index, README, productpage)
2026-06-18 DIO-430-R1: expose Timing settings in WebConfig, drop non-functional Safe-mode LED source and redundant ESPHome Save-config button
2026-06-18 ci: pin exact library names+versions (add Modbus-Arduino base, fix Modbus-Serial), pin core 5.6.0
2026-06-18 ci: pin FQBN flash layout to 2MB Sketch1MB/FS1MB so built uf2 has a LittleFS partition
2026-06-18 docs: cross-source consistency fixes (AIO UI, DIO buttons, STR inputs, RGB relay type), fix RGB links, fill sketch.yaml, correct README build table
2026-06-18 docs: cross-source consistency fixes (AIO UI, DIO buttons, STR inputs, RGB relay type), fix RGB links, fill sketch.yaml, correct README build table
    Fix broken image paths (ALM/DIM/RGB) and DIO README button polarity (active-HIGH).
2026-06-18 docs+manifest: repo-wide consistency fixes (Modbus tables vs YAML, AIO/DIO/STR/RGB specs, button polarity, broken images, sketch.yaml pins, README build table)
    Align README Modbus register maps with v0.2.0 ESPHome YAML: ENM full rewrite, ALM/DIO/WLD coil and address fixes, RGB/AIO tables added. DIM productpage image → buttons1.png.
2026-06-18 docs+manifest: repo-wide consistency fixes (Modbus tables vs YAML, AIO/DIO/STR/RGB specs, button polarity, broken images, sketch.yaml pins, README build table)
    DIO: full Modbus map from firmware/YAML (IREG/Coils/HREG), fix input-action model, ESPHome DI bitmask, library names. ALM: drop fictional IREG/HREG, coils/DI only. RGB: complete FC02/FC05/FC03 map.
2026-06-18 docs+manifest: repo-wide consistency fixes (Modbus tables vs YAML, AIO/DIO/STR/RGB specs, button polarity, broken images, sketch.yaml pins, README build table)
    DIO README dedup (§7): single WebConfig reference in §5.5, cross-links for defaults/UF2/pins; remove stale WLD HREG 1100 clock text.
2026-06-18 docs(DIO): rebuild README into market-aligned structure (overview→specs→hardware→config→modbus→integration), dedup, apply firmware-accurate fixes
2026-06-19 docs(DIO): add WebConfig screenshots (status, device setup, inputs, relays, buttons/LEDs)
2026-06-19 docs(DIO): fix button wording — 3 buttons, 2 user-configurable (third is boot/reset combo only)
2026-06-19 docs(DIO): fix relay current 16A→3A (module trace-limited per datasheet)
2026-06-19 docs(DIO): clarify address/baud change — WebConfig primary, Modbus path warns about live re-config
2026-06-19 docs(DIO): clarify Button 1/2 description (short/long actions, relay targets, HA event triggers)
2026-06-19 docs(DIO): document digital-input powering/wetting (internal fused 24 V, ISO1212 current limit, isolation domain)
2026-06-19 docs(DIO): lay out wiring diagrams (power/inputs/relays/RS-485) in a single row
2026-06-19 docs(DIO): clarify input power domain (module-fused 24 V, field↔logic isolation only, external 24 V & SELV grounding)
2026-06-19 docs(DIO): lay out §4.1 diagrams (block/control/relay/pinout) in a single row
2026-06-19 docs(DIO): sync productpage with README (Chromium browsers, ISO1212 inputs, relay wording)
2026-06-19 docs(DIO): README cleanup — drop canonical labels, fix §3.4/§4.1 anchors
2026-06-19 docs: align module READMEs — global WebConfig/Chromium rules (structure layer; full DIO layout per-module pending)
    - AIO, ALM, DIM, ENM, RGB, STR, WLD: versioned config.home-master.eu URLs (v0.1.0 stable)
    - Chromium-based browser wording + Firefox Nightly note
    - Facts/Modbus/section restructure unchanged — per-module audit next
2026-06-19 fix(ALM): correct LED4 pin (P4, not P3) — was clobbering BUTTON4 and leaving LED4 dark
    [default_alm_173_r1.ino]
2026-06-19 release(ALM): publish v0.2.0 UF2 build
    Include pre-built UF2 (LED4 pin fix, persist struct forward decl for Arduino IDE).
    [default_alm_173_r1.ino]
2026-06-19 feat(ALM): zone types, opt-in local arm w/ entry-exit delay, relay bell-cutoff, per-zone alarm memory (MAP v2, CFG v4)
2026-06-19 feat(ALM): WebConfig UI for zone types, relay bell-cutoff, local arming + status pills
2026-06-19 docs(ALM): canonical structure + verified v0.2.0 facts (opto 5V inputs, 3A SPDT relays), promote v0.2.0, fix WebConfig URL/browsers
2026-06-19 fix(ALM): latch entry delay until disarm/expiry
    [default_alm_173_r1.ino]
2026-06-19 chore: add .gitignore; stop tracking Arduino build/ artifacts
2026-06-19 refactor(ALM): Modbus telemetry → bit-packed Input Registers (FC04) + contiguous coils, uniform with DIO (MAP v3)
2026-06-20 refactor(ALM): stateful relay/armed coils + momentary actions, config to WebConfig — uniform with DIO (MAP v4)
2026-06-20 feat(ALM-yaml): stateful relay/armed switches + action buttons, uniform with DIO (MAP v4)
2026-06-20 docs(ALM): Modbus map → MAP v4 stateful coils, uniform with DIO
2026-06-20 fix(ALM): relay coil read-back uses logical state; invert only the physical pin (HA sync, no relay lock)
    [default_alm_173_r1.ino]
2026-06-20 build(ALM): update UF2 for logical relay coil read-back fix
2026-06-20 fix(ALM-yaml): expose relay/armed state via FC04 read bits (reliable HA state; coil read-back unreliable on contiguous coil block)
    [default_alm_173_r1_plc.yaml]
2026-06-20 fix(ALM-yaml): template relay/armed switches with FC04 state; write-only coils (assumed_state)
    Poll interval 1s. HA toggles read IREG @1 bits; coil block 0–10 no longer polled for state.
    [default_alm_173_r1_plc.yaml]
2026-06-20 fix(ALM): DIO-style relay coil handling — Modbus when group=0, alarm when group set
    YAML: modbus_controller switches like DIO (no template layer). Firmware adds
    desiredRelay[] and routes group=0 relays directly from Modbus coil commands.
    [default_alm_173_r1.ino, default_alm_173_r1_plc.yaml]
2026-06-20 build(ALM): update UF2 for DIO-style relay group routing fix
2026-06-30 fix(ENM v0.1.0): send button and LED live state to WebConfig.
    WebConfig already listens for ButtonStateList and LedStateList; firmware now publishes them every second alongside relayStateList.
    [default_enm_223_r1.ino]
2026-06-30 fix(ENM v0.1.0): correct button polarity on GPIO22–25.
    Field board drives buttons active-HIGH (same as AIO/DIM/WLD); INPUT_PULLUP + LOW=pressed showed all buttons permanently on.
    [default_enm_223_r1.ino]
2026-06-30 fix(ENM v0.1.0): make button relay toggle actually stick.
    Sync Modbus relay coils after button-driven desiredRelay updates so serviceModbusRelays no longer reverts them next loop; load button actions from ButtonGroupList in WebConfig.
    [default_enm_223_r1.ino]
2026-07-05 feat(STR-3221-R1): release firmware v0.1.0 firmware set
    Add 32-channel TLC59208F Arduino sketch, unified WebConfig page, and ESPHome Modbus package for the stair LED controller.
2026-07-05 refactor(DIO v0.2.0): tie config version to FW and simplify LED identify
    Bind persisted config version to HM_FW_* so firmware updates reset settings to defaults, drop legacy V7/V9/V10 migration paths, and make Identify a global 5 s blink override instead of a per-LED source option.
    [default_DIO_430_R1.ino]
2026-07-05 chore(DIO v0.2.0): publish UF2 build after config and LED identify changes
2026-07-05 fix(DIO-yaml): relay state via FC04 read; write-only coils for fast HA control
    Replace coil read-back switches with template relays fed from IREG @1 and assumed_state write coils to avoid ESPHome duplicate FC01 polls and ~2s UI lag on multi-device buses.
    [default_dio_430_r1_plc.yaml]
2026-07-05 refactor(DIO WebConfig): drop All off action; Off+All target model with hidden target on None
    Remove duplicate All off from action dropdown (legacy action 4 still loads as Off+All). Hide target select when action is None for inputs and buttons.
2026-07-05 fix(DIO v0.2.0): count triple-click events in finalizeClickGaps
    Triple clicks were misclassified as double because pendingClicks>=2 only emitted EVT_DOUBLE; add EVT_TRIPLE branch for pendingClicks>=3.
    [default_DIO_430_R1.ino]
2026-07-06 fix(DIO v0.2.0): detect long press and increment EVT_LONG without local long action
    Long-press timer and gesture counter now fire even when Long action is None (HA scenes). Local long action still applies only when configured; release after long no longer counts as a click.
    [default_DIO_430_R1.ino]
2026-07-06 docs(DIO README): drop all off from button action list in features table
    All off remains documented as Modbus coil / HA command; not a Short/Long action in WebConfig.
2026-07-06 fix(ENM v0.2.0): buttons, debounce, split persist, chip P/Q/S, holding regs.
    Sync relay coils after button press; add 25ms button debounce; split settings (/enm_cfg.bin, FW-tied) from meter cal+counters (/enm_meter.bin); read signed P/Q/S from ATM90E32; fix relay.inverted in WebConfig; apply writable holding registers from Modbus.
    [atm90e32.cpp, atm90e32.h, default_enm_223_r1.ino]
2026-07-06 fix(ENM v0.2.0): restore WebConfig data display on connect.
    Send ext.meter in bootstrap, always push status, use local SimpleWebSerial, and align relay invert keys with hm-webconfig.js.
    [default_enm_223_r1.ino]
2026-07-06 feat(ENM v0.2.0): implement alarm engine, chip diag, and relay alarm mode.
    Wire ATM90E32 readDiag events and hysteresis thresholds to Modbus alarm bits, WebConfig UI, ACK coils, and alarm-controlled load shedding relays.
2026-07-06 feat(ENM v0.2.0): add phase mapping and 3P4W/3P3W wiring mode.
    Expose wire scheme and per-channel phase assignment in WebConfig, persist in settings v0x0022, and apply ChannelMap/MMode0 during ATM90E32 init.
2026-07-06 fix(ENM v0.2.0): reorder globals for Arduino auto-prototype generation.
    Move DebounceState, alarm enums, energy counters, and meter_job before first use so the IDE-inserted prototypes compile.
    [default_enm_223_r1.ino]
2026-07-06 fix(ENM v0.2.0): point portal to v0.2 WebConfig and improve ext telemetry.
    Make v0.2.0 the default ENM configurator link, always send ext with cached meter, and fix appendLog call in ConfigToolPage.
    [default_enm_223_r1.ino]
2026-07-06 fix(ENM v0.2.0 WebConfig): parse firmware JSON object-arrays for live data.
    Arduino JSONVar serializes E_phase and Urms as keyed objects; use HMWebConfig.toArray and numeric coercion so meter and energy fields render.
2026-07-06 fix(ENM v0.2.0): WebConfig telemetry without USB-CDC DTR.
    Latch webHostConnected on WebSerial RX (hello/config), send ext/io/AlarmsState periodically when host is active using availableForWrite only.
    [default_enm_223_r1.ino]
2026-07-06 fix(ENM v0.2.0): push WebConfig telemetry without host-RX gate.
    Send status/ext/io every second when the USB write buffer is ready (DIO-style), and repeat bootstrap every 4s so passive browsers receive cfg.
    [default_enm_223_r1.ino]
2026-07-06 fix(ENM v0.2.0): send WebConfig telemetry without USB buffer gate.
    Match v0.1.0: WebSerial.send runs unconditionally each second; webSerialWriteReady blocked all output on Web Serial hosts.
    [default_enm_223_r1.ino]
2026-07-06 fix(ENM v0.2.0): split WebSerial telemetry like v0.1.0
    Avoid oversized USB frames by sending energy and meter in separate ext
    events, dropping duplicate counters from cfg/meter, yielding after each
    send, and using lighter 4s periodic push without full bootstrap.
    [default_enm_223_r1.ino]
2026-07-06 fix(ENM v0.2.0): restore ENM_Meter telemetry path for WebConfig
    Status/io use small WebSerial frames; meter data was sent only via ext/ENM_Sync
    which the page did not handle like v0.1.0. Send ENM_Meter at 1 Hz with
    embedded energies, add page handlers, and keep status/io on a light rotator.
    [default_enm_223_r1.ino]
2026-07-06 feat(ENM v0.2.0): add Modbus linkOk flags and service coils
    Track last valid Modbus activity (DIO-style) to expose linkOk via WebConfig
    and a new STATUS_FLAGS input register. Add IDENTIFY/SAVE_CFG/REBOOT service
    coils and expose them in the ESPHome package. WebConfig header now uses a
    local module image path.
    [default_enm_223_r1.ino, default_enm_223_r1_plc.yaml]
2026-07-06 docs(OpenthermGateway): remove wide-DC power input references
    OTG supports only 24 V DC or 85-265 V AC; update README, product page,
    and ESPHome device index accordingly.
2026-07-06 docs(MiniPLC): remove wide-DC power input references
    MiniPLC supports only 24 V DC and 85–265 V AC; drop 120–370 V DC from docs.
2026-07-06 docs(MiniPLC): remove unused wide-DC wiring diagram image
    Delete wiring_ps_ac2.png after removing 120–370 V DC references from docs.
2026-07-07 fix(webconfig portal): mark ALM and ENM v0.1.0 as current firmware
    Point Open configurator at v0.1.0 WebConfig and label v0.2.0 as beta on the portal index, matching AIO/DIM/RGB/WLD.
2026-07-07 feat(ENM v0.2.0): unify WebSerial ext payload and expose chip PQ events
    Consolidate meter, energy, and alarm telemetry into a single ext frame to stay within the WebSerial handler limit; publish ATM90E36 chip event masks on Modbus IR 101–104 with matching ESPHome binary_sensor entities.
2026-07-07 fix(ENM WebConfig): align appbar with shared hm-webconfig.css like DIO
    Load shared CSS/JS at page top, drop local pill override that broke appbar styling, and match DIO header and Device Setup markup.
2026-07-07 fix(ENM v0.2.0): restore ENM_Meter/ENM_Sync WebSerial frames
    The unified ext payload was not reaching WebConfig reliably; split meter and energy back into separate frames (alarms stay in ext) and init the meter UI before connecting.
    [default_enm_223_r1.ino]
2026-07-07 fix(ENM v0.2.0): restore CalibCfg frame for phase calibration UI
    Calibration lived only inside the large cfg blob which often failed over USB; send a separate CalibCfg echo like v0.1.0 and apply it on WebConfig connect.
    [default_enm_223_r1.ino]
2026-07-07 fix(ENM v0.2.0): push calibration via ext.atm.cal every second
    Repeat cal in the lightweight ext frame and apply it on WebConfig so calibration fields populate even when the full cfg blob is dropped on USB.
    [default_enm_223_r1.ino]
2026-07-07 fix(ENM v0.2.0): restore cal in ENM_Sync like v0.1.0
    v0.2.0 dropped cal from ENM_Sync and the page only applied energies from that frame; put calibration back in the sync payload and parse it on WebConfig.
    [default_enm_223_r1.ino]
2026-07-07 fix(ENM v0.2.0): deliver calibration on slim cal/ENM_Sync frames
    Drop cal from the oversized cfg blob, publish slim phase arrays on cal/CalibCfg/ENM_Sync/ext, queue UI apply until inputs exist, and log first RX per channel in Serial Log.
    [default_enm_223_r1.ino]
2026-07-07 fix(webconfig): contain Serial Log overflow from long RX lines
    Clamp log line length, wrap long JSON in the log panel, and prevent grid columns from expanding past the card layout.
2026-07-07 fix(ENM v0.2.0): restore active-high button GPIO like v0.1.0
    INPUT_PULLUP + LOW=pressed made all buttons appear pressed on the field board.
    [default_enm_223_r1.ino]
2026-07-07 feat(ENM v0.2.0): add energy counter reset via WebConfig and Modbus
    Coil 8 and command reset_energy drain ATM90 pulse regs, zero flash counters,
    and push updated ENM_Sync to the UI.
    [default_enm_223_r1.ino, default_enm_223_r1_plc.yaml]
2026-07-07 feat(ENM v0.2.0): show ATM90 chip events in WebConfig via ext.chipEv
    Publish g_chipEvMask in the existing ext frame and render L1/L2/L3/Total
    PQ fault indicators next to Peaks & Quality.
2026-07-07 fix(ATM90E32): init OV/phase-loss/overcurrent/neutral thresholds and scale UPeak
    Write OVth/PhaseLossTh/INWarnTh/OIth during begin() so PQ detectors can trigger.
    Convert UPeak register to volts peak using ucal-derived threshold domain.
    [atm90e32.cpp]
2026-07-07 fix(ENM/ATM90): latch chip events, correct thresholds, and reset peak capture
    - Decode chip events from EMMState OR interrupt-latched EMMIntState and keep
    masks latched ~5s so WebConfig/Modbus reliably see short PQ faults.
    - Update sag/OV/phase-loss threshold formula to the M90 appnote form using Ugain.
    - Periodically reset peak capture registers so U/I peaks reflect recent window.
    [atm90e32.cpp, atm90e32.h, default_enm_223_r1.ino]
2026-07-07 fix(ENM): ensure ext.chipEv serializes non-null
    Build ext.atm/alarms/chipEv via local JSONVar values to avoid null serialization
    in Arduino_JSON and keep WebConfig chip events rendering.
    [default_enm_223_r1.ino]
2026-07-07 fix(ATM90): correct sag/ov threshold factors; stop showing fake peak units
    - Apply Atmel-46103 threshold formula with k=0.78 (sag) and k=1.22 (OV).
    - Set OIth/INWarnTh in Irms code domain (FS-relative).
    - Remove U/I peak display from WebConfig instead of inventing voltage/current scaling.
    [atm90e32.cpp]
2026-07-07 fix(ATM90E32): lower energy start thresholds for small loads
    Reduce P/Q/SStartTh and phase no-load thresholds per Atmel-46103
    (Reg = P/0.00032) so ~18 W on 50 A CT can accumulate energy.
    [atm90e32.cpp]
2026-07-07 chore(RGB v0.2.0): remove stray ENM sources from sketch src/
    Delete unused atm90e32 and enm_modbus files that Arduino auto-compiles
    from src/ but the RGB sketch never includes.
2026-07-07 feat(RGB v0.2.0): linkOk, STATUS_FLAGS, service coils, CFG_VERSION bind
    Align RGB WebConfig and Modbus with DIO: relative header image, firmware-tied
    config version, bus link detector, STATUS_FLAGS IR, and IDENTIFY/SAVE/REBOOT coils.
    [default_rgb_621_r1.ino, default_rgb_621_r1_plc.yaml]
2026-07-07 fix(RGB v0.2.0): forward-declare PersistConfig for Arduino IDE build
    Arduino auto-prototypes precede struct definitions; add PersistConfig and
    OutputStateSnapshot forward declarations like DIO v0.2.0.
    [default_rgb_621_r1.ino]
2026-07-07 fix(RGB yaml): parameterize PWM entity names and ids per module
    Use ${rgb_prefix} and ${rgb_id}_* for number/output/light entities so
    multiple RGB-621 instances do not collide in ESPHome.
    [default_rgb_621_r1_plc.yaml]
2026-07-07 Merge v0.1.0 full ESPHome package into RGB v0.2.0 with firmware-aligned map.
    Adds STATUS_FLAGS, service coils/buttons, DI2/relay/LED discrete inputs, and keeps PWM/rgbww light from v0.1.0 with parameterized names.
2026-07-07 Fix RGB ESPHome duplicate Modbus polls on HR 400-404.
    Remove redundant PWM number entities; rgbww light outputs already read/write the same holding registers.
    [default_rgb_621_r1_plc.yaml]
2026-07-07 Optimize RGB ESPHome package to reduce Modbus bus load.
    Disable HR 400-404 poll on PWM outputs (skip_updates), use write-only relay coils with template pulse buttons, and slow poll interval to 5s with 50ms throttle like ENM.
    [default_rgb_621_r1_plc.yaml]
2026-07-07 RGB v0.2.0: FC04 state masks (MAP_VERSION 2) and bus-optimized ESPHome.
    Firmware exposes DI/relay/LED masks in IREG 0..3; YAML polls one FC04 block 0..4 instead of sparse FC02 reads.
2026-07-07 RGB ESPHome: fail fast and skip offline slave to protect shared bus.
    Add offline_skip_updates, max_cmd_retries, and MAP_VERSION diagnostic sensor for troubleshooting missing MAP v2 firmware.
    [default_rgb_621_r1_plc.yaml]
2026-07-07 RGB v0.2.0: fix button mapping — one SW2 input, active-high.
    Drop unused SW1/GPIO0 from runtime; WebConfig shows a single Button 1 tied to hardware SW2.
    [default_rgb_621_r1.ino]
2026-07-07 RGB v0.2.1-dev: local input engine, 12-bit gamma+slew, WebConfig HR500+.
    Adds configurable wall-switch gestures with hold-to-dim, press counters,
    relay FOLLOW, and a new Modbus config block without moving legacy registers.
    PWM output upgrades to 12-bit with gamma LUT and non-blocking slew so Modbus
    and gesture setpoint changes ramp smoothly.
2026-07-07 Fix RGB compile errors in pwm header and web status.
    Define PwmChCfg in hm_pwm_output.h, fix PWM_PINS linkage, volatile
    lastOutChangeMs, hmFinalizeClickGaps args, and sendWebStatus brace.
    [default_rgb_621_r1.ino, hm_pwm_output.h]
2026-07-07 Revert RGB firmware and WebConfig version strings to 0.2.0.
    Keep v0.2.0 folder naming; HM_FW_PATCH=0 so UI and module report match.
    [default_rgb_621_r1.ino, default_rgb_621_r1_plc.yaml]
2026-07-07 RGB-621-R1 v0.2.0: fix local input engine and simplify WebConfig.
    Momentary/Maintained modes, reliable single-click and hold-to-dim, trimmed gesture targets/actions, Scene 1-4, fixed group membership, and a unified Dimming block without mask registers.
    [default_rgb_621_r1.ino, hm_input_engine.h, hm_pwm_output.h]
2026-07-07 RGB-621-R1 v0.2.0: smooth hold-dim and trim gesture actions.
    Continuous ramp-while-held dimming, trimmed action/target UI with dynamic visibility, two-button vs single-button dim scheme, and removal of Set 100%.
2026-07-07 RGB-621-R1 v0.2.0: STATE readback for HA feedback with minimal bus load.
    Expose applied PWM levels and relay flags via FC04 IREG 26–28, and drive the ESPHome light/relay state from one contiguous 5s poll instead of skipping PWM readback entirely.
    [default_rgb_621_r1.ino, default_rgb_621_r1_plc.yaml]
2026-07-07 RGB-621-R1 v0.2.0: fix hold-to-dim edges and remove Long gesture.
    Consume debounce edges after each input pass so hold ramps start reliably, drop the Long gesture (Identify moves to SW2 double), and flip dim-toggle direction only when a hold actually begins.
    [default_rgb_621_r1.ino, default_rgb_621_r1_plc.yaml, hm_input_engine.h]
2026-07-07 RGB-621-R1 v0.2.0: simplify SW2 onboard button to single+double only.
    Give SW2 a dedicated WebConfig card and firmware path with momentary single/double gestures only, defaulting to Toggle All and Identify.
2026-07-08 RGB-621-R1 v0.2.0: maintTarget field and per-input hold dimming only.
    Add a dedicated maintained-mode target with full positional WebConfig sync, and remove the global dim button scheme so hold direction and target come only from each input's Hold gesture.
2026-07-08 RGB-621-R1 v0.2.0: fix scene capture reading pwm slider IDs.
    Use pwm-r through pwm-cw element IDs when capturing current light levels so scene fields are not filled with zeros.
2026-07-08 RGB-621-R1 v0.2.0: fix HA light sync from STATE readback.
    Drive the rgbww light via instant turn_on/turn_off calls from STATE IREG 28 instead of forcing remote_values, with change gating to avoid feedback fights.
    [default_rgb_621_r1_plc.yaml]
2026-07-08 RGB-621-R1 v0.2.0: fix Modbus reset on color updates and improve relay Follow UI.
    Stop handleValues from rewriting mb_address on rgb/cct-only WebConfig messages; make relay Follow settings human-readable with mode-aware visibility.
    [default_rgb_621_r1.ino]
2026-07-08 RGB-621-R1 v0.2.0: fix PWM slew jumps and HA color stepping on Modbus.
    Keep slewLastMs fresh for idle channels and on new targets; set ESPHome light default_transition_length to 0s so the module handles smooth fades locally.
    [default_rgb_621_r1.ino, default_rgb_621_r1_plc.yaml, hm_pwm_output.h]
2026-07-08 RGB-621-R1 v0.2.0: relay STATE feedback in HA and hide service buttons.
    Set Relay 1 template switch to non-optimistic STATE readback; mark Reboot and Save config internal while keeping Identify visible.
    [default_rgb_621_r1_plc.yaml]
2026-07-08 RGB-621-R1 v0.2.0: decouple HA light readback from Modbus writes.
    Sync STATE to HA via publish-only remote_values with stability, HA-command gating, and channel tolerance so wall/local changes never fight HR commands.
    [default_rgb_621_r1_plc.yaml]
2026-07-08 RGB-621-R1 v0.2.0: fix STATE publish_state holders wiped by lambdas.
    Remove hardcoded template lambdas on act_* and relay readback holders so STATE@28 publish_state values persist for HA relay and color feedback.
    [default_rgb_621_r1_plc.yaml]
2026-07-08 RGB-621-R1 v0.2.0: consolidate HA feedback as publish-only readback.
    Unconditional relay/act STATE publish, lambda-free holders, remote_values light sync with HA-command gate — no HR write-back fights.
2026-07-08 RGB-621-R1 v0.2.0: fix HA gate poisoned by feedback publish_state.
    Ignore readback echo in light on_state via fb_publishing so wall scenes sync to HA while HA commands stay gated.
    [default_rgb_621_r1_plc.yaml]
2026-07-08 RGB-621-R1 docs: set v0.2.0 as current, remove v0.1.0 from links
2026-07-08 Promote RGB-621-R1 to v0.2.0 on config portal index.
    Update the module card and JSON mirror so v0.2.0 is current and v0.1.0 is legacy, matching DIO-430-R1.
2026-07-08 docs: correct ISO1212 DI and 3 A relay module ratings across modules
    Remove false galvanic-isolation claims on ISO1212 inputs; align relay
    module limits to 3 A in README/productpage. Publish missing local
    firmware binaries (ENM/RGB UF2, DIO v0.3.0 bin).
2026-07-08 docs: replace Installation & Wiring template stubs in four module READMEs
    Replace leftover README_TEMPLATE placeholders with device-specific wiring
    prose and embedded diagrams for RGB, ENM, STR, and WLD.
2026-07-08 docs(RGB): fix Section 5 numbering and Getting Started walkthrough
    Rename misplaced 4.3 Communication to 5.3 and replace the author stub
    with a seven-step beginner install guide linking wiring and ESPHome.
2026-07-08 docs(RGB): rewrite Use Cases for v0.2.0 on-module features
    Replace legacy five-case stub with three scenarios covering wall-switch
    hold-to-dim/scenes, relay FOLLOW power-cut, and HA live state readback.
2026-07-08 docs: clarify RS-485 termination is external at both bus ends
    Remove false onboard/selectable 120 Ω terminator claims from RGB, STR,
    and DIM READMEs and product pages; state installer-fitted termination.
2026-07-08 docs(RGB): move BOOT mode procedure out of hardware notes
    Keep hardware notes to two revision quirks only; document entering BOOT
    mode once in §8.2 and cross-reference from §9.2 and button notes.
2026-07-08 docs(RGB): correct LED current, PSU, and status LED specs
    Align README with hardware: 10 A PTC LED-rail limit, separate 12/24 V
    LED PSU vs 24 V module supply, real front-panel LEDs, no RUN/ERR.
2026-07-08 docs(RGB): simplify WebConfig reqs and split firmware section
    Require Web Serial API only (no browser lists), use hosted WebConfig
    URL, and restructure §8 into UF2 user updates vs developer build track.
2026-07-08 docs(RGB): fix supply voltage, LEDs, relay path, and COM labels
    Align module input to 24 V DC ±10 % only, document real LED1/LED2 + DI status
    indicators, correct the LED anode path (not through relay), and disambiguate
    COM (LED+), Relay C/NO, and RS-485 COM throughout the README.
2026-07-08 docs(RGB): deduplicate I/O overview and wiring sections
    Point §2.2/§2.3 at §1.2 for subsystem detail and keep counts only;
    make §5.4 a diagram-first wiring map with theory in §5.2/§5.3.
2026-07-08 docs(RGB): consolidate power, safety, registers, and navigation
    Add TOC and a single §5 IMPORTANT — POWER block; split §4.2 safety from
    §5.4 wiring; add §6.0 register map; scope mains to relay C/NO; allow USB
    anytime; trim §2.8 to cross-links.
2026-07-09 docs(RGB): document all eight front-panel status LEDs in §9.1
    Align §1.2/§2.3 LED counts with the full PWR/TX/RX/I/O/user list, add I.1/I.2 swap warning, and restore TX/RX troubleshooting phrasing.
2026-07-09 docs: align ISO1212 inputs as module-wetted dry-contact across modules
    Remove sourcing-sensor claims from README and productpage specs, wiring prose, and troubleshooting for all ISO1212 digital-input modules.
2026-07-09 docs(RGB): fix §6 Modbus table rendering after blockquote summaries
    Insert blank lines before table headers so Markdown parsers no longer treat them as blockquote continuations.
2026-07-09 docs(RGB): clarify WebConfig auto-save in Getting Started
    Replace manual save-to-flash wording with automatic persistence and frame baud as a controller match check with factory default 19200.
2026-07-09 docs(RGB): align Modbus map with v0.2.0 firmware behaviour
    Document level-controlled relay coil 0, pulse-coil semantics, 1–247 address clamping, PWM dual-bank scaling, STATUS_FLAGS bits, and per-address event counters.
2026-07-13 docs(STR,WLD): align README and datasheets with FieldBoard schematics
    STR-3221-R1 (SRT-3221-R1-FieldBoard.pdf p.1, MCUBoard U9–U12): correct
    SENS.A/B to +5 V via F9/F10 1206L150THWR (150 mA); IN1/IN2 to SFH6156
    U17/U18; DI to ISO1212 on Gnd/24Vdc (8–9); outputs to AO4882; TLC59208F
    on MCU board; unify 3-input count in README, datasheet, and DoC.
    WLD-521-R1 (FieldBoard/RelayBoard): fix datasheet relay count to 2× SPDT;
    clarify Ix–GND_ISO DI wiring and terminal-9 vs +5V_ISO hazard in README
    and datasheet.
2026-07-13 docs(PLC,OT): add USB Serial Driver & Port Access guidance
    Document CP2102N bridge setup on Windows, macOS, and Linux (dialout,
    CP210x VCP extension paths), plus Web Bluetooth limitations. Fix incorrect
    “auto on macOS/Linux” troubleshooting text in MiniPLC and OpenthermGateway.
2026-07-13 docs(OpenthermGateway): move USB driver section after Fallback AP Notes
    Place USB Serial Driver & Port Access after the Fallback Access Point Notes
    list so Steps and Notes stay together under First Boot & Wi-Fi Setup.
2026-07-15 feat(ENM-223-R1): expose ATM90E32AS harmonic power and peak on Modbus map v2
    Add IR 105-119 from ATM PmeanTF/AF/BF/CF and PmeanTH/AH/BH/CH (D0-D7+E0-E7),
    IR 121-127 from APenergyTH/AH/BH/CH (A8-AB, MCU-accumulated R/C). Apply datasheet
    IPeak scaling on 0xF5-F7; keep computed active-power THD at IR 47-49. Bump
    CFG_VERSION to 0x0023 and METER_VERSION to 0x0002. Update WebConfig, ESPHome,
    README, and Modbus_Table.md.
2026-07-15 docs(STR-3221-R1): update SRT-3221-R1 FieldBoard schematic PDF
2026-07-15 docs(RGB-621-R1): align LED current limits in README and product page
    State canonical operating limits (≤ 1 A/ch, ≤ 5 A total short-term) and
    clarify that the onboard 10 A PTC fuse is protection only, not a rating.
2026-07-15 docs(RGB-621-R1): fix remaining 10 A PTC operating-limit wording in README
    Clarify LED-rail operating limits (≤ 1 A/ch, ≤ 5 A total) in IMPORTANT —
    POWER, §5.2 power path, and troubleshooting; 10 A PTC is protection only.
2026-07-15 docs(RGB-621-R1): remove LED-rail fuse rating from README and product page
    Drop 10 A PTC wording on the LED path; document only operating limits
    (≤ 1 A/ch, ≤ 5 A total) and generic internal fusing (protection only).
2026-07-15 build(ENM-223-R1): publish v0.2.0 UF2 with harmonic power Modbus map v2
    Release binary for fundamental/harmonic power (IR 105-119), harmonic energy
    (IR 121-127), and datasheet IPeak scaling (0xF5-F7).
2026-07-15 docs(RGB-621-R1): fix Modbus default address and document PWM frequency
    Product page: address 1-247 (default 3), ESPHome example rgb_address 3.
    README and product page: ≈1 kHz fixed PWM on all five channels.
2026-07-16 fix: point WebConfig links at config.home-master.eu; rename STR schematics; standardise controller Schematic→Schematics dirs; drop README_TEMPLATE (now private)
2026-07-16 chore: remove site content and internal tooling from the public repository
    Article copy, product pages and their stylesheet are ours to publish, not part
    of the open hardware. Document generators and the dead Odoo/n8n WebConfig
    manifest are internal tooling. All of it now lives in the private workspace.
    Firmware, schematics, WebConfig pages and READMEs are unaffected.
2026-07-16 fix: put released UF2 at Firmware/<ver>/<MODULE>.uf2; drop dead download links
    The released firmware sat inside build/, a path .gitignore itself ignores —
    which is why AIO, DIM, STR and WLD have no UF2 at all and index.html offered a
    download button that 404s.
2026-07-16 fix(ALM): the relay is 16 A, not 12 A
    HF115F/005-1ZS3 is marked 16 A on the part. This README said 12 A — a figure
    nobody could source, copied between four modules.
    The module rating of 3 A is unchanged and correct: it is set by the PCB traces
    and terminals. The margin is now stated as the feature it is — at 3 A the
    contacts work far below their rating, so arcing stays low and they do not burn.
    See knowledge/failures/0002-relay-rating-12a-vs-16a.md in the private workspace.
2026-07-17 fix: the relay is 16 A, not 12 A
    HF115F/005-1ZS3 is marked 16 A on the part. Three more READMEs said 12 A — a
    figure nobody could source, copied from one module to the next. ALM was fixed
    separately.
    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
2026-07-17 fix(ALM): the optocoupler isolation is 5300 VRMS, not 3.75 kVrms
    The part is SFH6156-3T. 3750 does not appear in its datasheet at all — the
    isolation test voltage is 5300 VRMS. 3.75 kVrms is a common figure for four-pin
    DIP optocouplers and was carried over from something else, stated in five places
    and never checked.
    The error was conservative — the module was claimed to isolate less than it
    does. Corrected anyway, because a figure nobody can source reads exactly like
    one that was verified.
    Adds one note distinguishing the test voltage from the working voltage
    (VIORM = 890 V), and saying why neither matters at 5 V DC dry-contact
    signalling.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
2026-07-17 release(ALM): ship v0.2.0
    index.html now names v0.2.0 current; v0.1.0 is legacy. The hub open button
    and badges follow. The UF2 download was already on v0.2.0.
    Documents already described MAP v4 / firmware 0.2.0 — they catch up with the
    release notice, not the other way round. Also commits the v0.1.0 binary at
    the canonical path (legacy stays flashable) and fixes one ../../README link.
2026-07-17 fix(ENM): README named beta v0.2.0 as the shipping firmware
    ENM ships v0.1.0. The README pointed WebConfig and the ESPHome package at
    v0.2.0 — four STD-005 hits — and called v0.2.0 the current line.
    v0.1.0 is current; v0.2.0 is beta (historical in the version table). Also
    keeps the earlier DoC filename and ../../README link fixes already in this
    working tree.
2026-07-17 fix: Modbus address is 1–247, not 1–255 (STD-001)
    WebConfig dropdowns offered 248–255; six v0.1.0 sketches clamped there;
    WLD and ENM docs repeated it. 248–255 are reserved by the Modbus spec.
    Dropdowns and clamps now stop at 247. v0.1.0 keeps constrain(addr, 1, 247)
    — hmValidAddress() lives in hm_common.h on v0.2.0 only.
    [default_DIM_420_R1.ino, default_DIO_430_R1.ino, default_aio_422_r1.ino, default_alm_173_r1.ino, default_rgb_621_r1.ino, default_wld-521-r1.ino]
2026-07-17 Revert "fix: Modbus address is 1–247, not 1–255 (STD-001)"
    This reverts commit d188c694cbbcb13b6d6e227678fbbfea330205b7.
    [default_DIM_420_R1.ino, default_DIO_430_R1.ino, default_aio_422_r1.ino, default_alm_173_r1.ino, default_rgb_621_r1.ino, default_wld-521-r1.ino]
2026-07-17 fix: STD-001 docs/UI to 1–247; STD-004 dead links
    WebConfig dropdowns no longer offer 248–255. READMEs, readme.html and
    product-facing HTML state 1–247. ConfigToolPage is a document — Rule 9.
    Firmware source is untouched. Six v0.1.0 sketches still constrain(addr, 1, 255);
    that is a recorded defect for the next firmware line, not a source edit.
    Also lands the pending link fixes: ../../README.md → ../README.md, and
    ../../releases → config.home-master.eu / Firmware/.
2026-07-17 fix(ALM): prefix ESPHome coil IDs with alm_id for multi-instance
    Hardcoded alm_ack_* / alm_pulse_* collided when two ALM packages were
    included — the same bug DIO and RGB already fixed with ${module_id}_*.
    Relays were already prefixed; momentary coils and their template buttons
    were not. v0.2.0 package only.
    [default_alm_173_r1_plc.yaml]
2026-07-17 fix(ENM v0.2.0): decouple energy poll from LittleFS meter writes
    Keep 5 s ATM read-to-clear polling; persist enm_meter.bin at most every
    5 min when counter CRC changes, and always save meter before reboot.
    [default_enm_223_r1.ino]
2026-07-17 fix(ENM v0.2.0): parse alarm min/max as floats before scaling
    jvGetInt truncated 49.5 Hz / 1.5 A before alarmDoubleToRule; WebConfig
    now sends Number() engineering values and the device uses jvGetDouble.
    [default_enm_223_r1.ino]
2026-07-17 fix(ENM v0.2.0): apply gain/offset without ATM soft-reset
    Queue cal-only applyCalibration for Ugain/Igain/offsets; full begin()
    only for lineHz/wireMode/sumAbs/phaseMap/ucal, after draining energy ticks.
    [atm90e32.cpp, default_enm_223_r1.ino]
2026-07-17 fix(ENM v0.2.0): keep energy when settings blob is corrupt
    Load enm_cfg.bin and enm_meter.bin independently; settings failure
    applies IO/Modbus defaults without clearEnergyCounters.
    [default_enm_223_r1.ino]
2026-07-17 fix(ENM v0.2.0): mark Modbus settings dirty only on real change
    applyModbusSettings no longer dirties enm_cfg.bin / IR100 on every
    boot; only when address or baud actually change after UART init.
    [default_enm_223_r1.ino]
2026-07-17 fix(ENM v0.2.0): alarm zero thresholds, relay hasOwn, ack tidy
    CFG_VERSION 0x0024 uses INT32 sentinels for unset limits so 0 is valid;
    relay Config only touches present fields; drop unused hmUsbCanSend.
    [default_enm_223_r1.ino, hm_common.h]
2026-07-17 fix(ENM v0.2.0): WebConfig dead controls and baud fallback
    Remove unused Sample Interval / Relay Toggle, drop unsubstituted
    HM_WEBCONFIG_BASE marker, and fix hm-webconfig baud→baudRate fallback.
2026-07-17 docs(ENM): fix harmonic energy register order in Modbus_Table
    Addresses 121/123/125/127 are A/B/C/Total (AH/BH/CH/TH), matching
    firmware and Example Reads — not T/A/B/C.
2026-07-17 fix(ENM v0.2.0): compile fix + rebuild UF2 matching sources
    Forward-declare meterEnergyCrc before service coils; ship rebuilt
    ENM-223-R1.uf2 from the same sketch.yaml profile.
    [default_enm_223_r1.ino]
2026-07-17 fix(ALM v0.2.0): STD-001 comment — Modbus address 1..247
    Comment on handleValues matched the old 1..255 wording; code already
    uses hmValidAddress (1..247). Comment-only, no UF2 rebuild.
    [default_alm_173_r1.ino]
2026-07-17 fix(ENM-223-R1 v0.2.0 WebConfig): calibration fields ignored edit-lock (live refresh overwrote input)
    applyCalibCh treated fromDevice as a lock bypass; live frames every ~1s
    restored Ugain/Igain/offsets while editing. Honor canApply like alarms.
2026-07-17 fix(ENM-223-R1 v0.2.0 WebConfig): lock calibration fields on focus
    Cal inputs used lockOnFocus=false, so live frames overwrote values after
    focus and before the first input event. Match alarm fields: lock on focus,
    and skip apply while the field is document.activeElement.
2026-07-17 fix(ENM-223-R1 v0.2.0 WebConfig): calibration fields ignored edit-lock (live refresh overwrote input) (#5)
    Stop fromDevice from bypassing canApply; lock cal inputs on focus like
    alarms so config.home-master.eu live frames cannot overwrite edits.
2026-07-18 feat(ENM-223-R1 v0.2.0): configurable CT ratio + PGA tuning, 0.01 A current regs
    CFG 0x0025 adds ctPrimary/ctSecondary/pgaGain; scale I/P/Q/S/energy by N;
    Modbus Irms/Ipeak/IrmsN ×0.01 A; WebConfig Meter Options; rebuild UF2.
2026-07-18 fix(ENM-223-R1 v0.2.0): CT settings round-trip to module
    WebSerial JSONVar hasOwnProperty missed ctPrimary/ctSecondary, and live refresh overwrote the CT fields before change fired. Parse via jvHasKey, echo CT in ENM_Sync/cfg/ext, lock CT inputs, rebuild UF2.
    [default_enm_223_r1.ino]
2026-07-18 fix(ENM-223-R1 v0.2.0): energy counters via flat int arrays
    Nested E_phase doubles became null over WebSerial; Number(null) showed 0.000, then -- after asNum hardened. Send E_ap_Wh… as P_W-style int arrays and read those in WebConfig.
    [default_enm_223_r1.ino]
2026-07-18 fix(ENM-223-R1 v0.2.0): stop energy SPI 0xFFFF from poisoning counters
    Discard all-0xFFFF energy samples, do not accumulate into software totals around SoftReset, and treat CT secondary 0 as unset (50 mA) so N cannot become 100 → 20.480 kWh on every channel.
    [default_enm_223_r1.ino]
2026-07-18 fix(ENM-223-R1 v0.2.0): restore energy accumulation at high CT ratio
    Wrong PLconstL and a high PStartTh blocked CF ticks when N≈1000; also
    sample before SoftReset again and log ENERGY rawAP for field diagnosis.
    [atm90e32.cpp, default_enm_223_r1.ino]
2026-07-18 fix(ENM-223-R1 v0.2.0): LastSPIData energy reads + ship real UF2
    PR #11 source was right but the committed UF2 was a stale binary (still
    had E_phase, no ENERGY heartbeat). Rebuild the release UF2, validate
    read-clear energy regs via LastSPIData per Atmel-46103, and always log
    ENERGY (including discard).
    [atm90e32.cpp, atm90e32.h, default_enm_223_r1.ino]
2026-07-18 fix(ENM-223-R1 v0.2.0): make ATM90 energy accumulators run
    LastSPIData recovery was replacing valid energy reads with a 0 echo
    (read-clear ticks lost). Enter Normal mode via Idle before SoftReset,
    force MeterEn after cal, clear startup thresholds, and log chip
    config readback with ENERGY.
    [atm90e32.cpp, default_enm_223_r1.ino]
2026-07-18 feat(WebConfig): Copy log button for Serial Log
    Ship clipboard copy of the in-page log buffer so field dumps can be
    pasted without selecting the log box by hand.
2026-07-18 fix(ENM-223-R1 v0.2.0): restore ATM Normal mode without Idle bounce
    Bouncing PM through Idle before SoftReset triggered VDD18 POR and left
    field boards with Freq=0 and dead U/I. Keep PM=Normal, MeterEn re-assert,
    safe LastSPIData, and low startup thresholds.
    [atm90e32.cpp]
2026-07-18 ui(ENM-223-R1 WebConfig): fold advanced meter options behind details
    Keep Line Frequency, wiring, and CT ratio visible; move sum mode, phase map, PGA, and calibration into a closed native details block with no JS state.
2026-07-18 fix(ENM-223-R1 v0.2.0): alarm Enabled JSON true and Event LED scope
    parseKeyFromBlob treated JSON true as 0 via toInt, so WebConfig never armed rules; stop ORing chip PQ into the Alarm Event LED (Chip Events stays separate).
    [default_enm_223_r1.ino]
2026-07-18 fix(ENM-223-R1 v0.2.1): peak sign, ChannelMap, CT energy reset, WebConfig audit
    Signed peaks, ChannelMap nibble packing, INWarnTh mA default, CT-change energy reset, linkOk from bus RX only, reboot flushes dirty settings, alarm metric scale clear, and WebConfig gating/validation/lock blur.
    [atm90e32.cpp, atm90e32.h, default_enm_223_r1.ino]
2026-07-18 revert(ENM-223-R1): FW/WebConfig back to 0.2.0 + complete AlarmsAck compat gate
    Keep PR #17 functional fixes; restore identity 0.2.0 and ensure both AlarmsAck paths early-return when compat is blocked.
    [default_enm_223_r1.ino]
2026-07-18 fix(ENM-223-R1): accumulate energy in primary Wh, decoupled from CT
    Store incremental primary-domain Wh on flash (meter blob v3); CT/N scales only new deltas. Reset only via explicit command/coil/factory.
    [default_enm_223_r1.ino]
2026-07-18 fix(ENM-223-R1 v0.2.0): alarm config never applied (hasOwnProperty) + round-trip
    WebSerial JSONVar.hasOwnProperty("ch") silently skipped alarmApplyFromJson, so
    thresholds/enabled never reached RAM/flash while the log still said updated.
    Parse via jvHasKey, accept flat {ch,ack,rules}, prefer minRaw/maxRaw and decimal
    strings (nested floats go null), echo rules[] for WebConfig, send on change/blur.
    [default_enm_223_r1.ino]
2026-07-19 fix(ENM-223-R1 v0.2.0): alarm wire format — flat ints only
    Numeric keys 0/1/2 in the Config list made Arduino_JSON treat the packet as
    an array of rules, so apply silently no-oped; nested cfg.alarm also echoed null.
    Switch WebConfig↔firmware to flat e0/m0/lo0/hi0 writes and alarmEn/Lo/Hi arrays
    (same pattern as energy), with an OK: alarm log line for Serial Log.
    [default_enm_223_r1.ino]
2026-07-19 fix(ENM-223-R1 v0.2.0): Ack required latches alarm until Ack
    Previously Ack only masked while the condition was still true, and the
    indicator cleared as soon as the value/setpoint returned to normal.
    With Ack required, latch on rising edge of active and keep LED/Modbus DI
    until Ack (re-trip needs a new rising edge after clear).
    [default_enm_223_r1.ino]
2026-07-19 fix(ENM-223-R1 v0.2.0): Ack via Config + flat alarm LED bits
    Named AlarmsAck alone was unreliable; WebConfig now sends alarmAck over the
    proven Config channel (and still emits AlarmsAck). LED state is published as
    flat alarmLed[12] so nested nulls no longer leave sticky red dots. Ack while
    still in alarm holds off until the condition clears, then allows re-trip.
    [default_enm_223_r1.ino]
2026-07-19 fix(ENM-223-R1 v0.2.0): audit round-2 + default Modbus address 3
    High/medium from the post-PR15–22 audit: cal fields send on change; ChannelMapU
    uses voltage source codes (0x0654 identity); sag/OV thresholds without stacked
    k-derate; Ack required clears latch when a rule is disabled; meterDirty no
    longer postpones flash save by 5 min; Modbus address/baud selects ignore status
    while focused; blocked Ack shows the compat banner. Also align first-boot
    Modbus address with other modules (30→3), restore PLconstL 0xC468, factory
    re-applies ATM cal, and stop forcing relay coils outside Modbus mode.
    [atm90e32.cpp, default_enm_223_r1.ino]
2026-07-19 fix(ENM-223-R1): clear all chip interrupt-status bits (EMMIntState R/W1C)
    EMMIntState0/1 are write-1-to-clear; writing 0x0001 only cleared bit0, so
    latched sag/OV/OCI bits stuck forever in Chip Events (N-1). Write 0xFFFF in
    clearDiagInterrupts() and begin().
    [atm90e32.cpp]
2026-07-19 refactor(ENM-223-R1): contiguous bit-packed Modbus IR map, drop DI, S32 currents
    Rewrite FC04 as one continuous 0..126 block (digital bitfields first, energy
    last). Remove Discrete Inputs; publish LED/BTN/relay/alarms as IR bit masks.
    Publish Irms/IrmsN/Ipeak as S32 ×0.001 A. Align ESPHome package 1:1. Versions
    unchanged (beta 0.2.0).
2026-07-19 Add weather-compensation heating curve graph (OpenTherm article)
2026-07-19 Add weather-compensated OpenTherm heating article
2026-07-19 fix(config hub): replace invalid Product JSON-LD; add robots/sitemap
    Google Search Console flagged 11 Product snippets without offers/review/
    aggregateRating on config.home-master.eu. This hub is docs/firmware, not a
    store — switch structured data to Organization, WebSite, WebPage ItemList and
    FAQPage (WebConfig browser support). Trim meta description, improve image
    alts and primary CTA labels. Add robots.txt + sitemap.xml. WebConfig paths
    and firmware version badges unchanged.
2026-07-20 fix(ENM-223-R1 v0.2.0): HR-shadow revert (relay/lineHz/sumAbs), CT energy drain, autosave dirty, angle sign + WebConfig focus guards
    Keep Holding-register shadow in sync after web config edits so Modbus apply does not roll back relay/lineHz/sumAbs; drain CT ticks before ratio change; clear cfgDirty only on successful autosave; signed PAngle; WebConfig activeElement guards and sticky write-blocked notice.
    [atm90e32.cpp, atm90e32.h, default_enm_223_r1.ino]
2026-07-20 feat(ENM-223-R1 v0.2.0): LED alarm/warning/event sources per channel + button Ack (all/per-channel)
    Wire user LEDs to alarmRulePublished (sources 10..21) and buttons to alarmAckChannel (actions 7..11); extend WebConfig options with focus guards. CFG blob unchanged — old {0,5,6} configs still load.
2026-07-20 refactor(ENM-223-R1 v0.2.0): trim Modbus map 127→86 (drop peaks, fundamental/harmonic power, VAh & harmonic energy) — single legal FC04
    Shrink contiguous FC04 to 0..85 so one master sweep stays ≤125 registers. Peaks/Pfund/Pharm/VAh/APH remain on WebSerial and in the meter blob; HM_MAP/CFG/METER/FW versions unchanged. Client *_plc.yaml updated 1:1 in this commit (beta contract).
2026-07-20 fix(ENM-223-R1 v0.2.0): relay coil mirrors actual state in all modes (honest feedback like DIO)
    Always refresh coil 0/1 from relayLogical so HA shows the real relay in Alarm/None; serviceModbusRelays only intakes Modbus-mode commands.
    [default_enm_223_r1.ino]
2026-07-20 fix(ENM-223-R1 v0.2.0): Modbus baud re-init (HR-1), unsigned energy JSON (M-1), energy 0xFFFF + linkOk peek
    Stop mutating g_mb_baud before applyModbusSettings so Serial2 reopens on Holding baud change; emit energy as double for WebSerial; accept saturated energy deltas; mark linkOk from peek of own slave address before mb.task.
    [default_enm_223_r1.ino]
2026-07-20 refactor(ENM-223-R1 v0.2.0): slim Modbus — DIO-style template relays, Identify-only coil, ACK buttons, trimmed coil/HR registration, throttle 0ms
    Register only coils {0,1,5,16-19} and Hreg 0..8; drop Modbus save/reboot/reset-energy. ESPHome: write-only coils + template relays/ACK/Identify; one FC04 0..53 (no mid-range skip); energy skip_updates 2; update_interval 1s / throttle 0ms.
    [default_enm_223_r1.ino, default_enm_223_r1_plc.yaml]
2026-07-21 fix(ENM-223-R1 v0.2.0): pin accuracy_decimals on temperature + energy sensors (clean HA display, no buyer config)
    [default_enm_223_r1_plc.yaml]
2026-07-21 release(ENM-223-R1): v0.2.0 is current — flip index.html + docs catch up (Rule 8/10)
2026-07-21 docs(ENM-223-R1): fix reactive-export energy label — reg 84 is Export Total, not "net"
    Register 84 (U32 varh) is the Reactive Energy Export Total accumulator; "net"
    reactive is a computed template sensor, not a Modbus register. Aligns the
    reactive-export row with the import/active-export rows (— L1 / L2 / L3 / Total).
2026-07-21 docs(ENM-223-R1): align Modbus default address and relay rating with firmware/module limit
2026-07-24 docs(OTGW): commissioning for firmware 1.1.0 (LED, encryption key, screenshots)
2026-07-24 docs(MicroPLC): HTTP OTA via manifest and 1.1.0 commissioning docs
    Align microplc.yaml with OpenthermGateway (literals, http_request update,
    on_connect check) and document LED behaviour, encryption key, and 15-minute
    provisioning. Manifest binary ships in a separate commit when available.
2026-07-24 release(MicroPLC): publish 1.1.0 OTA binary and update manifest
    Ship homemaster-microplc-firmware.ota.bin with matching manifest.json MD5
    in the same commit so field devices never poll a dangling release.
2026-07-24 release(MicroPLC): publish 1.1.1 OTA binary and update manifest
    Replace the 1.1.0 OTA image and bump manifest version/MD5 in the same
    commit so field devices never poll a dangling release.
2026-07-24 news: add DIN-rail photo for EN 18031 firmware update post
    Host the hero image in the public repo so jsDelivr and Odoo can serve it;
    post HTML in the private repo links here via CDN.
2026-07-24 fix(MiniPLC): stop eth HTTP OTA, drop stale factory.bin, HomeMaster casing
    Ethernet config no longer pulls the Wi-Fi OTA manifest; dashboard_import
    points at config-eth.yaml. Remove the outdated 1.0.0 factory image and
    normalise friendly_name / manifest name to HomeMaster.
    [config-eth.yaml, miniplc.yaml]
2026-07-25 ci: add CycloneDX SBOM generation and SECURITY.md
    Wire Arduino SBOM steps into build-firmware.yml, add ESPHome SBOM
    workflow plus generators, and publish SECURITY.md at the repo root.
2026-07-25 feat(wifi): bump to 1.2.0 and remove captive fallback AP
    Raise MiniPLC/MicroPLC/OpenTherm project versions to 1.2.0 and drop
    wifi.ap plus captive_portal for RED Art. 3(3)(d). Also make the Arduino
    build workflow version-aware (matrix.version, Firmware/v*/** triggers).
2026-07-25 release(AIO-422-R1): ship v0.1.0 UF2 binary
    Copy the built sketch UF2 to Firmware/v0.1.0/AIO-422-R1.uf2 for the
    current hub version. index.html UF2 link is a separate release edit.
2026-07-25 docs: pin the Modbus client timings — ESPHome 2026.7.0 changed the defaults
    turnaround_time went from 100 ms to 600 ms and send_wait_time from 250 ms to
    2000 ms. At 600 ms the bus carries about 1.5 transactions per second whatever
    the UART speed, because the controller stays silent after every response.
    Measured on a MiniPLC with ENM-223-R1 and two WLD-521-R1 on one bus: one module
    stopped being polled entirely, with no timeout and no CRC error in the log.
    Every quick-start now sets both values explicitly so the ESPHome default never
    applies.
2026-07-26 fix(ENM-223-R1): split the energy counters into their own poll range
    Read registers 0..85 are contiguous, so ESPHome merged them into a single
    range and took skip_updates from it. The whole block — status, alarms, U, I,
    P, Q, S, PF, THD, angles — was therefore polled every 3 s instead of every 1 s,
    because the 16 energy counters at 54..85 asked to be polled less often.
    force_new_range on the sensor at address 54 splits it as the package header
    already described: FC04 0..53 every second, FC04 54..85 every third.
    Measured on a MiniPLC: FC04 count=86 arriving every 3.000 s at
    update_interval: 1s.
    [default_enm_223_r1_plc.yaml]
2026-07-26 fix(packages): expose ENM/WLD/AIO poll timings via substitutions (STD-009)
    ENM, WLD and AIO packages hard-coded update_interval and command_throttle,
    so clients could not override them via vars:. Match DIO/ALM/RGB/STR: defaults
    live in substitutions (1s / 0ms). WLD was 3s/50ms; AIO was 3s with no
    command_throttle — both now follow STD-009 / Rule 15.
    [default_aio_422_r1_plc.yaml, default_aio_422_r1_plc_full.yaml, default_enm_223_r1_plc.yaml, default_wld_521_r1_plc.yaml, default_wld_521_r1_plc_full.yaml]
2026-07-26 feat(WLD-521-R1): contiguous FC04 input map for ESPHome poll
    Publish DI/RLY/BTN masks, flow, heat and 1-Wire on IREG 0..71 so the
    package can poll one fast FC04 range plus a slow block, instead of three
    holding/status commands. Drop LED from Modbus; keep HREG/ISTS/coils for
    existing clients. Package rewritten to register_type: read.
2026-07-26 fix(WLD-521-R1): keep FC04 0..31 contiguous via IREG_FLAGS sensors
    Expose DI1..DI5 enabled on address 1 so ESPHome does not split the fast
    input range. Drop the unused holding-based _full package.
    [default_wld_521_r1_plc.yaml, default_wld_521_r1_plc_full.yaml]
2026-07-26 release(WLD-521-R1): ship v0.1.0 UF2 binary
    Build the current sketch to WLD-521-R1/Firmware/v0.1.0/WLD-521-R1.uf2 and
    restore the hub Firmware (UF2) link for the current version.
2026-07-26 fix(index): point Shop links at canonical product URLs
    Replace six stale /shop/ slugs that 301-redirected, in both the HTML
    Shop anchors and the devices JSON shop fields.
2026-07-26 docs(README): add shop Product page links for all 11 devices
    Point readers at canonical home-master.eu shop URLs from the overview tables, add the products catalog at the top, and fix Measurement/Protection, RGB dimming, and CE marked wording.
2026-07-26 docs(README): rewrite as killer-feature system overview
    Position HomeMaster as open, local-first DIN-rail automation with ESPHome/HA, sharpen per-module strengths, add CE compliance and shop links, and point versioning at GitHub Releases.
2026-07-26 docs(README): per-module versioning, setups table, WebConfig browsers
    Drop GitHub Releases links, document Chromium-only WebConfig, tighten MiniPLC/OTGW power wording, and replace emoji setup list with segment scenarios.
2026-07-26 docs(README): clarify Quick Start — modules need ESPHome packages
    I/O modules do not auto-discover in Home Assistant; document package include, Modbus address match with WebConfig, and that OpenTherm skips the Modbus steps.
2026-07-26 docs: fix false UL/CSA, license badges, and module README facts
    Remove DIM UL/CSA claims, align WLD relay limits and duplicate §8, correct MiniPLC expansion table and ENM verify table, and set MIT license badges to match licensing sections.
2026-07-26 docs: add Key advantages and tighten Overview on all 11 modules
    Surface module-specific and system-level strengths near the top of each README, clarify OpenTherm/ALM/RGB guards, and fix STR WebConfig/MODULE-CODE placeholders.
2026-07-26 docs: README honesty, hygiene, and WLD heat-metering surface
    Strip RGB heading emoji; ship MicroPLC env/24V/no-Ethernet facts; DIM/AIO
    limitations; STR status note; surface WLD indicative heat energy with MID disclaimer.
2026-07-29 Revise README with updated specifications and warnings
    Updated specifications for current inputs, operating temperature, and terminal details. Added warnings regarding CT inputs and installation practices.
2026-07-30 docs(ALM-173-R1): drop incorrect 18-30 V DC supply range
    Publish 24 V DC nominal only in Features, terminals, and electrical tables.
2026-07-31 fix(AIO-422-R1): unblock Modbus loop; ship v0.2.0 beta UF2
    Cut sensor-path blocking (~330 ms → ~75 ms), clamp Modbus DAC, debounce
    buttons, split LED phys/logical state, and harden bus RX FIFO / WebConfig.
    [default_aio_422_r1.ino, default_aio_422_r1_plc.yaml]
2026-07-31 fix(AIO-422-R1): derive RTD Rref from sensor type; stop diag flicker
    Rref is now PT100→400 Ω / PT1000→4000 Ω (stored field kept for layout).
    Corrects wrong out-of-box temperatures when flash held Rref=200.
    Diagnostics ride every ext packet; UI keeps last info on partial frames.
    Advisory WebSerial warn when a valid PT100 reads below −150 °C (jumper mismatch).
    [default_aio_422_r1.ino]
2026-07-31 fix(AIO-422-R1): correct AI3/AI4 ADS map; expand button AO actions
    Swap ADS1115 inputs for field terminals AI3/AI4 so HREG 142/143 and
    WebConfig match the wired terminal (installations that relabelled HA
    entities for the old swap must revert those labels). Button actions
    gain ±10% steps, restore-last-level, and all-AO-off without a CFG bump.
    [default_aio_422_r1.ino]
2026-07-31 fix(AIO-422-R1): finish Config-router migration for btn/led/dac
    Drop legacy WebSerial channels; pass Config list/obj through without
    JSONVar repacking so button and LED writes apply and persist.
    [default_aio_422_r1.ino]
2026-07-31 feat(AIO-422-R1): publish live AO on ext; add LED sources 5–10
    Push dacRaw via periodic ext so WebConfig tracks buttons and Modbus.
    New LED auto sources: bus link, RTD faults, AO active, hardware fault.
2026-07-31 feat(AIO-422-R1): one FC04 poll cycle via contiguous IREG 0..11
    Merge live state into a DIO-style input-register block so the ESPHome
    package issues a single FC04 instead of three FC03 reads. AO stays
    write-only on HREG 200/201; HM_MAP becomes the derived firmware version.
    [default_aio_422_r1.ino, default_aio_422_r1_plc.yaml, default_aio_422_r1_plc_full.yaml]
2026-07-31 fix(AIO-422-R1): AO template number — drop optimistic, poll lambda at 1s
    optimistic cannot coexist with lambda; refresh AO state from IREG sensors
    each second and skip NaN until the first FC04.
    [default_aio_422_r1_plc.yaml, default_aio_422_r1_plc_full.yaml]
2026-07-31 fix(AIO-422-R1): stop RTD recovery from latching a bad baseline
    Share one acceptance gate between scan and recovery, restore the ESD
    suspicion window, and adopt a new baseline only after a candidate series
    agrees — so a latched ~720 C reading publishes 0 instead of becoming truth.
    [default_aio_422_r1.ino]
2026-07-31 fix(ALM-173-R1): drop FC01 coil read-back; throttle 0ms
    Relay/Armed state comes from IREG 1 via template switches (DIO pattern).
    [default_alm_173_r1_plc.yaml]
2026-07-31 docs(AIO-422-R1): refresh WebConfig screenshots; drop webconfig4
    Three screens now cover connection, AI/AO/RTD, and buttons/LEDs. Remove
    the obsolete fourth image (old PID view) from the tree and README.
2026-07-31 fix(ENM-223-R1): poll energy block every 30 s (skip_updates 29)
    Keep the @54 force_new_range split; at 30× the slow FC04 pays for itself
    and stops bursting ~300 ms onto the bus every three seconds.
    [default_enm_223_r1_plc.yaml]
2026-07-31 fix(AIO-422-R1): detect bus link from addressed Modbus frames
    Serial2.available() was always empty after mb.task() drained the FIFO.
    With no onGet* callbacks in Modbus-Serial 2.0.6, watch the UART stream
    for CRC-valid requests to this slave instead.
    [default_aio_422_r1.ino]
2026-07-31 release(AIO-422-R1): ship firmware v0.2.0 as current
    Flip the config hub to v0.2.0, rewrite the module README for the new
    register map and upgrade notes, and add news images for the release post.
2026-08-01 fix(MicroPLC): declare flash_size 16MB so OTA partition table matches hardware
    Without flash_size ESPHome defaults to 4 MB partitions. MicroPLC has 16 MB
    flash; the undersized layout breaks http_request.update (manifest fetch fails,
    Firmware Update entity stays blank). Align esp32: with OpenTherm (variant +
    flash_size); keep framework version: recommended.
    A partition table cannot change over OTA. Units already in the field need a
    full USB flash with erase, then re-provision (NVS wipe clears API key and
    Wi-Fi). Manifest/project version left at 1.2.0 pending a separate release
    decision.
    [microplc.yaml]
2026-08-01 release(MicroPLC): firmware 1.3.0 — 16 MB flash and 1-Wire temperature
    Ship the new OTA binary, bump project/manifest version to 1.3.0, refresh
    the md5, and document the flash_size fix plus dallas_temp on GPIO4.
    [microplc.yaml]
2026-08-01 release(MicroPLC): 1.3.1 — DI #1 and RS-485 UART at 19200
    Expose the ISO1212 24 V input on GPIO36, rename the bus UART to
    uart_modbus, and correct the baud rate so factory firmware can talk to
    HomeMaster modules. Document pins in the README; ship OTA binary + md5.
    [microplc.yaml]
2026-08-01 docs(MicroPLC): document RS-485 UART id, pins and 19200 baud
    The 1.3.1 release README update missed the Bus System Configuration
    table for uart_modbus.
2026-08-01 release(MicroPLC): 1.3.1 diagnostics and Restart button
    Add OpenTherm-shaped diagnostic entities and a reboot-only Restart
    button, rebuild the OTA image, and refresh the manifest md5. Document
    the entity set in the README.
    [microplc.yaml]
2026-08-01 articles: add 4-20 mA loop wiring diagram for the wind sensor build guide
    Self-contained SVG, no external fonts or assets. Shows the loop-powered
    sensor, the 470 ohm sense resistor in the return path, and the AIO-422-R1
    measuring across it between AIn and AGND, with the shared-ground note and
    the 1.88 V / 9.40 V endpoints.
2026-08-01 articles: add hero photo for the wind 4-20 mA guide
2026-08-02 fix(MicroPLC): embed ISRG Root X1 for OTA TLS under Modbus load
    Point http_request at a single CA (ca.pem) and disable the ESP-IDF
    certificate bundle so mbedtls_ssl_setup no longer fails with
    MBEDTLS_ERR_SSL_ALLOC_FAILED when many modbus_controller packages are
    attached. Version and OTA binary left at 1.3.1 pending a confirmed
    bench check and a coordinated release flash.
    [microplc.yaml]
2026-08-02 fix(MicroPLC): shrink mbedTLS SSL buffers for OTA under Modbus load
    Revert the ineffective single-CA approach. mbedtls_ssl_setup was failing
    with MBEDTLS_ERR_SSL_ALLOC_FAILED because the default 16 KB I/O buffers
    could not allocate contiguously. Set IN/OUT content length to 4 KB with
    dynamic buffers, restore the cert bundle, and ship a matching 1.3.1
    binary + md5.
    [microplc.yaml]
2026-08-02 fix(MicroPLC): enable DYNAMIC_FREE_CONFIG_DATA for CA free path
    ESP-IDF 5.5 gates MBEDTLS_DYNAMIC_FREE_CA_CERT on
    DYNAMIC_FREE_CONFIG_DATA; without the parent the option was silently
    dropped from the final sdkconfig. Rebuild and refresh the 1.3.1 md5.
    [microplc.yaml]
2026-08-03 docs(config hub): Made for ESPHome badge on MiniPLC and OpenTherm
    Add device-page chips and Resources links for the two certified
    controllers; sync the DATA REFERENCE JSON.
2026-08-03 revert(MicroPLC): drop custom mbedTLS buffer options from 1.3.1
    Restore the factory YAML/binary to stock ESP-IDF TLS defaults per the
    approved firmware source.
    [microplc.yaml]
2026-08-04 docs(ALM-173-R1): reposition as wired sensor hub with 12 V rail
    Lead with the isolated sensor power differentiator, broaden applications,
    and add connectable-device tables plus FAQ for Home Assistant search intent.
2026-08-04 docs(ALM-173-R1): mention both +12 V and +5 V sensor rails in lead copy
2026-08-04 fix(STR-3221-R1): Modbus defaults 3/19200, PWM flash wear, ESPHome package hygiene
    Align factory RS-485 with the HomeMaster bus, stop autosaving brightness
    to LittleFS, sync hm_common from DIO, and make the ESPHome package
    multi-instance safe without a duplicate number writer.
    [default_str_3221_r1.ino, default_str_3221_r1_plc.yaml, hm_common.h]
2026-08-04 fix(STR-3221-R1): do not block USB CDC on WebSerial sends
    Guard wsLog/status/cfg with hmUsbCanSend like RGB — unguarded TX when no
    host is reading hung setup and dropped the COM port.
    [default_str_3221_r1.ino]
2026-08-04 fix(STR-3221-R1): keep USB alive through boot (I2C timeout, no FS format)
    Wire defaulted to a 1 s timeout and LittleFS.format() in setup starved
    TinyUSB (delay does not yield). Pump USB at boot, cap I2C at 25 ms, and
    defer filesystem format to an explicit Save/factory command.
    [default_str_3221_r1.ino]
2026-08-04 fix(STR-3221-R1): stop watchdog reboot during WebConfig Connect
    32-channel CDC telemetry could block TX long enough to trip the 4 s
    watchdog when the host opens the port. Ignore USB flow control, feed the
    watchdog around sends, and rate-limit the PWM snapshot to 1 Hz.
    [default_str_3221_r1.ino]
2026-08-04 fix(STR-3221-R1): restore working Wire1 firmware (wrong I2C bus killed USB)
    The published sketch drove TLC59208F on Wire/I2C0 with GPIO6/7; those pins
    are I2C1 on RP2350. Restore the July board firmware that uses Wire1, I2C
    scan and the correct input polarities so the CDC COM port comes back.
    [default_str_3221_r1.ino, hm_common.h]
2026-08-04 fix(STR-3221-R1): apply bus canon 3/19200 on working Wire1 firmware
    Restore left July defaults (21/115200) and stale WebConfig TLC labels so
    COM would come back first. Re-apply Modbus 3/19200, HR 481 clamp, HM_MAP
    cleanup, PWM no-autosave, and WebConfig labels 0x40/0x42/0x44/0x46.
    [default_str_3221_r1.ino, hm_common.h]
2026-08-07 fix(estimator): accept #hm-system-builder mount node
2026-08-08 fix(ENM): correct din_units in readme.html; publish estimator enclosure
    readme.html said 9 division units (DIO dimensions); README says 4.
    Estimator artifact adds companion DIN widths and cabinet layout.
2026-08-08 fix(ENM): rewrite readme.html mechanical table to match README
    Section 3.3 still carried DIO weight/terminal/torque figures. Align with
    README: 4 division units, label weight, 0.4 Nm terminals, 0–90 % RH.
2026-08-08 docs: publish measured DIN widths; estimator app.v7
    Add "DIN width: N modules (N × 17.5 mm)" to module docs via the
    workspace sync generator. Publish estimator with full din_units and
    enclosure sizing (app.v7.js).
2026-08-13 docs(ENM-223-R1): correct CT input spec — current-output CTs ≤60 mA into 6 Ω burden
2026-08-14 docs: generated terminal maps and Ports & service interfaces tables.
    USB-C and service headers (ENM LED/BTN) are restored under Ports from
    terminal-maps.yaml, not left as orphan rows after the klemmen map.
2026-08-14 docs(STR): fix troubleshooting — output + rail, not VCC.
2026-08-14 docs(STR): correct output limits to 1.5 A/ch and 18 A module total.
    Publish matching estimator rules (32 actuators, separate LED PS ≥230 W).
2026-08-14 docs(ALM): clarify shared GND_ISO 12 V/5 V sensor rails.
    Publish estimator rules with shared 150 mA / 200 mA budgets.
2026-08-14 fix(MicroPLC): warn that relay is C/NC only (inverted when de-energised).
    Sync estimator rules so MicroPLC no longer supplies failsafe-off relay channels.
2026-08-14 fix(estimator): NC relays are reserve-only; sync MicroPLC/OTGW warnings.
2026-08-14 chore(estimator): publish per-circuit protection and enclosure enum.
    Rebuild from hm-workspace 95fedad — field_wires_per_channel, blanking,
    enumerated 12/18/24×1..6 enclosure, auto-split over 144 M.
2026-08-14 chore(estimator): publish 2-wire relays, room split, controllers.
    Rebuild from hm-workspace cfb8fc8.
2026-08-14 chore(estimator): publish enclosure fit check and panel room assignment.
2026-08-15 chore(estimator): publish coupled enclosures, no panel autosplit.
2026-08-16 Publish estimator PCB-green palette and rail layout presentation.
2026-08-16 Publish estimator rail layout: one photo per physical unit.
2026-08-16 Publish estimator three-supply PSU model and RGB/STR LED PS docs.
2026-08-16 Publish estimator per-module LED PS and updated rail packing order.
2026-08-16 Publish estimator dense rail packing and unstretched PSU tiles.
2026-08-16 Publish estimator rail packing and cropped PSU/contactor tiles.
2026-08-16 Publish estimator: example price match, dual totals, OOS prices, buttons.
2026-08-16 Publish estimator: Simple left-align, one-line steppers, two-decimal money.
2026-08-16 Publish estimator: Simple commercial rewrite (modules vs panel materials).
2026-08-16 Publish estimator: internal panel wiring priced; field side quoted separately.
2026-08-17 chore(estimator): publish configurator bundle (app.v21)
    PIR dry/transistor, leak shut-off valves, DIN row-fit enclosure sizing,
    complete-hardware pricing, three-sheet XLSX, and psu_sensor_12v in rules.
2026-08-17 chore(estimator): publish configurator bundle (app.v22)
    Layout matches paid enclosure; XLSX materials include cabinet/blanking
    and subtotals sit in Line total; complete hardware can use EUR offers
    when the shop session is RON.
2026-09-20 RGB-621-R1: publish firmware v0.3.0 beta on config hub.
    Adds the v0.3.0 package with HA state-feedback fixes, keeps v0.2.0 as
    the stable release, and lists beta WebConfig on index.html and README.
    [default_rgb_621_r1.ino, default_rgb_621_r1_plc.yaml, hm_common.h, hm_input_engine.h, hm_pwm_output.h]
2026-09-20 RGB-621-R1 hub: drop extra beta button from card header.
    Beta stays in All versions only, matching WLD and other modules.
2026-09-20 RGB-621 v0.3.0: skip light readback when STATE echoes HA command.
    Store the five channel bytes sent from HA and ignore Modbus readback
    when they match, so brightness and hue are not re-guessed from an
    ambiguous product. External changes still update the entity.
    [default_rgb_621_r1_plc.yaml]
2026-09-20 STR-3221-R1: add firmware v0.2.0 beta tree (step 1).
    Copy v0.1.0 into v0.2.0 with version bump, lost rollback fixes
    (address/baud persist, linkOk), and TLC auto-increment I2C flush.
    [default_str_3221_r1.ino, default_str_3221_r1_plc.yaml, hm_common.h]
2026-09-20 STR-3221-R1 v0.2.0 beta step 1b: close four step-1 tails.
    Align SlaveId seed with canon address 3, batch PWM off/ext.pwm through
    applyAllPwmLevels, harden tlcFlushChip write counting, and fix WebConfig
    /README wording left from step 1.
    [default_str_3221_r1.ino]
2026-09-20 STR-3221-R1 v0.2.0 step 2a: DIO-canonical FC04 register map.
    Replace scattered FC02 discrete inputs with one bit-packed IR 0..31 block,
    add bus diagnostics, and rewrite the ESPHome package for a merged poll.
    HR 400..431 write surface and identity IR 200..204 unchanged.
    [default_str_3221_r1.ino, default_str_3221_r1_plc.yaml]
2026-09-20 STR-3221-R1 v0.2.0 step 2b: local control and bus failsafe.
    Migrate config to v4, wire button/input actions and override priority,
    add bus failsafe with coils 330/331, and extend WebConfig plus ESPHome.
    [default_str_3221_r1.ino, default_str_3221_r1_plc.yaml]
2026-09-20 STR-3221-R1 v0.2.0 step 2c: close step-2b defects (status, WebConfig, HA).
    Fix STATUS_FLAGS bits, sendWebCfg round-trip, WebConfig hydration guards,
    WebConfig override priority, reset-reason encoding, and ESPHome command buttons.
    [default_str_3221_r1.ino, default_str_3221_r1_plc.yaml]
2026-09-20 STR-3221-R1 v0.2.0 step 2d: fix cfgHydrated regression, align off command.
    [default_str_3221_r1.ino]
2026-09-20 STR-3221-R1: correct the docs to the shipping v0.1.0, restructure README
    The customer-facing documents described a module that does not exist:
    sequencing the firmware does not do, an address and baud it does not
    use, and a 24 V sensor rail an installer would have wired a 24 V PIR to.
    Facts corrected (verified against the hardware manifest and the v0.1.0
    sketch, not carried over from the old wording):
    - Modbus default address 21 -> 3, baud 115200 -> 19200 (setDefaults()).
    - SENS.A / SENS.B are +5 V rails, not 24 V. The PTC fitted (1206L150THWR)
    is rated 8 V max and the TVS beside it stands off 5.8 V; neither could
    sit on 24 V. No current figure is published -- see backlog.
    - 2 status LE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
    [specs.csv]
2026-09-21 Warn that capacitor motors must not be wired directly to module relays.
    Each contact carries a 275 V MOV; the idle direction of a tubular motor sees 330–420 V and destroys the varistor. Drive those loads through an interposing relay or contactor.
2026-09-22 STR-3221-R1 v0.2.0: stair sequencer and underfloor heating zone loop; auto-off no longer extinguishes a failsafe or a heating channel
    [default_str_3221_r1.ino, default_str_3221_r1_plc.yaml, hm_heat.h, hm_stair.h]
2026-09-22 STR-3221-R1 v0.2.0: day/night window gets its own register, frost protection no longer arms at boot, heating DI role implies the input, stair sequence starts on the first edge
    [default_str_3221_r1.ino, default_str_3221_r1_plc.yaml, hm_heat.h, hm_stair.h]
2026-09-22 STR-3221-R1 v0.2.0: valve counters move from the config transfer to live status; heating section fits the budget
2026-09-22 STR-3221-R1: rebuild v0.2.0 beta binary after moving valve counters to live status
2026-09-22 WebConfig: shared hydrator honours chunk offsets; STR-3221-R1 valve counters move off the 250 ms status line
2026-09-22 STR-3221-R1: rebuild v0.2.0 beta binary after moving valve counters off the status line
2026-09-23 STR-3221-R1 v0.2.0: heating ships with a 15-minute slow-PWM period, SW4 clears local override, night window on the Stairs card
2026-09-24 STR-3221-R1: correct datasheet, README and partner-kit to shipping hardware
    Hold 18 A / 1.5 A, F8 1 A, nine output groups, SENS +5 V, and the 9-DIN weight 150/248 g.
    [specs.csv]
2026-09-24 Enclosure family: one drawing set, 90.6 × 67.3 mm canon; STR terminal 9 is I.
    All 11 modules share the 2026-09-24 DIN lengths; WLD and OTGW get drawings; DIM no longer carries the MiniPLC outline.
    [specs.csv]
2026-09-25 Specs: tables regenerated from one source; launhome.de review closed
    [specs.csv]
2026-09-25 Datasheets: remove duplicated Environmental/Mechanical rows, fix OTGW safety and MiniPLC overview text
    [specs.csv]
2026-09-25 Partner kit: rebuilt archive, corrected catalogue and user manuals (no 120–370 V DC, no REV2)
2026-09-25 User manuals MiniPLC/OTGW aligned with Rev. B; partner kit rebuilt
    [specs.csv]
2026-09-25 MiniPLC user manual: remove 30 V DC 10 A component rating
2026-09-25 STR-3221-R1, RGB-621-R1: inputs are not galvanically isolated; datasheets, READMEs, partner kit corrected
    [specs.csv]
2026-09-25 MiniPLC: LED description — U.1–U.3 user, U.3 status by default (reassignable)
    [specs.csv]
2026-09-25 Datasheets, READMEs, partner kit: measured weights for all modules; stray 420 g / 0.25 kg removed
    [specs.csv]
2026-09-27 MiniPLC: document RTD jumpers J-RTD/1–2, CS GPIO3/GPIO1, both channels PT100 2-wire.
    Port the 2026-09-17 product-page correction into README, example YAML, user manual and partner kit. Factory default is no longer RTD2=PT1000; DIP-switch wording is gone.
    [config-eth.yaml, miniplc.yaml]
2026-09-27 DIM-420-R1: add v0.1.0 and v0.2.0 UF2; v0.2.0 now compiles.
    Arduino needs a PersistConfigV6 forward declare or the preprocessor prototypes fail. index.html is unchanged — v0.1.0 stays current, v0.2.0 stays beta.
    [default_DIM_420_R1.ino]
2026-09-27 MiniPLC: README gets block diagram, temperature ranges, relay protection, power; RTD jumpers, PT100 on both channels, CS RTD1=GPIO3 RTD2=GPIO1 (README, YAML, manual)
2026-09-27 MiniPLC: setup-steps.svg — two steps, Take control optional
2026-09-27 MiniPLC: setup.svg — setup steps without headline
2026-09-28 MiniPLC: expansion.svg — bus ends at last module, no empty right side
2026-09-28 MiniPLC: setup2.svg — larger labels for two-column layout
2026-09-28 MiniPLC: without-ha.svg — larger labels, no duplicated caption
2026-09-28 MiniPLC: dims2.svg — larger labels, cropped for half-width column
2026-09-29 MicroPLC: fail-safe NC relay diagram
2026-09-29 MicroPLC/Images: micro-energy.svg (use case diagram)
2026-09-29 MicroPLC/Images: micro-leak.svg, micro-power.svg
2026-09-29 Datasheets, READMEs and partner kit: module weights rounded to 10 g.
    [specs.csv]
2026-09-29 MicroPLC/Images: use-case scenes
2026-09-29 RGB-621-R1: release firmware v0.3.0 as current.
    Hub, README, WebConfig and ESPHome package now name v0.3.0; v0.2.0 is legacy.
2026-09-29 STR-3221-R1/Images: product page diagrams (heating, local logic, setup, stair)
2026-09-29 STR-3221-R1/Images: power and dimensions diagrams
2026-09-29 STR-3221-R1: underfloor heating scene (SVG-wrapped WebP, real module photo)
2026-09-29 STR-3221-R1 v0.2.0: use Arduino 7-bit TLC59208F addresses and add on-demand I2C diagnostics.
2026-09-29 STR-3221-R1 v0.2.0: show U9–U12 by silk address, not by scan order.
2026-09-29 STR-3221-R1: heating diagram v2 with module photo
2026-09-29 STR-3221-R1: power diagram v2 with module photo
2026-09-29 STR-3221-R1 v0.2.0 WebConfig: I2C chip status in English, matching the rest of the page.
2026-10-02 STR-3221-R1: presence sensor photo
2026-10-02 STR-3221-R1: use-case stairs photo
2026-10-02 STR heating diagram: high-res module photo
2026-10-02 STR power diagram: high-res module photo
2026-10-02 RGB-621-R1 v0.3.0: RAM PWM trace dump and live actual-output lines under WebConfig sliders.
2026-10-02 RGB-621-R1 v0.3.0: live Diagnostics panel and serial log of PWM, Modbus, and WebConfig traffic.
2026-10-25 STR-3221-R1 ESPHome: outputs need multiply 255 — full brightness was writing 1 to HR 400..431; mark PWM registers write-only and add offline backoff
2026-10-25 RGB-621-R1: LED PS input has no reverse-polarity protection.
    The ideal-diode stage in the README and partner kit is not fitted on R1. Logic 24 V is unaffected.
2026-10-25 STR-3221-R1 v0.1.0 ESPHome: outputs need multiply 255 — full brightness was writing 1 to HR 400..431
2026-10-25 Release STR-3221-R1 v0.2.0 as current firmware.
    Open WebConfig and the Current line now point at v0.2.0; v0.1.0 is Legacy. Card description drops the isolated-inputs claim.
2026-10-25 STR-3221-R1 v0.2.0 docs: warn that flashing requires the new ESPHome path.
    The v0.1.0 package still reads Discrete Inputs that this firmware dropped. Rebuild the partner-kit zip so it matches the released Current.
2026-10-25 STR-3221-R1 v0.2.0: U11 drives O17..O20 rotated — map channels to PWM registers through a per-chip table, both for single and block writes
2026-10-25 STR-3221-R1 v0.2.0: DI is on GPIO12 (ISO1212, net IO3), presence inputs on GPIO10/GPIO11 — pin map corrected against the schematic; drop invented terminal numbers from WebConfig
2026-10-25 STR-3221-R1 v0.2.0: sane stair timing defaults (0 no longer means instant), run-time readout, page reorganised around stairs and heating with the rest under Advanced
2026-10-25 STR-3221-R1 v0.2.0 WebConfig: Serial Log back at the top beside Device Setup, header pills back to the seven shared across the lineup, module state in its own strip, Russian strings removed
2026-10-25 STR-3221-R1 v0.2.0: stair commands no longer fail silently — log every refusal, factory step map is 1:1 instead of every step on O1, WebConfig says when the sequencer is off
2026-10-25 STR-3221-R1 v0.2.0: IN1 is SENS.A (GPIO11 / U17), IN2 is SENS.B (GPIO10 / U18) — bind presence inputs to the silk and terminals, not the MCU net numbers.
2026-10-25 STR-3221-R1 v0.2.0: verify every Modbus registration after add and log it if a command coil is missing from the map.
    epsilonrt Modbus-Arduino 1.3.0 is a malloc linked list, not DArray — addCoil is void, so the only check that exists is setCoil/Coil after add.
2026-10-25 STR-3221-R1 v0.2.0: the Stairs config message exceeded the 256-byte inbound buffer and was dropped without a word — split it into geometry, levels and step map; keep step accent lit while the sequenc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
2026-10-25 WebConfig: refuse to send a config frame larger than the module's inbound buffer and say so in the log, instead of losing it silently
2026-10-25 STR-3221-R1 v0.2.0: a run started from Modbus finished instantly — the start stamp could be later than the loop's time snapshot and the unsigned elapsed wrapped; take one time source and compare time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
2026-10-26 STR-3221-R1: document what the inputs actually accept — SENS.A/B are 5 V current-sourcing inputs needing ~4.3 mA, 6.8 V ceiling, no NPN sinking sensors without a pull-up; DI is dry contact only
2026-10-31 STR-3221-R1 v0.4.0 published as Beta. Current stays v0.3.0; the new tree is a copy of v0.3.0 so the next work has its own version
2026-10-31 STR-3221-R1 v0.4.0 beta: standby backlight gets its own channels, levels and a day/night switch instead of being derived from the step table; channels dropped from the set are turned off; WebConfig c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
2026-10-31 WebConfig: optional Bootloader button in the Tools card, off unless a page asks for it
2026-11-06 add an explicit MiniPLC SPI bus ID (#65)
2026-11-06 Give the MiniPLC Ethernet config SPI bus an explicit ID (#66)
    Same change as #65, applied to config-eth.yaml.
    Claude-Session: https://claude.ai/code/session_01WvcufhQ4Q2pT6NwXhXWPQm
2026-11-08 STR-3221-R1 v0.4.0 released: configurable step backlight with its own channels and a day/night switch, WebConfig can enter the bootloader. v0.3.0 moves to Legacy; settings migrate from 0x0005 without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
2026-11-09 OpenTherm Thermostat: product README
    Wall-mounted OpenTherm master, OTT-R1. Enclosure dimensions taken from
    the Italtronic EYE BOX part drawings. Images and schematics still to be
    added.
2026-11-09 OpenTherm Thermostat: devices.esphome.io page
    Draft of the device page for the Made for ESPHome submission. The
    configuration is referenced with a live url= fence, which the new
    validator requires for made-for-esphome pages.
2026-11-09 OpenTherm Thermostat: factory ESPHome configuration
    OpenTherm master with a local control loop: schedule, room hysteresis
    and a weather-compensated flow setpoint, so heating survives a network
    or Home Assistant outage. Four-page UI on the ST7789V, radar-driven
    screen blanking, LD2410 and SHT40/BH1750 sensors.
    Made for ESPHome requirements: dashboard_import, esp32_improv +
    improv_serial, http_request update manifest, no manual_ip, no secrets,
    every entity carries an id.
    Validated with `esphome config`. Not yet flashed on hardware.
    Claude-Session: https://claude.ai/code/session_01H25S2S9hTfJEZshF6idR9z
2026-11-09 OpenTherm Thermostat: site card for index.html
    The card markup only — index.html itself is untouched. Apply it with
    site/insert.py so the JSON-LD ItemList is updated in the same step.
    Needs Images/thermostat_512kb.png and the Manuals/Schematics PDFs to be
    in place first, or the card will carry dead links.
    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
2026-11-09 OpenTherm Thermostat: script that applies the site card
    Tested against the current index.html: 11 cards -> 12, numberOfItems
    11 -> 12, div tags balanced, page renders.
    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
2026-11-09 OpenTherm Thermostat: create Images, Manuals and Schematics folders
    Placeholders so the folders exist in the tree; each README names the
    exact filenames the product README and the site card already link to.
    Delete the README once the real files are in.
    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
2026-11-09 OpenTherm Thermostat: CE documentation set (drafts)
    Declaration of Conformity, installer and user manual, datasheet, and the
    technical file index. Markdown sources; the PDFs are rendered from these.
    Modelled on the gateway's documents, with the differences the hardware
    forces: no mains circuit, so neither the LVD nor the EMC Directive
    applies — this is radio equipment and both are excluded in favour of RED
    Art. 3.1(a) and 3.1(b). The dielectric-withstand programme does not
    apply either; there is no insulation barrier to test.
    The DoC is marked DRAFT and cannot be signed yet. Three items block it:
    the 24 GHz radar module has no notified-body certificate and no test
    evidence on file, there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
2026-11-09 OpenTherm Thermostat: installer manual and datasheet (drafts)
    Same chapter order as the gateway manual. The safety chapter is rewritten
    for this hardware: everything is SELV, so the mains and relay warnings are
    gone and are replaced by the two risks this product actually has — the
    OpenTherm pair being wired to a boiler's 230 V thermostat terminals, and
    the device taking command of a live heating system at commissioning.
    Datasheet current-consumption figures are left unfilled rather than
    guessed; they go in after the thermal measurements.
    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
2026-11-09 OpenTherm Thermostat: fix the 24 GHz standard, add the read-across analysis
    Correction: I cited EN 305 550-2 for the 24 GHz radar. That standard
    covers 40 GHz to 246 GHz and does not apply here. The harmonised standard
    for a 24 GHz short-range device is EN 300 440 V2.2.1 (1 GHz to 40 GHz).
    Corrected in the declaration, the manual and the technical file.
    Added TF section D.0: what of the gateway's test reports carries across to
    this product and what does not. Removals carry across; the display board
    and the radar are additions and do not. The conclusion is a delta campaign
    against the gateway's reports, not a full one.
    Recorded the result of checking Hi-Link's published documentation for th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
2026-11-09 OpenTherm Thermostat: manual — correct the 24 GHz standard
    EN 305 550-2 covers 40-246 GHz and does not apply. The harmonised standard
    for a 24 GHz short-range device is EN 300 440 V2.2.1 (1-40 GHz).
    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
2026-11-09 OpenTherm Thermostat: rewrite D.0 against the MiniPLC campaign, add C5 note
    Correction to D.0. I treated the display and the SPI bus as an untested
    addition. They are not: the MiniPLC was tested as a complete system with
    its display and the expansion modules, the architecture here is the same,
    and the measurements put the emissions on the 24 V DC-DC converter, not on
    the display or the bus. D.0 now says so and the delta shrinks to two
    items — the converter on this board, if it is not the one already
    measured, and the radar.
    D.0 also lists what has to come out of the MiniPLC campaign for the
    read-across to stand up in the file: the test configuration list showing
    the display was active, th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
2026-11-09 OpenTherm Thermostat: add the product photos and the schematic PDFs that are on disk.
2026-11-09 Remove internal EMC assessment from the public repo
    Moved to hm-workspace, compliance/OpenthermThermostat/04_assessments/
    EMC-OTT-R1-2026-001.md, where the current version lives.
    This one in particular should not have been published. It is the reasoning
    behind the declaration, not the declaration: it names the test reports and
    the laboratories the read-across rests on, and it states where the evidence
    stops - the board was re-routed, so radiated emission does not carry over
    from the gateway's campaign. That is the right thing to write down and the
    wrong thing to publish. What a customer needs is the DoC, which states the
    standards and the conclusion.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
2026-11-09 OpenTherm Thermostat: point the display schematic link at LCDBoard.pdf
    The exported file is LCDBoard.pdf, not DisplayBoard.pdf. Two places named the
    old filename: the site card link and the Schematics README. The link text on
    the card stays "Display Board", which is what a visitor should read; only the
    href follows the file.
    Nothing else referenced it - the product README and the device page link to
    the Schematics folder, not to individual files, so they were unaffected.
    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
2026-11-09 OpenTherm Thermostat: name the photographs by what they show
    The seven photographs went in under the camera's own filenames, which are
    useless as references from the product page and the shop listings. They are
    renamed by content with git mv, so the files themselves are untouched.
    The README, the device page and the site card referenced thermostat.png and
    thermostat_512kb.png, neither of which ever existed, and all three rendered an
    empty frame; they now point at thermostat-front.jpg. The README carries a
    gallery of the full set, which gives every photograph a stable URL.
2026-11-09 OpenTherm Thermostat: fix the display lambda so it compiles
    The first compilation on hardware failed with fourteen errors, all of them the
    same one: the has() helper took sensor::Sensor & and every call site passed a
    pointer.
    ESPHome substitutes id(x) in two different ways depending on what follows it
    (cpp_generator.py process_lambda): followed by a dot it emits the dereference,
    so id(s).state becomes s->state; anywhere else it emits the bare pointer. So
    id(ot_t_boiler).state compiled and has(id(ot_t_boiler)) did not, on the same
    line. The helper now takes sensor::Sensor * and uses ->, which also accepts
    the derived types at the call sites, TemplateSensor and BH1750Sensor.
    The reason this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
2026-11-09 OpenTherm Thermostat: restore the measured display margins
    The left and right margins were tuned on the assembled unit during UI work
    and ended up as margin_left 42 / margin_right 14. Assembling the factory
    firmware I wrote PAD_L = 14, PAD_R = 14 instead - symmetrical, as though the
    panel were centred in the controller's line. It is not: the visible window
    sits off-centre and clips more on the left, so the first character of every
    left-aligned line went off the glass. On the unit this reads as "LIMATE"
    instead of "CLIMATE".
    The values are back, now as substitutions at the top of the file rather than
    buried in the lambda, with a comment saying why they are unequal and which
    way to move each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
2026-11-09 Point README links at config.home-master.eu
    Module READMEs referenced their images, manuals and schematics both as jsDelivr
    URLs pinned to main and as relative paths. Both forms break when those files move
    off main. They are now absolute URLs through GitHub Pages, which serves them from
    the site branch.
    Links to files that stay in main - the ESPHome YAML, the sketches, the markdown -
    are untouched and remain relative.
2026-11-11 Move documentation and firmware sources onto the site branch
    main is what ESPHome clones. The READMEs, manuals, sketches and device
    pages belong on the branch people and GitHub Pages use.
2026-11-11 Show the four screens in the README and on the device page
2026-11-11 Document how Home Assistant feeds the temperatures
2026-11-11 Fit the README photographs into one frame
2026-11-11 OTT-R1: io diagram - light sensor, radar, ring keys
2026-11-11 OTT-R1: diagrams on current front photo
2026-11-11 Say what the thermostat mounts on and that the supply is not included
2026-11-11 OTT-R1: mounting diagram
2026-11-12 Bring the device page up to firmware 1.1.3
2026-11-12 Set the submission date on the device page
2026-11-12 Link the product page and the documents from the device page
2026-11-12 One picture on the device page
2026-11-12 Release 1.1.4 — the CH setpoint is a number, not an unnamed output
2026-11-12 Correct the enclosure parts to the ones actually ordered
2026-11-12 Correct the enclosure dimensions in the datasheet and the manual
2026-11-13 homepage v2: hero placeholder (MiniPLC cut-out)
2026-11-13 homepage v2: studio hero v2 (antenna fixed)
2026-11-13 homepage v2: phone hero crop keeps the antenna
2026-11-13 homepage v2: hero switched to studio image v2 (antenna fixed)
    Claude-Session: https://claude.ai/code/session_01Rk7UziVQBjgPokW4e4pZJ3
2026-11-13 MicroPLC: expose the front-panel button as hardware on GPIO39
    The config carried a software `button:` with `platform: restart`, which
    is an action, not the hardware the controller has. Replace it with the
    physical push button: SW1 pulls GPIO39 (SENSOR_VN) to GND and R23, 10 k,
    pulls it up to 3V3. GPIO39 is input-only and has no internal pull
    resistors, so the pin is declared inverted and relies on that external
    pull-up. The catalogue page lists the pin and the entity to match.
    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
2026-11-13 MicroPLC manifest: drop the removed Restart entity from the release summary
    The 1.3.1 summary listed "Restart" among the release highlights. The
    published configuration no longer carries a software restart button, so
    the line is dropped. The binary, its md5 and the version are unchanged.
    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
2026-11-13 MicroPLC README: current firmware version, and the button is the panel one
    The README still described firmware 1.1.0 and listed a Restart button in
    the entity reference. The shipped configuration is 1.3.1 and the button
    it exposes is the front-panel push button on GPIO39, not a software
    restart action. The project name the device advertises is corrected to
    the one the configuration sets.
    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
2026-11-13 MicroPLC 1.3.2 — OTA binary and manifest
2026-11-13 MicroPLC catalogue page: Modbus hub required between UART and modbus_controller
    Mirrors the suggestion accepted on esphome/devices.esphome.io#1993. A
    modbus_controller attaches to a modbus: hub through modbus_id, not to a
    UART directly, so the previous wording described a configuration that
    would not validate.
    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
