isystemsautomation/homemaster-dev/(notices)

Notices in the files:
DIM-420-R1/README.md:
License: MIT / CERN-OHL-W
README.md:
License: CERN-OHL-W v2 + GPLv3 + MIT
