isystemsautomation/homemaster-dev/OpenthermThermostat/Images/20261108_193546.jpg

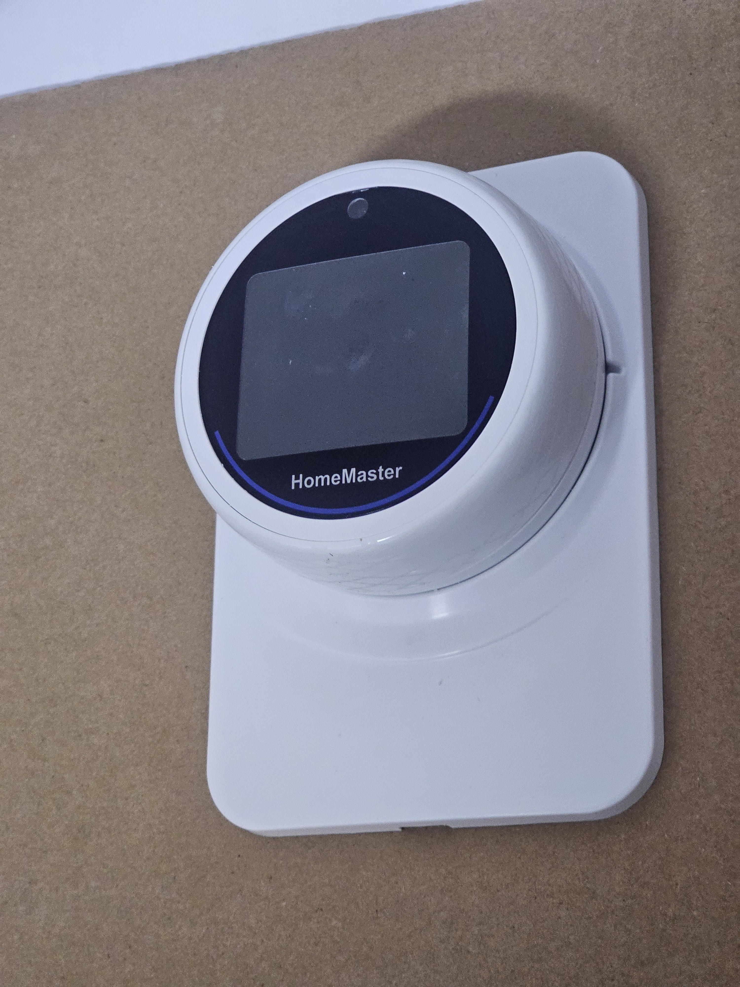
OpenthermThermostat/Images/20261108_193546.jpg
